WeieeGRACE/Embodied_RPACS/README.md

# Embodied_RPACS 主工程

ACG525 / GW5A-LV25UG324C2/I1，50 MHz，Gowin 1.9.12。主工程、构建与仿真不依赖 `tests/`。

## 本次交付（2026-10-29 稳定性 + 资源轮）

本轮的完整根因、修复、验证与上板步骤见 [`TECHNICAL_REPORT.md`](TECHNICAL_REPORT.md)。

1. **修复避障演示“转向 90° 后报故障”**：用改动前源码冻结副本在 ModelSim 中复现了全部
   锁存路径（`records/fault_injection/REPORT.md`）：转向后三路 ToF 全部新鲜的要求使任意
   一路持续 20 mm 在 1 s 后锁存 `route_fault=0x84`；单次 I2C NACK、瞬时 IMU 错误、
   停稳确认超时、有效近距 ≤85 mm 都会永久锁存。修复为分层容错：瞬时异常安全停车并
   自动重试/恢复，持续异常才锁存故障；转向后 barrier 只要求本状态真正使用的通道新鲜；
   编码器换向毛刺采用漏桶容错（历史板级记录过 IL=2/FL=1）。
2. **20 mm 截断容错 + 近距就绪（第二、三轮，上板日志驱动）**：真实板 3 次避障中 1 次在 `WAIT_PARALLEL`
   卡 4 s 后 PAUSED，串口证明障碍侧 VL53L0X 持续返回精确 20 mm（量程下限截断/测距失效），
   而旧策略把它永远丢弃 → 永远等不到“转向后新鲜样本”。现改为：连续 2 次 20 mm 视为
   “测距完成但目标过近/不可测”，作为 barrier 的新鲜事件放行（仍不参与几何距离），并让
   路线改走**固定里程兜底**（横移 500 + 额外 300 + 直行 600 + 额外 300 mm + 回线）；
   删除上板证明无效的“连续 4 次 20 mm 就 XSHUT 重初始化”。13 个故障注入场景现在同时断言
   `fault=0` 且 `paused=0`，其中场景 10 断言进入兜底（`reached_shift=1`）、场景 7 断言
   近距兜底（`near_shift=1`）。第三轮又删除了 `valid` 里“距离必须 >85 mm”的就绪掩码：
   真实近距不再被判未就绪（否则整条路线 `ready=0`、运动指令被拦后 PAUSED），近距与
   20 mm 截断统一走固定里程兜底。**PASS 中途截断兜底（上板日志驱动）**：2026-10-29 20:36
   板上 5 次尝试中 3 次在 PASS 阶段 BLOCKED（reason 0x04）——障碍侧通道在 PASS 开始后才出现
   20 mm 截断，边缘检测失效后一路开到前向阈值；现已把“运行中途转为截断”也纳入固定里程兜底
   （PASS/SHIFT），并新增故障注入场景 11 覆盖。**PASS 前向坏数据时间滤波（上板日志驱动）**：2026-10-29 22:52–22:59 的 7 次板测里 5 次在 PASS 段因“前向 ToF 单次读到 ≤85 mm”直接安全停车（reason 0x04）——箱角扫过前视场等单点坏数据被当成真障碍。现让位/超车各腿的前向判定需要**连续 400 ms** 低于 85 mm 才生效（巡航段仍立即刹车），并新增故障注入场景 12 覆盖；横移/超车距离与角度常量全部保持参考工程的 300/300 mm 不变。
3. **资源优化**：主菜单精简后为 4 项（MANUAL / SETTINGS / OBSTACLE AVOID / IMU ATTITUDE，
   末项为题目要求的姿态显示），删除 DISPLAY 其余诊断 UI、菜单预览行与 ToF 诊断页；本轮把
   IMU 姿态页恢复为单页（共用一套顺序小数格式化器），roll/pitch 数学随之回到综合。post-PnR：
   **Logic 15445/23040（70%）**（原 17661/77%）、**CLS 9407/11520（84%）**（原 86%）、
   Register 6553、BSRAM 9/56、DSP 8.5/28、Fmax **55.050 MHz**、Setup/Hold 违例 0、TNS 0。
4. **题目新增功能**：MANUAL 增加 **SPIN 360**（用右转动作原地旋转 360°，30 s 动作超时）；
   主菜单增加 **IMU ATTITUDE** 页，显示 ROLL / PITCH / YAW（±DDD.d°），IMU 校准中显示
   CALIBRATING。两项均已进仿真与 OLED 位图回归。
5. **验证**：7 套主工程仿真全部 PASS、历史回归全绿、**13 个**转向后故障注入场景
   （0 次故障锁存、0 次 PAUSED；场景 10 全程截断兜底、场景 11 PASS 中途截断兜底、场景 12 PASS 前向毛刺滤波）。
   位流：`impl/pnr/Embodied_RPACS.fs`（6,228,180 字节），
   SHA256 `901D7394146E472AF386E5BAB4092C5FD94B62245CF8666C471EDA38F7EAB14B`。
   2026-10-30 上板验收通过后已删除 USB 事件日志与调试串口，本版为最终交付
   （42 个受约束引脚、Fmax 55.050 MHz）。
   配套语音固件 `asrpro/release/yaoyao_asrpro_2m_20261025_obstacle/fw.bin` 本轮未改动。
   上板验收与逐段距离日志见 `records/robustness_20261029/BOARD_RUN_ANALYSIS.md`
   与 `records/robustness_20261029/board_run_20261030_0003_analysis.md`。

> 硬件提示：真实板上“IMU 地线掉开时避障反而稳定、插回又 PAUSED”指向地环路——本工程机械
> 接线把 IMU 地接在 P11-3/LCD_GPIO0/T11（T11 是 FPGA 信号脚，`P11-2` 才是专用 GND）。
> 建议 IMU 与三路 ToF 统一接到 P11-2 或 P6-12/P6-30 专用地星形一点接地，不要经 T11 走地。

> 勘误：上一轮文档中的 “Logic 12036/53%” 来自一次 `font_byte` 未驱动的坏网表（综合把整条
> OLED 文本链裁掉），不能作为资源余量依据；真实基线是 17661/77%，本轮以可运行构建重新测量。

## 菜单与按键

K1 下一项，K2 选择。主菜单 4 项：MANUAL → SETTINGS → OBSTACLE AVOID → IMU ATTITUDE。
手动页执行前后 20cm、左右 90°、**SPIN 360（右转原地一圈）**与 STOP；SETTINGS 含语音开关与
三档速度；IMU ATTITUDE 页显示 ROLL/PITCH/YAW（校准中显示 CALIBRATING，K0 返回）。

语音默认关闭；到 SETTINGS → VOICE ENABLE，用 K1 选择 ON、K2 确认。
进入避障面板不运动；K2 先播报“开启避障模式”，正常播完才前进。运行中 K2 暂停，暂停后 K2 恢复。
语音关闭时显示 ENABLE VOICE FIRST 并禁止避障启动。
面板显示状态、档位、三路距离；距离为四位十六进制 mm（07D0=2000mm），不可用显示 `----`。

K0 始终立即关断驱动。避障期间 K0 退出模式并返回主菜单，松开不恢复。
其他页面 K0 沿用返回/停车；主菜单 K0 复位、清故障并重新校准 IMU。

## 故障与诊断（本轮行为）

- 故障时避障面板第一行显示四组诊断码：`F:xx S:xx M:xx I:xx`
  - **F** = 路线 reason（0x84 转向后测距等待、0x85 重试耗尽、0x86 运动反复中止、0x80 系统故障…）
  - **S** = ToF 故障字（bit0/1/2 三通道坏样本；bit3/4/5 通信丢失；bit6/7/8 数据过期）
  - **M** = 运动故障码（2 测速反馈、3 偏航反馈、4 动作超时、5 非法状态、6 状态机异常）
  - **I** = IMU 错误码
  验收后已按用户确认删除 USB 事件日志与调试串口（释放 V8/U8 两个球）；现场诊断依靠避障面板的
  `F/S/M/I` 码，需要串口日志时使用已归档的历史 P6-21 诊断位流（不再随主工程维护）。
- **瞬时异常不再报 FAULT**：ToF 单次 NACK/短暂无数据、IMU 短暂错误、编码器停稳抖动等，
  会先安全停车并自动重试或恢复；转向后若障碍侧通道持续精确 20 mm（量程下限截断），
  按“测距完成但不可用”处理并改走固定里程兜底，不再等满重试后 PAUSED。
  若仍进入 `PAUSED`，面板第三行显示 `PAUSED R:xx Sxx Vx Ux`（U=20 mm 截断确认掩码），
  按 K2 可继续，**不会出现 FAULT RESET REQUIRED**。
- **持续异常仍锁存**：通道连续 2 s 失败/通信丢失、IMU 连续 2 s 错误、持续编码器异常、
  10 s 动作超时、ASR 发送溢出、K0 急停等保留永久故障锁存，必须 K0 复位。
- **编码器换向毛刺容错**：真实板 2026-10-14 记录过换向瞬间 `IL=2 IR=2 FL=1` 的非法跳变锁存。
  主工程编码器解码器现配置为容忍 5 次孤立毛刺、每 256 个合法计数衰减 1 次（漏桶），
  换向 EMI 毛刺不再杀演示；持续异常（>5 次且无合法计数稀释）仍锁存。历史独立测试工程
  默认参数 0，保持原来的“首次非法跳变立即锁存”行为。
- **20 mm 卡死自愈**：某通道连续 4 个精确 20 mm 后会自动 XSHUT 重初始化一次（约 25 ms），
  若只是测量卡死即可恢复；若目标确实过近则继续按安全策略处理。
- 有效近距读数（非 20 且 ≤85 mm）视为“遇到障碍”，由路线停车/绕行处理，不再锁存传感器故障。

## 避障与语音

唤醒词“幺幺耍起”保持不变；“避障模式”成功后 OLED 自动跳转面板。
自主绕行完成后继续巡航，可处理后续障碍。无路可绕或反复重试失败时暂停等待重新启动。
“停车/停止/停止任务”暂停并保留模式；“前进”在此模式内始终表示恢复持续避障。
“左转/右转/后退”取消旧路线，停稳后执行 90°/20cm 动作，完成后原地等待。
语音定量动作执行期间拒绝其他运动口令，不排队；停止与退出仍然有效。
“退出避障模式”停车、退出并回到主菜单；故障清除前禁止启动。

自主前方障碍触发一次“遇到障碍开始绕障”；完整回线、恢复航向和最终测距检查通过后触发一次“已绕过障碍物”。
取消或失败不报完成。模式存续期间每秒续期 ASRPRO 唤醒窗口。

自主避障继承独立 09 版：600mm 减速、130mm 准备绕行、转向侧>300mm、两次额外 300mm 及按实际横移里程返回。
保留正常通信持续 20 mm 时复用旧距离的策略；20 mm 不能建立首次正常值或转向后新鲜样本
（因此转向后对**所需通道**做新鲜度等待与重试，具体见上节容错行为）。

按用户确认，语音接管动作不受 ToF 近距和转向侧距离限制；IMU、编码器、动作/停车超时和已锁存故障保护保留。

## 实时加减速

“加速/快一点”“减速/慢一点”切换 0.05、0.10、0.15m/s，默认中档，上下端饱和。
自主巡航与语音前后直行动作实时沿斜坡调速；不会重置目标距离、累计里程或当前动作。
近障及绕障阶段优先保持 0.05m/s；原地旋转固定 0.05m/s，档位供后续动作使用。
前距≥650mm 连续三个正常新样本后解除近障限速，恢复最新档位。暂停时调速不启动。

## 资源记录（post-PnR 实测）

| 资源 | 改动前基线 | 本轮最终 | 变化 |
| --- | --- | --- | --- |
| Logic | 17661/23040 (77%) | **13322/23040 (58%)** | -4339 |
| — LUT | 14866 | 11062 | -3804 |
| — ALU | 2795 | 2260 | -535 |
| Register | 6859 (29%) | 5693 (25%) | -1166 |
| CLS（瓶颈） | 9858/11520 (86%) | **8293/11520 (72%)** | -1565 |
| BSRAM | 9/56 | 9/56 | 0 |
| DSP | 8.5/28 | 6.5/28 | -2 |
| Fmax | 53.020 MHz | **64.469 MHz** | +11.45 MHz |

主要来源：删除 DISPLAY 五页与 ToF 诊断页（`system_pages` 2422→740 LUT，`tof_page` 595→0），
删除后 roll/pitch 无消费者、综合自动裁剪姿态数据通路（`attitude` 2593→773 LUT）；
编码器毛刺容错只增加约 65 Logic / 40 FF，Fmax 因布局改善提升到 64.469 MHz。
如后续需要恢复诊断页，可从 git 历史恢复（当前 CLS 余量约 3.2k，可容纳）。
`tools/netlist_resource_report.py` 可从 Gowin 网表输出逐模块原语统计，用于回归资源。

## 接口与构建

ASRPRO D17/RX、D18/TX，115200/8N1；USB 调试口 U8/V8 已按验收结论删除并释放，主位流为
**42 个受约束引脚**，见 PIN_ASSIGNMENT.md。
协议与 ASRPRO 资源生成说明见 `asrpro/README.md`。USB 仅输出事件诊断，不需要控制心跳。

```powershell
& 'D:/Gowin/Gowin_V1.9.12_x64/IDE/bin/gw_sh.exe' build.tcl
& 'D:/Gowin/Gowin_V1.9.12_x64/IDE/bin/gw_sh.exe' verify_project.tcl
./tools/check_system_reports.ps1
./tools/run_system_sim.ps1                 # 主工程 7 套
./tools/run_legacy_regression.ps1          # 历史 IMU/OLED/测速/闭环/双轮/右轮/motion/tb6612 回归（已同步全绿）
./tools/run_fault_injection.ps1            # 13 个转向后故障注入场景，断言 0 次故障锁存、0 次 PAUSED（约 4 分钟）
./tools/board_obstacle_test.ps1 -Port COM14 -Seconds 180 -Program   # 上板：SRAM 烧写+只读串口抓取+PASS/FAIL 判定
./tools/export_main.ps1
```

导出目录默认 `release/`，不含历史独立测试目录。
数字仿真验证控制逻辑；实际转角、距离、制动余量、光学可靠性、20 mm 自愈效果和语音识别效果
由上板测试确认（步骤见 `TECHNICAL_REPORT.md` 第 6 节）。上板抓取脚本只读串口，
不影响 ASRPRO 运动链路。
