WeieeGRACE/Embodied_RPACS/tests/records/2026-10-19_system_oled_report.md

# 主工程 IMU OLED 集成测试报告

日期：2026-10-19（北京时间）。设备 GW5A-LV25UG324C2/I1，Gowin IDE 1.9.12，ModelSim SE-64 10.7。

## 集成行为

- 主工程唯一 IMU 驱动的六轴数据接入已验证姿态模块和 OLED；显示 Roll、Pitch、相对 Yaw、初始化/校准/故障状态。
- 生产默认保持 200 Hz 采样、200 帧零偏校准、约 5 Hz 显示。姿态有效且校准结束后才允许运动、点亮就绪灯。
- OLED 接口为 R3/T3、3.3 V；SDA 通过输出数据恒 0 的三态缓冲器实现开漏。CPU/SSPI 普通 IO 选项及 50 MHz 设置已写入主工程保存配置和构建 Tcl。
- 采样超时即使驱动 ready 仍高，OLED 也会在后续帧显示 ERROR；故障锁存后不会因驱动恢复而再次显示正常就绪。电机安全关断不等待显示刷新。
- UART 原事件格式、心跳要求、急停、双轮闭环与 IMU 故障锁存均保留。姿态角仅用于显示。

## 仿真结果

全部下列测试均退出码 0：

| 测试 | 实际覆盖 |
| --- | --- |
| 主系统/日志/IMU | 配置 ROM、六轴数据、校准期间禁止启动、有心跳时校准按键不排队、校准后重新按键启动、复位重新校准、双轮独立模型、PWM、定时停止、急停、编码器故障、心跳边界与锁存、IMU 初始化/运行故障、采样超时 OLED ERROR、UART 去重与无周期输出 |
| 姿态单元 | 200 帧校准、零偏消除、正负 Yaw、静止漂移抑制、Roll/Pitch、符号与小数格式 |
| OLED 单元 | SSD1306 初始化与地址、分页、清屏、开漏 I²C 帧、正负角度字符 |
| 原底盘回归 | ground、左轮、双轮、右轮闭环、转向/旋转、UART、看门狗、PI 和滤波 |
| 测速历史预取边界 | 窗口长度 1/2/4、滤波长度 1/3/4、两种预热方式、正负极值、负数除法舍入、复位后重新填充 |

主系统、姿态、OLED 和新增滤波测试均 0 errors、0 warnings。原独立例程仍有可选集成端口未连接的既有警告，全部回归通过。
主系统仿真将校准缩短至 16 帧，姿态单元测试使用生产默认 200 帧；仿真模型不代替实机验收。

实际记录：

- `2026-10-19_system_oled_integration.log`：最终主系统、日志和 IMU 驱动验证。
- `2026-10-19_system_oled_all_sim.log`：时序优化后的完整系统、姿态、OLED 及既有底盘回归。
- `2026-10-19_attitude_regression.log`、`2026-10-19_oled_regression.log`：时序优化后单元测试日志。
- `2026-10-19_speed_prefetch.log`：测速边界验证。

## 时序优化说明

初次集成的布局布线结果 Fmax=49.747 MHz，最差 setup=-0.102 ns，未作为交付版本。
通过寄存 OLED 字符后再查询字模、提前寄存姿态预测值、预取测速历史样本，缩短组合路径。
测速输出的窗口边界与数值规则保持不变，1 拍窗口保留直接读取路径，已通过独立参考队列比较和原闭环回归。

最终编译通过 `verify_system_project.tcl` 直接加载保存的 `.gprj`，脚本不覆盖选项；编译日志为 `2026-10-19_system_oled_saved_build.log`。
最终构建完成于 23:36:58。50 MHz 约束下 Fmax=54.703 MHz，最差 setup=1.719 ns、hold=0.258 ns，setup/hold 违例端点和 TNS 均为 0。
这些数值为受约束内部路径的静态时序结果，板上功能仍待用户验收。

| 资源 | 用量 |
| --- | ---: |
| Logic | 8466 / 23040 |
| Register（含 I/O） | 3214 / 23685 |
| BSRAM | 4 / 56 |
| DSP（MULTALU27X18） | 4 / 28 |
| PLL | 0 |
| I/O | 30 / 222 |

最终 `.fs` 大小 6,174,044 字节，SHA256：
`81CD06CC97BCB4A1700C7187218FEE91FF1D856C95E72F83556F8C6C22B57F36`。

最终数值、文件摘要及管脚检查见同目录 `2026-10-19_system_oled_build_evidence.txt` 和 `2026-10-19_system_oled_report_check.txt`。
Gowin 保留已有 UART 位宽截断警告及数字格式化层级优化提示；未出现 OLED 双用途引脚占用错误。

## 上板交付

打开主工程 `Embodied_RPACS.gprj`；若 IDE 已打开该工程，关闭并重新打开以加载新配置。
下载 `impl/pnr/Embodied_RPACS.fs` 到 SRAM。
按 KEY0 后静止等待校准，就绪灯亮后检查姿态显示；每 100 ms 持续发送二进制 A5，再按 KEY1 检查原 8 秒运行，随后验收急停及心跳超时。
完整步骤见 `tests/docs/SYSTEM_IMU_OLED.md`。本次未代用户下载 FPGA 或操作真实电机。
