WeieeGRACE/Embodied_RPACS/tests/asr_motion/records/gpio_timing_report.txt

<!DOCTYPE html PUBLIC "-//W3C//DTD XHTML 1.0 Transitional//EN" "http://www.w3.org/TR/xhtml1/DTD/xhtml1-transitional.dtd">
<html>
<head>
<title>Timing Analysis Report</title>
<style type="text/css">
@import url(../temp/style.css);
body { font-family: Verdana, Arial, sans-serif; font-size: 12px; }
div#content { width: 100%; margin: }
hr { margin-top: 30px; margin-bottom: 30px; }
h1, h3 { text-align: center; }
h1 {margin-top: 50px; }
table, th, td {white-space:pre; border: 1px solid #aaa; }
table { border-collapse:collapse; margin-top: 10px; margin-bottom: 20px; width: 100%; }
th, td { padding: 5px 5px 5px 5px; }
th { color: #fff; font-weight: bold; background-color: #0084ff; }
table.summary_table td.label { width: 24%; min-width: 200px; background-color: #dee8f4; }
table.detail_table th.label {  min-width: 8%; width: 8%; }
</style>
</head>
<body>
<div id="content">
<h1><a name="Message">Timing Messages</a></h1>
<table class="summary_table">
<tr>
<td class="label">Report Title</td>
<td>Timing Analysis Report</td>
</tr>
<tr>
<td class="label">Design File</td>
<td>D:\Gowin\Project\Contest\Embodied_RPACS\Embodied_RPACS\Embodied_RPACS\tests\asr_motion\impl\gwsynthesis\asr_motion_gpio.vg</td>
</tr>
<tr>
<td class="label">Physical Constraints File</td>
<td>D:\Gowin\Project\Contest\Embodied_RPACS\Embodied_RPACS\Embodied_RPACS\tests\asr_motion\src\asr_motion_gpio.cst</td>
</tr>
<tr>
<td class="label">Timing Constraint File</td>
<td>D:\Gowin\Project\Contest\Embodied_RPACS\Embodied_RPACS\Embodied_RPACS\tests\asr_motion\src\asr_motion_test_top.sdc</td>
</tr>
<tr>
<td class="label">Tool Version</td>
<td>V1.9.12 (64-bit)</td>
</tr>
<tr>
<td class="label">Part Number</td>
<td>GW5A-LV25UG324C2/I1</td>
</tr>
<tr>
<td class="label">Device</td>
<td>GW5A-25</td>
</tr>
<tr>
<td class="label">Device Version</td>
<td>A</td>
</tr>
<tr>
<td class="label">Created Time</td>
<td>Fri Oct 23 15:45:29 2026
</td>
</tr>
<tr>
<td class="label">Legal Announcement</td>
<td>Copyright (C)2014-2025 Gowin Semiconductor Corporation. All rights reserved.</td>
</tr>
</table>
<h1><a name="Summary">Timing Summaries</a></h1>
<h2><a name="STA_Tool_Run_Summary">STA Tool Run Summary:</a></h2>
<table class="summary_table">
<tr>
<td class="label">Setup Delay Model</td>
<td>Slow 0.855V 0C C2/I1</td>
</tr>
<tr>
<td class="label">Hold Delay Model</td>
<td>Fast 0.945V 85C C2/I1</td>
</tr>
<tr>
<td class="label">Numbers of Paths Analyzed</td>
<td>11105</td>
</tr>
<tr>
<td class="label">Numbers of Endpoints Analyzed</td>
<td>10341</td>
</tr>
<tr>
<td class="label">Numbers of Falling Endpoints</td>
<td>0</td>
</tr>
<tr>
<td class="label">Numbers of Setup Violated Endpoints</td>
<td>0</td>
</tr>
<tr>
<td class="label">Numbers of Hold Violated Endpoints</td>
<td>0</td>
</tr>
</table>
<h2><a name="Clock_Report">Clock Summary:</a></h2>
<table class="detail_table">
<tr>
<th class="label">NO.</th>
<th class="label">Clock Name</th>
<th class="label">Type</th>
<th class="label">Period</th>
<th class="label">Frequency(MHz)</th>
<th class="label">Rise</th>
<th class="label">Fall</th>
<th class="label">Source</th>
<th class="label">Master</th>
<th class="label">Objects</th>
</tr>
<tr>
<td>1</td>
<td>clk_50m</td>
<td>Base</td>
<td>20.000</td>
<td>50.000
<td>0.000</td>
<td>10.000</td>
<td></td>
<td></td>
<td>clk_50m </td>
</tr>
</table>
<h2><a name="Max_Frequency_Report">Max Frequency Summary:</a></h2>
<table>
<tr>
<th>NO.</th>
<th>Clock Name</th>
<th>Constraint</th>
<th>Actual Fmax</th>
<th>Logic Level</th>
<th>Entity</th>
</tr>
<tr>
<td>1</td>
<td>clk_50m</td>
<td>50.000(MHz)</td>
<td>56.620(MHz)</td>
<td>18</td>
<td>TOP</td>
</tr>
</table>
<h2><a name="Total_Negative_Slack_Report">Total Negative Slack Summary:</a></h2>
<table class="detail_table">
<tr>
<th class="label">Clock Name</th>
<th class="label">Analysis Type</th>
<th class="label">Endpoints TNS</th>
<th class="label">Number of Endpoints</th>
</tr>
<tr>
<td>clk_50m</td>
<td>Setup</td>
<td>0.000</td>
<td>0</td>
</tr>
<tr>
<td>clk_50m</td>
<td>Hold</td>
<td>0.000</td>
<td>0</td>
</tr>
</table>
<h1><a name="Detail">Timing Details</a></h1>
<h2><a name="All_Path_Slack_Table">Path Slacks Table:</a></h2>
<h3><a name="Setup_Slack_Table">Setup Paths Table</a></h3>
<h4>Report Command:report_timing -setup -max_paths 25 -max_common_paths 1</h4>
<table class="detail_table">
<tr>
<th class="label">Path Number</th>
<th class="label">Path Slack</th>
<th class="label">From Node</th>
<th class="label">To Node</th>
<th class="label">From Clock</th>
<th class="label">To Clock</th>
<th class="label">Relation</th>
<th class="label">Clock Skew</th>
<th class="label">Data Delay</th>
</tr>
<tr>
<td>1</td>
<td>2.338</td>
<td>imu/ready_s1/Q</td>
<td>packets/fifo_fifo_RAMREG_22_G[9]_s0/CE</td>
<td>clk_50m:[R]</td>
<td>clk_50m:[R]</td>
<td>20.000</td>
<td>-0.001</td>
<td>17.414</td>
</tr>
<tr>
<td>2</td>
<td>2.521</td>
<td>imu/ready_s1/Q</td>
<td>packets/fifo_fifo_RAMREG_38_G[9]_s0/CE</td>
<td>clk_50m:[R]</td>
<td>clk_50m:[R]</td>
<td>20.000</td>
<td>0.006</td>
<td>17.224</td>
</tr>
<tr>
<td>3</td>
<td>2.718</td>
<td>imu/ready_s1/Q</td>
<td>packets/fifo_fifo_RAMREG_51_G[9]_s0/CE</td>
<td>clk_50m:[R]</td>
<td>clk_50m:[R]</td>
<td>20.000</td>
<td>0.014</td>
<td>17.019</td>
</tr>
<tr>
<td>4</td>
<td>2.743</td>
<td>imu/ready_s1/Q</td>
<td>packets/fifo_fifo_RAMREG_15_G[9]_s0/CE</td>
<td>clk_50m:[R]</td>
<td>clk_50m:[R]</td>
<td>20.000</td>
<td>0.022</td>
<td>16.986</td>
</tr>
<tr>
<td>5</td>
<td>2.766</td>
<td>imu/ready_s1/Q</td>
<td>packets/fifo_fifo_RAMREG_53_G[9]_s0/CE</td>
<td>clk_50m:[R]</td>
<td>clk_50m:[R]</td>
<td>20.000</td>
<td>0.029</td>
<td>16.956</td>
</tr>
<tr>
<td>6</td>
<td>2.882</td>
<td>imu/ready_s1/Q</td>
<td>packets/fifo_fifo_RAMREG_63_G[8]_s0/CE</td>
<td>clk_50m:[R]</td>
<td>clk_50m:[R]</td>
<td>20.000</td>
<td>0.027</td>
<td>16.842</td>
</tr>
<tr>
<td>7</td>
<td>2.882</td>
<td>imu/ready_s1/Q</td>
<td>packets/fifo_fifo_RAMREG_63_G[4]_s0/CE</td>
<td>clk_50m:[R]</td>
<td>clk_50m:[R]</td>
<td>20.000</td>
<td>0.027</td>
<td>16.842</td>
</tr>
<tr>
<td>8</td>
<td>2.882</td>
<td>imu/ready_s1/Q</td>
<td>packets/fifo_fifo_RAMREG_63_G[2]_s0/CE</td>
<td>clk_50m:[R]</td>
<td>clk_50m:[R]</td>
<td>20.000</td>
<td>0.027</td>
<td>16.842</td>
</tr>
<tr>
<td>9</td>
<td>2.882</td>
<td>imu/ready_s1/Q</td>
<td>packets/fifo_fifo_RAMREG_63_G[1]_s0/CE</td>
<td>clk_50m:[R]</td>
<td>clk_50m:[R]</td>
<td>20.000</td>
<td>0.027</td>
<td>16.842</td>
</tr>
<tr>
<td>10</td>
<td>2.882</td>
<td>imu/ready_s1/Q</td>
<td>packets/fifo_fifo_RAMREG_63_G[0]_s0/CE</td>
<td>clk_50m:[R]</td>
<td>clk_50m:[R]</td>
<td>20.000</td>
<td>0.027</td>
<td>16.842</td>
</tr>
<tr>
<td>11</td>
<td>2.958</td>
<td>imu/ready_s1/Q</td>
<td>packets/fifo_fifo_RAMREG_17_G[4]_s0/CE</td>
<td>clk_50m:[R]</td>
<td>clk_50m:[R]</td>
<td>20.000</td>
<td>0.014</td>
<td>16.779</td>
</tr>
<tr>
<td>12</td>
<td>2.977</td>
<td>imu/ready_s1/Q</td>
<td>packets/fifo_fifo_RAMREG_56_G[9]_s0/CE</td>
<td>clk_50m:[R]</td>
<td>clk_50m:[R]</td>
<td>20.000</td>
<td>0.004</td>
<td>16.770</td>
</tr>
<tr>
<td>13</td>
<td>2.985</td>
<td>imu/ready_s1/Q</td>
<td>packets/fifo_fifo_RAMREG_15_G[8]_s0/CE</td>
<td>clk_50m:[R]</td>
<td>clk_50m:[R]</td>
<td>20.000</td>
<td>0.042</td>
<td>16.724</td>
</tr>
<tr>
<td>14</td>
<td>2.985</td>
<td>imu/ready_s1/Q</td>
<td>packets/fifo_fifo_RAMREG_15_G[4]_s0/CE</td>
<td>clk_50m:[R]</td>
<td>clk_50m:[R]</td>
<td>20.000</td>
<td>0.042</td>
<td>16.724</td>
</tr>
<tr>
<td>15</td>
<td>2.985</td>
<td>imu/ready_s1/Q</td>
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
<td>0.862</td>
<td>Low Pulse Width</td>
<td>clk_50m</td>
<td>attitude/n2128_s</td>
</tr>
<tr>
<td>5</td>
<td>8.023</td>
<td>8.885</td>
<td>0.862</td>
<td>Low Pulse Width</td>
<td>clk_50m</td>
<td>imu/config_rom/rom_rom_0_2_s</td>
</tr>
<tr>
<td>6</td>
<td>8.023</td>
<td>8.885</td>
<td>0.862</td>
<td>Low Pulse Width</td>
<td>clk_50m</td>
<td>imu/config_rom/rom_rom_0_3_s</td>
</tr>
<tr>
<td>7</td>
<td>8.024</td>
<td>8.886</td>
<td>0.862</td>
<td>High Pulse Width</td>
<td>clk_50m</td>
<td>imu/config_rom/rom_rom_0_1_s</td>
</tr>
<tr>
<td>8</td>
<td>8.025</td>
<td>8.887</td>
<td>0.862</td>
<td>High Pulse Width</td>
<td>clk_50m</td>
<td>attitude/n2128_s</td>
</tr>
<tr>
<td>9</td>
<td>8.026</td>
<td>8.888</td>
<td>0.862</td>
<td>Low Pulse Width</td>
<td>clk_50m</td>
<td>attitude/square_product_0_s</td>
</tr>
<tr>
<td>10</td>
<td>8.027</td>
<td>8.889</td>
<td>0.862</td>
<td>High Pulse Width</td>
<td>clk_50m</td>
<td>imu/config_rom/rom_rom_0_2_s</td>
</tr>
</table>
<h2><a name="Timing_Report_by_Analysis_Type">Timing Report By Analysis Type:</a></h2>
<h3><a name="Setup_Analysis">Setup Analysis Report</a></h3>
<h4>Report Command:report_timing -setup -max_paths 25 -max_common_paths 1</h4>
<h3>Path1</h3>
<p><b>Path Summary:</b></p>
<table class="summary_table">
<tr>
<td class="label">Slack</td>
<td>2.338</td>
</tr>
<tr>
<td class="label">Data Arrival Time</td>
<td>20.021</td>
</tr>
<tr>
<td class="label">Data Required Time</td>
<td>22.359</td>
</tr>
<tr>
<td class="label">From</td>
<td>imu/ready_s1</td>
</tr>
<tr>
<td class="label">To</td>
<td>packets/fifo_fifo_RAMREG_22_G[9]_s0</td>
</tr>
<tr>
<td class="label">Launch Clk</td>
<td>clk_50m:[R]</td>
</tr>
<tr>
<td class="label">Latch Clk</td>
<td>clk_50m:[R]</td>
</tr>
</table>
<p><b>Data Arrival Path:</b></p>
<table class="detail_table">
<tr>
<th class="label">AT</th>
<th class="label">DELAY</th>
<th class="label">TYPE</th>
<th class="label">RF</th>
<th class="label">FANOUT</th>
<th class="label">LOC</th>
<th>NODE</th>
</tr>
<tr>
<td>0.000</td>
<td>0.000</td>
<td></td>
<td></td>
<td></td>
<td></td>
<td>active clock edge time</td>
</tr>
<tr>
<td>0.000</td>
<td>0.000</td>
<td></td>
<td></td>
<td></td>
<td></td>
<td>clk_50m</td>
</tr>
<tr>
<td>0.000</td>
<td>0.000</td>
<td>tCL</td>
<td>RR</td>
<td>1</td>
<td>IOB29[A]</td>
<td>clk_50m_ibuf/I</td>
</tr>
<tr>
<td>1.046</td>
<td>1.046</td>
<td>tINS</td>
<td>RR</td>
<td>3385</td>
<td>IOB29[A]</td>
<td>clk_50m_ibuf/O</td>
</tr>
<tr>
<td>2.607</td>
<td>1.561</td>
<td>tNET</td>
<td>RR</td>
<td>1</td>
<td>R22C87[1][A]</td>
<td>imu/ready_s1/CLK</td>
</tr>
<tr>
<td>2.901</td>
<td>0.294</td>
<td>tC2Q</td>
<td>RF</td>
<td>277</td>
<td>R22C87[1][A]</td>
<td style=" font-weight:bold;">imu/ready_s1/Q</td>
</tr>
<tr>
<td>6.088</td>
<td>3.187</td>
<td>tNET</td>
<td>FF</td>
<td>1</td>
<td>R14C56[2][A]</td>
<td>fault_now_s6/I0</td>
</tr>
<tr>
<td>6.509</td>
<td>0.421</td>
<td>tINS</td>
<td>FR</td>
<td>1</td>
<td>R14C56[2][A]</td>
<td style=" background: #97FFFF;">fault_now_s6/F</td>
</tr>
<tr>
<td>6.511</td>
<td>0.002</td>
<td>tNET</td>
<td>RR</td>
<td>1</td>
<td>R14C56[0][A]</td>
<td>fault_now_s2/I3</td>
</tr>
<tr>
<td>6.880</td>
<td>0.369</td>
<td>tINS</td>
<td>RR</td>
<td>10</td>
<td>R14C56[0][A]</td>
<td style=" background: #97FFFF;">fault_now_s2/F</td>
</tr>
<tr>
<td>7.056</td>
<td>0.176</td>
<td>tNET</td>
<td>RR</td>
<td>1</td>
<td>R14C54[0][A]</td>
<td>fault_now_s15/I3</td>
</tr>
<tr>
<td>7.266</td>
<td>0.210</td>
<td>tINS</td>
<td>RR</td>
<td>10</td>
<td>R14C54[0][A]</td>
<td style=" background: #97FFFF;">fault_now_s15/F</td>
</tr>
<tr>
<td>8.056</td>
<td>0.790</td>
<td>tNET</td>
<td>RR</td>
<td>1</td>
<td>R18C43[1][B]</td>
<td>motion/n1378_s8/I0</td>
</tr>
<tr>
<td>8.477</td>
<td>0.421</td>
<td>tINS</td>
<td>RR</td>
<td>5</td>
<td>R18C43[1][B]</td>
<td style=" background: #97FFFF;">motion/n1378_s8/F</td>
</tr>
<tr>
<td>9.178</td>
<td>0.701</td>
<td>tNET</td>
<td>RR</td>
<td>1</td>
<td>R8C53[1][B]</td>
<td>next_status_2_s1/I3</td>
</tr>
<tr>
<td>9.599</td>
<td>0.421</td>
<td>tINS</td>
<td>RR</td>
<td>66</td>
<td>R8C53[1][B]</td>
<td style=" background: #97FFFF;">next_status_2_s1/F</td>
</tr>
<tr>
<td>9.998</td>
<td>0.399</td>
<td>tNET</td>
<td>RR</td>
<td>2</td>
<td>R11C53[1][A]</td>
<td>n2089_s0/I0</td>
</tr>
<tr>
<td>10.443</td>
<td>0.445</td>
<td>tINS</td>
<td>RF</td>
<td>1</td>
<td>R11C53[1][A]</td>
<td style=" background: #97FFFF;">n2089_s0/COUT</td>
</tr>
<tr>
<td>10.443</td>
<td>0.000</td>
<td>tNET</td>
<td>FF</td>
<td>2</td>
<td>R11C53[1][B]</td>
<td>n2091_s0/CIN</td>
</tr>
<tr>
<td>10.483</td>
<td>0.040</td>
<td>tINS</td>
<td>FR</td>
<td>1</td>
<td>R11C53[1][B]</td>
<td style=" background: #97FFFF;">n2091_s0/COUT</td>
</tr>
<tr>
<td>11.211</td>
<td>0.728</td>
<td>tNET</td>
<td>RR</td>
<td>1</td>
<td>R2C60[0][A]</td>
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
<td>RR</td>
<td>1</td>
<td>R3C73[2][B]</td>
<td>packets/fifo_s6805/I2</td>
</tr>
<tr>
<td>16.000</td>
<td>0.421</td>
<td>tINS</td>
<td>RR</td>
<td>57</td>
<td>R3C73[2][B]</td>
<td style=" background: #97FFFF;">packets/fifo_s6805/F</td>
</tr>
<tr>
<td>18.349</td>
<td>2.349</td>
<td>tNET</td>
<td>RR</td>
<td>1</td>
<td>R11C87[2][B]</td>
<td>packets/fifo_s6856/I3</td>
</tr>
<tr>
<td>18.718</td>
<td>0.369</td>
<td>tINS</td>
<td>RR</td>
<td>6</td>
<td>R11C87[2][B]</td>
<td style=" background: #97FFFF;">packets/fifo_s6856/F</td>
</tr>
<tr>
<td>18.844</td>
<td>0.126</td>
<td>tNET</td>
<td>RR</td>
<td>1</td>
<td>R11C87[3][A]</td>
<td>packets/fifo_s6539/I2</td>
</tr>
<tr>
<td>19.056</td>
<td>0.212</td>
<td>tINS</td>
<td>RR</td>
<td>6</td>
<td>R11C87[3][A]</td>
<td style=" background: #97FFFF;">packets/fifo_s6539/F</td>
</tr>
<tr>
<td>19.831</td>
<td>0.775</td>
<td>tNET</td>
<td>RR</td>
<td>1</td>
<td>R7C75[2][A]</td>
<td style=" font-weight:bold;">packets/fifo_fifo_RAMREG_38_G[9]_s0/CE</td>
</tr>
</table>
<p><b>Data Required Path:</b></p>
<table class="detail_table">
<tr>
<th class="label">AT</th>
<th class="label">DELAY</th>
<th class="label">TYPE</th>
<th class="label">RF</th>
<th class="label">FANOUT</th>
<th class="label">LOC</th>
<th>NODE</th>
</tr>
<tr>
<td>20.000</td>
<td>20.000</td>
<td></td>
<td></td>
<td></td>
<td></td>
<td>active clock edge time</td>
</tr>
<tr>
<td>20.000</td>
<td>0.000</td>
<td></td>
<td></td>
<td></td>
<td></td>
<td>clk_50m</td>
</tr>
<tr>
<td>20.000</td>
<td>0.000</td>
<td>tCL</td>
<td>RR</td>
<td>1</td>
<td>IOB29[A]</td>
<td>clk_50m_ibuf/I</td>
</tr>
<tr>
<td>21.046</td>
<td>1.046</td>
<td>tINS</td>
<td>RR</td>
<td>3385</td>
<td>IOB29[A]</td>
<td>clk_50m_ibuf/O</td>
</tr>
<tr>
<td>22.601</td>
<td>1.555</td>
<td>tNET</td>
<td>RR</td>
<td>1</td>
<td>R7C75[2][A]</td>
<td>packets/fifo_fifo_RAMREG_38_G[9]_s0/CLK</td>
</tr>
<tr>
<td>22.352</td>
<td>-0.249</td>
<td>tSu</td>
<td></td>
<td>1</td>
<td>R7C75[2][A]</td>
<td>packets/fifo_fifo_RAMREG_38_G[9]_s0</td>
</tr>
</table>
<p><b>Path Statistics:</b></p>
<table class="summary_table">
<tr>
<td class="label">Clock Skew</td>
<td>-0.006</td>
</tr>
<tr>
<td class="label">Setup Relationship </td>
<td>20.000</td>
</tr>
<tr>
<td class="label">Logic Level</td>
<td>18</td>
</tr>
<tr>
<td class="label">Arrival Clock Path Delay</td>
<td>cell: 1.046, 40.123%; route: 1.561, 59.877%</td>
</tr>
<tr>
<td class="label">Arrival Data Path Delay</td>
<td>cell: 5.804, 33.697%; route: 11.126, 64.596%; tC2Q: 0.294, 1.707%</td>
</tr>
<tr>
<td class="label">Required Clock Path Delay</td>
<td>cell: 1.046, 40.215%; route: 1.555, 59.785%</td>
</tr>
</table>
<h3>Path3</h3>
<p><b>Path Summary:</b></p>
<table class="summary_table">
<tr>
<td class="label">Slack</td>
<td>2.718</td>
</tr>
<tr>
<td class="label">Data Arrival Time</td>
<td>19.626</td>
</tr>
<tr>
<td class="label">Data Required Time</td>
<td>22.344</td>
</tr>
<tr>
<td class="label">From</td>
<td>imu/ready_s1</td>
</tr>
<tr>
<td class="label">To</td>
<td>packets/fifo_fifo_RAMREG_51_G[9]_s0</td>
</tr>
<tr>
<td class="label">Launch Clk</td>
<td>clk_50m:[R]</td>
</tr>
<tr>
<td class="label">Latch Clk</td>
<td>clk_50m:[R]</td>
</tr>
</table>
<p><b>Data Arrival Path:</b></p>
<table class="detail_table">
<tr>
<th class="label">AT</th>
<th class="label">DELAY</th>
<th class="label">TYPE</th>
<th class="label">RF</th>
<th class="label">FANOUT</th>
<th class="label">LOC</th>
<th>NODE</th>
</tr>
<tr>
<td>0.000</td>
<td>0.000</td>
<td></td>
<td></td>
<td></td>
<td></td>
<td>active clock edge time</td>
</tr>
<tr>
<td>0.000</td>
<td>0.000</td>
<td></td>
<td></td>
<td></td>
<td></td>
<td>clk_50m</td>
</tr>
<tr>
<td>0.000</td>
<td>0.000</td>
<td>tCL</td>
<td>RR</td>
<td>1</td>
<td>IOB29[A]</td>
<td>clk_50m_ibuf/I</td>
</tr>
<tr>
<td>1.046</td>
<td>1.046</td>
<td>tINS</td>
<td>RR</td>
<td>3385</td>
<td>IOB29[A]</td>
<td>clk_50m_ibuf/O</td>
</tr>
<tr>
<td>2.607</td>
<td>1.561</td>
<td>tNET</td>
<td>RR</td>
<td>1</td>
<td>R22C87[1][A]</td>
<td>imu/ready_s1/CLK</td>
</tr>
<tr>
<td>2.901</td>
<td>0.294</td>
<td>tC2Q</td>
<td>RF</td>
<td>277</td>
<td>R22C87[1][A]</td>
<td style=" font-weight:bold;">imu/ready_s1/Q</td>
</tr>
<tr>
<td>6.088</td>
<td>3.187</td>
<td>tNET</td>
<td>FF</td>
<td>1</td>
<td>R14C56[2][A]</td>
<td>fault_now_s6/I0</td>
</tr>
<tr>
<td>6.509</td>
<td>0.421</td>
<td>tINS</td>
<td>FR</td>
<td>1</td>
<td>R14C56[2][A]</td>
<td style=" background: #97FFFF;">fault_now_s6/F</td>
</tr>
<tr>
<td>6.511</td>
<td>0.002</td>
<td>tNET</td>
<td>RR</td>
<td>1</td>
<td>R14C56[0][A]</td>
<td>fault_now_s2/I3</td>
</tr>
<tr>
<td>6.880</td>
<td>0.369</td>
<td>tINS</td>
<td>RR</td>
<td>10</td>
<td>R14C56[0][A]</td>
<td style=" background: #97FFFF;">fault_now_s2/F</td>
</tr>
<tr>
<td>7.056</td>
<td>0.176</td>
<td>tNET</td>
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
<td>RR</td>
<td>1</td>
<td>IOB29[A]</td>
<td>clk_50m_ibuf/I</td>
</tr>
<tr>
<td>21.046</td>
<td>1.046</td>
<td>tINS</td>
<td>RR</td>
<td>3385</td>
<td>IOB29[A]</td>
<td>clk_50m_ibuf/O</td>
</tr>
<tr>
<td>22.585</td>
<td>1.539</td>
<td>tNET</td>
<td>RR</td>
<td>1</td>
<td>R11C80[1][A]</td>
<td>packets/fifo_fifo_RAMREG_15_G[9]_s0/CLK</td>
</tr>
<tr>
<td>22.336</td>
<td>-0.249</td>
<td>tSu</td>
<td></td>
<td>1</td>
<td>R11C80[1][A]</td>
<td>packets/fifo_fifo_RAMREG_15_G[9]_s0</td>
</tr>
</table>
<p><b>Path Statistics:</b></p>
<table class="summary_table">
<tr>
<td class="label">Clock Skew</td>
<td>-0.022</td>
</tr>
<tr>
<td class="label">Setup Relationship </td>
<td>20.000</td>
</tr>
<tr>
<td class="label">Logic Level</td>
<td>18</td>
</tr>
<tr>
<td class="label">Arrival Clock Path Delay</td>
<td>cell: 1.046, 40.123%; route: 1.561, 59.877%</td>
</tr>
<tr>
<td class="label">Arrival Data Path Delay</td>
<td>cell: 6.001, 35.329%; route: 10.691, 62.940%; tC2Q: 0.294, 1.731%</td>
</tr>
<tr>
<td class="label">Required Clock Path Delay</td>
<td>cell: 1.046, 40.456%; route: 1.539, 59.544%</td>
</tr>
</table>
<h3>Path5</h3>
<p><b>Path Summary:</b></p>
<table class="summary_table">
<tr>
<td class="label">Slack</td>
<td>2.766</td>
</tr>
<tr>
<td class="label">Data Arrival Time</td>
<td>19.563</td>
</tr>
<tr>
<td class="label">Data Required Time</td>
<td>22.329</td>
</tr>
<tr>
<td class="label">From</td>
<td>imu/ready_s1</td>
</tr>
<tr>
<td class="label">To</td>
<td>packets/fifo_fifo_RAMREG_53_G[9]_s0</td>
</tr>
<tr>
<td class="label">Launch Clk</td>
<td>clk_50m:[R]</td>
</tr>
<tr>
<td class="label">Latch Clk</td>
<td>clk_50m:[R]</td>
</tr>
</table>
<p><b>Data Arrival Path:</b></p>
<table class="detail_table">
<tr>
<th class="label">AT</th>
<th class="label">DELAY</th>
<th class="label">TYPE</th>
<th class="label">RF</th>
<th class="label">FANOUT</th>
<th class="label">LOC</th>
<th>NODE</th>
</tr>
<tr>
<td>0.000</td>
<td>0.000</td>
<td></td>
<td></td>
<td></td>
<td></td>
<td>active clock edge time</td>
</tr>
<tr>
<td>0.000</td>
<td>0.000</td>
<td></td>
<td></td>
<td></td>
<td></td>
<td>clk_50m</td>
</tr>
<tr>
<td>0.000</td>
<td>0.000</td>
<td>tCL</td>
<td>RR</td>
<td>1</td>
<td>IOB29[A]</td>
<td>clk_50m_ibuf/I</td>
</tr>
<tr>
<td>1.046</td>
<td>1.046</td>
<td>tINS</td>
<td>RR</td>
<td>3385</td>
<td>IOB29[A]</td>
<td>clk_50m_ibuf/O</td>
</tr>
<tr>
<td>2.607</td>
<td>1.561</td>
<td>tNET</td>
<td>RR</td>
<td>1</td>
<td>R22C87[1][A]</td>
<td>imu/ready_s1/CLK</td>
</tr>
<tr>
<td>2.901</td>
<td>0.294</td>
<td>tC2Q</td>
<td>RF</td>
<td>277</td>
<td>R22C87[1][A]</td>
<td style=" font-weight:bold;">imu/ready_s1/Q</td>
</tr>
<tr>
<td>6.088</td>
<td>3.187</td>
<td>tNET</td>
<td>FF</td>
<td>1</td>
<td>R14C56[2][A]</td>
<td>fault_now_s6/I0</td>
</tr>
<tr>
<td>6.509</td>
<td>0.421</td>
<td>tINS</td>
<td>FR</td>
<td>1</td>
<td>R14C56[2][A]</td>
<td style=" background: #97FFFF;">fault_now_s6/F</td>
</tr>
<tr>
<td>6.511</td>
<td>0.002</td>
<td>tNET</td>
<td>RR</td>
<td>1</td>
<td>R14C56[0][A]</td>
<td>fault_now_s2/I3</td>
</tr>
<tr>
<td>6.880</td>
<td>0.369</td>
<td>tINS</td>
<td>RR</td>
<td>10</td>
<td>R14C56[0][A]</td>
<td style=" background: #97FFFF;">fault_now_s2/F</td>
</tr>
<tr>
<td>7.056</td>
<td>0.176</td>
<td>tNET</td>
<td>RR</td>
<td>1</td>
<td>R14C54[0][A]</td>
<td>fault_now_s15/I3</td>
</tr>
<tr>
<td>7.266</td>
<td>0.210</td>
<td>tINS</td>
<td>RR</td>
<td>10</td>
<td>R14C54[0][A]</td>
<td style=" background: #97FFFF;">fault_now_s15/F</td>
</tr>
<tr>
<td>8.056</td>
<td>0.790</td>
<td>tNET</td>
<td>RR</td>
<td>1</td>
<td>R18C43[1][B]</td>
<td>motion/n1378_s8/I0</td>
</tr>
<tr>
<td>8.477</td>
<td>0.421</td>
<td>tINS</td>
<td>RR</td>
<td>5</td>
<td>R18C43[1][B]</td>
<td style=" background: #97FFFF;">motion/n1378_s8/F</td>
</tr>
<tr>
<td>9.178</td>
<td>0.701</td>
<td>tNET</td>
<td>RR</td>
<td>1</td>
<td>R8C53[1][B]</td>
<td>next_status_2_s1/I3</td>
</tr>
<tr>
<td>9.599</td>
<td>0.421</td>
<td>tINS</td>
<td>RR</td>
<td>66</td>
<td>R8C53[1][B]</td>
<td style=" background: #97FFFF;">next_status_2_s1/F</td>
</tr>
<tr>
<td>9.998</td>
<td>0.399</td>
<td>tNET</td>
<td>RR</td>
<td>2</td>
<td>R11C53[1][A]</td>
<td>n2089_s0/I0</td>
</tr>
<tr>
<td>10.443</td>
<td>0.445</td>
<td>tINS</td>
<td>RF</td>
<td>1</td>
<td>R11C53[1][A]</td>
<td style=" background: #97FFFF;">n2089_s0/COUT</td>
</tr>
<tr>
<td>10.443</td>
<td>0.000</td>
<td>tNET</td>
<td>FF</td>
<td>2</td>
<td>R11C53[1][B]</td>
<td>n2091_s0/CIN</td>
</tr>
<tr>
<td>10.483</td>
<td>0.040</td>
<td>tINS</td>
<td>FR</td>
<td>1</td>
<td>R11C53[1][B]</td>
<td style=" background: #97FFFF;">n2091_s0/COUT</td>
</tr>
<tr>
<td>11.211</td>
<td>0.728</td>
<td>tNET</td>
<td>RR</td>
<td>1</td>
<td>R2C60[0][A]</td>
<td>packets/requested_Z_0_s/I2</td>
</tr>
<tr>
<td>11.421</td>
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
<td>R3C75[1][B]</td>
<td>packets/fifo_s6804/I2</td>
</tr>
<tr>
<td>16.268</td>
<td>0.369</td>
<td>tINS</td>
<td>RR</td>
<td>57</td>
<td>R3C75[1][B]</td>
<td style=" background: #97FFFF;">packets/fifo_s6804/F</td>
</tr>
<tr>
<td>18.267</td>
<td>1.999</td>
<td>tNET</td>
<td>RR</td>
<td>1</td>
<td>R12C83[3][B]</td>
<td>packets/fifo_s6879/I2</td>
</tr>
<tr>
<td>18.684</td>
<td>0.417</td>
<td>tINS</td>
<td>RR</td>
<td>6</td>
<td>R12C83[3][B]</td>
<td style=" background: #97FFFF;">packets/fifo_s6879/F</td>
</tr>
<tr>
<td>18.812</td>
<td>0.128</td>
<td>tNET</td>
<td>RR</td>
<td>1</td>
<td>R12C84[0][A]</td>
<td>packets/fifo_s6564/I2</td>
</tr>
<tr>
<td>19.181</td>
<td>0.369</td>
<td>tINS</td>
<td>RR</td>
<td>6</td>
<td>R12C84[0][A]</td>
<td style=" background: #97FFFF;">packets/fifo_s6564/F</td>
</tr>
<tr>
<td>19.449</td>
<td>0.268</td>
<td>tNET</td>
<td>RR</td>
<td>1</td>
<td>R12C85[0][B]</td>
<td style=" font-weight:bold;">packets/fifo_fifo_RAMREG_63_G[8]_s0/CE</td>
</tr>
</table>
<p><b>Data Required Path:</b></p>
<table class="detail_table">
<tr>
<th class="label">AT</th>
<th class="label">DELAY</th>
<th class="label">TYPE</th>
<th class="label">RF</th>
<th class="label">FANOUT</th>
<th class="label">LOC</th>
<th>NODE</th>
</tr>
<tr>
<td>20.000</td>
<td>20.000</td>
<td></td>
<td></td>
<td></td>
<td></td>
<td>active clock edge time</td>
</tr>
<tr>
<td>20.000</td>
<td>0.000</td>
<td></td>
<td></td>
<td></td>
<td></td>
<td>clk_50m</td>
</tr>
<tr>
<td>20.000</td>
<td>0.000</td>
<td>tCL</td>
<td>RR</td>
<td>1</td>
<td>IOB29[A]</td>
<td>clk_50m_ibuf/I</td>
</tr>
<tr>
<td>21.046</td>
<td>1.046</td>
<td>tINS</td>
<td>RR</td>
<td>3385</td>
<td>IOB29[A]</td>
<td>clk_50m_ibuf/O</td>
</tr>
<tr>
<td>22.580</td>
<td>1.534</td>
<td>tNET</td>
<td>RR</td>
<td>1</td>
<td>R12C85[0][B]</td>
<td>packets/fifo_fifo_RAMREG_63_G[8]_s0/CLK</td>
</tr>
<tr>
<td>22.331</td>
<td>-0.249</td>
<td>tSu</td>
<td></td>
<td>1</td>
<td>R12C85[0][B]</td>
<td>packets/fifo_fifo_RAMREG_63_G[8]_s0</td>
</tr>
</table>
<p><b>Path Statistics:</b></p>
<table class="summary_table">
<tr>
<td class="label">Clock Skew</td>
<td>-0.027</td>
</tr>
<tr>
<td class="label">Setup Relationship </td>
<td>20.000</td>
</tr>
<tr>
<td class="label">Logic Level</td>
<td>18</td>
</tr>
<tr>
<td class="label">Arrival Clock Path Delay</td>
<td>cell: 1.046, 40.123%; route: 1.561, 59.877%</td>
</tr>
<tr>
<td class="label">Arrival Data Path Delay</td>
<td>cell: 5.957, 35.370%; route: 10.591, 62.884%; tC2Q: 0.294, 1.746%</td>
</tr>
<tr>
<td class="label">Required Clock Path Delay</td>
<td>cell: 1.046, 40.546%; route: 1.534, 59.454%</td>
</tr>
</table>
<h3>Path7</h3>
<p><b>Path Summary:</b></p>
<table class="summary_table">
<tr>
<td class="label">Slack</td>
<td>2.882</td>
</tr>
<tr>
<td class="label">Data Arrival Time</td>
<td>19.449</td>
</tr>
<tr>
<td class="label">Data Required Time</td>
<td>22.331</td>
</tr>
<tr>
<td class="label">From</td>
<td>imu/ready_s1</td>
</tr>
<tr>
<td class="label">To</td>
<td>packets/fifo_fifo_RAMREG_63_G[4]_s0</td>
</tr>
<tr>
<td class="label">Launch Clk</td>
<td>clk_50m:[R]</td>
</tr>
<tr>
<td class="label">Latch Clk</td>
<td>clk_50m:[R]</td>
</tr>
</table>
<p><b>Data Arrival Path:</b></p>
<table class="detail_table">
<tr>
<th class="label">AT</th>
<th class="label">DELAY</th>
<th class="label">TYPE</th>
<th class="label">RF</th>
<th class="label">FANOUT</th>
<th class="label">LOC</th>
<th>NODE</th>
</tr>
<tr>
<td>0.000</td>
<td>0.000</td>
<td></td>
<td></td>
<td></td>
<td></td>
<td>active clock edge time</td>
</tr>
<tr>
<td>0.000</td>
<td>0.000</td>
<td></td>
<td></td>
<td></td>
<td></td>
<td>clk_50m</td>
</tr>
<tr>
<td>0.000</td>
<td>0.000</td>
<td>tCL</td>
<td>RR</td>
<td>1</td>
<td>IOB29[A]</td>
<td>clk_50m_ibuf/I</td>
</tr>
<tr>
<td>1.046</td>
<td>1.046</td>
<td>tINS</td>
<td>RR</td>
<td>3385</td>
<td>IOB29[A]</td>
<td>clk_50m_ibuf/O</td>
</tr>
<tr>
<td>2.607</td>
<td>1.561</td>
<td>tNET</td>
<td>RR</td>
<td>1</td>
<td>R22C87[1][A]</td>
<td>imu/ready_s1/CLK</td>
</tr>
<tr>
<td>2.901</td>
<td>0.294</td>
<td>tC2Q</td>
<td>RF</td>
<td>277</td>
<td>R22C87[1][A]</td>
<td style=" font-weight:bold;">imu/ready_s1/Q</td>
</tr>
<tr>
<td>6.088</td>
<td>3.187</td>
<td>tNET</td>
<td>FF</td>
<td>1</td>
<td>R14C56[2][A]</td>
<td>fault_now_s6/I0</td>
</tr>
<tr>
<td>6.509</td>
<td>0.421</td>
<td>tINS</td>
<td>FR</td>
<td>1</td>
<td>R14C56[2][A]</td>
<td style=" background: #97FFFF;">fault_now_s6/F</td>
</tr>
<tr>
<td>6.511</td>
<td>0.002</td>
<td>tNET</td>
<td>RR</td>
<td>1</td>
<td>R14C56[0][A]</td>
<td>fault_now_s2/I3</td>
</tr>
<tr>
<td>6.880</td>
<td>0.369</td>
<td>tINS</td>
<td>RR</td>
<td>10</td>
<td>R14C56[0][A]</td>
<td style=" background: #97FFFF;">fault_now_s2/F</td>
</tr>
<tr>
<td>7.056</td>
<td>0.176</td>
<td>tNET</td>
<td>RR</td>
<td>1</td>
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
<td>RR</td>
<td>1</td>
<td>IOB29[A]</td>
<td>clk_50m_ibuf/I</td>
</tr>
<tr>
<td>21.046</td>
<td>1.046</td>
<td>tINS</td>
<td>RR</td>
<td>3385</td>
<td>IOB29[A]</td>
<td>clk_50m_ibuf/O</td>
</tr>
<tr>
<td>22.580</td>
<td>1.534</td>
<td>tNET</td>
<td>RR</td>
<td>1</td>
<td>R12C85[0][A]</td>
<td>packets/fifo_fifo_RAMREG_63_G[2]_s0/CLK</td>
</tr>
<tr>
<td>22.331</td>
<td>-0.249</td>
<td>tSu</td>
<td></td>
<td>1</td>
<td>R12C85[0][A]</td>
<td>packets/fifo_fifo_RAMREG_63_G[2]_s0</td>
</tr>
</table>
<p><b>Path Statistics:</b></p>
<table class="summary_table">
<tr>
<td class="label">Clock Skew</td>
<td>-0.027</td>
</tr>
<tr>
<td class="label">Setup Relationship </td>
<td>20.000</td>
</tr>
<tr>
<td class="label">Logic Level</td>
<td>18</td>
</tr>
<tr>
<td class="label">Arrival Clock Path Delay</td>
<td>cell: 1.046, 40.123%; route: 1.561, 59.877%</td>
</tr>
<tr>
<td class="label">Arrival Data Path Delay</td>
<td>cell: 5.957, 35.370%; route: 10.591, 62.884%; tC2Q: 0.294, 1.746%</td>
</tr>
<tr>
<td class="label">Required Clock Path Delay</td>
<td>cell: 1.046, 40.546%; route: 1.534, 59.454%</td>
</tr>
</table>
<h3>Path9</h3>
<p><b>Path Summary:</b></p>
<table class="summary_table">
<tr>
<td class="label">Slack</td>
<td>2.882</td>
</tr>
<tr>
<td class="label">Data Arrival Time</td>
<td>19.449</td>
</tr>
<tr>
<td class="label">Data Required Time</td>
<td>22.331</td>
</tr>
<tr>
<td class="label">From</td>
<td>imu/ready_s1</td>
</tr>
<tr>
<td class="label">To</td>
<td>packets/fifo_fifo_RAMREG_63_G[1]_s0</td>
</tr>
<tr>
<td class="label">Launch Clk</td>
<td>clk_50m:[R]</td>
</tr>
<tr>
<td class="label">Latch Clk</td>
<td>clk_50m:[R]</td>
</tr>
</table>
<p><b>Data Arrival Path:</b></p>
<table class="detail_table">
<tr>
<th class="label">AT</th>
<th class="label">DELAY</th>
<th class="label">TYPE</th>
<th class="label">RF</th>
<th class="label">FANOUT</th>
<th class="label">LOC</th>
<th>NODE</th>
</tr>
<tr>
<td>0.000</td>
<td>0.000</td>
<td></td>
<td></td>
<td></td>
<td></td>
<td>active clock edge time</td>
</tr>
<tr>
<td>0.000</td>
<td>0.000</td>
<td></td>
<td></td>
<td></td>
<td></td>
<td>clk_50m</td>
</tr>
<tr>
<td>0.000</td>
<td>0.000</td>
<td>tCL</td>
<td>RR</td>
<td>1</td>
<td>IOB29[A]</td>
<td>clk_50m_ibuf/I</td>
</tr>
<tr>
<td>1.046</td>
<td>1.046</td>
<td>tINS</td>
<td>RR</td>
<td>3385</td>
<td>IOB29[A]</td>
<td>clk_50m_ibuf/O</td>
</tr>
<tr>
<td>2.607</td>
<td>1.561</td>
<td>tNET</td>
<td>RR</td>
<td>1</td>
<td>R22C87[1][A]</td>
<td>imu/ready_s1/CLK</td>
</tr>
<tr>
<td>2.901</td>
<td>0.294</td>
<td>tC2Q</td>
<td>RF</td>
<td>277</td>
<td>R22C87[1][A]</td>
<td style=" font-weight:bold;">imu/ready_s1/Q</td>
</tr>
<tr>
<td>6.088</td>
<td>3.187</td>
<td>tNET</td>
<td>FF</td>
<td>1</td>
<td>R14C56[2][A]</td>
<td>fault_now_s6/I0</td>
</tr>
<tr>
<td>6.509</td>
<td>0.421</td>
<td>tINS</td>
<td>FR</td>
<td>1</td>
<td>R14C56[2][A]</td>
<td style=" background: #97FFFF;">fault_now_s6/F</td>
</tr>
<tr>
<td>6.511</td>
<td>0.002</td>
<td>tNET</td>
<td>RR</td>
<td>1</td>
<td>R14C56[0][A]</td>
<td>fault_now_s2/I3</td>
</tr>
<tr>
<td>6.880</td>
<td>0.369</td>
<td>tINS</td>
<td>RR</td>
<td>10</td>
<td>R14C56[0][A]</td>
<td style=" background: #97FFFF;">fault_now_s2/F</td>
</tr>
<tr>
<td>7.056</td>
<td>0.176</td>
<td>tNET</td>
<td>RR</td>
<td>1</td>
<td>R14C54[0][A]</td>
<td>fault_now_s15/I3</td>
</tr>
<tr>
<td>7.266</td>
<td>0.210</td>
<td>tINS</td>
<td>RR</td>
<td>10</td>
<td>R14C54[0][A]</td>
<td style=" background: #97FFFF;">fault_now_s15/F</td>
</tr>
<tr>
<td>8.056</td>
<td>0.790</td>
<td>tNET</td>
<td>RR</td>
<td>1</td>
<td>R18C43[1][B]</td>
<td>motion/n1378_s8/I0</td>
</tr>
<tr>
<td>8.477</td>
<td>0.421</td>
<td>tINS</td>
<td>RR</td>
<td>5</td>
<td>R18C43[1][B]</td>
<td style=" background: #97FFFF;">motion/n1378_s8/F</td>
</tr>
<tr>
<td>9.178</td>
<td>0.701</td>
<td>tNET</td>
<td>RR</td>
<td>1</td>
<td>R8C53[1][B]</td>
<td>next_status_2_s1/I3</td>
</tr>
<tr>
<td>9.599</td>
<td>0.421</td>
<td>tINS</td>
<td>RR</td>
<td>66</td>
<td>R8C53[1][B]</td>
<td style=" background: #97FFFF;">next_status_2_s1/F</td>
</tr>
<tr>
<td>9.998</td>
<td>0.399</td>
<td>tNET</td>
<td>RR</td>
<td>2</td>
<td>R11C53[1][A]</td>
<td>n2089_s0/I0</td>
</tr>
<tr>
<td>10.443</td>
<td>0.445</td>
<td>tINS</td>
<td>RF</td>
<td>1</td>
<td>R11C53[1][A]</td>
<td style=" background: #97FFFF;">n2089_s0/COUT</td>
</tr>
<tr>
<td>10.443</td>
<td>0.000</td>
<td>tNET</td>
<td>FF</td>
<td>2</td>
<td>R11C53[1][B]</td>
<td>n2091_s0/CIN</td>
</tr>
<tr>
<td>10.483</td>
<td>0.040</td>
<td>tINS</td>
<td>FR</td>
<td>1</td>
<td>R11C53[1][B]</td>
<td style=" background: #97FFFF;">n2091_s0/COUT</td>
</tr>
<tr>
<td>11.211</td>
<td>0.728</td>
<td>tNET</td>
<td>RR</td>
<td>1</td>
<td>R2C60[0][A]</td>
<td>packets/requested_Z_0_s/I2</td>
</tr>
<tr>
<td>11.421</td>
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
<td>R3C75[1][B]</td>
<td>packets/fifo_s6804/I2</td>
</tr>
<tr>
<td>16.268</td>
<td>0.369</td>
<td>tINS</td>
<td>RR</td>
<td>57</td>
<td>R3C75[1][B]</td>
<td style=" background: #97FFFF;">packets/fifo_s6804/F</td>
</tr>
<tr>
<td>18.267</td>
<td>1.999</td>
<td>tNET</td>
<td>RR</td>
<td>1</td>
<td>R12C83[3][B]</td>
<td>packets/fifo_s6879/I2</td>
</tr>
<tr>
<td>18.684</td>
<td>0.417</td>
<td>tINS</td>
<td>RR</td>
<td>6</td>
<td>R12C83[3][B]</td>
<td style=" background: #97FFFF;">packets/fifo_s6879/F</td>
</tr>
<tr>
<td>18.812</td>
<td>0.128</td>
<td>tNET</td>
<td>RR</td>
<td>1</td>
<td>R12C84[0][A]</td>
<td>packets/fifo_s6564/I2</td>
</tr>
<tr>
<td>19.181</td>
<td>0.369</td>
<td>tINS</td>
<td>RR</td>
<td>6</td>
<td>R12C84[0][A]</td>
<td style=" background: #97FFFF;">packets/fifo_s6564/F</td>
</tr>
<tr>
<td>19.449</td>
<td>0.268</td>
<td>tNET</td>
<td>RR</td>
<td>1</td>
<td>R12C85[1][B]</td>
<td style=" font-weight:bold;">packets/fifo_fifo_RAMREG_63_G[0]_s0/CE</td>
</tr>
</table>
<p><b>Data Required Path:</b></p>
<table class="detail_table">
<tr>
<th class="label">AT</th>
<th class="label">DELAY</th>
<th class="label">TYPE</th>
<th class="label">RF</th>
<th class="label">FANOUT</th>
<th class="label">LOC</th>
<th>NODE</th>
</tr>
<tr>
<td>20.000</td>
<td>20.000</td>
<td></td>
<td></td>
<td></td>
<td></td>
<td>active clock edge time</td>
</tr>
<tr>
<td>20.000</td>
<td>0.000</td>
<td></td>
<td></td>
<td></td>
<td></td>
<td>clk_50m</td>
</tr>
<tr>
<td>20.000</td>
<td>0.000</td>
<td>tCL</td>
<td>RR</td>
<td>1</td>
<td>IOB29[A]</td>
<td>clk_50m_ibuf/I</td>
</tr>
<tr>
<td>21.046</td>
<td>1.046</td>
<td>tINS</td>
<td>RR</td>
<td>3385</td>
<td>IOB29[A]</td>
<td>clk_50m_ibuf/O</td>
</tr>
<tr>
<td>22.580</td>
<td>1.534</td>
<td>tNET</td>
<td>RR</td>
<td>1</td>
<td>R12C85[1][B]</td>
<td>packets/fifo_fifo_RAMREG_63_G[0]_s0/CLK</td>
</tr>
<tr>
<td>22.331</td>
<td>-0.249</td>
<td>tSu</td>
<td></td>
<td>1</td>
<td>R12C85[1][B]</td>
<td>packets/fifo_fifo_RAMREG_63_G[0]_s0</td>
</tr>
</table>
<p><b>Path Statistics:</b></p>
<table class="summary_table">
<tr>
<td class="label">Clock Skew</td>
<td>-0.027</td>
</tr>
<tr>
<td class="label">Setup Relationship </td>
<td>20.000</td>
</tr>
<tr>
<td class="label">Logic Level</td>
<td>18</td>
</tr>
<tr>
<td class="label">Arrival Clock Path Delay</td>
<td>cell: 1.046, 40.123%; route: 1.561, 59.877%</td>
</tr>
<tr>
<td class="label">Arrival Data Path Delay</td>
<td>cell: 5.957, 35.370%; route: 10.591, 62.884%; tC2Q: 0.294, 1.746%</td>
</tr>
<tr>
<td class="label">Required Clock Path Delay</td>
<td>cell: 1.046, 40.546%; route: 1.534, 59.454%</td>
</tr>
</table>
<h3>Path11</h3>
<p><b>Path Summary:</b></p>
<table class="summary_table">
<tr>
<td class="label">Slack</td>
<td>2.958</td>
</tr>
<tr>
<td class="label">Data Arrival Time</td>
<td>19.386</td>
</tr>
<tr>
<td class="label">Data Required Time</td>
<td>22.344</td>
</tr>
<tr>
<td class="label">From</td>
<td>imu/ready_s1</td>
</tr>
<tr>
<td class="label">To</td>
<td>packets/fifo_fifo_RAMREG_17_G[4]_s0</td>
</tr>
<tr>
<td class="label">Launch Clk</td>
<td>clk_50m:[R]</td>
</tr>
<tr>
<td class="label">Latch Clk</td>
<td>clk_50m:[R]</td>
</tr>
</table>
<p><b>Data Arrival Path:</b></p>
<table class="detail_table">
<tr>
<th class="label">AT</th>
<th class="label">DELAY</th>
<th class="label">TYPE</th>
<th class="label">RF</th>
<th class="label">FANOUT</th>
<th class="label">LOC</th>
<th>NODE</th>
</tr>
<tr>
<td>0.000</td>
<td>0.000</td>
<td></td>
<td></td>
<td></td>
<td></td>
<td>active clock edge time</td>
</tr>
<tr>
<td>0.000</td>
<td>0.000</td>
<td></td>
<td></td>
<td></td>
<td></td>
<td>clk_50m</td>
</tr>
<tr>
<td>0.000</td>
<td>0.000</td>
<td>tCL</td>
<td>RR</td>
<td>1</td>
<td>IOB29[A]</td>
<td>clk_50m_ibuf/I</td>
</tr>
<tr>
<td>1.046</td>
<td>1.046</td>
<td>tINS</td>
<td>RR</td>
<td>3385</td>
<td>IOB29[A]</td>
<td>clk_50m_ibuf/O</td>
</tr>
<tr>
<td>2.607</td>
<td>1.561</td>
<td>tNET</td>
<td>RR</td>
<td>1</td>
<td>R22C87[1][A]</td>
<td>imu/ready_s1/CLK</td>
</tr>
<tr>
<td>2.901</td>
<td>0.294</td>
<td>tC2Q</td>
<td>RF</td>
<td>277</td>
<td>R22C87[1][A]</td>
<td style=" font-weight:bold;">imu/ready_s1/Q</td>
</tr>
<tr>
<td>6.088</td>
<td>3.187</td>
<td>tNET</td>
<td>FF</td>
<td>1</td>
<td>R14C56[2][A]</td>
<td>fault_now_s6/I0</td>
</tr>
<tr>
<td>6.509</td>
<td>0.421</td>
<td>tINS</td>
<td>FR</td>
<td>1</td>
<td>R14C56[2][A]</td>
<td style=" background: #97FFFF;">fault_now_s6/F</td>
</tr>
<tr>
<td>6.511</td>
<td>0.002</td>
<td>tNET</td>
<td>RR</td>
<td>1</td>
<td>R14C56[0][A]</td>
<td>fault_now_s2/I3</td>
</tr>
<tr>
<td>6.880</td>
<td>0.369</td>
<td>tINS</td>
<td>RR</td>
<td>10</td>
<td>R14C56[0][A]</td>
<td style=" background: #97FFFF;">fault_now_s2/F</td>
</tr>
<tr>
<td>7.056</td>
<td>0.176</td>
<td>tNET</td>
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
<td>RR</td>
<td>1</td>
<td>IOB29[A]</td>
<td>clk_50m_ibuf/I</td>
</tr>
<tr>
<td>21.046</td>
<td>1.046</td>
<td>tINS</td>
<td>RR</td>
<td>3385</td>
<td>IOB29[A]</td>
<td>clk_50m_ibuf/O</td>
</tr>
<tr>
<td>22.603</td>
<td>1.557</td>
<td>tNET</td>
<td>RR</td>
<td>1</td>
<td>R8C72[2][A]</td>
<td>packets/fifo_fifo_RAMREG_56_G[9]_s0/CLK</td>
</tr>
<tr>
<td>22.354</td>
<td>-0.249</td>
<td>tSu</td>
<td></td>
<td>1</td>
<td>R8C72[2][A]</td>
<td>packets/fifo_fifo_RAMREG_56_G[9]_s0</td>
</tr>
</table>
<p><b>Path Statistics:</b></p>
<table class="summary_table">
<tr>
<td class="label">Clock Skew</td>
<td>-0.004</td>
</tr>
<tr>
<td class="label">Setup Relationship </td>
<td>20.000</td>
</tr>
<tr>
<td class="label">Logic Level</td>
<td>18</td>
</tr>
<tr>
<td class="label">Arrival Clock Path Delay</td>
<td>cell: 1.046, 40.123%; route: 1.561, 59.877%</td>
</tr>
<tr>
<td class="label">Arrival Data Path Delay</td>
<td>cell: 6.053, 36.094%; route: 10.423, 62.153%; tC2Q: 0.294, 1.753%</td>
</tr>
<tr>
<td class="label">Required Clock Path Delay</td>
<td>cell: 1.046, 40.188%; route: 1.557, 59.812%</td>
</tr>
</table>
<h3>Path13</h3>
<p><b>Path Summary:</b></p>
<table class="summary_table">
<tr>
<td class="label">Slack</td>
<td>2.985</td>
</tr>
<tr>
<td class="label">Data Arrival Time</td>
<td>19.331</td>
</tr>
<tr>
<td class="label">Data Required Time</td>
<td>22.316</td>
</tr>
<tr>
<td class="label">From</td>
<td>imu/ready_s1</td>
</tr>
<tr>
<td class="label">To</td>
<td>packets/fifo_fifo_RAMREG_15_G[8]_s0</td>
</tr>
<tr>
<td class="label">Launch Clk</td>
<td>clk_50m:[R]</td>
</tr>
<tr>
<td class="label">Latch Clk</td>
<td>clk_50m:[R]</td>
</tr>
</table>
<p><b>Data Arrival Path:</b></p>
<table class="detail_table">
<tr>
<th class="label">AT</th>
<th class="label">DELAY</th>
<th class="label">TYPE</th>
<th class="label">RF</th>
<th class="label">FANOUT</th>
<th class="label">LOC</th>
<th>NODE</th>
</tr>
<tr>
<td>0.000</td>
<td>0.000</td>
<td></td>
<td></td>
<td></td>
<td></td>
<td>active clock edge time</td>
</tr>
<tr>
<td>0.000</td>
<td>0.000</td>
<td></td>
<td></td>
<td></td>
<td></td>
<td>clk_50m</td>
</tr>
<tr>
<td>0.000</td>
<td>0.000</td>
<td>tCL</td>
<td>RR</td>
<td>1</td>
<td>IOB29[A]</td>
<td>clk_50m_ibuf/I</td>
</tr>
<tr>
<td>1.046</td>
<td>1.046</td>
<td>tINS</td>
<td>RR</td>
<td>3385</td>
<td>IOB29[A]</td>
<td>clk_50m_ibuf/O</td>
</tr>
<tr>
<td>2.607</td>
<td>1.561</td>
<td>tNET</td>
<td>RR</td>
<td>1</td>
<td>R22C87[1][A]</td>
<td>imu/ready_s1/CLK</td>
</tr>
<tr>
<td>2.901</td>
<td>0.294</td>
<td>tC2Q</td>
<td>RF</td>
<td>277</td>
<td>R22C87[1][A]</td>
<td style=" font-weight:bold;">imu/ready_s1/Q</td>
</tr>
<tr>
<td>6.088</td>
<td>3.187</td>
<td>tNET</td>
<td>FF</td>
<td>1</td>
<td>R14C56[2][A]</td>
<td>fault_now_s6/I0</td>
</tr>
<tr>
<td>6.509</td>
<td>0.421</td>
<td>tINS</td>
<td>FR</td>
<td>1</td>
<td>R14C56[2][A]</td>
<td style=" background: #97FFFF;">fault_now_s6/F</td>
</tr>
<tr>
<td>6.511</td>
<td>0.002</td>
<td>tNET</td>
<td>RR</td>
<td>1</td>
<td>R14C56[0][A]</td>
<td>fault_now_s2/I3</td>
</tr>
<tr>
<td>6.880</td>
<td>0.369</td>
<td>tINS</td>
<td>RR</td>
<td>10</td>
<td>R14C56[0][A]</td>
<td style=" background: #97FFFF;">fault_now_s2/F</td>
</tr>
<tr>
<td>7.056</td>
<td>0.176</td>
<td>tNET</td>
<td>RR</td>
<td>1</td>
<td>R14C54[0][A]</td>
<td>fault_now_s15/I3</td>
</tr>
<tr>
<td>7.266</td>
<td>0.210</td>
<td>tINS</td>
<td>RR</td>
<td>10</td>
<td>R14C54[0][A]</td>
<td style=" background: #97FFFF;">fault_now_s15/F</td>
</tr>
<tr>
<td>8.056</td>
<td>0.790</td>
<td>tNET</td>
<td>RR</td>
<td>1</td>
<td>R18C43[1][B]</td>
<td>motion/n1378_s8/I0</td>
</tr>
<tr>
<td>8.477</td>
<td>0.421</td>
<td>tINS</td>
<td>RR</td>
<td>5</td>
<td>R18C43[1][B]</td>
<td style=" background: #97FFFF;">motion/n1378_s8/F</td>
</tr>
<tr>
<td>9.178</td>
<td>0.701</td>
<td>tNET</td>
<td>RR</td>
<td>1</td>
<td>R8C53[1][B]</td>
<td>next_status_2_s1/I3</td>
</tr>
<tr>
<td>9.599</td>
<td>0.421</td>
<td>tINS</td>
<td>RR</td>
<td>66</td>
<td>R8C53[1][B]</td>
<td style=" background: #97FFFF;">next_status_2_s1/F</td>
</tr>
<tr>
<td>9.998</td>
<td>0.399</td>
<td>tNET</td>
<td>RR</td>
<td>2</td>
<td>R11C53[1][A]</td>
<td>n2089_s0/I0</td>
</tr>
<tr>
<td>10.443</td>
<td>0.445</td>
<td>tINS</td>
<td>RF</td>
<td>1</td>
<td>R11C53[1][A]</td>
<td style=" background: #97FFFF;">n2089_s0/COUT</td>
</tr>
<tr>
<td>10.443</td>
<td>0.000</td>
<td>tNET</td>
<td>FF</td>
<td>2</td>
<td>R11C53[1][B]</td>
<td>n2091_s0/CIN</td>
</tr>
<tr>
<td>10.483</td>
<td>0.040</td>
<td>tINS</td>
<td>FR</td>
<td>1</td>
<td>R11C53[1][B]</td>
<td style=" background: #97FFFF;">n2091_s0/COUT</td>
</tr>
<tr>
<td>11.211</td>
<td>0.728</td>
<td>tNET</td>
<td>RR</td>
<td>1</td>
<td>R2C60[0][A]</td>
<td>packets/requested_Z_0_s/I2</td>
</tr>
<tr>
<td>11.421</td>
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
<td>R3C75[1][B]</td>
<td>packets/fifo_s6804/I2</td>
</tr>
<tr>
<td>16.268</td>
<td>0.369</td>
<td>tINS</td>
<td>RR</td>
<td>57</td>
<td>R3C75[1][B]</td>
<td style=" background: #97FFFF;">packets/fifo_s6804/F</td>
</tr>
<tr>
<td>18.267</td>
<td>1.999</td>
<td>tNET</td>
<td>RR</td>
<td>1</td>
<td>R12C83[2][B]</td>
<td>packets/fifo_s6831/I1</td>
</tr>
<tr>
<td>18.680</td>
<td>0.413</td>
<td>tINS</td>
<td>RR</td>
<td>6</td>
<td>R12C83[2][B]</td>
<td style=" background: #97FFFF;">packets/fifo_s6831/F</td>
</tr>
<tr>
<td>18.798</td>
<td>0.118</td>
<td>tNET</td>
<td>RR</td>
<td>1</td>
<td>R12C83[3][A]</td>
<td>packets/fifo_s6516/I2</td>
</tr>
<tr>
<td>19.215</td>
<td>0.417</td>
<td>tINS</td>
<td>RR</td>
<td>6</td>
<td>R12C83[3][A]</td>
<td style=" background: #97FFFF;">packets/fifo_s6516/F</td>
</tr>
<tr>
<td>19.331</td>
<td>0.116</td>
<td>tNET</td>
<td>RR</td>
<td>1</td>
<td>R12C83[2][A]</td>
<td style=" font-weight:bold;">packets/fifo_fifo_RAMREG_15_G[4]_s0/CE</td>
</tr>
</table>
<p><b>Data Required Path:</b></p>
<table class="detail_table">
<tr>
<th class="label">AT</th>
<th class="label">DELAY</th>
<th class="label">TYPE</th>
<th class="label">RF</th>
<th class="label">FANOUT</th>
<th class="label">LOC</th>
<th>NODE</th>
</tr>
<tr>
<td>20.000</td>
<td>20.000</td>
<td></td>
<td></td>
<td></td>
<td></td>
<td>active clock edge time</td>
</tr>
<tr>
<td>20.000</td>
<td>0.000</td>
<td></td>
<td></td>
<td></td>
<td></td>
<td>clk_50m</td>
</tr>
<tr>
<td>20.000</td>
<td>0.000</td>
<td>tCL</td>
<td>RR</td>
<td>1</td>
<td>IOB29[A]</td>
<td>clk_50m_ibuf/I</td>
</tr>
<tr>
<td>21.046</td>
<td>1.046</td>
<td>tINS</td>
<td>RR</td>
<td>3385</td>
<td>IOB29[A]</td>
<td>clk_50m_ibuf/O</td>
</tr>
<tr>
<td>22.565</td>
<td>1.519</td>
<td>tNET</td>
<td>RR</td>
<td>1</td>
<td>R12C83[2][A]</td>
<td>packets/fifo_fifo_RAMREG_15_G[4]_s0/CLK</td>
</tr>
<tr>
<td>22.316</td>
<td>-0.249</td>
<td>tSu</td>
<td></td>
<td>1</td>
<td>R12C83[2][A]</td>
<td>packets/fifo_fifo_RAMREG_15_G[4]_s0</td>
</tr>
</table>
<p><b>Path Statistics:</b></p>
<table class="summary_table">
<tr>
<td class="label">Clock Skew</td>
<td>-0.042</td>
</tr>
<tr>
<td class="label">Setup Relationship </td>
<td>20.000</td>
</tr>
<tr>
<td class="label">Logic Level</td>
<td>18</td>
</tr>
<tr>
<td class="label">Arrival Clock Path Delay</td>
<td>cell: 1.046, 40.123%; route: 1.561, 59.877%</td>
</tr>
<tr>
<td class="label">Arrival Data Path Delay</td>
<td>cell: 6.001, 35.883%; route: 10.429, 62.359%; tC2Q: 0.294, 1.758%</td>
</tr>
<tr>
<td class="label">Required Clock Path Delay</td>
<td>cell: 1.046, 40.784%; route: 1.519, 59.216%</td>
</tr>
</table>
<h3>Path15</h3>
<p><b>Path Summary:</b></p>
<table class="summary_table">
<tr>
<td class="label">Slack</td>
<td>2.985</td>
</tr>
<tr>
<td class="label">Data Arrival Time</td>
<td>19.331</td>
</tr>
<tr>
<td class="label">Data Required Time</td>
<td>22.316</td>
</tr>
<tr>
<td class="label">From</td>
<td>imu/ready_s1</td>
</tr>
<tr>
<td class="label">To</td>
<td>packets/fifo_fifo_RAMREG_15_G[2]_s0</td>
</tr>
<tr>
<td class="label">Launch Clk</td>
<td>clk_50m:[R]</td>
</tr>
<tr>
<td class="label">Latch Clk</td>
<td>clk_50m:[R]</td>
</tr>
</table>
<p><b>Data Arrival Path:</b></p>
<table class="detail_table">
<tr>
<th class="label">AT</th>
<th class="label">DELAY</th>
<th class="label">TYPE</th>
<th class="label">RF</th>
<th class="label">FANOUT</th>
<th class="label">LOC</th>
<th>NODE</th>
</tr>
<tr>
<td>0.000</td>
<td>0.000</td>
<td></td>
<td></td>
<td></td>
<td></td>
<td>active clock edge time</td>
</tr>
<tr>
<td>0.000</td>
<td>0.000</td>
<td></td>
<td></td>
<td></td>
<td></td>
<td>clk_50m</td>
</tr>
<tr>
<td>0.000</td>
<td>0.000</td>
<td>tCL</td>
<td>RR</td>
<td>1</td>
<td>IOB29[A]</td>
<td>clk_50m_ibuf/I</td>
</tr>
<tr>
<td>1.046</td>
<td>1.046</td>
<td>tINS</td>
<td>RR</td>
<td>3385</td>
<td>IOB29[A]</td>
<td>clk_50m_ibuf/O</td>
</tr>
<tr>
<td>2.607</td>
<td>1.561</td>
<td>tNET</td>
<td>RR</td>
<td>1</td>
<td>R22C87[1][A]</td>
<td>imu/ready_s1/CLK</td>
</tr>
<tr>
<td>2.901</td>
<td>0.294</td>
<td>tC2Q</td>
<td>RF</td>
<td>277</td>
<td>R22C87[1][A]</td>
<td style=" font-weight:bold;">imu/ready_s1/Q</td>
</tr>
<tr>
<td>6.088</td>
<td>3.187</td>
<td>tNET</td>
<td>FF</td>
<td>1</td>
<td>R14C56[2][A]</td>
<td>fault_now_s6/I0</td>
</tr>
<tr>
<td>6.509</td>
<td>0.421</td>
<td>tINS</td>
<td>FR</td>
<td>1</td>
<td>R14C56[2][A]</td>
<td style=" background: #97FFFF;">fault_now_s6/F</td>
</tr>
<tr>
<td>6.511</td>
<td>0.002</td>
<td>tNET</td>
<td>RR</td>
<td>1</td>
<td>R14C56[0][A]</td>
<td>fault_now_s2/I3</td>
</tr>
<tr>
<td>6.880</td>
<td>0.369</td>
<td>tINS</td>
<td>RR</td>
<td>10</td>
<td>R14C56[0][A]</td>
<td style=" background: #97FFFF;">fault_now_s2/F</td>
</tr>
<tr>
<td>7.056</td>
<td>0.176</td>
<td>tNET</td>
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
<td>RR</td>
<td>1</td>
<td>IOB29[A]</td>
<td>clk_50m_ibuf/I</td>
</tr>
<tr>
<td>21.046</td>
<td>1.046</td>
<td>tINS</td>
<td>RR</td>
<td>3385</td>
<td>IOB29[A]</td>
<td>clk_50m_ibuf/O</td>
</tr>
<tr>
<td>22.565</td>
<td>1.519</td>
<td>tNET</td>
<td>RR</td>
<td>1</td>
<td>R12C83[1][A]</td>
<td>packets/fifo_fifo_RAMREG_15_G[1]_s0/CLK</td>
</tr>
<tr>
<td>22.316</td>
<td>-0.249</td>
<td>tSu</td>
<td></td>
<td>1</td>
<td>R12C83[1][A]</td>
<td>packets/fifo_fifo_RAMREG_15_G[1]_s0</td>
</tr>
</table>
<p><b>Path Statistics:</b></p>
<table class="summary_table">
<tr>
<td class="label">Clock Skew</td>
<td>-0.042</td>
</tr>
<tr>
<td class="label">Setup Relationship </td>
<td>20.000</td>
</tr>
<tr>
<td class="label">Logic Level</td>
<td>18</td>
</tr>
<tr>
<td class="label">Arrival Clock Path Delay</td>
<td>cell: 1.046, 40.123%; route: 1.561, 59.877%</td>
</tr>
<tr>
<td class="label">Arrival Data Path Delay</td>
<td>cell: 6.001, 35.883%; route: 10.429, 62.359%; tC2Q: 0.294, 1.758%</td>
</tr>
<tr>
<td class="label">Required Clock Path Delay</td>
<td>cell: 1.046, 40.784%; route: 1.519, 59.216%</td>
</tr>
</table>
<h3>Path17</h3>
<p><b>Path Summary:</b></p>
<table class="summary_table">
<tr>
<td class="label">Slack</td>
<td>2.985</td>
</tr>
<tr>
<td class="label">Data Arrival Time</td>
<td>19.331</td>
</tr>
<tr>
<td class="label">Data Required Time</td>
<td>22.316</td>
</tr>
<tr>
<td class="label">From</td>
<td>imu/ready_s1</td>
</tr>
<tr>
<td class="label">To</td>
<td>packets/fifo_fifo_RAMREG_15_G[0]_s0</td>
</tr>
<tr>
<td class="label">Launch Clk</td>
<td>clk_50m:[R]</td>
</tr>
<tr>
<td class="label">Latch Clk</td>
<td>clk_50m:[R]</td>
</tr>
</table>
<p><b>Data Arrival Path:</b></p>
<table class="detail_table">
<tr>
<th class="label">AT</th>
<th class="label">DELAY</th>
<th class="label">TYPE</th>
<th class="label">RF</th>
<th class="label">FANOUT</th>
<th class="label">LOC</th>
<th>NODE</th>
</tr>
<tr>
<td>0.000</td>
<td>0.000</td>
<td></td>
<td></td>
<td></td>
<td></td>
<td>active clock edge time</td>
</tr>
<tr>
<td>0.000</td>
<td>0.000</td>
<td></td>
<td></td>
<td></td>
<td></td>
<td>clk_50m</td>
</tr>
<tr>
<td>0.000</td>
<td>0.000</td>
<td>tCL</td>
<td>RR</td>
<td>1</td>
<td>IOB29[A]</td>
<td>clk_50m_ibuf/I</td>
</tr>
<tr>
<td>1.046</td>
<td>1.046</td>
<td>tINS</td>
<td>RR</td>
<td>3385</td>
<td>IOB29[A]</td>
<td>clk_50m_ibuf/O</td>
</tr>
<tr>
<td>2.607</td>
<td>1.561</td>
<td>tNET</td>
<td>RR</td>
<td>1</td>
<td>R22C87[1][A]</td>
<td>imu/ready_s1/CLK</td>
</tr>
<tr>
<td>2.901</td>
<td>0.294</td>
<td>tC2Q</td>
<td>RF</td>
<td>277</td>
<td>R22C87[1][A]</td>
<td style=" font-weight:bold;">imu/ready_s1/Q</td>
</tr>
<tr>
<td>6.088</td>
<td>3.187</td>
<td>tNET</td>
<td>FF</td>
<td>1</td>
<td>R14C56[2][A]</td>
<td>fault_now_s6/I0</td>
</tr>
<tr>
<td>6.509</td>
<td>0.421</td>
<td>tINS</td>
<td>FR</td>
<td>1</td>
<td>R14C56[2][A]</td>
<td style=" background: #97FFFF;">fault_now_s6/F</td>
</tr>
<tr>
<td>6.511</td>
<td>0.002</td>
<td>tNET</td>
<td>RR</td>
<td>1</td>
<td>R14C56[0][A]</td>
<td>fault_now_s2/I3</td>
</tr>
<tr>
<td>6.880</td>
<td>0.369</td>
<td>tINS</td>
<td>RR</td>
<td>10</td>
<td>R14C56[0][A]</td>
<td style=" background: #97FFFF;">fault_now_s2/F</td>
</tr>
<tr>
<td>7.056</td>
<td>0.176</td>
<td>tNET</td>
<td>RR</td>
<td>1</td>
<td>R14C54[0][A]</td>
<td>fault_now_s15/I3</td>
</tr>
<tr>
<td>7.266</td>
<td>0.210</td>
<td>tINS</td>
<td>RR</td>
<td>10</td>
<td>R14C54[0][A]</td>
<td style=" background: #97FFFF;">fault_now_s15/F</td>
</tr>
<tr>
<td>8.056</td>
<td>0.790</td>
<td>tNET</td>
<td>RR</td>
<td>1</td>
<td>R18C43[1][B]</td>
<td>motion/n1378_s8/I0</td>
</tr>
<tr>
<td>8.477</td>
<td>0.421</td>
<td>tINS</td>
<td>RR</td>
<td>5</td>
<td>R18C43[1][B]</td>
<td style=" background: #97FFFF;">motion/n1378_s8/F</td>
</tr>
<tr>
<td>9.178</td>
<td>0.701</td>
<td>tNET</td>
<td>RR</td>
<td>1</td>
<td>R8C53[1][B]</td>
<td>next_status_2_s1/I3</td>
</tr>
<tr>
<td>9.599</td>
<td>0.421</td>
<td>tINS</td>
<td>RR</td>
<td>66</td>
<td>R8C53[1][B]</td>
<td style=" background: #97FFFF;">next_status_2_s1/F</td>
</tr>
<tr>
<td>9.998</td>
<td>0.399</td>
<td>tNET</td>
<td>RR</td>
<td>2</td>
<td>R11C53[1][A]</td>
<td>n2089_s0/I0</td>
</tr>
<tr>
<td>10.443</td>
<td>0.445</td>
<td>tINS</td>
<td>RF</td>
<td>1</td>
<td>R11C53[1][A]</td>
<td style=" background: #97FFFF;">n2089_s0/COUT</td>
</tr>
<tr>
<td>10.443</td>
<td>0.000</td>
<td>tNET</td>
<td>FF</td>
<td>2</td>
<td>R11C53[1][B]</td>
<td>n2091_s0/CIN</td>
</tr>
<tr>
<td>10.483</td>
<td>0.040</td>
<td>tINS</td>
<td>FR</td>
<td>1</td>
<td>R11C53[1][B]</td>
<td style=" background: #97FFFF;">n2091_s0/COUT</td>
</tr>
<tr>
<td>11.211</td>
<td>0.728</td>
<td>tNET</td>
<td>RR</td>
<td>1</td>
<td>R2C60[0][A]</td>
<td>packets/requested_Z_0_s/I2</td>
</tr>
<tr>
<td>11.421</td>
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
<td>R3C75[1][B]</td>
<td>packets/fifo_s6804/I2</td>
</tr>
<tr>
<td>16.268</td>
<td>0.369</td>
<td>tINS</td>
<td>RR</td>
<td>57</td>
<td>R3C75[1][B]</td>
<td style=" background: #97FFFF;">packets/fifo_s6804/F</td>
</tr>
<tr>
<td>18.267</td>
<td>1.999</td>
<td>tNET</td>
<td>RR</td>
<td>1</td>
<td>R12C82[2][B]</td>
<td>packets/fifo_s6873/I3</td>
</tr>
<tr>
<td>18.680</td>
<td>0.413</td>
<td>tINS</td>
<td>RR</td>
<td>6</td>
<td>R12C82[2][B]</td>
<td style=" background: #97FFFF;">packets/fifo_s6873/F</td>
</tr>
<tr>
<td>18.798</td>
<td>0.118</td>
<td>tNET</td>
<td>RR</td>
<td>1</td>
<td>R12C82[3][A]</td>
<td>packets/fifo_s6554/I2</td>
</tr>
<tr>
<td>19.215</td>
<td>0.417</td>
<td>tINS</td>
<td>RR</td>
<td>6</td>
<td>R12C82[3][A]</td>
<td style=" background: #97FFFF;">packets/fifo_s6554/F</td>
</tr>
<tr>
<td>19.331</td>
<td>0.116</td>
<td>tNET</td>
<td>RR</td>
<td>1</td>
<td>R12C82[0][B]</td>
<td style=" font-weight:bold;">packets/fifo_fifo_RAMREG_53_G[8]_s0/CE</td>
</tr>
</table>
<p><b>Data Required Path:</b></p>
<table class="detail_table">
<tr>
<th class="label">AT</th>
<th class="label">DELAY</th>
<th class="label">TYPE</th>
<th class="label">RF</th>
<th class="label">FANOUT</th>
<th class="label">LOC</th>
<th>NODE</th>
</tr>
<tr>
<td>20.000</td>
<td>20.000</td>
<td></td>
<td></td>
<td></td>
<td></td>
<td>active clock edge time</td>
</tr>
<tr>
<td>20.000</td>
<td>0.000</td>
<td></td>
<td></td>
<td></td>
<td></td>
<td>clk_50m</td>
</tr>
<tr>
<td>20.000</td>
<td>0.000</td>
<td>tCL</td>
<td>RR</td>
<td>1</td>
<td>IOB29[A]</td>
<td>clk_50m_ibuf/I</td>
</tr>
<tr>
<td>21.046</td>
<td>1.046</td>
<td>tINS</td>
<td>RR</td>
<td>3385</td>
<td>IOB29[A]</td>
<td>clk_50m_ibuf/O</td>
</tr>
<tr>
<td>22.572</td>
<td>1.526</td>
<td>tNET</td>
<td>RR</td>
<td>1</td>
<td>R12C82[0][B]</td>
<td>packets/fifo_fifo_RAMREG_53_G[8]_s0/CLK</td>
</tr>
<tr>
<td>22.323</td>
<td>-0.249</td>
<td>tSu</td>
<td></td>
<td>1</td>
<td>R12C82[0][B]</td>
<td>packets/fifo_fifo_RAMREG_53_G[8]_s0</td>
</tr>
</table>
<p><b>Path Statistics:</b></p>
<table class="summary_table">
<tr>
<td class="label">Clock Skew</td>
<td>-0.035</td>
</tr>
<tr>
<td class="label">Setup Relationship </td>
<td>20.000</td>
</tr>
<tr>
<td class="label">Logic Level</td>
<td>18</td>
</tr>
<tr>
<td class="label">Arrival Clock Path Delay</td>
<td>cell: 1.046, 40.123%; route: 1.561, 59.877%</td>
</tr>
<tr>
<td class="label">Arrival Data Path Delay</td>
<td>cell: 6.001, 35.883%; route: 10.429, 62.359%; tC2Q: 0.294, 1.758%</td>
</tr>
<tr>
<td class="label">Required Clock Path Delay</td>
<td>cell: 1.046, 40.665%; route: 1.526, 59.335%</td>
</tr>
</table>
<h3>Path19</h3>
<p><b>Path Summary:</b></p>
<table class="summary_table">
<tr>
<td class="label">Slack</td>
<td>2.992</td>
</tr>
<tr>
<td class="label">Data Arrival Time</td>
<td>19.331</td>
</tr>
<tr>
<td class="label">Data Required Time</td>
<td>22.323</td>
</tr>
<tr>
<td class="label">From</td>
<td>imu/ready_s1</td>
</tr>
<tr>
<td class="label">To</td>
<td>packets/fifo_fifo_RAMREG_53_G[4]_s0</td>
</tr>
<tr>
<td class="label">Launch Clk</td>
<td>clk_50m:[R]</td>
</tr>
<tr>
<td class="label">Latch Clk</td>
<td>clk_50m:[R]</td>
</tr>
</table>
<p><b>Data Arrival Path:</b></p>
<table class="detail_table">
<tr>
<th class="label">AT</th>
<th class="label">DELAY</th>
<th class="label">TYPE</th>
<th class="label">RF</th>
<th class="label">FANOUT</th>
<th class="label">LOC</th>
<th>NODE</th>
</tr>
<tr>
<td>0.000</td>
<td>0.000</td>
<td></td>
<td></td>
<td></td>
<td></td>
<td>active clock edge time</td>
</tr>
<tr>
<td>0.000</td>
<td>0.000</td>
<td></td>
<td></td>
<td></td>
<td></td>
<td>clk_50m</td>
</tr>
<tr>
<td>0.000</td>
<td>0.000</td>
<td>tCL</td>
<td>RR</td>
<td>1</td>
<td>IOB29[A]</td>
<td>clk_50m_ibuf/I</td>
</tr>
<tr>
<td>1.046</td>
<td>1.046</td>
<td>tINS</td>
<td>RR</td>
<td>3385</td>
<td>IOB29[A]</td>
<td>clk_50m_ibuf/O</td>
</tr>
<tr>
<td>2.607</td>
<td>1.561</td>
<td>tNET</td>
<td>RR</td>
<td>1</td>
<td>R22C87[1][A]</td>
<td>imu/ready_s1/CLK</td>
</tr>
<tr>
<td>2.901</td>
<td>0.294</td>
<td>tC2Q</td>
<td>RF</td>
<td>277</td>
<td>R22C87[1][A]</td>
<td style=" font-weight:bold;">imu/ready_s1/Q</td>
</tr>
<tr>
<td>6.088</td>
<td>3.187</td>
<td>tNET</td>
<td>FF</td>
<td>1</td>
<td>R14C56[2][A]</td>
<td>fault_now_s6/I0</td>
</tr>
<tr>
<td>6.509</td>
<td>0.421</td>
<td>tINS</td>
<td>FR</td>
<td>1</td>
<td>R14C56[2][A]</td>
<td style=" background: #97FFFF;">fault_now_s6/F</td>
</tr>
<tr>
<td>6.511</td>
<td>0.002</td>
<td>tNET</td>
<td>RR</td>
<td>1</td>
<td>R14C56[0][A]</td>
<td>fault_now_s2/I3</td>
</tr>
<tr>
<td>6.880</td>
<td>0.369</td>
<td>tINS</td>
<td>RR</td>
<td>10</td>
<td>R14C56[0][A]</td>
<td style=" background: #97FFFF;">fault_now_s2/F</td>
</tr>
<tr>
<td>7.056</td>
<td>0.176</td>
<td>tNET</td>
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
<td>RR</td>
<td>1</td>
<td>IOB29[A]</td>
<td>clk_50m_ibuf/I</td>
</tr>
<tr>
<td>21.046</td>
<td>1.046</td>
<td>tINS</td>
<td>RR</td>
<td>3385</td>
<td>IOB29[A]</td>
<td>clk_50m_ibuf/O</td>
</tr>
<tr>
<td>22.572</td>
<td>1.526</td>
<td>tNET</td>
<td>RR</td>
<td>1</td>
<td>R12C82[0][A]</td>
<td>packets/fifo_fifo_RAMREG_53_G[2]_s0/CLK</td>
</tr>
<tr>
<td>22.323</td>
<td>-0.249</td>
<td>tSu</td>
<td></td>
<td>1</td>
<td>R12C82[0][A]</td>
<td>packets/fifo_fifo_RAMREG_53_G[2]_s0</td>
</tr>
</table>
<p><b>Path Statistics:</b></p>
<table class="summary_table">
<tr>
<td class="label">Clock Skew</td>
<td>-0.035</td>
</tr>
<tr>
<td class="label">Setup Relationship </td>
<td>20.000</td>
</tr>
<tr>
<td class="label">Logic Level</td>
<td>18</td>
</tr>
<tr>
<td class="label">Arrival Clock Path Delay</td>
<td>cell: 1.046, 40.123%; route: 1.561, 59.877%</td>
</tr>
<tr>
<td class="label">Arrival Data Path Delay</td>
<td>cell: 6.001, 35.883%; route: 10.429, 62.359%; tC2Q: 0.294, 1.758%</td>
</tr>
<tr>
<td class="label">Required Clock Path Delay</td>
<td>cell: 1.046, 40.665%; route: 1.526, 59.335%</td>
</tr>
</table>
<h3>Path21</h3>
<p><b>Path Summary:</b></p>
<table class="summary_table">
<tr>
<td class="label">Slack</td>
<td>2.992</td>
</tr>
<tr>
<td class="label">Data Arrival Time</td>
<td>19.331</td>
</tr>
<tr>
<td class="label">Data Required Time</td>
<td>22.323</td>
</tr>
<tr>
<td class="label">From</td>
<td>imu/ready_s1</td>
</tr>
<tr>
<td class="label">To</td>
<td>packets/fifo_fifo_RAMREG_53_G[1]_s0</td>
</tr>
<tr>
<td class="label">Launch Clk</td>
<td>clk_50m:[R]</td>
</tr>
<tr>
<td class="label">Latch Clk</td>
<td>clk_50m:[R]</td>
</tr>
</table>
<p><b>Data Arrival Path:</b></p>
<table class="detail_table">
<tr>
<th class="label">AT</th>
<th class="label">DELAY</th>
<th class="label">TYPE</th>
<th class="label">RF</th>
<th class="label">FANOUT</th>
<th class="label">LOC</th>
<th>NODE</th>
</tr>
<tr>
<td>0.000</td>
<td>0.000</td>
<td></td>
<td></td>
<td></td>
<td></td>
<td>active clock edge time</td>
</tr>
<tr>
<td>0.000</td>
<td>0.000</td>
<td></td>
<td></td>
<td></td>
<td></td>
<td>clk_50m</td>
</tr>
<tr>
<td>0.000</td>
<td>0.000</td>
<td>tCL</td>
<td>RR</td>
<td>1</td>
<td>IOB29[A]</td>
<td>clk_50m_ibuf/I</td>
</tr>
<tr>
<td>1.046</td>
<td>1.046</td>
<td>tINS</td>
<td>RR</td>
<td>3385</td>
<td>IOB29[A]</td>
<td>clk_50m_ibuf/O</td>
</tr>
<tr>
<td>2.607</td>
<td>1.561</td>
<td>tNET</td>
<td>RR</td>
<td>1</td>
<td>R22C87[1][A]</td>
<td>imu/ready_s1/CLK</td>
</tr>
<tr>
<td>2.901</td>
<td>0.294</td>
<td>tC2Q</td>
<td>RF</td>
<td>277</td>
<td>R22C87[1][A]</td>
<td style=" font-weight:bold;">imu/ready_s1/Q</td>
</tr>
<tr>
<td>6.088</td>
<td>3.187</td>
<td>tNET</td>
<td>FF</td>
<td>1</td>
<td>R14C56[2][A]</td>
<td>fault_now_s6/I0</td>
</tr>
<tr>
<td>6.509</td>
<td>0.421</td>
<td>tINS</td>
<td>FR</td>
<td>1</td>
<td>R14C56[2][A]</td>
<td style=" background: #97FFFF;">fault_now_s6/F</td>
</tr>
<tr>
<td>6.511</td>
<td>0.002</td>
<td>tNET</td>
<td>RR</td>
<td>1</td>
<td>R14C56[0][A]</td>
<td>fault_now_s2/I3</td>
</tr>
<tr>
<td>6.880</td>
<td>0.369</td>
<td>tINS</td>
<td>RR</td>
<td>10</td>
<td>R14C56[0][A]</td>
<td style=" background: #97FFFF;">fault_now_s2/F</td>
</tr>
<tr>
<td>7.056</td>
<td>0.176</td>
<td>tNET</td>
<td>RR</td>
<td>1</td>
<td>R14C54[0][A]</td>
<td>fault_now_s15/I3</td>
</tr>
<tr>
<td>7.266</td>
<td>0.210</td>
<td>tINS</td>
<td>RR</td>
<td>10</td>
<td>R14C54[0][A]</td>
<td style=" background: #97FFFF;">fault_now_s15/F</td>
</tr>
<tr>
<td>8.056</td>
<td>0.790</td>
<td>tNET</td>
<td>RR</td>
<td>1</td>
<td>R18C43[1][B]</td>
<td>motion/n1378_s8/I0</td>
</tr>
<tr>
<td>8.477</td>
<td>0.421</td>
<td>tINS</td>
<td>RR</td>
<td>5</td>
<td>R18C43[1][B]</td>
<td style=" background: #97FFFF;">motion/n1378_s8/F</td>
</tr>
<tr>
<td>9.178</td>
<td>0.701</td>
<td>tNET</td>
<td>RR</td>
<td>1</td>
<td>R8C53[1][B]</td>
<td>next_status_2_s1/I3</td>
</tr>
<tr>
<td>9.599</td>
<td>0.421</td>
<td>tINS</td>
<td>RR</td>
<td>66</td>
<td>R8C53[1][B]</td>
<td style=" background: #97FFFF;">next_status_2_s1/F</td>
</tr>
<tr>
<td>9.998</td>
<td>0.399</td>
<td>tNET</td>
<td>RR</td>
<td>2</td>
<td>R11C53[1][A]</td>
<td>n2089_s0/I0</td>
</tr>
<tr>
<td>10.443</td>
<td>0.445</td>
<td>tINS</td>
<td>RF</td>
<td>1</td>
<td>R11C53[1][A]</td>
<td style=" background: #97FFFF;">n2089_s0/COUT</td>
</tr>
<tr>
<td>10.443</td>
<td>0.000</td>
<td>tNET</td>
<td>FF</td>
<td>2</td>
<td>R11C53[1][B]</td>
<td>n2091_s0/CIN</td>
</tr>
<tr>
<td>10.483</td>
<td>0.040</td>
<td>tINS</td>
<td>FR</td>
<td>1</td>
<td>R11C53[1][B]</td>
<td style=" background: #97FFFF;">n2091_s0/COUT</td>
</tr>
<tr>
<td>11.211</td>
<td>0.728</td>
<td>tNET</td>
<td>RR</td>
<td>1</td>
<td>R2C60[0][A]</td>
<td>packets/requested_Z_0_s/I2</td>
</tr>
<tr>
<td>11.421</td>
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
<td>R3C75[1][B]</td>
<td>packets/fifo_s6804/I2</td>
</tr>
<tr>
<td>16.268</td>
<td>0.369</td>
<td>tINS</td>
<td>RR</td>
<td>57</td>
<td>R3C75[1][B]</td>
<td style=" background: #97FFFF;">packets/fifo_s6804/F</td>
</tr>
<tr>
<td>18.267</td>
<td>1.999</td>
<td>tNET</td>
<td>RR</td>
<td>1</td>
<td>R12C82[2][B]</td>
<td>packets/fifo_s6873/I3</td>
</tr>
<tr>
<td>18.680</td>
<td>0.413</td>
<td>tINS</td>
<td>RR</td>
<td>6</td>
<td>R12C82[2][B]</td>
<td style=" background: #97FFFF;">packets/fifo_s6873/F</td>
</tr>
<tr>
<td>18.798</td>
<td>0.118</td>
<td>tNET</td>
<td>RR</td>
<td>1</td>
<td>R12C82[3][A]</td>
<td>packets/fifo_s6554/I2</td>
</tr>
<tr>
<td>19.215</td>
<td>0.417</td>
<td>tINS</td>
<td>RR</td>
<td>6</td>
<td>R12C82[3][A]</td>
<td style=" background: #97FFFF;">packets/fifo_s6554/F</td>
</tr>
<tr>
<td>19.331</td>
<td>0.116</td>
<td>tNET</td>
<td>RR</td>
<td>1</td>
<td>R12C82[1][B]</td>
<td style=" font-weight:bold;">packets/fifo_fifo_RAMREG_53_G[0]_s0/CE</td>
</tr>
</table>
<p><b>Data Required Path:</b></p>
<table class="detail_table">
<tr>
<th class="label">AT</th>
<th class="label">DELAY</th>
<th class="label">TYPE</th>
<th class="label">RF</th>
<th class="label">FANOUT</th>
<th class="label">LOC</th>
<th>NODE</th>
</tr>
<tr>
<td>20.000</td>
<td>20.000</td>
<td></td>
<td></td>
<td></td>
<td></td>
<td>active clock edge time</td>
</tr>
<tr>
<td>20.000</td>
<td>0.000</td>
<td></td>
<td></td>
<td></td>
<td></td>
<td>clk_50m</td>
</tr>
<tr>
<td>20.000</td>
<td>0.000</td>
<td>tCL</td>
<td>RR</td>
<td>1</td>
<td>IOB29[A]</td>
<td>clk_50m_ibuf/I</td>
</tr>
<tr>
<td>21.046</td>
<td>1.046</td>
<td>tINS</td>
<td>RR</td>
<td>3385</td>
<td>IOB29[A]</td>
<td>clk_50m_ibuf/O</td>
</tr>
<tr>
<td>22.572</td>
<td>1.526</td>
<td>tNET</td>
<td>RR</td>
<td>1</td>
<td>R12C82[1][B]</td>
<td>packets/fifo_fifo_RAMREG_53_G[0]_s0/CLK</td>
</tr>
<tr>
<td>22.323</td>
<td>-0.249</td>
<td>tSu</td>
<td></td>
<td>1</td>
<td>R12C82[1][B]</td>
<td>packets/fifo_fifo_RAMREG_53_G[0]_s0</td>
</tr>
</table>
<p><b>Path Statistics:</b></p>
<table class="summary_table">
<tr>
<td class="label">Clock Skew</td>
<td>-0.035</td>
</tr>
<tr>
<td class="label">Setup Relationship </td>
<td>20.000</td>
</tr>
<tr>
<td class="label">Logic Level</td>
<td>18</td>
</tr>
<tr>
<td class="label">Arrival Clock Path Delay</td>
<td>cell: 1.046, 40.123%; route: 1.561, 59.877%</td>
</tr>
<tr>
<td class="label">Arrival Data Path Delay</td>
<td>cell: 6.001, 35.883%; route: 10.429, 62.359%; tC2Q: 0.294, 1.758%</td>
</tr>
<tr>
<td class="label">Required Clock Path Delay</td>
<td>cell: 1.046, 40.665%; route: 1.526, 59.335%</td>
</tr>
</table>
<h3>Path23</h3>
<p><b>Path Summary:</b></p>
<table class="summary_table">
<tr>
<td class="label">Slack</td>
<td>3.012</td>
</tr>
<tr>
<td class="label">Data Arrival Time</td>
<td>19.311</td>
</tr>
<tr>
<td class="label">Data Required Time</td>
<td>22.323</td>
</tr>
<tr>
<td class="label">From</td>
<td>imu/ready_s1</td>
</tr>
<tr>
<td class="label">To</td>
<td>packets/fifo_fifo_RAMREG_35_G[9]_s0</td>
</tr>
<tr>
<td class="label">Launch Clk</td>
<td>clk_50m:[R]</td>
</tr>
<tr>
<td class="label">Latch Clk</td>
<td>clk_50m:[R]</td>
</tr>
</table>
<p><b>Data Arrival Path:</b></p>
<table class="detail_table">
<tr>
<th class="label">AT</th>
<th class="label">DELAY</th>
<th class="label">TYPE</th>
<th class="label">RF</th>
<th class="label">FANOUT</th>
<th class="label">LOC</th>
<th>NODE</th>
</tr>
<tr>
<td>0.000</td>
<td>0.000</td>
<td></td>
<td></td>
<td></td>
<td></td>
<td>active clock edge time</td>
</tr>
<tr>
<td>0.000</td>
<td>0.000</td>
<td></td>
<td></td>
<td></td>
<td></td>
<td>clk_50m</td>
</tr>
<tr>
<td>0.000</td>
<td>0.000</td>
<td>tCL</td>
<td>RR</td>
<td>1</td>
<td>IOB29[A]</td>
<td>clk_50m_ibuf/I</td>
</tr>
<tr>
<td>1.046</td>
<td>1.046</td>
<td>tINS</td>
<td>RR</td>
<td>3385</td>
<td>IOB29[A]</td>
<td>clk_50m_ibuf/O</td>
</tr>
<tr>
<td>2.607</td>
<td>1.561</td>
<td>tNET</td>
<td>RR</td>
<td>1</td>
<td>R22C87[1][A]</td>
<td>imu/ready_s1/CLK</td>
</tr>
<tr>
<td>2.901</td>
<td>0.294</td>
<td>tC2Q</td>
<td>RF</td>
<td>277</td>
<td>R22C87[1][A]</td>
<td style=" font-weight:bold;">imu/ready_s1/Q</td>
</tr>
<tr>
<td>6.088</td>
<td>3.187</td>
<td>tNET</td>
<td>FF</td>
<td>1</td>
<td>R14C56[2][A]</td>
<td>fault_now_s6/I0</td>
</tr>
<tr>
<td>6.509</td>
<td>0.421</td>
<td>tINS</td>
<td>FR</td>
<td>1</td>
<td>R14C56[2][A]</td>
<td style=" background: #97FFFF;">fault_now_s6/F</td>
</tr>
<tr>
<td>6.511</td>
<td>0.002</td>
<td>tNET</td>
<td>RR</td>
<td>1</td>
<td>R14C56[0][A]</td>
<td>fault_now_s2/I3</td>
</tr>
<tr>
<td>6.880</td>
<td>0.369</td>
<td>tINS</td>
<td>RR</td>
<td>10</td>
<td>R14C56[0][A]</td>
<td style=" background: #97FFFF;">fault_now_s2/F</td>
</tr>
<tr>
<td>7.056</td>
<td>0.176</td>
<td>tNET</td>
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
<td>RR</td>
<td>1</td>
<td>IOB29[A]</td>
<td>clk_50m_ibuf/I</td>
</tr>
<tr>
<td>21.046</td>
<td>1.046</td>
<td>tINS</td>
<td>RR</td>
<td>3385</td>
<td>IOB29[A]</td>
<td>clk_50m_ibuf/O</td>
</tr>
<tr>
<td>22.580</td>
<td>1.534</td>
<td>tNET</td>
<td>RR</td>
<td>1</td>
<td>R12C85[0][A]</td>
<td>packets/fifo_fifo_RAMREG_63_G[2]_s0/CLK</td>
</tr>
<tr>
<td>22.529</td>
<td>-0.051</td>
<td>tSu</td>
<td></td>
<td>1</td>
<td>R12C85[0][A]</td>
<td>packets/fifo_fifo_RAMREG_63_G[2]_s0</td>
</tr>
</table>
<p><b>Path Statistics:</b></p>
<table class="summary_table">
<tr>
<td class="label">Clock Skew</td>
<td>-0.027</td>
</tr>
<tr>
<td class="label">Setup Relationship </td>
<td>20.000</td>
</tr>
<tr>
<td class="label">Logic Level</td>
<td>18</td>
</tr>
<tr>
<td class="label">Arrival Clock Path Delay</td>
<td>cell: 1.046, 40.123%; route: 1.561, 59.877%</td>
</tr>
<tr>
<td class="label">Arrival Data Path Delay</td>
<td>cell: 6.009, 35.569%; route: 10.591, 62.691%; tC2Q: 0.294, 1.740%</td>
</tr>
<tr>
<td class="label">Required Clock Path Delay</td>
<td>cell: 1.046, 40.546%; route: 1.534, 59.454%</td>
</tr>
</table>
<h3>Path25</h3>
<p><b>Path Summary:</b></p>
<table class="summary_table">
<tr>
<td class="label">Slack</td>
<td>3.030</td>
</tr>
<tr>
<td class="label">Data Arrival Time</td>
<td>19.293</td>
</tr>
<tr>
<td class="label">Data Required Time</td>
<td>22.323</td>
</tr>
<tr>
<td class="label">From</td>
<td>imu/ready_s1</td>
</tr>
<tr>
<td class="label">To</td>
<td>packets/fifo_fifo_RAMREG_63_G[9]_s0</td>
</tr>
<tr>
<td class="label">Launch Clk</td>
<td>clk_50m:[R]</td>
</tr>
<tr>
<td class="label">Latch Clk</td>
<td>clk_50m:[R]</td>
</tr>
</table>
<p><b>Data Arrival Path:</b></p>
<table class="detail_table">
<tr>
<th class="label">AT</th>
<th class="label">DELAY</th>
<th class="label">TYPE</th>
<th class="label">RF</th>
<th class="label">FANOUT</th>
<th class="label">LOC</th>
<th>NODE</th>
</tr>
<tr>
<td>0.000</td>
<td>0.000</td>
<td></td>
<td></td>
<td></td>
<td></td>
<td>active clock edge time</td>
</tr>
<tr>
<td>0.000</td>
<td>0.000</td>
<td></td>
<td></td>
<td></td>
<td></td>
<td>clk_50m</td>
</tr>
<tr>
<td>0.000</td>
<td>0.000</td>
<td>tCL</td>
<td>RR</td>
<td>1</td>
<td>IOB29[A]</td>
<td>clk_50m_ibuf/I</td>
</tr>
<tr>
<td>1.046</td>
<td>1.046</td>
<td>tINS</td>
<td>RR</td>
<td>3385</td>
<td>IOB29[A]</td>
<td>clk_50m_ibuf/O</td>
</tr>
<tr>
<td>2.607</td>
<td>1.561</td>
<td>tNET</td>
<td>RR</td>
<td>1</td>
<td>R22C87[1][A]</td>
<td>imu/ready_s1/CLK</td>
</tr>
<tr>
<td>2.901</td>
<td>0.294</td>
<td>tC2Q</td>
<td>RF</td>
<td>277</td>
<td>R22C87[1][A]</td>
<td style=" font-weight:bold;">imu/ready_s1/Q</td>
</tr>
<tr>
<td>6.088</td>
<td>3.187</td>
<td>tNET</td>
<td>FF</td>
<td>1</td>
<td>R14C56[2][A]</td>
<td>fault_now_s6/I0</td>
</tr>
<tr>
<td>6.509</td>
<td>0.421</td>
<td>tINS</td>
<td>FR</td>
<td>1</td>
<td>R14C56[2][A]</td>
<td style=" background: #97FFFF;">fault_now_s6/F</td>
</tr>
<tr>
<td>6.511</td>
<td>0.002</td>
<td>tNET</td>
<td>RR</td>
<td>1</td>
<td>R14C56[0][A]</td>
<td>fault_now_s2/I3</td>
</tr>
<tr>
<td>6.880</td>
<td>0.369</td>
<td>tINS</td>
<td>RR</td>
<td>10</td>
<td>R14C56[0][A]</td>
<td style=" background: #97FFFF;">fault_now_s2/F</td>
</tr>
<tr>
<td>7.056</td>
<td>0.176</td>
<td>tNET</td>
<td>RR</td>
<td>1</td>
<td>R14C54[0][A]</td>
<td>fault_now_s15/I3</td>
</tr>
<tr>
<td>7.266</td>
<td>0.210</td>
<td>tINS</td>
<td>RR</td>
<td>10</td>
<td>R14C54[0][A]</td>
<td style=" background: #97FFFF;">fault_now_s15/F</td>
</tr>
<tr>
<td>8.056</td>
<td>0.790</td>
<td>tNET</td>
<td>RR</td>
<td>1</td>
<td>R18C43[1][B]</td>
<td>motion/n1378_s8/I0</td>
</tr>
<tr>
<td>8.477</td>
<td>0.421</td>
<td>tINS</td>
<td>RR</td>
<td>5</td>
<td>R18C43[1][B]</td>
<td style=" background: #97FFFF;">motion/n1378_s8/F</td>
</tr>
<tr>
<td>9.178</td>
<td>0.701</td>
<td>tNET</td>
<td>RR</td>
<td>1</td>
<td>R8C53[1][B]</td>
<td>next_status_2_s1/I3</td>
</tr>
<tr>
<td>9.599</td>
<td>0.421</td>
<td>tINS</td>
<td>RR</td>
<td>66</td>
<td>R8C53[1][B]</td>
<td style=" background: #97FFFF;">next_status_2_s1/F</td>
</tr>
<tr>
<td>9.998</td>
<td>0.399</td>
<td>tNET</td>
<td>RR</td>
<td>2</td>
<td>R11C53[1][A]</td>
<td>n2089_s0/I0</td>
</tr>
<tr>
<td>10.443</td>
<td>0.445</td>
<td>tINS</td>
<td>RF</td>
<td>1</td>
<td>R11C53[1][A]</td>
<td style=" background: #97FFFF;">n2089_s0/COUT</td>
</tr>
<tr>
<td>10.443</td>
<td>0.000</td>
<td>tNET</td>
<td>FF</td>
<td>2</td>
<td>R11C53[1][B]</td>
<td>n2091_s0/CIN</td>
</tr>
<tr>
<td>10.483</td>
<td>0.040</td>
<td>tINS</td>
<td>FR</td>
<td>1</td>
<td>R11C53[1][B]</td>
<td style=" background: #97FFFF;">n2091_s0/COUT</td>
</tr>
<tr>
<td>11.211</td>
<td>0.728</td>
<td>tNET</td>
<td>RR</td>
<td>1</td>
<td>R2C60[0][A]</td>
<td>packets/requested_Z_0_s/I2</td>
</tr>
<tr>
<td>11.421</td>
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
<td>1</td>
<td>BSRAM_R28[27]</td>
<td>imu/config_rom/rom_rom_0_3_s/CLK</td>
</tr>
<tr>
<td>1.503</td>
<td>0.035</td>
<td>tHld</td>
<td></td>
<td>1</td>
<td>BSRAM_R28[27]</td>
<td>imu/config_rom/rom_rom_0_3_s</td>
</tr>
</table>
<p><b>Path Statistics:</b></p>
<table class="summary_table">
<tr>
<td class="label">Clock Skew</td>
<td>-0.017</td>
</tr>
<tr>
<td class="label">Hold Relationship </td>
<td>0.000</td>
</tr>
<tr>
<td class="label">Logic Level</td>
<td>1</td>
</tr>
<tr>
<td class="label">Arrival Clock Path Delay</td>
<td>cell: 0.773, 52.067%; route: 0.712, 47.933%</td>
</tr>
<tr>
<td class="label">Arrival Data Path Delay</td>
<td>cell: 0.000, 0.000%; route: 0.114, 44.186%; tC2Q: 0.144, 55.814%</td>
</tr>
<tr>
<td class="label">Required Clock Path Delay</td>
<td>cell: 0.773, 52.661%; route: 0.695, 47.339%</td>
</tr>
</table>
<h3>Path2</h3>
<p><b>Path Summary:</b></p>
<table class="summary_table">
<tr>
<td class="label">Slack</td>
<td>0.275</td>
</tr>
<tr>
<td class="label">Data Arrival Time</td>
<td>1.800</td>
</tr>
<tr>
<td class="label">Data Required Time</td>
<td>1.525</td>
</tr>
<tr>
<td class="label">From</td>
<td>diagnostics/sender/cycles_6_s1</td>
</tr>
<tr>
<td class="label">To</td>
<td>diagnostics/sender/cycles_6_s1</td>
</tr>
<tr>
<td class="label">Launch Clk</td>
<td>clk_50m:[R]</td>
</tr>
<tr>
<td class="label">Latch Clk</td>
<td>clk_50m:[R]</td>
</tr>
</table>
<p><b>Data Arrival Path:</b></p>
<table class="detail_table">
<tr>
<th class="label">AT</th>
<th class="label">DELAY</th>
<th class="label">TYPE</th>
<th class="label">RF</th>
<th class="label">FANOUT</th>
<th class="label">LOC</th>
<th>NODE</th>
</tr>
<tr>
<td>0.000</td>
<td>0.000</td>
<td></td>
<td></td>
<td></td>
<td></td>
<td>active clock edge time</td>
</tr>
<tr>
<td>0.000</td>
<td>0.000</td>
<td></td>
<td></td>
<td></td>
<td></td>
<td>clk_50m</td>
</tr>
<tr>
<td>0.000</td>
<td>0.000</td>
<td>tCL</td>
<td>RR</td>
<td>1</td>
<td>IOB29[A]</td>
<td>clk_50m_ibuf/I</td>
</tr>
<tr>
<td>0.773</td>
<td>0.773</td>
<td>tINS</td>
<td>RR</td>
<td>3385</td>
<td>IOB29[A]</td>
<td>clk_50m_ibuf/O</td>
</tr>
<tr>
<td>1.500</td>
<td>0.727</td>
<td>tNET</td>
<td>RR</td>
<td>1</td>
<td>R2C69[0][A]</td>
<td>diagnostics/sender/cycles_6_s1/CLK</td>
</tr>
<tr>
<td>1.641</td>
<td>0.141</td>
<td>tC2Q</td>
<td>RF</td>
<td>3</td>
<td>R2C69[0][A]</td>
<td style=" font-weight:bold;">diagnostics/sender/cycles_6_s1/Q</td>
</tr>
<tr>
<td>1.647</td>
<td>0.006</td>
<td>tNET</td>
<td>FF</td>
<td>1</td>
<td>R2C69[0][A]</td>
<td>diagnostics/sender/n189_s2/I1</td>
</tr>
<tr>
<td>1.800</td>
<td>0.153</td>
<td>tINS</td>
<td>FF</td>
<td>1</td>
<td>R2C69[0][A]</td>
<td style=" background: #97FFFF;">diagnostics/sender/n189_s2/F</td>
</tr>
<tr>
<td>1.800</td>
<td>0.000</td>
<td>tNET</td>
<td>FF</td>
<td>1</td>
<td>R2C69[0][A]</td>
<td style=" font-weight:bold;">diagnostics/sender/cycles_6_s1/D</td>
</tr>
</table>
<p><b>Data Required Path:</b></p>
<table class="detail_table">
<tr>
<th class="label">AT</th>
<th class="label">DELAY</th>
<th class="label">TYPE</th>
<th class="label">RF</th>
<th class="label">FANOUT</th>
<th class="label">LOC</th>
<th>NODE</th>
</tr>
<tr>
<td>0.000</td>
<td>0.000</td>
<td></td>
<td></td>
<td></td>
<td></td>
<td>active clock edge time</td>
</tr>
<tr>
<td>0.000</td>
<td>0.000</td>
<td></td>
<td></td>
<td></td>
<td></td>
<td>clk_50m</td>
</tr>
<tr>
<td>0.000</td>
<td>0.000</td>
<td>tCL</td>
<td>RR</td>
<td>1</td>
<td>IOB29[A]</td>
<td>clk_50m_ibuf/I</td>
</tr>
<tr>
<td>0.773</td>
<td>0.773</td>
<td>tINS</td>
<td>RR</td>
<td>3385</td>
<td>IOB29[A]</td>
<td>clk_50m_ibuf/O</td>
</tr>
<tr>
<td>1.500</td>
<td>0.727</td>
<td>tNET</td>
<td>RR</td>
<td>1</td>
<td>R2C69[0][A]</td>
<td>diagnostics/sender/cycles_6_s1/CLK</td>
</tr>
<tr>
<td>1.525</td>
<td>0.025</td>
<td>tHld</td>
<td></td>
<td>1</td>
<td>R2C69[0][A]</td>
<td>diagnostics/sender/cycles_6_s1</td>
</tr>
</table>
<p><b>Path Statistics:</b></p>
<table class="summary_table">
<tr>
<td class="label">Clock Skew</td>
<td>0.000</td>
</tr>
<tr>
<td class="label">Hold Relationship </td>
<td>0.000</td>
</tr>
<tr>
<td class="label">Logic Level</td>
<td>2</td>
</tr>
<tr>
<td class="label">Arrival Clock Path Delay</td>
<td>cell: 0.773, 51.546%; route: 0.727, 48.454%</td>
</tr>
<tr>
<td class="label">Arrival Data Path Delay</td>
<td>cell: 0.153, 51.000%; route: 0.006, 2.000%; tC2Q: 0.141, 47.000%</td>
</tr>
<tr>
<td class="label">Required Clock Path Delay</td>
<td>cell: 0.773, 51.546%; route: 0.727, 48.454%</td>
</tr>
</table>
<h3>Path3</h3>
<p><b>Path Summary:</b></p>
<table class="summary_table">
<tr>
<td class="label">Slack</td>
<td>0.275</td>
</tr>
<tr>
<td class="label">Data Arrival Time</td>
<td>1.794</td>
</tr>
<tr>
<td class="label">Data Required Time</td>
<td>1.519</td>
</tr>
<tr>
<td class="label">From</td>
<td>diagnostics/sender/cycles_20_s1</td>
</tr>
<tr>
<td class="label">To</td>
<td>diagnostics/sender/cycles_20_s1</td>
</tr>
<tr>
<td class="label">Launch Clk</td>
<td>clk_50m:[R]</td>
</tr>
<tr>
<td class="label">Latch Clk</td>
<td>clk_50m:[R]</td>
</tr>
</table>
<p><b>Data Arrival Path:</b></p>
<table class="detail_table">
<tr>
<th class="label">AT</th>
<th class="label">DELAY</th>
<th class="label">TYPE</th>
<th class="label">RF</th>
<th class="label">FANOUT</th>
<th class="label">LOC</th>
<th>NODE</th>
</tr>
<tr>
<td>0.000</td>
<td>0.000</td>
<td></td>
<td></td>
<td></td>
<td></td>
<td>active clock edge time</td>
</tr>
<tr>
<td>0.000</td>
<td>0.000</td>
<td></td>
<td></td>
<td></td>
<td></td>
<td>clk_50m</td>
</tr>
<tr>
<td>0.000</td>
<td>0.000</td>
<td>tCL</td>
<td>RR</td>
<td>1</td>
<td>IOB29[A]</td>
<td>clk_50m_ibuf/I</td>
</tr>
<tr>
<td>0.773</td>
<td>0.773</td>
<td>tINS</td>
<td>RR</td>
<td>3385</td>
<td>IOB29[A]</td>
<td>clk_50m_ibuf/O</td>
</tr>
<tr>
<td>1.494</td>
<td>0.721</td>
<td>tNET</td>
<td>RR</td>
<td>1</td>
<td>R3C70[0][A]</td>
<td>diagnostics/sender/cycles_20_s1/CLK</td>
</tr>
<tr>
<td>1.635</td>
<td>0.141</td>
<td>tC2Q</td>
<td>RF</td>
<td>3</td>
<td>R3C70[0][A]</td>
<td style=" font-weight:bold;">diagnostics/sender/cycles_20_s1/Q</td>
</tr>
<tr>
<td>1.641</td>
<td>0.006</td>
<td>tNET</td>
<td>FF</td>
<td>1</td>
<td>R3C70[0][A]</td>
<td>diagnostics/sender/n175_s2/I2</td>
</tr>
<tr>
<td>1.794</td>
<td>0.153</td>
<td>tINS</td>
<td>FF</td>
<td>1</td>
<td>R3C70[0][A]</td>
<td style=" background: #97FFFF;">diagnostics/sender/n175_s2/F</td>
</tr>
<tr>
<td>1.794</td>
<td>0.000</td>
<td>tNET</td>
<td>FF</td>
<td>1</td>
<td>R3C70[0][A]</td>
<td style=" font-weight:bold;">diagnostics/sender/cycles_20_s1/D</td>
</tr>
</table>
<p><b>Data Required Path:</b></p>
<table class="detail_table">
<tr>
<th class="label">AT</th>
<th class="label">DELAY</th>
<th class="label">TYPE</th>
<th class="label">RF</th>
<th class="label">FANOUT</th>
<th class="label">LOC</th>
<th>NODE</th>
</tr>
<tr>
<td>0.000</td>
<td>0.000</td>
<td></td>
<td></td>
<td></td>
<td></td>
<td>active clock edge time</td>
</tr>
<tr>
<td>0.000</td>
<td>0.000</td>
<td></td>
<td></td>
<td></td>
<td></td>
<td>clk_50m</td>
</tr>
<tr>
<td>0.000</td>
<td>0.000</td>
<td>tCL</td>
<td>RR</td>
<td>1</td>
<td>IOB29[A]</td>
<td>clk_50m_ibuf/I</td>
</tr>
<tr>
<td>0.773</td>
<td>0.773</td>
<td>tINS</td>
<td>RR</td>
<td>3385</td>
<td>IOB29[A]</td>
<td>clk_50m_ibuf/O</td>
</tr>
<tr>
<td>1.494</td>
<td>0.721</td>
<td>tNET</td>
<td>RR</td>
<td>1</td>
<td>R3C70[0][A]</td>
<td>diagnostics/sender/cycles_20_s1/CLK</td>
</tr>
<tr>
<td>1.519</td>
<td>0.025</td>
<td>tHld</td>
<td></td>
<td>1</td>
<td>R3C70[0][A]</td>
<td>diagnostics/sender/cycles_20_s1</td>
</tr>
</table>
<p><b>Path Statistics:</b></p>
<table class="summary_table">
<tr>
<td class="label">Clock Skew</td>
<td>0.000</td>
</tr>
<tr>
<td class="label">Hold Relationship </td>
<td>0.000</td>
</tr>
<tr>
<td class="label">Logic Level</td>
<td>2</td>
</tr>
<tr>
<td class="label">Arrival Clock Path Delay</td>
<td>cell: 0.773, 51.744%; route: 0.721, 48.256%</td>
</tr>
<tr>
<td class="label">Arrival Data Path Delay</td>
<td>cell: 0.153, 51.000%; route: 0.006, 2.000%; tC2Q: 0.141, 47.000%</td>
</tr>
<tr>
<td class="label">Required Clock Path Delay</td>
<td>cell: 0.773, 51.744%; route: 0.721, 48.256%</td>
</tr>
</table>
<h3>Path4</h3>
<p><b>Path Summary:</b></p>
<table class="summary_table">
<tr>
<td class="label">Slack</td>
<td>0.275</td>
</tr>
<tr>
<td class="label">Data Arrival Time</td>
<td>1.796</td>
</tr>
<tr>
<td class="label">Data Required Time</td>
<td>1.521</td>
</tr>
<tr>
<td class="label">From</td>
<td>diagnostics/sender/bit_index_2_s1</td>
</tr>
<tr>
<td class="label">To</td>
<td>diagnostics/sender/bit_index_2_s1</td>
</tr>
<tr>
<td class="label">Launch Clk</td>
<td>clk_50m:[R]</td>
</tr>
<tr>
<td class="label">Latch Clk</td>
<td>clk_50m:[R]</td>
</tr>
</table>
<p><b>Data Arrival Path:</b></p>
<table class="detail_table">
<tr>
<th class="label">AT</th>
<th class="label">DELAY</th>
<th class="label">TYPE</th>
<th class="label">RF</th>
<th class="label">FANOUT</th>
<th class="label">LOC</th>
<th>NODE</th>
</tr>
<tr>
<td>0.000</td>
<td>0.000</td>
<td></td>
<td></td>
<td></td>
<td></td>
<td>active clock edge time</td>
</tr>
<tr>
<td>0.000</td>
<td>0.000</td>
<td></td>
<td></td>
<td></td>
<td></td>
<td>clk_50m</td>
</tr>
<tr>
<td>0.000</td>
<td>0.000</td>
<td>tCL</td>
<td>RR</td>
<td>1</td>
<td>IOB29[A]</td>
<td>clk_50m_ibuf/I</td>
</tr>
<tr>
<td>0.773</td>
<td>0.773</td>
<td>tINS</td>
<td>RR</td>
<td>3385</td>
<td>IOB29[A]</td>
<td>clk_50m_ibuf/O</td>
</tr>
<tr>
<td>1.496</td>
<td>0.723</td>
<td>tNET</td>
<td>RR</td>
<td>1</td>
<td>R4C69[0][A]</td>
<td>diagnostics/sender/bit_index_2_s1/CLK</td>
</tr>
<tr>
<td>1.637</td>
<td>0.141</td>
<td>tC2Q</td>
<td>RF</td>
<td>5</td>
<td>R4C69[0][A]</td>
<td style=" font-weight:bold;">diagnostics/sender/bit_index_2_s1/Q</td>
</tr>
<tr>
<td>1.643</td>
<td>0.006</td>
<td>tNET</td>
<td>FF</td>
<td>1</td>
<td>R4C69[0][A]</td>
<td>diagnostics/sender/n161_s1/I2</td>
</tr>
<tr>
<td>1.796</td>
<td>0.153</td>
<td>tINS</td>
<td>FF</td>
<td>1</td>
<td>R4C69[0][A]</td>
<td style=" background: #97FFFF;">diagnostics/sender/n161_s1/F</td>
</tr>
<tr>
<td>1.796</td>
<td>0.000</td>
<td>tNET</td>
<td>FF</td>
<td>1</td>
<td>R4C69[0][A]</td>
<td style=" font-weight:bold;">diagnostics/sender/bit_index_2_s1/D</td>
</tr>
</table>
<p><b>Data Required Path:</b></p>
<table class="detail_table">
<tr>
<th class="label">AT</th>
<th class="label">DELAY</th>
<th class="label">TYPE</th>
<th class="label">RF</th>
<th class="label">FANOUT</th>
<th class="label">LOC</th>
<th>NODE</th>
</tr>
<tr>
<td>0.000</td>
<td>0.000</td>
<td></td>
<td></td>
<td></td>
<td></td>
<td>active clock edge time</td>
</tr>
<tr>
<td>0.000</td>
<td>0.000</td>
<td></td>
<td></td>
<td></td>
<td></td>
<td>clk_50m</td>
</tr>
<tr>
<td>0.000</td>
<td>0.000</td>
<td>tCL</td>
<td>RR</td>
<td>1</td>
<td>IOB29[A]</td>
<td>clk_50m_ibuf/I</td>
</tr>
<tr>
<td>0.773</td>
<td>0.773</td>
<td>tINS</td>
<td>RR</td>
<td>3385</td>
<td>IOB29[A]</td>
<td>clk_50m_ibuf/O</td>
</tr>
<tr>
<td>1.496</td>
<td>0.723</td>
<td>tNET</td>
<td>RR</td>
<td>1</td>
<td>R4C69[0][A]</td>
<td>diagnostics/sender/bit_index_2_s1/CLK</td>
</tr>
<tr>
<td>1.521</td>
<td>0.025</td>
<td>tHld</td>
<td></td>
<td>1</td>
<td>R4C69[0][A]</td>
<td>diagnostics/sender/bit_index_2_s1</td>
</tr>
</table>
<p><b>Path Statistics:</b></p>
<table class="summary_table">
<tr>
<td class="label">Clock Skew</td>
<td>0.000</td>
</tr>
<tr>
<td class="label">Hold Relationship </td>
<td>0.000</td>
</tr>
<tr>
<td class="label">Logic Level</td>
<td>2</td>
</tr>
<tr>
<td class="label">Arrival Clock Path Delay</td>
<td>cell: 0.773, 51.667%; route: 0.723, 48.333%</td>
</tr>
<tr>
<td class="label">Arrival Data Path Delay</td>
<td>cell: 0.153, 51.000%; route: 0.006, 2.000%; tC2Q: 0.141, 47.000%</td>
</tr>
<tr>
<td class="label">Required Clock Path Delay</td>
<td>cell: 0.773, 51.667%; route: 0.723, 48.333%</td>
</tr>
</table>
<h3>Path5</h3>
<p><b>Path Summary:</b></p>
<table class="summary_table">
<tr>
<td class="label">Slack</td>
<td>0.275</td>
</tr>
<tr>
<td class="label">Data Arrival Time</td>
<td>1.793</td>
</tr>
<tr>
<td class="label">Data Required Time</td>
<td>1.518</td>
</tr>
<tr>
<td class="label">From</td>
<td>packets/sender/cycles_0_s3</td>
</tr>
<tr>
<td class="label">To</td>
<td>packets/sender/cycles_0_s3</td>
</tr>
<tr>
<td class="label">Launch Clk</td>
<td>clk_50m:[R]</td>
</tr>
<tr>
<td class="label">Latch Clk</td>
<td>clk_50m:[R]</td>
</tr>
</table>
<p><b>Data Arrival Path:</b></p>
<table class="detail_table">
<tr>
<th class="label">AT</th>
<th class="label">DELAY</th>
<th class="label">TYPE</th>
<th class="label">RF</th>
<th class="label">FANOUT</th>
<th class="label">LOC</th>
<th>NODE</th>
</tr>
<tr>
<td>0.000</td>
<td>0.000</td>
<td></td>
<td></td>
<td></td>
<td></td>
<td>active clock edge time</td>
</tr>
<tr>
<td>0.000</td>
<td>0.000</td>
<td></td>
<td></td>
<td></td>
<td></td>
<td>clk_50m</td>
</tr>
<tr>
<td>0.000</td>
<td>0.000</td>
<td>tCL</td>
<td>RR</td>
<td>1</td>
<td>IOB29[A]</td>
<td>clk_50m_ibuf/I</td>
</tr>
<tr>
<td>0.773</td>
<td>0.773</td>
<td>tINS</td>
<td>RR</td>
<td>3385</td>
<td>IOB29[A]</td>
<td>clk_50m_ibuf/O</td>
</tr>
<tr>
<td>1.493</td>
<td>0.720</td>
<td>tNET</td>
<td>RR</td>
<td>1</td>
<td>R6C89[1][A]</td>
<td>packets/sender/cycles_0_s3/CLK</td>
</tr>
<tr>
<td>1.634</td>
<td>0.141</td>
<td>tC2Q</td>
<td>RF</td>
<td>6</td>
<td>R6C89[1][A]</td>
<td style=" font-weight:bold;">packets/sender/cycles_0_s3/Q</td>
</tr>
<tr>
<td>1.640</td>
<td>0.006</td>
<td>tNET</td>
<td>FF</td>
<td>1</td>
<td>R6C89[1][A]</td>
<td>packets/sender/n195_s6/I2</td>
</tr>
<tr>
<td>1.793</td>
<td>0.153</td>
<td>tINS</td>
<td>FF</td>
<td>1</td>
<td>R6C89[1][A]</td>
<td style=" background: #97FFFF;">packets/sender/n195_s6/F</td>
</tr>
<tr>
<td>1.793</td>
<td>0.000</td>
<td>tNET</td>
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
<td></td>
<td></td>
<td>clk_50m</td>
</tr>
<tr>
<td>0.000</td>
<td>0.000</td>
<td>tCL</td>
<td>RR</td>
<td>1</td>
<td>IOB29[A]</td>
<td>clk_50m_ibuf/I</td>
</tr>
<tr>
<td>0.773</td>
<td>0.773</td>
<td>tINS</td>
<td>RR</td>
<td>3385</td>
<td>IOB29[A]</td>
<td>clk_50m_ibuf/O</td>
</tr>
<tr>
<td>1.489</td>
<td>0.716</td>
<td>tNET</td>
<td>RR</td>
<td>1</td>
<td>R6C88[0][A]</td>
<td>packets/sender/cycles_16_s3/CLK</td>
</tr>
<tr>
<td>1.514</td>
<td>0.025</td>
<td>tHld</td>
<td></td>
<td>1</td>
<td>R6C88[0][A]</td>
<td>packets/sender/cycles_16_s3</td>
</tr>
</table>
<p><b>Path Statistics:</b></p>
<table class="summary_table">
<tr>
<td class="label">Clock Skew</td>
<td>0.000</td>
</tr>
<tr>
<td class="label">Hold Relationship </td>
<td>0.000</td>
</tr>
<tr>
<td class="label">Logic Level</td>
<td>2</td>
</tr>
<tr>
<td class="label">Arrival Clock Path Delay</td>
<td>cell: 0.773, 51.927%; route: 0.716, 48.073%</td>
</tr>
<tr>
<td class="label">Arrival Data Path Delay</td>
<td>cell: 0.153, 51.000%; route: 0.006, 2.000%; tC2Q: 0.141, 47.000%</td>
</tr>
<tr>
<td class="label">Required Clock Path Delay</td>
<td>cell: 0.773, 51.927%; route: 0.716, 48.073%</td>
</tr>
</table>
<h3>Path7</h3>
<p><b>Path Summary:</b></p>
<table class="summary_table">
<tr>
<td class="label">Slack</td>
<td>0.275</td>
</tr>
<tr>
<td class="label">Data Arrival Time</td>
<td>1.792</td>
</tr>
<tr>
<td class="label">Data Required Time</td>
<td>1.517</td>
</tr>
<tr>
<td class="label">From</td>
<td>packets/sender/cycles_12_s1</td>
</tr>
<tr>
<td class="label">To</td>
<td>packets/sender/cycles_12_s1</td>
</tr>
<tr>
<td class="label">Launch Clk</td>
<td>clk_50m:[R]</td>
</tr>
<tr>
<td class="label">Latch Clk</td>
<td>clk_50m:[R]</td>
</tr>
</table>
<p><b>Data Arrival Path:</b></p>
<table class="detail_table">
<tr>
<th class="label">AT</th>
<th class="label">DELAY</th>
<th class="label">TYPE</th>
<th class="label">RF</th>
<th class="label">FANOUT</th>
<th class="label">LOC</th>
<th>NODE</th>
</tr>
<tr>
<td>0.000</td>
<td>0.000</td>
<td></td>
<td></td>
<td></td>
<td></td>
<td>active clock edge time</td>
</tr>
<tr>
<td>0.000</td>
<td>0.000</td>
<td></td>
<td></td>
<td></td>
<td></td>
<td>clk_50m</td>
</tr>
<tr>
<td>0.000</td>
<td>0.000</td>
<td>tCL</td>
<td>RR</td>
<td>1</td>
<td>IOB29[A]</td>
<td>clk_50m_ibuf/I</td>
</tr>
<tr>
<td>0.773</td>
<td>0.773</td>
<td>tINS</td>
<td>RR</td>
<td>3385</td>
<td>IOB29[A]</td>
<td>clk_50m_ibuf/O</td>
</tr>
<tr>
<td>1.492</td>
<td>0.719</td>
<td>tNET</td>
<td>RR</td>
<td>1</td>
<td>R4C88[1][A]</td>
<td>packets/sender/cycles_12_s1/CLK</td>
</tr>
<tr>
<td>1.633</td>
<td>0.141</td>
<td>tC2Q</td>
<td>RF</td>
<td>3</td>
<td>R4C88[1][A]</td>
<td style=" font-weight:bold;">packets/sender/cycles_12_s1/Q</td>
</tr>
<tr>
<td>1.639</td>
<td>0.006</td>
<td>tNET</td>
<td>FF</td>
<td>1</td>
<td>R4C88[1][A]</td>
<td>packets/sender/n183_s2/I1</td>
</tr>
<tr>
<td>1.792</td>
<td>0.153</td>
<td>tINS</td>
<td>FF</td>
<td>1</td>
<td>R4C88[1][A]</td>
<td style=" background: #97FFFF;">packets/sender/n183_s2/F</td>
</tr>
<tr>
<td>1.792</td>
<td>0.000</td>
<td>tNET</td>
<td>FF</td>
<td>1</td>
<td>R4C88[1][A]</td>
<td style=" font-weight:bold;">packets/sender/cycles_12_s1/D</td>
</tr>
</table>
<p><b>Data Required Path:</b></p>
<table class="detail_table">
<tr>
<th class="label">AT</th>
<th class="label">DELAY</th>
<th class="label">TYPE</th>
<th class="label">RF</th>
<th class="label">FANOUT</th>
<th class="label">LOC</th>
<th>NODE</th>
</tr>
<tr>
<td>0.000</td>
<td>0.000</td>
<td></td>
<td></td>
<td></td>
<td></td>
<td>active clock edge time</td>
</tr>
<tr>
<td>0.000</td>
<td>0.000</td>
<td></td>
<td></td>
<td></td>
<td></td>
<td>clk_50m</td>
</tr>
<tr>
<td>0.000</td>
<td>0.000</td>
<td>tCL</td>
<td>RR</td>
<td>1</td>
<td>IOB29[A]</td>
<td>clk_50m_ibuf/I</td>
</tr>
<tr>
<td>0.773</td>
<td>0.773</td>
<td>tINS</td>
<td>RR</td>
<td>3385</td>
<td>IOB29[A]</td>
<td>clk_50m_ibuf/O</td>
</tr>
<tr>
<td>1.492</td>
<td>0.719</td>
<td>tNET</td>
<td>RR</td>
<td>1</td>
<td>R4C88[1][A]</td>
<td>packets/sender/cycles_12_s1/CLK</td>
</tr>
<tr>
<td>1.517</td>
<td>0.025</td>
<td>tHld</td>
<td></td>
<td>1</td>
<td>R4C88[1][A]</td>
<td>packets/sender/cycles_12_s1</td>
</tr>
</table>
<p><b>Path Statistics:</b></p>
<table class="summary_table">
<tr>
<td class="label">Clock Skew</td>
<td>0.000</td>
</tr>
<tr>
<td class="label">Hold Relationship </td>
<td>0.000</td>
</tr>
<tr>
<td class="label">Logic Level</td>
<td>2</td>
</tr>
<tr>
<td class="label">Arrival Clock Path Delay</td>
<td>cell: 0.773, 51.805%; route: 0.719, 48.195%</td>
</tr>
<tr>
<td class="label">Arrival Data Path Delay</td>
<td>cell: 0.153, 51.000%; route: 0.006, 2.000%; tC2Q: 0.141, 47.000%</td>
</tr>
<tr>
<td class="label">Required Clock Path Delay</td>
<td>cell: 0.773, 51.805%; route: 0.719, 48.195%</td>
</tr>
</table>
<h3>Path8</h3>
<p><b>Path Summary:</b></p>
<table class="summary_table">
<tr>
<td class="label">Slack</td>
<td>0.275</td>
</tr>
<tr>
<td class="label">Data Arrival Time</td>
<td>1.796</td>
</tr>
<tr>
<td class="label">Data Required Time</td>
<td>1.521</td>
</tr>
<tr>
<td class="label">From</td>
<td>packets/sender/cycles_17_s1</td>
</tr>
<tr>
<td class="label">To</td>
<td>packets/sender/cycles_17_s1</td>
</tr>
<tr>
<td class="label">Launch Clk</td>
<td>clk_50m:[R]</td>
</tr>
<tr>
<td class="label">Latch Clk</td>
<td>clk_50m:[R]</td>
</tr>
</table>
<p><b>Data Arrival Path:</b></p>
<table class="detail_table">
<tr>
<th class="label">AT</th>
<th class="label">DELAY</th>
<th class="label">TYPE</th>
<th class="label">RF</th>
<th class="label">FANOUT</th>
<th class="label">LOC</th>
<th>NODE</th>
</tr>
<tr>
<td>0.000</td>
<td>0.000</td>
<td></td>
<td></td>
<td></td>
<td></td>
<td>active clock edge time</td>
</tr>
<tr>
<td>0.000</td>
<td>0.000</td>
<td></td>
<td></td>
<td></td>
<td></td>
<td>clk_50m</td>
</tr>
<tr>
<td>0.000</td>
<td>0.000</td>
<td>tCL</td>
<td>RR</td>
<td>1</td>
<td>IOB29[A]</td>
<td>clk_50m_ibuf/I</td>
</tr>
<tr>
<td>0.773</td>
<td>0.773</td>
<td>tINS</td>
<td>RR</td>
<td>3385</td>
<td>IOB29[A]</td>
<td>clk_50m_ibuf/O</td>
</tr>
<tr>
<td>1.496</td>
<td>0.723</td>
<td>tNET</td>
<td>RR</td>
<td>1</td>
<td>R2C88[0][A]</td>
<td>packets/sender/cycles_17_s1/CLK</td>
</tr>
<tr>
<td>1.637</td>
<td>0.141</td>
<td>tC2Q</td>
<td>RF</td>
<td>4</td>
<td>R2C88[0][A]</td>
<td style=" font-weight:bold;">packets/sender/cycles_17_s1/Q</td>
</tr>
<tr>
<td>1.643</td>
<td>0.006</td>
<td>tNET</td>
<td>FF</td>
<td>1</td>
<td>R2C88[0][A]</td>
<td>packets/sender/n178_s2/I2</td>
</tr>
<tr>
<td>1.796</td>
<td>0.153</td>
<td>tINS</td>
<td>FF</td>
<td>1</td>
<td>R2C88[0][A]</td>
<td style=" background: #97FFFF;">packets/sender/n178_s2/F</td>
</tr>
<tr>
<td>1.796</td>
<td>0.000</td>
<td>tNET</td>
<td>FF</td>
<td>1</td>
<td>R2C88[0][A]</td>
<td style=" font-weight:bold;">packets/sender/cycles_17_s1/D</td>
</tr>
</table>
<p><b>Data Required Path:</b></p>
<table class="detail_table">
<tr>
<th class="label">AT</th>
<th class="label">DELAY</th>
<th class="label">TYPE</th>
<th class="label">RF</th>
<th class="label">FANOUT</th>
<th class="label">LOC</th>
<th>NODE</th>
</tr>
<tr>
<td>0.000</td>
<td>0.000</td>
<td></td>
<td></td>
<td></td>
<td></td>
<td>active clock edge time</td>
</tr>
<tr>
<td>0.000</td>
<td>0.000</td>
<td></td>
<td></td>
<td></td>
<td></td>
<td>clk_50m</td>
</tr>
<tr>
<td>0.000</td>
<td>0.000</td>
<td>tCL</td>
<td>RR</td>
<td>1</td>
<td>IOB29[A]</td>
<td>clk_50m_ibuf/I</td>
</tr>
<tr>
<td>0.773</td>
<td>0.773</td>
<td>tINS</td>
<td>RR</td>
<td>3385</td>
<td>IOB29[A]</td>
<td>clk_50m_ibuf/O</td>
</tr>
<tr>
<td>1.496</td>
<td>0.723</td>
<td>tNET</td>
<td>RR</td>
<td>1</td>
<td>R2C88[0][A]</td>
<td>packets/sender/cycles_17_s1/CLK</td>
</tr>
<tr>
<td>1.521</td>
<td>0.025</td>
<td>tHld</td>
<td></td>
<td>1</td>
<td>R2C88[0][A]</td>
<td>packets/sender/cycles_17_s1</td>
</tr>
</table>
<p><b>Path Statistics:</b></p>
<table class="summary_table">
<tr>
<td class="label">Clock Skew</td>
<td>0.000</td>
</tr>
<tr>
<td class="label">Hold Relationship </td>
<td>0.000</td>
</tr>
<tr>
<td class="label">Logic Level</td>
<td>2</td>
</tr>
<tr>
<td class="label">Arrival Clock Path Delay</td>
<td>cell: 0.773, 51.684%; route: 0.723, 48.316%</td>
</tr>
<tr>
<td class="label">Arrival Data Path Delay</td>
<td>cell: 0.153, 51.000%; route: 0.006, 2.000%; tC2Q: 0.141, 47.000%</td>
</tr>
<tr>
<td class="label">Required Clock Path Delay</td>
<td>cell: 0.773, 51.684%; route: 0.723, 48.316%</td>
</tr>
</table>
<h3>Path9</h3>
<p><b>Path Summary:</b></p>
<table class="summary_table">
<tr>
<td class="label">Slack</td>
<td>0.275</td>
</tr>
<tr>
<td class="label">Data Arrival Time</td>
<td>1.792</td>
</tr>
<tr>
<td class="label">Data Required Time</td>
<td>1.517</td>
</tr>
<tr>
<td class="label">From</td>
<td>packets/sender/cycles_21_s1</td>
</tr>
<tr>
<td class="label">To</td>
<td>packets/sender/cycles_21_s1</td>
</tr>
<tr>
<td class="label">Launch Clk</td>
<td>clk_50m:[R]</td>
</tr>
<tr>
<td class="label">Latch Clk</td>
<td>clk_50m:[R]</td>
</tr>
</table>
<p><b>Data Arrival Path:</b></p>
<table class="detail_table">
<tr>
<th class="label">AT</th>
<th class="label">DELAY</th>
<th class="label">TYPE</th>
<th class="label">RF</th>
<th class="label">FANOUT</th>
<th class="label">LOC</th>
<th>NODE</th>
</tr>
<tr>
<td>0.000</td>
<td>0.000</td>
<td></td>
<td></td>
<td></td>
<td></td>
<td>active clock edge time</td>
</tr>
<tr>
<td>0.000</td>
<td>0.000</td>
<td></td>
<td></td>
<td></td>
<td></td>
<td>clk_50m</td>
</tr>
<tr>
<td>0.000</td>
<td>0.000</td>
<td>tCL</td>
<td>RR</td>
<td>1</td>
<td>IOB29[A]</td>
<td>clk_50m_ibuf/I</td>
</tr>
<tr>
<td>0.773</td>
<td>0.773</td>
<td>tINS</td>
<td>RR</td>
<td>3385</td>
<td>IOB29[A]</td>
<td>clk_50m_ibuf/O</td>
</tr>
<tr>
<td>1.492</td>
<td>0.719</td>
<td>tNET</td>
<td>RR</td>
<td>1</td>
<td>R4C88[0][A]</td>
<td>packets/sender/cycles_21_s1/CLK</td>
</tr>
<tr>
<td>1.633</td>
<td>0.141</td>
<td>tC2Q</td>
<td>RF</td>
<td>5</td>
<td>R4C88[0][A]</td>
<td style=" font-weight:bold;">packets/sender/cycles_21_s1/Q</td>
</tr>
<tr>
<td>1.639</td>
<td>0.006</td>
<td>tNET</td>
<td>FF</td>
<td>1</td>
<td>R4C88[0][A]</td>
<td>packets/sender/n174_s2/I0</td>
</tr>
<tr>
<td>1.792</td>
<td>0.153</td>
<td>tINS</td>
<td>FF</td>
<td>1</td>
<td>R4C88[0][A]</td>
<td style=" background: #97FFFF;">packets/sender/n174_s2/F</td>
</tr>
<tr>
<td>1.792</td>
<td>0.000</td>
<td>tNET</td>
<td>FF</td>
<td>1</td>
<td>R4C88[0][A]</td>
<td style=" font-weight:bold;">packets/sender/cycles_21_s1/D</td>
</tr>
</table>
<p><b>Data Required Path:</b></p>
<table class="detail_table">
<tr>
<th class="label">AT</th>
<th class="label">DELAY</th>
<th class="label">TYPE</th>
<th class="label">RF</th>
<th class="label">FANOUT</th>
<th class="label">LOC</th>
<th>NODE</th>
</tr>
<tr>
<td>0.000</td>
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
<td>packets/sender/cycles_26_s1/CLK</td>
</tr>
<tr>
<td>1.512</td>
<td>0.025</td>
<td>tHld</td>
<td></td>
<td>1</td>
<td>R5C87[0][A]</td>
<td>packets/sender/cycles_26_s1</td>
</tr>
</table>
<p><b>Path Statistics:</b></p>
<table class="summary_table">
<tr>
<td class="label">Clock Skew</td>
<td>0.000</td>
</tr>
<tr>
<td class="label">Hold Relationship </td>
<td>0.000</td>
</tr>
<tr>
<td class="label">Logic Level</td>
<td>2</td>
</tr>
<tr>
<td class="label">Arrival Clock Path Delay</td>
<td>cell: 0.773, 52.005%; route: 0.714, 47.995%</td>
</tr>
<tr>
<td class="label">Arrival Data Path Delay</td>
<td>cell: 0.153, 51.000%; route: 0.006, 2.000%; tC2Q: 0.141, 47.000%</td>
</tr>
<tr>
<td class="label">Required Clock Path Delay</td>
<td>cell: 0.773, 52.005%; route: 0.714, 47.995%</td>
</tr>
</table>
<h3>Path11</h3>
<p><b>Path Summary:</b></p>
<table class="summary_table">
<tr>
<td class="label">Slack</td>
<td>0.275</td>
</tr>
<tr>
<td class="label">Data Arrival Time</td>
<td>1.787</td>
</tr>
<tr>
<td class="label">Data Required Time</td>
<td>1.512</td>
</tr>
<tr>
<td class="label">From</td>
<td>packets/sender/cycles_28_s1</td>
</tr>
<tr>
<td class="label">To</td>
<td>packets/sender/cycles_28_s1</td>
</tr>
<tr>
<td class="label">Launch Clk</td>
<td>clk_50m:[R]</td>
</tr>
<tr>
<td class="label">Latch Clk</td>
<td>clk_50m:[R]</td>
</tr>
</table>
<p><b>Data Arrival Path:</b></p>
<table class="detail_table">
<tr>
<th class="label">AT</th>
<th class="label">DELAY</th>
<th class="label">TYPE</th>
<th class="label">RF</th>
<th class="label">FANOUT</th>
<th class="label">LOC</th>
<th>NODE</th>
</tr>
<tr>
<td>0.000</td>
<td>0.000</td>
<td></td>
<td></td>
<td></td>
<td></td>
<td>active clock edge time</td>
</tr>
<tr>
<td>0.000</td>
<td>0.000</td>
<td></td>
<td></td>
<td></td>
<td></td>
<td>clk_50m</td>
</tr>
<tr>
<td>0.000</td>
<td>0.000</td>
<td>tCL</td>
<td>RR</td>
<td>1</td>
<td>IOB29[A]</td>
<td>clk_50m_ibuf/I</td>
</tr>
<tr>
<td>0.773</td>
<td>0.773</td>
<td>tINS</td>
<td>RR</td>
<td>3385</td>
<td>IOB29[A]</td>
<td>clk_50m_ibuf/O</td>
</tr>
<tr>
<td>1.487</td>
<td>0.714</td>
<td>tNET</td>
<td>RR</td>
<td>1</td>
<td>R5C87[1][A]</td>
<td>packets/sender/cycles_28_s1/CLK</td>
</tr>
<tr>
<td>1.628</td>
<td>0.141</td>
<td>tC2Q</td>
<td>RF</td>
<td>4</td>
<td>R5C87[1][A]</td>
<td style=" font-weight:bold;">packets/sender/cycles_28_s1/Q</td>
</tr>
<tr>
<td>1.634</td>
<td>0.006</td>
<td>tNET</td>
<td>FF</td>
<td>1</td>
<td>R5C87[1][A]</td>
<td>packets/sender/n167_s2/I2</td>
</tr>
<tr>
<td>1.787</td>
<td>0.153</td>
<td>tINS</td>
<td>FF</td>
<td>1</td>
<td>R5C87[1][A]</td>
<td style=" background: #97FFFF;">packets/sender/n167_s2/F</td>
</tr>
<tr>
<td>1.787</td>
<td>0.000</td>
<td>tNET</td>
<td>FF</td>
<td>1</td>
<td>R5C87[1][A]</td>
<td style=" font-weight:bold;">packets/sender/cycles_28_s1/D</td>
</tr>
</table>
<p><b>Data Required Path:</b></p>
<table class="detail_table">
<tr>
<th class="label">AT</th>
<th class="label">DELAY</th>
<th class="label">TYPE</th>
<th class="label">RF</th>
<th class="label">FANOUT</th>
<th class="label">LOC</th>
<th>NODE</th>
</tr>
<tr>
<td>0.000</td>
<td>0.000</td>
<td></td>
<td></td>
<td></td>
<td></td>
<td>active clock edge time</td>
</tr>
<tr>
<td>0.000</td>
<td>0.000</td>
<td></td>
<td></td>
<td></td>
<td></td>
<td>clk_50m</td>
</tr>
<tr>
<td>0.000</td>
<td>0.000</td>
<td>tCL</td>
<td>RR</td>
<td>1</td>
<td>IOB29[A]</td>
<td>clk_50m_ibuf/I</td>
</tr>
<tr>
<td>0.773</td>
<td>0.773</td>
<td>tINS</td>
<td>RR</td>
<td>3385</td>
<td>IOB29[A]</td>
<td>clk_50m_ibuf/O</td>
</tr>
<tr>
<td>1.487</td>
<td>0.714</td>
<td>tNET</td>
<td>RR</td>
<td>1</td>
<td>R5C87[1][A]</td>
<td>packets/sender/cycles_28_s1/CLK</td>
</tr>
<tr>
<td>1.512</td>
<td>0.025</td>
<td>tHld</td>
<td></td>
<td>1</td>
<td>R5C87[1][A]</td>
<td>packets/sender/cycles_28_s1</td>
</tr>
</table>
<p><b>Path Statistics:</b></p>
<table class="summary_table">
<tr>
<td class="label">Clock Skew</td>
<td>0.000</td>
</tr>
<tr>
<td class="label">Hold Relationship </td>
<td>0.000</td>
</tr>
<tr>
<td class="label">Logic Level</td>
<td>2</td>
</tr>
<tr>
<td class="label">Arrival Clock Path Delay</td>
<td>cell: 0.773, 52.005%; route: 0.714, 47.995%</td>
</tr>
<tr>
<td class="label">Arrival Data Path Delay</td>
<td>cell: 0.153, 51.000%; route: 0.006, 2.000%; tC2Q: 0.141, 47.000%</td>
</tr>
<tr>
<td class="label">Required Clock Path Delay</td>
<td>cell: 0.773, 52.005%; route: 0.714, 47.995%</td>
</tr>
</table>
<h3>Path12</h3>
<p><b>Path Summary:</b></p>
<table class="summary_table">
<tr>
<td class="label">Slack</td>
<td>0.275</td>
</tr>
<tr>
<td class="label">Data Arrival Time</td>
<td>1.800</td>
</tr>
<tr>
<td class="label">Data Required Time</td>
<td>1.525</td>
</tr>
<tr>
<td class="label">From</td>
<td>packets/fault_pending_s1</td>
</tr>
<tr>
<td class="label">To</td>
<td>packets/fault_pending_s1</td>
</tr>
<tr>
<td class="label">Launch Clk</td>
<td>clk_50m:[R]</td>
</tr>
<tr>
<td class="label">Latch Clk</td>
<td>clk_50m:[R]</td>
</tr>
</table>
<p><b>Data Arrival Path:</b></p>
<table class="detail_table">
<tr>
<th class="label">AT</th>
<th class="label">DELAY</th>
<th class="label">TYPE</th>
<th class="label">RF</th>
<th class="label">FANOUT</th>
<th class="label">LOC</th>
<th>NODE</th>
</tr>
<tr>
<td>0.000</td>
<td>0.000</td>
<td></td>
<td></td>
<td></td>
<td></td>
<td>active clock edge time</td>
</tr>
<tr>
<td>0.000</td>
<td>0.000</td>
<td></td>
<td></td>
<td></td>
<td></td>
<td>clk_50m</td>
</tr>
<tr>
<td>0.000</td>
<td>0.000</td>
<td>tCL</td>
<td>RR</td>
<td>1</td>
<td>IOB29[A]</td>
<td>clk_50m_ibuf/I</td>
</tr>
<tr>
<td>0.773</td>
<td>0.773</td>
<td>tINS</td>
<td>RR</td>
<td>3385</td>
<td>IOB29[A]</td>
<td>clk_50m_ibuf/O</td>
</tr>
<tr>
<td>1.500</td>
<td>0.727</td>
<td>tNET</td>
<td>RR</td>
<td>1</td>
<td>R2C77[0][A]</td>
<td>packets/fault_pending_s1/CLK</td>
</tr>
<tr>
<td>1.641</td>
<td>0.141</td>
<td>tC2Q</td>
<td>RF</td>
<td>2</td>
<td>R2C77[0][A]</td>
<td style=" font-weight:bold;">packets/fault_pending_s1/Q</td>
</tr>
<tr>
<td>1.647</td>
<td>0.006</td>
<td>tNET</td>
<td>FF</td>
<td>1</td>
<td>R2C77[0][A]</td>
<td>packets/n55_s3/I3</td>
</tr>
<tr>
<td>1.800</td>
<td>0.153</td>
<td>tINS</td>
<td>FF</td>
<td>1</td>
<td>R2C77[0][A]</td>
<td style=" background: #97FFFF;">packets/n55_s3/F</td>
</tr>
<tr>
<td>1.800</td>
<td>0.000</td>
<td>tNET</td>
<td>FF</td>
<td>1</td>
<td>R2C77[0][A]</td>
<td style=" font-weight:bold;">packets/fault_pending_s1/D</td>
</tr>
</table>
<p><b>Data Required Path:</b></p>
<table class="detail_table">
<tr>
<th class="label">AT</th>
<th class="label">DELAY</th>
<th class="label">TYPE</th>
<th class="label">RF</th>
<th class="label">FANOUT</th>
<th class="label">LOC</th>
<th>NODE</th>
</tr>
<tr>
<td>0.000</td>
<td>0.000</td>
<td></td>
<td></td>
<td></td>
<td></td>
<td>active clock edge time</td>
</tr>
<tr>
<td>0.000</td>
<td>0.000</td>
<td></td>
<td></td>
<td></td>
<td></td>
<td>clk_50m</td>
</tr>
<tr>
<td>0.000</td>
<td>0.000</td>
<td>tCL</td>
<td>RR</td>
<td>1</td>
<td>IOB29[A]</td>
<td>clk_50m_ibuf/I</td>
</tr>
<tr>
<td>0.773</td>
<td>0.773</td>
<td>tINS</td>
<td>RR</td>
<td>3385</td>
<td>IOB29[A]</td>
<td>clk_50m_ibuf/O</td>
</tr>
<tr>
<td>1.500</td>
<td>0.727</td>
<td>tNET</td>
<td>RR</td>
<td>1</td>
<td>R2C77[0][A]</td>
<td>packets/fault_pending_s1/CLK</td>
</tr>
<tr>
<td>1.525</td>
<td>0.025</td>
<td>tHld</td>
<td></td>
<td>1</td>
<td>R2C77[0][A]</td>
<td>packets/fault_pending_s1</td>
</tr>
</table>
<p><b>Path Statistics:</b></p>
<table class="summary_table">
<tr>
<td class="label">Clock Skew</td>
<td>0.000</td>
</tr>
<tr>
<td class="label">Hold Relationship </td>
<td>0.000</td>
</tr>
<tr>
<td class="label">Logic Level</td>
<td>2</td>
</tr>
<tr>
<td class="label">Arrival Clock Path Delay</td>
<td>cell: 0.773, 51.546%; route: 0.727, 48.454%</td>
</tr>
<tr>
<td class="label">Arrival Data Path Delay</td>
<td>cell: 0.153, 51.000%; route: 0.006, 2.000%; tC2Q: 0.141, 47.000%</td>
</tr>
<tr>
<td class="label">Required Clock Path Delay</td>
<td>cell: 0.773, 51.546%; route: 0.727, 48.454%</td>
</tr>
</table>
<h3>Path13</h3>
<p><b>Path Summary:</b></p>
<table class="summary_table">
<tr>
<td class="label">Slack</td>
<td>0.275</td>
</tr>
<tr>
<td class="label">Data Arrival Time</td>
<td>1.771</td>
</tr>
<tr>
<td class="label">Data Required Time</td>
<td>1.496</td>
</tr>
<tr>
<td class="label">From</td>
<td>driver/right_channel/remaining_1_s1</td>
</tr>
<tr>
<td class="label">To</td>
<td>driver/right_channel/remaining_1_s1</td>
</tr>
<tr>
<td class="label">Launch Clk</td>
<td>clk_50m:[R]</td>
</tr>
<tr>
<td class="label">Latch Clk</td>
<td>clk_50m:[R]</td>
</tr>
</table>
<p><b>Data Arrival Path:</b></p>
<table class="detail_table">
<tr>
<th class="label">AT</th>
<th class="label">DELAY</th>
<th class="label">TYPE</th>
<th class="label">RF</th>
<th class="label">FANOUT</th>
<th class="label">LOC</th>
<th>NODE</th>
</tr>
<tr>
<td>0.000</td>
<td>0.000</td>
<td></td>
<td></td>
<td></td>
<td></td>
<td>active clock edge time</td>
</tr>
<tr>
<td>0.000</td>
<td>0.000</td>
<td></td>
<td></td>
<td></td>
<td></td>
<td>clk_50m</td>
</tr>
<tr>
<td>0.000</td>
<td>0.000</td>
<td>tCL</td>
<td>RR</td>
<td>1</td>
<td>IOB29[A]</td>
<td>clk_50m_ibuf/I</td>
</tr>
<tr>
<td>0.773</td>
<td>0.773</td>
<td>tINS</td>
<td>RR</td>
<td>3385</td>
<td>IOB29[A]</td>
<td>clk_50m_ibuf/O</td>
</tr>
<tr>
<td>1.471</td>
<td>0.698</td>
<td>tNET</td>
<td>RR</td>
<td>1</td>
<td>R34C88[1][A]</td>
<td>driver/right_channel/remaining_1_s1/CLK</td>
</tr>
<tr>
<td>1.612</td>
<td>0.141</td>
<td>tC2Q</td>
<td>RF</td>
<td>4</td>
<td>R34C88[1][A]</td>
<td style=" font-weight:bold;">driver/right_channel/remaining_1_s1/Q</td>
</tr>
<tr>
<td>1.618</td>
<td>0.006</td>
<td>tNET</td>
<td>FF</td>
<td>1</td>
<td>R34C88[1][A]</td>
<td>driver/right_channel/n86_s10/I0</td>
</tr>
<tr>
<td>1.771</td>
<td>0.153</td>
<td>tINS</td>
<td>FF</td>
<td>1</td>
<td>R34C88[1][A]</td>
<td style=" background: #97FFFF;">driver/right_channel/n86_s10/F</td>
</tr>
<tr>
<td>1.771</td>
<td>0.000</td>
<td>tNET</td>
<td>FF</td>
<td>1</td>
<td>R34C88[1][A]</td>
<td style=" font-weight:bold;">driver/right_channel/remaining_1_s1/D</td>
</tr>
</table>
<p><b>Data Required Path:</b></p>
<table class="detail_table">
<tr>
<th class="label">AT</th>
<th class="label">DELAY</th>
<th class="label">TYPE</th>
<th class="label">RF</th>
<th class="label">FANOUT</th>
<th class="label">LOC</th>
<th>NODE</th>
</tr>
<tr>
<td>0.000</td>
<td>0.000</td>
<td></td>
<td></td>
<td></td>
<td></td>
<td>active clock edge time</td>
</tr>
<tr>
<td>0.000</td>
<td>0.000</td>
<td></td>
<td></td>
<td></td>
<td></td>
<td>clk_50m</td>
</tr>
<tr>
<td>0.000</td>
<td>0.000</td>
<td>tCL</td>
<td>RR</td>
<td>1</td>
<td>IOB29[A]</td>
<td>clk_50m_ibuf/I</td>
</tr>
<tr>
<td>0.773</td>
<td>0.773</td>
<td>tINS</td>
<td>RR</td>
<td>3385</td>
<td>IOB29[A]</td>
<td>clk_50m_ibuf/O</td>
</tr>
<tr>
<td>1.471</td>
<td>0.698</td>
<td>tNET</td>
<td>RR</td>
<td>1</td>
<td>R34C88[1][A]</td>
<td>driver/right_channel/remaining_1_s1/CLK</td>
</tr>
<tr>
<td>1.496</td>
<td>0.025</td>
<td>tHld</td>
<td></td>
<td>1</td>
<td>R34C88[1][A]</td>
<td>driver/right_channel/remaining_1_s1</td>
</tr>
</table>
<p><b>Path Statistics:</b></p>
<table class="summary_table">
<tr>
<td class="label">Clock Skew</td>
<td>0.000</td>
</tr>
<tr>
<td class="label">Hold Relationship </td>
<td>0.000</td>
</tr>
<tr>
<td class="label">Logic Level</td>
<td>2</td>
</tr>
<tr>
<td class="label">Arrival Clock Path Delay</td>
<td>cell: 0.773, 52.544%; route: 0.698, 47.456%</td>
</tr>
<tr>
<td class="label">Arrival Data Path Delay</td>
<td>cell: 0.153, 51.000%; route: 0.006, 2.000%; tC2Q: 0.141, 47.000%</td>
</tr>
<tr>
<td class="label">Required Clock Path Delay</td>
<td>cell: 0.773, 52.544%; route: 0.698, 47.456%</td>
</tr>
</table>
<h3>Path14</h3>
<p><b>Path Summary:</b></p>
<table class="summary_table">
<tr>
<td class="label">Slack</td>
<td>0.275</td>
</tr>
<tr>
<td class="label">Data Arrival Time</td>
<td>1.770</td>
</tr>
<tr>
<td class="label">Data Required Time</td>
<td>1.495</td>
</tr>
<tr>
<td class="label">From</td>
<td>driver/right_channel/remaining_9_s1</td>
</tr>
<tr>
<td class="label">To</td>
<td>driver/right_channel/remaining_9_s1</td>
</tr>
<tr>
<td class="label">Launch Clk</td>
<td>clk_50m:[R]</td>
</tr>
<tr>
<td class="label">Latch Clk</td>
<td>clk_50m:[R]</td>
</tr>
</table>
<p><b>Data Arrival Path:</b></p>
<table class="detail_table">
<tr>
<th class="label">AT</th>
<th class="label">DELAY</th>
<th class="label">TYPE</th>
<th class="label">RF</th>
<th class="label">FANOUT</th>
<th class="label">LOC</th>
<th>NODE</th>
</tr>
<tr>
<td>0.000</td>
<td>0.000</td>
<td></td>
<td></td>
<td></td>
<td></td>
<td>active clock edge time</td>
</tr>
<tr>
<td>0.000</td>
<td>0.000</td>
<td></td>
<td></td>
<td></td>
<td></td>
<td>clk_50m</td>
</tr>
<tr>
<td>0.000</td>
<td>0.000</td>
<td>tCL</td>
<td>RR</td>
<td>1</td>
<td>IOB29[A]</td>
<td>clk_50m_ibuf/I</td>
</tr>
<tr>
<td>0.773</td>
<td>0.773</td>
<td>tINS</td>
<td>RR</td>
<td>3385</td>
<td>IOB29[A]</td>
<td>clk_50m_ibuf/O</td>
</tr>
<tr>
<td>1.470</td>
<td>0.697</td>
<td>tNET</td>
<td>RR</td>
<td>1</td>
<td>R32C89[0][A]</td>
<td>driver/right_channel/remaining_9_s1/CLK</td>
</tr>
<tr>
<td>1.611</td>
<td>0.141</td>
<td>tC2Q</td>
<td>RF</td>
<td>3</td>
<td>R32C89[0][A]</td>
<td style=" font-weight:bold;">driver/right_channel/remaining_9_s1/Q</td>
</tr>
<tr>
<td>1.617</td>
<td>0.006</td>
<td>tNET</td>
<td>FF</td>
<td>1</td>
<td>R32C89[0][A]</td>
<td>driver/right_channel/n78_s10/I0</td>
</tr>
<tr>
<td>1.770</td>
<td>0.153</td>
<td>tINS</td>
<td>FF</td>
<td>1</td>
<td>R32C89[0][A]</td>
<td style=" background: #97FFFF;">driver/right_channel/n78_s10/F</td>
</tr>
<tr>
<td>1.770</td>
<td>0.000</td>
<td>tNET</td>
<td>FF</td>
<td>1</td>
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
</tr>
<tr>
<td>0.000</td>
<td>0.000</td>
<td></td>
<td></td>
<td></td>
<td></td>
<td>clk_50m</td>
</tr>
<tr>
<td>0.000</td>
<td>0.000</td>
<td>tCL</td>
<td>RR</td>
<td>1</td>
<td>IOB29[A]</td>
<td>clk_50m_ibuf/I</td>
</tr>
<tr>
<td>0.773</td>
<td>0.773</td>
<td>tINS</td>
<td>RR</td>
<td>3385</td>
<td>IOB29[A]</td>
<td>clk_50m_ibuf/O</td>
</tr>
<tr>
<td>1.474</td>
<td>0.701</td>
<td>tNET</td>
<td>RR</td>
<td>1</td>
<td>R33C89[0][A]</td>
<td>driver/right_channel/remaining_11_s1/CLK</td>
</tr>
<tr>
<td>1.499</td>
<td>0.025</td>
<td>tHld</td>
<td></td>
<td>1</td>
<td>R33C89[0][A]</td>
<td>driver/right_channel/remaining_11_s1</td>
</tr>
</table>
<p><b>Path Statistics:</b></p>
<table class="summary_table">
<tr>
<td class="label">Clock Skew</td>
<td>0.000</td>
</tr>
<tr>
<td class="label">Hold Relationship </td>
<td>0.000</td>
</tr>
<tr>
<td class="label">Logic Level</td>
<td>2</td>
</tr>
<tr>
<td class="label">Arrival Clock Path Delay</td>
<td>cell: 0.773, 52.446%; route: 0.701, 47.554%</td>
</tr>
<tr>
<td class="label">Arrival Data Path Delay</td>
<td>cell: 0.153, 51.000%; route: 0.006, 2.000%; tC2Q: 0.141, 47.000%</td>
</tr>
<tr>
<td class="label">Required Clock Path Delay</td>
<td>cell: 0.773, 52.446%; route: 0.701, 47.554%</td>
</tr>
</table>
<h3>Path16</h3>
<p><b>Path Summary:</b></p>
<table class="summary_table">
<tr>
<td class="label">Slack</td>
<td>0.275</td>
</tr>
<tr>
<td class="label">Data Arrival Time</td>
<td>1.773</td>
</tr>
<tr>
<td class="label">Data Required Time</td>
<td>1.498</td>
</tr>
<tr>
<td class="label">From</td>
<td>driver/left_channel/remaining_7_s1</td>
</tr>
<tr>
<td class="label">To</td>
<td>driver/left_channel/remaining_7_s1</td>
</tr>
<tr>
<td class="label">Launch Clk</td>
<td>clk_50m:[R]</td>
</tr>
<tr>
<td class="label">Latch Clk</td>
<td>clk_50m:[R]</td>
</tr>
</table>
<p><b>Data Arrival Path:</b></p>
<table class="detail_table">
<tr>
<th class="label">AT</th>
<th class="label">DELAY</th>
<th class="label">TYPE</th>
<th class="label">RF</th>
<th class="label">FANOUT</th>
<th class="label">LOC</th>
<th>NODE</th>
</tr>
<tr>
<td>0.000</td>
<td>0.000</td>
<td></td>
<td></td>
<td></td>
<td></td>
<td>active clock edge time</td>
</tr>
<tr>
<td>0.000</td>
<td>0.000</td>
<td></td>
<td></td>
<td></td>
<td></td>
<td>clk_50m</td>
</tr>
<tr>
<td>0.000</td>
<td>0.000</td>
<td>tCL</td>
<td>RR</td>
<td>1</td>
<td>IOB29[A]</td>
<td>clk_50m_ibuf/I</td>
</tr>
<tr>
<td>0.773</td>
<td>0.773</td>
<td>tINS</td>
<td>RR</td>
<td>3385</td>
<td>IOB29[A]</td>
<td>clk_50m_ibuf/O</td>
</tr>
<tr>
<td>1.473</td>
<td>0.700</td>
<td>tNET</td>
<td>RR</td>
<td>1</td>
<td>R35C82[1][A]</td>
<td>driver/left_channel/remaining_7_s1/CLK</td>
</tr>
<tr>
<td>1.614</td>
<td>0.141</td>
<td>tC2Q</td>
<td>RF</td>
<td>3</td>
<td>R35C82[1][A]</td>
<td style=" font-weight:bold;">driver/left_channel/remaining_7_s1/Q</td>
</tr>
<tr>
<td>1.620</td>
<td>0.006</td>
<td>tNET</td>
<td>FF</td>
<td>1</td>
<td>R35C82[1][A]</td>
<td>driver/left_channel/n80_s9/I3</td>
</tr>
<tr>
<td>1.773</td>
<td>0.153</td>
<td>tINS</td>
<td>FF</td>
<td>1</td>
<td>R35C82[1][A]</td>
<td style=" background: #97FFFF;">driver/left_channel/n80_s9/F</td>
</tr>
<tr>
<td>1.773</td>
<td>0.000</td>
<td>tNET</td>
<td>FF</td>
<td>1</td>
<td>R35C82[1][A]</td>
<td style=" font-weight:bold;">driver/left_channel/remaining_7_s1/D</td>
</tr>
</table>
<p><b>Data Required Path:</b></p>
<table class="detail_table">
<tr>
<th class="label">AT</th>
<th class="label">DELAY</th>
<th class="label">TYPE</th>
<th class="label">RF</th>
<th class="label">FANOUT</th>
<th class="label">LOC</th>
<th>NODE</th>
</tr>
<tr>
<td>0.000</td>
<td>0.000</td>
<td></td>
<td></td>
<td></td>
<td></td>
<td>active clock edge time</td>
</tr>
<tr>
<td>0.000</td>
<td>0.000</td>
<td></td>
<td></td>
<td></td>
<td></td>
<td>clk_50m</td>
</tr>
<tr>
<td>0.000</td>
<td>0.000</td>
<td>tCL</td>
<td>RR</td>
<td>1</td>
<td>IOB29[A]</td>
<td>clk_50m_ibuf/I</td>
</tr>
<tr>
<td>0.773</td>
<td>0.773</td>
<td>tINS</td>
<td>RR</td>
<td>3385</td>
<td>IOB29[A]</td>
<td>clk_50m_ibuf/O</td>
</tr>
<tr>
<td>1.473</td>
<td>0.700</td>
<td>tNET</td>
<td>RR</td>
<td>1</td>
<td>R35C82[1][A]</td>
<td>driver/left_channel/remaining_7_s1/CLK</td>
</tr>
<tr>
<td>1.498</td>
<td>0.025</td>
<td>tHld</td>
<td></td>
<td>1</td>
<td>R35C82[1][A]</td>
<td>driver/left_channel/remaining_7_s1</td>
</tr>
</table>
<p><b>Path Statistics:</b></p>
<table class="summary_table">
<tr>
<td class="label">Clock Skew</td>
<td>0.000</td>
</tr>
<tr>
<td class="label">Hold Relationship </td>
<td>0.000</td>
</tr>
<tr>
<td class="label">Logic Level</td>
<td>2</td>
</tr>
<tr>
<td class="label">Arrival Clock Path Delay</td>
<td>cell: 0.773, 52.500%; route: 0.700, 47.500%</td>
</tr>
<tr>
<td class="label">Arrival Data Path Delay</td>
<td>cell: 0.153, 51.000%; route: 0.006, 2.000%; tC2Q: 0.141, 47.000%</td>
</tr>
<tr>
<td class="label">Required Clock Path Delay</td>
<td>cell: 0.773, 52.500%; route: 0.700, 47.500%</td>
</tr>
</table>
<h3>Path17</h3>
<p><b>Path Summary:</b></p>
<table class="summary_table">
<tr>
<td class="label">Slack</td>
<td>0.275</td>
</tr>
<tr>
<td class="label">Data Arrival Time</td>
<td>1.774</td>
</tr>
<tr>
<td class="label">Data Required Time</td>
<td>1.499</td>
</tr>
<tr>
<td class="label">From</td>
<td>driver/phase_0_s0</td>
</tr>
<tr>
<td class="label">To</td>
<td>driver/phase_0_s0</td>
</tr>
<tr>
<td class="label">Launch Clk</td>
<td>clk_50m:[R]</td>
</tr>
<tr>
<td class="label">Latch Clk</td>
<td>clk_50m:[R]</td>
</tr>
</table>
<p><b>Data Arrival Path:</b></p>
<table class="detail_table">
<tr>
<th class="label">AT</th>
<th class="label">DELAY</th>
<th class="label">TYPE</th>
<th class="label">RF</th>
<th class="label">FANOUT</th>
<th class="label">LOC</th>
<th>NODE</th>
</tr>
<tr>
<td>0.000</td>
<td>0.000</td>
<td></td>
<td></td>
<td></td>
<td></td>
<td>active clock edge time</td>
</tr>
<tr>
<td>0.000</td>
<td>0.000</td>
<td></td>
<td></td>
<td></td>
<td></td>
<td>clk_50m</td>
</tr>
<tr>
<td>0.000</td>
<td>0.000</td>
<td>tCL</td>
<td>RR</td>
<td>1</td>
<td>IOB29[A]</td>
<td>clk_50m_ibuf/I</td>
</tr>
<tr>
<td>0.773</td>
<td>0.773</td>
<td>tINS</td>
<td>RR</td>
<td>3385</td>
<td>IOB29[A]</td>
<td>clk_50m_ibuf/O</td>
</tr>
<tr>
<td>1.474</td>
<td>0.701</td>
<td>tNET</td>
<td>RR</td>
<td>1</td>
<td>R36C84[0][A]</td>
<td>driver/phase_0_s0/CLK</td>
</tr>
<tr>
<td>1.615</td>
<td>0.141</td>
<td>tC2Q</td>
<td>RF</td>
<td>8</td>
<td>R36C84[0][A]</td>
<td style=" font-weight:bold;">driver/phase_0_s0/Q</td>
</tr>
<tr>
<td>1.621</td>
<td>0.006</td>
<td>tNET</td>
<td>FF</td>
<td>1</td>
<td>R36C84[0][A]</td>
<td>driver/n54_s4/I0</td>
</tr>
<tr>
<td>1.774</td>
<td>0.153</td>
<td>tINS</td>
<td>FF</td>
<td>1</td>
<td>R36C84[0][A]</td>
<td style=" background: #97FFFF;">driver/n54_s4/F</td>
</tr>
<tr>
<td>1.774</td>
<td>0.000</td>
<td>tNET</td>
<td>FF</td>
<td>1</td>
<td>R36C84[0][A]</td>
<td style=" font-weight:bold;">driver/phase_0_s0/D</td>
</tr>
</table>
<p><b>Data Required Path:</b></p>
<table class="detail_table">
<tr>
<th class="label">AT</th>
<th class="label">DELAY</th>
<th class="label">TYPE</th>
<th class="label">RF</th>
<th class="label">FANOUT</th>
<th class="label">LOC</th>
<th>NODE</th>
</tr>
<tr>
<td>0.000</td>
<td>0.000</td>
<td></td>
<td></td>
<td></td>
<td></td>
<td>active clock edge time</td>
</tr>
<tr>
<td>0.000</td>
<td>0.000</td>
<td></td>
<td></td>
<td></td>
<td></td>
<td>clk_50m</td>
</tr>
<tr>
<td>0.000</td>
<td>0.000</td>
<td>tCL</td>
<td>RR</td>
<td>1</td>
<td>IOB29[A]</td>
<td>clk_50m_ibuf/I</td>
</tr>
<tr>
<td>0.773</td>
<td>0.773</td>
<td>tINS</td>
<td>RR</td>
<td>3385</td>
<td>IOB29[A]</td>
<td>clk_50m_ibuf/O</td>
</tr>
<tr>
<td>1.474</td>
<td>0.701</td>
<td>tNET</td>
<td>RR</td>
<td>1</td>
<td>R36C84[0][A]</td>
<td>driver/phase_0_s0/CLK</td>
</tr>
<tr>
<td>1.499</td>
<td>0.025</td>
<td>tHld</td>
<td></td>
<td>1</td>
<td>R36C84[0][A]</td>
<td>driver/phase_0_s0</td>
</tr>
</table>
<p><b>Path Statistics:</b></p>
<table class="summary_table">
<tr>
<td class="label">Clock Skew</td>
<td>0.000</td>
</tr>
<tr>
<td class="label">Hold Relationship </td>
<td>0.000</td>
</tr>
<tr>
<td class="label">Logic Level</td>
<td>2</td>
</tr>
<tr>
<td class="label">Arrival Clock Path Delay</td>
<td>cell: 0.773, 52.455%; route: 0.701, 47.545%</td>
</tr>
<tr>
<td class="label">Arrival Data Path Delay</td>
<td>cell: 0.153, 51.000%; route: 0.006, 2.000%; tC2Q: 0.141, 47.000%</td>
</tr>
<tr>
<td class="label">Required Clock Path Delay</td>
<td>cell: 0.773, 52.455%; route: 0.701, 47.545%</td>
</tr>
</table>
<h3>Path18</h3>
<p><b>Path Summary:</b></p>
<table class="summary_table">
<tr>
<td class="label">Slack</td>
<td>0.275</td>
</tr>
<tr>
<td class="label">Data Arrival Time</td>
<td>1.774</td>
</tr>
<tr>
<td class="label">Data Required Time</td>
<td>1.499</td>
</tr>
<tr>
<td class="label">From</td>
<td>ramp/left_channel/duty_3_s0</td>
</tr>
<tr>
<td class="label">To</td>
<td>ramp/left_channel/duty_3_s0</td>
</tr>
<tr>
<td class="label">Launch Clk</td>
<td>clk_50m:[R]</td>
</tr>
<tr>
<td class="label">Latch Clk</td>
<td>clk_50m:[R]</td>
</tr>
</table>
<p><b>Data Arrival Path:</b></p>
<table class="detail_table">
<tr>
<th class="label">AT</th>
<th class="label">DELAY</th>
<th class="label">TYPE</th>
<th class="label">RF</th>
<th class="label">FANOUT</th>
<th class="label">LOC</th>
<th>NODE</th>
</tr>
<tr>
<td>0.000</td>
<td>0.000</td>
<td></td>
<td></td>
<td></td>
<td></td>
<td>active clock edge time</td>
</tr>
<tr>
<td>0.000</td>
<td>0.000</td>
<td></td>
<td></td>
<td></td>
<td></td>
<td>clk_50m</td>
</tr>
<tr>
<td>0.000</td>
<td>0.000</td>
<td>tCL</td>
<td>RR</td>
<td>1</td>
<td>IOB29[A]</td>
<td>clk_50m_ibuf/I</td>
</tr>
<tr>
<td>0.773</td>
<td>0.773</td>
<td>tINS</td>
<td>RR</td>
<td>3385</td>
<td>IOB29[A]</td>
<td>clk_50m_ibuf/O</td>
</tr>
<tr>
<td>1.474</td>
<td>0.701</td>
<td>tNET</td>
<td>RR</td>
<td>1</td>
<td>R33C77[0][A]</td>
<td>ramp/left_channel/duty_3_s0/CLK</td>
</tr>
<tr>
<td>1.615</td>
<td>0.141</td>
<td>tC2Q</td>
<td>RF</td>
<td>12</td>
<td>R33C77[0][A]</td>
<td style=" font-weight:bold;">ramp/left_channel/duty_3_s0/Q</td>
</tr>
<tr>
<td>1.621</td>
<td>0.006</td>
<td>tNET</td>
<td>FF</td>
<td>1</td>
<td>R33C77[0][A]</td>
<td>ramp/left_channel/n451_s1/I3</td>
</tr>
<tr>
<td>1.774</td>
<td>0.153</td>
<td>tINS</td>
<td>FF</td>
<td>1</td>
<td>R33C77[0][A]</td>
<td style=" background: #97FFFF;">ramp/left_channel/n451_s1/F</td>
</tr>
<tr>
<td>1.774</td>
<td>0.000</td>
<td>tNET</td>
<td>FF</td>
<td>1</td>
<td>R33C77[0][A]</td>
<td style=" font-weight:bold;">ramp/left_channel/duty_3_s0/D</td>
</tr>
</table>
<p><b>Data Required Path:</b></p>
<table class="detail_table">
<tr>
<th class="label">AT</th>
<th class="label">DELAY</th>
<th class="label">TYPE</th>
<th class="label">RF</th>
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
<td>0.000</td>
<td>0.000</td>
<td></td>
<td></td>
<td></td>
<td></td>
<td>active clock edge time</td>
</tr>
<tr>
<td>0.000</td>
<td>0.000</td>
<td></td>
<td></td>
<td></td>
<td></td>
<td>clk_50m</td>
</tr>
<tr>
<td>0.000</td>
<td>0.000</td>
<td>tCL</td>
<td>RR</td>
<td>1</td>
<td>IOB29[A]</td>
<td>clk_50m_ibuf/I</td>
</tr>
<tr>
<td>0.773</td>
<td>0.773</td>
<td>tINS</td>
<td>RR</td>
<td>3385</td>
<td>IOB29[A]</td>
<td>clk_50m_ibuf/O</td>
</tr>
<tr>
<td>1.475</td>
<td>0.702</td>
<td>tNET</td>
<td>RR</td>
<td>1</td>
<td>R34C61[0][A]</td>
<td>ramp/phase_3_s0/CLK</td>
</tr>
<tr>
<td>1.500</td>
<td>0.025</td>
<td>tHld</td>
<td></td>
<td>1</td>
<td>R34C61[0][A]</td>
<td>ramp/phase_3_s0</td>
</tr>
</table>
<p><b>Path Statistics:</b></p>
<table class="summary_table">
<tr>
<td class="label">Clock Skew</td>
<td>0.000</td>
</tr>
<tr>
<td class="label">Hold Relationship </td>
<td>0.000</td>
</tr>
<tr>
<td class="label">Logic Level</td>
<td>2</td>
</tr>
<tr>
<td class="label">Arrival Clock Path Delay</td>
<td>cell: 0.773, 52.402%; route: 0.702, 47.598%</td>
</tr>
<tr>
<td class="label">Arrival Data Path Delay</td>
<td>cell: 0.153, 51.000%; route: 0.006, 2.000%; tC2Q: 0.141, 47.000%</td>
</tr>
<tr>
<td class="label">Required Clock Path Delay</td>
<td>cell: 0.773, 52.402%; route: 0.702, 47.598%</td>
</tr>
</table>
<h3>Path21</h3>
<p><b>Path Summary:</b></p>
<table class="summary_table">
<tr>
<td class="label">Slack</td>
<td>0.275</td>
</tr>
<tr>
<td class="label">Data Arrival Time</td>
<td>1.766</td>
</tr>
<tr>
<td class="label">Data Required Time</td>
<td>1.491</td>
</tr>
<tr>
<td class="label">From</td>
<td>ramp/phase_4_s0</td>
</tr>
<tr>
<td class="label">To</td>
<td>ramp/phase_4_s0</td>
</tr>
<tr>
<td class="label">Launch Clk</td>
<td>clk_50m:[R]</td>
</tr>
<tr>
<td class="label">Latch Clk</td>
<td>clk_50m:[R]</td>
</tr>
</table>
<p><b>Data Arrival Path:</b></p>
<table class="detail_table">
<tr>
<th class="label">AT</th>
<th class="label">DELAY</th>
<th class="label">TYPE</th>
<th class="label">RF</th>
<th class="label">FANOUT</th>
<th class="label">LOC</th>
<th>NODE</th>
</tr>
<tr>
<td>0.000</td>
<td>0.000</td>
<td></td>
<td></td>
<td></td>
<td></td>
<td>active clock edge time</td>
</tr>
<tr>
<td>0.000</td>
<td>0.000</td>
<td></td>
<td></td>
<td></td>
<td></td>
<td>clk_50m</td>
</tr>
<tr>
<td>0.000</td>
<td>0.000</td>
<td>tCL</td>
<td>RR</td>
<td>1</td>
<td>IOB29[A]</td>
<td>clk_50m_ibuf/I</td>
</tr>
<tr>
<td>0.773</td>
<td>0.773</td>
<td>tINS</td>
<td>RR</td>
<td>3385</td>
<td>IOB29[A]</td>
<td>clk_50m_ibuf/O</td>
</tr>
<tr>
<td>1.466</td>
<td>0.693</td>
<td>tNET</td>
<td>RR</td>
<td>1</td>
<td>R32C66[0][A]</td>
<td>ramp/phase_4_s0/CLK</td>
</tr>
<tr>
<td>1.607</td>
<td>0.141</td>
<td>tC2Q</td>
<td>RF</td>
<td>4</td>
<td>R32C66[0][A]</td>
<td style=" font-weight:bold;">ramp/phase_4_s0/Q</td>
</tr>
<tr>
<td>1.613</td>
<td>0.006</td>
<td>tNET</td>
<td>FF</td>
<td>1</td>
<td>R32C66[0][A]</td>
<td>ramp/n45_s4/I0</td>
</tr>
<tr>
<td>1.766</td>
<td>0.153</td>
<td>tINS</td>
<td>FF</td>
<td>1</td>
<td>R32C66[0][A]</td>
<td style=" background: #97FFFF;">ramp/n45_s4/F</td>
</tr>
<tr>
<td>1.766</td>
<td>0.000</td>
<td>tNET</td>
<td>FF</td>
<td>1</td>
<td>R32C66[0][A]</td>
<td style=" font-weight:bold;">ramp/phase_4_s0/D</td>
</tr>
</table>
<p><b>Data Required Path:</b></p>
<table class="detail_table">
<tr>
<th class="label">AT</th>
<th class="label">DELAY</th>
<th class="label">TYPE</th>
<th class="label">RF</th>
<th class="label">FANOUT</th>
<th class="label">LOC</th>
<th>NODE</th>
</tr>
<tr>
<td>0.000</td>
<td>0.000</td>
<td></td>
<td></td>
<td></td>
<td></td>
<td>active clock edge time</td>
</tr>
<tr>
<td>0.000</td>
<td>0.000</td>
<td></td>
<td></td>
<td></td>
<td></td>
<td>clk_50m</td>
</tr>
<tr>
<td>0.000</td>
<td>0.000</td>
<td>tCL</td>
<td>RR</td>
<td>1</td>
<td>IOB29[A]</td>
<td>clk_50m_ibuf/I</td>
</tr>
<tr>
<td>0.773</td>
<td>0.773</td>
<td>tINS</td>
<td>RR</td>
<td>3385</td>
<td>IOB29[A]</td>
<td>clk_50m_ibuf/O</td>
</tr>
<tr>
<td>1.466</td>
<td>0.693</td>
<td>tNET</td>
<td>RR</td>
<td>1</td>
<td>R32C66[0][A]</td>
<td>ramp/phase_4_s0/CLK</td>
</tr>
<tr>
<td>1.491</td>
<td>0.025</td>
<td>tHld</td>
<td></td>
<td>1</td>
<td>R32C66[0][A]</td>
<td>ramp/phase_4_s0</td>
</tr>
</table>
<p><b>Path Statistics:</b></p>
<table class="summary_table">
<tr>
<td class="label">Clock Skew</td>
<td>0.000</td>
</tr>
<tr>
<td class="label">Hold Relationship </td>
<td>0.000</td>
</tr>
<tr>
<td class="label">Logic Level</td>
<td>2</td>
</tr>
<tr>
<td class="label">Arrival Clock Path Delay</td>
<td>cell: 0.773, 52.733%; route: 0.693, 47.267%</td>
</tr>
<tr>
<td class="label">Arrival Data Path Delay</td>
<td>cell: 0.153, 51.000%; route: 0.006, 2.000%; tC2Q: 0.141, 47.000%</td>
</tr>
<tr>
<td class="label">Required Clock Path Delay</td>
<td>cell: 0.773, 52.733%; route: 0.693, 47.267%</td>
</tr>
</table>
<h3>Path22</h3>
<p><b>Path Summary:</b></p>
<table class="summary_table">
<tr>
<td class="label">Slack</td>
<td>0.275</td>
</tr>
<tr>
<td class="label">Data Arrival Time</td>
<td>1.762</td>
</tr>
<tr>
<td class="label">Data Required Time</td>
<td>1.487</td>
</tr>
<tr>
<td class="label">From</td>
<td>motion/age_y_0_s1</td>
</tr>
<tr>
<td class="label">To</td>
<td>motion/age_y_0_s1</td>
</tr>
<tr>
<td class="label">Launch Clk</td>
<td>clk_50m:[R]</td>
</tr>
<tr>
<td class="label">Latch Clk</td>
<td>clk_50m:[R]</td>
</tr>
</table>
<p><b>Data Arrival Path:</b></p>
<table class="detail_table">
<tr>
<th class="label">AT</th>
<th class="label">DELAY</th>
<th class="label">TYPE</th>
<th class="label">RF</th>
<th class="label">FANOUT</th>
<th class="label">LOC</th>
<th>NODE</th>
</tr>
<tr>
<td>0.000</td>
<td>0.000</td>
<td></td>
<td></td>
<td></td>
<td></td>
<td>active clock edge time</td>
</tr>
<tr>
<td>0.000</td>
<td>0.000</td>
<td></td>
<td></td>
<td></td>
<td></td>
<td>clk_50m</td>
</tr>
<tr>
<td>0.000</td>
<td>0.000</td>
<td>tCL</td>
<td>RR</td>
<td>1</td>
<td>IOB29[A]</td>
<td>clk_50m_ibuf/I</td>
</tr>
<tr>
<td>0.773</td>
<td>0.773</td>
<td>tINS</td>
<td>RR</td>
<td>3385</td>
<td>IOB29[A]</td>
<td>clk_50m_ibuf/O</td>
</tr>
<tr>
<td>1.462</td>
<td>0.689</td>
<td>tNET</td>
<td>RR</td>
<td>1</td>
<td>R31C32[1][A]</td>
<td>motion/age_y_0_s1/CLK</td>
</tr>
<tr>
<td>1.603</td>
<td>0.141</td>
<td>tC2Q</td>
<td>RF</td>
<td>5</td>
<td>R31C32[1][A]</td>
<td style=" font-weight:bold;">motion/age_y_0_s1/Q</td>
</tr>
<tr>
<td>1.609</td>
<td>0.006</td>
<td>tNET</td>
<td>FF</td>
<td>1</td>
<td>R31C32[1][A]</td>
<td>motion/n1326_s2/I1</td>
</tr>
<tr>
<td>1.762</td>
<td>0.153</td>
<td>tINS</td>
<td>FF</td>
<td>1</td>
<td>R31C32[1][A]</td>
<td style=" background: #97FFFF;">motion/n1326_s2/F</td>
</tr>
<tr>
<td>1.762</td>
<td>0.000</td>
<td>tNET</td>
<td>FF</td>
<td>1</td>
<td>R31C32[1][A]</td>
<td style=" font-weight:bold;">motion/age_y_0_s1/D</td>
</tr>
</table>
<p><b>Data Required Path:</b></p>
<table class="detail_table">
<tr>
<th class="label">AT</th>
<th class="label">DELAY</th>
<th class="label">TYPE</th>
<th class="label">RF</th>
<th class="label">FANOUT</th>
<th class="label">LOC</th>
<th>NODE</th>
</tr>
<tr>
<td>0.000</td>
<td>0.000</td>
<td></td>
<td></td>
<td></td>
<td></td>
<td>active clock edge time</td>
</tr>
<tr>
<td>0.000</td>
<td>0.000</td>
<td></td>
<td></td>
<td></td>
<td></td>
<td>clk_50m</td>
</tr>
<tr>
<td>0.000</td>
<td>0.000</td>
<td>tCL</td>
<td>RR</td>
<td>1</td>
<td>IOB29[A]</td>
<td>clk_50m_ibuf/I</td>
</tr>
<tr>
<td>0.773</td>
<td>0.773</td>
<td>tINS</td>
<td>RR</td>
<td>3385</td>
<td>IOB29[A]</td>
<td>clk_50m_ibuf/O</td>
</tr>
<tr>
<td>1.462</td>
<td>0.689</td>
<td>tNET</td>
<td>RR</td>
<td>1</td>
<td>R31C32[1][A]</td>
<td>motion/age_y_0_s1/CLK</td>
</tr>
<tr>
<td>1.487</td>
<td>0.025</td>
<td>tHld</td>
<td></td>
<td>1</td>
<td>R31C32[1][A]</td>
<td>motion/age_y_0_s1</td>
</tr>
</table>
<p><b>Path Statistics:</b></p>
<table class="summary_table">
<tr>
<td class="label">Clock Skew</td>
<td>0.000</td>
</tr>
<tr>
<td class="label">Hold Relationship </td>
<td>0.000</td>
</tr>
<tr>
<td class="label">Logic Level</td>
<td>2</td>
</tr>
<tr>
<td class="label">Arrival Clock Path Delay</td>
<td>cell: 0.773, 52.877%; route: 0.689, 47.123%</td>
</tr>
<tr>
<td class="label">Arrival Data Path Delay</td>
<td>cell: 0.153, 51.000%; route: 0.006, 2.000%; tC2Q: 0.141, 47.000%</td>
</tr>
<tr>
<td class="label">Required Clock Path Delay</td>
<td>cell: 0.773, 52.877%; route: 0.689, 47.123%</td>
</tr>
</table>
<h3>Path23</h3>
<p><b>Path Summary:</b></p>
<table class="summary_table">
<tr>
<td class="label">Slack</td>
<td>0.275</td>
</tr>
<tr>
<td class="label">Data Arrival Time</td>
<td>1.766</td>
</tr>
<tr>
<td class="label">Data Required Time</td>
<td>1.491</td>
</tr>
<tr>
<td class="label">From</td>
<td>motion/age_y_10_s1</td>
</tr>
<tr>
<td class="label">To</td>
<td>motion/age_y_10_s1</td>
</tr>
<tr>
<td class="label">Launch Clk</td>
<td>clk_50m:[R]</td>
</tr>
<tr>
<td class="label">Latch Clk</td>
<td>clk_50m:[R]</td>
</tr>
</table>
<p><b>Data Arrival Path:</b></p>
<table class="detail_table">
<tr>
<th class="label">AT</th>
<th class="label">DELAY</th>
<th class="label">TYPE</th>
<th class="label">RF</th>
<th class="label">FANOUT</th>
<th class="label">LOC</th>
<th>NODE</th>
</tr>
<tr>
<td>0.000</td>
<td>0.000</td>
<td></td>
<td></td>
<td></td>
<td></td>
<td>active clock edge time</td>
</tr>
<tr>
<td>0.000</td>
<td>0.000</td>
<td></td>
<td></td>
<td></td>
<td></td>
<td>clk_50m</td>
</tr>
<tr>
<td>0.000</td>
<td>0.000</td>
<td>tCL</td>
<td>RR</td>
<td>1</td>
<td>IOB29[A]</td>
<td>clk_50m_ibuf/I</td>
</tr>
<tr>
<td>0.773</td>
<td>0.773</td>
<td>tINS</td>
<td>RR</td>
<td>3385</td>
<td>IOB29[A]</td>
<td>clk_50m_ibuf/O</td>
</tr>
<tr>
<td>1.466</td>
<td>0.693</td>
<td>tNET</td>
<td>RR</td>
<td>1</td>
<td>R32C38[1][A]</td>
<td>motion/age_y_10_s1/CLK</td>
</tr>
<tr>
<td>1.607</td>
<td>0.141</td>
<td>tC2Q</td>
<td>RF</td>
<td>5</td>
<td>R32C38[1][A]</td>
<td style=" font-weight:bold;">motion/age_y_10_s1/Q</td>
</tr>
<tr>
<td>1.613</td>
<td>0.006</td>
<td>tNET</td>
<td>FF</td>
<td>1</td>
<td>R32C38[1][A]</td>
<td>motion/n1316_s2/I1</td>
</tr>
<tr>
<td>1.766</td>
<td>0.153</td>
<td>tINS</td>
<td>FF</td>
<td>1</td>
<td>R32C38[1][A]</td>
<td style=" background: #97FFFF;">motion/n1316_s2/F</td>
</tr>
<tr>
<td>1.766</td>
<td>0.000</td>
<td>tNET</td>
<td>FF</td>
<td>1</td>
<td>R32C38[1][A]</td>
<td style=" font-weight:bold;">motion/age_y_10_s1/D</td>
</tr>
</table>
<p><b>Data Required Path:</b></p>
<table class="detail_table">
<tr>
<th class="label">AT</th>
<th class="label">DELAY</th>
<th class="label">TYPE</th>
<th class="label">RF</th>
<th class="label">FANOUT</th>
<th class="label">LOC</th>
<th>NODE</th>
</tr>
<tr>
<td>0.000</td>
<td>0.000</td>
<td></td>
<td></td>
<td></td>
<td></td>
<td>active clock edge time</td>
</tr>
<tr>
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
<td></td>
<td></td>
<td></td>
<td></td>
<td>clk_50m</td>
</tr>
<tr>
<td>0.000</td>
<td>0.000</td>
<td>tCL</td>
<td>RR</td>
<td>1</td>
<td>IOB29[A]</td>
<td>clk_50m_ibuf/I</td>
</tr>
<tr>
<td>0.773</td>
<td>0.773</td>
<td>tINS</td>
<td>RR</td>
<td>3385</td>
<td>IOB29[A]</td>
<td>clk_50m_ibuf/O</td>
</tr>
<tr>
<td>1.462</td>
<td>0.689</td>
<td>tNET</td>
<td>RR</td>
<td>1</td>
<td>R32C35[0][A]</td>
<td>motion/age_y_20_s1/CLK</td>
</tr>
<tr>
<td>1.487</td>
<td>0.025</td>
<td>tHld</td>
<td></td>
<td>1</td>
<td>R32C35[0][A]</td>
<td>motion/age_y_20_s1</td>
</tr>
</table>
<p><b>Path Statistics:</b></p>
<table class="summary_table">
<tr>
<td class="label">Clock Skew</td>
<td>0.000</td>
</tr>
<tr>
<td class="label">Hold Relationship </td>
<td>0.000</td>
</tr>
<tr>
<td class="label">Logic Level</td>
<td>2</td>
</tr>
<tr>
<td class="label">Arrival Clock Path Delay</td>
<td>cell: 0.773, 52.877%; route: 0.689, 47.123%</td>
</tr>
<tr>
<td class="label">Arrival Data Path Delay</td>
<td>cell: 0.153, 51.000%; route: 0.006, 2.000%; tC2Q: 0.141, 47.000%</td>
</tr>
<tr>
<td class="label">Required Clock Path Delay</td>
<td>cell: 0.773, 52.877%; route: 0.689, 47.123%</td>
</tr>
</table>
<h3><a name="Recovery_Analysis">Recovery Analysis Report</a></h3>
<h4>Report Command:report_timing -recovery -max_paths 25 -max_common_paths 1</h4>
<h3>Path1</h3>
<p><b>Path Summary:</b></p>
<table class="summary_table">
<tr>
<td class="label">Slack</td>
<td>9.735</td>
</tr>
<tr>
<td class="label">Data Arrival Time</td>
<td>12.561</td>
</tr>
<tr>
<td class="label">Data Required Time</td>
<td>22.296</td>
</tr>
<tr>
<td class="label">From</td>
<td>imu/ready_s1</td>
</tr>
<tr>
<td class="label">To</td>
<td>driver/command_l_10_s0</td>
</tr>
<tr>
<td class="label">Launch Clk</td>
<td>clk_50m:[R]</td>
</tr>
<tr>
<td class="label">Latch Clk</td>
<td>clk_50m:[R]</td>
</tr>
</table>
<p><b>Data Arrival Path:</b></p>
<table class="detail_table">
<tr>
<th class="label">AT</th>
<th class="label">DELAY</th>
<th class="label">TYPE</th>
<th class="label">RF</th>
<th class="label">FANOUT</th>
<th class="label">LOC</th>
<th>NODE</th>
</tr>
<tr>
<td>0.000</td>
<td>0.000</td>
<td></td>
<td></td>
<td></td>
<td></td>
<td>active clock edge time</td>
</tr>
<tr>
<td>0.000</td>
<td>0.000</td>
<td></td>
<td></td>
<td></td>
<td></td>
<td>clk_50m</td>
</tr>
<tr>
<td>0.000</td>
<td>0.000</td>
<td>tCL</td>
<td>RR</td>
<td>1</td>
<td>IOB29[A]</td>
<td>clk_50m_ibuf/I</td>
</tr>
<tr>
<td>1.046</td>
<td>1.046</td>
<td>tINS</td>
<td>RR</td>
<td>3385</td>
<td>IOB29[A]</td>
<td>clk_50m_ibuf/O</td>
</tr>
<tr>
<td>2.607</td>
<td>1.561</td>
<td>tNET</td>
<td>RR</td>
<td>1</td>
<td>R22C87[1][A]</td>
<td>imu/ready_s1/CLK</td>
</tr>
<tr>
<td>2.901</td>
<td>0.294</td>
<td>tC2Q</td>
<td>RF</td>
<td>277</td>
<td>R22C87[1][A]</td>
<td style=" font-weight:bold;">imu/ready_s1/Q</td>
</tr>
<tr>
<td>6.276</td>
<td>3.375</td>
<td>tNET</td>
<td>FF</td>
<td>1</td>
<td>R14C54[0][B]</td>
<td>fault_now_s1/I2</td>
</tr>
<tr>
<td>6.689</td>
<td>0.413</td>
<td>tINS</td>
<td>FR</td>
<td>9</td>
<td>R14C54[0][B]</td>
<td style=" background: #97FFFF;">fault_now_s1/F</td>
</tr>
<tr>
<td>7.748</td>
<td>1.059</td>
<td>tNET</td>
<td>RR</td>
<td>1</td>
<td>R22C48[0][B]</td>
<td>driver/inhibit_s1/I0</td>
</tr>
<tr>
<td>8.169</td>
<td>0.421</td>
<td>tINS</td>
<td>RR</td>
<td>125</td>
<td>R22C48[0][B]</td>
<td style=" background: #97FFFF;">driver/inhibit_s1/F</td>
</tr>
<tr>
<td>10.578</td>
<td>2.409</td>
<td>tNET</td>
<td>RR</td>
<td>1</td>
<td>R32C87[1][A]</td>
<td>driver/n14_s2/I2</td>
</tr>
<tr>
<td>10.890</td>
<td>0.312</td>
<td>tINS</td>
<td>RF</td>
<td>78</td>
<td>R32C87[1][A]</td>
<td style=" background: #97FFFF;">driver/n14_s2/F</td>
</tr>
<tr>
<td>12.561</td>
<td>1.671</td>
<td>tNET</td>
<td>FF</td>
<td>1</td>
<td>R32C79[0][B]</td>
<td style=" font-weight:bold;">driver/command_l_10_s0/CLEAR</td>
</tr>
</table>
<p><b>Data Required Path:</b></p>
<table class="detail_table">
<tr>
<th class="label">AT</th>
<th class="label">DELAY</th>
<th class="label">TYPE</th>
<th class="label">RF</th>
<th class="label">FANOUT</th>
<th class="label">LOC</th>
<th>NODE</th>
</tr>
<tr>
<td>20.000</td>
<td>20.000</td>
<td></td>
<td></td>
<td></td>
<td></td>
<td>active clock edge time</td>
</tr>
<tr>
<td>20.000</td>
<td>0.000</td>
<td></td>
<td></td>
<td></td>
<td></td>
<td>clk_50m</td>
</tr>
<tr>
<td>20.000</td>
<td>0.000</td>
<td>tCL</td>
<td>RR</td>
<td>1</td>
<td>IOB29[A]</td>
<td>clk_50m_ibuf/I</td>
</tr>
<tr>
<td>21.046</td>
<td>1.046</td>
<td>tINS</td>
<td>RR</td>
<td>3385</td>
<td>IOB29[A]</td>
<td>clk_50m_ibuf/O</td>
</tr>
<tr>
<td>22.574</td>
<td>1.528</td>
<td>tNET</td>
<td>RR</td>
<td>1</td>
<td>R32C79[0][B]</td>
<td>driver/command_l_10_s0/CLK</td>
</tr>
<tr>
<td>22.296</td>
<td>-0.278</td>
<td>tSu</td>
<td></td>
<td>1</td>
<td>R32C79[0][B]</td>
<td>driver/command_l_10_s0</td>
</tr>
</table>
<p><b>Path Statistics:</b></p>
<table class="summary_table">
<tr>
<td class="label">Clock Skew</td>
<td>-0.033</td>
</tr>
<tr>
<td class="label">Setup Relationship </td>
<td>20.000</td>
</tr>
<tr>
<td class="label">Logic Level</td>
<td>4</td>
</tr>
<tr>
<td class="label">Arrival Clock Path Delay</td>
<td>cell: 1.046, 40.123%; route: 1.561, 59.877%</td>
</tr>
<tr>
<td class="label">Arrival Data Path Delay</td>
<td>cell: 1.146, 11.513%; route: 8.514, 85.533%; tC2Q: 0.294, 2.954%</td>
</tr>
<tr>
<td class="label">Required Clock Path Delay</td>
<td>cell: 1.046, 40.633%; route: 1.528, 59.367%</td>
</tr>
</table>
<h3>Path2</h3>
<p><b>Path Summary:</b></p>
<table class="summary_table">
<tr>
<td class="label">Slack</td>
<td>9.735</td>
</tr>
<tr>
<td class="label">Data Arrival Time</td>
<td>12.561</td>
</tr>
<tr>
<td class="label">Data Required Time</td>
<td>22.296</td>
</tr>
<tr>
<td class="label">From</td>
<td>imu/ready_s1</td>
</tr>
<tr>
<td class="label">To</td>
<td>driver/command_l_11_s0</td>
</tr>
<tr>
<td class="label">Launch Clk</td>
<td>clk_50m:[R]</td>
</tr>
<tr>
<td class="label">Latch Clk</td>
<td>clk_50m:[R]</td>
</tr>
</table>
<p><b>Data Arrival Path:</b></p>
<table class="detail_table">
<tr>
<th class="label">AT</th>
<th class="label">DELAY</th>
<th class="label">TYPE</th>
<th class="label">RF</th>
<th class="label">FANOUT</th>
<th class="label">LOC</th>
<th>NODE</th>
</tr>
<tr>
<td>0.000</td>
<td>0.000</td>
<td></td>
<td></td>
<td></td>
<td></td>
<td>active clock edge time</td>
</tr>
<tr>
<td>0.000</td>
<td>0.000</td>
<td></td>
<td></td>
<td></td>
<td></td>
<td>clk_50m</td>
</tr>
<tr>
<td>0.000</td>
<td>0.000</td>
<td>tCL</td>
<td>RR</td>
<td>1</td>
<td>IOB29[A]</td>
<td>clk_50m_ibuf/I</td>
</tr>
<tr>
<td>1.046</td>
<td>1.046</td>
<td>tINS</td>
<td>RR</td>
<td>3385</td>
<td>IOB29[A]</td>
<td>clk_50m_ibuf/O</td>
</tr>
<tr>
<td>2.607</td>
<td>1.561</td>
<td>tNET</td>
<td>RR</td>
<td>1</td>
<td>R22C87[1][A]</td>
<td>imu/ready_s1/CLK</td>
</tr>
<tr>
<td>2.901</td>
<td>0.294</td>
<td>tC2Q</td>
<td>RF</td>
<td>277</td>
<td>R22C87[1][A]</td>
<td style=" font-weight:bold;">imu/ready_s1/Q</td>
</tr>
<tr>
<td>6.276</td>
<td>3.375</td>
<td>tNET</td>
<td>FF</td>
<td>1</td>
<td>R14C54[0][B]</td>
<td>fault_now_s1/I2</td>
</tr>
<tr>
<td>6.689</td>
<td>0.413</td>
<td>tINS</td>
<td>FR</td>
<td>9</td>
<td>R14C54[0][B]</td>
<td style=" background: #97FFFF;">fault_now_s1/F</td>
</tr>
<tr>
<td>7.748</td>
<td>1.059</td>
<td>tNET</td>
<td>RR</td>
<td>1</td>
<td>R22C48[0][B]</td>
<td>driver/inhibit_s1/I0</td>
</tr>
<tr>
<td>8.169</td>
<td>0.421</td>
<td>tINS</td>
<td>RR</td>
<td>125</td>
<td>R22C48[0][B]</td>
<td style=" background: #97FFFF;">driver/inhibit_s1/F</td>
</tr>
<tr>
<td>10.578</td>
<td>2.409</td>
<td>tNET</td>
<td>RR</td>
<td>1</td>
<td>R32C87[1][A]</td>
<td>driver/n14_s2/I2</td>
</tr>
<tr>
<td>10.890</td>
<td>0.312</td>
<td>tINS</td>
<td>RF</td>
<td>78</td>
<td>R32C87[1][A]</td>
<td style=" background: #97FFFF;">driver/n14_s2/F</td>
</tr>
<tr>
<td>12.561</td>
<td>1.671</td>
<td>tNET</td>
<td>FF</td>
<td>1</td>
<td>R32C79[1][A]</td>
<td style=" font-weight:bold;">driver/command_l_11_s0/CLEAR</td>
</tr>
</table>
<p><b>Data Required Path:</b></p>
<table class="detail_table">
<tr>
<th class="label">AT</th>
<th class="label">DELAY</th>
<th class="label">TYPE</th>
<th class="label">RF</th>
<th class="label">FANOUT</th>
<th class="label">LOC</th>
<th>NODE</th>
</tr>
<tr>
<td>20.000</td>
<td>20.000</td>
<td></td>
<td></td>
<td></td>
<td></td>
<td>active clock edge time</td>
</tr>
<tr>
<td>20.000</td>
<td>0.000</td>
<td></td>
<td></td>
<td></td>
<td></td>
<td>clk_50m</td>
</tr>
<tr>
<td>20.000</td>
<td>0.000</td>
<td>tCL</td>
<td>RR</td>
<td>1</td>
<td>IOB29[A]</td>
<td>clk_50m_ibuf/I</td>
</tr>
<tr>
<td>21.046</td>
<td>1.046</td>
<td>tINS</td>
<td>RR</td>
<td>3385</td>
<td>IOB29[A]</td>
<td>clk_50m_ibuf/O</td>
</tr>
<tr>
<td>22.574</td>
<td>1.528</td>
<td>tNET</td>
<td>RR</td>
<td>1</td>
<td>R32C79[1][A]</td>
<td>driver/command_l_11_s0/CLK</td>
</tr>
<tr>
<td>22.296</td>
<td>-0.278</td>
<td>tSu</td>
<td></td>
<td>1</td>
<td>R32C79[1][A]</td>
<td>driver/command_l_11_s0</td>
</tr>
</table>
<p><b>Path Statistics:</b></p>
<table class="summary_table">
<tr>
<td class="label">Clock Skew</td>
<td>-0.033</td>
</tr>
<tr>
<td class="label">Setup Relationship </td>
<td>20.000</td>
</tr>
<tr>
<td class="label">Logic Level</td>
<td>4</td>
</tr>
<tr>
<td class="label">Arrival Clock Path Delay</td>
<td>cell: 1.046, 40.123%; route: 1.561, 59.877%</td>
</tr>
<tr>
<td class="label">Arrival Data Path Delay</td>
<td>cell: 1.146, 11.513%; route: 8.514, 85.533%; tC2Q: 0.294, 2.954%</td>
</tr>
<tr>
<td class="label">Required Clock Path Delay</td>
<td>cell: 1.046, 40.633%; route: 1.528, 59.367%</td>
</tr>
</table>
<h3>Path3</h3>
<p><b>Path Summary:</b></p>
<table class="summary_table">
<tr>
<td class="label">Slack</td>
<td>9.735</td>
</tr>
<tr>
<td class="label">Data Arrival Time</td>
<td>12.561</td>
</tr>
<tr>
<td class="label">Data Required Time</td>
<td>22.296</td>
</tr>
<tr>
<td class="label">From</td>
<td>imu/ready_s1</td>
</tr>
<tr>
<td class="label">To</td>
<td>driver/command_l_12_s0</td>
</tr>
<tr>
<td class="label">Launch Clk</td>
<td>clk_50m:[R]</td>
</tr>
<tr>
<td class="label">Latch Clk</td>
<td>clk_50m:[R]</td>
</tr>
</table>
<p><b>Data Arrival Path:</b></p>
<table class="detail_table">
<tr>
<th class="label">AT</th>
<th class="label">DELAY</th>
<th class="label">TYPE</th>
<th class="label">RF</th>
<th class="label">FANOUT</th>
<th class="label">LOC</th>
<th>NODE</th>
</tr>
<tr>
<td>0.000</td>
<td>0.000</td>
<td></td>
<td></td>
<td></td>
<td></td>
<td>active clock edge time</td>
</tr>
<tr>
<td>0.000</td>
<td>0.000</td>
<td></td>
<td></td>
<td></td>
<td></td>
<td>clk_50m</td>
</tr>
<tr>
<td>0.000</td>
<td>0.000</td>
<td>tCL</td>
<td>RR</td>
<td>1</td>
<td>IOB29[A]</td>
<td>clk_50m_ibuf/I</td>
</tr>
<tr>
<td>1.046</td>
<td>1.046</td>
<td>tINS</td>
<td>RR</td>
<td>3385</td>
<td>IOB29[A]</td>
<td>clk_50m_ibuf/O</td>
</tr>
<tr>
<td>2.607</td>
<td>1.561</td>
<td>tNET</td>
<td>RR</td>
<td>1</td>
<td>R22C87[1][A]</td>
<td>imu/ready_s1/CLK</td>
</tr>
<tr>
<td>2.901</td>
<td>0.294</td>
<td>tC2Q</td>
<td>RF</td>
<td>277</td>
<td>R22C87[1][A]</td>
<td style=" font-weight:bold;">imu/ready_s1/Q</td>
</tr>
<tr>
<td>6.276</td>
<td>3.375</td>
<td>tNET</td>
<td>FF</td>
<td>1</td>
<td>R14C54[0][B]</td>
<td>fault_now_s1/I2</td>
</tr>
<tr>
<td>6.689</td>
<td>0.413</td>
<td>tINS</td>
<td>FR</td>
<td>9</td>
<td>R14C54[0][B]</td>
<td style=" background: #97FFFF;">fault_now_s1/F</td>
</tr>
<tr>
<td>7.748</td>
<td>1.059</td>
<td>tNET</td>
<td>RR</td>
<td>1</td>
<td>R22C48[0][B]</td>
<td>driver/inhibit_s1/I0</td>
</tr>
<tr>
<td>8.169</td>
<td>0.421</td>
<td>tINS</td>
<td>RR</td>
<td>125</td>
<td>R22C48[0][B]</td>
<td style=" background: #97FFFF;">driver/inhibit_s1/F</td>
</tr>
<tr>
<td>10.578</td>
<td>2.409</td>
<td>tNET</td>
<td>RR</td>
<td>1</td>
<td>R32C87[1][A]</td>
<td>driver/n14_s2/I2</td>
</tr>
<tr>
<td>10.890</td>
<td>0.312</td>
<td>tINS</td>
<td>RF</td>
<td>78</td>
<td>R32C87[1][A]</td>
<td style=" background: #97FFFF;">driver/n14_s2/F</td>
</tr>
<tr>
<td>12.561</td>
<td>1.671</td>
<td>tNET</td>
<td>FF</td>
<td>1</td>
<td>R32C79[2][B]</td>
<td style=" font-weight:bold;">driver/command_l_12_s0/CLEAR</td>
</tr>
</table>
<p><b>Data Required Path:</b></p>
<table class="detail_table">
<tr>
<th class="label">AT</th>
<th class="label">DELAY</th>
<th class="label">TYPE</th>
<th class="label">RF</th>
<th class="label">FANOUT</th>
<th class="label">LOC</th>
<th>NODE</th>
</tr>
<tr>
<td>20.000</td>
<td>20.000</td>
<td></td>
<td></td>
<td></td>
<td></td>
<td>active clock edge time</td>
</tr>
<tr>
<td>20.000</td>
<td>0.000</td>
<td></td>
<td></td>
<td></td>
<td></td>
<td>clk_50m</td>
</tr>
<tr>
<td>20.000</td>
<td>0.000</td>
<td>tCL</td>
<td>RR</td>
<td>1</td>
<td>IOB29[A]</td>
<td>clk_50m_ibuf/I</td>
</tr>
<tr>
<td>21.046</td>
<td>1.046</td>
<td>tINS</td>
<td>RR</td>
<td>3385</td>
<td>IOB29[A]</td>
<td>clk_50m_ibuf/O</td>
</tr>
<tr>
<td>22.574</td>
<td>1.528</td>
<td>tNET</td>
<td>RR</td>
<td>1</td>
<td>R32C79[2][B]</td>
<td>driver/command_l_12_s0/CLK</td>
</tr>
<tr>
<td>22.296</td>
<td>-0.278</td>
<td>tSu</td>
<td></td>
<td>1</td>
<td>R32C79[2][B]</td>
<td>driver/command_l_12_s0</td>
</tr>
</table>
<p><b>Path Statistics:</b></p>
<table class="summary_table">
<tr>
<td class="label">Clock Skew</td>
<td>-0.033</td>
</tr>
<tr>
<td class="label">Setup Relationship </td>
<td>20.000</td>
</tr>
<tr>
<td class="label">Logic Level</td>
<td>4</td>
</tr>
<tr>
<td class="label">Arrival Clock Path Delay</td>
<td>cell: 1.046, 40.123%; route: 1.561, 59.877%</td>
</tr>
<tr>
<td class="label">Arrival Data Path Delay</td>
<td>cell: 1.146, 11.513%; route: 8.514, 85.533%; tC2Q: 0.294, 2.954%</td>
</tr>
<tr>
<td class="label">Required Clock Path Delay</td>
<td>cell: 1.046, 40.633%; route: 1.528, 59.367%</td>
</tr>
</table>
<h3>Path4</h3>
<p><b>Path Summary:</b></p>
<table class="summary_table">
<tr>
<td class="label">Slack</td>
<td>9.735</td>
</tr>
<tr>
<td class="label">Data Arrival Time</td>
<td>12.561</td>
</tr>
<tr>
<td class="label">Data Required Time</td>
<td>22.296</td>
</tr>
<tr>
<td class="label">From</td>
<td>imu/ready_s1</td>
</tr>
<tr>
<td class="label">To</td>
<td>driver/command_l_13_s0</td>
</tr>
<tr>
<td class="label">Launch Clk</td>
<td>clk_50m:[R]</td>
</tr>
<tr>
<td class="label">Latch Clk</td>
<td>clk_50m:[R]</td>
</tr>
</table>
<p><b>Data Arrival Path:</b></p>
<table class="detail_table">
<tr>
<th class="label">AT</th>
<th class="label">DELAY</th>
<th class="label">TYPE</th>
<th class="label">RF</th>
<th class="label">FANOUT</th>
<th class="label">LOC</th>
<th>NODE</th>
</tr>
<tr>
<td>0.000</td>
<td>0.000</td>
<td></td>
<td></td>
<td></td>
<td></td>
<td>active clock edge time</td>
</tr>
<tr>
<td>0.000</td>
<td>0.000</td>
<td></td>
<td></td>
<td></td>
<td></td>
<td>clk_50m</td>
</tr>
<tr>
<td>0.000</td>
<td>0.000</td>
<td>tCL</td>
<td>RR</td>
<td>1</td>
<td>IOB29[A]</td>
<td>clk_50m_ibuf/I</td>
</tr>
<tr>
<td>1.046</td>
<td>1.046</td>
<td>tINS</td>
<td>RR</td>
<td>3385</td>
<td>IOB29[A]</td>
<td>clk_50m_ibuf/O</td>
</tr>
<tr>
<td>2.607</td>
<td>1.561</td>
<td>tNET</td>
<td>RR</td>
<td>1</td>
<td>R22C87[1][A]</td>
<td>imu/ready_s1/CLK</td>
</tr>
<tr>
<td>2.901</td>
<td>0.294</td>
<td>tC2Q</td>
<td>RF</td>
<td>277</td>
<td>R22C87[1][A]</td>
<td style=" font-weight:bold;">imu/ready_s1/Q</td>
</tr>
<tr>
<td>6.276</td>
<td>3.375</td>
<td>tNET</td>
<td>FF</td>
<td>1</td>
<td>R14C54[0][B]</td>
<td>fault_now_s1/I2</td>
</tr>
<tr>
<td>6.689</td>
<td>0.413</td>
<td>tINS</td>
<td>FR</td>
<td>9</td>
<td>R14C54[0][B]</td>
<td style=" background: #97FFFF;">fault_now_s1/F</td>
</tr>
<tr>
<td>7.748</td>
<td>1.059</td>
<td>tNET</td>
<td>RR</td>
<td>1</td>
<td>R22C48[0][B]</td>
<td>driver/inhibit_s1/I0</td>
</tr>
<tr>
<td>8.169</td>
<td>0.421</td>
<td>tINS</td>
<td>RR</td>
<td>125</td>
<td>R22C48[0][B]</td>
<td style=" background: #97FFFF;">driver/inhibit_s1/F</td>
</tr>
<tr>
<td>10.578</td>
<td>2.409</td>
<td>tNET</td>
<td>RR</td>
<td>1</td>
<td>R32C87[1][A]</td>
<td>driver/n14_s2/I2</td>
</tr>
<tr>
<td>10.890</td>
<td>0.312</td>
<td>tINS</td>
<td>RF</td>
<td>78</td>
<td>R32C87[1][A]</td>
<td style=" background: #97FFFF;">driver/n14_s2/F</td>
</tr>
<tr>
<td>12.561</td>
<td>1.671</td>
<td>tNET</td>
<td>FF</td>
<td>1</td>
<td>R32C79[3][A]</td>
<td style=" font-weight:bold;">driver/command_l_13_s0/CLEAR</td>
</tr>
</table>
<p><b>Data Required Path:</b></p>
<table class="detail_table">
<tr>
<th class="label">AT</th>
<th class="label">DELAY</th>
<th class="label">TYPE</th>
<th class="label">RF</th>
<th class="label">FANOUT</th>
<th class="label">LOC</th>
<th>NODE</th>
</tr>
<tr>
<td>20.000</td>
<td>20.000</td>
<td></td>
<td></td>
<td></td>
<td></td>
<td>active clock edge time</td>
</tr>
<tr>
<td>20.000</td>
<td>0.000</td>
<td></td>
<td></td>
<td></td>
<td></td>
<td>clk_50m</td>
</tr>
<tr>
<td>20.000</td>
<td>0.000</td>
<td>tCL</td>
<td>RR</td>
<td>1</td>
<td>IOB29[A]</td>
<td>clk_50m_ibuf/I</td>
</tr>
<tr>
<td>21.046</td>
<td>1.046</td>
<td>tINS</td>
<td>RR</td>
<td>3385</td>
<td>IOB29[A]</td>
<td>clk_50m_ibuf/O</td>
</tr>
<tr>
<td>22.574</td>
<td>1.528</td>
<td>tNET</td>
<td>RR</td>
<td>1</td>
<td>R32C79[3][A]</td>
<td>driver/command_l_13_s0/CLK</td>
</tr>
<tr>
<td>22.296</td>
<td>-0.278</td>
<td>tSu</td>
<td></td>
<td>1</td>
<td>R32C79[3][A]</td>
<td>driver/command_l_13_s0</td>
</tr>
</table>
<p><b>Path Statistics:</b></p>
<table class="summary_table">
<tr>
<td class="label">Clock Skew</td>
<td>-0.033</td>
</tr>
<tr>
<td class="label">Setup Relationship </td>
<td>20.000</td>
</tr>
<tr>
<td class="label">Logic Level</td>
<td>4</td>
</tr>
<tr>
<td class="label">Arrival Clock Path Delay</td>
<td>cell: 1.046, 40.123%; route: 1.561, 59.877%</td>
</tr>
<tr>
<td class="label">Arrival Data Path Delay</td>
<td>cell: 1.146, 11.513%; route: 8.514, 85.533%; tC2Q: 0.294, 2.954%</td>
</tr>
<tr>
<td class="label">Required Clock Path Delay</td>
<td>cell: 1.046, 40.633%; route: 1.528, 59.367%</td>
</tr>
</table>
<h3>Path5</h3>
<p><b>Path Summary:</b></p>
<table class="summary_table">
<tr>
<td class="label">Slack</td>
<td>9.735</td>
</tr>
<tr>
<td class="label">Data Arrival Time</td>
<td>12.561</td>
</tr>
<tr>
<td class="label">Data Required Time</td>
<td>22.296</td>
</tr>
<tr>
<td class="label">From</td>
<td>imu/ready_s1</td>
</tr>
<tr>
<td class="label">To</td>
<td>driver/command_l_14_s0</td>
</tr>
<tr>
<td class="label">Launch Clk</td>
<td>clk_50m:[R]</td>
</tr>
<tr>
<td class="label">Latch Clk</td>
<td>clk_50m:[R]</td>
</tr>
</table>
<p><b>Data Arrival Path:</b></p>
<table class="detail_table">
<tr>
<th class="label">AT</th>
<th class="label">DELAY</th>
<th class="label">TYPE</th>
<th class="label">RF</th>
<th class="label">FANOUT</th>
<th class="label">LOC</th>
<th>NODE</th>
</tr>
<tr>
<td>0.000</td>
<td>0.000</td>
<td></td>
<td></td>
<td></td>
<td></td>
<td>active clock edge time</td>
</tr>
<tr>
<td>0.000</td>
<td>0.000</td>
<td></td>
<td></td>
<td></td>
<td></td>
<td>clk_50m</td>
</tr>
<tr>
<td>0.000</td>
<td>0.000</td>
<td>tCL</td>
<td>RR</td>
<td>1</td>
<td>IOB29[A]</td>
<td>clk_50m_ibuf/I</td>
</tr>
<tr>
<td>1.046</td>
<td>1.046</td>
<td>tINS</td>
<td>RR</td>
<td>3385</td>
<td>IOB29[A]</td>
<td>clk_50m_ibuf/O</td>
</tr>
<tr>
<td>2.607</td>
<td>1.561</td>
<td>tNET</td>
<td>RR</td>
<td>1</td>
<td>R22C87[1][A]</td>
<td>imu/ready_s1/CLK</td>
</tr>
<tr>
<td>2.901</td>
<td>0.294</td>
<td>tC2Q</td>
<td>RF</td>
<td>277</td>
<td>R22C87[1][A]</td>
<td style=" font-weight:bold;">imu/ready_s1/Q</td>
</tr>
<tr>
<td>6.276</td>
<td>3.375</td>
<td>tNET</td>
<td>FF</td>
<td>1</td>
<td>R14C54[0][B]</td>
<td>fault_now_s1/I2</td>
</tr>
<tr>
<td>6.689</td>
<td>0.413</td>
<td>tINS</td>
<td>FR</td>
<td>9</td>
<td>R14C54[0][B]</td>
<td style=" background: #97FFFF;">fault_now_s1/F</td>
</tr>
<tr>
<td>7.748</td>
<td>1.059</td>
<td>tNET</td>
<td>RR</td>
<td>1</td>
<td>R22C48[0][B]</td>
<td>driver/inhibit_s1/I0</td>
</tr>
<tr>
<td>8.169</td>
<td>0.421</td>
<td>tINS</td>
<td>RR</td>
<td>125</td>
<td>R22C48[0][B]</td>
<td style=" background: #97FFFF;">driver/inhibit_s1/F</td>
</tr>
<tr>
<td>10.578</td>
<td>2.409</td>
<td>tNET</td>
<td>RR</td>
<td>1</td>
<td>R32C87[1][A]</td>
<td>driver/n14_s2/I2</td>
</tr>
<tr>
<td>10.890</td>
<td>0.312</td>
<td>tINS</td>
<td>RF</td>
<td>78</td>
<td>R32C87[1][A]</td>
<td style=" background: #97FFFF;">driver/n14_s2/F</td>
</tr>
<tr>
<td>12.561</td>
<td>1.671</td>
<td>tNET</td>
<td>FF</td>
<td>1</td>
<td>R32C79[2][A]</td>
<td style=" font-weight:bold;">driver/command_l_14_s0/CLEAR</td>
</tr>
</table>
<p><b>Data Required Path:</b></p>
<table class="detail_table">
<tr>
<th class="label">AT</th>
<th class="label">DELAY</th>
<th class="label">TYPE</th>
<th class="label">RF</th>
<th class="label">FANOUT</th>
<th class="label">LOC</th>
<th>NODE</th>
</tr>
<tr>
<td>20.000</td>
<td>20.000</td>
<td></td>
<td></td>
<td></td>
<td></td>
<td>active clock edge time</td>
</tr>
<tr>
<td>20.000</td>
<td>0.000</td>
<td></td>
<td></td>
<td></td>
<td></td>
<td>clk_50m</td>
</tr>
<tr>
<td>20.000</td>
<td>0.000</td>
<td>tCL</td>
<td>RR</td>
<td>1</td>
<td>IOB29[A]</td>
<td>clk_50m_ibuf/I</td>
</tr>
<tr>
<td>21.046</td>
<td>1.046</td>
<td>tINS</td>
<td>RR</td>
<td>3385</td>
<td>IOB29[A]</td>
<td>clk_50m_ibuf/O</td>
</tr>
<tr>
<td>22.574</td>
<td>1.528</td>
<td>tNET</td>
<td>RR</td>
<td>1</td>
<td>R32C79[2][A]</td>
<td>driver/command_l_14_s0/CLK</td>
</tr>
<tr>
<td>22.296</td>
<td>-0.278</td>
<td>tSu</td>
<td></td>
<td>1</td>
<td>R32C79[2][A]</td>
<td>driver/command_l_14_s0</td>
</tr>
</table>
<p><b>Path Statistics:</b></p>
<table class="summary_table">
<tr>
<td class="label">Clock Skew</td>
<td>-0.033</td>
</tr>
<tr>
<td class="label">Setup Relationship </td>
<td>20.000</td>
</tr>
<tr>
<td class="label">Logic Level</td>
<td>4</td>
</tr>
<tr>
<td class="label">Arrival Clock Path Delay</td>
<td>cell: 1.046, 40.123%; route: 1.561, 59.877%</td>
</tr>
<tr>
<td class="label">Arrival Data Path Delay</td>
<td>cell: 1.146, 11.513%; route: 8.514, 85.533%; tC2Q: 0.294, 2.954%</td>
</tr>
<tr>
<td class="label">Required Clock Path Delay</td>
<td>cell: 1.046, 40.633%; route: 1.528, 59.367%</td>
</tr>
</table>
<h3>Path6</h3>
<p><b>Path Summary:</b></p>
<table class="summary_table">
<tr>
<td class="label">Slack</td>
<td>9.738</td>
</tr>
<tr>
<td class="label">Data Arrival Time</td>
<td>12.567</td>
</tr>
<tr>
<td class="label">Data Required Time</td>
<td>22.305</td>
</tr>
<tr>
<td class="label">From</td>
<td>imu/ready_s1</td>
</tr>
<tr>
<td class="label">To</td>
<td>driver/left_channel/remaining_0_s1</td>
</tr>
<tr>
<td class="label">Launch Clk</td>
<td>clk_50m:[R]</td>
</tr>
<tr>
<td class="label">Latch Clk</td>
<td>clk_50m:[R]</td>
</tr>
</table>
<p><b>Data Arrival Path:</b></p>
<table class="detail_table">
<tr>
<th class="label">AT</th>
<th class="label">DELAY</th>
<th class="label">TYPE</th>
<th class="label">RF</th>
<th class="label">FANOUT</th>
<th class="label">LOC</th>
<th>NODE</th>
</tr>
<tr>
<td>0.000</td>
<td>0.000</td>
<td></td>
<td></td>
<td></td>
<td></td>
<td>active clock edge time</td>
</tr>
<tr>
<td>0.000</td>
<td>0.000</td>
<td></td>
<td></td>
<td></td>
<td></td>
<td>clk_50m</td>
</tr>
<tr>
<td>0.000</td>
<td>0.000</td>
<td>tCL</td>
<td>RR</td>
<td>1</td>
<td>IOB29[A]</td>
<td>clk_50m_ibuf/I</td>
</tr>
<tr>
<td>1.046</td>
<td>1.046</td>
<td>tINS</td>
<td>RR</td>
<td>3385</td>
<td>IOB29[A]</td>
<td>clk_50m_ibuf/O</td>
</tr>
<tr>
<td>2.607</td>
<td>1.561</td>
<td>tNET</td>
<td>RR</td>
<td>1</td>
<td>R22C87[1][A]</td>
<td>imu/ready_s1/CLK</td>
</tr>
<tr>
<td>2.901</td>
<td>0.294</td>
<td>tC2Q</td>
<td>RF</td>
<td>277</td>
<td>R22C87[1][A]</td>
<td style=" font-weight:bold;">imu/ready_s1/Q</td>
</tr>
<tr>
<td>6.276</td>
<td>3.375</td>
<td>tNET</td>
<td>FF</td>
<td>1</td>
<td>R14C54[0][B]</td>
<td>fault_now_s1/I2</td>
</tr>
<tr>
<td>6.689</td>
<td>0.413</td>
<td>tINS</td>
<td>FR</td>
<td>9</td>
<td>R14C54[0][B]</td>
<td style=" background: #97FFFF;">fault_now_s1/F</td>
</tr>
<tr>
<td>7.748</td>
<td>1.059</td>
<td>tNET</td>
<td>RR</td>
<td>1</td>
<td>R22C48[0][B]</td>
<td>driver/inhibit_s1/I0</td>
</tr>
<tr>
<td>8.169</td>
<td>0.421</td>
<td>tINS</td>
<td>RR</td>
<td>125</td>
<td>R22C48[0][B]</td>
<td style=" background: #97FFFF;">driver/inhibit_s1/F</td>
</tr>
<tr>
<td>10.578</td>
<td>2.409</td>
<td>tNET</td>
<td>RR</td>
<td>1</td>
<td>R32C87[1][A]</td>
<td>driver/n14_s2/I2</td>
</tr>
<tr>
<td>10.890</td>
<td>0.312</td>
<td>tINS</td>
<td>RF</td>
<td>78</td>
<td>R32C87[1][A]</td>
<td style=" background: #97FFFF;">driver/n14_s2/F</td>
</tr>
<tr>
<td>12.567</td>
<td>1.677</td>
<td>tNET</td>
<td>FF</td>
<td>1</td>
<td>R36C83[1][A]</td>
<td style=" font-weight:bold;">driver/left_channel/remaining_0_s1/CLEAR</td>
</tr>
</table>
<p><b>Data Required Path:</b></p>
<table class="detail_table">
<tr>
<th class="label">AT</th>
<th class="label">DELAY</th>
<th class="label">TYPE</th>
<th class="label">RF</th>
<th class="label">FANOUT</th>
<th class="label">LOC</th>
<th>NODE</th>
</tr>
<tr>
<td>20.000</td>
<td>20.000</td>
<td></td>
<td></td>
<td></td>
<td></td>
<td>active clock edge time</td>
</tr>
<tr>
<td>20.000</td>
<td>0.000</td>
<td></td>
<td></td>
<td></td>
<td></td>
<td>clk_50m</td>
</tr>
<tr>
<td>20.000</td>
<td>0.000</td>
<td>tCL</td>
<td>RR</td>
<td>1</td>
<td>IOB29[A]</td>
<td>clk_50m_ibuf/I</td>
</tr>
<tr>
<td>21.046</td>
<td>1.046</td>
<td>tINS</td>
<td>RR</td>
<td>3385</td>
<td>IOB29[A]</td>
<td>clk_50m_ibuf/O</td>
</tr>
<tr>
<td>22.583</td>
<td>1.538</td>
<td>tNET</td>
<td>RR</td>
<td>1</td>
<td>R36C83[1][A]</td>
<td>driver/left_channel/remaining_0_s1/CLK</td>
</tr>
<tr>
<td>22.305</td>
<td>-0.278</td>
<td>tSu</td>
<td></td>
<td>1</td>
<td>R36C83[1][A]</td>
<td>driver/left_channel/remaining_0_s1</td>
</tr>
</table>
<p><b>Path Statistics:</b></p>
<table class="summary_table">
<tr>
<td class="label">Clock Skew</td>
<td>-0.023</td>
</tr>
<tr>
<td class="label">Setup Relationship </td>
<td>20.000</td>
</tr>
<tr>
<td class="label">Logic Level</td>
<td>4</td>
</tr>
<tr>
<td class="label">Arrival Clock Path Delay</td>
<td>cell: 1.046, 40.123%; route: 1.561, 59.877%</td>
</tr>
<tr>
<td class="label">Arrival Data Path Delay</td>
<td>cell: 1.146, 11.506%; route: 8.520, 85.542%; tC2Q: 0.294, 2.952%</td>
</tr>
<tr>
<td class="label">Required Clock Path Delay</td>
<td>cell: 1.046, 40.488%; route: 1.538, 59.512%</td>
</tr>
</table>
<h3>Path7</h3>
<p><b>Path Summary:</b></p>
<table class="summary_table">
<tr>
<td class="label">Slack</td>
<td>9.738</td>
</tr>
<tr>
<td class="label">Data Arrival Time</td>
<td>12.567</td>
</tr>
<tr>
<td class="label">Data Required Time</td>
<td>22.305</td>
</tr>
<tr>
<td class="label">From</td>
<td>imu/ready_s1</td>
</tr>
<tr>
<td class="label">To</td>
<td>driver/left_channel/remaining_2_s1</td>
</tr>
<tr>
<td class="label">Launch Clk</td>
<td>clk_50m:[R]</td>
</tr>
<tr>
<td class="label">Latch Clk</td>
<td>clk_50m:[R]</td>
</tr>
</table>
<p><b>Data Arrival Path:</b></p>
<table class="detail_table">
<tr>
<th class="label">AT</th>
<th class="label">DELAY</th>
<th class="label">TYPE</th>
<th class="label">RF</th>
<th class="label">FANOUT</th>
<th class="label">LOC</th>
<th>NODE</th>
</tr>
<tr>
<td>0.000</td>
<td>0.000</td>
<td></td>
<td></td>
<td></td>
<td></td>
<td>active clock edge time</td>
</tr>
<tr>
<td>0.000</td>
<td>0.000</td>
<td></td>
<td></td>
<td></td>
<td></td>
<td>clk_50m</td>
</tr>
<tr>
<td>0.000</td>
<td>0.000</td>
<td>tCL</td>
<td>RR</td>
<td>1</td>
<td>IOB29[A]</td>
<td>clk_50m_ibuf/I</td>
</tr>
<tr>
<td>1.046</td>
<td>1.046</td>
<td>tINS</td>
<td>RR</td>
<td>3385</td>
<td>IOB29[A]</td>
<td>clk_50m_ibuf/O</td>
</tr>
<tr>
<td>2.607</td>
<td>1.561</td>
<td>tNET</td>
<td>RR</td>
<td>1</td>
<td>R22C87[1][A]</td>
<td>imu/ready_s1/CLK</td>
</tr>
<tr>
<td>2.901</td>
<td>0.294</td>
<td>tC2Q</td>
<td>RF</td>
<td>277</td>
<td>R22C87[1][A]</td>
<td style=" font-weight:bold;">imu/ready_s1/Q</td>
</tr>
<tr>
<td>6.276</td>
<td>3.375</td>
<td>tNET</td>
<td>FF</td>
<td>1</td>
<td>R14C54[0][B]</td>
<td>fault_now_s1/I2</td>
</tr>
<tr>
<td>6.689</td>
<td>0.413</td>
<td>tINS</td>
<td>FR</td>
<td>9</td>
<td>R14C54[0][B]</td>
<td style=" background: #97FFFF;">fault_now_s1/F</td>
</tr>
<tr>
<td>7.748</td>
<td>1.059</td>
<td>tNET</td>
<td>RR</td>
<td>1</td>
<td>R22C48[0][B]</td>
<td>driver/inhibit_s1/I0</td>
</tr>
<tr>
<td>8.169</td>
<td>0.421</td>
<td>tINS</td>
<td>RR</td>
<td>125</td>
<td>R22C48[0][B]</td>
<td style=" background: #97FFFF;">driver/inhibit_s1/F</td>
</tr>
<tr>
<td>10.578</td>
<td>2.409</td>
<td>tNET</td>
<td>RR</td>
<td>1</td>
<td>R32C87[1][A]</td>
<td>driver/n14_s2/I2</td>
</tr>
<tr>
<td>10.890</td>
<td>0.312</td>
<td>tINS</td>
<td>RF</td>
<td>78</td>
<td>R32C87[1][A]</td>
<td style=" background: #97FFFF;">driver/n14_s2/F</td>
</tr>
<tr>
<td>12.567</td>
<td>1.677</td>
<td>tNET</td>
<td>FF</td>
<td>1</td>
<td>R36C83[1][B]</td>
<td style=" font-weight:bold;">driver/left_channel/remaining_2_s1/CLEAR</td>
</tr>
</table>
<p><b>Data Required Path:</b></p>
<table class="detail_table">
<tr>
<th class="label">AT</th>
<th class="label">DELAY</th>
<th class="label">TYPE</th>
<th class="label">RF</th>
<th class="label">FANOUT</th>
<th class="label">LOC</th>
<th>NODE</th>
</tr>
<tr>
<td>20.000</td>
<td>20.000</td>
<td></td>
<td></td>
<td></td>
<td></td>
<td>active clock edge time</td>
</tr>
<tr>
<td>20.000</td>
<td>0.000</td>
<td></td>
<td></td>
<td></td>
<td></td>
<td>clk_50m</td>
</tr>
<tr>
<td>20.000</td>
<td>0.000</td>
<td>tCL</td>
<td>RR</td>
<td>1</td>
<td>IOB29[A]</td>
<td>clk_50m_ibuf/I</td>
</tr>
<tr>
<td>21.046</td>
<td>1.046</td>
<td>tINS</td>
<td>RR</td>
<td>3385</td>
<td>IOB29[A]</td>
<td>clk_50m_ibuf/O</td>
</tr>
<tr>
<td>22.583</td>
<td>1.538</td>
<td>tNET</td>
<td>RR</td>
<td>1</td>
<td>R36C83[1][B]</td>
<td>driver/left_channel/remaining_2_s1/CLK</td>
</tr>
<tr>
<td>22.305</td>
<td>-0.278</td>
<td>tSu</td>
<td></td>
<td>1</td>
<td>R36C83[1][B]</td>
<td>driver/left_channel/remaining_2_s1</td>
</tr>
</table>
<p><b>Path Statistics:</b></p>
<table class="summary_table">
<tr>
<td class="label">Clock Skew</td>
<td>-0.023</td>
</tr>
<tr>
<td class="label">Setup Relationship </td>
<td>20.000</td>
</tr>
<tr>
<td class="label">Logic Level</td>
<td>4</td>
</tr>
<tr>
<td class="label">Arrival Clock Path Delay</td>
<td>cell: 1.046, 40.123%; route: 1.561, 59.877%</td>
</tr>
<tr>
<td class="label">Arrival Data Path Delay</td>
<td>cell: 1.146, 11.506%; route: 8.520, 85.542%; tC2Q: 0.294, 2.952%</td>
</tr>
<tr>
<td class="label">Required Clock Path Delay</td>
<td>cell: 1.046, 40.488%; route: 1.538, 59.512%</td>
</tr>
</table>
<h3>Path8</h3>
<p><b>Path Summary:</b></p>
<table class="summary_table">
<tr>
<td class="label">Slack</td>
<td>9.738</td>
</tr>
<tr>
<td class="label">Data Arrival Time</td>
<td>12.567</td>
</tr>
<tr>
<td class="label">Data Required Time</td>
<td>22.305</td>
</tr>
<tr>
<td class="label">From</td>
<td>imu/ready_s1</td>
</tr>
<tr>
<td class="label">To</td>
<td>driver/left_channel/remaining_8_s1</td>
</tr>
<tr>
<td class="label">Launch Clk</td>
<td>clk_50m:[R]</td>
</tr>
<tr>
<td class="label">Latch Clk</td>
<td>clk_50m:[R]</td>
</tr>
</table>
<p><b>Data Arrival Path:</b></p>
<table class="detail_table">
<tr>
<th class="label">AT</th>
<th class="label">DELAY</th>
<th class="label">TYPE</th>
<th class="label">RF</th>
<th class="label">FANOUT</th>
<th class="label">LOC</th>
<th>NODE</th>
</tr>
<tr>
<td>0.000</td>
<td>0.000</td>
<td></td>
<td></td>
<td></td>
<td></td>
<td>active clock edge time</td>
</tr>
<tr>
<td>0.000</td>
<td>0.000</td>
<td></td>
<td></td>
<td></td>
<td></td>
<td>clk_50m</td>
</tr>
<tr>
<td>0.000</td>
<td>0.000</td>
<td>tCL</td>
<td>RR</td>
<td>1</td>
<td>IOB29[A]</td>
<td>clk_50m_ibuf/I</td>
</tr>
<tr>
<td>1.046</td>
<td>1.046</td>
<td>tINS</td>
<td>RR</td>
<td>3385</td>
<td>IOB29[A]</td>
<td>clk_50m_ibuf/O</td>
</tr>
<tr>
<td>2.607</td>
<td>1.561</td>
<td>tNET</td>
<td>RR</td>
<td>1</td>
<td>R22C87[1][A]</td>
<td>imu/ready_s1/CLK</td>
</tr>
<tr>
<td>2.901</td>
<td>0.294</td>
<td>tC2Q</td>
<td>RF</td>
<td>277</td>
<td>R22C87[1][A]</td>
<td style=" font-weight:bold;">imu/ready_s1/Q</td>
</tr>
<tr>
<td>6.276</td>
<td>3.375</td>
<td>tNET</td>
<td>FF</td>
<td>1</td>
<td>R14C54[0][B]</td>
<td>fault_now_s1/I2</td>
</tr>
<tr>
<td>6.689</td>
<td>0.413</td>
<td>tINS</td>
<td>FR</td>
<td>9</td>
<td>R14C54[0][B]</td>
<td style=" background: #97FFFF;">fault_now_s1/F</td>
</tr>
<tr>
<td>7.748</td>
<td>1.059</td>
<td>tNET</td>
<td>RR</td>
<td>1</td>
<td>R22C48[0][B]</td>
<td>driver/inhibit_s1/I0</td>
</tr>
<tr>
<td>8.169</td>
<td>0.421</td>
<td>tINS</td>
<td>RR</td>
<td>125</td>
<td>R22C48[0][B]</td>
<td style=" background: #97FFFF;">driver/inhibit_s1/F</td>
</tr>
<tr>
<td>10.578</td>
<td>2.409</td>
<td>tNET</td>
<td>RR</td>
<td>1</td>
<td>R32C87[1][A]</td>
<td>driver/n14_s2/I2</td>
</tr>
<tr>
<td>10.890</td>
<td>0.312</td>
<td>tINS</td>
<td>RF</td>
<td>78</td>
<td>R32C87[1][A]</td>
<td style=" background: #97FFFF;">driver/n14_s2/F</td>
</tr>
<tr>
<td>12.567</td>
<td>1.677</td>
<td>tNET</td>
<td>FF</td>
<td>1</td>
<td>R36C83[0][A]</td>
<td style=" font-weight:bold;">driver/left_channel/remaining_8_s1/CLEAR</td>
</tr>
</table>
<p><b>Data Required Path:</b></p>
<table class="detail_table">
<tr>
<th class="label">AT</th>
<th class="label">DELAY</th>
<th class="label">TYPE</th>
<th class="label">RF</th>
<th class="label">FANOUT</th>
<th class="label">LOC</th>
<th>NODE</th>
</tr>
<tr>
<td>20.000</td>
<td>20.000</td>
<td></td>
<td></td>
<td></td>
<td></td>
<td>active clock edge time</td>
</tr>
<tr>
<td>20.000</td>
<td>0.000</td>
<td></td>
<td></td>
<td></td>
<td></td>
<td>clk_50m</td>
</tr>
<tr>
<td>20.000</td>
<td>0.000</td>
<td>tCL</td>
<td>RR</td>
<td>1</td>
<td>IOB29[A]</td>
<td>clk_50m_ibuf/I</td>
</tr>
<tr>
<td>21.046</td>
<td>1.046</td>
<td>tINS</td>
<td>RR</td>
<td>3385</td>
<td>IOB29[A]</td>
<td>clk_50m_ibuf/O</td>
</tr>
<tr>
<td>22.583</td>
<td>1.538</td>
<td>tNET</td>
<td>RR</td>
<td>1</td>
<td>R36C83[0][A]</td>
<td>driver/left_channel/remaining_8_s1/CLK</td>
</tr>
<tr>
<td>22.305</td>
<td>-0.278</td>
<td>tSu</td>
<td></td>
<td>1</td>
<td>R36C83[0][A]</td>
<td>driver/left_channel/remaining_8_s1</td>
</tr>
</table>
<p><b>Path Statistics:</b></p>
<table class="summary_table">
<tr>
<td class="label">Clock Skew</td>
<td>-0.023</td>
</tr>
<tr>
<td class="label">Setup Relationship </td>
<td>20.000</td>
</tr>
<tr>
<td class="label">Logic Level</td>
<td>4</td>
</tr>
<tr>
<td class="label">Arrival Clock Path Delay</td>
<td>cell: 1.046, 40.123%; route: 1.561, 59.877%</td>
</tr>
<tr>
<td class="label">Arrival Data Path Delay</td>
<td>cell: 1.146, 11.506%; route: 8.520, 85.542%; tC2Q: 0.294, 2.952%</td>
</tr>
<tr>
<td class="label">Required Clock Path Delay</td>
<td>cell: 1.046, 40.488%; route: 1.538, 59.512%</td>
</tr>
</table>
<h3>Path9</h3>
<p><b>Path Summary:</b></p>
<table class="summary_table">
<tr>
<td class="label">Slack</td>
<td>9.738</td>
</tr>
<tr>
<td class="label">Data Arrival Time</td>
<td>12.567</td>
</tr>
<tr>
<td class="label">Data Required Time</td>
<td>22.305</td>
</tr>
<tr>
<td class="label">From</td>
<td>imu/ready_s1</td>
</tr>
<tr>
<td class="label">To</td>
<td>driver/left_channel/remaining_11_s1</td>
</tr>
<tr>
<td class="label">Launch Clk</td>
<td>clk_50m:[R]</td>
</tr>
<tr>
<td class="label">Latch Clk</td>
<td>clk_50m:[R]</td>
</tr>
</table>
<p><b>Data Arrival Path:</b></p>
<table class="detail_table">
<tr>
<th class="label">AT</th>
<th class="label">DELAY</th>
<th class="label">TYPE</th>
<th class="label">RF</th>
<th class="label">FANOUT</th>
<th class="label">LOC</th>
<th>NODE</th>
</tr>
<tr>
<td>0.000</td>
<td>0.000</td>
<td></td>
<td></td>
<td></td>
<td></td>
<td>active clock edge time</td>
</tr>
<tr>
<td>0.000</td>
<td>0.000</td>
<td></td>
<td></td>
<td></td>
<td></td>
<td>clk_50m</td>
</tr>
<tr>
<td>0.000</td>
<td>0.000</td>
<td>tCL</td>
<td>RR</td>
<td>1</td>
<td>IOB29[A]</td>
<td>clk_50m_ibuf/I</td>
</tr>
<tr>
<td>1.046</td>
<td>1.046</td>
<td>tINS</td>
<td>RR</td>
<td>3385</td>
<td>IOB29[A]</td>
<td>clk_50m_ibuf/O</td>
</tr>
<tr>
<td>2.607</td>
<td>1.561</td>
<td>tNET</td>
<td>RR</td>
<td>1</td>
<td>R22C87[1][A]</td>
<td>imu/ready_s1/CLK</td>
</tr>
<tr>
<td>2.901</td>
<td>0.294</td>
<td>tC2Q</td>
<td>RF</td>
<td>277</td>
<td>R22C87[1][A]</td>
<td style=" font-weight:bold;">imu/ready_s1/Q</td>
</tr>
<tr>
<td>6.276</td>
<td>3.375</td>
<td>tNET</td>
<td>FF</td>
<td>1</td>
<td>R14C54[0][B]</td>
<td>fault_now_s1/I2</td>
</tr>
<tr>
<td>6.689</td>
<td>0.413</td>
<td>tINS</td>
<td>FR</td>
<td>9</td>
<td>R14C54[0][B]</td>
<td style=" background: #97FFFF;">fault_now_s1/F</td>
</tr>
<tr>
<td>7.748</td>
<td>1.059</td>
<td>tNET</td>
<td>RR</td>
<td>1</td>
<td>R22C48[0][B]</td>
<td>driver/inhibit_s1/I0</td>
</tr>
<tr>
<td>8.169</td>
<td>0.421</td>
<td>tINS</td>
<td>RR</td>
<td>125</td>
<td>R22C48[0][B]</td>
<td style=" background: #97FFFF;">driver/inhibit_s1/F</td>
</tr>
<tr>
<td>10.578</td>
<td>2.409</td>
<td>tNET</td>
<td>RR</td>
<td>1</td>
<td>R32C87[1][A]</td>
<td>driver/n14_s2/I2</td>
</tr>
<tr>
<td>10.890</td>
<td>0.312</td>
<td>tINS</td>
<td>RF</td>
<td>78</td>
<td>R32C87[1][A]</td>
<td style=" background: #97FFFF;">driver/n14_s2/F</td>
</tr>
<tr>
<td>12.567</td>
<td>1.677</td>
<td>tNET</td>
<td>FF</td>
<td>1</td>
<td>R36C83[0][B]</td>
<td style=" font-weight:bold;">driver/left_channel/remaining_11_s1/CLEAR</td>
</tr>
</table>
<p><b>Data Required Path:</b></p>
<table class="detail_table">
<tr>
<th class="label">AT</th>
<th class="label">DELAY</th>
<th class="label">TYPE</th>
<th class="label">RF</th>
<th class="label">FANOUT</th>
<th class="label">LOC</th>
<th>NODE</th>
</tr>
<tr>
<td>20.000</td>
<td>20.000</td>
<td></td>
<td></td>
<td></td>
<td></td>
<td>active clock edge time</td>
</tr>
<tr>
<td>20.000</td>
<td>0.000</td>
<td></td>
<td></td>
<td></td>
<td></td>
<td>clk_50m</td>
</tr>
<tr>
<td>20.000</td>
<td>0.000</td>
<td>tCL</td>
<td>RR</td>
<td>1</td>
<td>IOB29[A]</td>
<td>clk_50m_ibuf/I</td>
</tr>
<tr>
<td>21.046</td>
<td>1.046</td>
<td>tINS</td>
<td>RR</td>
<td>3385</td>
<td>IOB29[A]</td>
<td>clk_50m_ibuf/O</td>
</tr>
<tr>
<td>22.583</td>
<td>1.538</td>
<td>tNET</td>
<td>RR</td>
<td>1</td>
<td>R36C83[0][B]</td>
<td>driver/left_channel/remaining_11_s1/CLK</td>
</tr>
<tr>
<td>22.305</td>
<td>-0.278</td>
<td>tSu</td>
<td></td>
<td>1</td>
<td>R36C83[0][B]</td>
<td>driver/left_channel/remaining_11_s1</td>
</tr>
</table>
<p><b>Path Statistics:</b></p>
<table class="summary_table">
<tr>
<td class="label">Clock Skew</td>
<td>-0.023</td>
</tr>
<tr>
<td class="label">Setup Relationship </td>
<td>20.000</td>
</tr>
<tr>
<td class="label">Logic Level</td>
<td>4</td>
</tr>
<tr>
<td class="label">Arrival Clock Path Delay</td>
<td>cell: 1.046, 40.123%; route: 1.561, 59.877%</td>
</tr>
<tr>
<td class="label">Arrival Data Path Delay</td>
<td>cell: 1.146, 11.506%; route: 8.520, 85.542%; tC2Q: 0.294, 2.952%</td>
</tr>
<tr>
<td class="label">Required Clock Path Delay</td>
<td>cell: 1.046, 40.488%; route: 1.538, 59.512%</td>
</tr>
</table>
<h3>Path10</h3>
<p><b>Path Summary:</b></p>
<table class="summary_table">
<tr>
<td class="label">Slack</td>
<td>9.739</td>
</tr>
<tr>
<td class="label">Data Arrival Time</td>
<td>12.565</td>
</tr>
<tr>
<td class="label">Data Required Time</td>
<td>22.304</td>
</tr>
<tr>
<td class="label">From</td>
<td>imu/ready_s1</td>
</tr>
<tr>
<td class="label">To</td>
<td>driver/left_channel/remaining_1_s1</td>
</tr>
<tr>
<td class="label">Launch Clk</td>
<td>clk_50m:[R]</td>
</tr>
<tr>
<td class="label">Latch Clk</td>
<td>clk_50m:[R]</td>
</tr>
</table>
<p><b>Data Arrival Path:</b></p>
<table class="detail_table">
<tr>
<th class="label">AT</th>
<th class="label">DELAY</th>
<th class="label">TYPE</th>
<th class="label">RF</th>
<th class="label">FANOUT</th>
<th class="label">LOC</th>
<th>NODE</th>
</tr>
<tr>
<td>0.000</td>
<td>0.000</td>
<td></td>
<td></td>
<td></td>
<td></td>
<td>active clock edge time</td>
</tr>
<tr>
<td>0.000</td>
<td>0.000</td>
<td></td>
<td></td>
<td></td>
<td></td>
<td>clk_50m</td>
</tr>
<tr>
<td>0.000</td>
<td>0.000</td>
<td>tCL</td>
<td>RR</td>
<td>1</td>
<td>IOB29[A]</td>
<td>clk_50m_ibuf/I</td>
</tr>
<tr>
<td>1.046</td>
<td>1.046</td>
<td>tINS</td>
<td>RR</td>
<td>3385</td>
<td>IOB29[A]</td>
<td>clk_50m_ibuf/O</td>
</tr>
<tr>
<td>2.607</td>
<td>1.561</td>
<td>tNET</td>
<td>RR</td>
<td>1</td>
<td>R22C87[1][A]</td>
<td>imu/ready_s1/CLK</td>
</tr>
<tr>
<td>2.901</td>
<td>0.294</td>
<td>tC2Q</td>
<td>RF</td>
<td>277</td>
<td>R22C87[1][A]</td>
<td style=" font-weight:bold;">imu/ready_s1/Q</td>
</tr>
<tr>
<td>6.276</td>
<td>3.375</td>
<td>tNET</td>
<td>FF</td>
<td>1</td>
<td>R14C54[0][B]</td>
<td>fault_now_s1/I2</td>
</tr>
<tr>
<td>6.689</td>
<td>0.413</td>
<td>tINS</td>
<td>FR</td>
<td>9</td>
<td>R14C54[0][B]</td>
<td style=" background: #97FFFF;">fault_now_s1/F</td>
</tr>
<tr>
<td>7.748</td>
<td>1.059</td>
<td>tNET</td>
<td>RR</td>
<td>1</td>
<td>R22C48[0][B]</td>
<td>driver/inhibit_s1/I0</td>
</tr>
<tr>
<td>8.169</td>
<td>0.421</td>
<td>tINS</td>
<td>RR</td>
<td>125</td>
<td>R22C48[0][B]</td>
<td style=" background: #97FFFF;">driver/inhibit_s1/F</td>
</tr>
<tr>
<td>10.578</td>
<td>2.409</td>
<td>tNET</td>
<td>RR</td>
<td>1</td>
<td>R32C87[1][A]</td>
<td>driver/n14_s2/I2</td>
</tr>
<tr>
<td>10.890</td>
<td>0.312</td>
<td>tINS</td>
<td>RF</td>
<td>78</td>
<td>R32C87[1][A]</td>
<td style=" background: #97FFFF;">driver/n14_s2/F</td>
</tr>
<tr>
<td>12.565</td>
<td>1.675</td>
<td>tNET</td>
<td>FF</td>
<td>1</td>
<td>R35C83[0][B]</td>
<td style=" font-weight:bold;">driver/left_channel/remaining_1_s1/CLEAR</td>
</tr>
</table>
<p><b>Data Required Path:</b></p>
<table class="detail_table">
<tr>
<th class="label">AT</th>
<th class="label">DELAY</th>
<th class="label">TYPE</th>
<th class="label">RF</th>
<th class="label">FANOUT</th>
<th class="label">LOC</th>
<th>NODE</th>
</tr>
<tr>
<td>20.000</td>
<td>20.000</td>
<td></td>
<td></td>
<td></td>
<td></td>
<td>active clock edge time</td>
</tr>
<tr>
<td>20.000</td>
<td>0.000</td>
<td></td>
<td></td>
<td></td>
<td></td>
<td>clk_50m</td>
</tr>
<tr>
<td>20.000</td>
<td>0.000</td>
<td>tCL</td>
<td>RR</td>
<td>1</td>
<td>IOB29[A]</td>
<td>clk_50m_ibuf/I</td>
</tr>
<tr>
<td>21.046</td>
<td>1.046</td>
<td>tINS</td>
<td>RR</td>
<td>3385</td>
<td>IOB29[A]</td>
<td>clk_50m_ibuf/O</td>
</tr>
<tr>
<td>22.582</td>
<td>1.536</td>
<td>tNET</td>
<td>RR</td>
<td>1</td>
<td>R35C83[0][B]</td>
<td>driver/left_channel/remaining_1_s1/CLK</td>
</tr>
<tr>
<td>22.304</td>
<td>-0.278</td>
<td>tSu</td>
<td></td>
<td>1</td>
<td>R35C83[0][B]</td>
<td>driver/left_channel/remaining_1_s1</td>
</tr>
</table>
<p><b>Path Statistics:</b></p>
<table class="summary_table">
<tr>
<td class="label">Clock Skew</td>
<td>-0.025</td>
</tr>
<tr>
<td class="label">Setup Relationship </td>
<td>20.000</td>
</tr>
<tr>
<td class="label">Logic Level</td>
<td>4</td>
</tr>
<tr>
<td class="label">Arrival Clock Path Delay</td>
<td>cell: 1.046, 40.123%; route: 1.561, 59.877%</td>
</tr>
<tr>
<td class="label">Arrival Data Path Delay</td>
<td>cell: 1.146, 11.508%; route: 8.519, 85.540%; tC2Q: 0.294, 2.952%</td>
</tr>
<tr>
<td class="label">Required Clock Path Delay</td>
<td>cell: 1.046, 40.511%; route: 1.536, 59.489%</td>
</tr>
</table>
<h3>Path11</h3>
<p><b>Path Summary:</b></p>
<table class="summary_table">
<tr>
<td class="label">Slack</td>
<td>9.739</td>
</tr>
<tr>
<td class="label">Data Arrival Time</td>
<td>12.565</td>
</tr>
<tr>
<td class="label">Data Required Time</td>
<td>22.304</td>
</tr>
<tr>
<td class="label">From</td>
<td>imu/ready_s1</td>
</tr>
<tr>
<td class="label">To</td>
<td>driver/left_channel/remaining_3_s1</td>
</tr>
<tr>
<td class="label">Launch Clk</td>
<td>clk_50m:[R]</td>
</tr>
<tr>
<td class="label">Latch Clk</td>
<td>clk_50m:[R]</td>
</tr>
</table>
<p><b>Data Arrival Path:</b></p>
<table class="detail_table">
<tr>
<th class="label">AT</th>
<th class="label">DELAY</th>
<th class="label">TYPE</th>
<th class="label">RF</th>
<th class="label">FANOUT</th>
<th class="label">LOC</th>
<th>NODE</th>
</tr>
<tr>
<td>0.000</td>
<td>0.000</td>
<td></td>
<td></td>
<td></td>
<td></td>
<td>active clock edge time</td>
</tr>
<tr>
<td>0.000</td>
<td>0.000</td>
<td></td>
<td></td>
<td></td>
<td></td>
<td>clk_50m</td>
</tr>
<tr>
<td>0.000</td>
<td>0.000</td>
<td>tCL</td>
<td>RR</td>
<td>1</td>
<td>IOB29[A]</td>
<td>clk_50m_ibuf/I</td>
</tr>
<tr>
<td>1.046</td>
<td>1.046</td>
<td>tINS</td>
<td>RR</td>
<td>3385</td>
<td>IOB29[A]</td>
<td>clk_50m_ibuf/O</td>
</tr>
<tr>
<td>2.607</td>
<td>1.561</td>
<td>tNET</td>
<td>RR</td>
<td>1</td>
<td>R22C87[1][A]</td>
<td>imu/ready_s1/CLK</td>
</tr>
<tr>
<td>2.901</td>
<td>0.294</td>
<td>tC2Q</td>
<td>RF</td>
<td>277</td>
<td>R22C87[1][A]</td>
<td style=" font-weight:bold;">imu/ready_s1/Q</td>
</tr>
<tr>
<td>6.276</td>
<td>3.375</td>
<td>tNET</td>
<td>FF</td>
<td>1</td>
<td>R14C54[0][B]</td>
<td>fault_now_s1/I2</td>
</tr>
<tr>
<td>6.689</td>
<td>0.413</td>
<td>tINS</td>
<td>FR</td>
<td>9</td>
<td>R14C54[0][B]</td>
<td style=" background: #97FFFF;">fault_now_s1/F</td>
</tr>
<tr>
<td>7.748</td>
<td>1.059</td>
<td>tNET</td>
<td>RR</td>
<td>1</td>
<td>R22C48[0][B]</td>
<td>driver/inhibit_s1/I0</td>
</tr>
<tr>
<td>8.169</td>
<td>0.421</td>
<td>tINS</td>
<td>RR</td>
<td>125</td>
<td>R22C48[0][B]</td>
<td style=" background: #97FFFF;">driver/inhibit_s1/F</td>
</tr>
<tr>
<td>10.578</td>
<td>2.409</td>
<td>tNET</td>
<td>RR</td>
<td>1</td>
<td>R32C87[1][A]</td>
<td>driver/n14_s2/I2</td>
</tr>
<tr>
<td>10.890</td>
<td>0.312</td>
<td>tINS</td>
<td>RF</td>
<td>78</td>
<td>R32C87[1][A]</td>
<td style=" background: #97FFFF;">driver/n14_s2/F</td>
</tr>
<tr>
<td>12.565</td>
<td>1.675</td>
<td>tNET</td>
<td>FF</td>
<td>1</td>
<td>R35C83[2][B]</td>
<td style=" font-weight:bold;">driver/left_channel/remaining_3_s1/CLEAR</td>
</tr>
</table>
<p><b>Data Required Path:</b></p>
<table class="detail_table">
<tr>
<th class="label">AT</th>
<th class="label">DELAY</th>
<th class="label">TYPE</th>
<th class="label">RF</th>
<th class="label">FANOUT</th>
<th class="label">LOC</th>
<th>NODE</th>
</tr>
<tr>
<td>20.000</td>
<td>20.000</td>
<td></td>
<td></td>
<td></td>
<td></td>
<td>active clock edge time</td>
</tr>
<tr>
<td>20.000</td>
<td>0.000</td>
<td></td>
<td></td>
<td></td>
<td></td>
<td>clk_50m</td>
</tr>
<tr>
<td>20.000</td>
<td>0.000</td>
<td>tCL</td>
<td>RR</td>
<td>1</td>
<td>IOB29[A]</td>
<td>clk_50m_ibuf/I</td>
</tr>
<tr>
<td>21.046</td>
<td>1.046</td>
<td>tINS</td>
<td>RR</td>
<td>3385</td>
<td>IOB29[A]</td>
<td>clk_50m_ibuf/O</td>
</tr>
<tr>
<td>22.582</td>
<td>1.536</td>
<td>tNET</td>
<td>RR</td>
<td>1</td>
<td>R35C83[2][B]</td>
<td>driver/left_channel/remaining_3_s1/CLK</td>
</tr>
<tr>
<td>22.304</td>
<td>-0.278</td>
<td>tSu</td>
<td></td>
<td>1</td>
<td>R35C83[2][B]</td>
<td>driver/left_channel/remaining_3_s1</td>
</tr>
</table>
<p><b>Path Statistics:</b></p>
<table class="summary_table">
<tr>
<td class="label">Clock Skew</td>
<td>-0.025</td>
</tr>
<tr>
<td class="label">Setup Relationship </td>
<td>20.000</td>
</tr>
<tr>
<td class="label">Logic Level</td>
<td>4</td>
</tr>
<tr>
<td class="label">Arrival Clock Path Delay</td>
<td>cell: 1.046, 40.123%; route: 1.561, 59.877%</td>
</tr>
<tr>
<td class="label">Arrival Data Path Delay</td>
<td>cell: 1.146, 11.508%; route: 8.519, 85.540%; tC2Q: 0.294, 2.952%</td>
</tr>
<tr>
<td class="label">Required Clock Path Delay</td>
<td>cell: 1.046, 40.511%; route: 1.536, 59.489%</td>
</tr>
</table>
<h3>Path12</h3>
<p><b>Path Summary:</b></p>
<table class="summary_table">
<tr>
<td class="label">Slack</td>
<td>9.739</td>
</tr>
<tr>
<td class="label">Data Arrival Time</td>
<td>12.565</td>
</tr>
<tr>
<td class="label">Data Required Time</td>
<td>22.304</td>
</tr>
<tr>
<td class="label">From</td>
<td>imu/ready_s1</td>
</tr>
<tr>
<td class="label">To</td>
<td>driver/left_channel/remaining_4_s1</td>
</tr>
<tr>
<td class="label">Launch Clk</td>
<td>clk_50m:[R]</td>
</tr>
<tr>
<td class="label">Latch Clk</td>
<td>clk_50m:[R]</td>
</tr>
</table>
<p><b>Data Arrival Path:</b></p>
<table class="detail_table">
<tr>
<th class="label">AT</th>
<th class="label">DELAY</th>
<th class="label">TYPE</th>
<th class="label">RF</th>
<th class="label">FANOUT</th>
<th class="label">LOC</th>
<th>NODE</th>
</tr>
<tr>
<td>0.000</td>
<td>0.000</td>
<td></td>
<td></td>
<td></td>
<td></td>
<td>active clock edge time</td>
</tr>
<tr>
<td>0.000</td>
<td>0.000</td>
<td></td>
<td></td>
<td></td>
<td></td>
<td>clk_50m</td>
</tr>
<tr>
<td>0.000</td>
<td>0.000</td>
<td>tCL</td>
<td>RR</td>
<td>1</td>
<td>IOB29[A]</td>
<td>clk_50m_ibuf/I</td>
</tr>
<tr>
<td>1.046</td>
<td>1.046</td>
<td>tINS</td>
<td>RR</td>
<td>3385</td>
<td>IOB29[A]</td>
<td>clk_50m_ibuf/O</td>
</tr>
<tr>
<td>2.607</td>
<td>1.561</td>
<td>tNET</td>
<td>RR</td>
<td>1</td>
<td>R22C87[1][A]</td>
<td>imu/ready_s1/CLK</td>
</tr>
<tr>
<td>2.901</td>
<td>0.294</td>
<td>tC2Q</td>
<td>RF</td>
<td>277</td>
<td>R22C87[1][A]</td>
<td style=" font-weight:bold;">imu/ready_s1/Q</td>
</tr>
<tr>
<td>6.276</td>
<td>3.375</td>
<td>tNET</td>
<td>FF</td>
<td>1</td>
<td>R14C54[0][B]</td>
<td>fault_now_s1/I2</td>
</tr>
<tr>
<td>6.689</td>
<td>0.413</td>
<td>tINS</td>
<td>FR</td>
<td>9</td>
<td>R14C54[0][B]</td>
<td style=" background: #97FFFF;">fault_now_s1/F</td>
</tr>
<tr>
<td>7.748</td>
<td>1.059</td>
<td>tNET</td>
<td>RR</td>
<td>1</td>
<td>R22C48[0][B]</td>
<td>driver/inhibit_s1/I0</td>
</tr>
<tr>
<td>8.169</td>
<td>0.421</td>
<td>tINS</td>
<td>RR</td>
<td>125</td>
<td>R22C48[0][B]</td>
<td style=" background: #97FFFF;">driver/inhibit_s1/F</td>
</tr>
<tr>
<td>10.578</td>
<td>2.409</td>
<td>tNET</td>
<td>RR</td>
<td>1</td>
<td>R32C87[1][A]</td>
<td>driver/n14_s2/I2</td>
</tr>
<tr>
<td>10.890</td>
<td>0.312</td>
<td>tINS</td>
<td>RF</td>
<td>78</td>
<td>R32C87[1][A]</td>
<td style=" background: #97FFFF;">driver/n14_s2/F</td>
</tr>
<tr>
<td>12.565</td>
<td>1.675</td>
<td>tNET</td>
<td>FF</td>
<td>1</td>
<td>R35C83[3][A]</td>
<td style=" font-weight:bold;">driver/left_channel/remaining_4_s1/CLEAR</td>
</tr>
</table>
<p><b>Data Required Path:</b></p>
<table class="detail_table">
<tr>
<th class="label">AT</th>
<th class="label">DELAY</th>
<th class="label">TYPE</th>
<th class="label">RF</th>
<th class="label">FANOUT</th>
<th class="label">LOC</th>
<th>NODE</th>
</tr>
<tr>
<td>20.000</td>
<td>20.000</td>
<td></td>
<td></td>
<td></td>
<td></td>
<td>active clock edge time</td>
</tr>
<tr>
<td>20.000</td>
<td>0.000</td>
<td></td>
<td></td>
<td></td>
<td></td>
<td>clk_50m</td>
</tr>
<tr>
<td>20.000</td>
<td>0.000</td>
<td>tCL</td>
<td>RR</td>
<td>1</td>
<td>IOB29[A]</td>
<td>clk_50m_ibuf/I</td>
</tr>
<tr>
<td>21.046</td>
<td>1.046</td>
<td>tINS</td>
<td>RR</td>
<td>3385</td>
<td>IOB29[A]</td>
<td>clk_50m_ibuf/O</td>
</tr>
<tr>
<td>22.582</td>
<td>1.536</td>
<td>tNET</td>
<td>RR</td>
<td>1</td>
<td>R35C83[3][A]</td>
<td>driver/left_channel/remaining_4_s1/CLK</td>
</tr>
<tr>
<td>22.304</td>
<td>-0.278</td>
<td>tSu</td>
<td></td>
<td>1</td>
<td>R35C83[3][A]</td>
<td>driver/left_channel/remaining_4_s1</td>
</tr>
</table>
<p><b>Path Statistics:</b></p>
<table class="summary_table">
<tr>
<td class="label">Clock Skew</td>
<td>-0.025</td>
</tr>
<tr>
<td class="label">Setup Relationship </td>
<td>20.000</td>
</tr>
<tr>
<td class="label">Logic Level</td>
<td>4</td>
</tr>
<tr>
<td class="label">Arrival Clock Path Delay</td>
<td>cell: 1.046, 40.123%; route: 1.561, 59.877%</td>
</tr>
<tr>
<td class="label">Arrival Data Path Delay</td>
<td>cell: 1.146, 11.508%; route: 8.519, 85.540%; tC2Q: 0.294, 2.952%</td>
</tr>
<tr>
<td class="label">Required Clock Path Delay</td>
<td>cell: 1.046, 40.511%; route: 1.536, 59.489%</td>
</tr>
</table>
<h3>Path13</h3>
<p><b>Path Summary:</b></p>
<table class="summary_table">
<tr>
<td class="label">Slack</td>
<td>9.739</td>
</tr>
<tr>
<td class="label">Data Arrival Time</td>
<td>12.565</td>
</tr>
<tr>
<td class="label">Data Required Time</td>
<td>22.304</td>
</tr>
<tr>
<td class="label">From</td>
<td>imu/ready_s1</td>
</tr>
<tr>
<td class="label">To</td>
<td>driver/left_channel/remaining_6_s1</td>
</tr>
<tr>
<td class="label">Launch Clk</td>
<td>clk_50m:[R]</td>
</tr>
<tr>
<td class="label">Latch Clk</td>
<td>clk_50m:[R]</td>
</tr>
</table>
<p><b>Data Arrival Path:</b></p>
<table class="detail_table">
<tr>
<th class="label">AT</th>
<th class="label">DELAY</th>
<th class="label">TYPE</th>
<th class="label">RF</th>
<th class="label">FANOUT</th>
<th class="label">LOC</th>
<th>NODE</th>
</tr>
<tr>
<td>0.000</td>
<td>0.000</td>
<td></td>
<td></td>
<td></td>
<td></td>
<td>active clock edge time</td>
</tr>
<tr>
<td>0.000</td>
<td>0.000</td>
<td></td>
<td></td>
<td></td>
<td></td>
<td>clk_50m</td>
</tr>
<tr>
<td>0.000</td>
<td>0.000</td>
<td>tCL</td>
<td>RR</td>
<td>1</td>
<td>IOB29[A]</td>
<td>clk_50m_ibuf/I</td>
</tr>
<tr>
<td>1.046</td>
<td>1.046</td>
<td>tINS</td>
<td>RR</td>
<td>3385</td>
<td>IOB29[A]</td>
<td>clk_50m_ibuf/O</td>
</tr>
<tr>
<td>2.607</td>
<td>1.561</td>
<td>tNET</td>
<td>RR</td>
<td>1</td>
<td>R22C87[1][A]</td>
<td>imu/ready_s1/CLK</td>
</tr>
<tr>
<td>2.901</td>
<td>0.294</td>
<td>tC2Q</td>
<td>RF</td>
<td>277</td>
<td>R22C87[1][A]</td>
<td style=" font-weight:bold;">imu/ready_s1/Q</td>
</tr>
<tr>
<td>6.276</td>
<td>3.375</td>
<td>tNET</td>
<td>FF</td>
<td>1</td>
<td>R14C54[0][B]</td>
<td>fault_now_s1/I2</td>
</tr>
<tr>
<td>6.689</td>
<td>0.413</td>
<td>tINS</td>
<td>FR</td>
<td>9</td>
<td>R14C54[0][B]</td>
<td style=" background: #97FFFF;">fault_now_s1/F</td>
</tr>
<tr>
<td>7.748</td>
<td>1.059</td>
<td>tNET</td>
<td>RR</td>
<td>1</td>
<td>R22C48[0][B]</td>
<td>driver/inhibit_s1/I0</td>
</tr>
<tr>
<td>8.169</td>
<td>0.421</td>
<td>tINS</td>
<td>RR</td>
<td>125</td>
<td>R22C48[0][B]</td>
<td style=" background: #97FFFF;">driver/inhibit_s1/F</td>
</tr>
<tr>
<td>10.578</td>
<td>2.409</td>
<td>tNET</td>
<td>RR</td>
<td>1</td>
<td>R32C87[1][A]</td>
<td>driver/n14_s2/I2</td>
</tr>
<tr>
<td>10.890</td>
<td>0.312</td>
<td>tINS</td>
<td>RF</td>
<td>78</td>
<td>R32C87[1][A]</td>
<td style=" background: #97FFFF;">driver/n14_s2/F</td>
</tr>
<tr>
<td>12.565</td>
<td>1.675</td>
<td>tNET</td>
<td>FF</td>
<td>1</td>
<td>R35C83[1][B]</td>
<td style=" font-weight:bold;">driver/left_channel/remaining_6_s1/CLEAR</td>
</tr>
</table>
<p><b>Data Required Path:</b></p>
<table class="detail_table">
<tr>
<th class="label">AT</th>
<th class="label">DELAY</th>
<th class="label">TYPE</th>
<th class="label">RF</th>
<th class="label">FANOUT</th>
<th class="label">LOC</th>
<th>NODE</th>
</tr>
<tr>
<td>20.000</td>
<td>20.000</td>
<td></td>
<td></td>
<td></td>
<td></td>
<td>active clock edge time</td>
</tr>
<tr>
<td>20.000</td>
<td>0.000</td>
<td></td>
<td></td>
<td></td>
<td></td>
<td>clk_50m</td>
</tr>
<tr>
<td>20.000</td>
<td>0.000</td>
<td>tCL</td>
<td>RR</td>
<td>1</td>
<td>IOB29[A]</td>
<td>clk_50m_ibuf/I</td>
</tr>
<tr>
<td>21.046</td>
<td>1.046</td>
<td>tINS</td>
<td>RR</td>
<td>3385</td>
<td>IOB29[A]</td>
<td>clk_50m_ibuf/O</td>
</tr>
<tr>
<td>22.582</td>
<td>1.536</td>
<td>tNET</td>
<td>RR</td>
<td>1</td>
<td>R35C83[1][B]</td>
<td>driver/left_channel/remaining_6_s1/CLK</td>
</tr>
<tr>
<td>22.304</td>
<td>-0.278</td>
<td>tSu</td>
<td></td>
<td>1</td>
<td>R35C83[1][B]</td>
<td>driver/left_channel/remaining_6_s1</td>
</tr>
</table>
<p><b>Path Statistics:</b></p>
<table class="summary_table">
<tr>
<td class="label">Clock Skew</td>
<td>-0.025</td>
</tr>
<tr>
<td class="label">Setup Relationship </td>
<td>20.000</td>
</tr>
<tr>
<td class="label">Logic Level</td>
<td>4</td>
</tr>
<tr>
<td class="label">Arrival Clock Path Delay</td>
<td>cell: 1.046, 40.123%; route: 1.561, 59.877%</td>
</tr>
<tr>
<td class="label">Arrival Data Path Delay</td>
<td>cell: 1.146, 11.508%; route: 8.519, 85.540%; tC2Q: 0.294, 2.952%</td>
</tr>
<tr>
<td class="label">Required Clock Path Delay</td>
<td>cell: 1.046, 40.511%; route: 1.536, 59.489%</td>
</tr>
</table>
<h3>Path14</h3>
<p><b>Path Summary:</b></p>
<table class="summary_table">
<tr>
<td class="label">Slack</td>
<td>9.739</td>
</tr>
<tr>
<td class="label">Data Arrival Time</td>
<td>12.565</td>
</tr>
<tr>
<td class="label">Data Required Time</td>
<td>22.304</td>
</tr>
<tr>
<td class="label">From</td>
<td>imu/ready_s1</td>
</tr>
<tr>
<td class="label">To</td>
<td>driver/command_r_8_s0</td>
</tr>
<tr>
<td class="label">Launch Clk</td>
<td>clk_50m:[R]</td>
</tr>
<tr>
<td class="label">Latch Clk</td>
<td>clk_50m:[R]</td>
</tr>
</table>
<p><b>Data Arrival Path:</b></p>
<table class="detail_table">
<tr>
<th class="label">AT</th>
<th class="label">DELAY</th>
<th class="label">TYPE</th>
<th class="label">RF</th>
<th class="label">FANOUT</th>
<th class="label">LOC</th>
<th>NODE</th>
</tr>
<tr>
<td>0.000</td>
<td>0.000</td>
<td></td>
<td></td>
<td></td>
<td></td>
<td>active clock edge time</td>
</tr>
<tr>
<td>0.000</td>
<td>0.000</td>
<td></td>
<td></td>
<td></td>
<td></td>
<td>clk_50m</td>
</tr>
<tr>
<td>0.000</td>
<td>0.000</td>
<td>tCL</td>
<td>RR</td>
<td>1</td>
<td>IOB29[A]</td>
<td>clk_50m_ibuf/I</td>
</tr>
<tr>
<td>1.046</td>
<td>1.046</td>
<td>tINS</td>
<td>RR</td>
<td>3385</td>
<td>IOB29[A]</td>
<td>clk_50m_ibuf/O</td>
</tr>
<tr>
<td>2.607</td>
<td>1.561</td>
<td>tNET</td>
<td>RR</td>
<td>1</td>
<td>R22C87[1][A]</td>
<td>imu/ready_s1/CLK</td>
</tr>
<tr>
<td>2.901</td>
<td>0.294</td>
<td>tC2Q</td>
<td>RF</td>
<td>277</td>
<td>R22C87[1][A]</td>
<td style=" font-weight:bold;">imu/ready_s1/Q</td>
</tr>
<tr>
<td>6.276</td>
<td>3.375</td>
<td>tNET</td>
<td>FF</td>
<td>1</td>
<td>R14C54[0][B]</td>
<td>fault_now_s1/I2</td>
</tr>
<tr>
<td>6.689</td>
<td>0.413</td>
<td>tINS</td>
<td>FR</td>
<td>9</td>
<td>R14C54[0][B]</td>
<td style=" background: #97FFFF;">fault_now_s1/F</td>
</tr>
<tr>
<td>7.748</td>
<td>1.059</td>
<td>tNET</td>
<td>RR</td>
<td>1</td>
<td>R22C48[0][B]</td>
<td>driver/inhibit_s1/I0</td>
</tr>
<tr>
<td>8.169</td>
<td>0.421</td>
<td>tINS</td>
<td>RR</td>
<td>125</td>
<td>R22C48[0][B]</td>
<td style=" background: #97FFFF;">driver/inhibit_s1/F</td>
</tr>
<tr>
<td>10.578</td>
<td>2.409</td>
<td>tNET</td>
<td>RR</td>
<td>1</td>
<td>R32C87[1][A]</td>
<td>driver/n14_s2/I2</td>
</tr>
<tr>
<td>10.890</td>
<td>0.312</td>
<td>tINS</td>
<td>RF</td>
<td>78</td>
<td>R32C87[1][A]</td>
<td style=" background: #97FFFF;">driver/n14_s2/F</td>
</tr>
<tr>
<td>12.565</td>
<td>1.675</td>
<td>tNET</td>
<td>FF</td>
<td>1</td>
<td>R35C67[0][A]</td>
<td style=" font-weight:bold;">driver/command_r_8_s0/CLEAR</td>
</tr>
</table>
<p><b>Data Required Path:</b></p>
<table class="detail_table">
<tr>
<th class="label">AT</th>
<th class="label">DELAY</th>
<th class="label">TYPE</th>
<th class="label">RF</th>
<th class="label">FANOUT</th>
<th class="label">LOC</th>
<th>NODE</th>
</tr>
<tr>
<td>20.000</td>
<td>20.000</td>
<td></td>
<td></td>
<td></td>
<td></td>
<td>active clock edge time</td>
</tr>
<tr>
<td>20.000</td>
<td>0.000</td>
<td></td>
<td></td>
<td></td>
<td></td>
<td>clk_50m</td>
</tr>
<tr>
<td>20.000</td>
<td>0.000</td>
<td>tCL</td>
<td>RR</td>
<td>1</td>
<td>IOB29[A]</td>
<td>clk_50m_ibuf/I</td>
</tr>
<tr>
<td>21.046</td>
<td>1.046</td>
<td>tINS</td>
<td>RR</td>
<td>3385</td>
<td>IOB29[A]</td>
<td>clk_50m_ibuf/O</td>
</tr>
<tr>
<td>22.582</td>
<td>1.536</td>
<td>tNET</td>
<td>RR</td>
<td>1</td>
<td>R35C67[0][A]</td>
<td>driver/command_r_8_s0/CLK</td>
</tr>
<tr>
<td>22.304</td>
<td>-0.278</td>
<td>tSu</td>
<td></td>
<td>1</td>
<td>R35C67[0][A]</td>
<td>driver/command_r_8_s0</td>
</tr>
</table>
<p><b>Path Statistics:</b></p>
<table class="summary_table">
<tr>
<td class="label">Clock Skew</td>
<td>-0.025</td>
</tr>
<tr>
<td class="label">Setup Relationship </td>
<td>20.000</td>
</tr>
<tr>
<td class="label">Logic Level</td>
<td>4</td>
</tr>
<tr>
<td class="label">Arrival Clock Path Delay</td>
<td>cell: 1.046, 40.123%; route: 1.561, 59.877%</td>
</tr>
<tr>
<td class="label">Arrival Data Path Delay</td>
<td>cell: 1.146, 11.508%; route: 8.519, 85.540%; tC2Q: 0.294, 2.952%</td>
</tr>
<tr>
<td class="label">Required Clock Path Delay</td>
<td>cell: 1.046, 40.511%; route: 1.536, 59.489%</td>
</tr>
</table>
<h3>Path15</h3>
<p><b>Path Summary:</b></p>
<table class="summary_table">
<tr>
<td class="label">Slack</td>
<td>9.738</td>
</tr>
<tr>
<td class="label">Data Arrival Time</td>
<td>12.562</td>
</tr>
<tr>
<td class="label">Data Required Time</td>
<td>22.301</td>
</tr>
<tr>
<td class="label">From</td>
<td>imu/ready_s1</td>
</tr>
<tr>
<td class="label">To</td>
<td>driver/command_l_8_s0</td>
</tr>
<tr>
<td class="label">Launch Clk</td>
<td>clk_50m:[R]</td>
</tr>
<tr>
<td class="label">Latch Clk</td>
<td>clk_50m:[R]</td>
</tr>
</table>
<p><b>Data Arrival Path:</b></p>
<table class="detail_table">
<tr>
<th class="label">AT</th>
<th class="label">DELAY</th>
<th class="label">TYPE</th>
<th class="label">RF</th>
<th class="label">FANOUT</th>
<th class="label">LOC</th>
<th>NODE</th>
</tr>
<tr>
<td>0.000</td>
<td>0.000</td>
<td></td>
<td></td>
<td></td>
<td></td>
<td>active clock edge time</td>
</tr>
<tr>
<td>0.000</td>
<td>0.000</td>
<td></td>
<td></td>
<td></td>
<td></td>
<td>clk_50m</td>
</tr>
<tr>
<td>0.000</td>
<td>0.000</td>
<td>tCL</td>
<td>RR</td>
<td>1</td>
<td>IOB29[A]</td>
<td>clk_50m_ibuf/I</td>
</tr>
<tr>
<td>1.046</td>
<td>1.046</td>
<td>tINS</td>
<td>RR</td>
<td>3385</td>
<td>IOB29[A]</td>
<td>clk_50m_ibuf/O</td>
</tr>
<tr>
<td>2.607</td>
<td>1.561</td>
<td>tNET</td>
<td>RR</td>
<td>1</td>
<td>R22C87[1][A]</td>
<td>imu/ready_s1/CLK</td>
</tr>
<tr>
<td>2.901</td>
<td>0.294</td>
<td>tC2Q</td>
<td>RF</td>
<td>277</td>
<td>R22C87[1][A]</td>
<td style=" font-weight:bold;">imu/ready_s1/Q</td>
</tr>
<tr>
<td>6.276</td>
<td>3.375</td>
<td>tNET</td>
<td>FF</td>
<td>1</td>
<td>R14C54[0][B]</td>
<td>fault_now_s1/I2</td>
</tr>
<tr>
<td>6.689</td>
<td>0.413</td>
<td>tINS</td>
<td>FR</td>
<td>9</td>
<td>R14C54[0][B]</td>
<td style=" background: #97FFFF;">fault_now_s1/F</td>
</tr>
<tr>
<td>7.748</td>
<td>1.059</td>
<td>tNET</td>
<td>RR</td>
<td>1</td>
<td>R22C48[0][B]</td>
<td>driver/inhibit_s1/I0</td>
</tr>
<tr>
<td>8.169</td>
<td>0.421</td>
<td>tINS</td>
<td>RR</td>
<td>125</td>
<td>R22C48[0][B]</td>
<td style=" background: #97FFFF;">driver/inhibit_s1/F</td>
</tr>
<tr>
<td>10.578</td>
<td>2.409</td>
<td>tNET</td>
<td>RR</td>
<td>1</td>
<td>R32C87[1][A]</td>
<td>driver/n14_s2/I2</td>
</tr>
<tr>
<td>10.890</td>
<td>0.312</td>
<td>tINS</td>
<td>RF</td>
<td>78</td>
<td>R32C87[1][A]</td>
<td style=" background: #97FFFF;">driver/n14_s2/F</td>
</tr>
<tr>
<td>12.562</td>
<td>1.672</td>
<td>tNET</td>
<td>FF</td>
<td>1</td>
<td>R33C79[0][B]</td>
<td style=" font-weight:bold;">driver/command_l_8_s0/CLEAR</td>
</tr>
</table>
<p><b>Data Required Path:</b></p>
<table class="detail_table">
<tr>
<th class="label">AT</th>
<th class="label">DELAY</th>
<th class="label">TYPE</th>
<th class="label">RF</th>
<th class="label">FANOUT</th>
<th class="label">LOC</th>
<th>NODE</th>
</tr>
<tr>
<td>20.000</td>
<td>20.000</td>
<td></td>
<td></td>
<td></td>
<td></td>
<td>active clock edge time</td>
</tr>
<tr>
<td>20.000</td>
<td>0.000</td>
<td></td>
<td></td>
<td></td>
<td></td>
<td>clk_50m</td>
</tr>
<tr>
<td>20.000</td>
<td>0.000</td>
<td>tCL</td>
<td>RR</td>
<td>1</td>
<td>IOB29[A]</td>
<td>clk_50m_ibuf/I</td>
</tr>
<tr>
<td>21.046</td>
<td>1.046</td>
<td>tINS</td>
<td>RR</td>
<td>3385</td>
<td>IOB29[A]</td>
<td>clk_50m_ibuf/O</td>
</tr>
<tr>
<td>22.579</td>
<td>1.533</td>
<td>tNET</td>
<td>RR</td>
<td>1</td>
<td>R33C79[0][B]</td>
<td>driver/command_l_8_s0/CLK</td>
</tr>
<tr>
<td>22.301</td>
<td>-0.278</td>
<td>tSu</td>
<td></td>
<td>1</td>
<td>R33C79[0][B]</td>
<td>driver/command_l_8_s0</td>
</tr>
</table>
<p><b>Path Statistics:</b></p>
<table class="summary_table">
<tr>
<td class="label">Clock Skew</td>
<td>-0.028</td>
</tr>
<tr>
<td class="label">Setup Relationship </td>
<td>20.000</td>
</tr>
<tr>
<td class="label">Logic Level</td>
<td>4</td>
</tr>
<tr>
<td class="label">Arrival Clock Path Delay</td>
<td>cell: 1.046, 40.123%; route: 1.561, 59.877%</td>
</tr>
<tr>
<td class="label">Arrival Data Path Delay</td>
<td>cell: 1.146, 11.511%; route: 8.516, 85.536%; tC2Q: 0.294, 2.953%</td>
</tr>
<tr>
<td class="label">Required Clock Path Delay</td>
<td>cell: 1.046, 40.558%; route: 1.533, 59.442%</td>
</tr>
</table>
<h3>Path16</h3>
<p><b>Path Summary:</b></p>
<table class="summary_table">
<tr>
<td class="label">Slack</td>
<td>9.738</td>
</tr>
<tr>
<td class="label">Data Arrival Time</td>
<td>12.562</td>
</tr>
<tr>
<td class="label">Data Required Time</td>
<td>22.301</td>
</tr>
<tr>
<td class="label">From</td>
<td>imu/ready_s1</td>
</tr>
<tr>
<td class="label">To</td>
<td>driver/command_l_15_s0</td>
</tr>
<tr>
<td class="label">Launch Clk</td>
<td>clk_50m:[R]</td>
</tr>
<tr>
<td class="label">Latch Clk</td>
<td>clk_50m:[R]</td>
</tr>
</table>
<p><b>Data Arrival Path:</b></p>
<table class="detail_table">
<tr>
<th class="label">AT</th>
<th class="label">DELAY</th>
<th class="label">TYPE</th>
<th class="label">RF</th>
<th class="label">FANOUT</th>
<th class="label">LOC</th>
<th>NODE</th>
</tr>
<tr>
<td>0.000</td>
<td>0.000</td>
<td></td>
<td></td>
<td></td>
<td></td>
<td>active clock edge time</td>
</tr>
<tr>
<td>0.000</td>
<td>0.000</td>
<td></td>
<td></td>
<td></td>
<td></td>
<td>clk_50m</td>
</tr>
<tr>
<td>0.000</td>
<td>0.000</td>
<td>tCL</td>
<td>RR</td>
<td>1</td>
<td>IOB29[A]</td>
<td>clk_50m_ibuf/I</td>
</tr>
<tr>
<td>1.046</td>
<td>1.046</td>
<td>tINS</td>
<td>RR</td>
<td>3385</td>
<td>IOB29[A]</td>
<td>clk_50m_ibuf/O</td>
</tr>
<tr>
<td>2.607</td>
<td>1.561</td>
<td>tNET</td>
<td>RR</td>
<td>1</td>
<td>R22C87[1][A]</td>
<td>imu/ready_s1/CLK</td>
</tr>
<tr>
<td>2.901</td>
<td>0.294</td>
<td>tC2Q</td>
<td>RF</td>
<td>277</td>
<td>R22C87[1][A]</td>
<td style=" font-weight:bold;">imu/ready_s1/Q</td>
</tr>
<tr>
<td>6.276</td>
<td>3.375</td>
<td>tNET</td>
<td>FF</td>
<td>1</td>
<td>R14C54[0][B]</td>
<td>fault_now_s1/I2</td>
</tr>
<tr>
<td>6.689</td>
<td>0.413</td>
<td>tINS</td>
<td>FR</td>
<td>9</td>
<td>R14C54[0][B]</td>
<td style=" background: #97FFFF;">fault_now_s1/F</td>
</tr>
<tr>
<td>7.748</td>
<td>1.059</td>
<td>tNET</td>
<td>RR</td>
<td>1</td>
<td>R22C48[0][B]</td>
<td>driver/inhibit_s1/I0</td>
</tr>
<tr>
<td>8.169</td>
<td>0.421</td>
<td>tINS</td>
<td>RR</td>
<td>125</td>
<td>R22C48[0][B]</td>
<td style=" background: #97FFFF;">driver/inhibit_s1/F</td>
</tr>
<tr>
<td>10.578</td>
<td>2.409</td>
<td>tNET</td>
<td>RR</td>
<td>1</td>
<td>R32C87[1][A]</td>
<td>driver/n14_s2/I2</td>
</tr>
<tr>
<td>10.890</td>
<td>0.312</td>
<td>tINS</td>
<td>RF</td>
<td>78</td>
<td>R32C87[1][A]</td>
<td style=" background: #97FFFF;">driver/n14_s2/F</td>
</tr>
<tr>
<td>12.562</td>
<td>1.672</td>
<td>tNET</td>
<td>FF</td>
<td>1</td>
<td>R33C79[2][A]</td>
<td style=" font-weight:bold;">driver/command_l_15_s0/CLEAR</td>
</tr>
</table>
<p><b>Data Required Path:</b></p>
<table class="detail_table">
<tr>
<th class="label">AT</th>
<th class="label">DELAY</th>
<th class="label">TYPE</th>
<th class="label">RF</th>
<th class="label">FANOUT</th>
<th class="label">LOC</th>
<th>NODE</th>
</tr>
<tr>
<td>20.000</td>
<td>20.000</td>
<td></td>
<td></td>
<td></td>
<td></td>
<td>active clock edge time</td>
</tr>
<tr>
<td>20.000</td>
<td>0.000</td>
<td></td>
<td></td>
<td></td>
<td></td>
<td>clk_50m</td>
</tr>
<tr>
<td>20.000</td>
<td>0.000</td>
<td>tCL</td>
<td>RR</td>
<td>1</td>
<td>IOB29[A]</td>
<td>clk_50m_ibuf/I</td>
</tr>
<tr>
<td>21.046</td>
<td>1.046</td>
<td>tINS</td>
<td>RR</td>
<td>3385</td>
<td>IOB29[A]</td>
<td>clk_50m_ibuf/O</td>
</tr>
<tr>
<td>22.579</td>
<td>1.533</td>
<td>tNET</td>
<td>RR</td>
<td>1</td>
<td>R33C79[2][A]</td>
<td>driver/command_l_15_s0/CLK</td>
</tr>
<tr>
<td>22.301</td>
<td>-0.278</td>
<td>tSu</td>
<td></td>
<td>1</td>
<td>R33C79[2][A]</td>
<td>driver/command_l_15_s0</td>
</tr>
</table>
<p><b>Path Statistics:</b></p>
<table class="summary_table">
<tr>
<td class="label">Clock Skew</td>
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
