WeieeGRACE/Embodied_RPACS/tests/asr_motion/records/pc_timing_report.txt

<!DOCTYPE html PUBLIC "-//W3C//DTD XHTML 1.0 Transitional//EN" "http://www.w3.org/TR/xhtml1/DTD/xhtml1-transitional.dtd">
<html>
<head>
<title>Timing Analysis Report</title>
<style type="text/css">
@import url(../temp/style.css);
body { font-family: Verdana, Arial, sans-serif; font-size: 12px; }
div#content { width: 100%; margin: }
hr { margin-top: 30px; margin-bottom: 30px; }
h1, h3 { text-align: center; }
h1 {margin-top: 50px; }
table, th, td {white-space:pre; border: 1px solid #aaa; }
table { border-collapse:collapse; margin-top: 10px; margin-bottom: 20px; width: 100%; }
th, td { padding: 5px 5px 5px 5px; }
th { color: #fff; font-weight: bold; background-color: #0084ff; }
table.summary_table td.label { width: 24%; min-width: 200px; background-color: #dee8f4; }
table.detail_table th.label {  min-width: 8%; width: 8%; }
</style>
</head>
<body>
<div id="content">
<h1><a name="Message">Timing Messages</a></h1>
<table class="summary_table">
<tr>
<td class="label">Report Title</td>
<td>Timing Analysis Report</td>
</tr>
<tr>
<td class="label">Design File</td>
<td>D:\Gowin\Project\Contest\Embodied_RPACS\Embodied_RPACS\Embodied_RPACS\tests\asr_motion\impl\gwsynthesis\asr_motion_test.vg</td>
</tr>
<tr>
<td class="label">Physical Constraints File</td>
<td>D:\Gowin\Project\Contest\Embodied_RPACS\Embodied_RPACS\Embodied_RPACS\tests\asr_motion\src\asr_motion_test_top.cst</td>
</tr>
<tr>
<td class="label">Timing Constraint File</td>
<td>D:\Gowin\Project\Contest\Embodied_RPACS\Embodied_RPACS\Embodied_RPACS\tests\asr_motion\src\asr_motion_test_top.sdc</td>
</tr>
<tr>
<td class="label">Tool Version</td>
<td>V1.9.12 (64-bit)</td>
</tr>
<tr>
<td class="label">Part Number</td>
<td>GW5A-LV25UG324C2/I1</td>
</tr>
<tr>
<td class="label">Device</td>
<td>GW5A-25</td>
</tr>
<tr>
<td class="label">Device Version</td>
<td>A</td>
</tr>
<tr>
<td class="label">Created Time</td>
<td>Fri Oct 23 15:44:07 2026
</td>
</tr>
<tr>
<td class="label">Legal Announcement</td>
<td>Copyright (C)2014-2025 Gowin Semiconductor Corporation. All rights reserved.</td>
</tr>
</table>
<h1><a name="Summary">Timing Summaries</a></h1>
<h2><a name="STA_Tool_Run_Summary">STA Tool Run Summary:</a></h2>
<table class="summary_table">
<tr>
<td class="label">Setup Delay Model</td>
<td>Slow 0.855V 0C C2/I1</td>
</tr>
<tr>
<td class="label">Hold Delay Model</td>
<td>Fast 0.945V 85C C2/I1</td>
</tr>
<tr>
<td class="label">Numbers of Paths Analyzed</td>
<td>11105</td>
</tr>
<tr>
<td class="label">Numbers of Endpoints Analyzed</td>
<td>10341</td>
</tr>
<tr>
<td class="label">Numbers of Falling Endpoints</td>
<td>0</td>
</tr>
<tr>
<td class="label">Numbers of Setup Violated Endpoints</td>
<td>0</td>
</tr>
<tr>
<td class="label">Numbers of Hold Violated Endpoints</td>
<td>0</td>
</tr>
</table>
<h2><a name="Clock_Report">Clock Summary:</a></h2>
<table class="detail_table">
<tr>
<th class="label">NO.</th>
<th class="label">Clock Name</th>
<th class="label">Type</th>
<th class="label">Period</th>
<th class="label">Frequency(MHz)</th>
<th class="label">Rise</th>
<th class="label">Fall</th>
<th class="label">Source</th>
<th class="label">Master</th>
<th class="label">Objects</th>
</tr>
<tr>
<td>1</td>
<td>clk_50m</td>
<td>Base</td>
<td>20.000</td>
<td>50.000
<td>0.000</td>
<td>10.000</td>
<td></td>
<td></td>
<td>clk_50m </td>
</tr>
</table>
<h2><a name="Max_Frequency_Report">Max Frequency Summary:</a></h2>
<table>
<tr>
<th>NO.</th>
<th>Clock Name</th>
<th>Constraint</th>
<th>Actual Fmax</th>
<th>Logic Level</th>
<th>Entity</th>
</tr>
<tr>
<td>1</td>
<td>clk_50m</td>
<td>50.000(MHz)</td>
<td>63.783(MHz)</td>
<td>19</td>
<td>TOP</td>
</tr>
</table>
<h2><a name="Total_Negative_Slack_Report">Total Negative Slack Summary:</a></h2>
<table class="detail_table">
<tr>
<th class="label">Clock Name</th>
<th class="label">Analysis Type</th>
<th class="label">Endpoints TNS</th>
<th class="label">Number of Endpoints</th>
</tr>
<tr>
<td>clk_50m</td>
<td>Setup</td>
<td>0.000</td>
<td>0</td>
</tr>
<tr>
<td>clk_50m</td>
<td>Hold</td>
<td>0.000</td>
<td>0</td>
</tr>
</table>
<h1><a name="Detail">Timing Details</a></h1>
<h2><a name="All_Path_Slack_Table">Path Slacks Table:</a></h2>
<h3><a name="Setup_Slack_Table">Setup Paths Table</a></h3>
<h4>Report Command:report_timing -setup -max_paths 25 -max_common_paths 1</h4>
<table class="detail_table">
<tr>
<th class="label">Path Number</th>
<th class="label">Path Slack</th>
<th class="label">From Node</th>
<th class="label">To Node</th>
<th class="label">From Clock</th>
<th class="label">To Clock</th>
<th class="label">Relation</th>
<th class="label">Clock Skew</th>
<th class="label">Data Delay</th>
</tr>
<tr>
<td>1</td>
<td>4.322</td>
<td>motion/mag_l_1_s0/Q</td>
<td>target_l_14_s0/D</td>
<td>clk_50m:[R]</td>
<td>clk_50m:[R]</td>
<td>20.000</td>
<td>0.016</td>
<td>15.611</td>
</tr>
<tr>
<td>2</td>
<td>4.322</td>
<td>motion/mag_l_1_s0/Q</td>
<td>target_l_15_s0/D</td>
<td>clk_50m:[R]</td>
<td>clk_50m:[R]</td>
<td>20.000</td>
<td>0.016</td>
<td>15.611</td>
</tr>
<tr>
<td>3</td>
<td>4.333</td>
<td>motion/mag_l_1_s0/Q</td>
<td>target_l_9_s0/D</td>
<td>clk_50m:[R]</td>
<td>clk_50m:[R]</td>
<td>20.000</td>
<td>0.016</td>
<td>15.600</td>
</tr>
<tr>
<td>4</td>
<td>4.480</td>
<td>imu/sensor_error_0_s0/Q</td>
<td>packets/fifo_fifo_RAMREG_7_G[9]_s0/CE</td>
<td>clk_50m:[R]</td>
<td>clk_50m:[R]</td>
<td>20.000</td>
<td>0.044</td>
<td>15.227</td>
</tr>
<tr>
<td>5</td>
<td>4.531</td>
<td>imu/sensor_error_0_s0/Q</td>
<td>packets/fifo_fifo_RAMREG_31_G[8]_s0/CE</td>
<td>clk_50m:[R]</td>
<td>clk_50m:[R]</td>
<td>20.000</td>
<td>-0.002</td>
<td>15.222</td>
</tr>
<tr>
<td>6</td>
<td>4.531</td>
<td>imu/sensor_error_0_s0/Q</td>
<td>packets/fifo_fifo_RAMREG_31_G[4]_s0/CE</td>
<td>clk_50m:[R]</td>
<td>clk_50m:[R]</td>
<td>20.000</td>
<td>-0.002</td>
<td>15.222</td>
</tr>
<tr>
<td>7</td>
<td>4.531</td>
<td>imu/sensor_error_0_s0/Q</td>
<td>packets/fifo_fifo_RAMREG_31_G[1]_s0/CE</td>
<td>clk_50m:[R]</td>
<td>clk_50m:[R]</td>
<td>20.000</td>
<td>-0.002</td>
<td>15.222</td>
</tr>
<tr>
<td>8</td>
<td>4.531</td>
<td>imu/sensor_error_0_s0/Q</td>
<td>packets/fifo_fifo_RAMREG_31_G[0]_s0/CE</td>
<td>clk_50m:[R]</td>
<td>clk_50m:[R]</td>
<td>20.000</td>
<td>-0.002</td>
<td>15.222</td>
</tr>
<tr>
<td>9</td>
<td>4.569</td>
<td>motion/mag_l_1_s0/Q</td>
<td>target_l_8_s0/D</td>
<td>clk_50m:[R]</td>
<td>clk_50m:[R]</td>
<td>20.000</td>
<td>0.016</td>
<td>15.364</td>
</tr>
<tr>
<td>10</td>
<td>4.649</td>
<td>imu/sensor_error_0_s0/Q</td>
<td>packets/fifo_fifo_RAMREG_55_G[8]_s0/CE</td>
<td>clk_50m:[R]</td>
<td>clk_50m:[R]</td>
<td>20.000</td>
<td>0.017</td>
<td>15.085</td>
</tr>
<tr>
<td>11</td>
<td>4.649</td>
<td>imu/sensor_error_0_s0/Q</td>
<td>packets/fifo_fifo_RAMREG_55_G[2]_s0/CE</td>
<td>clk_50m:[R]</td>
<td>clk_50m:[R]</td>
<td>20.000</td>
<td>0.017</td>
<td>15.085</td>
</tr>
<tr>
<td>12</td>
<td>4.684</td>
<td>imu/sensor_error_0_s0/Q</td>
<td>packets/fifo_fifo_RAMREG_28_G[8]_s0/CE</td>
<td>clk_50m:[R]</td>
<td>clk_50m:[R]</td>
<td>20.000</td>
<td>-0.004</td>
<td>15.071</td>
</tr>
<tr>
<td>13</td>
<td>4.684</td>
<td>imu/sensor_error_0_s0/Q</td>
<td>packets/fifo_fifo_RAMREG_28_G[4]_s0/CE</td>
<td>clk_50m:[R]</td>
<td>clk_50m:[R]</td>
<td>20.000</td>
<td>-0.004</td>
<td>15.071</td>
</tr>
<tr>
<td>14</td>
<td>4.684</td>
<td>imu/sensor_error_0_s0/Q</td>
<td>packets/fifo_fifo_RAMREG_28_G[2]_s0/CE</td>
<td>clk_50m:[R]</td>
<td>clk_50m:[R]</td>
<td>20.000</td>
<td>-0.004</td>
<td>15.071</td>
</tr>
<tr>
<td>15</td>
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
<td>tINS</td>
<td>RF</td>
<td>1</td>
<td>R12C49[3][A]</td>
<td style=" background: #97FFFF;">n1552_s7/F</td>
</tr>
<tr>
<td>17.827</td>
<td>0.004</td>
<td>tNET</td>
<td>FF</td>
<td>1</td>
<td>R12C49[1][B]</td>
<td>n1552_s0/I1</td>
</tr>
<tr>
<td>18.196</td>
<td>0.369</td>
<td>tINS</td>
<td>FR</td>
<td>1</td>
<td>R12C49[1][B]</td>
<td style=" background: #97FFFF;">n1552_s0/F</td>
</tr>
<tr>
<td>18.196</td>
<td>0.000</td>
<td>tNET</td>
<td>RR</td>
<td>1</td>
<td>R12C49[1][B]</td>
<td style=" font-weight:bold;">target_l_9_s0/D</td>
</tr>
</table>
<p><b>Data Required Path:</b></p>
<table class="detail_table">
<tr>
<th class="label">AT</th>
<th class="label">DELAY</th>
<th class="label">TYPE</th>
<th class="label">RF</th>
<th class="label">FANOUT</th>
<th class="label">LOC</th>
<th>NODE</th>
</tr>
<tr>
<td>20.000</td>
<td>20.000</td>
<td></td>
<td></td>
<td></td>
<td></td>
<td>active clock edge time</td>
</tr>
<tr>
<td>20.000</td>
<td>0.000</td>
<td></td>
<td></td>
<td></td>
<td></td>
<td>clk_50m</td>
</tr>
<tr>
<td>20.000</td>
<td>0.000</td>
<td>tCL</td>
<td>RR</td>
<td>1</td>
<td>IOB29[A]</td>
<td>clk_50m_ibuf/I</td>
</tr>
<tr>
<td>21.046</td>
<td>1.046</td>
<td>tINS</td>
<td>RR</td>
<td>3385</td>
<td>IOB29[A]</td>
<td>clk_50m_ibuf/O</td>
</tr>
<tr>
<td>22.580</td>
<td>1.534</td>
<td>tNET</td>
<td>RR</td>
<td>1</td>
<td>R12C49[1][B]</td>
<td>target_l_9_s0/CLK</td>
</tr>
<tr>
<td>22.529</td>
<td>-0.051</td>
<td>tSu</td>
<td></td>
<td>1</td>
<td>R12C49[1][B]</td>
<td>target_l_9_s0</td>
</tr>
</table>
<p><b>Path Statistics:</b></p>
<table class="summary_table">
<tr>
<td class="label">Clock Skew</td>
<td>-0.016</td>
</tr>
<tr>
<td class="label">Setup Relationship </td>
<td>20.000</td>
</tr>
<tr>
<td class="label">Logic Level</td>
<td>19</td>
</tr>
<tr>
<td class="label">Arrival Clock Path Delay</td>
<td>cell: 1.046, 40.300%; route: 1.549, 59.700%</td>
</tr>
<tr>
<td class="label">Arrival Data Path Delay</td>
<td>cell: 8.084, 51.821%; route: 7.210, 46.217%; tC2Q: 0.306, 1.962%</td>
</tr>
<tr>
<td class="label">Required Clock Path Delay</td>
<td>cell: 1.046, 40.546%; route: 1.534, 59.454%</td>
</tr>
</table>
<h3>Path4</h3>
<p><b>Path Summary:</b></p>
<table class="summary_table">
<tr>
<td class="label">Slack</td>
<td>4.480</td>
</tr>
<tr>
<td class="label">Data Arrival Time</td>
<td>17.835</td>
</tr>
<tr>
<td class="label">Data Required Time</td>
<td>22.316</td>
</tr>
<tr>
<td class="label">From</td>
<td>imu/sensor_error_0_s0</td>
</tr>
<tr>
<td class="label">To</td>
<td>packets/fifo_fifo_RAMREG_7_G[9]_s0</td>
</tr>
<tr>
<td class="label">Launch Clk</td>
<td>clk_50m:[R]</td>
</tr>
<tr>
<td class="label">Latch Clk</td>
<td>clk_50m:[R]</td>
</tr>
</table>
<p><b>Data Arrival Path:</b></p>
<table class="detail_table">
<tr>
<th class="label">AT</th>
<th class="label">DELAY</th>
<th class="label">TYPE</th>
<th class="label">RF</th>
<th class="label">FANOUT</th>
<th class="label">LOC</th>
<th>NODE</th>
</tr>
<tr>
<td>0.000</td>
<td>0.000</td>
<td></td>
<td></td>
<td></td>
<td></td>
<td>active clock edge time</td>
</tr>
<tr>
<td>0.000</td>
<td>0.000</td>
<td></td>
<td></td>
<td></td>
<td></td>
<td>clk_50m</td>
</tr>
<tr>
<td>0.000</td>
<td>0.000</td>
<td>tCL</td>
<td>RR</td>
<td>1</td>
<td>IOB29[A]</td>
<td>clk_50m_ibuf/I</td>
</tr>
<tr>
<td>1.046</td>
<td>1.046</td>
<td>tINS</td>
<td>RR</td>
<td>3385</td>
<td>IOB29[A]</td>
<td>clk_50m_ibuf/O</td>
</tr>
<tr>
<td>2.608</td>
<td>1.562</td>
<td>tNET</td>
<td>RR</td>
<td>1</td>
<td>R25C78[2][A]</td>
<td>imu/sensor_error_0_s0/CLK</td>
</tr>
<tr>
<td>2.914</td>
<td>0.306</td>
<td>tC2Q</td>
<td>RR</td>
<td>1</td>
<td>R25C78[2][A]</td>
<td style=" font-weight:bold;">imu/sensor_error_0_s0/Q</td>
</tr>
<tr>
<td>3.440</td>
<td>0.526</td>
<td>tNET</td>
<td>RR</td>
<td>1</td>
<td>R27C83[2][A]</td>
<td>fault_now_s9/I3</td>
</tr>
<tr>
<td>3.650</td>
<td>0.210</td>
<td>tINS</td>
<td>RR</td>
<td>2</td>
<td>R27C83[2][A]</td>
<td style=" background: #97FFFF;">fault_now_s9/F</td>
</tr>
<tr>
<td>5.145</td>
<td>1.495</td>
<td>tNET</td>
<td>RR</td>
<td>1</td>
<td>R14C52[2][A]</td>
<td>fault_now_s6/I2</td>
</tr>
<tr>
<td>5.566</td>
<td>0.421</td>
<td>tINS</td>
<td>RR</td>
<td>1</td>
<td>R14C52[2][A]</td>
<td style=" background: #97FFFF;">fault_now_s6/F</td>
</tr>
<tr>
<td>5.676</td>
<td>0.110</td>
<td>tNET</td>
<td>RR</td>
<td>1</td>
<td>R14C52[2][B]</td>
<td>fault_now_s2/I3</td>
</tr>
<tr>
<td>6.097</td>
<td>0.421</td>
<td>tINS</td>
<td>RR</td>
<td>10</td>
<td>R14C52[2][B]</td>
<td style=" background: #97FFFF;">fault_now_s2/F</td>
</tr>
<tr>
<td>6.229</td>
<td>0.132</td>
<td>tNET</td>
<td>RR</td>
<td>1</td>
<td>R14C53[1][A]</td>
<td>fault_now_s15/I3</td>
</tr>
<tr>
<td>6.642</td>
<td>0.413</td>
<td>tINS</td>
<td>RR</td>
<td>10</td>
<td>R14C53[1][A]</td>
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
<td>RR</td>
<td>28</td>
<td>R12C65[2][B]</td>
<td style=" background: #97FFFF;">packets/fifo_s6784/F</td>
</tr>
<tr>
<td>16.531</td>
<td>0.695</td>
<td>tNET</td>
<td>RR</td>
<td>1</td>
<td>R7C61[3][B]</td>
<td>packets/fifo_s6703/I0</td>
</tr>
<tr>
<td>16.948</td>
<td>0.417</td>
<td>tINS</td>
<td>RR</td>
<td>6</td>
<td>R7C61[3][B]</td>
<td style=" background: #97FFFF;">packets/fifo_s6703/F</td>
</tr>
<tr>
<td>17.112</td>
<td>0.164</td>
<td>tNET</td>
<td>RR</td>
<td>1</td>
<td>R7C59[3][A]</td>
<td>packets/fifo_s6508/I2</td>
</tr>
<tr>
<td>17.510</td>
<td>0.398</td>
<td>tINS</td>
<td>RR</td>
<td>6</td>
<td>R7C59[3][A]</td>
<td style=" background: #97FFFF;">packets/fifo_s6508/F</td>
</tr>
<tr>
<td>17.835</td>
<td>0.325</td>
<td>tNET</td>
<td>RR</td>
<td>1</td>
<td>R12C59[2][A]</td>
<td style=" font-weight:bold;">packets/fifo_fifo_RAMREG_7_G[9]_s0/CE</td>
</tr>
</table>
<p><b>Data Required Path:</b></p>
<table class="detail_table">
<tr>
<th class="label">AT</th>
<th class="label">DELAY</th>
<th class="label">TYPE</th>
<th class="label">RF</th>
<th class="label">FANOUT</th>
<th class="label">LOC</th>
<th>NODE</th>
</tr>
<tr>
<td>20.000</td>
<td>20.000</td>
<td></td>
<td></td>
<td></td>
<td></td>
<td>active clock edge time</td>
</tr>
<tr>
<td>20.000</td>
<td>0.000</td>
<td></td>
<td></td>
<td></td>
<td></td>
<td>clk_50m</td>
</tr>
<tr>
<td>20.000</td>
<td>0.000</td>
<td>tCL</td>
<td>RR</td>
<td>1</td>
<td>IOB29[A]</td>
<td>clk_50m_ibuf/I</td>
</tr>
<tr>
<td>21.046</td>
<td>1.046</td>
<td>tINS</td>
<td>RR</td>
<td>3385</td>
<td>IOB29[A]</td>
<td>clk_50m_ibuf/O</td>
</tr>
<tr>
<td>22.565</td>
<td>1.519</td>
<td>tNET</td>
<td>RR</td>
<td>1</td>
<td>R12C59[2][A]</td>
<td>packets/fifo_fifo_RAMREG_7_G[9]_s0/CLK</td>
</tr>
<tr>
<td>22.316</td>
<td>-0.249</td>
<td>tSu</td>
<td></td>
<td>1</td>
<td>R12C59[2][A]</td>
<td>packets/fifo_fifo_RAMREG_7_G[9]_s0</td>
</tr>
</table>
<p><b>Path Statistics:</b></p>
<table class="summary_table">
<tr>
<td class="label">Clock Skew</td>
<td>-0.044</td>
</tr>
<tr>
<td class="label">Setup Relationship </td>
<td>20.000</td>
</tr>
<tr>
<td class="label">Logic Level</td>
<td>20</td>
</tr>
<tr>
<td class="label">Arrival Clock Path Delay</td>
<td>cell: 1.046, 40.100%; route: 1.562, 59.900%</td>
</tr>
<tr>
<td class="label">Arrival Data Path Delay</td>
<td>cell: 7.113, 46.713%; route: 7.808, 51.277%; tC2Q: 0.306, 2.010%</td>
</tr>
<tr>
<td class="label">Required Clock Path Delay</td>
<td>cell: 1.046, 40.784%; route: 1.519, 59.216%</td>
</tr>
</table>
<h3>Path5</h3>
<p><b>Path Summary:</b></p>
<table class="summary_table">
<tr>
<td class="label">Slack</td>
<td>4.531</td>
</tr>
<tr>
<td class="label">Data Arrival Time</td>
<td>17.830</td>
</tr>
<tr>
<td class="label">Data Required Time</td>
<td>22.361</td>
</tr>
<tr>
<td class="label">From</td>
<td>imu/sensor_error_0_s0</td>
</tr>
<tr>
<td class="label">To</td>
<td>packets/fifo_fifo_RAMREG_31_G[8]_s0</td>
</tr>
<tr>
<td class="label">Launch Clk</td>
<td>clk_50m:[R]</td>
</tr>
<tr>
<td class="label">Latch Clk</td>
<td>clk_50m:[R]</td>
</tr>
</table>
<p><b>Data Arrival Path:</b></p>
<table class="detail_table">
<tr>
<th class="label">AT</th>
<th class="label">DELAY</th>
<th class="label">TYPE</th>
<th class="label">RF</th>
<th class="label">FANOUT</th>
<th class="label">LOC</th>
<th>NODE</th>
</tr>
<tr>
<td>0.000</td>
<td>0.000</td>
<td></td>
<td></td>
<td></td>
<td></td>
<td>active clock edge time</td>
</tr>
<tr>
<td>0.000</td>
<td>0.000</td>
<td></td>
<td></td>
<td></td>
<td></td>
<td>clk_50m</td>
</tr>
<tr>
<td>0.000</td>
<td>0.000</td>
<td>tCL</td>
<td>RR</td>
<td>1</td>
<td>IOB29[A]</td>
<td>clk_50m_ibuf/I</td>
</tr>
<tr>
<td>1.046</td>
<td>1.046</td>
<td>tINS</td>
<td>RR</td>
<td>3385</td>
<td>IOB29[A]</td>
<td>clk_50m_ibuf/O</td>
</tr>
<tr>
<td>2.608</td>
<td>1.562</td>
<td>tNET</td>
<td>RR</td>
<td>1</td>
<td>R25C78[2][A]</td>
<td>imu/sensor_error_0_s0/CLK</td>
</tr>
<tr>
<td>2.914</td>
<td>0.306</td>
<td>tC2Q</td>
<td>RR</td>
<td>1</td>
<td>R25C78[2][A]</td>
<td style=" font-weight:bold;">imu/sensor_error_0_s0/Q</td>
</tr>
<tr>
<td>3.440</td>
<td>0.526</td>
<td>tNET</td>
<td>RR</td>
<td>1</td>
<td>R27C83[2][A]</td>
<td>fault_now_s9/I3</td>
</tr>
<tr>
<td>3.650</td>
<td>0.210</td>
<td>tINS</td>
<td>RR</td>
<td>2</td>
<td>R27C83[2][A]</td>
<td style=" background: #97FFFF;">fault_now_s9/F</td>
</tr>
<tr>
<td>5.145</td>
<td>1.495</td>
<td>tNET</td>
<td>RR</td>
<td>1</td>
<td>R14C52[2][A]</td>
<td>fault_now_s6/I2</td>
</tr>
<tr>
<td>5.566</td>
<td>0.421</td>
<td>tINS</td>
<td>RR</td>
<td>1</td>
<td>R14C52[2][A]</td>
<td style=" background: #97FFFF;">fault_now_s6/F</td>
</tr>
<tr>
<td>5.676</td>
<td>0.110</td>
<td>tNET</td>
<td>RR</td>
<td>1</td>
<td>R14C52[2][B]</td>
<td>fault_now_s2/I3</td>
</tr>
<tr>
<td>6.097</td>
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
<td>1</td>
<td>R13C63[3][A]</td>
<td>packets/fifo_s6805/I2</td>
</tr>
<tr>
<td>14.833</td>
<td>0.332</td>
<td>tINS</td>
<td>RR</td>
<td>57</td>
<td>R13C63[3][A]</td>
<td style=" background: #97FFFF;">packets/fifo_s6805/F</td>
</tr>
<tr>
<td>16.140</td>
<td>1.307</td>
<td>tNET</td>
<td>RR</td>
<td>1</td>
<td>R8C57[3][A]</td>
<td>packets/fifo_s6847/I2</td>
</tr>
<tr>
<td>16.472</td>
<td>0.332</td>
<td>tINS</td>
<td>RR</td>
<td>6</td>
<td>R8C57[3][A]</td>
<td style=" background: #97FFFF;">packets/fifo_s6847/F</td>
</tr>
<tr>
<td>16.945</td>
<td>0.473</td>
<td>tNET</td>
<td>RR</td>
<td>1</td>
<td>R9C61[0][A]</td>
<td>packets/fifo_s6532/I3</td>
</tr>
<tr>
<td>17.366</td>
<td>0.421</td>
<td>tINS</td>
<td>RR</td>
<td>6</td>
<td>R9C61[0][A]</td>
<td style=" background: #97FFFF;">packets/fifo_s6532/F</td>
</tr>
<tr>
<td>17.830</td>
<td>0.464</td>
<td>tNET</td>
<td>RR</td>
<td>1</td>
<td>R8C57[0][A]</td>
<td style=" font-weight:bold;">packets/fifo_fifo_RAMREG_31_G[8]_s0/CE</td>
</tr>
</table>
<p><b>Data Required Path:</b></p>
<table class="detail_table">
<tr>
<th class="label">AT</th>
<th class="label">DELAY</th>
<th class="label">TYPE</th>
<th class="label">RF</th>
<th class="label">FANOUT</th>
<th class="label">LOC</th>
<th>NODE</th>
</tr>
<tr>
<td>20.000</td>
<td>20.000</td>
<td></td>
<td></td>
<td></td>
<td></td>
<td>active clock edge time</td>
</tr>
<tr>
<td>20.000</td>
<td>0.000</td>
<td></td>
<td></td>
<td></td>
<td></td>
<td>clk_50m</td>
</tr>
<tr>
<td>20.000</td>
<td>0.000</td>
<td>tCL</td>
<td>RR</td>
<td>1</td>
<td>IOB29[A]</td>
<td>clk_50m_ibuf/I</td>
</tr>
<tr>
<td>21.046</td>
<td>1.046</td>
<td>tINS</td>
<td>RR</td>
<td>3385</td>
<td>IOB29[A]</td>
<td>clk_50m_ibuf/O</td>
</tr>
<tr>
<td>22.610</td>
<td>1.564</td>
<td>tNET</td>
<td>RR</td>
<td>1</td>
<td>R8C57[0][A]</td>
<td>packets/fifo_fifo_RAMREG_31_G[8]_s0/CLK</td>
</tr>
<tr>
<td>22.361</td>
<td>-0.249</td>
<td>tSu</td>
<td></td>
<td>1</td>
<td>R8C57[0][A]</td>
<td>packets/fifo_fifo_RAMREG_31_G[8]_s0</td>
</tr>
</table>
<p><b>Path Statistics:</b></p>
<table class="summary_table">
<tr>
<td class="label">Clock Skew</td>
<td>0.002</td>
</tr>
<tr>
<td class="label">Setup Relationship </td>
<td>20.000</td>
</tr>
<tr>
<td class="label">Logic Level</td>
<td>19</td>
</tr>
<tr>
<td class="label">Arrival Clock Path Delay</td>
<td>cell: 1.046, 40.100%; route: 1.562, 59.900%</td>
</tr>
<tr>
<td class="label">Arrival Data Path Delay</td>
<td>cell: 6.616, 43.463%; route: 8.300, 54.526%; tC2Q: 0.306, 2.010%</td>
</tr>
<tr>
<td class="label">Required Clock Path Delay</td>
<td>cell: 1.046, 40.073%; route: 1.564, 59.927%</td>
</tr>
</table>
<h3>Path6</h3>
<p><b>Path Summary:</b></p>
<table class="summary_table">
<tr>
<td class="label">Slack</td>
<td>4.531</td>
</tr>
<tr>
<td class="label">Data Arrival Time</td>
<td>17.830</td>
</tr>
<tr>
<td class="label">Data Required Time</td>
<td>22.361</td>
</tr>
<tr>
<td class="label">From</td>
<td>imu/sensor_error_0_s0</td>
</tr>
<tr>
<td class="label">To</td>
<td>packets/fifo_fifo_RAMREG_31_G[4]_s0</td>
</tr>
<tr>
<td class="label">Launch Clk</td>
<td>clk_50m:[R]</td>
</tr>
<tr>
<td class="label">Latch Clk</td>
<td>clk_50m:[R]</td>
</tr>
</table>
<p><b>Data Arrival Path:</b></p>
<table class="detail_table">
<tr>
<th class="label">AT</th>
<th class="label">DELAY</th>
<th class="label">TYPE</th>
<th class="label">RF</th>
<th class="label">FANOUT</th>
<th class="label">LOC</th>
<th>NODE</th>
</tr>
<tr>
<td>0.000</td>
<td>0.000</td>
<td></td>
<td></td>
<td></td>
<td></td>
<td>active clock edge time</td>
</tr>
<tr>
<td>0.000</td>
<td>0.000</td>
<td></td>
<td></td>
<td></td>
<td></td>
<td>clk_50m</td>
</tr>
<tr>
<td>0.000</td>
<td>0.000</td>
<td>tCL</td>
<td>RR</td>
<td>1</td>
<td>IOB29[A]</td>
<td>clk_50m_ibuf/I</td>
</tr>
<tr>
<td>1.046</td>
<td>1.046</td>
<td>tINS</td>
<td>RR</td>
<td>3385</td>
<td>IOB29[A]</td>
<td>clk_50m_ibuf/O</td>
</tr>
<tr>
<td>2.608</td>
<td>1.562</td>
<td>tNET</td>
<td>RR</td>
<td>1</td>
<td>R25C78[2][A]</td>
<td>imu/sensor_error_0_s0/CLK</td>
</tr>
<tr>
<td>2.914</td>
<td>0.306</td>
<td>tC2Q</td>
<td>RR</td>
<td>1</td>
<td>R25C78[2][A]</td>
<td style=" font-weight:bold;">imu/sensor_error_0_s0/Q</td>
</tr>
<tr>
<td>3.440</td>
<td>0.526</td>
<td>tNET</td>
<td>RR</td>
<td>1</td>
<td>R27C83[2][A]</td>
<td>fault_now_s9/I3</td>
</tr>
<tr>
<td>3.650</td>
<td>0.210</td>
<td>tINS</td>
<td>RR</td>
<td>2</td>
<td>R27C83[2][A]</td>
<td style=" background: #97FFFF;">fault_now_s9/F</td>
</tr>
<tr>
<td>5.145</td>
<td>1.495</td>
<td>tNET</td>
<td>RR</td>
<td>1</td>
<td>R14C52[2][A]</td>
<td>fault_now_s6/I2</td>
</tr>
<tr>
<td>5.566</td>
<td>0.421</td>
<td>tINS</td>
<td>RR</td>
<td>1</td>
<td>R14C52[2][A]</td>
<td style=" background: #97FFFF;">fault_now_s6/F</td>
</tr>
<tr>
<td>5.676</td>
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
<td style=" background: #97FFFF;">packets/fifo_s6799/F</td>
</tr>
<tr>
<td>14.501</td>
<td>0.235</td>
<td>tNET</td>
<td>RR</td>
<td>1</td>
<td>R13C63[3][A]</td>
<td>packets/fifo_s6805/I2</td>
</tr>
<tr>
<td>14.833</td>
<td>0.332</td>
<td>tINS</td>
<td>RR</td>
<td>57</td>
<td>R13C63[3][A]</td>
<td style=" background: #97FFFF;">packets/fifo_s6805/F</td>
</tr>
<tr>
<td>16.140</td>
<td>1.307</td>
<td>tNET</td>
<td>RR</td>
<td>1</td>
<td>R8C57[3][A]</td>
<td>packets/fifo_s6847/I2</td>
</tr>
<tr>
<td>16.472</td>
<td>0.332</td>
<td>tINS</td>
<td>RR</td>
<td>6</td>
<td>R8C57[3][A]</td>
<td style=" background: #97FFFF;">packets/fifo_s6847/F</td>
</tr>
<tr>
<td>16.945</td>
<td>0.473</td>
<td>tNET</td>
<td>RR</td>
<td>1</td>
<td>R9C61[0][A]</td>
<td>packets/fifo_s6532/I3</td>
</tr>
<tr>
<td>17.366</td>
<td>0.421</td>
<td>tINS</td>
<td>RR</td>
<td>6</td>
<td>R9C61[0][A]</td>
<td style=" background: #97FFFF;">packets/fifo_s6532/F</td>
</tr>
<tr>
<td>17.830</td>
<td>0.464</td>
<td>tNET</td>
<td>RR</td>
<td>1</td>
<td>R8C57[1][B]</td>
<td style=" font-weight:bold;">packets/fifo_fifo_RAMREG_31_G[4]_s0/CE</td>
</tr>
</table>
<p><b>Data Required Path:</b></p>
<table class="detail_table">
<tr>
<th class="label">AT</th>
<th class="label">DELAY</th>
<th class="label">TYPE</th>
<th class="label">RF</th>
<th class="label">FANOUT</th>
<th class="label">LOC</th>
<th>NODE</th>
</tr>
<tr>
<td>20.000</td>
<td>20.000</td>
<td></td>
<td></td>
<td></td>
<td></td>
<td>active clock edge time</td>
</tr>
<tr>
<td>20.000</td>
<td>0.000</td>
<td></td>
<td></td>
<td></td>
<td></td>
<td>clk_50m</td>
</tr>
<tr>
<td>20.000</td>
<td>0.000</td>
<td>tCL</td>
<td>RR</td>
<td>1</td>
<td>IOB29[A]</td>
<td>clk_50m_ibuf/I</td>
</tr>
<tr>
<td>21.046</td>
<td>1.046</td>
<td>tINS</td>
<td>RR</td>
<td>3385</td>
<td>IOB29[A]</td>
<td>clk_50m_ibuf/O</td>
</tr>
<tr>
<td>22.610</td>
<td>1.564</td>
<td>tNET</td>
<td>RR</td>
<td>1</td>
<td>R8C57[1][B]</td>
<td>packets/fifo_fifo_RAMREG_31_G[4]_s0/CLK</td>
</tr>
<tr>
<td>22.361</td>
<td>-0.249</td>
<td>tSu</td>
<td></td>
<td>1</td>
<td>R8C57[1][B]</td>
<td>packets/fifo_fifo_RAMREG_31_G[4]_s0</td>
</tr>
</table>
<p><b>Path Statistics:</b></p>
<table class="summary_table">
<tr>
<td class="label">Clock Skew</td>
<td>0.002</td>
</tr>
<tr>
<td class="label">Setup Relationship </td>
<td>20.000</td>
</tr>
<tr>
<td class="label">Logic Level</td>
<td>19</td>
</tr>
<tr>
<td class="label">Arrival Clock Path Delay</td>
<td>cell: 1.046, 40.100%; route: 1.562, 59.900%</td>
</tr>
<tr>
<td class="label">Arrival Data Path Delay</td>
<td>cell: 6.616, 43.463%; route: 8.300, 54.526%; tC2Q: 0.306, 2.010%</td>
</tr>
<tr>
<td class="label">Required Clock Path Delay</td>
<td>cell: 1.046, 40.073%; route: 1.564, 59.927%</td>
</tr>
</table>
<h3>Path7</h3>
<p><b>Path Summary:</b></p>
<table class="summary_table">
<tr>
<td class="label">Slack</td>
<td>4.531</td>
</tr>
<tr>
<td class="label">Data Arrival Time</td>
<td>17.830</td>
</tr>
<tr>
<td class="label">Data Required Time</td>
<td>22.361</td>
</tr>
<tr>
<td class="label">From</td>
<td>imu/sensor_error_0_s0</td>
</tr>
<tr>
<td class="label">To</td>
<td>packets/fifo_fifo_RAMREG_31_G[1]_s0</td>
</tr>
<tr>
<td class="label">Launch Clk</td>
<td>clk_50m:[R]</td>
</tr>
<tr>
<td class="label">Latch Clk</td>
<td>clk_50m:[R]</td>
</tr>
</table>
<p><b>Data Arrival Path:</b></p>
<table class="detail_table">
<tr>
<th class="label">AT</th>
<th class="label">DELAY</th>
<th class="label">TYPE</th>
<th class="label">RF</th>
<th class="label">FANOUT</th>
<th class="label">LOC</th>
<th>NODE</th>
</tr>
<tr>
<td>0.000</td>
<td>0.000</td>
<td></td>
<td></td>
<td></td>
<td></td>
<td>active clock edge time</td>
</tr>
<tr>
<td>0.000</td>
<td>0.000</td>
<td></td>
<td></td>
<td></td>
<td></td>
<td>clk_50m</td>
</tr>
<tr>
<td>0.000</td>
<td>0.000</td>
<td>tCL</td>
<td>RR</td>
<td>1</td>
<td>IOB29[A]</td>
<td>clk_50m_ibuf/I</td>
</tr>
<tr>
<td>1.046</td>
<td>1.046</td>
<td>tINS</td>
<td>RR</td>
<td>3385</td>
<td>IOB29[A]</td>
<td>clk_50m_ibuf/O</td>
</tr>
<tr>
<td>2.608</td>
<td>1.562</td>
<td>tNET</td>
<td>RR</td>
<td>1</td>
<td>R25C78[2][A]</td>
<td>imu/sensor_error_0_s0/CLK</td>
</tr>
<tr>
<td>2.914</td>
<td>0.306</td>
<td>tC2Q</td>
<td>RR</td>
<td>1</td>
<td>R25C78[2][A]</td>
<td style=" font-weight:bold;">imu/sensor_error_0_s0/Q</td>
</tr>
<tr>
<td>3.440</td>
<td>0.526</td>
<td>tNET</td>
<td>RR</td>
<td>1</td>
<td>R27C83[2][A]</td>
<td>fault_now_s9/I3</td>
</tr>
<tr>
<td>3.650</td>
<td>0.210</td>
<td>tINS</td>
<td>RR</td>
<td>2</td>
<td>R27C83[2][A]</td>
<td style=" background: #97FFFF;">fault_now_s9/F</td>
</tr>
<tr>
<td>5.145</td>
<td>1.495</td>
<td>tNET</td>
<td>RR</td>
<td>1</td>
<td>R14C52[2][A]</td>
<td>fault_now_s6/I2</td>
</tr>
<tr>
<td>5.566</td>
<td>0.421</td>
<td>tINS</td>
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
<td>tINS</td>
<td>RR</td>
<td>10</td>
<td>R14C52[2][B]</td>
<td style=" background: #97FFFF;">fault_now_s2/F</td>
</tr>
<tr>
<td>6.229</td>
<td>0.132</td>
<td>tNET</td>
<td>RR</td>
<td>1</td>
<td>R14C53[1][A]</td>
<td>fault_now_s15/I3</td>
</tr>
<tr>
<td>6.642</td>
<td>0.413</td>
<td>tINS</td>
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
