WeieeGRACE/Embodied_RPACS/asrpro/records/tianwen_compile_20261023/current_window.png

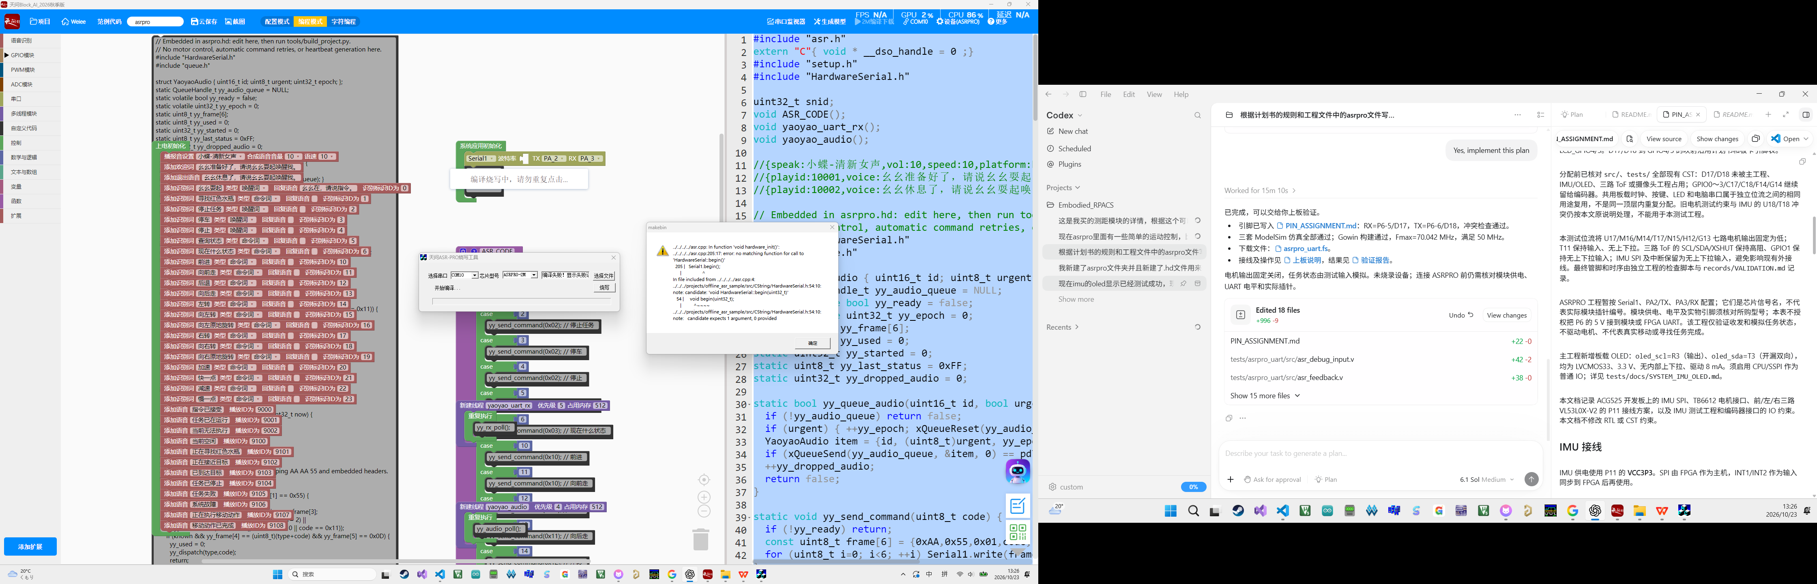
asrpro/records/tianwen_compile_20261023/current_window.png
