WeieeGRACE/Embodied_RPACS/asrpro/records/tianwen_compile_20261023/new_2026/gui_compile_error.png

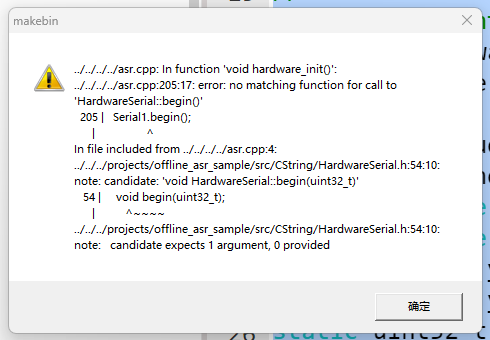
asrpro/records/tianwen_compile_20261023/new_2026/gui_compile_error.png
