WeieeGRACE/Embodied_RPACS/records/main_20261023/oled_root.png

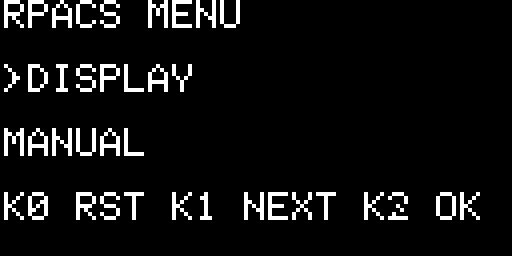
records/main_20261023/oled_root.png
