WeieeGRACE/Embodied_RPACS/records/main_20261023/oled_tof.png

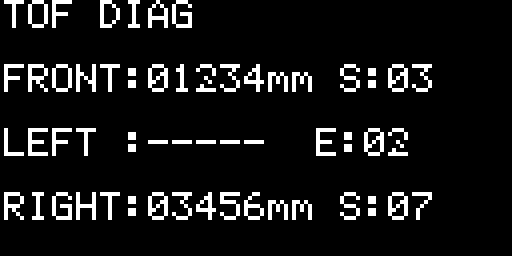
records/main_20261023/oled_tof.png
