WeieeGRACE/Embodied_RPACS/records/main_20261023/oled_voice.png

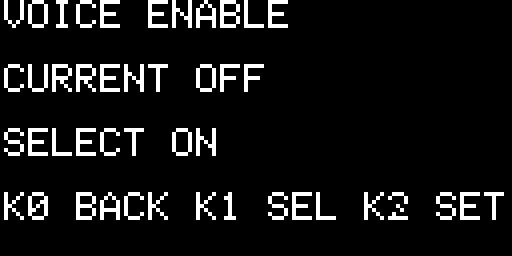
records/main_20261023/oled_voice.png
