WeieeGRACE/Embodied_RPACS/asrpro/release/yaoyao_asrpro_2m_20261025_obstacle/model/user_file/cmd_info/[60000]{cmd_info}.xlsx

Sheet: <0>cmd
模型名 | 模型ID | 命令词 | 命令词ID | 命令词语义ID | 置信度 | 唤醒词 | 组合词 | 期望词 | 不期望词 | 特殊词计数 | 播报音类型 | 播报音0ID | 播报音1ID | ...
DNN ID | 0 | 幺幺耍起 | 0 | 0x00 | 35 | YES | NO | NO | NO | 0 | 自定义 | 0
ASR ID | 0 | 停止任务 | 2 | 0x00 | 35 | YES | NO | NO | NO | 0 | 自定义 | 25
 |  | 停车 | 3 | 0x00 | 41 | YES | NO | NO | NO | 0 | 自定义 | 25
 |  | 停止 | 4 | 0x00 | 41 | YES | NO | NO | NO | 20 | 自定义 | 25
 |  | 退出避障模式 | 25 | 0x00 | 32 | YES | NO | NO | NO | 0 | 自定义 | 25
 |  | 寻找红色水瓶 | 1 | 0x00 | 32 | NO | NO | NO | NO | 0 | 自定义 | 25
 |  | 查询状态 | 5 | 0x1E487C1 | 35 | NO | NO | NO | NO | 0 | 自定义 | 25
 |  | 现在什么状态 | 6 | 0x00 | 32 | NO | NO | NO | NO | 0 | 自定义 | 25
 |  | 前进 | 10 | 0x00 | 41 | NO | NO | NO | NO | 0 | 自定义 | 25
 |  | 向前走 | 11 | 0x00 | 39 | NO | NO | NO | NO | 0 | 自定义 | 25
 |  | 后退 | 12 | 0x00 | 41 | NO | NO | NO | NO | 0 | 自定义 | 25
 |  | 向后走 | 13 | 0x00 | 39 | NO | NO | NO | NO | 0 | 自定义 | 25
 |  | 左转 | 14 | 0x00 | 41 | NO | NO | NO | NO | 14 | 自定义 | 25
 |  | 向左转 | 15 | 0x1E45D01 | 39 | NO | NO | NO | NO | 12 | 自定义 | 25
 |  | 向左原地旋转 | 16 | 0x00 | 32 | NO | NO | NO | NO | 0 | 自定义 | 25
 |  | 右转 | 17 | 0x00 | 41 | NO | NO | NO | NO | 14 | 自定义 | 25
 |  | 向右转 | 18 | 0x1E45D41 | 39 | NO | NO | NO | NO | 12 | 自定义 | 25
 |  | 向右原地旋转 | 19 | 0x00 | 32 | NO | NO | NO | NO | 0 | 自定义 | 25
 |  | 加速 | 20 | 0x00 | 41 | NO | NO | NO | NO | 0 | 自定义 | 25
 |  | 快一点 | 21 | 0x00 | 39 | NO | NO | NO | NO | 0 | 自定义 | 25
 |  | 减速 | 22 | 0x00 | 41 | NO | NO | NO | NO | 0 | 自定义 | 25
 |  | 慢一点 | 23 | 0x00 | 39 | NO | NO | NO | NO | 0 | 自定义 | 25
 |  | 避障模式 | 24 | 0x00 | 35 | NO | NO | NO | NO | 20 | 自定义 | 25
 |  | <welcome> | 10001 | 0x00 | 0 | NO | NO | NO | NO | 0 | 自定义 | 10001
 |  | <inactivate> | 10002 | 0x00 | 0 | NO | NO | NO | NO | 0 | 自定义 | 10002
 |  | <beep> | 10003 | 0x00 | 0 | NO | NO | NO | NO | 0 | 自定义 | 10003
 |  | P1 | 9000 | 0 | 0 | NO | NO | NO | NO | 0 | 自定义 | 9000
 |  | P1 | 9001 | 0 | 0 | NO | NO | NO | NO | 0 | 自定义 | 9001
 |  | P1 | 9002 | 0 | 0 | NO | NO | NO | NO | 0 | 自定义 | 9002
 |  | P1 | 9100 | 0 | 0 | NO | NO | NO | NO | 0 | 自定义 | 9100
 |  | P1 | 9101 | 0 | 0 | NO | NO | NO | NO | 0 | 自定义 | 9101
 |  | P1 | 9103 | 0 | 0 | NO | NO | NO | NO | 0 | 自定义 | 9103
 |  | P1 | 9104 | 0 | 0 | NO | NO | NO | NO | 0 | 自定义 | 9104
 |  | P1 | 9105 | 0 | 0 | NO | NO | NO | NO | 0 | 自定义 | 9105
 |  | P1 | 9106 | 0 | 0 | NO | NO | NO | NO | 0 | 自定义 | 9106
 |  | P1 | 9108 | 0 | 0 | NO | NO | NO | NO | 0 | 自定义 | 9108
 |  | P1 | 9201 | 0 | 0 | NO | NO | NO | NO | 0 | 自定义 | 9201
 |  | P1 | 9300 | 0 | 0 | NO | NO | NO | NO | 0 | 自定义 | 9300
 |  | P1 | 9301 | 0 | 0 | NO | NO | NO | NO | 0 | 自定义 | 9301
 |  | P1 | 9302 | 0 | 0 | NO | NO | NO | NO | 0 | 自定义 | 9302
 |  | P1 | 9303 | 0 | 0 | NO | NO | NO | NO | 0 | 自定义 | 9303

Sheet: <1>wake_multi
模型名 | 模型ID | 命令词 | 命令词ID | 命令词语义ID | 置信度 | 唤醒词 | 组合词 | 期望词 | 不期望词 | 特殊词计数 | 播报音类型 | 播报音0ID | 播报音1ID | ...
DNN ID | 0 | 幺幺耍起 | 0 | 0x00 | 35 | YES | NO | NO | NO | 0 | 自定义 | 0
ASR ID | 1 | 停止任务 | 2 | 0x00 | 35 | YES | NO | NO | NO | 0 | 自定义 | 25
 |  | 停车 | 3 | 0x00 | 41 | YES | NO | NO | NO | 0 | 自定义 | 25
 |  | 停止 | 4 | 0x00 | 41 | YES | NO | NO | NO | 0 | 自定义 | 25
 |  | 退出避障模式 | 25 | 0x00 | 32 | YES | NO | NO | NO | 0 | 自定义 | 25
 |  | <welcome> | 10001 | 0x00 | 0 | NO | NO | NO | NO | 0 | 自定义 | 10001
 |  | <inactivate> | 10002 | 0x00 | 0 | NO | NO | NO | NO | 0 | 自定义 | 10002
 |  | <beep> | 10003 | 0x00 | 0 | NO | NO | NO | NO | 0 | 自定义 | 10003
 |  | P1 | 9000 | 0 | 0 | NO | NO | NO | NO | 0 | 自定义 | 9000
 |  | P1 | 9001 | 0 | 0 | NO | NO | NO | NO | 0 | 自定义 | 9001
 |  | P1 | 9002 | 0 | 0 | NO | NO | NO | NO | 0 | 自定义 | 9002
 |  | P1 | 9100 | 0 | 0 | NO | NO | NO | NO | 0 | 自定义 | 9100
 |  | P1 | 9101 | 0 | 0 | NO | NO | NO | NO | 0 | 自定义 | 9101
 |  | P1 | 9103 | 0 | 0 | NO | NO | NO | NO | 0 | 自定义 | 9103
 |  | P1 | 9104 | 0 | 0 | NO | NO | NO | NO | 0 | 自定义 | 9104
 |  | P1 | 9105 | 0 | 0 | NO | NO | NO | NO | 0 | 自定义 | 9105
 |  | P1 | 9106 | 0 | 0 | NO | NO | NO | NO | 0 | 自定义 | 9106
 |  | P1 | 9108 | 0 | 0 | NO | NO | NO | NO | 0 | 自定义 | 9108
 |  | P1 | 9201 | 0 | 0 | NO | NO | NO | NO | 0 | 自定义 | 9201
 |  | P1 | 9300 | 0 | 0 | NO | NO | NO | NO | 0 | 自定义 | 9300
 |  | P1 | 9301 | 0 | 0 | NO | NO | NO | NO | 0 | 自定义 | 9301
 |  | P1 | 9302 | 0 | 0 | NO | NO | NO | NO | 0 | 自定义 | 9302
 |  | P1 | 9303 | 0 | 0 | NO | NO | NO | NO | 0 | 自定义 | 9303

Sheet: <1>wake_single
模型名 | 模型ID | 命令词 | 命令词ID | 命令词语义ID | 置信度 | 唤醒词 | 组合词 | 期望词 | 不期望词 | 特殊词计数 | 播报音类型 | 播报音0ID | 播报音1ID | ...
DNN ID | 0 | 幺幺耍起 | 0 | 0x00 | 35 | YES | NO | NO | NO | 0 | 自定义 | 0
ASR ID | 1 | <welcome> | 10001 | 0x00 | 0 | NO | NO | NO | NO | 0 | 自定义 | 10001
 |  | <inactivate> | 10002 | 0x00 | 0 | NO | NO | NO | NO | 0 | 自定义 | 10002
 |  | <beep> | 10003 | 0x00 | 0 | NO | NO | NO | NO | 0 | 自定义 | 10003
 |  | P1 | 9000 | 0 | 0 | NO | NO | NO | NO | 0 | 自定义 | 9000
 |  | P1 | 9001 | 0 | 0 | NO | NO | NO | NO | 0 | 自定义 | 9001
 |  | P1 | 9002 | 0 | 0 | NO | NO | NO | NO | 0 | 自定义 | 9002
 |  | P1 | 9100 | 0 | 0 | NO | NO | NO | NO | 0 | 自定义 | 9100
 |  | P1 | 9101 | 0 | 0 | NO | NO | NO | NO | 0 | 自定义 | 9101
 |  | P1 | 9103 | 0 | 0 | NO | NO | NO | NO | 0 | 自定义 | 9103
 |  | P1 | 9104 | 0 | 0 | NO | NO | NO | NO | 0 | 自定义 | 9104
 |  | P1 | 9105 | 0 | 0 | NO | NO | NO | NO | 0 | 自定义 | 9105
 |  | P1 | 9106 | 0 | 0 | NO | NO | NO | NO | 0 | 自定义 | 9106
 |  | P1 | 9108 | 0 | 0 | NO | NO | NO | NO | 0 | 自定义 | 9108
 |  | P1 | 9201 | 0 | 0 | NO | NO | NO | NO | 0 | 自定义 | 9201
 |  | P1 | 9300 | 0 | 0 | NO | NO | NO | NO | 0 | 自定义 | 9300
 |  | P1 | 9301 | 0 | 0 | NO | NO | NO | NO | 0 | 自定义 | 9301
 |  | P1 | 9302 | 0 | 0 | NO | NO | NO | NO | 0 | 自定义 | 9302
 |  | P1 | 9303 | 0 | 0 | NO | NO | NO | NO | 0 | 自定义 | 9303

Sheet: <2>wake_single
模型名 | 模型ID | 命令词 | 命令词ID | 命令词语义ID | 置信度 | 唤醒词 | 组合词 | 期望词 | 不期望词 | 特殊词计数 | 播报音类型 | 播报音0ID | 播报音1ID | ...
DNN ID | 0 | 停止任务 | 2 | 0x00 | 35 | YES | NO | NO | NO | 0 | 自定义 | 25
ASR ID | 2 | <welcome> | 10001 | 0x00 | 0 | NO | NO | NO | NO | 0 | 自定义 | 10001
 |  | <inactivate> | 10002 | 0x00 | 0 | NO | NO | NO | NO | 0 | 自定义 | 10002
 |  | <beep> | 10003 | 0x00 | 0 | NO | NO | NO | NO | 0 | 自定义 | 10003
 |  | P1 | 9000 | 0 | 0 | NO | NO | NO | NO | 0 | 自定义 | 9000
 |  | P1 | 9001 | 0 | 0 | NO | NO | NO | NO | 0 | 自定义 | 9001
 |  | P1 | 9002 | 0 | 0 | NO | NO | NO | NO | 0 | 自定义 | 9002
 |  | P1 | 9100 | 0 | 0 | NO | NO | NO | NO | 0 | 自定义 | 9100
 |  | P1 | 9101 | 0 | 0 | NO | NO | NO | NO | 0 | 自定义 | 9101
 |  | P1 | 9103 | 0 | 0 | NO | NO | NO | NO | 0 | 自定义 | 9103
 |  | P1 | 9104 | 0 | 0 | NO | NO | NO | NO | 0 | 自定义 | 9104
 |  | P1 | 9105 | 0 | 0 | NO | NO | NO | NO | 0 | 自定义 | 9105
 |  | P1 | 9106 | 0 | 0 | NO | NO | NO | NO | 0 | 自定义 | 9106
 |  | P1 | 9108 | 0 | 0 | NO | NO | NO | NO | 0 | 自定义 | 9108
 |  | P1 | 9201 | 0 | 0 | NO | NO | NO | NO | 0 | 自定义 | 9201
 |  | P1 | 9300 | 0 | 0 | NO | NO | NO | NO | 0 | 自定义 | 9300
 |  | P1 | 9301 | 0 | 0 | NO | NO | NO | NO | 0 | 自定义 | 9301
 |  | P1 | 9302 | 0 | 0 | NO | NO | NO | NO | 0 | 自定义 | 9302
 |  | P1 | 9303 | 0 | 0 | NO | NO | NO | NO | 0 | 自定义 | 9303

Sheet: <3>wake_single
模型名 | 模型ID | 命令词 | 命令词ID | 命令词语义ID | 置信度 | 唤醒词 | 组合词 | 期望词 | 不期望词 | 特殊词计数 | 播报音类型 | 播报音0ID | 播报音1ID | ...
DNN ID | 0 | 停车 | 3 | 0x00 | 41 | YES | NO | NO | NO | 0 | 自定义 | 25
ASR ID | 3 | <welcome> | 10001 | 0x00 | 0 | NO | NO | NO | NO | 0 | 自定义 | 10001
 |  | <inactivate> | 10002 | 0x00 | 0 | NO | NO | NO | NO | 0 | 自定义 | 10002
 |  | <beep> | 10003 | 0x00 | 0 | NO | NO | NO | NO | 0 | 自定义 | 10003
 |  | P1 | 9000 | 0 | 0 | NO | NO | NO | NO | 0 | 自定义 | 9000
 |  | P1 | 9001 | 0 | 0 | NO | NO | NO | NO | 0 | 自定义 | 9001
 |  | P1 | 9002 | 0 | 0 | NO | NO | NO | NO | 0 | 自定义 | 9002
 |  | P1 | 9100 | 0 | 0 | NO | NO | NO | NO | 0 | 自定义 | 9100
 |  | P1 | 9101 | 0 | 0 | NO | NO | NO | NO | 0 | 自定义 | 9101
 |  | P1 | 9103 | 0 | 0 | NO | NO | NO | NO | 0 | 自定义 | 9103
 |  | P1 | 9104 | 0 | 0 | NO | NO | NO | NO | 0 | 自定义 | 9104
 |  | P1 | 9105 | 0 | 0 | NO | NO | NO | NO | 0 | 自定义 | 9105
 |  | P1 | 9106 | 0 | 0 | NO | NO | NO | NO | 0 | 自定义 | 9106
 |  | P1 | 9108 | 0 | 0 | NO | NO | NO | NO | 0 | 自定义 | 9108
 |  | P1 | 9201 | 0 | 0 | NO | NO | NO | NO | 0 | 自定义 | 9201
 |  | P1 | 9300 | 0 | 0 | NO | NO | NO | NO | 0 | 自定义 | 9300
 |  | P1 | 9301 | 0 | 0 | NO | NO | NO | NO | 0 | 自定义 | 9301
 |  | P1 | 9302 | 0 | 0 | NO | NO | NO | NO | 0 | 自定义 | 9302
 |  | P1 | 9303 | 0 | 0 | NO | NO | NO | NO | 0 | 自定义 | 9303

Sheet: <4>wake_single
模型名 | 模型ID | 命令词 | 命令词ID | 命令词语义ID | 置信度 | 唤醒词 | 组合词 | 期望词 | 不期望词 | 特殊词计数 | 播报音类型 | 播报音0ID | 播报音1ID | ...
DNN ID | 0 | 停止 | 4 | 0x00 | 41 | YES | NO | NO | NO | 0 | 自定义 | 25
ASR ID | 4 | <welcome> | 10001 | 0x00 | 0 | NO | NO | NO | NO | 0 | 自定义 | 10001
 |  | <inactivate> | 10002 | 0x00 | 0 | NO | NO | NO | NO | 0 | 自定义 | 10002
 |  | <beep> | 10003 | 0x00 | 0 | NO | NO | NO | NO | 0 | 自定义 | 10003
 |  | P1 | 9000 | 0 | 0 | NO | NO | NO | NO | 0 | 自定义 | 9000
 |  | P1 | 9001 | 0 | 0 | NO | NO | NO | NO | 0 | 自定义 | 9001
 |  | P1 | 9002 | 0 | 0 | NO | NO | NO | NO | 0 | 自定义 | 9002
 |  | P1 | 9100 | 0 | 0 | NO | NO | NO | NO | 0 | 自定义 | 9100
 |  | P1 | 9101 | 0 | 0 | NO | NO | NO | NO | 0 | 自定义 | 9101
 |  | P1 | 9103 | 0 | 0 | NO | NO | NO | NO | 0 | 自定义 | 9103
 |  | P1 | 9104 | 0 | 0 | NO | NO | NO | NO | 0 | 自定义 | 9104
 |  | P1 | 9105 | 0 | 0 | NO | NO | NO | NO | 0 | 自定义 | 9105
 |  | P1 | 9106 | 0 | 0 | NO | NO | NO | NO | 0 | 自定义 | 9106
 |  | P1 | 9108 | 0 | 0 | NO | NO | NO | NO | 0 | 自定义 | 9108
 |  | P1 | 9201 | 0 | 0 | NO | NO | NO | NO | 0 | 自定义 | 9201
 |  | P1 | 9300 | 0 | 0 | NO | NO | NO | NO | 0 | 自定义 | 9300
 |  | P1 | 9301 | 0 | 0 | NO | NO | NO | NO | 0 | 自定义 | 9301
 |  | P1 | 9302 | 0 | 0 | NO | NO | NO | NO | 0 | 自定义 | 9302
 |  | P1 | 9303 | 0 | 0 | NO | NO | NO | NO | 0 | 自定义 | 9303

Sheet: <5>wake_single
模型名 | 模型ID | 命令词 | 命令词ID | 命令词语义ID | 置信度 | 唤醒词 | 组合词 | 期望词 | 不期望词 | 特殊词计数 | 播报音类型 | 播报音0ID | 播报音1ID | ...
DNN ID | 0 | 退出避障模式 | 25 | 0x00 | 32 | YES | NO | NO | NO | 0 | 自定义 | 25
ASR ID | 5 | <welcome> | 10001 | 0x00 | 0 | NO | NO | NO | NO | 0 | 自定义 | 10001
 |  | <inactivate> | 10002 | 0x00 | 0 | NO | NO | NO | NO | 0 | 自定义 | 10002
 |  | <beep> | 10003 | 0x00 | 0 | NO | NO | NO | NO | 0 | 自定义 | 10003
 |  | P1 | 9000 | 0 | 0 | NO | NO | NO | NO | 0 | 自定义 | 9000
 |  | P1 | 9001 | 0 | 0 | NO | NO | NO | NO | 0 | 自定义 | 9001
 |  | P1 | 9002 | 0 | 0 | NO | NO | NO | NO | 0 | 自定义 | 9002
 |  | P1 | 9100 | 0 | 0 | NO | NO | NO | NO | 0 | 自定义 | 9100
 |  | P1 | 9101 | 0 | 0 | NO | NO | NO | NO | 0 | 自定义 | 9101
 |  | P1 | 9103 | 0 | 0 | NO | NO | NO | NO | 0 | 自定义 | 9103
 |  | P1 | 9104 | 0 | 0 | NO | NO | NO | NO | 0 | 自定义 | 9104
 |  | P1 | 9105 | 0 | 0 | NO | NO | NO | NO | 0 | 自定义 | 9105
 |  | P1 | 9106 | 0 | 0 | NO | NO | NO | NO | 0 | 自定义 | 9106
 |  | P1 | 9108 | 0 | 0 | NO | NO | NO | NO | 0 | 自定义 | 9108
 |  | P1 | 9201 | 0 | 0 | NO | NO | NO | NO | 0 | 自定义 | 9201
 |  | P1 | 9300 | 0 | 0 | NO | NO | NO | NO | 0 | 自定义 | 9300
 |  | P1 | 9301 | 0 | 0 | NO | NO | NO | NO | 0 | 自定义 | 9301
 |  | P1 | 9302 | 0 | 0 | NO | NO | NO | NO | 0 | 自定义 | 9302
 |  | P1 | 9303 | 0 | 0 | NO | NO | NO | NO | 0 | 自定义 | 9303
