WeieeGRACE/Embodied_RPACS/tests/records/2026-10-19_system_oled_build_evidence.txt

Saved main-project build: 2026-10-19 23:36:58 Asia/Shanghai; Gowin 1.9.12; GW5A-LV25UG324C2/I1
Clock constraint 50 MHz; Fmax 54.703 MHz; setup slack 1.719 ns; hold slack 0.258 ns; zero setup/hold violations and TNS.

FullName      : D:\Gowin\Project\Contest\Embodied_RPACS\Embodied_RPACS\Embodied_RPACS\impl\pnr\Embodied_RPACS.fs
Length        : 6174044
LastWriteTime : 2026/10/19 23:36:58

Hash : 81CD06CC97BCB4A1700C7187218FEE91FF1D856C95E72F83556F8C6C22B57F36
Path : D:\Gowin\Project\Contest\Embodied_RPACS\Embodied_RPACS\Embodied_RPACS\impl\pnr\Embodied_RPACS.fs

set SSPI regular_io = true
set CPU regular_io = true
-global_freq 50.000

  --------------------------------------------------------------------------------
  Resources                   | Usage                               | Utilization
  --------------------------------------------------------------------------------
  Logic                       | 8466/23040                          |  37%
    --LUT,ALU,ROM16           | 8466(6883 LUT, 1583 ALU, 0 ROM16)   | -
    --SSRAM(RAM16)            | 0                                   | -
  Register                    | 3214/23685                          |  14%
    --Logic Register as Latch | 0/23040                             |  0%
    --Logic Register as FF    | 3203/23040                          |  14%
    --I/O Register as Latch   | 0/645                               |  0%
    --I/O Register as FF      | 11/645                              |  2%
  CLS                         | 5331/11520                          |  47%
  I/O Port                    | 30/222                              |  14%
  I/O Buf                     | 30                                  | -
    --Input Buf               | 13                                  | -
    --Output Buf              | 17                                  | -
    --Inout Buf               | 0                                   | -
  BSRAM                       | 4/56                                | 8%
    --pROM                    | 4
  DSP                         | 4/28                                | 15%
    --MULTALU27X18            | 4
  ================================================================================

PASS 30 unique constrained pins/electrical settings, OLED R3/T3, CPU/SSPI regular IO and saved 50 MHz options, T11 input/NONE, one top/CST/SDC, no camera, 64 position + 64 illegal counter bits, 99 IMU sample/status bits, one UART TX, four attitude DSPs, no PLL, zero setup/hold violations and TNS

Hash                                                             Path
----                                                             ----
81CD06CC97BCB4A1700C7187218FEE91FF1D856C95E72F83556F8C6C22B57F36 D:\Gowin\Project\Contest\Embodied_RPACS\Embodied_RPACS…
