WeieeGRACE/Embodied_RPACS/tests/asr_motion/records/manual_yaw_20261023.txt

« L=00000000 R=00000000 Y=00000000
« L=00000000 R=00000000 Y=00000000
« L=00000000 R=00000000 Y=00000000
« L=00000000 R=00000000 Y=00000000
« L=00000000 R=00000000 Y=00000000
« L=00000000 R=00000000 Y=00000014
« L=00000000 R=00000000 Y=0000001D
« L=00000000 R=00000000 Y=0000002B
« L=00000000 R=00000000 Y=0000003B
« L=00000000 R=00000000 Y=00000043
« L=00000000 R=00000000 Y=0000004E
« L=00000000 R=00000000 Y=00000060
« L=00000000 R=00000000 Y=0000006E
« L=00000000 R=00000000 Y=0000007A
« L=00000000 R=00000000 Y=0000008A
« L=00000000 R=00000000 Y=0000009A
« L=00000000 R=00000000 Y=000000A4
« L=00000000 R=00000000 Y=000000AF
« L=00000000 R=00000000 Y=000000BE
« L=00000000 R=00000000 Y=000000CD
« L=00000000 R=00000000 Y=000000DB
« L=00000000 R=00000000 Y=000000E7
« L=00000000 R=00000000 Y=000000F8
« L=00000000 R=00000000 Y=00000106
« L=00000000 R=00000000 Y=00000113
« L=00000000 R=00000000 Y=00000121
« L=00000000 R=00000000 Y=00000132
« L=00000000 R=00000000 Y=00000143
« L=00000000 R=00000000 Y=00000152
« L=00000000 R=00000000 Y=0000015E
« L=00000000 R=00000000 Y=0000016E
« L=00000000 R=00000000 Y=00000178
« L=00000000 R=00000000 Y=00000181
« L=00000000 R=00000000 Y=0000018E
« L=00000000 R=00000000 Y=00000192
« L=00000000 R=00000000 Y=00000196
« L=00000000 R=00000000 Y=000001AC
« L=00000000 R=00000000 Y=00000226
« L=00000000 R=00000000 Y=00000AF1
« L=00000000 R=00000000 Y=000023C8
« L=00000000 R=00000000 Y=00005375
« L=00000000 R=00000000 Y=000094A4
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
« L=00000000 R=0000000B Y=00000A1F
« L=00000000 R=0000000C Y=000008E4
« L=00000000 R=0000000B Y=00000943
« L=00000000 R=0000000B Y=0000092D
« L=00000000 R=0000000B Y=00000935
« L=00000000 R=0000000B Y=00000942
« L=00000000 R=0000000B Y=00000952
« L=00000000 R=0000000B Y=00000960
« L=00000000 R=0000000B Y=0000096C
« L=00000000 R=0000000B Y=0000097A
« L=00000000 R=0000000B Y=00000988
« L=00000000 R=0000000B Y=00000995
« L=00000000 R=0000000B Y=000009A0
« L=00000000 R=0000000B Y=000009AE
« L=00000000 R=0000000B Y=000009B5
« L=00000000 R=0000000B Y=000009C6
« L=00000000 R=0000000B Y=000009D4
« L=00000000 R=0000000B Y=000009E2
« L=00000000 R=0000000B Y=000009F1
« L=00000000 R=0000000B Y=000009FC
« L=00000000 R=0000000B Y=00000A09
« L=00000000 R=0000000B Y=00000A1E
« L=00000000 R=0000000B Y=00000A27
« L=00000000 R=0000000B Y=00000A37
« L=00000000 R=0000000B Y=00000A45
« L=00000000 R=0000000B Y=00000A50
« L=00000000 R=0000000B Y=00000A5B
« L=00000000 R=0000000B Y=00000A6B
« L=00000000 R=0000000B Y=00000A78
« L=00000000 R=0000000B Y=00000A82
« L=00000000 R=0000000B Y=00000A91
« L=00000000 R=0000000B Y=00000AA2
« L=00000000 R=0000000B Y=00000AAD
« L=00000000 R=0000000B Y=00000AB7
« L=00000000 R=0000000B Y=00000AC8
« L=00000000 R=0000000B Y=00000AD3
