WeieeGRACE/Embodied_RPACS/OBSTACLE_BOARD_TEST.md

# 持续避障整合版：上板测试

版本：2026-10-26 OA09 主工程整合版。FPGA：ACG525 / GW5A-LV25UG324C2/I1，50MHz；ASRPRO：2MB。
本次提供数字验证结果，尚未执行实际硬件测试或烧录。请按以下项目记录实际结果。

## 下载文件

- FPGA：交付包 `fpga/Embodied_RPACS.fs`（来源 `impl/pnr/Embodied_RPACS.fs`，
  SHA256 `901D7394146E472AF386E5BAB4092C5FD94B62245CF8666C471EDA38F7EAB14B`；
  6,228,180 字节，Logic 15445/68%、CLS 9407/84%、Fmax 55.050 MHz、0 违例）。
- P6-21 无线串口诊断位流（可选，`tests/p6_uart_debug/`）：`08DFDED3…F399E`
  （6,228,180 字节，Logic 15445/68%、CLS 9407/84%、Fmax 55.050 MHz），接法见文末“远程串口采集”。
- 本轮（22:59 之后）固件把让位/超车段的前向判障改为**连续 400 ms** 确认（滤掉箱角扫视场的
  单点坏数据），巡航仍按 130 mm 立即刹车；横移/超车距离与角度常量保持参考工程 300/300 mm。
- ASRPRO：交付包 `asrpro/fw.bin`，为含识别模型、音频、引导和应用的完整固件。
- 天问工程：交付包 `asrpro/asrpro.hd`。新增播放完成接口须使用项目的隔离SDK构建流程；重新生成代码后直接使用未补丁SDK链接会缺少该接口。
- 校验：交付包 `SHA256SUMS.txt`、`manifest.json`；数字记录 `validation/`。

两端须一起更新。FPGA和ASRPRO接线沿用现有配置：ASRPRO PA2/TX→FPGA D17，PA3/RX←FPGA D18，115200/8N1，共地。
完整管脚见 `PIN_ASSIGNMENT.md`。本版本不需要串口心跳。

## 首次启动

1. 先架空驱动轮，确认K0可立即关断电机，再放到有制动余量的平地。
2. 下载两端固件并重新上电，车体保持静止，等待IMU校准及READY。注意：本工程只烧 **SRAM**，
   断电后位流丢失，每次上电都要重新烧写；板子没电时 Gowin 扫描会报 `No Gowin devices found`
   （板测脚本 `-Program` 会先扫描并直接给出该提示）。
3. 语音默认OFF。用K1切换、K2选择，进入 SETTINGS → VOICE ENABLE，K1选ON、K2确认。K0返回。语音OFF时仍可用K2按键启动避障。
4. 主菜单选择 OBSTACLE AVOID，只打开面板。按K2后，在底盘、测距就绪且无故障时立即启动，后台播报不再阻塞电机；面板显示模式状态、档位、前/左/右距离和按键提示。
5. 距离采用四位十六进制mm：07D0=2000、012C=300、0082=130、0055=85；无效显示----。

## 逐项验收

| 编号 | 操作 | 预期结果 | 实测 |
|---|---|---|---|
| 01 | 语音OFF进入避障页并按K2 | 按键直接启动避障，不要求语音确认 | 待测 |
| 02 | 语音ON，避障页按K2 | 按键直接启动避障；语音播报不阻塞路线 | 待测 |
| 03 | 退出后唤醒“幺幺耍起”，说“避障模式” | OLED自动跳避障面板；完整播报后启动 | 待测 |
| 04 | 开启播报时说“停车”或按K0 | 不启动；迟到的播放完成不能使车启动 | 待测 |
| 05 | 断开ASRPRO回传线后按K2 | 等待播报确认，10秒后保持暂停；不运动 | 待测 |
| 06 | 巡航说加速/快一点、减速/慢一点 | 0.05/0.10/0.15m/s三档平滑变化，端点饱和 | 待测 |
| 07 | 前方逐步放置障碍，保留左侧空间 | 近障0.05m/s；130mm停车准备；播报一次“遇到障碍开始绕障” | 待测 |
| 08 | 完成左绕 | 包含横移及越过障碍后的各300mm；按实际横移回线、恢复朝向后播报一次“已绕过障碍物”，继续前进 | 待测 |
| 09 | 保留右侧空间、左侧受限 | 完成右绕；回线后继续前进 | 待测 |
| 10 | 连续放置第二个障碍 | 不重新启动；第二次分别播报开始和完成 | 待测 |
| 11 | 避障运行、等待或暂停时说加减速 | 忽略语音命令，不改变档位或路线，也不回“已接受” | 待测 |
| 12 | 避障运行、等待或暂停时说左转/右转/前进/后退 | 忽略语音命令；路线不被接管，板载按键仍可暂停或退出 | 待测 |
| 13 | 避障期间说暂停、恢复、退出或查询 | 均忽略；使用K2暂停/恢复、K0退出 | 待测 |
| 14 | 语音定量直行中加减速 | 当前速度平滑变化，累计里程及20cm目标保持 | 待测 |
| 15 | 语音旋转中加减速 | 旋转仍0.05m/s，只更新后续档位 | 待测 |
| 16 | 定量动作中再说运动口令 | 播报忙碌，不排队；动作完成后无补发 | 待测 |
| 17 | 避障运行、等待或暂停时说停车/停止 | 忽略语音命令；K2仍可暂停/恢复，K0退出 | 待测 |
| 18 | K2暂停后说前进/避障模式/恢复，或再次按K2 | 语音不恢复；仅K2按当前位置/朝向和新鲜测距恢复 | 待测 |
| 19 | 运行中按K2，再按K2 | 首次暂停；再次走播报确认流程恢复 | 待测 |
| 20 | 两侧均无绕行空间 | 停车等待；清出空间后以前进/避障模式/K2重新尝试 | 待测 |
| 21 | 任意阶段按K0 | 立即关断驱动，退出模式并返回主菜单；松开不恢复 | 待测 |
| 22 | 避障期间说退出避障模式 | 忽略语音退出；按K0退出并返回主菜单 | 待测 |
| 23 | 避障等待播报、运行或暂停时发送ASR控制命令 | 忽略控制命令；播放完成确认、路线播报和状态事件仍有效 | 待测 |
| 24 | 查询状态多次 | 不重复触发绕障开始/完成事件播报 | 待测 |
| 25 | 回归MANUAL（20cm/90°/SPIN 360）、SETTINGS、OBSTACLE AVOID、IMU ATTITUDE菜单 | 页面显示、动作与停止行为正常；SPIN 360 原地右转一圈后停稳；姿态页显示 ROLL/PITCH/YAW（校准中 CALIBRATING） | 待测 |
| 26 | 自主状态模拟测距/IMU持续故障（≥2 s） | 停车锁存，未复位前禁止运动；主菜单K0复位后重校准 | 待测 |
| 27 | 转向完成后 ToF 短暂异常/精确20 mm 读数 | 不再出现 FAULT；连续 2 次 20 mm 视为“测距完成但不可用”，barrier 放行后继续；不再做 XSHUT 重初始化 | 待测 |
| 28 | 转向后侧向有效近距 ≤85 mm（如 60 mm） | 不锁存传感器故障、也不再判“未就绪”拦死运动；路线按 `side_mm<=AVOID_MM` 走固定里程兜底进入 SHIFT（场景 7 已仿真覆盖 `near_shift=1`） | 待测 |
| 29 | 转向后侧向持续精确20 mm（截断确认） | 不锁存传感器故障；路线立即改走固定里程兜底（横移 500 mm + 额外 300 mm + 直行 600 mm + 额外 300 mm + 回线），不再停在 WAIT_PARALLEL | 待测 |
| 30 | 运行中故障（若仍出现） | 面板第一行记录 `F:xx S:xx M:xx I:xx` 四组诊断码，记录后 K0 复位 | 待测 |
| 31 | 转向后 PAUSED（若仍出现） | 面板第三行 `PAUSED R:xx Sxx Vx Ux`：R=route reason，S=route state，V=有效通道掩码，U=20 mm 截断确认掩码；按 K2 继续并记录该行 | 待测 |
| 32 | 连续避障 3–5 次 | 每次都能完整绕障并恢复巡航，无 FAULT、无 PAUSED（截断容错版目标） | 待测 |
| 33 | 检查接地 | IMU GND 不应经 T11/LCD_GPIO0 走线；IMU 与三路 ToF 用 P11-2 或 P6-12/P6-30 专用地星形一点接地（详见技术报告 4.4） | 待测 |

## 判读与记录

本轮稳定性修复后的判读要点：

- **瞬时异常不报 FAULT**：ToF 单次 NACK/短暂无数据、IMU 短暂错误、停稳抖动等会先安全停车、
  自动重试或恢复；转向后测距不可用时优先走固定里程兜底，正常情况下不再进入 `PAUSED`
  （若仍出现，按 K2 可继续；看到 PAUSED 不是故障）。
- **持续异常才锁存 FAULT**：通道连续 2 s 失败/通信丢失、IMU 连续 2 s 错误、编码器非法跳变、
  10 s 动作超时、ASR 发送溢出、K0 急停等仍锁存，需要主菜单 K0 复位并重新校准 IMU。
- **故障诊断码**：故障时避障面板第一行显示 `F:xx S:xx M:xx I:xx`：
  `F`=route reason（0x84 转向后测距等待、0x85 重试耗尽、0x86 运动反复中止、0x80 系统故障），
  `S`=ToF 故障字（bit0/1/2 坏样本、bit3/4/5 通信丢失、bit6/7/8 数据过期），
  `M`=运动故障码（2 测速反馈、3 偏航反馈、4 动作超时、5 非法状态、6 状态机异常），`I`=IMU 错误码。
  记录 OLED 面板故障码并回填本轮记录（交付主位流已无调试串口，串口采集仅适用于已归档的 P6-21 诊断位流）。
- **20 mm 截断容错**：某通道连续 2 个精确 20 mm 视为“测距完成但目标过近/不可测”，
  不再丢弃等待、也不再 XSHUT 重初始化；它作为 barrier 的新鲜事件放行，并让路线改走
  固定里程兜底（500/300/600/300 mm + 按实际横移回线）。`U` 位即此确认掩码。

自主避障保留09版策略：600mm附近减速、130mm停车准备、转向侧严格>300mm。
安全巡航前距≥650mm连续3个新正常读数后解除近障限速。正常通信中的20不参与几何距离（保持上次有效值），
但连续 2 次即视为“本次测距完成”并作为转向后新鲜事件放行；障碍侧持续 20 时改走固定里程兜底。
转向后只对当前状态实际使用的通道做新鲜度等待与重试（详见 `TECHNICAL_REPORT.md` 3.6）。

语音接管按已确认要求使用原底盘保护，不使用ToF近距限制；已经锁存的故障仍禁止运动。
K0为当前页面返回/停止键，避障中直接退出；主菜单再按K0才软复位、关闭语音并重新校准。

记录每项通过/失败、三路距离、档位、路线方向及故障码。实际20cm/90°精度、制动余量、反光/黑色物体测距、扬声器回声及真实语音打断需要本轮上板确认。
本地仿真的传感器及电机是数字模型，不能替代这些实测。

> 2026-10-30 起交付主位流已删除 USB 事件日志与调试串口；以下采集步骤只对历史 P6-21 诊断位流
>（`08DFDED3…`，已归档，不再随主工程维护）有效。

## 远程串口采集（WCH-LinkW 无线串口）

如果演示时不想让电脑 USB 线拖在车上，可用 WCH-LinkW 的“无线串口调试助手”模式把
FPGA 调试串口无线转回电脑：

1. **接法（车端 WCH-LinkW）**：只接三根线——WCH-Link 的 **RX** ← FPGA 调试串口
   **V8（UART TX，115200 8N1，3.3 V）**、**GND ↔ GND**；目标板自带电源时**不要接 3V3/5V**
   （手册警告电源冲突）。WCH-Link 的 RX/TX 不做波特率检测，必须两端一致设为 115200。
2. **配对**：车端 WCH-LinkW 上电，与电脑端无线接收器配对成功（指示灯常亮/成功提示）；
   推荐距离 ≤10 m，远离路由器/微波炉等 2.4 GHz 干扰源。
3. **电脑端**：设备管理器出现 `WCH-Link SERIAL (COMxx)`（本机当前为 COM24）。本机实测为
   单个 WCH-Link USB 棒（杜邦线有线连接），同样使用该 COM 口；若用 LinkW 无线套装，
   额外确认收发端配对与供电。用只读方式采集：
   ```powershell
   ./tools/read_serial_log.ps1 -Port COM24 -Seconds 300 -Timestamped `
       -OutFile records/robustness_20261029/board_wchlink_run.log
   # 或一键烧写+采集+自动判定（已有串口时加 -Port COM24）：
   ./tools/board_obstacle_test.ps1 -Port COM24 -Seconds 300
   ```
4. **P6-21 无线串口位流（本仓库已备）**：主固件的调试串口在 V8（只连板载 CH9102F，
   P6/P11 排针未引出）。若不用板载 USB 口，可烧 `tests/p6_uart_debug/` 工程的位流
   `impl/pnr/Embodied_RPACS_p6uart.fs`：逻辑与主固件相同，仅把调试串口 TX 挪到
   **P6-21（GPIO18，FPGA 球 L12）**；接法为 **WCH-Link RX → P6-21**、
   **GND → P6-12 或 P6-30**，其余接线不变。当前位流 SHA256
   `08DFDED3A43359D8E1237C03751E5D1978A97AFA958ED7C8276291FE706F399E`
   （Logic 15445/68%、CLS 9407/84%，2026-10-29 21:14 随 PASS 兜底 + SPIN 360/姿态页
   功能重建）；P6-21 网络已按底板原理图第 5 页核对（NLGPIO18）。
   注意：板载 FT2CH 下载器的 COM15 未接 FPGA UART，不能用来抓日志。
   2026-10-29 18:15 已用板载 Gowin 下载器成功烧写过一次；功能更新后需重新烧写
   （SRAM 运行，每次断电重启都要重烧）。
5. **注意**：手册注明“调试功能和串口助手不能同时使用”——跑演示/采日志时不要再让
   WCH-Link 做调试/下载；烧写 FPGA 仍用 Gowin USB Cable（WCH-Link 不能烧 Gowin 器件）。
   无线链路可能丢少量字节，日志按整行解析（`tools/decode_debug_log.ps1` 可解码 `D` 行）；
   若出现乱码先确认波特率与共地。
6. **日志判定**：`./tools/board_obstacle_test.ps1 -Port COM24 -Seconds 300 -FailOnPause`
   （加 `-Program` 会先烧写）自动把 PAUSED 分为两类：`state=17/reason=0x8x` 记为**路由暂停**
   （演示失败），巡航中 K2 手动暂停单独统计；已抓好的日志可离线复核：
   `-AnalyzeOnly -Capture <log>`。
