WeieeGRACE/Embodied_RPACS/tests/t4_lite_drive/ROUTES.md

# 任务四路线（按地图墙位规划，可直接执行）

> 坐标来自 `task4_navigation/data/map_v1.json`（3×3 m，墙 30 cm，图片估算，可能有偏差）。
> 规划时墙按 150 mm 膨胀，折线用视线平滑，转向按“转完再直行”执行。
> 执行：`python3 route_run.py <文件> --speed 30`；每段开始自动清 STOP 锁存。

## A → B

文件：`tools/route1_A_to_B_plan.json`；总里程 **1719 mm**，转向 **10** 次。

| # | 动作 | 参数 |
| --- | --- | --- |
| 1 | 直行 | 175 mm |
| 2 | 弧线转向 | -45.0° |
| 3 | 直行 | 141 mm |
| 4 | 弧线转向 | -45.0° |
| 5 | 弧线转向 | -45.0° |
| 6 | 直行 | 389 mm |
| 7 | 弧线转向 | +45.0° |
| 8 | 直行 | 25 mm |
| 9 | 弧线转向 | +45.0° |
| 10 | 直行 | 424 mm |
| 11 | 弧线转向 | -45.0° |
| 12 | 弧线转向 | -45.0° |
| 13 | 直行 | 424 mm |
| 14 | 弧线转向 | +45.0° |
| 15 | 弧线转向 | +45.0° |
| 16 | 直行 | 141 mm |
| 17 | 弧线转向 | +45.0° |

## A → C

文件：`tools/route2_A_to_C_plan.json`；总里程 **2754 mm**，转向 **6** 次。

| # | 动作 | 参数 |
| --- | --- | --- |
| 1 | 直行 | 175 mm |
| 2 | 弧线转向 | -45.0° |
| 3 | 直行 | 177 mm |
| 4 | 弧线转向 | -45.0° |
| 5 | 弧线转向 | -45.0° |
| 6 | 直行 | 389 mm |
| 7 | 弧线转向 | +45.0° |
| 8 | 弧线转向 | +45.0° |
| 9 | 直行 | 1838 mm |
| 10 | 弧线转向 | +45.0° |
| 11 | 直行 | 175 mm |

## A → D

文件：`tools/route3_A_to_D_plan.json`；总里程 **4761 mm**，转向 **9** 次。

| # | 动作 | 参数 |
| --- | --- | --- |
| 1 | 转 | -8.1° |
| 2 | 直行 | 354 mm |
| 3 | 转 | -36.9° |
| 4 | 直行 | 283 mm |
| 5 | 转 | -45.0° |
| 6 | 直行 | 100 mm |
| 7 | 转 | -45.0° |
| 8 | 直行 | 707 mm |
| 9 | 转 | +45.0° |
| 10 | 直行 | 100 mm |
| 11 | 转 | +45.0° |
| 12 | 直行 | 1131 mm |
| 13 | 转 | +69.8° |
| 14 | 直行 | 1432 mm |
| 15 | 转 | +20.2° |
| 16 | 直行 | 354 mm |
| 17 | 转 | +45.0° |
| 18 | 直行 | 300 mm |

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
| 64 | 转 | +42.8° |
| 65 | 直行 | 1301 mm |
| 66 | 倒车 | 100 mm |
| 67 | 转 | +12.5° |
| 68 | 直行 | 559 mm |
| 69 | 转 | +34.7° |
| 70 | 直行 | 71 mm |
| 71 | 转 | +45.0° |
| 72 | 直行 | 900 mm |
| 73 | 转 | +90.0° |
| 74 | 直行 | 50 mm |
| 75 | 直行 | 50 mm |
| 76 | 直行 | 50 mm |
| 77 | 直行 | 50 mm |
