WeieeGRACE/Embodied_RPACS/tests/t4_lite_drive/TEST_PLAN_2026-10-31.md

# 2026-10-31 上板测试计划（t4_lite_drive）

> 今晚已把路线/程序/仿真/采集全部备好；**不烧写**，明天按本计划上板。
> 地图已更新为 **map v2**（中心十字改为两片拼、四臂各 300 mm），墙表由地图 JSON 自动生成，
> 全工程只有 `tests/task4_navigation/data/map_v1.json` 一份地图。

## 0. 出发前检查

- [ ] 位流：推荐先用**闭环版** `impl/pnr/t4_lite_top.fs`（SHA `57BE714A…65B7`）；若上板行为异常，
      回退**已硬件验证的开环版**（SHA `A55B465C…D2F0`，git 历史 214beb5）
- [ ] 下载线 + 笔记本；JTAG 楔死时**拔插 USB 或给 FPGA 断电重上电**
- [ ] Pi：网线接 FPGA eth0、深度相机 USB3、`ip addr` 有 192.168.0.1/24
- [ ] 卷尺、胶带（标起点/墙位）、KEY2 急停可用
- [ ] Pi 采集启动：`python3 ~/t4_tools/t4_logs.py start --serial /dev/ttyACM0 --camera`

## 1. 烧写 + 基本检查（5 分钟）

```bash
programmer_cli --device GW5A-25A --run 2 --fsFile <abs>\t4_lite_top.fs --cable "Gowin USB Cable(FT2CH)"
python3 ~/t4_tools/t4_lite_drive.py --link-check           # 期望 fault=0x20，enc 不漂
python3 ~/t4_tools/t4_lite_drive.py --measure-only          # 相机 vs 卷尺（偏差 <30 mm）
```

闭环版额外验证（若用闭环）：`t4_lite_drive.py --no-camera --target 300 --speed 50`，
看 telemetry `v_l/v_r ≈ 50`、里程 300±5。

## 2. 分段测试（每段之间人工摆车，最安全）

| # | 测试 | 命令（Pi） | 通过标准 |
| --- | --- | --- | --- |
| 1 | 直线 450 | `route_run.py seg1_forward_450.json --speed 30` | 450±10 mm，yaw ±3° |
| 2 | 直线 1000（陀螺仪保持） | `route_run.py seg2_forward_1000.json --speed 40` | 1000±15 mm，横向漂移 <60 mm |
| 3 | 左转 90 | `route_run.py seg3_turn_left90.json` | 90±4° |
| 4 | 右转 90 | `route_run.py seg4_turn_right90.json` | −90±4° |
| 5 | 转 180 | `route_run.py seg5_turn_180.json` | 180±5° |
| 6 | L 形 | `route_run.py seg6_L_shape.json --speed 30` | 两段各 ±15 mm，转 ±4° |
| 7 | U 形 | `route_run.py seg7_U_shape.json --speed 30` | 同上（需 ≥0.8 m 空间） |
| 8 | 面向墙停 120 | `route_run.py seg8_wall_stop_120.json` | 卷尺 120±15 mm |

## 3. 直巷路线测试（需场地实测墙位后再上；按地图会蹭墙）

`route1_A_to_B_plan` / `route2_A_to_C_plan` / `route3_A_to_D_plan` 已生成（含逐段转向表，见
`ROUTES.md`）。**按图片地图仿真，车体在转向点会擦墙（min clearance = 0）**，所以：
1. 先在场地用卷尺量 3–5 个关键墙位（中心十字四臂、B 区、D 区）；
2. 把实测坐标发我，我更新地图 JSON 并重新规划/仿真；
3. 再按 `route_run.py route1_A_to_B_plan.json --speed 30` 逐条试。
`route5_ABCDE_plan`（10.2 m / 21 转）同理，等地图校准后再跑。

## 4. 数据采集与回收

```bash
python3 ~/t4_tools/t4_logs.py status       # 采集是否在跑
python3 ~/t4_tools/t4_logs.py list         # 会话与大小
```
测试结束（或中途）回 PC 拉取并清理：
```powershell
powershell -ExecutionPolicy Bypass -File pull_logs.ps1 -DryRun   # 看有什么
powershell -ExecutionPolicy Bypass -File pull_logs.ps1           # 拉取→校验→清 Pi
```
采集在 Pi 本地，WiFi 断/无线串口掉都不影响；`events.log` 会记录链路中断与串口重连。

## 5. 需要记录的数据（明天回填）

| 项 | 值 |
| --- | --- |
| 闭环 50 mm/s 实测（v_l/v_r） | ____ |
| 左/右 90° 实测偏差 | ____ / ____ |
| 直线 1000 mm 终点误差 / 横向漂移 | ____ |
| 面向墙停车（卷尺） | ____ |
| 场地实测墙位（中心十字等） | ____ |

---

## 6. 补充（闭环版上电标定 + 逐条路线）

### 6.1 闭环位流标定（上电一次，自动）

```bash
python3 ~/t4_tools/closed_loop_calib.py
```
车放在前方 >=1.5 m 空旷处。脚本自动做：50/100 mm/s 直行 2 s 测速、左右转 1 s 测角速度与滑行，
输出 PASS/FAIL 并写 `calib.json`（`cmd_scale / turn_mag / turn_rate / turn_lead`），
之后 `route_run.py` / `run_segments.py` 会自动读取该标定。
若 VERDICT 为 CHECK，先看数据再决定是否换回开环位流。

### 6.2 分段编排（推荐顺序）

```bash
python3 ~/t4_tools/run_segments.py                 # 第 1-8 段，逐段提示
python3 ~/t4_tools/run_segments.py --start 5       # 从第 5 段继续
python3 ~/t4_tools/run_segments.py --only seg6_L_shape
```
结果写 `~/t4_logs/segments_YYYYmmdd_HHMMSS.json`；每段结束打印里程与航向变化。

### 6.3 逐条路线（A->B / A->C / A->D / A->E）

```bash
python3 ~/t4_tools/run_segments.py --suite routes --speed 25
```
每条都从 A 点出发（需要人工把车摆回 A）；按几何仿真这些路线**贴墙通过**
（确定性最小墙距 9-14 mm，见 `records/route_simulation.md`），务必低速 25、人手不离开 KEY2。
全部单条路线通过后，再考虑 `route_run.py route5_ABCDE_plan.json`
（10.2 m / 21 转，按当前地图在 B 点转向几乎贴墙，最后再试）。

### 6.4 逐条路线的预期最小墙距（整车轮廓仿真）

| 路线 | 段/转 | 总里程 | 最小墙距 | 说明 |
| --- | --- | --- | --- | --- |
| A→B | 23 段 / 11 转 | 3912 mm | **39 mm** | 终点 B 车头贴近 B_TOP（地图定义） |
| A→C | 14 / 7 | 4195 mm | **92 mm** | 走廊余量充足 |
| A→D | 20 / 10 | 4844 mm | **86 mm** | 走廊余量充足 |
| A→E | 47 / 10 | 6619 mm | **29 mm** | 终点 E 距 D_BOTTOM 仅 150 mm |
| A→B→C→D→E | — | — | 无法连续规划 | B 点车头距墙 40 mm，转不动；需分段换位 |

> 跑 A→B / A→E 时，最后 10-20 cm 要特别慢（或人工在终点前 20 cm 按停）。

---

## 7. 区域制达标标准（2026-10-31 更新，最终版）

- **每个路点都是 600x600 mm 区域**；达标 = 车头（前保险杠）停在区域中心 **300x300 mm** 内。
- 路线按"车头到中心"规划：接近方向
  - B / C：从南侧进入（车头朝 +Y）
  - D：从北侧进入（车头朝 -Y，区域在 D_BOTTOM 上方，出口只有上方）
  - E：从东侧进入（车头朝 -X，区域右侧开口）
- 路线文件（`tools/`，均已按此重规划，Pi 已同步）：

| 文件 | 目标 | 段数 | 里程 | 转向 | 仿真车头误差中值 |
| --- | --- | --- | --- | --- | --- |
| `route1_A_to_B_plan.json` | B 区域中心 | 22 | 3612 mm | 11 | 69 mm |
| `route2_A_to_C_plan.json` | C | 14 | 3895 mm | 7 | 85 mm |
| `route3_A_to_D_plan.json` | D | 18 | 4761 mm | 9 | 438 mm（误差大，需现场复核） |
| `route4_A_to_E_plan.json` | E | 41 | 6319 mm | 10 | 67 mm |
| `route5_ABCDE_plan.json` | 连续 A→B→C→D→E | 72 | 9755 mm | 21 | 126 mm |

说明：
- 连续 ABCDE 现在**可以规划**（不再是物理死角），但 72 段/21 转，误差累积大；
  仍按"先分段、每段 OK 再整条"执行。
- A→D 路线误差偏大，建议现场先跑并核对终点；如偏差大，我把 D 的进入方向改为从东侧再规划。
- 车头达标判据：`run_segments.py` 每段结束打印"里程 + 航向变化"，对照上表里程即可粗判；
  精确核对可用卷尺量车头到区域中心。

---

## 8. 轮轴位置与转向空间（2026-10-31 11:30 实测参数，重要）

实测：**驱动轮中心离车尾约 25 mm**（轮轴几乎在最尾端）。

因此（以轮轴为旋转中心）：
- 车头向前 **295 mm**（320−25）、车尾向后 25 mm、半宽 120 mm；
- **原地转向扫掠半径 = √(295²+120²) ≈ 319 mm** —— 几乎就是整车长度在转；
- 600 mm 走廊中心离墙 300 mm **< 319 mm → 走廊里原地转不开**；
- 只有开阔处（净空 ≥ ~0.8 m，或路口/区域外）才能原地转向。

对明天测试的影响：

1. **转向类测试（seg3/4/5）必须在场地开阔处做**（如场外空地、或 ≥0.8 m 净空的角落），
   不要在 600 走廊里试原地转，会蹭墙。
2. **路线测试用 `--manual-turn` 模式**：程序遇到转向段会提示
   "请把车原地转到 ±X°（相对当前车头），回车继续"，由人完成转向——
   里程/直行仍由程序精确执行，这样既不会蹭墙，又能把整条路线走完：
   ```bash
   python3 ~/t4_tools/run_segments.py --suite routes --speed 25 --manual-turn
   ```
3. 连续 ABCDE 同样用 `--manual-turn`（3 处倒车段程序会自动倒，转向由人完成）。
4. 我已经把地图假设更新为：`axle_from_rear_mm=25 / body_front_mm=295 / turn_sweep_radius_mm=318.5`，
   规划器/仿真使用同一几何。

后续可做（需要的话）：三点掉头（前进-倒车转向-前进）自动实现，这样在 600 走廊/路口里
可以不用人工转向；以及把"倒车到路口"做成自动序列。明天先在现场确认哪些路口净空 ≥0.8 m。

---

## 9. 三点掉头（自动段，2026-10-31 新增）

人工转向的替代方案，执行序列（绕轮轴）：
1. **前进弧**（vl=v+Δ, vr=v−Δ）转一部分角；
2. **倒车弧**（vl=−v+Δ, vr=−v−Δ）继续同向转；
3. **前进弧** 收尾到目标角。

参数在 `calib.json` 可调：`tp_v`（弧线速度，默认 40）、`tp_diff`（左右差速，默认 40）、
`tp_fracs`（三段比例，默认 [0.45,0.35,0.20]）；先空旷处标定再进走廊。

### 测试顺序（新增）

```bash
# 单段三点掉头（空旷处，前方/侧方各留 >=1 m）
python3 ~/t4_tools/run_segments.py --only seg9_threepoint_90
python3 ~/t4_tools/run_segments.py --only seg10_threepoint_180

# 路线：所有"原地转"改为三点掉头（倒车段仍自动）
python3 ~/t4_tools/run_segments.py --suite routes --speed 25 --three-point
python3 ~/t4_tools/run_segments.py --only route5_ABCDE_plan --speed 25 --three-point
```

### 调参方法（现场 2 分钟）

1. 空旷处跑 `seg9_threepoint_90`，看终点 yaw 误差与车体是否越界；
2. **转不够**：`tp_diff` 调大（35→50）或 `tp_fracs` 首段加大；
3. **转太多/蹭墙**：`tp_v` 调小（40→30）、`tp_diff` 调小；
4. 满意后把三个值写进 `~/t4_tools/calib.json`（键名 `tp_v/tp_diff/tp_fracs`），后续路线自动使用。

> 若 600 走廊里三点掉头也放不下，就退回 `--manual-turn`（人工转向），这是最保底的方式。

---

## 10. 弧线转向（边走边转，600 走廊可过）—— 最终推荐的转向方式

数值验证结果：在 600 mm 的 L 型路口，车以 **半径 200 mm 的弧线**边走边转 90°，
整车轮廓最小余量 **64.8 mm**（可行）；而原地转向扫掠半径 319 mm > 300 mm（不可行）。

执行原语：
- `arc_turn(deg)`：左右轮差速 `vl=v(1-track/2R)`, `vr=v(1+track/2R)`，绕 R 圆弧转到目标航向；
- 参数从 `calib.json` 读：`arc_radius`（默认 200）、`arc_v`（默认 60）、`wheel_track`（默认 240）。

测试与使用：

```bash
# 空旷处标定弧线转向（前方/侧向留 >=1 m）
python3 ~/t4_tools/run_segments.py --only seg11_arc_90        # 右转90 + 左转90 回原向
python3 ~/t4_tools/run_segments.py --only seg12_arc_L         # 直行300 + 弧线右转 + 直行300

# 路线：已按弧线转向重新规划（A->B / A->C / A->E）
python3 ~/t4_tools/run_segments.py --only route1_A_to_B_plan --speed 40 --arc
python3 ~/t4_tools/run_segments.py --only route2_A_to_C_plan --speed 40 --arc
python3 ~/t4_tools/run_segments.py --only route4_A_to_E_plan --speed 40 --arc
```

说明：
- 路线 JSON 里转向段的类型是 `{"type":"arc","deg":±45}`（每段 45°，两段=90°），执行器自动识别；
- A→D 和连续 ABCDE 目前用弧线规划不出完整路径（需要"倒车到更宽路口"的组合动作），
  保持旧文件/人工转向；等明天现场确认哪些路口净空最大后，我再补"倒车 + 弧线"的组合规划。
- 弧线半径与速度要现场标定：若压线就把 `arc_radius` 调大（200→260）或 `arc_v` 调小。
