WeieeGRACE/Embodied_RPACS/tests/task4_navigation/PLAN.md

# 任务四自主导航测试计划书

## 1. 文档目的与范围

本文规划任务四“从起点自主到达指定区域”的测试与后续实现，聚焦两个现场问题：IMU 陀螺仪零偏随时间和温度变化而产生航向漂移；纸板迷宫的实际墙段可能与地图中的理想水平、垂直方向存在厘米级位置和角度偏差。计划通过 IMU 与编码器进行短时位姿预测，并在地图能够确认墙面对应关系、ToF 数据有效且新鲜时，用测距信息作有限纠偏和安全停车判断。

本期先验证已知迷宫导航，不实现 SLAM、未知布局探索、在线建图或针对任意场地变化的在线全局重规划。临时障碍物触发停车并报告，不执行现有避障工程中的绕箱和回线动作。本文件是实施与验收计划，不是可直接烧录的运动指令；本次交付只包含本计划书，不包含 RTL、仿真脚本、地图数据、约束文件或构建文件。

## 2. 项目背景与现有基线

### 2.1 参考资料

- 场地名义布局：[`地图.jpg`](../../../../地图.jpg)，3 m × 3 m 迷宫纸板图。
- 项目总体任务、导航边界与初始验收设想：[`PROJECT_PLAN.md`](../../../../PROJECT_PLAN.md)。
- 起点、目标区、坐标系、路点和场地复测要求：[`TASK4_ROUTE_BOOK.md`](../../../../TASK4_ROUTE_BOOK.md)。其中已明确路线仍待核验，A—E 坐标是初始估值。
- IMU 姿态测试工程及其校准、航向积分限制：[`imu_attitude_oled/README.md`](../imu_attitude_oled/README.md)。
- 三路 ToF 避障工程、`20` 数据处理和实车遗留事项：[`obstacle_avoidance/README.md`](../obstacle_avoidance/README.md) 及其测试记录。

### 2.2 已有能力和限制

- IMU 姿态测试已验证启动时静止采样、零偏均值校准、静态漂移抑制及有符号相对航向积分。航向没有绝对参考，零偏校准之后的积分误差会随时间累积；启动校准不等于运行期间消除了温漂。
- 避障工程已有三路 ToF 驱动、结果检查、距离有效性及陈旧监测、运动控制和停车保护。现有数字验证与既有上板反馈可作为驱动和运动控制基线，但不能证明任务四定位精度、通道几何安全或路线重复成功率。现有工程是避障测试，不应直接当作迷宫导航器。
- 当前测距链路曾采用对恰好 `20 mm` 的读数不接纳并沿用历史值的策略。任务四不沿用这一策略：`20` 一律作为无效样本丢弃，历史值不更新，数据年龄继续增长，禁止该样本参与纠偏或建立新鲜测距状态。
- 现有说明记录了车体名义尺寸约 `320 mm × 240 mm`，并记录前向 ToF 发光面与车头齐平的安装情况；这些是规划参考，不足以确定驱动轴中点到四向外廓的距离、转弯扫掠边界或各传感器的实际视场。
- 目前可复用工程主要是纯 RTL 的 IMU、编码器、差速运动控制和 ToF/避障模块。任务四测试按纯 RTL 独立工程规划，不依赖尚未确认集成状态的软核导航固件；现有主工程及避障工程不在本轮修改范围内。

## 3. 目标、坐标与验收定义

### 3.1 导航目标

机器人从地图 A 区域的已知起点出发，按配置选择一个目标区，或依序访问 B、C、D、E。路径由已知地图给出；机器人使用轮式运动反馈和 IMU 航向跟踪路段，用有条件的 ToF 观测辅助保持与已知墙段的相对位置，并以独立安全保护停车。

### 3.2 坐标和目标点基线

沿用路书坐标约定：迷宫外框内侧左下角为原点，`+X` 向右、`+Y` 向上，单位为米；导航参考点为左右驱动轮轴线中点。起始航向以实际起步方向定义为 `0°`，左转为正、右转为负；实现须复用当前工程经验证的航向符号约定。

| 点位 | 当前规划坐标（m） | 状态 |
| --- | ---: | --- |
| A | (2.70, 0.30) | 起点名义值，须按场地标记核对 |
| B | (0.30, 1.00) | 目标区域中心估值，须核验 |
| C | (0.30, 2.40) | 目标区域中心估值，须核验 |
| D | (2.10, 2.40) | 目标区域中心估值，须核验 |
| E | (2.10, 1.65) | 目标区域中心估值，须核验 |

以上坐标用于定义名义路线与目标误差，不表示实际可行驶中心线已经测得。运行前须由地图图像、路书和可行走通道关系形成明确的路线段与转弯点；不得将 A/B 等目标点用直线简单相连后直接驱动车辆。

### 3.3 验收范围

- 单目标路线：A→B、A→C、A→D、A→E。
- 巡检路线：A→B→C→D→E；每站确认停车和到点后才进入下一段。
- 初始路线重复性目标：五条路线各独立执行 10 次，每条至少 9 次无碰撞到达；记录失败原因，不跳过未到达的站点。
- 到点以外部地面标记或量具检查驱动轴中点位置：距名义目标位置不超过 `100 mm`；最终停车航向误差不超过 `5°`。测量结果不得只使用机器人自身里程计。
- 任何保护停车、受阻或输入故障都不得报告 `DONE`。只有无法证明车体和转弯扫掠区域净空的路线报告 `BLOCKED`；安全条件优先于路线成功率目标。

## 4. 拟议导航架构

### 4.1 传感器与运动控制分工

- **编码器**：提供左右轮位移增量与行进距离，结合实测轮径、每圈计数和轮距计算差速运动增量。参数均以装车测量为准。
- **IMU**：使用经启动静止校准、符号统一和解缠后的 Z 轴航向/角速度，约束短时航向变化与转向停稳判断。IMU 积分是相对航向预测，不单独作为长期绝对位置基准。
- **ToF**：提供前、左、右距离和数据年龄。只有路线地图预先标记了可关联的墙面区段、距离范围合理且数据新鲜有效时，才允许用于局部位置或航向修正。ToF 安全停车判定和导航纠偏应有明确区分；纠偏关闭不能关闭安全停车。
- **差速运动控制**：导航只提交有上限的左右轮目标速度、路段/转向目标和停止请求，复用现有闭环、速度斜坡和故障/急停优先级；导航逻辑不直接操纵 PWM。
- **路线与监督**：任务状态需区分初始化、直行跟踪、减速停车、确认静止、转向、重新稳定、到点、完成及故障/受阻。每个阶段都有超时或无进展检测；故障停车后不得自行续行。

### 4.2 ToF 墙面观测的使用原则

地图为每个允许辅助定位的路段声明目标墙面、预计测距范围、传感器方向、墙段两端附近的禁用区域及样本有效条件。运行时仅对已声明的墙面使用测距；墙端、门洞、斜十字、隔板开口、转弯扫掠阶段、读数突变或墙面关联不确定时，关闭该段纠偏并使用 IMU/编码器预测。单次单点距离不能独立区分横向位置偏差与航向偏差；要估计趋势，须结合沿程的连续测量、编码器位移、墙段几何及一致性检查。观测只能小幅修正预测，不能因一个读数跳变直接重置位姿。

左右墙均被地图确认为近似平行且两侧测距可信时，可基于两侧间距估计相对居中误差；单侧墙面可信时，只能使用该侧的地图距离及沿程趋势作受限修正。对实际非平行墙，不将“左右距离必须相等”作为前提，也不把测距差直接当作航向误差。

每条直线段和转弯使用地图中对应的实测/标称墙段方向，不默认相邻路段必为精确 `90°`。路线转角由相邻段方向确定，并通过实际停稳航向反馈执行；无法从现有传感器与地图可靠确定的区段，应保守地降低速度、关闭纠偏或禁止执行。

### 4.3 温漂处理原则

启动前要求车体静止，完成 IMU 初始化、采样有效性检查和初始零偏估计；起步后连续记录 IMU 航向、编码器推算航向及两者差值。计划验证每条路线各路点的停稳姿态，以及连续运行/温度变化后相同基准动作的航向漂移。

在本计划的验证阶段，不把抵达路点时将累计航向直接清零作为温漂补偿。路点停稳后可采集静态 Z 轴角速度样本，评估其对当前零偏估计的影响；只有证明车体静止、样本稳定、坡度/振动不会产生误判，并通过回归测试后，才决定是否实施有界零偏更新。零偏更新不能改写历史累计角或伪造绝对朝向；墙面观测只能在地图关联可信时约束相对位姿。

温漂验收以记录到的实际误差及线路结果为依据，不假设 IMU 存在可用温度读数，也不把加速度计当作平面绝对航向传感器。若墙面观测无法提供可靠校正且累计航向误差超限，应停车并报告定位不可信，后续再评估独立参考或新增传感器。

## 5. 地图误差、净空与安全策略

### 5.1 墙体偏差建模

名义地图仍由现有 `地图.jpg` 与路书提供，A—E 点保持待核验估值。为容忍实际纸板位置、角度和搭建偏差，首版按每一条墙段两端点各自沿平面坐标方向允许 `±50 mm` 的位置不确定度建模；两端偏移组合形成的方向变化也必须纳入墙段角度范围。转成法向净空不确定度时，应对该端点扰动和整条墙段求保守包络，不能将“±50 mm”误当成所有方向上自动满足的 50 mm 净空。

对每条路线直行段、目标停车姿态和原地旋转过程进行车体外廓连续碰撞检查。外廓以驱动轴中点为基准，包含轮胎、传感器、支架等最外点，并纳入地图墙段不确定度、定位误差、测距误差及采样/控制/制动期间移动量。车体沿中心线可通过不代表绕轴旋转时车角也可通过；任何不确定包络相交或缺少必要测量时，路线标记为待核验或 `BLOCKED`，不得压缩安全余量强行通过。

地图可用不规则直线墙段表达，不要求输入成严格网格。路线方向、墙面关联和目标点需要在对应地图版本中一致记录；场地结构变化或地图误差超出首版假设时，先更新地图和离线验证，不在车上盲目重规划。

### 5.2 测距无效、过期和停车

- 接受距离 `20 mm` 视为错误/无效数据：丢弃该样本，不更新接受距离，不产生新鲜样本事件，不用于导航纠偏或解除停车状态。
- 任一路最后一次可信距离的年龄由真实有效样本更新时间计算。收到 `20` 不刷新该年龄。持续读数 `20` 最终与无数据或测距超时一样触发该路数据过期处理。
- 对前向必要保护数据、导航依赖的侧向数据分别设置最大数据年龄。数据过期、通信/完整性错误、传感器读数超出有效范围时，按经实测制动距离和当前速度选择减速或锁定停车；不使用过期距离授权继续贴墙行驶或转弯。
- 前方路径受阻时，任务四首版不调用障碍绕行脚本；若当前路线无已验证替代段，停车并报告 `BLOCKED`。暂时数据故障报告 `RANGE_FAULT`，IMU/编码器无效或位姿不可信报告 `INPUT_FAULT`，控制超时或无进展分别报告对应失败状态。
- 任何急停立即关闭驱动并保持锁定，故障消除后需显式复位、重新检查传感器与起点位姿，不能自动恢复运动。

现有工程的 `130 mm` 准备停车、`85 mm` 近距保护、`0.05–0.15 m/s` 档位以及其他阈值仅作历史基线，不直接继承为任务四数值。任务四在场地、当前速度、制动距离、ToF 安装偏移和车角扫掠条件下重新确定并记录前向减速/停车阈值、侧向边界、释放滞回、速度上限和数据年龄。

## 6. 计划工程边界与测试输出

计划建立独立目录 `Embodied_RPACS/Embodied_RPACS/tests/task4_navigation/`。本轮该目录内只创建本计划书。进入实现阶段后再依审查结果添加独立 Gowin RTL 工程、仿真、地图配置和记录文件；不得让任务四测试默认改写或替换主工程、现有避障工程、现有位流或既有测试证据。

实现阶段须记录并可复查：导航构建标识、地图版本、路线/目标、起点设置、控制参数、每路原始距离与接受值/有效性/数据年龄、IMU 零偏与航向、左右编码器增量/位置、当前状态与故障原因、停止位置和外部测量结果。板上日志不能阻塞硬件故障关断；复位前先保存故障现场。`20` 需在原始诊断字段中可见，同时明确它没有刷新有效距离与年龄。

## 7. 分阶段实施与测试计划

### 阶段 0：场地与传感器基线

1. 依据地图和路书确认通道连接关系，形成 A→目标/巡检所需的路段序列；现有目标点坐标继续标记为估值。
2. 测量驱动轴中点到车体前、后、左、右最外廓的距离及高度；记录车轮、传感器和支架的外伸部分。
3. 记录三路 ToF 的朝向、视场、传感器到车体外廓的偏移、近距盲区、纸板材料上的距离范围、重复性、刷新周期、异常/`20` 行为和通信故障延迟。
4. 测量各测试速度下从测距判定到完全停稳的距离和时间，覆盖直行、制动、原地旋转前停车以及低电量/电源状态变化；据此确定后续保护门槛和净空预算。
5. 依据墙段端点 ±50 mm 扰动和实测车体外廓做保守通道/转弯净空分析。输出每段可行、待复测或不可行结论；不可行路线先停止，不进入闭环运动测试。

### 阶段 1：纯数字 RTL 仿真

使用可控的 IMU、左右编码器和三路 ToF 模型验证数据流、导航状态及安全停机。至少覆盖：

- IMU 静止零偏、运行中慢变偏置/温漂、正负转向和航向符号；编码器正反向里程、左右轮差异、轮滑等扰动。
- 墙段不平行、墙端与开口、斜墙、两侧距离不相等及 ToF 回波跳变；错误关联时纠偏关闭，位姿不因单样本跳变。
- 正常数据和 `20` 交替、持续 `20`、通信超时、坏状态/无效距离、距离年龄到限；确认 `20` 不更新距离、不刷新年龄、不参与位置/航向修正，过期后进入安全状态。
- 位置/航向跟踪、停车、停稳检查、转向、重新稳定、目标判定和巡检顺序；模拟急停、看门狗、IMU/编码器故障和控制无进展。
- 前方障碍、临时障碍、通道无法验证或地图净空失败；确认车辆停稳并报告受阻/故障，绝不启动旧绕障或回线路径，也不误报到达。

仿真应断言输出速度和转向命令始终在限幅范围内、急停/锁存故障优先级最高、陈旧数据不能放行运动、路径失败不会被报告为成功。数字仿真验证控制逻辑，不代替光学精度和真实几何验收。

### 阶段 2：几何仿真与地图扰动

在地图墙段上对各墙段两端独立施加 `±50 mm` 位置扰动，检查斜率/方向变化、走廊最窄处、路点停靠及完整旋转扫掠；另加入车体尺寸、定位误差、ToF 误差和实测制动距离的保守边界。对全部五条验收路线逐段运行几何检查。

仿真报告需保留每个扰动场景的最小净空、对应墙段和转弯、外廓包络、碰撞/可达结论。净空不合格不得靠仿真成功率抵消；路线标为不可执行或要求先修正纸板/路线。几何模型本身要记录简化假设，不能声称已证明实际 ToF 光束锥、纸板柔性、车轮打滑及制动的全部物理行为。

### 阶段 3：架空底盘和单段上板

1. 架空驱动轮验证启动互锁、左右电机方向、编码器符号、航向符号、急停和失效保护。
2. 静止记录不同开机时长下 IMU 零偏和航向变化；不运动保持至少覆盖一次完整校准周期，确认静止采样的离散程度及异常运动拒绝条件。
3. 在开阔直墙段低速运行，对比 ToF 距离趋势、外部尺量位置、编码器距离和 IMU 航向；比较纠偏打开/关闭时偏差与稳定性。
4. 在不同墙体夹角和距离下确认地图墙段关联门槛能拒绝墙端、开口与反射变化，不能将左右墙误认为严格平行。
5. 注入/观察 `20`、遮挡、断开通信和过期场景，确认串口保留原始诊断，但无效样本不会更新有效距离年龄或继续驱动；核实停止距离后确定安全参数。

任何阶段出现车体擦墙、保护未及时关断、日志表明陈旧数据仍放行，立即停止更高速/整条路线验收，先定位问题并更新风险预算。

### 阶段 4：转弯和路线逐级验收

先在已验证开阔位置测试单次小角度及路线所需转角，确认停稳后航向误差与角速度/编码器一致性；再按下列顺序开展：A→B 单段/短路径、A→B 完整路线，其余单目标路线，最后四点巡检。每次行驶前核对地图版本、起点和朝向、静态校准完成、ToF 通道新鲜及安全余量；每次停靠后记录外部位置、实际航向、里程计误差、各 ToF 距离与年龄、零偏、状态、重试/故障原因。

目标验收各路线独立 10 次，至少 9 次无碰撞完成。任何碰撞或擦碰都判该路线验收失败；受控安全停车可计为未完成，而非碰撞成功。完整验收需报告到点与停车误差分布、成功/失败次数、最大温漂观测误差、误差最大的墙段/转弯，以及因通道净空不足被排除的路线。

## 8. 验收与回归标准

### 功能验收

- 单目标和巡检按目标顺序运行；各转弯停稳后进入正确下一段；没有跳过路点或误报 `DONE`。
- 墙面辅助纠偏仅在许可地图区段和新鲜可信样本启用；非平行墙、墙端、开口和异常反射不会触发无界纠偏或位姿重置。
- `20` 被丢弃，接受距离与年龄语义正确；新鲜数据不足时按规定限速/停车。
- 临时障碍或路线无安全替代路径时停车并报告 `BLOCKED`；测距、IMU、编码器、急停或控制超时按对应故障锁存，不能继续盲目前进。
- IMU 静态零偏、运行中航向差、各路点停稳观测均写入记录；是否采用停稳零偏更新必须有对照测试数据支撑。

### 性能验收

- 五条路线各重复 10 次，至少 9 次无碰撞到达。
- 每次通过的目标点，驱动轴中点外部测量位置误差不超过 `100 mm`，停车航向误差不超过 `5°`。
- 每条可执行路线通过地图扰动/车体扫掠检查；安全净空必须覆盖 ±50 mm 墙端点误差以及实际测得的定位、测距、采样、控制和制动误差。
- 最大速度和纠偏限幅取实测安全条件允许值，不预先保证 `0.15 m/s` 可用于所有窄道；速度须逐级提升，窄段与转向按实测制动/扫掠结果限制。

### 工程回归验收

- 新测试目录为独立 Gowin 工程和测试资产；已有主工程、避障工程、IMU 工程及其位流、参数、管脚约束与记录保持未改。
- 构建报告能追溯工程版本、源文件、管脚及时序结果；若生成板上位流，应核对源文件版本与构建产物一致。
- 测试记录清楚区分数字仿真、几何模型、台架结果和整车实测，不能用某一种结果替代其他验收。

## 9. 风险、限制及停车条件

1. **IMU 温漂未知**：若停稳零偏评估和可见墙面区段不足以将航向误差保持在 `5°` 以内，暂停相关路线验收，需重新评估导航参考手段或传感器配置。
2. **ToF 单点观测不充分**：一个侧向单点读数不能直接区分横移与车体偏航；如果连续沿程观测、地图关联与误差界限仍不充分，该段只能用作障碍/停车提示，不能宣称完成定位校正。
3. **墙面和目标测距物理误差**：纸板厚度、倾斜、颜色/材料、斜入射、传感器视场和串扰会引入误差；通信成功不等于量值准确。
4. **转弯外廓风险**：驱动轴中点旋转会让前后角扫掠较大。名义 600 mm 通道和 `320×240 mm` 外形不能独自证明净空，必须有实测四向外廓与扫掠验证。
5. **定位初始化误差**：A 点起点位置和朝向误差会进入整条路线误差预算；起点标定不满足路书约束时禁止启动。
6. **数据陈旧与 `20`**：反复收到 `20` 不表示仍测到安全墙距。相关数据达到年龄上限、通信中断或有效距离不足时，按保护策略停止。
7. **路线名义坐标不等于实际通道中心**：纸上图片和现有路书不足以精确给出真实墙段坐标。虽然首版按 ±50 mm 扰动评估，也不能涵盖超出该假设的所有搭建误差。
8. **故障后重启风险**：急停、定位失信和故障锁存后需人工确认环境、重新校准与显式启动，不能自动接续未完成动作。

任一项使安全净空、传感器新鲜度或位姿可信度无法证明时，默认停车并上报具体失败原因。修正地图、纸板摆放或硬件配置后，应更新地图版本及测试记录再重新验收。

## 10. 待实测/待确认参数清单

| 参数 | 当前状态 | 关闭方式 |
| --- | --- | --- |
| 车体轴线中点到前/后/左/右外廓 | 名义外形约 `320×240 mm`，实际偏置未知 | 包含轮胎、ToF、支架逐边测量 |
| 轴距/轮距、左右轮周长与编码器每圈有效计数 | 工程有历史默认值，实车误差未知 | 装车测量、轮子多圈往返标定 |
| A 起点真实位置及航向、各通道中心和墙段端点 | 路书坐标为估值；本期只以名义地图规划并容忍每端 ±50 mm | 通过起点定位线、墙段尺寸及现场照片/记录核验；标明不可测区 |
| ToF 实际安装偏移、朝向、视场、盲区与可测墙面 | 部分旧工程安装描述不可代替导航安装测量 | 记录各传感器光心/轴线相对车体基准与纸板实测表现 |
| ToF 重复性、斜入射误差、更新周期、故障延迟、`20` 发生率 | 数字驱动可运行，实际物理性能待测 | 不同距离、角度、材料及三路组合采样记录 |
| 各路最大允许数据年龄及失效状态 | 未定 | 按实际刷新间隔、控制延迟和制动预算确定并做故障注入 |
| 不同速度下停车距离、停车时间、转弯/车角扫掠净空 | 尚无充分整车数据 | 逐级低速测试、外部标记测量、几何复核 |
| 每段允许速度、启动/减速阈值、侧向保护、释放滞回 | 不继承旧工程阈值 | 结合路段最窄处、数据年龄和实测制动距离确定 |
| 地图纠偏许可区、墙面匹配门槛、纠偏限幅/增益 | 未验证 | 用实测位置与距离序列低速对照，覆盖墙端/开口误匹配 |
| IMU 启动静止校准稳定时间、静态噪声、运行温漂速率 | 仅有已有静态/短时校准基线 | 长时间静止与持续运行对照，记录温度（若可获得）、偏置和航向误差 |
| 路点停稳判据、停稳零偏更新幅度与条件 | 未决定；需先实验验证 | 对照更新前后重复路线误差；不改变历史累计航向 |
| A→B/C/D/E 与巡检的可执行路段及停靠朝向 | 现有路线待核验 | 地图连通、±50 mm 墙位扰动、车体外廓和转向扫掠联合评估 |

所有实测数值必须记录单位、条件、日期、地图/构建版本和测量方法；未知项不得用规划估值伪装成已验证参数。

## 11. 计划交付物

本轮交付：本文件 `tests/task4_navigation/PLAN.md`。

进入实现后，建议按审查结果另行增加：独立 RTL/仿真工程、地图及路线数据、传感器/运动日志格式、仿真和几何模型记录、上板校准表、每条路线验收记录及独立构建证据。是否创建和实现这些资产以本计划后续确认及实际环境探索为准；本计划本身不生成它们。
