WeieeGRACE/Embodied_RPACS/records/obstacle_20261025/VALIDATION.md

# 主工程与ASRPRO避障整合验证

版本：2026-10-26 OA09 integrated。验证时间：2026-10-26T01:47:19.254380+08:00。
本记录仅包含数字仿真、构建及资源检查。未烧录、未执行实车测试。

## 构建与管脚

- Gowin 1.9.12，GW5A-LV25UG324C2/I1，50MHz；build.tcl与保存工程verify_project.tcl均成功。
- 实际Fmax：50.379(MHz)；setup/hold违规均0，TNS为0；时序裕量较小，具体路径见随包timing报告。
- 44个唯一约束管脚、电气属性、10个开漏输出、CPU/SSPI复用GPIO、单一IMU/编码器/运动控制/PI/驱动实例检查通过。
- 工程及导出不引用历史tests目录；位流新于全部工程输入。
- FPGA位流SHA256：`c2e453b94a76d9a70cc9242de378d87986aa630f558f8315c3046742c3efa9db`。
- ASRPRO完整固件SHA256：`a612e72d21f58c14246ed8f74669d38066447993427a492f98a9ecdcc1546380`；1,622,062字节。

## 仿真验证（6组整机/接口 + 1组流水专测）

| 日志 | 验证范围 | 结果 |
|---|---|---|
| system.log | 全菜单、4项定量动作、8项8秒电机测试、K0、停止/导航/语音开关、测距恢复、IMU/速度/超时/溢出故障、事件输出 | PASS |
| system_oled.log | 完整OLED位图、设置、数据单位和有效性、新避障面板各状态及提示 | PASS |
| system_50mhz.log | 真实50MHz参数、115200、1MHz SPI、10ms测速、20kHz PWM、菜单启用语音和停止 | PASS |
| dispatch.log | 177项；播报门控、错误/过期/重置确认、超时、各路线阶段接管、无路暂停、优先级、原子缓冲取消后不补发 | PASS |
| live_speed.log | 9项；实时升降、斜坡步长、限速优先/解除、目标与里程不重置、暂停不运动 | PASS |
| obstacle.log | 菜单与语音启动门控、左右两次连续绕行、两段300mm、实际里程回线、事件次数、实时档位、语音接管/忙碌/后退/退出/K0 | PASS |
| attitude_pipeline.log | 姿态显示流水格式化、正负号、四舍五入与180度上限 | PASS |

全部最终日志以Errors: 0, Warnings: 0结束。整机长路线使用加速参数及独立PWM驱动电机/IMU模型、真实I2C/UART位级通信；50MHz独立套件验证生产时钟与接口参数。
障碍位置由测试脚本切换三路测距输入，未建立完整光学和真实场地模型。

## ASRPRO与实测边界

天问实际积木加载/保存/重开/代码生成通过；23条词、15段反馈音频、隔离SDK完整构建、190项运行测试及固件逐分区/资源验证通过。
SDK厂商警告及模型生成下载恢复记录见asrpro/validation/VALIDATION.md和相关日志；未宣称ASRPRO零警告。
实际识别、回声抑制、播报打断、电机标定、20cm/90°精度、制动余量和ToF物理表现均待用户上板。
逐项实测步骤见OBSTACLE_BOARD_TEST.md；所有实测栏保持“待测”。
