WeieeGRACE/Embodied_RPACS/tests/docs/SYSTEM_INTEGRATION.md

# 底盘基础控制集成与事件日志验证（2026-10-18）

2026-10-19 更新：主工程已集成姿态 OLED，运动启动新增“校准完成且姿态有效”条件，端口数为 30。最新操作与编译结果见 [IMU OLED 上板说明](SYSTEM_IMU_OLED.md)；下文资源、时序、哈希为 10 月 18 日历史记录。

## 实现与操作

`Embodied_RPACS.gprj` 唯一顶层为 `robot_system_top`，只使用一套 CST/SDC。集成 IMU、双轮编码器/测速、独立 PI、PWM 斜坡、TB6612 与 UART 心跳看门狗，不包含 camera、DDR、HDMI。独立测试工程和原有工作区修改保留。

- 50 MHz；IMU SPI 1 MHz，约 200 Hz 六轴原子采样。每秒在完整采样事务之间读取 ID 和错误寄存器。
- KEY1 按一次双轮前进 8 秒，左右目标均为 10 counts/10ms。运行期间松键或再次按键不改变动作；结束后须释放至少 10 ms 再按。
- 保留 10 ms 测速、4 窗滤波、KP=32/KI=1/KD=0、20 kHz PWM、625/2500 上限和每 PWM 周期 1 拍斜坡。编码器相序沿用通过的例程。
- KEY2 急停，KEY0 复位。IMU 初始化及首样本完成、无故障且收到过有效心跳后才允许运动。
- UART 为 115200/8N1，主机每 100 ms 发二进制 A5。首个有效心跳后，空闲或运行期间 500 ms 未刷新均锁存停机。错误字节和错误停止位不刷新。
- IMU 初始化错误、非零错误寄存器、运行中 ID 不符、ready 丢失或 ready 期间连续 100 ms 无新样本均锁存停机。自动重试成功、恢复心跳或释放急停均不能解除停机，须 KEY0 复位。
- 任一故障关闭两路 PWM、方向脚及 STBY；日志发送不参与安全关断路径。
- 内部 `imu_sample[95:0]` 按低位到高位保存 AX/AY/AZ/GX/GY/GZ，[97:96] 为同步中断状态，[98] 为 T11 输入。已验证保留 99 位快照、六轴数据以及左右各 32 位位置和非法跳变计数。

闭环模块新增 `SYSTEM_INTEGRATION=0`、`TELEMETRY_ENABLE=1`，默认保持独立例程行为。集成模式输入 `system_ready/system_fault` 及已同步释放的复位，输出心跳、看门狗及左右编码器故障状态。IMU 新增 `HEALTH_CHECK_CYCLES=0`，独立例程默认不启用运行健康检查。

## 引脚与精简日志

电机 AIN1=M16、BIN1=N15，IMU MISO=U18、CS=T18，其余严格按 `PIN_ASSIGNMENT.md`。T11 显式为无上下拉输入，避免默认未用管脚上拉。28 个端口的最终位置、方向、电平、驱动及上下拉全部检查通过。

LED：D14 就绪、C14 运行、B9 故障、A9 表示复位后收到过有效心跳。心跳 LED 不表示当前未超时。

仅一套 UART TX；每行固定 8 字节，格式为 `S/E 源 两位十六进制码` 加 CRLF。每次上电/复位先输出 `S M 00`、`S N 00`、`S W 00`，IMU 首次成功或失败后输出一次 `S I xx`。
M/N/W 分别为电机逻辑、编码器逻辑、看门狗逻辑；00 表示初始化完成，不代表电机转动或编码器硬件自检通过。W 初始化与收到 A5 心跳分别由日志与 LED 表示。
IMU 启动失败时 xx 为当时驱动错误码，无驱动错误码时为 FF。正常运行不输出周期速度、位置、样本或心跳日志。

| 错误日志 | 含义 |
| --- | --- |
| E I 04 / 05 | 初始化 ID 检查失败 / 配置失败 |
| E I 06 / 07 | 运行中 ID 不符 / 错误寄存器非零 |
| E I 0A | 检测到非零传感器错误寄存器 |
| E I 08 / 09 | ready 丢失 / 采样超时 |
| E I FF | 其他非零驱动错误 |
| E W 01 | 看门狗超时 |
| E L 01 / E R 01 | 左 / 右编码器故障 |
| E X 01 | 急停 |

按固定来源和错误类别保留待发送位及已报告位，每类错误复位前最多发送一次。多个同时发生或发送过程中到达的事件独立保留，无大容量 FIFO。一个根因可产生多个诊断类别，例如 ID 错误后 ready 丢失。

## 复现与仿真结果

在本仓库根目录执行：

```powershell
./tools/run_system_sim.ps1
& 'D:/Gowin/Gowin_V1.9.12_x64/IDE/bin/gw_sh.exe' tests/gowin/build_system.tcl
./tools/check_system_reports.ps1
```

ModelSim SE-64 10.7 完整运行通过：

- 主工程：8192 字节配置逐字节匹配、六轴有符号小端转换与快照、两个独立电机模型、物理 PWM 脉宽/方向/25% 限幅、定时停止与再次触发。
- 安全：无心跳、错误字节/停止位、连续心跳、超时计数边界、两路关断、锁存和复位；急停短脉冲；左右编码器同时故障。
- IMU：初始化 ID/配置失败，自动恢复后仍禁止启动，运行中 ID/错误寄存器异常，采样超时与 ready 丢失。
- 日志：逐位解码全部 16 类固定事件行，检查字节、CRLF、初始化失败快照、发送中单周期并发事件不丢失、持续及再次出现的同类错误不重复；正常运行无周期日志。
- 原例程回归：IMU 正常和首次失败重试；ground 的四种转向/旋转目标、看门狗与 UART；左右轮及双轮正反向、滤波与 PI。

主工程新增测试为 0 errors、0 warnings。旧例程出现未连接新增可选端口的 ModelSim 警告；`SYSTEM_INTEGRATION=0` 时输入被常量门控，所有回归通过。
仿真缩短等待、动作和超时参数，以检查状态机及计数边界。生产默认值为 8 秒动作、500 ms 看门狗、100 ms 采样超时。电机模型不替代实机。

## 最终编译与资源

Gowin 1.9.12，GW5A-LV25UG324C2/I1：综合、布局布线、bitstream 生成通过。
50 MHz 约束下 Fmax=80.693 MHz；最差 setup 裕量 7.608 ns，hold 裕量 0.272 ns；setup/hold 违例端点均为 0，TNS 均为 0。该结论针对受时钟约束的内部路径，不代表板级接口时序实测。

| 资源 | 已用 | 总量 | 剩余 | 已用占比 |
| --- | ---: | ---: | ---: | ---: |
| Logic | 4,077 | 23,040 | 18,963 | 17.70% |
| Register（含 I/O 寄存器） | 1,693 | 23,685 | 21,992 | 7.15% |
| BSRAM | 4 | 56 | 52 | 7.14% |
| DSP（18×18 乘法器口径） | 0 | 28 | 28 | 0.00% |
| PLL | 0 | 6 | 6 | 0.00% |
| I/O | 28 | 222 | 194 | 12.61% |
| CLS | 2,591 | 11,520 | 8,929 | 22.49% |

Logic 为 3189 LUT + 888 ALU；BSRAM 为 4 块配置 ROM。固定 PI 增益综合成逻辑运算，无 DSP；系统无需 PLL。
Logic/Register/BSRAM/I/O/CLS 来自本次 PnR 报告；DSP/PLL 用量核对网表均为零，总量来自同版 Gowin 的 `share/device/device_info.csv` 中 `gw5a25a-008`。
Gowin 摘要百分比向上取整，本表按原始计数计算到两位小数。

输出：`impl/pnr/Embodied_RPACS.fs`。
SHA256：`14E06FAA647C05AA1B5F1B37878E4408E78D0D3E806C21E22249A940E1743D88`（提交前现有 12:39:03 构建产物；重新核对资源、时序及管脚结果一致）。
仿真日志、资源报告及管脚/网表检查结果归档在 `tests/records/2026-10-18_system_*`。
自动化验证阶段未下载 FPGA、未操作真实电机。后续用户上板反馈见下节；仿真、编译及基本运行反馈不替代完整实机安全验收。

## 用户上板反馈

测试名称：**底盘基础控制集成与事件日志验证**。

2026-10-18 用户反馈串口出现 `S M 00`、`S N 00`、`S W 00`、`S I 00`，初次按 KEY1 不前进。核对后确认初次没有发送看门狗心跳；说明每 100 ms 发送二进制 A5、故障后复位再触发的操作后，用户明确确认：“之前我忘记发送心跳了，现在没有问题了”。

本次记录支持主工程在发送心跳后基本按键运行正常，以及初始化日志能够接收。未将该反馈扩展为急停响应时间、500 ms 超时精度、所有故障注入或长时间运行均已完成实机验收。无心跳不允许运动属于预期行为，不为此次现象关闭或绕过看门狗。
