WeieeGRACE/Embodied_RPACS/tests/records/2026-10-19_OLED姿态角工程编译测试报告.md

# OLED 姿态角独立工程编译测试报告

测试日期：2026-10-19（北京时间）

测试对象：ACG525 板载 OLED 姿态角独立工程

结论：IDE 与 Tcl 完整编译通过，专用引脚配置错误已修复；上板显示、姿态响应及漂移性能尚未实测。

## 1. 环境与范围

| 项目 | 内容 |
| --- | --- |
| 工具 | Gowin FPGA Designer / gw_sh V1.9.12 x64 |
| FPGA | GW5A-25A，GW5A-LV25UG324C2/I1，UBGA324 |
| 工程 | `tests/imu_attitude_oled/imu_attitude_oled.gprj` |
| 顶层 | `imu_attitude_oled_test_top` |
| 时钟 | `clk_50m`，50 MHz，周期 20 ns |
| 输出名 | `imu_attitude_oled_test` |
| 本次修改范围 | 独立 OLED 工程配置、配置文件跟踪规则及说明文档 |

本次未修改姿态算法、定时采样方式及主系统工程。INT1/INT2 继续保留为未使用输入。独立测试顶层不连接电机控制输出。

## 2. 故障与修复

原始布局布线错误为 `PR2028` 和 `PR2017`：OLED 的 R3/T3 被作为 CPU/SSPI 专用引脚处理，无法按普通 IO 放置。早期 Tcl 构建虽然通过，但不能据此判断已打开的 IDE 工程配置正确；实际 IDE 构建曾复现该错误。

在 IDE 中启用 **Use CPU as regular IO** 和 **Use SSPI as regular IO**，保存配置，并设置测试顶层、50 MHz 及输出名。关闭并重新打开工程后，配置界面确认频率为 `50.000 MHz`，再执行完整 Run All。

实测此版本 IDE 保存的配置文件为 `impl/imu_attitude_oled_process_config.json`，`gw_sh` 也读取该文件。`impl/project_process_config.json` 保留为同步副本；仅补该通用文件未能修复此前 IDE 的旧配置。两份文件内容已同步，并加入 Git 跟踪。工程已打开时，外部修改文件可能被 IDE 内存中的旧配置覆盖，应关闭工程后更新，再重新打开。

## 3. 编译验证结果

| 检查项 | 实际结果 | 判定 |
| --- | --- | --- |
| IDE 重载后配置 | 界面显示 50.000 MHz，测试顶层与输出名已保存 | 通过 |
| IDE Run All | 22:50:07 完成综合、布局布线及位流生成 | 通过 |
| 独立 Tcl 构建 | `build_imu_attitude_oled.tcl`，22:52:11 完成，进程退出码 0 | 通过 |
| CPU 普通 IO | `device.cfg`：`set CPU regular_io = true` | 通过 |
| SSPI 普通 IO | `device.cfg`：`set SSPI regular_io = true` | 通过 |
| 全局频率 | `cmd.do`：`-global_freq 50.000` | 通过 |
| 原引脚错误 | 最终布局布线日志无 PR2028、PR2017，ERROR 数为 0 | 通过 |
| 位流 | 成功生成，大小 6,174,044 字节 | 通过 |

IDE 与 Tcl 使用同一输出目录，最终目录中的构建产物对应 22:52:11 的 Tcl 构建；IDE 22:50:07 的通过结果已在当时核查，本报告不将被覆盖的 IDE 日志描述为独立留存证据。

## 4. 管脚核对

管脚约束与生成的管脚报告一致，以下 10 个端口无重复物理管脚分配。

| 信号 | 管脚 | 用途 |
| --- | --- | --- |
| `clk_50m` | T9 | 系统时钟 |
| `reset_n` | B16 | 复位 |
| `imu_spi_sck` | V15 | IMU SPI 时钟 |
| `imu_spi_mosi` | V16 | IMU SPI 发送 |
| `imu_spi_miso` | U18 | IMU SPI 接收 |
| `imu_cs_n` | T18 | IMU 片选 |
| `imu_int1` | N14 | 保留，未使用 |
| `imu_int2` | N16 | 保留，未使用 |
| `oled_scl` | R3 | OLED I²C 时钟 |
| `oled_sda` | T3 | OLED I²C 数据 |

OLED 两个端口均为 `LVCMOS33`，报告中的电压为 3.3 V。与本独立工程的 IMU、时钟和复位信号无管脚冲突。

## 5. 时序结果

| 指标 | 报告值 |
| --- | --- |
| 时钟约束 | 50.000 MHz / 20.000 ns |
| Actual Fmax | 50.002 MHz |
| Setup violated endpoints | 0 |
| Hold violated endpoints | 0 |
| Setup / Hold TNS | 均为 0.000 ns |

当前实现满足已配置的 50 MHz 时序约束，但 Fmax 余量很小。本结果不代表已验证更高频率运行或板上 I²C 电气波形。

## 6. 警告说明

- `CV0016`：`imu_int1`、`imu_int2` 未使用。工程采用定时采样，本次保留该行为。
- `NL0002`：三个 `attitude_angle_to_digits` 实例层级在综合优化中被消除。该消息未阻止编译，但不能代替 OLED 显示格式的功能验证。
- Tcl 启动时提示无法写入用户目录的 `cache/sh.log`；本次构建仍完成且退出码为 0，工程目录中的布局布线日志和报告已生成。

## 7. 产物与证据

以下路径相对仓库根目录。

| 内容 | 路径 |
| --- | --- |
| SRAM 位流 | `tests/imu_attitude_oled/impl/pnr/imu_attitude_oled_test.fs` |
| 布局布线日志 | `tests/imu_attitude_oled/impl/pnr/imu_attitude_oled_test.log` |
| 专用引脚配置 | `tests/imu_attitude_oled/impl/pnr/device.cfg` |
| 布局布线命令 | `tests/imu_attitude_oled/impl/pnr/cmd.do` |
| 管脚报告 | `tests/imu_attitude_oled/impl/pnr/imu_attitude_oled_test.pin.html` |
| 时序报告 | `tests/imu_attitude_oled/impl/pnr/imu_attitude_oled_test_tr_content.html` |
| 最终报告摘要快照 | `tests/records/2026-10-19_OLED编译证据摘要.txt` |

最终位流生成时间：2026-10-19 22:52:11。SHA256：

```text
A3171FF5BFD2AEFED8E5D1726B6FF4C84767CAF37FA8393B8CA870E80BCAE5D2
```

## 8. 待上板验收

本次报告未执行新的功能仿真，也没有下载板卡、测量刷新率或记录漂移数据。以下项目均为待测，不预填通过。

| 项目 | 操作及观察内容 | 实测结果 |
| --- | --- | --- |
| 启动校准 | 下载上述位流，静置启动，观察校准状态是否结束；设计采集 200 个有效样本 | 未执行 |
| OLED 文本 | 检查 ROLL、PITCH、YAW REL、IMU 状态及正负号、小数显示 | 未执行 |
| 实时刷新 | 观察显示是否持续更新；设计目标约 5 Hz，实测记录刷新间隔 | 未执行 |
| 横滚与俯仰 | 分别绕两轴正反向倾斜，记录变化方向、响应及静止稳定性 | 未执行 |
| 相对航向 | 校准后绕 Z 轴正反向转动，记录累计角度、方向及回转表现 | 未执行 |
| 静止漂移 | 校准后记录 0、1、5、10 分钟的 YAW，并记录温度和供电条件 | 未执行 |
| 重启重复性 | 静置复位至少 3 次，检查校准与相对航向归零 | 未执行 |

启动静止零偏校准用于抑制陀螺仪偏置引起的漂移；六轴 IMU 的 YAW 为相对积分角，残余偏置和温漂仍可能随时间累积。漂移抑制效果须以上板测量结果为准。
