WeieeGRACE/Embodied_RPACS/tests/docs/DUAL_WHEEL_CLOSED_LOOP.md

# 双轮架空正转测试

> 阶段更新（2026-10-14）：用户确认单轮及双轮架空测试已完成，后续见 GROUND_TEST.md。以下保留历史步骤和证据，其中“尚待验收/不落地”描述属于当时阶段；新增固件和落地实机验收仍需单独记录，历史编码器异常报告保留。

左右单轮正反向日志均支持低速跟踪通过。右轮反向四次速度逐步收敛至-10，
后段PR约-290~-330，左路关闭，无非法跳变、故障或饱和。
关闭后惯性滑行几百毫秒，最终停止。机械抖动、温升、电流仍需现场观察。

## 工程

打开 ../gowin/robot_dual_forward_test.gprj，顶层 robot_dual_forward_test_top。
下载 ../../impl/pnr/robot_dual_forward_test.fs，选择SRAM Program。
两轮目标均10 counts/10ms，KP=32、KI=1、KD=0，4窗滤波。
每路PWM限幅625/2500（25%），斜坡每PWM周期最多1拍。
共用闭环模块新增TEST_BOTH参数，默认0，保留所有单轮工程行为。
两路独立PI和反馈，共用安全关断；任一编码器故障都停止两路。
KEY1按下一次触发运行，连续8秒后自动停止；运行期间松开或再次按下均忽略，动作结束后必须释放再按；KEY2急停锁存，KEY0清除。
限时停止不是看门狗，未加入硬件过流检测。

## 接线与顺序

1. 下载时电机动力线断开，先确认串口TL=10、TR=10。
   用示波器检查两路正向方向、PWM上限和KEY1/KEY2/8秒自动关断。
2. 确认此前单轮实测无明显抖动、异响或发热后，断电接回两台电机：
   左电机AO1/AO2，右电机BO1/BO2，保持各自单轮验证过的接法。
   编码器、UART和控制线不改变，不交换动力线或A/B相序。
3. 两轮都架空，使用限流电源并保留实体断电开关；本次不落地。
   KEY0复位，先松开KEY1，再短按约0.5秒确认两轮物理前进方向一致，松开检查停止。
4. 然后短按KEY1运行至8秒自动停止，重复2~3次，保存完整串口日志。
   分别测试提前松开KEY1和KEY2急停；KEY2后应持续关断，KEY0复位才能恢复。

预期L/R增加，VL/VR及SFL/SFR为正并接近10，PL/PR为正且幅值不超过625。
左右PWM不同是独立控制补偿电机差异，不要求两路完全相等。
IL/IR/FL/FR/FAULT为0（主动急停测试除外），SL/SR无持续饱和。
关闭后EN/ST/PL/PR为0，计数可随惯性继续变化；机械停止不是瞬时制动。
反馈符号相反、持续饱和、供电下降或明显抖动时立即松开KEY1。
记录电源电压/电流、两轮是否平稳、驱动和电机是否发热。

## 验证

../../sim/dual_closed_loop_regression.log：两个不同电机模型的独立反馈和控制、
两路物理PWM宽度/方向/25%限幅、使能释放、左右编码器故障、急停锁存、
限时停止、重新启动及复位均通过。模型不替代实机验证。
../../sim/dual_change_single_wheel_regression.log、../../sim/dual_change_left_regression.log：
单轮正反目标、UART快照/边界、滤波及PI回归通过。
命令：在sim目录运行vsim -c -l dual_closed_loop_regression.log -do run_dual_closed_loop_test.do。
双轮实机尚未验收，后退/旋转/转向及落地留待后续阶段。
Gowin综合/布局布线/下载文件生成通过：Fmax=50.139MHz，setup裕量0.056ns、
hold裕量0.222ns，负裕量端点0。时序余量较小，修改后须重新编译验证。

## 双轮正向实测与下一步反向

实测附件3589dca0-af93-4777-aa51-576c33922759中151条完整报告，
最后一行截断不参与统计。四段运行各20条EN=1报告（10Hz，约2秒）。
每段最后5条SFL/SFR均9~10，PL约291~325、PR约288~328（约12%）。
首段最后运行位置L=1703、R=1710；输出关闭后最终L=1871、R=1915，
差异主要来自滑行，不把最终累计差作为稳态速度误差或直线行驶验收。
全部完整报告无非法跳变、编码器故障、系统故障或饱和。
输出关闭时EN/ST/PL/PR为0，随后速度归零；日志不包含主动KEY2急停锁存。
没有按键输入时间戳，20条运行报告只能支持约2秒，不能单独证明限时而非松键停止。
机械方向、抖动、温升、电流及实体急停仍需现场核对。

下一步打开robot_dual_reverse_test.gprj，顶层robot_dual_reverse_test_top，
下载../../impl/pnr/robot_dual_reverse_test.fs（SRAM Program）。
两路TARGET=-10，其余增益、斜坡、25%上限、限时和急停逻辑保持一致；
不交换动力线或编码器相序，正向工程和文件保留。
下载时先断开动力线验证按键关断；断电接回原AO1/AO2、BO1/BO2接法，
两轮架空、限流供电，先短按0.5秒，再按住KEY1至2秒自动停止，重复2~3次。
预期TL/TR=-10，L/R减少，SFL/SFR逐步接近-10，PL/PR负且幅值不超过625。
关闭后EN/ST/PL/PR=0，允许短暂滑行；若负命令对应持续正反馈立即禁用。
另做一次运行中KEY2急停：松开KEY2也应保持FAULT=1、ST=0、PL/PR=0，
再次按KEY1不能运行；KEY0复位清故障后，先松开KEY1再按才能恢复。
不要因主动急停的FAULT=1误判正常闭环故障。请保存含急停、复位的完整日志。

双轮正负目标集成仿真通过，记录../../sim/dual_forward_reverse_regression.log；
验证两路独立反馈、反向物理方向、PWM脉宽/限幅、禁用、任一编码器故障、
急停锁存、限时与重启。控制RTL本次未改变，UART回归沿用前次通过结果。
反向Gowin综合/布局布线/下载文件生成通过，Fmax=50.367MHz，
setup裕量0.146ns、hold裕量0.153ns，负裕量端点0。
双轮反向尚待实机验收；旋转、转向、真实看门狗及落地仍待后续。
