WeieeGRACE/Embodied_RPACS/tests/docs/LEFT_WHEEL_CLOSED_LOOP.md

# 左轮架空闭环测试

> 阶段更新（2026-10-14）：用户确认单轮及双轮架空测试已完成，后续见 GROUND_TEST.md。以下保留历史步骤和证据，其中“尚待验收/不落地”描述属于当时阶段；新增固件和落地实机验收仍需单独记录，历史编码器异常报告保留。

## 工程与下载

打开 `../gowin/robot_closed_loop_test.gprj`，顶层为 `robot_closed_loop_test_top`，器件为
`GW5A-LV25UG324C2/I1`。工程仅启用闭环 CST/SDC，固定 PWM 和编码器工程保留。
不要向旧 `Embodied_RPACS.gprj` 同时加载多个顶层的约束。
命令行构建：在本目录执行 `gw_sh ../gowin/build_closed_loop_test.tcl`。
下载文件：`../../impl/pnr/robot_closed_loop_test.fs`。

## 接线

保持已验证的接线。FPGA 管脚编号是芯片球位，通过下面的板上网络名寻找插针；
不要把 U17 理解为排针第17脚。GPIO0..3 位于40-pin GPIO接口；
LCD_GPIO 网络位于原 TFT 扩展接口。本次不要插接 TFT 或摄像头模块。

| FPGA 信号 | 板上网络 | FPGA 管脚 | 接入 |
|---|---|---|---|
| encoder_a_l | GPIO0 | C17 | 左编码器 A |
| encoder_b_l | GPIO1 | C18 | 左编码器 B |
| encoder_a_r | GPIO2 | F14 | 右编码器 A |
| encoder_b_r | GPIO3 | G14 | 右编码器 B |
| PWMA | LCD_GPIO7 | U17 | TB6612 PWMA |
| AIN1 | LCD_GPIO6 | U18 | TB6612 AIN1 |
| AIN2 | LCD_GPIO11 | M14 | TB6612 AIN2 |
| PWMB | LCD_GPIO9 | T17 | TB6612 PWMB |
| BIN1 | LCD_GPIO8 | T18 | TB6612 BIN1 |
| BIN2 | LCD_GPIO23 | H12 | TB6612 BIN2 |
| STBY | LCD_GPIO22 | G13 | TB6612 STBY |
| uart_tx | 板载 UART TX | V8 | 板载串口桥，或外接 USB-TTL 的 RX |

管脚依据教程 `02_例程源码/ch27_rom_image_tft_hdmi/src/rom_image_tft_hdmi.cst`、
`ch9_uart_loopback/src/uart_loopback.cst` 及 `04_引脚功能信息` 的引脚表。
KEY0/B16 复位；KEY1/A15 使能；KEY2/C15 急停。LED0/D14 为使能逻辑，
LED1/C14 为急停输入，LED2/B9 为故障，LED3/A9 为选中通道控制器饱和；
这里描述逻辑值，LED点亮极性以板载电路为准。

TB6612 VCC 接3.3 V，VM 接适合电机的独立限流电源；FPGA、驱动和电源负极共地。
编码器供电沿用此前实测配置，A/B 接入电压必须符合3.3 V IO要求，必要时电平转换。
左电机两根动力线接 AO1/AO2；右电机动力线断开。STBY 始终由 FPGA 控制。
外接 USB-TTL 时只接 RX 和 GND，不接适配器 TX 和供电脚。

## 按键和默认控制

- 上电或 KEY0 复位后，先松开 KEY1 至少10 ms，再按住运行。
- KEY1 稳定按下10 ms后启动；松开时立即关断 PWM/STBY。
- 每次按住最长2秒，计时从运行请求开始，包含启动等待；到时停止。
  一直按住不能重启，须松开至少10 ms后重新按下。
- KEY2 按下立即关断并锁存故障，即使随即松开也不恢复。
  松开 KEY2、松开 KEY1，再按 KEY0 清除故障，然后重新操作。
- 编码器任一通道非法跳变故障也锁存停机。禁用或故障清除 PI 和斜坡状态。

默认 `TEST_RIGHT=0`，右路命令、PWM和方向输出均为0。
左目标 `TARGET=10`，单位是每10 ms的四倍频计数；KP=32、KI=1、KD=0、GAIN_SHIFT=0。
4窗移动平均在复位后以0填充尚未采到的窗口，40 ms后进入完整历史平均；
除法向0取整。速度测量在禁用时仍继续，重新启动使用当前轮速。
有符号反馈饱和到16位后进入控制器，避免截断翻转符号。
PWM固定20 kHz，每周期2500拍，命令幅值最大625（25%），每PWM周期斜坡最多变化1拍。
换向保留2500拍死区，最小占空比0。无反馈时首个PI控制量为330拍，约13.2%；随后随误差积分，受斜坡和625限幅约束。

## 串口观测

串口助手设为115200、8N1、无流控、文本显示。每100 ms发送完整快照，CRLF换行。
字段顺序：

```
L=0 R=0 TL=10 TR=0 VL=0 VR=0 SFL=0 SFR=0 PL=0 PR=0 SL=0 SR=0 EN=0 ST=0 IL=0 IR=0 FL=0 FR=0 FAULT=0 FC=0
```

| 字段 | 含义 |
|---|---|
| L/R | 左右有符号累计位置，KEY0清零；前进应增加 |
| TL/TR | 左右目标 counts/window |
| VL/VR | 最新10 ms窗口原始速度 |
| SFL/SFR | 4窗平均速度 |
| PL/PR | STBY门控后的安全PWM命令，有符号拍数，非电压或实测电流；驱动在周期边界锁存，可能比命令延后一周期 |
| SL/SR | 选中通道 PI/PID 饱和标志；未选通道显示0 |
| EN/ST | 控制使能 / 实际STBY逻辑；启动等待期间可为1/0 |
| IL/IR | 非法跳变累计次数 |
| FL/FR | 编码器锁存故障 |
| FAULT | 本地急停、编码器或安全仲裁故障的组合 |
| FC | 安全仲裁故障码，可能在立即关断后下一拍更新 |

累计L=1508、R=1516不能直接作为每圈计数，1456也只是参考；本阶段不换算RPM。

## 上板顺序与验收

1. 不接电机，先下载并用示波器验证：上电输出关闭；按住KEY1左路启动、
   右路PWMB/BIN1/BIN2一直为0；松开KEY1或按KEY2立即关闭；
   按住2秒后STBY/PWM变0，保持按住不重启。KEY0复位关闭。
   此时轮速为0，左PI命令随误差累计增加，最终受625拍上限限制，不能期待固定25%输出。
2. 断电后仅左电机接AO1/AO2，车轮架空，采用限流电源，保留实体断电开关。
   重新上电，按KEY1最多2秒观察：左前进时L增加、VL/SFL为正，IL/IR和FL/FR均为0，PR为0。
3. 若不能起转，先核对PWMA/方向/STBY、驱动供电和机械负载，再小幅增加KP重编译。
   不提高625上限，不用增加KI掩盖方向错误；负反馈或明显振荡立即松开KEY1。
   反馈接近TL后，P控制量应随误差减小；KI=0可能保留稳态误差。
4. 左轮验收后再把TEST_RIGHT设为1，右电机单独接BO1/BO2重复测试。
   当前生成文件为左轮版本；右轮参数版本须重新综合与验证。

2秒停止是限时运行，不是真实看门狗；PWM上限也不替代过流保护。
本次不进行双轮落地、在线调参或过流验收。

## 验证复现

在sim目录运行 `vsim -c -do run_closed_loop_test.do` 与 `vsim -c -do run_uart_observation.do`。
闭环仿真包含简化电机模型和真实A/B相序、4窗滤波、反馈更新顺序、正负反馈、
16位饱和转换、物理PWM脉宽/25%限幅、斜坡、右路关闭、去抖、立即释放、
亚时钟急停脉冲锁存、编码器非法跳变停机、复位、限时与重新启动。
限时计数使用缩短参数加速仿真，硬件默认100000000拍即2秒。
UART回归覆盖位时长/8N1/连续字节/发送中复位、有符号32位边界、全部新增字段和快照一致性。
仿真不代替实机调参或电压、电流验收。

2026-10-13 Kp=24历史验证结果：上述两套ModelSim脚本退出码均为0，各测试PASS。
Gowin V1.9.12 综合、布局布线及下载文件生成成功，管脚约束全部匹配。
最终时序报告clk_50m要求50.000 MHz，实际Fmax为51.423 MHz，
最差setup裕量0.554 ns、hold裕量0.263 ns，setup/hold负裕量端点均为0。
时序余量较小，调参后应重新综合与布局布线并检查报告，不能直接沿用本结果。
报告位于 `../../impl/pnr/robot_closed_loop_test.tr.html` 和 `.rpt.txt`。
综合仍有遥测索引/长度加减的位宽截断提示（计数在固定缓冲边界内），
以及未使能右控制/驱动通道被优化移除的提示；无错误。
板端按键、输出波形、限时停机与实际电机闭环尚待按上述步骤验收。

## 第二轮：Kp=24

首轮Kp=16的实机日志：左位置正向增加、右路计数与命令为0，编码器非法跳变和故障为0。
完整运行段约20条100 ms报告，停机后EN/ST/PL归0；用户确认故障段为主动KEY2急停。
稳态SFL约2~3，低于目标10，PL约112~128（4.48%~5.12%），符合纯P控制的稳态误差。
本轮只把KP提高至24，目标、KI/KD=0、25%上限、斜坡和2秒限制保持原值。
最新下载文件同时保存为 `../../impl/pnr/robot_closed_loop_test_kp24.fs`，避免与首轮文件混淆。
Kp=24闭环、遥测和滤波回归已PASS，日志为 `../../sim/closed_loop_kp24_regression.log`；
上面的Gowin时序数据记录本轮结果。

保持左轮架空、右电机动力线断开、限流电源及原接线，下载后先松开KEY1，再按住到2秒自动停止。
做2~3次短时运行，保存完整串口日志，比较起转、稳定SFL、PL和可见振荡。
无反馈时PL趋向240（9.6%）；若SFL=2或3，纯P控制量分别为192或168拍，
但实际稳态速度需实测，不能由增益直接保证到达10。
负反馈、剧烈振荡或异常发热时立即松开KEY1/实体断电；本轮不加KI。

## 第三轮：Kp=32（历史纯P版本）

恢复动力线接法后，最新175条实测日志显示Kp=24时SFL基本为+4、PL基本144，
左位置增加、右计数与命令为0，非法跳变/编码器/系统故障均为0。
四段完整运行各20条报告，停止后EN/ST/PL归0；另有一段14条报告提前停止。
此前交换动力线产生负速度而正PWM持续饱和，属于错误反馈方向，不作为反转性能数据。

当前仅将KP从24提高至32，目标10、KI/KD=0、25%上限、斜坡与2秒限时保持原值。
下载 `../../impl/pnr/robot_closed_loop_test_kp32.fs`，Kp=24命名文件保留。
运行步骤：左轮架空、右电机动力线断开、限流供电，保持恢复后的接法；
KEY0清零，松开KEY1后按住到2秒停止，重复2~3次并保存完整日志。
观察SFL是否高于之前约4、PL是否有规律收敛、轮子是否出现明显振荡。
无反馈时PL趋向320（12.8%）；SFL=4时未受斜坡影响的P控制量为192（7.68%）。
目标速度能否达到需实测，本轮不加Ki、不交换动力线、不做反向或双轮测试。

2026-10-13 Kp=32验证：闭环集成、UART快照/边界和滤波回归全部PASS，
见 `../../sim/closed_loop_kp32_regression.log`。Gowin综合/布局布线/文件生成成功，
clk_50m Fmax=50.026 MHz，最差setup裕量0.011 ns、hold裕量0.275 ns，
setup/hold负裕量端点均为0。时序余量很小，后续改参数须重新检查。
当前../../impl/pnr通用报告与通用robot_closed_loop_test.fs已更新为Kp=32版本。
本轮实机速度跟踪与振荡情况尚待用户采集日志验收。

## 第四轮：Kp=32、Ki=1（当前源代码默认值）

用户反馈第三轮多段运行速度基本+5、PL=160或192，与纯P误差关系一致，
停机输出为0，右路关闭、非法跳变和故障为0；日志未见持续大幅速度波动。
仍低于目标10，因此本轮保留KP=32，加入KI=1，每10 ms积分一次，KD=0、GAIN_SHIFT=0。
当误差为5且不饱和时，每窗口积分贡献为5拍（占空比0.2个百分点），
比例项仍随误差变化，斜坡每PWM周期1拍、625上限、2秒限时继续生效。
禁用/故障/复位清除PI和斜坡，下一次启动不保留上次积分。

下载 `../../impl/pnr/robot_closed_loop_test_kp32_ki1.fs`。保持恢复后的接线、左轮架空、
右动力线断开、限流供电，KEY0清零，松开KEY1后按住到2秒停止，重复2~3次。
保存从启动到停止后的完整日志，观察SFL是否逐渐接近10、是否超过目标或来回振荡，
以及PL是否持续625、SL是否持续1。积分版PL不再等于32*(10-SFL)，不能用纯P公式判断。
若明显抖动、方向错误或持续饱和，松开KEY1并反馈日志；不要交换动力线或提高上限。
若先不接电机，误差持续为10，PI会提高命令直至25%上限，这与纯P版本不同。

2026-10-13验证：闭环集成、滤波、UART和新增PI回归PASS。
PI测试覆盖积分累积、零误差保持、正负饱和、饱和时停止积分、误差反向后退出饱和、禁用清零。
集成简化电机模型延长观察时间以覆盖斜坡追赶，检查速度误差减小；不将PI输出必定下降作为验收条件。
日志 `../../sim/closed_loop_kp32_ki1_regression.log`。
Gowin综合/布局布线/文件生成成功；Fmax=50.149 MHz，setup最差0.060 ns、hold最差0.275 ns，
setup/hold负裕量端点为0。余量较小，后续修改须重新检查。
本轮电机速度跟踪、超调及机械抖动尚待实测，本结果不作为单轮闭环最终验收。

## 第五轮：左轮反向（独立工程）

第四轮四段实测运行均约20条报告，SFL从约6~7逐渐升至9~10，
约1.2~1.6秒接近目标，末段PL约290~295（11.6%~11.8%），
没有饱和、编码器非法跳变或系统故障，右路关闭，停机后EN/ST/PL为0。
停止后计数继续变化几百毫秒，是惯性滑行；关断输出不等于机械瞬停。
100 ms日志未见持续大幅振荡，但短时机械抖动、发热和电流需实机观察。

正向工程及文件保留。新增 `../gowin/robot_left_reverse_test.gprj`，顶层
`robot_left_reverse_test_top`，显式调用原闭环模块TARGET=-10、KP=32、KI=1、KD=0、TEST_RIGHT=0。
复用同一套CST/SDC，因为端口和接线完全一致。
命令行：`gw_sh ../gowin/build_left_reverse_test.tcl`。
下载：`../../impl/pnr/robot_left_reverse_test.fs`。

先断开左电机动力线下载，串口确认TL=-10、TR=0，
不接电机验证KEY1松开/KEY2急停/2秒停止及右路关闭。
断电后将左动力线按正向测试已验证的接法接回AO1/AO2，保持车轮架空、限流供电、右动力线断开。
不要交换动力线，不改编码器A/B或INVERT_L。
KEY0清零，松开KEY1后按住到2秒自动停止，重复2~3次并保存完整日志。
正常反向应为L减少、VL/SFL负值逐渐接近-10、PL为负，
反向驱动时AIN1=0、AIN2=1，右路PWMB/BIN1/BIN2始终0。
无反馈时首个PI命令为-330拍；25%幅值上限、斜坡、急停锁存及限时保持原样。
若持续出现PL负而SFL正、明显抖动或持续饱和，立即松开KEY1并反馈日志。
恢复正向测试时重新下载保留的 `robot_closed_loop_test_kp32_ki1.fs`。

正反目标集成仿真都PASS，包含有符号反馈、模型速度误差减小、方向引脚对应、
物理PWM脉宽/25%上限、斜坡、右路关闭和各安全关断。
UART/滤波/PI回归PASS，记录 `../../sim/closed_loop_forward_reverse_regression.log`。
反向实机尚待验收；本阶段不改变增益、不做双轮落地测试。
Gowin反向工程综合/布局布线/文件生成成功，Fmax=50.010 MHz，
setup裕量0.004 ns、hold裕量0.238 ns，setup/hold负裕量端点为0。
50 MHz通过但余量很小，修改后应重新验证；报告 `../../impl/pnr/robot_left_reverse_test.tr.html`。
