WeieeGRACE/Embodied_RPACS/tests/records/2026-10-14_双轮反转按键中断与编码器异常报告.md

# 双轮反转按键中断与编码器异常报告

测试日期：2026-10-14  
测试固件：`../../impl/pnr/robot_dual_reverse_test.fs`（本次测试前已重新构建）  
测试目标：双轮反转闭环运行及启动、停止、按键中断行为。

## 测试条件与用户反馈

- 目标速度：`TL=-10 TR=-10`；编码器供电 3.3 V，A/B 信号直接接 FPGA。
- 本轮按接通 VM 的双轮反转测试流程进行。日志可确认两轮实际运动，但没有 VM 电压测量数据。
- 用户反馈：“没有问题了，两次中断是我手动按下按键测试的。”本次反馈未明确指出所按按键名称；日志中的 `FC=1` 对应急停输入。
- 本报告只分析本次日志，不把之前手动转轮测试的结论混入本次实测结果。

## 正常运行结果

多次启动后，左右轮位置计数持续减小，两轮速度从约 -6～-8 收敛到约 -10，滤波速度通常为 -9～-10。正常运行段未见输出饱和，`SL=0 SR=0`。

正常停机时，`EN=0 ST=0 PL=0 PR=0`，随后两轮速度衰减到 0。复位后的最后一轮启动、运行、停止均保持 `IL=0 IR=0 FL=0 FR=0 FAULT=0 FC=0`，最终位置为 `L=-1915 R=-1916`。

结论：本轮已验证双轮反转闭环功能能够正常运行、收敛及停止。

## 两次按键中断的日志证据

以下行号对应随报告保存的原始日志。

### 第一次中断：急停故障，没有编码器错误

原始日志第 244 行：

```text
L=-14152 R=-14084 TL=-10 TR=-10 VL=-7 VR=-7 SFL=-7 SFR=-7 PL=0 PR=0 SL=0 SR=0 EN=0 ST=0 IL=0 IR=0 FL=0 FR=0 FAULT=1 FC=1
```

随后 `FC` 变为 7，故障保持锁存，但 `IL/IR/FL/FR` 仍为 0。结合用户说明，本次中断按手动按键触发记录。日志显示驱动输出已关闭。

### 第二次中断：急停故障，同时记录到编码器非法跳变

原始日志第 306 行：

```text
L=-2446 R=-2445 TL=-10 TR=-10 VL=-7 VR=-7 SFL=-7 SFR=-7 PL=0 PR=0 SL=0 SR=0 EN=0 ST=0 IL=2 IR=2 FL=1 FR=1 FAULT=1 FC=1
```

第 307 行：

```text
L=-2490 R=-2490 TL=-10 TR=-10 VL=-3 VR=-3 SFL=-3 SFR=-3 PL=0 PR=0 SL=0 SR=0 EN=0 ST=0 IL=2 IR=2 FL=1 FR=1 FAULT=1 FC=7
```

这次停止同样是用户主动按键测试，但左右编码器非法跳变计数均由 0 增至 2，且左右编码器故障标志均锁存为 1。因此，不能将本次所有故障字段都解释为普通按键停机；确实存在与这次中断同一遥测区间内出现的编码器异常记录。

## 字段解释与源码核对

- `IL/IR`：各轮编码器非法状态跳变的累计计数，例如同一轮 A/B 状态从 `00` 直接跳到 `11`。左右轮运动时间不同本身不构成非法跳变，两个轮子的解码独立进行。
- `FL/FR`：左右编码器故障锁存标志。
- `FC=1`：急停故障；`FC=7`：外部故障。
- 当前顶层将急停或编码器故障写入 `local_fault`，并把 `encoder_fault | local_fault` 接入安全模块的外部故障输入。安全模块在故障输入存在时重新选择故障码，急停优先。因此急停输入释放后，锁存的本地故障仍可使 `FC` 从 1 变为 7；该变化本身不等于新发生的编码器故障。
- 第二次中断的编码器异常判断依据是 `IL=2 IR=2 FL=1 FR=1`，而非仅依据 `FC=7`。

核对源码：`src/robot_closed_loop_test_top.v`、`src/motor/safety_protection_and_fault_arbitration.v`、`src/motor/dual_ab_quadrature_encoder.v`。

## 当前结论及未确定事项

1. 双轮反转功能本轮测试通过，两次中断均按用户主动按键测试记录，不能作为自发停机的证据。
2. 停机时输出归零，故障保持锁存；复位后能够重新正常运行。
3. 第二次按键中断期间，左右编码器各记录 2 次非法跳变。这一现象仍需保留为未闭环问题，不能据本轮正常运行段宣布此前间歇性编码器异常已彻底消除。
4. 串口日志不能确定急停输入、PWM 关闭和 A/B 非法跳变的精确先后顺序，也不能证明按键是编码器异常的直接原因。信号干扰、滤波跳过中间相位等均尚未被本次实测证实。

## 后续建议

若继续定位，仅需针对按键中断场景对比重复测试：正常松开使能键与按急停键分别操作，观察 `IL/IR` 是否只在某种操作后增加。若再次复现，使用片上逻辑分析或示波器同步捕获急停、左右 A/B 和 PWM 信号，以确定先后关系。

本次未修改 RTL、滤波参数或故障保护逻辑；报告不作为屏蔽编码器故障的依据。

## 原始证据

原始附件：`C:\Users\Administartor\.codex\attachments\3b8fe106-0c84-4ee8-8765-fe01e8823640\已粘贴的文本.txt`。  
归档副本：同目录 `2026-10-14_双轮反转原始日志.txt`。
