WeieeGRACE/Embodied_RPACS/tests/t4_lite_drive/records/2026-10-31_按墙触发测试记录.md

# 2026-10-31 按墙触发测试记录（t4_lite_drive，闭环位流）

## 今日结论（重要）

在 600 mm 走廊 + 本车几何（长 320，绕后轴转，轮轴离车尾 25）下：
- **任何 90° 转向都要求"转弯外侧 ≥319 mm（原地）或 ≥435 mm（R=200 弧线）"净空**；
- 600 走廊内最大净空 300 mm → **A 区、600 走廊里无法完成 90° 转向**（数值扫描所有位置 min clearance 均为 0）；
- 因此 A→B 这类"出 A 区左转"的路线在当前场地尺寸下**物理不可行**，除非：
  1. 用多点掉头（倒车+前进组合，每次旋转 ≤45°）—— 但需要路口有足够纵深；
  2. 或者把走廊加宽到 ≥700 mm（墙板外移 10–20 cm）。

## 今日已实现/验证

### 工具
| 工具 | 作用 |
| --- | --- |
| `t4_steps.py` | 按动作序列执行，每段实测（相机/ToF），进度存盘 |
| `t4_wallrun.py` | **按墙触发**：`{"wall": gap}` 前进到相机/ToF 测到指定墙距就停；`{"arc": deg}` 弧线转；`{"reverse_until": gap}` 倒车；车头 <70 mm 自动 ABORT |
| `closed_loop_calib.py` | 闭环标定（稳态窗口）：50→54.8、100→100.2 mm/s，转向 ±24.8°/s，滑行 2° |

### 按墙触发实跑（A 区出发）
| 阶段 | 指令 | 实测 | 结果 |
| --- | --- | --- | --- |
| 1 | 前进到 MID_H 前 180 mm | ToF 776→206，前进 546 mm | OK（险：A_SIDE 上端余量仅 5 mm） |
| 2 | 弧线左转 90° | −90.69°（误差 0.69°） | OK |
| 3 | 前进到墙前 300 mm | ToF 530→328，前进 188 mm | OK |
| 4 | 弧线左转 90°（朝南） | −90.60° | OK |
| 5 | 南行到南边框前 125 mm | ToF 526→153，前进 358 mm | OK |
| 6 | 弧线右转 90°（朝西） | +90.34° | OK |
| 7 | 西行到墙前 150 mm | ToF 584→171，前进 387 mm | OK |
| 8 | 倒车 250 + 弧线右转 90° | −240 / +87.11° | **撞墙**（倒车后转弯空间不够） |

## 今日错误与修复

1. `arc_turn` 差速方向反了（转成螺旋）→ 修复并加行进超距保护；
2. 每段 STOP 后未重新使能 → `drive/reverse/turn/arc_turn/three_point` 及三点掉头每段都加 `ctl.rearm()`；
3. `turn()` 停转阈值沿用开环 40°/s（闭环实际 24.8）→ 改 8°/s，判据 ±5°；
4. 标定脚本把起步斜坡算进平均速度 → 改稳态窗口；
5. `t4_wallrun.bump()` 忘了 rearm → 已补；
6. 相机顶带测墙在近距离会"看穿"矮墙（读到远墙 2700+）→ 改用 **ToF 为主触发、相机交叉校验**；
7. **不该倒车**：墙前倒车再转导致转弯撞墙（用户指正）→ 规则改为"墙前留 350–400 mm 直接转、不倒车、转向朝开阔侧"。

## 下一步方案（待定）

- **A 方案（软件）**：按路口逐一仿真多点掉头轨迹（每次旋转 30–45°，前/倒交替），选有纵深的路口；
- **B 方案（场地）**：把关键走廊墙板外移 10–20 cm，使宽度 ≥700 mm，就能一把弧线过 90°。

## 2026-10-31 下午：方块路口 + 按墙触发，A→B 成功

### 正确场地模型（用户纠正）
场地由 **600×600 mm 方块**拼成：走廊是一串方块，路口是若干方块围成的 L/T 开阔区；
**车要完整停进一个方块，在方块里完成 90° 弧线转向**，转完即位于下一条走廊中线，再直行穿过下一个方块。
（此前"贴墙/墙前 150mm 就转"的思路是错的，导致多次蹭墙。）

### 成功的 A→B 路线（tools/route_A_to_B_wall.json）
| 步 | 动作 | 实测 |
| --- | --- | --- |
| 1 | 弧线左转 90°（朝南） | −90.34° |
| 2 | 南行，停在下边框前 180 mm | 371.5 mm，ToF 212 |
| 3 | 弧线右转 90°（朝西） | +89.71° |
| 4 | 西行，停在墙前 250 mm | 126 mm，ToF 282 |
| 5 | 弧线右转 90°（朝北） | +89.84° |
| 6 | 北行进 B 区，停 B 北墙前 200 mm（车头在 B 中心） | 198.5 mm，ToF 225 |

- 6 个转向误差全部 ≤0.34°（弧线转向执行非常稳定）
- 每步停距由 ToF 触发（误差 ≤2 mm），安装误差与里程误差不累积
- 执行器：`t4_wallrun.py`；路线：`route_A_to_B_wall.json`（可复现）

### 关键参数（本次现场）
- 弧线：R=200，arc_v=40 mm/s，每 90° 前进 ~250 mm
- 停距：转向后下一段用 180–250 mm；最后一个方块前 200 mm
- ToF 标定：实际车头距 ≈ ToF − 30 mm

### 留给下次
- A→C / A→D / A→E 可按同样的"方块路口"方式排布：每段 = 直行进方块 + 方块内 90° 转
- B 区是只朝南开门的口袋，进入顺序：左转→前进→右转→前进→右转→前进（本次已验证）
## 提速结果（2026-10-31 15:40）

第二次自主跑参数：`--fast 70 --slow 20 --slow-gap 250 --arc-v 60`

| 版本 | 参数 | 用时 | 结果 |
| --- | --- | --- | --- |
| v1 | fast 55 / slow-gap 400 / arc-v 50 | 136.1 s | 17/17 阶段 OK |
| v2 | fast 70 / slow-gap 250 / arc-v 60 | **86.3 s** | 17/17 阶段 OK，转向误差 ≤1°，停距误差 ≤1 mm |

即 A→B 自主跑 86 秒，比第一版快 37%。继续提速空间：fast 90、slow-gap 200、arc-v 70（预计 ~70 s）。

## A→C / A→D / A→E 自动排路线的结论

`tools/gen_routes_wall.py`：用"直行到墙前 180 + 弧线 ±90"的动作在图纸上做 BFS，
并对每个转向用整车轮廓验算净空。结果：
- **E** 可排出一条短路线（但净空为 0，不可用）；
- **C / D 在该动作模型下不可达**（即使把净空阈值降到 0）。

原因：C/D 需要穿过 B_TOP 与 MID_H 之间的开口、绕开 MID_V 与中心十字，单纯"墙前停 180 再转 90°
"的格子动作不够精细，需要现场按方块逐个引导（与 B 点入口的九步法一样）。
下一步：按现场布局人工排 C/D 的方块序列，或先量几个关键墙位再排。
## 2026-10-31 15:46 A→C 自主跑成功

路线：`tools/route_A_to_C_wall.json`（17 阶段）。图纸验算全部转向净空 ≥39.8 mm，终点车头距 C 中心 25 mm。
实跑：**17/17 阶段 OK，96.1 秒，rc=0**，转向误差 ≤0.98°，末段停距 596 mm（目标 600）。

阶段序列（与 A→B 前段相同，到 x≈1075 后改为穿 B_TOP/MID_H 开口北上）：
1. 北行 180 → 左转西 → 西行 180 → 左转南 → 南行 180 → 右转西 → 西行 180
2. 右转北 → 北行 180 → 左转西 → 西行 180（到 B_SIDE 前）
3. 右转北 → 穿越开口北上，停在 C_PLUS_H 前 555 → 左转西 → 西行到左边框前 180
4. 右转北 → 北行到 OUT_TOP 前 600（车头到 C 中心）
## 2026-10-31 16:00 A→D 自主跑成功

D 区确认：**x1800–2400、y1800–2400，中心 (2100,2100)**（比图纸 D 点更靠南）。

路线：`tools/route_A_to_D_wall.json`（21 阶段）。图纸验算：10 个转向全部 ≥39.8 mm 净空；
终点车头正好 (2100,2100) = D 中心。
实跑：**21/21 阶段 OK，116.8 秒，rc=0**，末段停距 300.0 mm（精准）。

关键新增段（A→C 前 12 步之后）：
- 右转东 → 东行到 MID_V 前 180 → 左转北 → 北行到顶边框前 205（轴 y=2500）
- 右转东 → 东行到 x=1900 → 右转南（到 (2100,2500) 朝南）
- 南行停到 D_BOTTOM 前 300（车头 (2100,2100)）
## 2026-10-31 16:07 A→E 自主跑成功

E 区确认：从**东侧走廊**进入（E 位于 x1800–2400、y1200–1800，中心目标车头 (2100,1650)）。

路线：`tools/route_A_to_E_wall.json`（22 阶段）。图纸验算：11 个转向最小净空 30 mm，
终点车头 (2105,1650) 距目标 5 mm。
实跑：**22/22 阶段 OK，139.6 秒，rc=0**，转向误差 ≤0.81°。

关键新增段（A→C/D 前 17 步之后）：
- 右转东 → 东行到 (2400,2700) → 右转南 → 南行到 MID_H 前 355（轴 y=1850）
- 右转西 → 车头落到 (2105,1650)，即 E 区中心

## 今日四条路线汇总

| 路线 | 阶段 | 用时 | 状态 |
| --- | --- | --- | --- |
| A→B | 17 | 86.3 s（二次 95.6 s 为 C 路线前的重复验证） | rc=0 |
| A→C | 17 | 96.1 s / 95.6 s | rc=0 |
| A→D | 21 | 116.8 s / 117.1 s | rc=0 |
| A→E | 22 | 139.6 s | rc=0 |
## 2026-10-31 16:40 连续演示探索（B 出口）

用户方案：进入 B 后**直线倒车回 U 型路口 → 右转**（车头朝东）→ 继续前进。
实跑验证（`route_AB_exit_test.json` = A→B 17 段 + 倒车 500 + 右转 90）：
- 倒车 495.5 mm ✓、右转 +89.3° ✓，rc=0，96.2 秒
- 说明"倒车 + 右转"这个出口动作本身是可行的

随后接着跑 `route_B_to_C_wall.json`（B 出口后 → C，7 阶段，图纸净空 39.8–133.6 mm）时**撞墙**。
原因分析：B 出口动作结束时的实际位置/朝向与图纸推算有偏差（倒车+转向后没有新的墙基准重定位），
下一段仍按绝对阶段执行 → 累积偏差导致转向点偏移。

结论/改进方向：
1. 每段出口动作后应**重新以墙为基准对齐**（例如先直行到墙前 180 再转），而不是直接转；
2. 连续演示建议用"每段之间人工摆正一次"，或按段单独跑（已验证 A→B/C/D/E 各自 100% 通过）。
## 2026-10-31 18:00 连续串跑尝试（A→B→C→D）

已跑通：**A→B（87.5 s）+ B 出口（倒车 500 + 右转）+ B→C（57.3 s）= 144.8 s，全程 rc=0，一次成功**。
B→C 修复：开口段（x600–1200，y600–1850，中间无墙）改用编码器 `drive 700`，不再用 ToF 触发（避免 C_PLUS_V 误触发）。

C→D 尝试：**失败**。现象：从西向东的长直段走成斜线、转向提前、停位错误。
原因：C 出口右转后进入 1.5 m 长直段，中途没有任何墙基准；航向 1–2° 误差在 1.5 m 上放大成 30–50 mm 横偏，
墙触发只能纠正"沿前进方向的距离"，纠正不了"横向偏移"。
→ 结论：**连续串跑必须在每个长直段中间加入横向/朝向重对齐**（例如利用可测的两面墙、或缩短段长），
当前 ToF 只能测正前方一面墙，无法做横向校正。

## 已验证可用清单（推荐演示方式）

| 演示 | 命令/文件 | 用时 |
| --- | --- | --- |
| A→B | route_A_to_B_full_wall.json | 86–88 s |
| A→C | route_A_to_C_wall.json | 96 s |
| A→D | route_A_to_D_wall.json | 117 s |
| A→E | route_A_to_E_wall.json | 140 s |
| A→B→C 连续 | route_A_to_B_full_wall.json + route_B_exit_to_C.json（顺序执行） | 145 s |
| B 出口单步 | route_AB_exit_test.json | 96 s |
| C→D 段 | route_C_to_D_wall.json | 37 s（本身可行，接在 C 后走长直段会偏） |
| D→E 段 | route_D_to_E_wall.json（已验算：倒车 505 → 左转东 → 右转南 → 右转西） | 待测 |
