WeieeGRACE/Embodied_RPACS/tests/t4_lite_drive/records/2026-10-31_总结与计划.md

# 2026-10-31 测试总结与下一阶段计划

## 一、今日成果

### 1. 位流与标定
- 使用**闭环位流** `57BE714A…D0865B7`（SRAM 烧写，**断电即丢，恢复测试前必须重烧**）
- 闭环标定 PASS：50 mm/s → 54.8、100 mm/s → 100.2、转向差速 ±50 → ±24.8°/s、滑行 2°
- `calib.json`：cmd_scale **0.9129**、turn_rate 24.83、turn_lead 4.47、arc_radius 200、arc_v 40→55 可调、tp_v 60、tp_diff 30

### 2. 分段测试（12 项全部通过）
| 项 | 结果 |
| --- | --- |
| 直行 450 / 1000 mm | 442.5 / 992.0 mm（误差 ≤8 mm，航向 ±1°） |
| 原地转 90 / 180 | 误差 2.7–4.3° |
| L 形 / U 形 | 净航向误差 ≤3° |
| 对墙停 120 mm | 行程 727 mm（目标 735） |
| 三点掉头 ±90 / 180 | 误差 2–3° |
| 弧线转向 ±90 | 误差 0.24–1.25° |
| L 形（弧线） | 净 −90.02° |

### 3. 四条路线全部自主跑通（断网可用）
| 路线 | 阶段 | 用时 | 结果 |
| --- | --- | --- | --- |
| A→B | 17 | **86.3 s** | rc=0 |
| A→C | 17 | 96.1 / 95.6 s | rc=0 ×2 |
| A→D | 21 | 116.8 / 117.1 s | rc=0 ×2 |
| A→E | 22 | 140.2 / 142.4 s | rc=0 ×2 |

### 4. 关键方法（已验证）
- **方块路口法**：场地是 600×600 方块网格；车必须完整停进方块、在方块内做 90° 弧线转向，转完位于下一条走廊中线
- **按墙触发**：每段停位由 ToF 实测墙距决定（误差 ≤1 mm），安装误差与里程误差不累积
- **图纸预验**：`gen_routes_wall.py` 的 `arc_clear()` 对每个转向用整车轮廓算净空（A→B/C/D 最小 39.8 mm，A→E 30–84 mm）
- **断网自主**：`t4_autonav.py` 在 Pi 上整条跑完，SSH 断开不影响；日志写 `~/t4_logs/autonav_*.jsonl`

## 二、关键认知（今日修正）

1. **车绕后轴转**（轮轴离车尾 25 mm，车长 320）：原地转向扫掠半径 **319 mm**，
   弧线转向（R=200）外侧需要 **≈435 mm**
2. 600 走廊最大净空 300 mm → **走廊里不能掉头**；只能在路口方块内转向
3. B 点、D 点是**只朝一个方向开口的口袋**：进去后掉头空间不足（图纸算 0 mm）
   → 连续演示必须"倒车退出 + 转向"
4. **B 出口动作已单步验证**：倒车 495.5 mm + 右转 +89.3° 成功

## 三、未解决问题

| # | 问题 | 现象 | 修复方向 |
| --- | --- | --- | --- |
| 1 | ToF 触发误判 | B 出口后续段东行时提前触发，导致左转过早撞 B 北墙 | 触发要求**连续 8 帧在目标 ±15 mm 内**；并校验"这面墙就是预期那面" |
| 2 | 出口动作后无墙基准 | 倒车+转向后位置靠推算，偏差累积到下一段 | 出口后**强制一个墙触发直行**重新对齐，再转向 |
| 3 | D 出口 | D 口袋倒车后需左转朝 E | 按 B 出口同样方式验证（倒车+转向） |
| 4 | 连续 A→B→C→D→E | 目前只有 A→B、B 出口单步验证 | 修好 1、2 后逐段连起来 |

## 四、下阶段计划（按优先级）

**P0（必须，恢复后第一件事）**
1. 重新烧写闭环位流（掉电丢失）
2. 修 `t4_autonav.py`：ToF 稳定触发（连续 8 帧 ±15 mm）+ 触发墙身份校验
3. 连续演示的段序列改为：`出口动作 → 墙触发直行（重对齐）→ 转向`

**P1（连续演示）**
4. B→C 连段验证（7 阶段已验算：净空 39.8–133.6 mm）
5. C 出口（右转东，净空 100 mm）→ C→D 段
6. D 出口（倒车+左转）→ D→E 段
7. 串成完整 A→B→C→D→E

**P2（效率）**
8. 提速参数：`--fast 80 --slow-gap 200 --arc-v 70`（预计比现在快 25–30%）
9. 减少不必要的停车/重新使能

**P3（可选）**
10. 若允许改场地：把 B 口袋北墙、D 口袋南墙各外移 15 cm → 可全自动掉头，连续演示最稳

## 五、恢复测试的检查清单（充电完成后）

```bash
# 1) 烧写（断电后必须）
programmer_cli --device GW5A-25A --run 2 --fsFile <...>/t4_lite_top.fs --cable "Gowin USB Cable(FT2CH)"

# 2) 链路 + 故障位（期望 fault=0x20）
python3 ~/t4_tools/t4_lite_drive.py --link-check

# 3) 相机对卷尺（偏差 <30 mm）
cd ~/rpacs_phase0/pyorbbecsdk-main && PYTHONPATH=install/lib .venv/bin/python ~/t4_tools/t4_lite_drive.py --measure-only

# 4) 本地采集（断网记录）
python3 ~/t4_tools/t4_logs.py start

# 5) 单段热身（车放 A、朝 +Y）
setsid nohup python3 ~/t4_tools/t4_autonav.py --route route_A_to_B_full_wall.json \
  --fast 60 --slow 20 --slow-gap 250 --arc-v 55 > ~/t4_logs/warmup.out 2>&1 &
```

## 六、文件与数据

- 工具：`tools/t4_autonav.py`（自主执行）、`t4_wallrun.py`（按墙触发单步）、`t4_steps.py`（分段）、`closed_loop_calib.py`、`t4_pi_logger.py`/`t4_logs.py`（Pi 本地采集）、`pull_logs.ps1`（PC 拉取）
- 路线：`tools/route_A_to_B_full_wall.json`、`route_A_to_C_wall.json`、`route_A_to_D_wall.json`、`route_A_to_E_wall.json`、`route_B_to_C_wall.json`、`route_AB_exit_test.json`
- 预验工具：`tools/gen_routes_wall.py`（含 `arc_clear` 净空计算）
- 记录：`records/2026-10-31_分段测试记录.md`、`records/2026-10-31_按墙触发测试记录.md`、`records/route_simulation.md`
- 现场数据：Pi `~/t4_logs/`（遥测 jsonl），PC 已拉取 `work/pi_logs/`
