WeieeGRACE/Embodied_RPACS/tests/t4_lite_drive/records/2026-10-31_分段测试记录.md

# 2026-10-31 分段测试记录（t4_lite_drive，闭环位流）

位流：`57BE714A…D0865B7`（闭环 PI，SRAM 烧写）
场地：室内空地（非围挡场地）；测试后段车头前净空 ~5.6 m

## 标定（closed_loop_calib.py，稳态窗口）

| 项 | 值 |
| --- | --- |
| 50 mm/s | 实测 54.8 mm/s（遥测 57.0） |
| 100 mm/s | 实测 100.2 mm/s |
| 转向差速 ±50 | ±24.8 °/s，STOP 滑行 2.0° |
| calib.json | cmd_scale=0.9129, turn_rate=24.83, turn_lead=4.47, tp_v=60, tp_diff=30 |

## 分段结果

| 测试 | 目标 | 实测 | 偏差 | 判定 |
| --- | --- | --- | --- | --- |
| seg1 直行 | 450 mm | 442.5 mm | −7.5 mm / yaw +1.30° | PASS |
| seg2 直行 | 1000 mm | 992.0 mm | −8.0 mm / yaw −0.50° | PASS |
| seg3 左转 90（原地） | 90° | 86.25° | −3.75° | PASS（±5°） |
| seg4 右转 90（原地） | −90° | −87.25° | +2.75° | PASS |
| seg5 转 180（原地） | 180° | 176.92° | −3.08° | PASS |
| seg6 L 形（原地转） | 500/90/500 | 492 / −88.12 / 492.5 | 净 −87.35° | PASS |
| seg7 U 形（原地转） | 400/90/300/90/400 | 393 / −87.23 / 292.5 / −174.08 / 392.5 | 净 −174.14° | PASS |
| seg8 对墙停 120 | 相机 1099 → 行程 735 | 行程 727 mm | −8 mm | PASS |
| seg9 三点掉头 −90/+90 | −90 / +90 | −91.99 / −0.92 | 1.99° / −1.07° | PASS |
| seg10 三点掉头 180 | 180 | +182.54 | −2.55° | PASS |
| seg11 弧线 ±90 | −90 / +90 | −90.24 / +1.01 | 0.24° / −1.25° | PASS |
| seg12 L 形（弧线） | 300/弧−90/300 | 292.5 / −91.07 / 292.5 | 净 −90.02° | PASS |

## 本次发现并修复的问题

1. `arc_turn` 差速方向反了（`vl>vr → yaw+` 实测约定用反），车转成螺旋、跑了 1.5 m；
   修复：左转 `vl=fast, vr=slow`，并加"行进超距立即停"保护。
2. 每个动作 STOP 后**故障锁存**，下一段电机不响应：`drive/reverse/turn/arc_turn/three_point`
   以及三点掉头的每段之间都补了 `ctl.rearm()`。
3. `turn()` 的停转阈值 `|rate|>40°/s` 是开环时代的，闭环实测转速仅 24.8°/s → 永不满足、转飞；
   改为 `>8°/s`，判据放宽到 ±5°。
4. 标定脚本把起步斜坡算进平均速度（50 mm/s 显示 39.3）→ 改为跳过 ramp 测稳态。
5. `route_run.py` 缺 `import os`（calib.json 路径用到）→ 补上。

## 结论

- 闭环位流工作正常：直行里程误差 ≤8 mm/1 m，航向保持 ±1°；
- **弧线转向是可靠的转弯方式**（±1°），原地转向 ~3–4°，三点掉头 ~2–3°；
- 600 走廊原地转不开（轮轴在尾部 25 mm，扫掠 319 mm），路线统一用弧线转向。
