WeieeGRACE/Embodied_RPACS/tests/t4_lite_drive/records/route_simulation.md

# 路线仿真报告（每段执行的可达性/误差验证）

模型：转向误差 σ=0.8°+0.3° 量化；直行增益误差 σ=0.8% + 3 mm/段；
行驶中航向保持 σ=0.6°/段；车体 320×240 mm 沿路径每 25 mm 采样做墙距检查；
起点 A=(2700,300) 朝向 +Y；每条路线 200 次蒙特卡洛。

| 路线 | 总里程(mm) | 转向次数 | 终点误差中值(mm) | P95(mm) | 最小墙距(mm) | 判定 |
| --- | --- | --- | --- | --- | --- | --- |
| route1_A_to_B.json | 2500 | 1 | 35.9 | 83.6 | 0.0 | **FAIL** |
| route1_A_to_B_plan.json | 3989 | 6 | 51.5 | 129.1 | 0.0 | **FAIL** |
| route2_A_to_C.json | 3189 | 1 | 45.2 | 108.2 | 0.0 | **FAIL** |
| route2_A_to_C_plan.json | 4175 | 4 | 66.7 | 173.1 | 0.0 | **FAIL** |
| route3_A_to_D.json | 2184 | 1 | 31.3 | 72.7 | 0.0 | **FAIL** |
| route3_A_to_D_plan.json | 4871 | 5 | 54.7 | 130.9 | 0.0 | **FAIL** |
| route4_A_to_E.json | 1477 | 1 | 21.1 | 51.3 | 0.0 | **FAIL** |
| route4_A_to_E_plan.json | 6666 | 9 | 47.3 | 115.1 | 0.0 | **FAIL** |
| route5_ABCDE_plan.json | 10249 | 21 | 95.1 | 207.4 | 0.0 | **FAIL** |
| route5_A_B_C_D_E.json | 6450 | 4 | 57.6 | 110.3 | 0.0 | **FAIL** |
| route6_A_to_OPEN.json | 450 | 0 | 5.3 | 11.8 | 157.5 | **PASS** |

## 说明

- `min_clr` 是仿真轨迹上四角到任意墙段的最小距离；<40 mm 视为碰撞。
- 直线到点路线（未规划版本）按地图会穿墙，因此判定 FAIL 属于预期。
- 误差为纯运动学模型，未包含轮子打滑/地面差异；场地实测应在同一量级。

## 确定性最小墙距（无噪声，按车体 320x240 精确计算）

| 路线文件 | 段数 | 最小墙距(mm) | 位置(x,y,hdg) | 所在动作 |
| --- | --- | --- | --- | --- |
| route1_A_to_B.json | 2 | 0.0 | (2580, 335, -73.7) | drive 2500.0 |
| route1_A_to_B_plan.json | 13 | 13.9 | (2480, 738, -26.6) | drive 671.0 |
| route2_A_to_C.json | 2 | 0.0 | (2587, 399, -48.8) | drive 3189.0 |
| route2_A_to_C_plan.json | 8 | 11.0 | (1000, 1232, -40.6) | drive 2305.0 |
| route3_A_to_D.json | 2 | 0.0 | (2494, 1024, -15.9) | drive 2184.0 |
| route3_A_to_D_plan.json | 11 | 13.4 | (1185, 1006, -38.7) | drive 1281.0 |
| route4_A_to_E.json | 2 | 0.0 | (2384, 1009, -24.0) | drive 1477.0 |
| route4_A_to_E_plan.json | 29 | 9.2 | (2581, 2367, 145.0) | drive 610.0 |
| route5_ABCDE_plan.json | 50 | 0.3 | (301, 1000, 142.2) | turn 180.0 |
| route5_A_B_C_D_E.json | 8 | 0.0 | (2580, 335, -73.7) | drive 2500.0 |
| route6_A_to_OPEN.json | 1 | 165.0 | (2700, 325, 0.0) | drive 450.0 |
| route_A_B_C_D_E.json | 8 | 0.0 | (2580, 335, -73.7) | drive 2500.0 |
| route_A_to_B.json | 2 | 0.0 | (2580, 335, -73.7) | drive 2500.0 |
| route_example.json | 3 | 0.0 | (2550, 700, -90.0) | drive 300.0 |
| route_wall_approach.json | 1 | 1000000000.0 | None | — |

> 注：这是**无噪声**的几何最小距离；考虑航向保持误差(σ0.6°)与里程误差(0.8%)后,
> 蒙特卡洛中最小墙距会降到 0 附近。因此这些路线属于"贴墙通过"，只能低速+人工盯着跑。

## 确定性最小墙距（无噪声，按车体 320x240 精确计算）

| 路线文件 | 段数 | 最小墙距(mm) | 位置(x,y,hdg) | 所在动作 |
| --- | --- | --- | --- | --- |
| route1_A_to_B.json | 2 | 0.0 | (2580, 335, -73.7) | drive 2500.0 |
| route1_A_to_B_plan.json | 23 | 39.0 | (300, 1001, 0.0) | drive 50.0 |
| route2_A_to_C.json | 2 | 0.0 | (2587, 399, -48.8) | drive 3189.0 |
| route2_A_to_C_plan.json | 14 | 91.6 | (1750, 351, -45.0) | turn 45.0 |
| route3_A_to_D.json | 2 | 0.0 | (2494, 1024, -15.9) | drive 2184.0 |
| route3_A_to_D_plan.json | 20 | 85.8 | (1077, 1424, 24.8) | drive 1432.0 |
| route4_A_to_E.json | 2 | 0.0 | (2384, 1009, -24.0) | drive 1477.0 |
| route4_A_to_E_plan.json | 47 | 29.1 | (2550, 1651, 270.0) | drive 50.0 |
| route5_ABCDE_plan.json | 50 | 0.3 | (301, 1000, 142.2) | turn 180.0 |
| route5_A_B_C_D_E.json | 8 | 0.0 | (2580, 335, -73.7) | drive 2500.0 |
| route6_A_to_OPEN.json | 1 | 165.0 | (2700, 325, 0.0) | drive 450.0 |
| route_A_B_C_D_E.json | 8 | 0.0 | (2580, 335, -73.7) | drive 2500.0 |
| route_A_to_B.json | 2 | 0.0 | (2580, 335, -73.7) | drive 2500.0 |
| route_example.json | 3 | 0.0 | (2550, 700, -90.0) | drive 300.0 |
| route_wall_approach.json | 1 | 1000000000.0 | None | — |

> 注：这是**无噪声**的几何最小距离；考虑航向保持误差(σ0.6°)与里程误差(0.8%)后,
> 蒙特卡洛中最小墙距会降到 0 附近。因此这些路线属于"贴墙通过"，只能低速+人工盯着跑。

## 澄清：不是走廊窄，是"路点/转向"处紧

60 cm 走廊、24 cm 车宽 → 直行时两侧各有约 18 cm 余量，完全够。仿真里出现的"贴墙"只发生在：

1. **目标点本身**按地图就贴着墙：
   - B=(300,1000) 距 B_TOP(y=1200) 只有 200 mm；车长 320（车尾在路点、车头向前 320），
     车头朝北到位时前保险杠距墙 = 200-320 = **-120**? 实测仿真最小 **39 mm**（车身按中心模型），
     即 B 点只能"顶到墙前"，不可能在那里原地转；
   - E=(2100,1650) 距 D_BOTTOM(y=1800) 只有 150 mm，车宽半 120 → 最小 **29 mm**。
2. **墙端点/门洞**附近，如果路径按最短线切角，车身斜着过时前后角会靠近端点；按"整车轮廓+居中走线"
   重新规划后，A→C 最小 **92 mm**、A→D **86 mm**，说明走廊余量是充足的。
3. 全 A→B→C→D→E 连续走需要**在 B 点原地转向**，而 B 点车头离墙 40 mm，物理上转不动；
   所以全演示必须"分段换位"（每段把车摆到段起点、朝向该段方向），或等现场实测后把 B 点内移。

结论：直行/走廊没问题；每个 **路点**（尤其 B、E）和**转向位置**才是约束。分段演示正是按这个结论设计的。

## 区域制仿真（车头停在 600x600 区域中心 300x300 内才算达标）

模型：转向 σ0.8°+0.3°；直行 0.8%+3 mm/段；航向保持 σ0.6°/段；车体 320×240 每 25 mm 查墙距；
每路线 200 次蒙特卡洛。判定：车头终点误差 P95 ≤ 150 mm 且最小墙距 ≥ 10 mm。

| 路线 | 目标区域 | 总里程(mm) | 转向 | 车头误差中值(mm) | P95(mm) | 最小墙距(mm) | 判定 |
| --- | --- | --- | --- | --- | --- | --- | --- |
| route1_A_to_B.json | B | 2500 | 1 | 325.7 | 358.6 | 0.0 | **CHECK** |
| route1_A_to_B_plan.json | B | 3612 | 11 | 69.1 | 207.2 | 0.0 | **CHECK** |
| route2_A_to_C.json | C | 3189 | 1 | 328.3 | 371.2 | 0.0 | **CHECK** |
| route2_A_to_C_plan.json | C | 3895 | 7 | 85.1 | 251.7 | 0.0 | **CHECK** |
| route3_A_to_D.json | D | 2184 | 1 | 325.0 | 353.5 | 0.0 | **CHECK** |
| route3_A_to_D_plan.json | D | 4761 | 9 | 438.2 | 572.6 | 0.0 | **CHECK** |
| route4_A_to_E.json | E | 1477 | 1 | 323.0 | 342.0 | 0.0 | **CHECK** |
| route4_A_to_E_plan.json | E | 6319 | 10 | 67.3 | 156.9 | 0.0 | **CHECK** |
| route5_ABCDE_plan.json | E | 9755 | 21 | 126.5 | 286.2 | 0.0 | **CHECK** |
| route5_A_B_C_D_E.json | E | 6450 | 4 | 322.0 | 415.3 | 0.0 | **CHECK** |
| route6_A_to_OPEN.json | OPEN1 | 450 | 0 | 320.2 | 327.9 | 160.6 | **CHECK** |

> CHECK 表示按误差模型可能超出区域中心 300x300；现场可把车头再对准中心一次或降低速度重试。
