WeieeGRACE/Embodied_RPACS/tests/task4_navigation/records/2026-10-30_场地需求.md

# 场地需求（任务四落地测试）

> 依据：`data/map_v1.json`（workspace 3000×3000 mm、车身 320×240 mm、起点 A=(2700,300)、
> MID_H 墙 y=1200）+ `data/safety.json`（制动/延迟为仿真假设）。

## 1. 现在能跑的单段探针（route 6，50 mm/s，硬限速 60 mm/s）

```
        +Y ↑
            ┌──────────────────────────────────────────┐  ← MID_H 墙（y=1200）
            │                                          │
            │              车头离墙 580 mm 起步         │
            │                 ▲                        │
            │              ┌──┴──┐  车身 320×240        │
            │              │ 车  │                     │
            │              └──┬──┘                     │
            │           起点线 (A)                       │  离右侧界 300 mm
            │                                          │
            └──────────────────────────────────────────┘
            x: 2400(可选A_SIDE)        2700            3000
```

| 几何量 | 数值（来自地图） |
| --- | --- |
| 起点 A（车尾参考点） | (2700, 300)，车头朝 **+Y** |
| MID_H 墙 | **y = 1200 mm**，x 从 1200 到 3000（水平墙，垂直于行驶方向） |
| 起步时车头到墙 | **580 mm**（ToF 事件窗口 100–700 mm，能看见 ✓） |
| 段确认里程 | 400–430 mm → 停时车头离墙 **150–180 mm** |
| 硬停里程 | 520 mm → 离墙 60 mm（不会再往前） |
| 前向停车阈值 | 120 mm |
| 车体 | 320（长）× 240（宽）mm；原地旋转扫掠 ≈ 400 mm |

### 需要多大地方

| 方案 | 纵深（+Y） | 宽度（±X） | 说明 |
| --- | --- | --- | --- |
| **最小可用** | **1.4 m** | **0.8 m** | 车尾到墙 0.9 m + 起点后 0.25 m + 墙后 0.25 m；两侧各 0.3 m |
| **推荐（好操作）** | **2.0 m** | **1.5 m** | 两侧留 0.5 m 给操作者站 + 急停 |
| 完整地图（以后跑 B/C/D/E/巡逻） | **3.8 m** | **3.8 m** | 3×3 m 地图 + 四周 0.4 m 余量；房间 4×4 m 更稳 |

> 结论：**现在这段只需要约 2 m × 1.5 m 的平整地面**；要跑完整任务四地图，准备 **4 m × 4 m** 的房间。

## 2. 场地怎么摆（探针）

1. **墙板（MID_H）**：宽 **≥1.0 m**、高 **≥0.3 m**、平板刚性、垂直立放，**垂直于车头方向**，
   放在起点线前方 **900 mm**（= 车尾到墙；车头到墙 580 mm）。
   - 表面别反光太强（ToF 测的是漫反射），别倾斜（倾斜会让测距变远，事件窗口可能错过）。
2. **起点线**：用胶带标一条横线，车尾对准它；车头朝墙；横向居中（若按完整地图，车中心在 x=2700，
   距右侧界 300 mm；只摆墙板时保持两侧各 ≥0.4 m 空旷即可）。
3. **地面**：干燥平整、不打滑（瓷砖/木板均可，**不要地毯**，编码器里程会打滑）。
4. **人站位置**：站在车**侧后方 1 m 左右**，手边就是急停/电源开关；**不要站在车头与墙之间**。
5. 墙后留 0.2 m、车后留 0.25 m，避免车/墙/人互相挤。

## 3. 如果要搭完整任务四地图（3 m × 3 m）

地图坐标原点是围栏内左下角，A 点在右下角附近（x=2700, y=300）。墙段（单位 mm，墙厚 3）：

| 墙 | 起点 | 终点 |
| --- | --- | --- |
| OUT_BOTTOM | (0,0) | (3000,0) |
| OUT_RIGHT | (3000,0) | (3000,3000) |
| OUT_TOP | (3000,3000) | (0,3000) |
| OUT_LEFT | (0,3000) | (0,0) |
| B_TOP | (0,1200) | (600,1200) |
| B_SIDE | (600,600) | (600,1200) |
| C_PLUS_H | (570,2150) | (1170,2150) |
| C_PLUS_V | (870,1850) | (870,2450) |
| SOUTH_STUB | (1200,0) | (1200,600) |
| **MID_H** | **(1200,1200)** | **(3000,1200)** |
| MID_V | (1800,600) | (1800,2400) |
| D_RIGHT | (2400,1800) | (2400,2400) |
| D_BOTTOM | (1800,1800) | (2400,1800) |
| A_SIDE | (2400,0) | (2400,600) |

> 注意：A_SIDE 在起点左侧 300 mm，车宽 240 → 车左缘离它只有 180 mm；起点要摆准，否则容易擦墙。
> 中心十字改为两片拼（横板 + 竖板），四条臂各 300 mm（地图 v2）；斜 X 墙已取消。

## 4. 其它测试要的空间

| 测试 | 空间 |
| --- | --- |
| 传感器/串口自检（不推车，架空已完成） | 桌面即可 |
| 落地低速直线（eth_motion 开环位流） | 至少 2 m 长 × 1 m 宽（10 s @ 0.1 m/s = 1 m） |
| 原地转/差速 | 车体扫掠 0.4 m，四周各留 0.5 m → 1.5 m × 1.5 m |
| 完整任务四地图 | 3 m × 3 m + 余量 → 4 m × 4 m 房间 |
