WeieeGRACE/Embodied_RPACS/tests/t4_lite_drive/records/2026-10-30_夜间_直线闭环通过与相机问题.md

# 2026-10-30 夜间：直线行走闭环通过 + 相机测墙问题定位

## 1. 今天完成（硬件实测）

### 1.1 直线行走：编码器里程 + 陀螺仪航向保持 → PASS

| 项 | 结果 |
| --- | --- |
| 场地（卷尺） | 车头→墙 770 mm |
| 目标行程 | 650 mm（770−120） |
| 实测里程 | 658 mm（到点 651 + 惯性 7），误差 1.2% |
| 停车复测（卷尺） | **车头→墙 112 mm**（预期 120，误差 8 mm） |
| 航向 | yaw 全程在参考 ±2.8° 内，收敛 −1.7°，无发散 |
| 故障 | 运动中 fault 干净，到点自动 STOP |

结论：**编码器执行距离 + 陀螺仪修正姿态**这条链路可用。

### 1.2 修掉的关键问题

1. **IMU 时序崩溃**：IMU 链放在 125 MHz 域产生 **−10.7 ns** setup 违规，125M 域整体不稳（电机时好时坏）。
   - 处理：IMU 移到 **50 MHz 域（clk_50m/T9）** + toggle 握手跨时钟（yaw_cdeg 200 Hz 更新）；
   - bridge 增加一级流水；100 ms 测速拆 3 拍；
   - 结果：**+1.147 ns，无违规**；运动仿真三套 PASS。
   - 位流：`impl/pnr/t4_lite_top.fs` SHA-256 `A55B465CACE54B989CF4DB23679D429C3C29FB5FD99671E472DF5E8DAB74D2F0`。
2. **航向修正律标定**（硬件实测）：
   - `cmd(vl>vr)` → yaw 增大（左转）；`cmd(vl<vr)` → 右转；
   - 修正：`corr = clamp(1.5 × err_deg, ±20) mm/s`，`vl = v + corr, vr = v − corr`；
   - 之前"越修越偏"的真因是**增益单位错**（err 是度，按 0.03 算 ≈ 没修正）。
3. **心跳帧长度**：协议要求 1 字节 seq，0 字节会被丢弃 → `link_ok` 永不恢复 → 电机门控常关。
4. **清故障顺序**：`CLEAR_FAULT` 必须在心跳恢复 (`link_ok=1`) 之后发。
5. **ToF 误触发**：单次跳变就锁停 → 改为连续 5 次有效采样 ≤120 mm；并排除 0/20 哨兵。

### 1.3 事故记录（撞墙）

- 一次相机测距把 782 mm 报成 997 mm（相机主要看到地面/远处），而 ToF 兜底又被关闭（读数不可靠），
  车按 877 mm 目标行驶，在墙前撞停。低速（~100 mm/s）无明显损伤，事后已改回"卷尺给目标"的流程。
- 教训：**测距传感器可信度未验证前，不允许自动按传感器距离动车**；必须有人工卷尺基线。

## 2. 相机测墙问题（待解决）

- 相机俯角 **23° 固定（规定值）**，墙板高 **30 cm**。
- 800 mm 处深度图（12×16 中值网格）：行 0→479 的深度从 1052 单调降到 620，**没有 800 mm 的恒定深度带**；
  行 200–240 有明显跳变（1194 → 1092）。
- 含义：当前视野下 30 cm 矮墙只占极窄一条，主体是地面梯度；远端 ~1.1–1.2 m 是墙后背景。
- "垂直面=深度恒定"的检测器在该视角下**未检出** 800 mm 平面（`distance_mm=None`）。
- 需要：用 SDK 内参把深度反投影成 3D 点云，拟合地面（求相机高度/俯角），再找竖直面；
  或改安装/换更高标定靶先验证检测器。

## 3. 下一步

1. 相机：点云平面拟合（地面标定 + 竖直面检测），用卷尺 500/800/1200 mm 三点验证；
   在验证通过前，驾驶工具**只用卷尺目标**，不接相机距离。
2. ToF：继续旁路（`TOF_STOP_EN=0`），只在最后 100 mm 作为可选粗保护（需先去噪）。
3. 多段/往返：等相机距离可信后再做（每段终点用相机测距）。

---

## 补充（22:00 后）：相机测墙标定成功，相机驱动全闭环通过

### 关键发现

1. 现场彩色图确认：相机俯角 23°（固定），视野里**墙在上方、地面在下方**（墙面 + 踢脚线在图像顶部）。
2. 之前"相机读数偏大"的真相：**相机装在车头后方 244 mm**，相机测到的是"相机→墙"，
   而卷尺量的是"车头→墙"。旧代码把相机值直接当车头距离 → 目标多走 ~240 mm → 上次撞墙。
3. 标定：相机读数（图像上方墙带中值） **1046 mm − 244 = 802 mm**，卷尺 800 mm（误差 2 mm）。

### 修正

- 测墙改为取**图像上方 12% 行**（墙带）中值（此前用中心 ROI，混入地面）。
- 新增 `--cam-offset 244`：车头距墙 = 相机墙距 − 244。
- 驾驶起点斜坡与"无进展"判定放宽（实车约 1 s 才起步，原 0.8 s 会误判）。

### 相机驱动全闭环实测（PASS）

| 项 | 数值 |
| --- | --- |
| 相机墙距 | 1046 mm |
| 换算车头距墙 | 802 mm（卷尺 800） |
| 目标行程 | 680 mm（802 − 120 − 2 取整） |
| 实测里程 | **680.5 mm** |
| 航向 | 全程相对误差 ≤3.1°，收敛 −1.6° |
| 停车 | 到点 STOP，最终 687.5 mm；推算车头距墙 ≈114 mm |

链路：Pi 深度相机 → 千兆 UDP → FPGA 编码器执行 + 陀螺仪保持 → 遥测闭环。

### 仍待验证/风险

1. `244 mm` 偏移需在第二个距离复核（600 mm 与 1200 mm 各一次），确认是常数。
2. 相机最小深度 ~0.2–0.3 m：最后 ~120 mm 段相机无效，靠编码器；ToF 仍旁路。
3. 125 MHz 域仍按 100 MHz 基准分析（沿用此前所有位流的口径）。
