WeieeGRACE/Embodied_RPACS/tests/task4_navigation/records/2026-10-30_距离模式单段通过.md

# 距离模式单段探针 硬件通过报告（2026-10-30 19:55）

## 结论

**PASS** —— 简化后的"编码器执行 + ToF 仅停车"单段探针在地面实测通过：

```
T4 SEG=0 DIST=432mm YAW=-1.200° WALL=NONE FAULT=NONE
```

（另一次：`DIST=432mm YAW=-0.194° WALL=NONE FAULT=NONE`，共 2 次成功启动。）

## 本版做法（按用户要求简化）

| 项 | 实现 |
| --- | --- |
| 走多远 | **编码器里程**：0→430 mm 到达即成功，与地图/墙事件无关 |
| 轮径 | **65 mm**：`UM_PER_REV=204203`，速度目标换算 `73/1024`（原 9/128 偏 1.4%） |
| ToF | **只做停车边界**：前向 ≤120 mm 强制停（主工程避障 STOP_MM=130 同级） |
| 地图关联/位姿/墙事件 | 全部不参与（`REQUIRE_WALL_EVENT=0`） |
| 成功判据 | `FAULT=NONE` 且 DIST 在 400–440（430 触发 + 5 tick 停稳多出 ~2 mm） |
| 安全 | KEY2 急停、STBY 门控、PWM 限幅、硬限速 60 mm/s 均保留 |

## 位流

| 文件 | SHA-256 |
| --- | --- |
| `impl/pnr/task4_navigation_distance.fs`（无线串口 L12） | `BC995764B4C5C72052FF9F0884340612AFBADBF6298FB26F1A0296CAC64A46E3` |

## 仿真

- 事件段：PASS（`map-linked sample debounce, ... obstacle and hard-stop no-DONE`）
- 物理闭环：PASS（stop error 32.28 mm，yaw 0.692°）
- 板级安全：PASS（标定故障、急停切断/锁存、复位安全重入）
- 工具自检：14/14 PASS（含 `--profile distance` 回放）

## 备注

- 432 mm 比表定 430 多 2 mm：成功判据在 100 Hz tick 触发，之后还有 5 tick 停稳判定，期间车再走约 2 mm。若要求严格 ≤430，可把触发阈值提前 2–3 mm（`expected_max_mm` 相关逻辑）。
- 日志里 `FAULT=GEOMETRY / DIST=0` 的记录都是"没等就绪就按启动"造成的空按，不影响通过记录。
- ToF 固定偏置（前 +60 / 右 +70 / 左 +15 mm）已按用户实测做进 RTL（`tof_calibrate`），OLED/停车边界都使用标定后距离。

## 下一步（已与用户对齐方向）

1. **深度相机测真实距离**：Pi 侧用 Orbbec 深度相机测"车头→墙"距离 D，算目标行程 = D − 安全余量。
2. **链路下发**：复用 `eth_link_protocol`，加"走 N mm"命令；FPGA 用编码器执行、ToF 兜底停车。
3. 目标工程：`tests/t4_lite_drive/`（独立，不碰主工程与现有任务四工程），先仿真后上板。
