WeieeGRACE/Embodied_RPACS/tests/task4_navigation/records/floor_20261030_1953_pass.md

# 任务四地面段测试报告

| 项 | 值 |
| --- | --- |
| 时间 | 2026-10-30 19:58:08 |
| 记录文件 | `floor_20261030_1953_pass.log` |
| 解析 | 记录 2 条 / 输入 108 字节 / 垃圾 0 / 残留 0 |
| 判定 | **PASS** |

## 段记录

| SEG | DIST(mm) | YAW(°) | WALL | FAULT |
| --- | --- | --- | --- | --- |
| 0 | 432 | -1.200 | NONE | NONE |

## 逐项检查

| 检查 | 结果 | 详情 |
| --- | --- | --- |
| record_present | PASS | 1 条记录 |
| single_record | PASS | 记录数=1 |
| seg0_segment_id | PASS | SEG=0 期望=0 |
| seg0_fault | PASS | FAULT=NONE |
| seg0_distance_confirmed | PASS | DIST=432mm 期望 [400, 440] |
| seg0_yaw | PASS | YAW=-1.200° 容差 ±5.0° |

**结论**：该段正常完成——墙段命中、里程在确认区间、航向在容差内、无故障。
