WeieeGRACE/Embodied_RPACS/tests/task4_navigation/records/floor_20261030_1629.md

# 任务四地面段测试报告

| 项 | 值 |
| --- | --- |
| 时间 | 2026-10-30 16:36:22 |
| 记录文件 | `floor_20261030_1629.log` |
| 解析 | 记录 8 条 / 输入 432 字节 / 垃圾 0 / 残留 0 |
| 判定 | **SAFE_STOP** |

## 段记录

| SEG | DIST(mm) | YAW(°) | WALL | FAULT |
| --- | --- | --- | --- | --- |
| 0 | 507 | 2.525 | NONE | BLOCKED |

## 逐项检查

| 检查 | 结果 | 详情 |
| --- | --- | --- |
| record_present | PASS | 1 条记录 |
| single_record | PASS | 记录数=1 |
| seg0_segment_id | PASS | SEG=0 期望=0 |
| seg0_fault_known | PASS | FAULT=BLOCKED |
| seg0_stopped_within_hard_stop | PASS | DIST=507mm ≤ 硬停 520mm |

**结论**：安全停车（有故障码或未命中墙段），未超过硬停里程；请按 FIELD_TEST_GUIDE 排查后重测。
