WeieeGRACE/Embodied_RPACS/tests/task4_navigation/records/2026-10-30_落地测试准备报告.md

# 落地测试准备报告（2026-10-30）

> 目标：把落地（地面行驶）测试要用的**程序**全部写好、仿真跑通，上板即用；同时把**速度上限做进 RTL**。

## 1. 速度限制（本次重点）

| 层 | 限制 | 位置 |
| --- | --- | --- |
| 段表 | 本段 `50 mm/s` | `nav_segment_table.v` 7'b1100000 |
| 航向修正 | 每轮 ≤ speed/3（约 ±17 mm/s） | `nav_event_segment_controller.v` |
| **顶层硬限幅（新增）** | 左右轮目标 **钳在 ±60 mm/s** | `nav_speed_limit.v` + `task4_navigation_board_top.v` |
| PID 输出 | 占空比 ≤25% | `PWM_LIMIT=CLK_HZ/PWM_HZ/4` |
| 启动斜坡 | 逐拍上升 | `pwm_and_startup_ramp.v` |

**为什么放在顶层**：段表、航向修正、以后调参都可能把目标速度算大；`nav_speed_limit`
是最后一道硬件闸门，**任何软件/表格错误都不能让轮子超过 60 mm/s**。

改动方式：
- 新增 `src/nav_speed_limit.v`（纯组合钳位 + `clamped` 标志）；
- `task4_navigation_board_top.v` 增加参数 `MAX_WHEEL_SPEED_MM_S=60`，在 `convert_mm_s()`
  之前插入限幅；
- `task4_navigation_single_leg_probe_top.v` 透传该参数（默认 60）。

验证：
- 新增 `sim/tb_nav_speed_limit.v`：0 / ±42 / ±60 直通；61、500、INT32 极值全部钳到 ±60，
  单轮钳位标志正确 —— **7/7 PASS**；
- 全工程回归重跑：RTL 编译、pose/guard/supervisor/event/map、**物理闭环**
  （PASS，停车误差 32.28 mm、航向 0.692°）、板级安全默认（PASS）、三个几何/碰撞脚本；
- `run_sim.ps1` 已把限速测试纳入并检查 PASS 标记。

## 2. 两个探针位流（都带硬限速）

| 变体 | 文件 | SHA-256 | 调试串口 |
| --- | --- | --- | --- |
| USB 串口 | `impl/pnr/task4_navigation_single_leg_probe.fs` | `F09B6BCC4A571A60A18120976AF072ED4AE71E96B491B7BB686CE0699D49CFF4` | V8（板载 CH9102） |
| **无线串口（推荐）** | `impl/pnr/task4_navigation_single_leg_probe_wireless.fs` | `270D817DAAAD801B9F7D13466D79E44ED32E10DB15503BAC309A6D4A75222CC7` | L12（P6-21 → WCH-Link） |

两个位流逻辑完全相同，只差 `uart_tx` 引脚；资源与 Fmax 与改前一致（见 `impl/pnr/*.rpt.txt`）。

## 3. 落地测试工具链（新增）

| 工具 | 作用 |
| --- | --- |
| `tools/t4_log.py` | 解析 54 字节段记录（容忍分块/乱码/丢字节，自动重同步） |
| `tools/t4_capture.py` | 串口采集（自动找 COM/ttyACM，带时间戳，原始 + JSONL，实时打印） |
| `tools/t4_validate.py` | 判读 PASS / SAFE_STOP / FAIL（单段探针基线：SEG=0、WALL=MID_H、400–430 mm、硬停 520 mm、航向 ±5°） |
| `tools/t4_floor.py` | **一条命令**：位流 SHA 校验 → 采集 → 判读 → Markdown+JSON 报告；`--replay` 可复判已有日志 |
| `tools/t4_selftest.py` | 13 个场景的仿真自检（含用 RTL 闭环仿真 CSV 回放） |

### 仿真实证

```
PASS t4_selftest (13 scenarios)
```
覆盖：正常 415 mm、航向 ±1.2°、航向 12°（判失败）、墙不匹配、里程过短、未确认墙硬停（SAFE_STOP）、
超硬停、未知故障码、无记录、分块+乱码、重复记录、允许安全停车模式、**RTL 闭环 CSV 回放**
（SEG=0 DIST=417 YAW=+0.692° WALL=10 → PASS）。

用合成抓包跑 `t4_floor.py --replay` 也能生成完整报告（`records/_selftest_replay.md`）。

## 4. 上板怎么做（详见 `FLOOR_TEST_RUNBOOK.md`）

1. 烧**无线版**位流（推荐，车不用拖线）：
   ```powershell
   programmer_cli --device GW5A-25A --run 2 --fsFile <abs>/impl/pnr/task4_navigation_single_leg_probe_wireless.fs --cable "Gowin USB Cable(FT2CH)"
   ```
2. 电机电源先断检查 STBY/led_ready/OLED → 接线 → 架空确认方向 → 急停放行。
3. Pi/PC 一条命令采集+判读：
   ```bash
   python3 tools/t4_floor.py --seconds 60
   ```
   然后放车到 A 点、朝 +Y、按启动键；结束后自动打印 `判定：PASS` 和报告路径。

## 5. 需要你确认/决定的

1. **急停键（KEY2）** 仍只能人工按；本轮未做自动测试。
2. 60 mm/s 这个硬上限是否合适？（段表 50 + 航向修正 17 = 66.7，被钳到 60；如果你希望允许到 66.7 就把
   `MAX_WHEEL_SPEED_MM_S` 改成 67 重编。）
3. 地面测试建议先跑一段；若实测停车距离明显大于假设（20 mm），要回头更新 `collision_prediction.py`。

## 6. 提交

`6335a30`（已推送）：硬限速 RTL + 限速仿真 + 全回归 + 两个探针位流 + 工具链 + Runbook。
主工程与旧避障工程零改动。
