WeieeGRACE/Embodied_RPACS/tests/eth_motion_test/records/2026-10-30_B4_架空车轮电机台架测试报告.md

# B4：架空车轮（wheels-up）电机台架测试报告

| 项 | 值 |
| --- | --- |
| 日期 | 2026-10-30 10:39–10:55 |
| 前提 | 车辆**已架空**（车轮离地）、电机电源接通、板上 **`eth_motion_top.fs`**（SHA256 `AAC99B3B…CCBE3`） |
| 结论 | **全部通过**：链路 12/12、故障语义 16/16、台架动作 16/16、运动长稳 120 s PASS。**未出现任何非预期故障**，未触发任何安全停车 |

> ⚠️ 本报告只覆盖"轮子转起来"能验证的部分（协议、安全、驱动电气行为）。
> **轮子转向/转速/是否真的转动**需要目视确认——见 §5 的核对清单。

---

## 1. 环境

| 项 | 值 |
| --- | --- |
| FPGA | GW5A-25A，JTAG 正常，运行 `eth_motion_top.fs`（含电机输出） |
| Pi | eth0 `192.168.0.1/24`、1000 Mb/s、静态 ARP 正常 |
| 遥测 | 全程 **50 Hz 左右**，最大帧间隔 40.1 ms |
| 命令 | 20 Hz（满足 CMD_TIMEOUT=500 ms 要求） |
| CPU | Pi 侧 0.8% 均值（纯链路+命令） |

## 2. 测试项与结果

### 2.1 链路自检（`eth_link_test.py`）— **12/12 PASS**

遥测 150 帧/3 s（**50.00 Hz**）、0 解析错误、心跳 30 ms、CLEAR/SET_VEL/STOP 的 ACK 与 seq 回显全部正确。

### 2.2 安全/故障语义（`eth_fault_test.py`）— **16/16 PASS**

停心跳→LINK_LOST 锁存、停止中 SET_VEL→REJECT_STOP、超限→REJECT_OVER_LIMIT、坏帧/未知类型忽略、遥测保持 50.01 Hz。

### 2.3 台架动作矩阵（`bench_motion_test.py`）— **16/16 PASS**

| # | 用例 | 命令 | ACK | 结果 |
| --- | --- | --- | --- | --- |
| 1 | 前进 50 mm/s | L=+50 R=+50 | 50×OK | ✅ |
| 2 | 前进 100 | +100/+100 | 50×OK | ✅ |
| 3 | 前进 150 | +150/+150 | 50×OK | ✅ |
| 4 | 前进 200 | +200/+200 | 50×OK | ✅ |
| 5 | 前进 250 | +250/+250 | 50×OK | ✅ |
| 6 | **前进 300（满速）** | +300/+300 | 50×OK | ✅ |
| 7 | 后退 50 | −50/−50 | 50×OK | ✅ |
| 8 | 后退 150 | −150/−150 | 50×OK | ✅ |
| 9 | 原地转（左反右正） | −120/+120 | 50×OK | ✅ |
| 10 | 原地转（左正右反） | +120/−120 | 50×OK | ✅ |
| 11 | 差速 | −100/+200 | 50×OK | ✅ |
| 12 | **快速换向 ×6**（死区压力） | ±150 交替 | 97×OK | ✅ |
| 13 | **行驶中 STOP** | 200→STOP | STOP=OK，随后 SET_VEL=**REJECT_STOP_LATCHED** | ✅ |
| 14 | 清故障后恢复 | CLEAR→+100/+100 | 40×OK | ✅ |
| 15 | **行驶中心跳丢失** | 120→停心跳 0.8 s | SET_VEL=**REJECT_LINK_LOST**，遥测出现 LINK_LOST | ✅ |
| 16 | **持续运行 20 s** | +200/+200 | 414×OK | ✅ |

> 每个用例都带 0.4 s 斜坡起步/收尾；异常会立即 STOP（本次一次都没触发）。

### 2.4 运动长稳（`bench_motion_soak.py --duration 120`）— **PASS**

| 指标 | 值 |
| --- | --- |
| 工况循环 | 前进150 12 s → 后退150 12 s → 原地转 10 s → 停 4 s，共 4 轮 |
| ACK | **2626 全部 OK（100%）** |
| 遥测 | 6636 帧 @ **50.40 Hz**，最大间隔 40.1 ms |
| 故障分布 | 健康帧 6576；0x22（起步建链）51；0x01（STOP）8；0x20 1 |
| CPU | 0.8%（max 1.0%） |

### 2.5 低速蠕行与单轮驱动（`eth_drive.py`）— ACK 全部 OK

| 用例 | 命令 | 结果 |
| --- | --- | --- |
| 蠕行 20 mm/s | +20/+20 ×3 s | 斜坡/巡航/STOP 全部 OK |
| 蠕行 30 mm/s | +30/+30 ×3 s | 全部 OK |
| 蠕行 40 mm/s | +40/+40 ×3 s | 全部 OK |
| 单左轮 | +150 / 0 ×2 s | 全部 OK |
| 单右轮 | 0 / +150 ×2 s | 全部 OK |

## 3. 过程中发现并修掉的问题（工具侧，非固件）

1. **步骤收尾的 STOP 被误判为异常**：台架脚本统计故障窗口时把"步骤结束时主动 STOP"的 0x01 也算进去了 → 已改为只统计停车前窗口。
2. **旧 ACK 干扰判定**：`wait_ack` 会匹配队列里的历史 ACK，导致"停止后 SET_VEL"看起来是 OK → 已改为先清空 ACK 队列并用 seq 精确匹配。
3. 长稳脚本的 CPU 采样和起步建链窗口误判 → 已修。

> 这三处都是测试脚本的问题，固件行为自始至终符合设计。

## 4. 安全行为（本轮实测确认）

| 场景 | 实测表现 |
| --- | --- |
| 行驶中 STOP | 立即停 + 锁存，后续 SET_VEL 返回 `REJECT_STOP_LATCHED`，必须 CLEAR 才能恢复 ✅ |
| 行驶中心跳丢失（模拟断网） | 300 ms 心跳超时后 LINK_LOST 锁存，SET_VEL 返回 `REJECT_LINK_LOST` ✅ |
| 恢复 | 恢复心跳 + CLEAR 后可正常驱动 ✅ |
| 快速换向 | 无异常 ACK、无故障位置位，换向经过驱动内部死区 ✅ |

## 5. 需要你目视确认的（我这边看不到轮子）

| 观察项 | 期望 |
| --- | --- |
| 前进 50→300 | 两轮同向转，速度随命令**明显递增**，最高速不发抖 |
| 后退 50/150 | 两轮反向转 |
| 原地转 | 左右轮反向，车身可感知转向趋势 |
| 差速 | 两轮转速不同 |
| 快速换向 | 换向平顺、无"咔哒"异响、无异常抖动 |
| 低速蠕行 20/30/40 | 能稳定转（若 20 卡住属电机死区，属正常） |
| 单左/单右 | 只有对应轮转 |
| 停机 | STOP 后立刻停、无惯性拖转 |

> 如果某一项与期望不符（例如某轮反向），请记录是**哪个轮子**，我可以改 RTL 或换线后重编位流再测。

## 6. 已知限制

1. 本测试位流**不读编码器**，遥测里 `enc_l/enc_r` 恒为 0 → 无法定量测转速/里程；方向与转速只能目视。
2. 速度是开环映射（`duty = v×20`，300 mm/s≈96% 占空比），没有 PID 闭环。
3. 急停键（KEY2）需要**人工按住**才能测，本轮未做（等效安全路径已由 STOP/心跳丢失覆盖，且仿真里已单独验证）。
4. `CMD_TIMEOUT=500 ms`：命令必须 ≥10 Hz（本轮 20 Hz）。

## 7. 证据文件

| 文件 | 内容 |
| --- | --- |
| `records/2026-10-30_bench_motion.json` | 16 个台架步骤的逐项 ACK/故障/遥测 |
| `records/2026-10-30_fault_motion.json` | 16 项安全语义 |
| `records/2026-10-30_motion_soak.json` | 120 s 运动长稳 |
| `records/flash_motion_bench.log` | 位流烧写记录 |

## 8. 下一步建议

1. **落地测试**（低速 100 mm/s、直线/转向/刹车）——需要你在场地里做，脚本用 `eth_drive.py`。
2. 若要定量验证转速/方向，建议下一步在测试位流里接编码器并把计数放进遥测（主工程 `dual_ab_quadrature_encoder` 现成可用）。
3. 加 PID 闭环（主工程 `dual_speed_pi_pid_controller` 也现成），可以把"开环占空比"升级成"速度闭环"。
