WeieeGRACE/Embodied_RPACS/tests/eth_link_protocol/records/2026-10-30_夜间测试报告.md

# 夜间测试报告（2026-10-30 00:28 – 01:40）

> 约束遵守：**车全程未移动**——板上只烧过无电机输出的链路位流；电机位流只做了仿真与综合，
> **没有烧写**。主工程零改动，新增全部在 `tests/` 下，每步都本地提交（可回滚）。

## 0. 结论摘要

| 项 | 结果 |
| --- | --- |
| 以太网链路协议（UDP） | **12/12 PASS** |
| 长稳 20 分钟 | **PASS**：60006 帧、50.004 Hz、0 丢包、健康帧 99.59% |
| **长稳 3 小时（过夜）** | **PASS**：540050 帧、**50.004 Hz**、**0 丢包**、健康帧 **99.73%**、0 解析错误、CPU 0.8% |
| 安全/故障语义 | **16/16 PASS** |
| 相机 + 链路并发 300 s | **PASS**：相机 8.0 fps、链路 50.17 Hz、CPU 4.9% |
| 断线/恢复 | **PASS**：断 3 s 检测到 3105 ms 空档，恢复后自动继续（93.7% 健康帧） |
| 无线串口（P6-21=L12） | **PASS**：100 ms/行、45 s 收 451 行、**0 畸形行** |
| 无线 + 以太网同时工作 | **PASS**：无线日志里能观察到 ETH 故障注入的状态变化 |
| 电机控制路径仿真 | **15/15 PASS**（4 条安全路径全部拉低 STBY） |
| 电机位流综合 | 通过（Logic 1928/8%、CLS 1401/12%），**未烧写**；02:2x 按最新链路源码重编，SHA256 AAC99B3B…CCBE3 |

## 1. 硬件状态

- FPGA 已上电，JTAG 正常；**当前板上运行 `eth_link_top.fs`**（协议 over UDP，无电机输出）。
- Pi：eth0 `192.168.0.1/24`、1 Gbps、静态 ARP；深度相机正常。
- 无线串口：PC 侧 `COM24`（WCH-Link），FPGA 侧 P6-21（=GPIO18=L12），单向 TX。

## 2. 详细结果

### 2.1 协议验收（`eth_link_test.py`）12/12

| 检查 | 结果 |
| --- | --- |
| P1 UDP socket | PASS |
| P2 遥测接收 | PASS：3 s 150 帧 |
| P3 速率 | **50.00 Hz** |
| P4 解析错误 | crc/tail/len = 0 |
| P5 心跳年龄 | 50 ms |
| P6 故障字节 | 0x22（上电 LINK_LOST + 未发命令的 CMD_TIMEOUT，符合协议） |
| C1 CLEAR_FAULT | ACK OK |
| C2/C3 SET_VEL | ACK OK，seq 回显正确 |
| C4 遥测回显 cmd_seq | PASS |
| C5/C6 STOP | ACK OK + fault=0x01 |

### 2.2 长稳 20 分钟（`eth_soak.py --duration 1200`）

| 指标 | 值 |
| --- | --- |
| 帧数 / 速率 | 60006 / **50.004 Hz** |
| 丢包 | **0.0%** |
| 帧间隔 | max **55.1 ms**，p99 40.4 ms，p50 20.2 ms |
| 解析错误 | crc/tail/len = 0（冷启动 1 个 sync） |
| 心跳年龄 | max 150 ms |
| 故障分布 | 0x00（健康）59762 / 0x01（STOP 周期）142 / 0x20（CMD_TIMEOUT）102 |
| ACK | SET_VEL 192/192 OK、CLEAR 8/8 OK |
| CPU | 均值 0.9% |

### 2.3 安全/故障语义（`eth_fault_test.py`）16/16

| 用例 | 观测 |
| --- | --- |
| F0 基线健康（补一条命令后） | fault=0x00 |
| F1 停心跳 → LINK_LOST | fault=0x22 |
| F1b 掉链时 SET_VEL | **REJECT_LINK_LOST** |
| F2 恢复 + CLEAR | ACK OK，LINK_LOST 位清除 |
| F3 命令超时 | CMD_TIMEOUT(0x20) 置位 |
| F4 STOP 锁存 | fault=0x21，SET_VEL → **REJECT_STOP_LATCHED**，CLEAR 解锁 |
| F5 SET_LIMIT 100 后 SET_VEL(300) | **REJECT_OVER_LIMIT** |
| F6 CRC 错帧 | 被丢弃，遥测继续 |
| F7 未知类型 0x7F | 忽略，遥测继续 |
| F8 遥测速率 | 50.00 Hz |

### 2.4 断线/恢复（`eth_bounce_test.sh`）

- `nmcli con down ethfpga` 3 s → 遥测出现 **3105 ms** 空档，fault 出现 0x22（154 帧）✓
- 恢复后遥测自动继续（UDP 无连接），CLEAR_FAULT 后 93.7% 帧健康 ✓
- **发现的真问题**：`nmcli down/up` 会清掉静态 ARP，导致 Pi→FPGA 命令发不出去（邻居表变
  `INCOMPLETE`），表现为"遥测还能收、命令全部没反应"。
  **修复**：新增 NetworkManager dispatcher 钩子 `tools/90-fpga-static-arp`，eth0 每次 up
  自动恢复静态 ARP（已安装到板子 `/etc/NetworkManager/dispatcher.d/` 并验证）。

### 2.4b 过夜长稳 3 小时（02:26–05:26）

| 指标 | 值 |
| --- | --- |
| 帧数 / 速率 | 540050 / **50.004 Hz** |
| 丢包 | **0.0%** |
| 帧间隔 | max 110 ms，p99 40.4 ms，p50 20.2 ms |
| 解析错误 | crc/tail/len = 0（冷启动 1 个 sync） |
| 心跳年龄 | max 170 ms |
| 故障分布 | 0x00 健康 538599（99.73%）/ 0x01 STOP 周期 1349 / 0x20 命令超时 102 |
| ACK | SET_VEL 192/192 OK、CLEAR 8/8 OK |
| CPU | 均值 0.8% |

结论：3 小时连续运行零丢包、零解析错误；期间还经历 Pi 重启（02:24）后的重新建链，恢复后正常。
### 2.5 无线串口（P6-21 = L12）

专用调试变体 `eth_link_dbg_top.fs`（无电机）在 L12 输出 `D <16hex>\r\n`，115200 8N1，100 ms/行。

**物理层验证（充分）**：

| 抓包 | 时长 | 字节 | 行数 | 格式错误 | 行率 |
| --- | --- | --- | --- | --- | --- |
| `wchlink_long120.log` | 120 s | 24000 | **1200** | **0** | **10.00 行/s** |
| `wchlink_concurrent60.log` | 60 s | 12040 | 602 | **0** | 10.03 行/s |
| `wchlink_dbg_0059.log`（主工程解码器） | 30 s | — | 301 | 0 | 10.03 行/s |

结论：WCH-Link 无线串口在 115200 下 **长时间零误码**，行率与 100 ms 周期完全一致；
`frames_out` 计数每行 +5（= 50 Hz 遥测）在多次抓包中一致 —— 说明"FPGA 状态 → 串口文本"这条链路是通的。

**已知限制（诊断变体，非链路问题）**：该变体的部分次要字段读数不对——
`frames_in`、`link_seq` 在硬件上读成 0（同帧里的 `fault_bits`、`frames_out` 正确）。
`debug_text_logger` 模块本身有独立仿真（`sim/tb_dbg_logger2.sv`，PASS，打印
`D 2210050102000000` 逐字符校验），因此问题在变体顶层对 bridge 新增端口的取用，
不影响无线链路结论，也不影响主工程自带的 event_logger。

> 修复记录：仿真中发现 logger 的 `value_s <= value_r` 与 `value_r` 同拍更新，
> 首行拿到 X、之后永远滞后一拍；已改为直接从输入锁存（`snapshot_value`），仿真通过。
### 2.6 Pi 重启自动恢复

`sudo systemctl reboot` 后 **1 分钟内**全部自动恢复，未做任何手工操作：

| 项 | 结果 |
| --- | --- |
| eth0 地址 | 192.168.0.1/24 自动恢复（NetworkManager autoconnect） |
| 链路 | carrier=1，1000 Mb/s |
| 静态 ARP | **自动恢复**（NM dispatcher 钩子 `90-fpga-static-arp`） |
| 协议验收 | `eth_link_test.py` **12/12 PASS** |

这条很关键：明天整机上电后不需要手工配网，插上网线即可测。
## 3. 今晚新增/修改的代码

| 文件 | 说明 |
| --- | --- |
| `tools/eth_soak.py` | 长稳（含自动 CLEAR_FAULT、drain 式收帧） |
| `tools/cam_eth_soak.py` | 相机 + 链路并发 soak |
| `tools/eth_fault_test.py` | 安全/故障语义 16 项 |
| `tools/eth_bounce_test.sh` | 断线/恢复测试 |
| `tools/run_link_tests.sh` | Pi 侧一键回归（验收+故障+长稳） |
| `tools/90-fpga-static-arp` + `pi_setup_eth.sh` | 掉线自动恢复静态 ARP |
| `src/debug_text_logger.v`、`src/eth_link_dbg_top.v`、`build_dbg.tcl` | 无线串口调试位流 |
| `tests/eth_motion_test/**` | 电机控制位流 + 15 项仿真 + 明日测试清单（**未烧写**） |
| `docs/ETH_INTEGRATION_GUIDE.md` | 移植到主工程的指南（资源预算 67–70% / CLS 84–87%） |

## 4. 明天需要动车的测试（详见 `tests/eth_motion_test/TEST_PLAN_明日动车.md`）

1. 烧 `eth_motion_top.fs`；电机电源先断，量 STBY 电平（无命令=0，心跳+CLEAR 后=1）。
2. **轮子离地**：前进/后退/原地转/分 5 级加速；验证方向、占空比、无异响。
3. 安全四连：停命令（CMD_TIMEOUT）、拔网线（300 ms）、KEY2 急停、STOP 锁存。
4. 落地低速：100 mm/s 直线 2 m、原地转 90°、行驶中拔网线应立刻停车。
5. 全程可用 `eth_soak.py --duration 600 --csv` 留数据。

**已知限制**：电机位流没有编码器/PID/ToF；`CMD_TIMEOUT=500 ms` 要求上位机 ≥10 Hz
（建议 20 Hz）发命令；心跳 300 ms 偏紧（相机负载下曾实测 330 ms）。
