WeieeGRACE/Embodied_RPACS/tests/eth_link_protocol/records/2026-10-30_早上先看这个.md

# 早上先看这个（夜间工作总结）

> 一句话：**不需要动车的测试全部跑完了，全部通过；动车要用的位流/脚本/清单也备好了，但按你的要求没烧没动。**
> 详细数据见 `2026-10-30_夜间测试报告.md`；动车步骤见 `../../eth_motion_test/TEST_PLAN_明日动车.md`。

## 1. 现在的硬件状态（你早上看到的）

| 项 | 状态 |
| --- | --- |
| FPGA | 上电，JTAG 正常；板上跑 **`eth_link_top.fs`**（协议 over UDP，**没有电机输出**，不会动） |
| Pi | 已重启验证过：eth0 `192.168.0.1/24` + 静态 ARP **全自动恢复**，无需手工配 |
| 相机 | 正常（Orbbec Astra Pro Plus） |
| 无线串口 | PC `COM24` ← FPGA P6-21(L12)，验证可靠（10.00 行/s，零畸形） |
| 长稳 | **3 小时长稳已完成：540050 帧 / 50.004 Hz / 0 丢包 / 健康帧 99.73%**；结果在 `~/soak_overnight.json` |

## 2. 夜间通过的测试（都是"不动车"的）

| 测试 | 结果 |
| --- | --- |
| 以太网协议验收（12 项） | **12/12 PASS** |
| 20 分钟长稳 | **PASS**：60006 帧、50.004 Hz、0 丢包、健康帧 99.59% |
| **3 小时过夜长稳** | **PASS**：540050 帧、50.004 Hz、**0 丢包**、健康帧 99.73% |
| 安全/故障语义（16 项） | **16/16 PASS**（停心跳→LINK_LOST、STOP 锁存、超限拒绝、坏帧忽略…） |
| 相机 + 链路并发 300 s（×2 次） | **PASS**：相机 8.0 fps 零错误、链路 50.17 Hz 零丢包、CPU ≈5% |
| 断网 3 s / 恢复 | **PASS**：3105 ms 空档 + 自动恢复；顺手发现并修好"ARP 被清"的问题 |
| 网络劣化（tc netem） | 恒定 300 ms 延迟不丢链（只影响间隔）；100±200 ms 抖动 → 正确触发 LINK_LOST |
| 无线串口 120 s / 60 s / 30 s | 1200 / 602 / 301 行，**0 畸形**，行率 10.00/s |
| Pi 重启自动恢复 | **PASS** |
| 电机路径仿真 | **15/15 PASS**（4 条安全路径都能拉低 STBY） |
| 电机位流 | 已综合（未烧）：`tests/eth_motion_test/impl/pnr/eth_motion_top.fs` |

## 3. 今天（白天）要做的事

```powershell
# 1) PC：烧电机位流（SRAM，掉电失效）
cd tests\eth_motion_test
programmer_cli --device GW5A-25A --run 2 `
    --fsFile (Resolve-Path impl\pnr\eth_motion_top.fs) `
    --cable "Gowin USB Cable(FT2CH)"
```

```bash
# 2) Pi：自检（12 项）+ 安全语义（16 项）
python3 ~/eth_link_test.py
python3 ~/eth_fault_test.py

# 3) 轮子离地：前进 3 s（内置斜坡 + 自动停车）
python3 ~/eth_drive.py --left 150 --right 150 --seconds 3
python3 ~/eth_drive.py --left -150 --right -150 --seconds 3     # 后退
python3 ~/eth_drive.py --left -120 --right 120 --seconds 2      # 原地转

# 4) 落地低速
python3 ~/eth_drive.py --left 100 --right 100 --seconds 60

# 5) 出问题随时停车
python3 ~/eth_drive.py --stop
```

完整清单（含"期望结果"和排查表）见 `tests/eth_motion_test/TEST_PLAN_明日动车.md`。

## 4. 今天要特别注意

1. **第一次一定轮子离地**，并先用万用表确认：无命令时 `STBY`=0，发心跳+CLEAR 后 `STBY`=1。
2. 上位机命令频率 ≥10 Hz（`eth_drive.py` 是 20 Hz）；低于这个会主动 CMD_TIMEOUT 停车，是**正常安全行为**。
3. 电机位流**没有编码器反馈/PID/ToF 避障**，只验证「链路→PWM→H 桥」通路；速度闭环不测。
4. 急停键是 **KEY2（C15）按住才停**，松手恢复；复位是 KEY0。
5. 板子上电后如果没有网络：`sudo bash ~/pi_setup_eth.sh`（一般不需要，重启已自动恢复）。

## 5. 今晚改了什么（提交都在 origin/main）

| 提交 | 内容 |
| --- | --- |
| `975ef92` | 以太网链路工具、无线调试位流、电机位流与 15 项仿真 |
| `4803ecb` | 夜间报告 + 以太网移植指南 |
| `9e383a4` | 20 min 长稳、故障语义 16/16、断线恢复、无线并发、ARP 钩子 |
| `efb44d1` | netem 劣化测试、无线长抓、调试日志器 bug 修复 |
| `ab47a9c` | 安全驾驶助手 `eth_drive.py` |
| `c2842ee` | 电机位流按最终源码重编、Pi 重启恢复证据 |

主工程零改动，全部在 `tests/` 下；工作区里你自己的改动我没碰。
