WeieeGRACE/Embodied_RPACS/tests/orangepi_link_integration/records/2026-10-29_B1_深度相机与链路并发测试.md

# B1：深度相机与 FPGA 链路并发测试（Orange Pi AIpro 单板）

| 项 | 值 |
| --- | --- |
| 日期 | 2026-10-29 13:17–13:23 |
| 目标 | 验证「深度相机」与「100 Hz/50 Hz 链路」在同一块 Orange Pi 上互不拖累，产出可用于建图的遥测数据 |
| 结论 | **ALL PASS**：预检 7/7、链路 50.00 Hz 帧抖动 ≤0.1 ms、0 解析错误；相机 8.01 fps 与 50 Hz 遥测并发 120 s，**遥测最低仍 49.0 Hz**，CPU 均值 30.8% |
| 位流 | `uart_bridge_imu.fs`（链路 + 真实 IMU 姿态，SRAM 烧写，掉电失效） |
| 工程 | `tests/orangepi_link_integration`（独立测试目录，主工程零改动） |

---

## 1. 连接拓扑（实测枚举结果）

```
FPGA GW5A-25A ──(板载 USB 串口 CH9102, VID:PID 1a86:55d4)──> Orange Pi USB
       │                                                     └─ /dev/ttyACM0
       │                                                        (by-id: usb-1a86_USB_Single_Serial_5757024820-if00)
       └── JTAG 下载线 ──> PC（烧位流用，与串口互不影响）

Orange Pi ──(USB3)──> Orbbec Astra Pro Plus
                      ├─ 2bc5:050f  USB 2.0 Camera（RGB）
                      └─ 2bc5:060f  ORBBEC Depth Sensor（深度）
```

> 注意：CH9102 在 Linux 下枚举为 **CDC-ACM `/dev/ttyACM0`**，不是 `/dev/ttyUSB0`。
> 测试工程已改为「按 by-id 自动识别」，避免每次换口改配置。

---

## 2. 执行步骤

```powershell
# PC：烧位流（SRAM）
cd tests\uart_bridge
gw_sh build_imu.tcl    # 若尚未构建
programmer_cli --device GW5A-25A --run 2 --fsFile impl\pnr\uart_bridge_imu.fs --cable "Gowin USB Cable(FT2CH)"
```

```bash
# Pi：一条命令跑完全套
cd ~/rpacs_link_integration
PYTHONPATH=$HOME/rpacs_phase0/pyorbbecsdk-main/install/lib bash run_all.sh 120
```

数据回收到 PC：`tests/orangepi_link_integration/records/`（`*_1323.*`）。

---

## 3. 结果

### 3.1 预检（7/7 PASS）

| 检查 | 结果 |
| --- | --- |
| P1 串口存在 | ✅ by-id 路径 |
| P2 可打开 | ✅ 115200 8N1 |
| P3 收到遥测 | ✅ 150 帧 / 3.0 s（预热 0.5 s 不计） |
| P4 速率 | ✅ **50.00 Hz**（预期 45~60） |
| P5 解析错误 | ✅ **0** |
| P6 心跳年龄 | ✅ 95 ms（≤150），`link_lost=False` |
| P7 故障字节 | ✅ `0x20 [CMD_TIMEOUT]`（未下发速度命令时的正常状态） |

### 3.2 链路采集 30 s（1500 帧，零丢失）

| 指标 | 实测 |
| --- | --- |
| 帧数 / 时长 | 1500 帧 / 29.98 s |
| 速率 | 平均 **50.00 Hz**，min/max 50.00 |
| 帧间隔 | 平均 **20.000 ms**，最大 **20.1 ms**（抖动 ≤0.1 ms） |
| 解析错误 | 0（CRC/尾/LEN/同步/超时 全 0） |
| 心跳年龄 | 最小 12 / 平均 52.7 / 最大 **94 ms** |
| 姿态（静态） | pitch **−1.58° ±0.007**，roll **−1.54° ±0.006** |
| yaw 漂移 | **0.010 °/s**（30 s 内 5.59°→5.89°） |
| 编码器 | 0（车轮未动，符合"不控车"约束） |

### 3.3 相机 + 链路并发 120 s（核心用例，9/9 PASS）

| 指标 | 实测 |
| --- | --- |
| 相机帧数 | **963 帧**，平均 **8.01 fps**（min 8 / max 8） |
| 链路帧数 | **6001 帧**，平均 **50.0 Hz**，**最低 49.0 Hz** |
| 链路错误 | 0 |
| 失联次数 | 0 |
| CPU | 平均 **30.8%**，峰值 **32.1%** |
| 判定 | link_ok / rate / errors / no_loss / hb_age / camera_opened / frames / fps / cpu **全 PASS** |

---

## 4. 本轮修掉的缺陷（都在测试工程里）

1. **`Link.telemetry` 只有 2000 深**：长跑（>40 s @50 Hz）时按下标取帧会停在上限，
   120 s soak 只记录了 2000/6001 帧。已改成**边收边 drain**，现在记录数与解析数一致。
2. **冷启动半帧噪声**：打开串口瞬间从半帧开始，会产生 10~22 个 `sync_err`，被误判成
   "链路有错"。已改为**预热 0.5 s 后再统计**（预检、采集、soak 全部生效）。
3. **端口识别**：原来写死 `/dev/ttyUSB0`，实际设备是 `/dev/ttyACM0`。已改为
   by-id 自动识别（`*1a86*` / `*CH9102*` / `*CH340*`），PC/Pi 通用。
4. 相机判定语义：要求开相机却打不开时，`camera_opened` 直接 FAIL（此前会"假通过"）。

## 5. 结论与下一步

- ✅ **相机与链路可共存**：8 fps 深度流下，50 Hz 遥测仅掉到 49.0 Hz（单帧抖动），
  CPU 约 31%，说明 Pi 的算力与 USB 带宽都有充足余量。
- ✅ **遥测质量足以建图**：帧间隔抖动 ≤0.1 ms、心跳年龄 ≤94 ms、yaw 静态漂移 0.01°/s。
- 下一步（需在测试目录继续）：
  1. 把每帧遥测与相机帧**时间戳对齐**（同一个单调时钟），供 `occupancy.py` 融合；
  2. 相机 15 fps / 30 fps 下复测，找 CPU 拐点；
  3. 编码器速度标定后，用链路返回的里程计替代视觉里程计做交叉验证。

## 6. 证据文件

| 文件 | 内容 |
| --- | --- |
| `records/preflight_1323.json` | 7 项预检逐条结果 |
| `records/link_1323.csv` | 1500 帧逐帧遥测（13 列） |
| `records/link_1323.json` | 30 s 采集汇总 |
| `records/soak_cam_1323.json` | 120 s 相机+链路并发汇总（9 项判定） |
| `records/report_1323.md` | 自动生成的三合一报告 |
