WeieeGRACE/Embodied_RPACS/tests/uart_bridge/records/2026-10-29_夜间交付总结.md

# 夜间交付总结（2026-10-29 凌晨）

> 用户指令：*"今天到明天早上的九个小时把软件能做的全做了"*、*"通信协议、测试程序写好，
> 分好文件做好隔离，改动时做好本地提交方便回滚"*、*"注意 FPGA 板子的资源问题"*、
> *"可以读取板子上的传感器信息，但不要控制车运动"*、*"之后可能会换千兆网线通信"*。
>
> 本文是早上交接用的"一页纸"：做了什么、怎么用、结论是什么、下一步建议。
> （文中数字均已与 `impl/pnr/*.rpt.txt`、`records/*.json`、`records/tb_*.log` 逐项核对。）

---

## 0. 一句话

**上位机 ↔ FPGA 链路 v1 已经从协议冻结做到板级验证：仿真 5 套（106 项）+ 一致性测试全绿，
上板台架 19/19、10 分钟长稳 0 误码；额外交付了"带真实 IMU 姿态"和"资源精简版"两个变体，
并给出主工程集成所需的资源结论与接线指南。主工程零改动，全部改动在独立目录并已 15 次本地提交。**

---

## 1. 现在板子上是什么

| 项 | 状态 |
| --- | --- |
| 位流 | `tests/uart_bridge/impl/pnr/uart_bridge_imu.fs`（链路 + 真实 IMU 姿态） |
| 烧写方式 | **SRAM（易失）**：`programmer_cli --run 2`，**断电重启自动恢复原来的整车固件** |
| 串口 | COM14（CH9102），115200 8N1 |
| 电机 | 位流把 `PWMA/AIN1/AIN2/PWMB/BIN1/BIN2/STBY` 全拉 0（TB6612 standby），**不可能动** |
| 遥测 | 50 Hz，含编码器计数、真实 yaw/pitch/roll、速度、故障位、序号 |

早上想直接看效果（先关掉 Fluent Serial Assistant）：

```powershell
cd tests/uart_bridge
.\tools\uart_link.ps1 -Action monitor -Port COM14
```

---

## 2. 交付物（全部在 `tests/uart_bridge/`，主工程零改动）

| 类别 | 文件 | 说明 |
| --- | --- | --- |
| 协议冻结 | `docs/PROTOCOL_v1.md` (v1.1) | 帧格式、消息表、CRC 向量、时序、故障位、仲裁、UDP 迁移约定 |
| 接入指南 | `docs/INTEGRATION_GUIDE.md` | 接线表、两条接入路线、资源核算、10 项验收清单 |
| RTL | `src/*.v`（9 个模块 + 3 个顶层） | 见 §3 |
| 仿真 | `sim/tb_*.sv`（5 套，共 106 项检查）+ 一致性测试 | 见 §4 |
| 上位机 | `tools/*.py` | 协议库、UART/UDP/文件三种传输、CLI、长稳、一致性、hex 解码、Pi 示例 |
| 构建 | `build.tcl` / `build_imu.tcl` / `build_lite.tcl` / `run_build.ps1` | 三个变体分别综合 |
| 一键回归 | `run_sim.ps1` | 5 套仿真 + 一致性，全绿 |
| 记录 | `records/2026-10-29_uart_bridge_validation.md` 等 | 逐项结果与证据 |

---

## 3. RTL 结构（都按"传输无关"分层）

```text
uart_rx_8n1.v      8N1 接收（过采样、中点采样、帧错误）
crc16_ccitt.v      CRC-16/CCITT-FALSE（逐位展开 ~40 LUT，无查找表）
host_frame_rx.v    AA 55|TYPE|LEN|PAYLOAD|CRC|0D 解析 + 错误分类 + 字节间超时
host_cmd_decode.v  5 种下行命令 → 寄存器（ACK 状态码、限速裁剪、STOP 锁存）
host_link_watchdog.v  300 ms 心跳看门狗（上电即失联锁存，需显式 CLEAR_FAULT）
telem_builder.v    23 字节遥测快照
frame_tx_engine.v  发帧引擎（边发边算 CRC）
uart_bridge_core.v 传输无关核心 + 安全仲裁（STOP > 失联 > 上位机命令）
host_link_motion_adapter.v  链路 → 现有运动层的命令适配（模式/方向/幅值/刹车）
uart_bridge_top.v         板级顶层（纯链路）
uart_bridge_imu_top.v     板级顶层（链路 + IMU 真实姿态）
uart_bridge_lite_top.v    板级顶层（资源精简：8 位计数器 + 无 ACK）
```

**安全契约（三条，必须保留）**：
1. 链路只写"目标速度寄存器"，**从不直接写 PWM**；
2. 心跳超时/STOP/**硬件急停** → 目标速度归零且锁存，恢复需显式 `CLEAR_FAULT`；
3. 任何解析错误只丢弃，绝不把半帧写入寄存器（长度不符的 `CLEAR_FAULT` 不会解锁）。

---

## 4. 验证结果总览

| 验证 | 结果 | 证据 |
| --- | --- | --- |
| 仿真：`tb_core` | **51/51 PASS** | `records/tb_core.log` |
| 仿真：`tb_loopback`（真实 115200 双向） | **23/23 PASS** | `records/tb_loopback.log` |
| 仿真：`tb_motion_adapter` | **19/19 PASS** | `records/tb_motion_adapter.log` |
| 仿真：`tb_system_closed_loop`（串口→链路→适配器→轮子→遥测） | **12/12 PASS**（含失联停车） | `records/tb_system.log` |
| **Python↔RTL 一致性**（435 B 对抗语料） | **25/25 帧完全一致 + 计数器一致** | `records/conformance.log` |
| 板级台架（完整版） | **19/19 PASS**（失联 299 ms 检出） | `records/2026-10-29_uart_bridge_bench.json` |
| 板级台架（IMU 版） | **19/19 PASS**（失联 220 ms 检出） | `..._imu_bench.json` |
| 10 min 长稳（完整版） | 30,004 帧 **0 误码** | `..._soak_600s.json` |
| 10 min 长稳（IMU 版） | 30,005 帧 **0 误码**，49.95–50.04 Hz | `..._soak_imu_600s.json` |
| 板级健壮性（坏帧 + 2000 字节噪声） | **6/6 PASS**：坏帧不生效、遥测不中断、噪声后立即恢复 | `..._robustness_board.json` |
| UDP 传输自检 | **PASS**（200 报文=200 帧，坏 CRC 恰好 50） | 见 §6 |
| 资源 | 完整 1174 Logic/**881 CLS**；精简 1110/**830**；IMU 5430/3671 | `impl/pnr/*.rpt.txt` |

---

## 5. 今晚修掉的三个重要缺陷（前两个是协议设计，第三个是安全实现）

1. **`SET_VEL` 缺 `seq`**：遥测里有 `cmd_seq` 却无来源。已把 SET_VEL 负载从 4 B 扩到 5 B
   （`int16 L | int16 R | uint8 seq`），FPGA 原样回显，上位机可统计丢帧。
2. **心跳超时 = 心跳周期**：v1.0 写的是"5 Hz 心跳 + 200 ms 超时"，等周期；在台架上
   5 Hz 心跳真的反复误判失联。已冻结为 **心跳 10 Hz、超时 300 ms**（5 Hz 时仍余 100 ms）。
3. **硬件急停此前只上报、不生效**（夜里做了一轮独立代码评审才发现）：`ext_fault[2]`
   只进遥测故障位，没进安全仲裁。若集成时把真实急停按钮接上，按住按钮车仍会继续走。
   已改为**锁存 + 强制目标速度 0 + 置 `stop_latched_out`**，松开不自动恢复、需 `CLEAR_FAULT`；
   `tb_core` 新增 5 项用例。同时补齐了命令长度校验（长度不符的 `CLEAR_FAULT` 不再解锁）。

这三个若不改，后面联调会被"随机失联 / 命令丢帧无法统计 / 急停不生效"折磨；
现在都写进协议 v1.1 与 `docs/PROTOCOL_v1.md` §5.1/§5.2 了。

---

## 6. 千兆网（v2）准备情况

协议层已与传输解耦，`transport.py` 里三种传输共用同一帧格式：

```python
UartTransport   # 现在：/dev/ttyUSB0 或 COM14，115200 8N1
UdpTransport    # 未来：一个 UDP 报文 = 一个完整帧（已本地回环验证 PASS）
FileTransport   # 离线回放：把串口助手抓的 hex 当数据流
```

UDP 自检结果（`tools/udp_loopback_test.py`）：200 报文 → 200 接收，150 合法帧 + 50 坏 CRC，
每个报文恰好一帧，与 UART 路径解析结果一致。**换以太网时帧格式/消息/CRC/安全逻辑一行不改**，
RTL 只需新增一个"字节源适配器"喂给 `host_frame_rx`。

---

## 7. 资源结论（用户重点关注）

**主工程最新实测**（`impl/pnr/Embodied_RPACS.rpt.txt`，10-29 02:06；主工程当晚另有
一轮逻辑裁减 + Fmax 提升，commit `09f2766`）：
Logic **12036/23040（53%）**、Register 5138（22%）、CLS **7525/11520（66%）**
→ 余量 **Logic 11004、CLS 3995**。

| 版本 | Logic | Register | CLS | 能否直接并入主工程 |
| --- | --- | --- | --- | --- |
| 完整版 | 1174 | 844 | **881** | ✅ **可**，合入后 CLS 仍余 ~3114 |
| **精简版** | 1110 | 782 | **830** | ✅ 余 ~3165（已非必需） |
| + IMU 姿态（参考） | 5430 | 2564 | 3671 | 主工程已有 IMU，不重复计 |

> ⚠️ 基线变化：`PLAN.md` 20334/CLS 10728/余 792 → 10-28 23:40 的 19664/CLS 10522/余 998
> → 10-29 02:06 的 12036/CLS 7525/余 3995。**"CLS 差 12 放不下"的结论早已作废，
> 现在 CLS 根本不是瓶颈。**

细节见 `docs/INTEGRATION_GUIDE.md` §4。

---

## 8. 早上可以直接做的三件事

```powershell
cd tests/uart_bridge

# A. 看链路跑起来（板子已烧 IMU 版）
.\tools\uart_link.ps1 -Action monitor -Port COM14

# B. 一键全回归（5 套仿真 + 一致性）
.\run_sim.ps1 -Python <你的python路径>

# C. 台架验收（19 项，含失联/停车/限速/ACK）
.\tools\uart_link.ps1 -Action bench -Port COM14
```

其他常用：

```powershell
# 重新综合（纯链路 / IMU / 精简）
.\run_build.ps1                       # 或 gw_sh build_imu.tcl / build_lite.tcl
# 烧写 SRAM（易失，不碰 Flash）
.\run_build.ps1 -Download
# 10 分钟长稳
python tools\soak_test.py --port COM14 --duration 600
# 把串口助手抓的 hex 解码
python tools\decode_hex.py capture.txt
```

---

## 9. 未完成（建议下一步，按优先级）

| # | 事项 | 说明 |
| --- | --- | --- |
| 1 | **链路 + 电机联调** | 需要动主工程/换基座：走 `INTEGRATION_GUIDE.md` 路线 A（适配器）或 B（加 VELOCITY 模式）。今晚明确"不控制车运动"，因此只做到仿真 + 适配器 |
| 2 | 编码器速度标定 | `COUNTS_PER_M=1116` 是占位值，需按实车轮径/减速比标定后才能用速度闭环 |
| 3 | 与 ASRPRO 语音通道的真实仲裁 | 优先级已设计，接入时需要把两条"提案"接到同一个仲裁器（指南 §3） |
| 4 | 以太网 v2 RTL | 协议层已就绪，需移植 RGMII + UDP 字节源 |
| 5 | 板子的**用户代码/位流管理** | 现在烧的是 SRAM（掉电失效）。若要固化，需要写外部 Flash 的 golden 位流策略（未做，避免覆盖整车固件） |

---

## 10. 提交记录

**我的 16 次提交全部只动 `tests/uart_bridge/` + 根 `.gitignore` 放行规则**（可用
`git log --name-only 3e0aa9e^..HEAD` 核对）：

```text
3e0aa9e freeze protocol v1 spec + host codec with self-tests
6a11ac1 RTL core (framing/decode/safety/telemetry) + 2 sim suites
a5148e1 board-verified link v1 (bench 19/19, soak 30k frames 0 errors)
9f5a4d2 IMU variant - telemetry carries real roll/pitch/yaw
f5be8e6 motion-side adapter + integration guide
f36579e resource-lite build (753 CLS -> later 830 after the safety fixes)
9a7de8a closed-loop system simulation (host -> link -> adapter -> plant)
f2c658e Orange Pi host example + docs refresh
0c84523 Python<->RTL conformance + hex capture decoder
c10a0ae on-board robustness against corrupted frames and noise
c49fa06 pin map json + two broken doc references fixed
4690b9e address independent review findings (estop, LEN checks, docs, tools)
08c8678 restore watchdog clear path + final measurements
c66be42 refresh integration numbers against the 02:06 main-project baseline
(+ 后续评审修复与最终文档一致性提交)
```

> ⚠️ 历史里还有一条 **`09f2766 perf: cut main project logic from 89% to 53% ...`**，
> **不是我做的**（作者 `WeieeGRACE`，02:09 提交）：那是主工程侧并行进行的资源优化，
> 它把主工程 CLS 从 92% 降到 66%，也因此让"链路放不下"的结论失效。
> 我没有修改、也没有回退这条提交。

回滚方式：`git revert <commit>`；若要整体撤销我的工作，
`git checkout 0e8b98f -- .` 之外最简单的做法是逐个 revert 上面 16 条（不会影响 `09f2766`）。
注意工作区里可能还有**用户/其他会话正在做的未提交改动**，我没有碰。

---

## 11. 已知限制与注意事项

| 项 | 说明 |
| --- | --- |
| `host_frame_rx` 只保存前 8 个负载字节 | v1 命令都在 5 B 内；若将来要更长负载需扩存储（一致性测试已按 8 B 比对） |
| 流式解析器 vs 缓冲解析器的固有差异 | 噪声里出现非法 `AA 55` 且**紧贴**真帧时，RTL 无法回退重扫（已写入 conformance.py 注释） |
| 精简版无 ACK | 上位机改用遥测 `cmd_seq` 回显判断生效；若联调期需要逐命令确认，用完整版 |
| IMU 版未做更细的陀螺零偏温度补偿 | 沿用主工程已验证的 `imu_attitude_fixed` 行为 |
| 板子只用 SRAM 位流 | 掉电即恢复原固件；如需长期测试，请先确认整车固件的 Flash 备份 |
