WeieeGRACE/Embodied_RPACS/tests/asr_motion/records/2026-10-23_ASRPRO独立语音控制上板测试报告.md

# ASRPRO 独立语音控制上板测试报告

测试日期：2026-10-23（Asia/Shanghai）  
工程：`tests/asr_motion/asr_motion_gpio.gprj`  
结论：**ASRPRO 独立语音运动控制功能测试通过，已由用户实机确认。**

## 1. 目标与结论依据

本测试验证 ASRPRO 经独立 UART 向 FPGA 下发简单运动指令，FPGA 使用现有 IMU、双轮编码器、电机闭环和 TB6612 完成运动控制。动作目标为前进／后退 20 cm、原地左／右旋转 90°。

用户在下载航向符号修正版交付后反馈：“ASRPRO 独立语音控制测试通过”。据此记录本次独立语音控制整体功能验收通过；用户未提供修正后的逐动作串口日志、精确位移／角度或测试次数，不将整体通过扩展为逐项精度、异常保护及播报效果的实测结论。

| 验证层级 | 结果 | 证据 |
|---|---|---|
| ASRPRO 独立语音控制实机功能 | 通过 | 用户上板反馈 |
| 四种动作及异常场景联合仿真 | 通过 | `integration.log` |
| 协议、距离换算、航向解缠绕单元仿真 | 通过 | `units.log` |
| 实际 50 MHz 接口冒烟仿真 | 通过 | `clock_50mhz.log` |
| 串口工具离线自检 | 通过 | `serial_tool_selftest.log` |
| 两版综合、布局布线、50 MHz 时序 | 通过 | `build_evidence.json`、`gpio_build_evidence.json` |
| 距离 ≤2 cm／角度 ≤5°、各动作五次重复性 | 待量化 | 尚无实测数据 |

## 2. 硬件、接线及交付版本

FPGA 板卡为 ACG525，器件 GW5A-LV25UG324C2/I1，系统时钟 50 MHz。复用 IMU660RA、左右电机、AB 编码器和 TB6612；电机及 IMU 接线详见 [上板说明](../README.md)。UART 为 115200 baud、8N1、3.3 V TTL。

| 连接 | FPGA 球位 | 板卡排针 |
|---|---|---|
| ASRPRO TX → FPGA RX | D17 | GPIO4，P6-5 |
| FPGA TX → ASRPRO RX | D18 | GPIO5，P6-6 |
| 公共地 | 专用 GND | P6-12 或 P6-30 |

这里的 GPIO4/5 属于 P6，不是 P11 的 LCD_GPIO4/5。独立语音测试采用 D17/D18 版，U8/V8 版用于板载 USB 串口电脑测试，两版共用 RTL 和运动参数。

| 版本 | 位流路径（相对测试目录） | 大小 | SHA256 |
|---|---|---:|---|
| 独立语音版，本次验收对应交付 | `impl/pnr/asr_motion_gpio.fs` | 6120356 bytes | `2d3ddeee654ddd59d484735e079c8142b586afc20833eb6ef8cec53cfde4c492` |

以上校验值标识独立语音版交付文件，写报告时已核对磁盘文件一致；未执行板内位流读回核验。电脑串口版不属于本次独立语音实机验收对象。ASRPRO 采用用户现有语音固件，其实际烧录版本及词表文件校验值未提供，本报告不据此宣称此前天问工程的编译问题已经解决。

## 3. 问题定位与修正

初次串口上板时，前进／后退动作返回完成；左右旋转约 330° 后返回故障状态 `AA 55 03 06 09 0D`，没有返回完成。该反馈仅表示故障，未包含具体故障子码，不能仅由该日志确认是否为动作总超时。

随后用户在禁止电机输出的被动标定模式下，依次手动右转、左转、左转、右转，每次约 90°。原始记录见 [手转数据](manual_yaw_20261023.txt)。取停稳附近值：

| 动作顺序 | 累计原始 Y | 相邻变化 |
|---|---:|---:|
| 右转 90° | +88.741° | 约 +89° |
| 左转 90° | −1.597° | −90.338° |
| 左转 90° | −90.103° | −88.506° |
| 右转 90° | +2.357° | +92.460° |

数据表明原始航向右正左负，与动作状态机约定的左正右负相反；角度量级接近实际手转量级。将共用顶层 `YAW_SIGN` 从 1 改为 **−1**，保持目标 `GOAL_MDEG=90000`，不改 IMU 角度比例、距离标定、PI、速度及超时。

仿真 SPI 陀螺仪模型同步采用实测安装方向，独立物理航向仍为左正，增加左右旋转物理方向断言；单元测试补充反相后的跨 ±180° 解缠绕检查。修正版两份位流均重新生成后交付，用户随后确认独立语音控制测试通过。

## 4. 仿真与编译结果

三组 ASR 自检仿真均为 Errors=0、Warnings=0，脚本退出码 0。覆盖四种动作、连续旋转跨角度边界、到位后停稳及单次完成反馈，并覆盖忙时拒绝、停车、校准前拒绝、急停、运行中复位、反馈失效、编码器异常和超时故障；这些异常保护结论来自仿真，未另有本次实机异常测试记录。

| 联合仿真动作 | 编码器换算位移／IMU 角度 | 独立物理模型转角 |
|---|---|---:|
| 前进 | 左 +202.787 mm，右 +200.651 mm | −0.508° |
| 后退 | 左 −203.072 mm，右 −200.794 mm | +0.568° |
| 左旋 | IMU +90.134° | +90.334° |
| 右旋 | IMU −90.207° | −90.338° |

以上为模型数据，不替代实机精度测量。独立语音版 Fmax=56.620 MHz，电脑串口版 Fmax=63.783 MHz；两版 Setup/Hold 违例均为 0/0，满足 50 MHz 约束。管脚、LVCMOS33、CPU/SSPI 普通 IO 配置及源码／位流校验已检查。编译仅有轮询模式不使用的 IMU 中断及预留输入警告。完整证据见 [验证记录](VALIDATION.md)。

## 5. 复测步骤与后续量化记录

1. 保留现有电机与 IMU 接线，按上表连接 ASRPRO 串口和公共地，下载独立语音版位流。
2. 普通模式下按 KEY0 复位，车体静止等待 D14 就绪灯亮；上电及复位不应自动运动。
3. 依次通过模块实际已配置的口令执行前进、后退、左转、右转。每次等待动作结束后再发下一条，记录方向、是否停稳及反馈；协议完成状态为 `AA 55 03 11 14 0D`。
4. 需要停止时使用停车口令；紧急时按 KEY2。若出现故障，记录现象及串口后按 KEY0 复位并重新静止校准。
5. 单独开展距离和精度验收：核对每轮一圈计数、分别标定左右轮周长，四种动作各测五次，填写下表。目标距离误差 ≤2 cm、转角误差 ≤5°。

当前 66 mm 轮径、1456 counts/rev 仍为未实测名义初值。下表留空表示待测，不表示未通过；整体功能通过不等同于精度指标已验收。

| 动作 | 第1次 | 第2次 | 第3次 | 第4次 | 第5次 | 最大绝对误差 | 越程／重复性备注 |
|---|---|---|---|---|---|---|---|
| 前进 200 mm（实测 mm） | | | | | | | |
| 后退 200 mm（实测 mm） | | | | | | | |
| 左转 90°（实测 °） | | | | | | | |
| 右转 90°（实测 °） | | | | | | | |
