WeieeGRACE/Embodied_RPACS/tests/asr_motion/records/VALIDATION.md

# ASRPRO 简单运动控制验证记录

日期：2026-10-23（Asia/Shanghai，航向符号修正版）。仿真：ModelSim SE-64 10.7；编译：Gowin V1.9.12 x64；器件：GW5A-LV25UG324C2/I1。本次重新生成交付文件，没有下载硬件或操作实际电机。

## 实机依据及本次改动

用户提供的四次手转顺序为右、左、左、右，每次约 90°。停稳附近累计 Y 分别为 +88.741°、-1.597°、-90.103°、+2.357°，原始记录保存在 `manual_yaw_20261023.txt`。当前安装的原始航向右正左负，与动作状态机需要的左正右负相反。两版共用顶层默认 `YAW_SIGN` 从 1 改为 -1；距离参数、角度比例、90000 毫度目标、速度和超时不变。

联合仿真的 SPI 陀螺仪模型同步改为实测安装方向，独立物理航向仍保持左正，增加实际左／右旋转方向断言。单元测试同时验证正负符号下的跨 ±180° 解缠绕。以下三组 ASR 仿真及串口离线自检均为本次重新运行，退出码均为 0；两份保存工程分别重新综合、布局布线并生成位流。共享模块未改动，本次未重复运行原有系统回归。

## 自检结果

| 测试 | 结果 | 原始记录 |
|---|---|---|
| UART 协议、Q16 距离和航向回绕、反馈队列 | PASS，Errors=0 / Warnings=0 | `units.log` |
| 双电机、AB 编码器、IMU SPI 与完整动作／异常集成 | PASS，Errors=0 / Warnings=0 | `integration.log` |
| 实际 50 MHz / 115200 UART / 1 MHz SPI / 20 kHz PWM 冒烟 | PASS，Errors=0 / Warnings=0 | `clock_50mhz.log` |
| 串口工具离线自检 | PASS，未打开串口 | `serial_tool_selftest.log` |
| 原有系统、IMU、姿态、OLED、测速和电机回归（2026-10-20 历史记录） | PASS，本次未重跑 | `shared_regression.log` |

历史原有回归由仓库 `tools/run_system_sim.ps1` 执行，包括 main integration/logger/IMU、attitude、attitude_oled、speed_prefetch、ground、left/dual/right closed loop。部分原有例程保留未连接可选端口的警告；当时回归脚本最终返回 0，所有仿真 Errors=0。

协议检查：有效六字节帧、校验／帧尾错误、错误 UART 停止位、未知命令、噪声、重叠 AA、坏帧中嵌入新帧、20 ms 残帧丢弃、连续帧；响应／状态顺序、并发事件、队列饱和锁存及排空后的故障补报。距离检查完整 1456 个正反计数、余数保留及回到原点；航向检查正反跨 ±180° 与更新脉冲。

集成检查通过真实串口比特流输入，不直接驱动内部动作命令。SPI 模型核对 8192 字节配置上传，并模拟 ID、初始化状态、六轴数据和错误寄存器。左右电机模型以物理 PWM／方向脚为输入，具有不同驱动力和惯性，不使用 RTL 目标值作为反馈。全动作使用 200000 µm / 90000 mdeg 目标，仍保留 10 秒动作总超时；1 MHz 参数配置用于加速，额外实际 50 MHz 冒烟验证生产接口分频。

| 仿真动作 | 左轮位移 | 右轮位移 | IMU 角度增量 | 独立模型角度增量 |
|---|---:|---:|---:|---:|
| 前进 20 cm | 202.787 mm | 200.651 mm | -0.494° | -0.508° |
| 后退 20 cm | -203.072 mm | -200.794 mm | +0.550° | +0.568° |
| 左旋 90° | -188.975 mm | +189.402 mm | +90.134° | +90.334° |
| 右旋 90° | +188.975 mm | -189.117 mm | -90.207° | -90.338° |

另外连续左旋三次，覆盖姿态角 +180° 到 -180° 的边界；结束后检查无驱动输出且两个原始测速窗口均为零。忙时拒绝、查询、不改变本次速度的升档、档位上下限、校准前拒绝及寻找任务拒绝均通过。

异常检查：普通停车仅报告 STOPPED；亚时钟急停锁存；IMU 错误寄存器／ready 丢失／原始采样中断／姿态更新中断；左右测速分别过期；编码器非法跳变；运行中复位；新鲜零测速但位置不动时 10 秒动作超时；等待停稳超时；故障解除不自动重启。持续查询导致反馈队列溢出时驱动被切断，停车解析仍继续。被动标定模式的完整十六进制快照经过实际 TX 比特解码，移动指令不能启用电机。

## 最终位流与时序

两个工程都通过仅打开保存的 `.gprj` 并 `run all` 的流程；验证脚本不重新设置顶层、器件、输出名和频率。源码变更时间早于对应位流，源文件哈希已保存在 JSON 证据中。

| 工程 | Fmax | Setup / Hold 违例 | Logic | Register | BSRAM | DSP |
|---|---:|---|---|---|---|---|
| 电脑 UART 版 | 63.783 MHz | 0 / 0 | 7826/23040 | 3379/23685 | 4/56 | 6.5/28 |
| 独立 GPIO 语音版 | 56.62 MHz | 0 / 0 | 7823/23040 | 3379/23685 | 4/56 | 6.5/28 |

50 MHz 约束、CPU/SSPI 普通 IO 选项均确认。每版 28 个端口，球位无重复、LVCMOS33、3.3 V；UART 方向正确，T11 始终为无上下拉输入。编译仅有轮询模式不使用 IMU INT1/INT2 和地线预留输入的预期 unused 警告。Gowin 终端还提示用户缓存目录 sh.log 无法打开，但两次完整流程均正常退出 0，工程目录内日志、时序报告和位流已生成并核对。

| 文件 | 大小 | SHA256 |
|---|---:|---|
| `impl/pnr/asr_motion_test.fs` | 6174100 bytes | `b28eca6b52e1b983ca7bbda5d6413fcb1fd564e422b7c2709a3a3e0532b6c500` |
| `impl/pnr/asr_motion_gpio.fs` | 6120356 bytes | `2d3ddeee654ddd59d484735e079c8142b586afc20833eb6ef8cec53cfde4c492` |

`build_evidence.json`、`gpio_build_evidence.json` 为自动检查证据；`pc_pnr_report.txt` / `gpio_pnr_report.txt` 为原始资源和管脚报告，`pc_timing_report.txt` / `gpio_timing_report.txt` 为时序报告的文本副本。完整构建过程见 `saved_project_build.log` / `gpio_saved_build.log`。时序通过针对受约束的内部时钟路径，不等同于实测串口或机械精度。

报告整理时复核：独立语音版文件与上述交付校验值一致。电脑串口版文件在交付后被更新（文件时间 2026-10-23 15:49:10），当前 SHA256 为 `ac2451da478e4ee521abbcc413b351e910e311a63ef46db46d5af9d39da39f39`，与表中首次交付值不同；上表电脑版及 `build_evidence.json` 保留为首次交付的构建记录，不作为该后续文件的重新验证结果。本次独立语音上板通过结论对应 GPIO 版。

## 接线调整与待上板项目

2026-10-23 交付修正版后，用户已确认 ASRPRO 独立语音控制实机功能测试通过，详见 [上板测试报告](2026-10-23_ASRPRO独立语音控制上板测试报告.md)。该结论为整体功能确认；下述精度和重复性项目仍需实测记录。

执行时核对发现 U8/V8 是板载 USB UART，故在计划中的电脑测试版之外增加 D17/D18 独立语音版，避免两个 UART TX 同驱动。GPIO 版可脱离电脑运行；D17/D18 为 FPGA 球位，用户仍需对照板级资料确认实际引出位置和 ASRPRO 的供电／3.3 V 信号。

默认 1456 counts/rev 和 66 mm 轮径未实测。IMU 航向符号已根据用户手转记录修正，独立语音控制功能已获用户确认通过；修正版实际旋转停止位置、真实轮周长、真实越程和五次重复精度仍待量化记录，反馈播报效果未提供单独测试结果。请按 README 完成四种动作各五次精度验收；目标距离误差 ≤2 cm、角度误差 ≤5°。仿真数值只代表所用模型，不作为实机精度承诺。
