WeieeGRACE/Embodied_RPACS/tests/asrpro_uart/records/2026-10-20_P11_BOARD_CHECKLIST.md

# 上板验收记录（待用户执行）

日期：______　操作者：______　FPGA 位流 SHA256：______

模块型号／固件版本：______　供电：______　UART 电平：______

全部项目当前均为待测；不得将软件仿真结果填为硬件验证通过。

| 项目 | 结果／实际收到字节／备注 |
| --- | --- |
| P6-5/6 接线、公共地、模块侧真实插针核对 | 待测 |
| SRAM 下载，上电空闲，无运动，无 ASR 主动帧 | 待测 |
| 查询：响应 02/00，状态 03/00 | 待测 |
| 寻找、重复寻找、忙碌时移动拒绝 | 待测 |
| 停止返回 03/04，新指令才能再次运行 | 待测 |
| 前进、后退、左旋、右旋均进入测试 03/10 | 待测 |
| 加减速档位 0/1/2 饱和且不启动动作 | 待测 |
| KEY1 推进寻找/接近/到达及移动完成 | 待测 |
| STATE 输入覆盖九种状态；错误输入无效 | 待测 |
| KEY2 故障，启动拒绝，停止不能清除，KEY0 解除 | 待测 |
| 错误帧、残帧超时、连续帧与恢复 | 待测 |
| 板载 USB 调试字段、错误计数与 LED | 待测 |
| 真实语音全部口令及同义词 | 待测 |
| 休眠与播报期间停止口令 | 待测 |
| 九种播报、状态去重和命令响应播报 | 待测 |
| 长期静默无误触发，复位不恢复任务 | 待测 |

本测试不执行实际 20 cm／90°动作，不验证寻找水瓶或真实停车距离。
