WeieeGRACE/Embodied_RPACS/asrpro/records/OBSTACLE_VALIDATION.md

# ASRPRO 避障语音整合数字验证

版本：2026-10-25。天问Block AI 2026秋季0.2.8；2MB ASRPRO。
用户登录后，当前工程的新识别模型及音频已生成。天问内建下载因代理失败，改为下载同一生成任务URL；未替换为历史模型。
证据：model_start_obstacle.json、model_events_obstacle.json、model_poll_obstacle.json、current_model.zip。

## 通过项

- 天问实际Blockly加载、保存、重开和代码生成：101块，23条识别词，15条反馈音频；115200串口保存重开一致。
- 新词“避障模式”ID24、“退出避障模式”ID25；退出及停止类为休眠可识别的唤醒词类别。
- 新音频9300/9301/9302/9303，分别为开启、遇障、绕过、退出；原唤醒/欢迎/休眠音频保持。
- 隔离SDK完整构建、生成源码交叉编译及链接通过；不改安装目录SDK。
- 190项主机运行测试通过：帧格式、校验、重同步、状态去重、队列容量、分配失败、普通命令、加减速词、播报确认cookie、完成/中断/失败、过期/重复回调、10秒超时、事件播报与唤醒续期。
- AEC=1、PAUSE_VOICE_IN_WITH_PLAYING=0；收串口与播报为独立任务。
- 完整fw.bin大小1,622,062字节，低于保留NV区起点0x1F0000。
- 分区表校验、5个分区CRC16及精确字节比对、引导、代码、两份识别模型、命令表、全部音频帧均通过。
- 固件SHA256：`a612e72d21f58c14246ed8f74669d38066447993427a492f98a9ecdcc1546380`。

## 构建边界

SDK普通播放回调在打断和失败时也可能调用，本版本在隔离SDK增加真实结束原因及cookie接口，只在正常完成时发送TYPE05。
增强接口补丁见tools/patch_sdk.py。`.hd`可在天问编辑/生成代码，完整链接须遵循asrpro/README.md的隔离构建流程。
交叉编译保留天问生成任务入口的函数签名转换警告及厂商efuse_check_idle的LTO类型警告；实际SDK完整构建成功，未宣称零警告。

没有连接串口、烧录或实际播放验证。麦克风识别、扬声器回声、真实打断效果、上电时序及电气连接由用户上板确认。
FPGA握手/接管/调速和整机仿真记录在主工程records/obstacle_20261025；完整上板清单见OBSTACLE_BOARD_TEST.md。
