WeieeGRACE/Embodied_RPACS/asrpro/records/VALIDATION.md

# 2026-10-23 简短播报版验证

- 本次交付：release/yaoyao_asrpro_2m_20261023_short；前两版发布目录及 ZIP 保留。
- 天问 2026 秋季版 0.2.8：实际打开、保存重开稳定，91 个积木，115200 及 8589934 毫秒唤醒设置正确。
- 21 条识别词、全部同义词和三条免唤醒停止类别保留。11 条可调用音频：共用“收到”，三个执行状态共用“执行中”，其他状态按短语映射。
- 163 项实际生成代码主机检查通过，覆盖全部识别 ID、发送先于播报、停车抢占、执行状态跨代码去重、离开执行状态后重入、队列满后重试、异常串口帧及计时溢出边界。
- 当前账号模型和 TTS 生成成功；直接下载该账号生成的资源 ZIP，通过天问导入。实际模型命令表、11 个播放 ID 及全部 15 个 MP3 内容已核对，无旧示例资源混入。
- 上电欢迎、唤醒回应、退出三段原文不变，且固件内 MP3 帧与上一版逐字节一致。
- 天问重编译及打断设置均报告程序编译完成；完整工作区 SDK 编译/链接退出码 0，AEC=1、播放期间不暂停语音输入。SDK 原有警告保留。GUI 本次无 flash 事件。
- 官方 SDK CLI 打包后修正分区布局；启动程序、分区表校验、五个分区 CRC16、代码及全部模型音频有效载荷均核对一致。
- 固件 1,604,581 字节，SHA256 `6fd0596f97c0a332133b5e19b8b8b45f7351686d043d0e304f7b41cdc90cab25`；未烧录设备。
- 待实测：实际识别和短播报、休眠及播报期间停车、长时间退出与续期、实际 UART/电平及底盘动作。

以下为历史版本记录，旧播报及旧固件大小不代表本版：

# 2026-10-23 收到回复版验证

- 新交付目录：`release/yaoyao_asrpro_2m_20261023_receipts`。上一版发布目录及 ZIP 保留。
- 实际天问 2026 秋季版 0.2.8 加载、保存、重开：101 个积木，代码稳定，`Serial1.begin(115200);` 和 `set_state_enter_wakeup(8589934);` 正确生成。
- 21 条识别词及原有 12 条状态/响应播报保留；新增 9 条收到回复（9201、9202、9203、9216–9221）。实际模型命令表和全部 25 个 MP3 已核对。
- 收到回复在完整六字节串口发送后入队；停车收到回复清队列、可抢占。156 项主机断言通过，包含全部同义词、发送顺序、停车、异常帧、状态去重和计时溢出边界。
- SDK 使用 500 Hz、32 位 tick，转换宏先以 uint32_t 乘法计算；8589934×500=4294967000 不溢出，下一毫秒即溢出。实际转换为 4294967 ticks，对应 8589934 ms。最长时间仅在识别后设置，上电仍等待唤醒。
- 当前登录天问重新生成模型/TTS；内置下载受继承代理阻断，直接下载同次生成资源后通过天问导入成功。空回复使用官方静音资源，无旧示例词条混入。
- 天问界面重编译与打断设置报告“程序编译完成”；本次事件记录无 flash 调用。独立工作区完整 SDK 编译/链接退出码 0，USE_AEC_MODULE=1、PAUSE_VOICE_IN_WITH_PLAYING=0；保留 SDK 原有编译警告。
- 官方 CLI 打包后修正分区对齐问题，校验启动程序、分区表、五个分区 CRC16、代码和资源字节一致性。
- 固件 1,655,033 字节，SHA256 `f7219de0dc522d92b3a066e93688b7f84acdb7a9808da05599a92e8fea8844df`。未烧录设备。
- 待上板：21 条词的实际识别、收到回复内容、长时间退出与续期、休眠停车、欢迎/唤醒/普通播报期间停车识别、底盘实际动作。

以下为上一版历史记录，旧尺寸、15 秒设置及 91 项测试不代表本次交付：

# 验证记录

## 2026-10-23 修复及固件交付

- 当前天问 Block AI 2026 秋季版 0.2.8 实际加载 93 个积木；串口参数从旧 `baud` 下拉积木改为 `math_number` 数值积木，修复载入后断开导致的 `Serial1.begin();`。保存重开后生成 `Serial1.begin(115200);`，词表、协议及运行时保持原语义。
- 使用已登录的天问生成模型和 TTS，界面均提示合成成功；下载被软件继承的失效代理阻断后，从本次生成链接取回 ZIP，并通过软件的模型导入接口导入，提示“模型文件导入成功”。未沿用原安装目录示例模型。
- 当前天问实际“rebuild”编译回报 `程序编译完成`；设置播报打断后回报 `切换打断写入完成` 和 `程序编译完成`，安装 SDK 的 `USE_AEC_MODULE=1`。信号记录见 `gui_final.json`。没有调用烧录入口。
- 在工程目录内复制当前 SDK，从源码启用 `USE_AEC_MODULE=1`、`PAUSE_VOICE_IN_WITH_PLAYING=0`，完整构建退出 0，日志 `full_sdk_build.log`。供应商源码仍存在 const/函数声明等编译警告，不能称为无警告构建。实际生成代码的 91 项协议断言通过。
- 用 SDK 官方 CLI 合并当前代码、两份识别模型、DNN、16 个音频文件（12 条反馈、唤醒、欢迎、休眠及共用空回复）和命令表；命令表逐条核对 21 条识别词/ID、4 条唤醒类别（含三条停止词）及 12 个反馈播放 ID。记录见 `release_validation.json`。
- 手工恢复下载后补做天问正常流程中的“空回复重置”：将共用 ID=23 的服务端“无”占位音频换成安装版官方 `空回复.mp3`，避免命令识别时额外读出“无”。发布固件中全部音频有效负载与本次资源逐项比对，空回复与官方静音音频比对。
- 官方 CLI v2 打包实测每个后续分区少填一字节（模型偏移 -1，DNN -2，音频 -3，命令表 -4）；包装脚本保留官方启动程序及分区表，把每个有效负载写入表中指定地址。独立验证通过分区表校验和、五个分区 CRC16、字节长度和逐字节内容对比；识别模型原始内容完整，附加的是官方 DNN 合并器生成的 20 字节 `<prun_table>` 元数据。
- 交付：`release/yaoyao_asrpro_2m_20261023/fw.bin`，1,621,095 字节；SHA256 `45356c720507ebfea9b13b0dded50431a0d5579406cf5c8bb7ac3f286cc7598d`。Flash 为 2 MB，NV 保留区从 `0x1F0000` 起，共 64 KB，所有固件分区未越界。
- 本轮未连接/打开业务串口、未烧录语音模块、未修改 FPGA 工程。识别准确率、免唤醒停止、播报期间识别和实车动作仍待上板。

以下为 10 月 20 日历史记录，其当时尚未生成模型等结论已由上述新验证更新。

日期：2026-10-20。对象：同目录上级的 `asrpro.hd` 和由实际天问生成的 `generated.cpp`。

## 已完成的软件验证

| 项目 | 结果及证据 |
|---|---|
| 天问 ASRPRO 工程加载 | 2025 夏季正式版实际 Blockly 页面成功加载 93 个积木，0 个禁用 |
| 保存、重开、生成 | 使用实际 Blockly XML 序列化保存，清空工作区后重新加载；前后生成代码除空行外一致，见 `blockly_validation.json` |
| 词表 | 21 条识别词（含主唤醒词），3 条停止词为唤醒词类别，12 条反馈播报；9000–9108 均在播放积木允许范围内 |
| ASRPRO 源码编译 | 安装附带 RISC-V GCC 9.2.0、实际 SDK 头文件编译成功，见 `cross_compile.log` |
| ASRPRO 链接 | 与安装版 `core.a` 及 SDK 库链接成功，见 `link.log`；产物为忽略提交的 `build/yaoyao.elf` |
| 行为测试 | MSVC 编译并执行实际 `generated.cpp`，91 项断言通过，见 `host_tests.log` |

编译保留天问标准线程积木的两个 `void (*)()` → `TaskFunction_t` 转换警告，依赖供应商构建参数 `-fpermissive`。链接另有安装版 core 的 `efuse_check_idle` 返回类型不一致 LTO 警告，位于供应商 SDK。均非零警告构建，不能宣称无警告通过。

91 项断言覆盖：上电无发送；全部 21 个识别 ID 与同义词发送的原始字节；15 秒窗口设置；未知 ID；3 种响应与 9 种状态的播放 ID；相同状态去重及状态切换；错误校验/帧尾/类型/代码；噪声、重叠和嵌入帧头恢复；19 ms 可接受、20 ms 超时；millis 回绕；紧急状态清队列与播放器抢占；普通播放器忙重试；独立 RX 轮询；1000 帧连续处理；队列容量上限；音频队列分配失败时仍能发停止且播放线程安全返回。

这些是 SDK 替身上的逻辑断言，不等价于麦克风识别准确率、真实调度并发压力、硬件串口抓包或实车运动测试。紧急语音抢占的实际行为取决于 SDK 播放器和硬件。

## 尚未完成的交付验证

- 本次完成代码编译与链接，未完成本词表的识别模型/音频资源生成与最终固件打包；未执行烧录。实际点击“生成模型”后出现“帐号登录”窗口（用户名、密码、手机号登录），需要用户先在软件内登录。天问“编译下载”入口同时包含下载流程，不能把代码链接通过写成已完成该界面全流程。
- 模块型号、供电、电平和引脚图缺失，未连接实际模块。需要用户提供 README 所列资料。
- FPGA 语音接收入口尚不存在，因此忙碌拒绝、档位、距离、角度、避障及停止完成反馈尚不能整车验收。

## 上板验收步骤（待执行，不是通过记录）

1. 确认模块型号/容量、电气条件和 UART 线序，在天问启用播报打断，为当前词表生成模型及音频并编译固件；核对无错误后烧录。
2. 用串口助手以 115200/8N1 接收原始字节，逐条说 README 中所有主口令和同义词，逐字节比对发送帧。上电、唤醒、长时间静默均不得发送运动帧；没有反馈时不得播报已完成。
3. 等待休眠，在未说“幺幺耍起”时分别说“停止任务”“停车”“停止”，均须收到 `AA 55 01 02 03 0D`。分别在欢迎语、唤醒回应和状态播报期间说停止，检查实际识别成功及停止帧到达。
4. 在 15 秒窗口内及边界前后测试普通口令，识别成功后等待接近 15 秒再次发令，验证续期；休眠时普通运动口令不得触发。
5. 串口助手发送 README 表中每条响应/状态帧，确认实际语音正确；重复状态只播一次，切换后返回可再次播报，命令响应不去重。
6. 播报期间注入合法帧、坏校验、噪声、粘连帧、分段残帧及超过 20 ms 的半帧；确认接收持续运行、错误帧不播报且能恢复。测试突发消息及停止状态抢占。
7. 底盘按同一协议对接后，验证运行中拒绝新运动、不排队；停车同时取消自主/手动任务；档位升降饱和且不启动动作；标定并实测前后各 20 cm、原地左右各 90°，只有反馈到位且停车后才上报完成。
