WeieeGRACE/Embodied_RPACS/tests/vl53l0x_three/TEST_REPORT.md

# 三路 VL53L0X 测试报告

测试日期：2026-10-23。工程：`tests/vl53l0x_three/`。接线版本：P6 三路独立六线接法。执行方法见 [测试说明](TEST_PROCEDURE.md)。

## 1. 结论

**本次三路诊断测试通过。** I²C 时序修复后，用户纠正右侧接线，前、左、右均恢复寄存器与结果读取。改线后及重新下载启动后两次串口采集各 30 条，共 60 条记录全部通信成功；严格原始字节解析及三路检查通过。五套 ModelSim 仿真、Gowin 构建及保存工程重开构建通过，内部时序满足 50 MHz。

用户在本次交付后明确反馈“测试已经通过”，作为上板验收确认。本报告将自动日志证据与用户整体确认分别记录；未收到逐项人工记录、实际距离对照表或 OLED 照片，不补写相应定量结果。

本次通过范围为现有资料约束下的三路诊断工程。完整初始化/校准、光学准确度、有效量程和长期稳定性不在已证明范围内；串口曾出现 20 mm 返回值，`valid=1` 只表示通信及例程就绪检查通过。

## 2. 测试配置与产物

| 项目 | 实际配置/结果 |
| --- | --- |
| FPGA | GW5A-LV25UG324C2/I1，50 MHz |
| I²C | 前/左/右独立，地址均 0x29，名义 100 kHz，SCL/SDA/XSHUT 为 0/Z |
| 模块电源 | 专用 3.3 V 与公共 GND，不占用 P6 电源针脚 |
| 串口 | COM14，115200，8N1；FPGA TX=V8 |
| OLED | SSD1306 128×64，0x3C，R3/T3 |
| 构建工具 | Gowin V1.9.12，ModelSim 路径见测试说明 |
| 位流 | [vl53l0x_three.fs](impl/pnr/vl53l0x_three.fs)，5,958,596 字节 |
| SHA256 | `acebb58b71c0c672788f3f9663c19748e6008fa195cc115be6ded134fc94fad7` |
| 下载方式 | Programmer CLI operation 2，SRAM；未烧写 Flash |
| 安全输出 | PWMA/AIN1/AIN2/PWMB/BIN1/BIN2/STBY 恒低；T11 保留无上下拉输入 |

固定 P6 接线：前 SCL/SDA/GPIO1/XSHUT=7/8/9/10，左=13/14/15/16，右=17/18/19/20。封装管脚及网络见 [PIN 文档](../../PIN_ASSIGNMENT.md)。未修改主工程集成。

## 3. 自动测试与构建结果

| 用例 | 结果 | 权威证据 |
| --- | --- | --- |
| SIM-01 数据保持时间及延迟模型 | PASS | [edges 日志](records/2026-10-23_fix_edges.log) |
| SIM-02 I²C 协议及故障恢复 | PASS | [bus 日志](records/2026-10-23_fix_bus.log) |
| SIM-03 三路调度、串口及安全输出 | PASS | [three 日志](records/2026-10-23_fix_three.log) |
| SIM-04 OLED 显存、故障显示及帧快照 | PASS | [oled 日志](records/2026-10-23_fix_oled.log) |
| SIM-05 默认 50 MHz 计时 | PASS | [timing 日志](records/2026-10-23_fix_timing.log) |
| BUILD-01 综合、布局布线、位流 | PASS | [构建日志](records/2026-10-23_fix_build.log) |
| BUILD-01 保存 GPRJ 重开构建 | PASS | [重开构建日志](records/2026-10-23_fix_build_saved_project.log) |
| BUILD-02 管脚、配置、内部时序 | PASS | [报告检查](records/2026-10-23_fix_report_check.txt) |

最终检查 25 个端口、固定 P6 映射、ASRPRO 同名高阻保护配置及其他 11 份 CST；无其他用途冲突，CPU/SSPI 普通 IO 配置保留。Fmax=78.789 MHz，setup/hold TNS=0；逻辑使用 5430/23040，寄存器 3461/23685。内部时序通过不代替外部传感器路径的电气验证。

五套仿真均零错误。edges/bus 各有 2 条新增诊断输出未连接的端口警告，timing 有 4 条同类警告，three/oled 无警告。构建保留 CV0016：`imu_gnd_reserved` 输入未使用。以上警告未阻止构建或本次验收，详见各日志。

## 4. 板上闭环结果

| 批次 | 前方 | 左侧 | 右侧 | 原始日志 |
| --- | --- | --- | --- | --- |
| 用户纠正接线后 | 10/10 | 10/10 | 10/10 | [改线后采集](records/2026-10-23_rewired_board.log) |
| 重新下载并执行复位启动后 | 10/10 | 10/10 | 10/10 | [重新启动采集](records/2026-10-23_rewired_restart_board.log) |
| 合计 | 20/20 | 20/20 | 20/20 | 共 60 条诊断记录 |

全部记录 ID=EE、rev=10、pre=07、final=05、rd=1F、valid=1、err=00、dbg=0000、pad=7。软件从原始 12 字节重算距离、环境/信号计数及状态，与串口字段一致。[严格检查记录](records/2026-10-23_rewired_restart_check.log) 明确输出三路全部通信通过；[下载日志](records/2026-10-23_rewired_restart_download.log) 含 `Finished.`。重新下载验证不是整板断电冷启动试验。

重新启动批次的一个实际前方样本：

```text
FRONT seq=00000002 mm=01283 id=EE rev=10 pre=07 final=05 status=0B ambient=00097 signal=00008 gpio=1 valid=1 err=00 dbg=0000 pad=7 rd=1F raw=5F06C800FFFF006100080503
```

对应 raw 字节 10/11 为 0x0503=1283，6/7 为 0x0061=97，8/9 为 0x0008=8，字节 0 的 bit6:3 为 0B。该样本证明读取与解析一致，不是已知距离的精度样本。

上板人工验收：用户已明确确认测试通过。方向逐路移动目标、OLED 实屏内容及单路断开恢复的逐项人工结果未单独提供；其自动覆盖内容见 SIM-03/04，不将总体验收声明扩写为未记录的逐项实测。

## 5. 问题与闭环处理

| 问题 | 证据与处理 | 最终状态 |
| --- | --- | --- |
| 前/左 NACK、原始寄存器为初始零值 | 原实现同时切换 SCL/SDA；带路径延迟的回归复现 SDA 保持时间失败。增加下降沿后数据保持、分离 START/STOP 边沿 | 修复；仿真及真实模块读取通过 |
| 右侧持续 err=03 | FPGA 采样总线低；互换前/右模块后故障仍留在右侧通道。用户确认并纠正接线错误 | 已恢复；两批共 20/20 成功 |
| 未读字段零值易被误认为传感器数据 | 增加 rd/raw/dbg/pad；未读取字段显示横线 | 已修正并验证 |

完整排查日志及修复细节见 [I²C 修复记录](records/2026-10-23_I2C_FIX_VALIDATION.md)。旧 P6/P11 记录和失败日志作为历史保留，不代表当前最终状态。

## 6. 交付与后续范围

交付源代码、独立 GPRJ/CST/SDC、构建与采集脚本、仿真模型及测试、位流、原始日志、本测试说明及报告。板上运行本报告 SHA256 对应诊断位流，采集结束后 COM14 已释放。后续菜单可复用 OLED 四行 ASCII 渲染接口；本次不增加菜单或主工程集成。

如需形成精度报告，应补充已知距离、目标材质、环境、每点采样数量和误差统计，并补齐匹配的初始化/校准资料；本报告不声明未经记录的精度或量程指标。
