WeieeGRACE/Embodied_RPACS/tests/records/落地测试记录模板.md

# 落地测试记录（待现场填写）

日期/操作者：____；场地/地面：____；固件文件及 SHA256：____；日志路径：____
电源电压/限流：____；轮径/轮距（若测量）：____；环境温度：____
架空前置状态：用户已确认单轮及双轮测试完成。新固件无动力/短时架空验证：____

每项至少三次，下面表格复制填写；未执行写“未执行”，不得预填通过。

| 动作/中断方式 | 次数 | TL/TR | 按键/心跳时间 | SFL/SFR | PL/PR峰值 | IL/IR/FL/FR/FAULT/FC | 电压/电流 | 温升/机械表现 | 结果 |
| --- | --- | --- | --- | --- | --- | --- | --- | --- | --- |
| 前进 | | | | | | | | | |
| 后退 | | | | | | | | | |
| 急停 | | | | | | | | | |
| 松开使能 | | | | | | | | | |
| 看门狗超时 | | | | | | | | | |
| 左/右原地旋转 | | | | | | | | | |
| 左/右转向 | | | | | | | | | |

| 中断项 | 两路PWM/STBY关断延时及测量方式 | 机械停稳时间 | 滑行距离 | 恢复输入仍锁存 | 复位后松开再按恢复 |
| --- | --- | --- | --- | --- | --- |
| 急停 | | | | | |
| 禁用 | | | | 不适用 | |
| 看门狗 | | | | | |

按键：短按一次后松开仍运行____；运行中再次按键被忽略____；8秒自动停止____；自动停止时间____；恢复输入不自动重启____。
看门狗：无首帧不能启动____；正常100ms心跳____；错误字节不刷新____；最后有效帧至关断约500ms____；本次关断早于8秒限时____；恢复心跳不重启____。
异常与停止措施：____；历史编码器非法跳变是否复现：____；遗留问题：____。
现场最终结论（通过/部分通过/失败，附证据）：____。
