WeieeGRACE/Embodied_RPACS/tests/asrpro_uart/records/2026-10-20_P11_VALIDATION.md

# ASRPRO FPGA 测试验证记录

日期：2026-10-20。结论：独立 RTL 仿真、Gowin 综合/布局布线/位流生成及保存工程重开构建通过，已具备交给用户上板验证的源码与 SRAM 位流。未连接 ASRPRO、未下载 FPGA、未验证真实语音识别及播报。所有完成/到达状态是测试注入，不代表真实底盘动作完成。

## 引脚

先更新根目录 `PIN_ASSIGNMENT.md`，再创建 RTL：D17/GPIO4/P6-5 接收，D18/GPIO5/P6-6 发送，独立于 V8/U8 电脑调试串口。`check_reports.py` 已逐项检查最终 38 个端口的名称、位置、方向、电平、驱动、上下拉，且 D17/D18 未被其他 10 份 CST 占用。完整证据见 `report_check.txt`。

七路电机输出在 RTL 固定为 0，顶层仿真全程断言；九路 ToF 输出全程高阻。T11 和其余预留 IMU/ToF 输入最终报告均为输入、无内部上下拉、DRIVE=OFF。保留这些未使用输入是为了在机器人仍接线时固定电气配置，Gowin 因而产生 10 条 CV0016 unused-input 警告，不应删掉这些端口来消除警告。

## ModelSim

ModelSim SE-64 10.7，`run_sim.ps1` 三套测试最终均退出 0、Errors=0、Warnings=0，完成标志均为 1。

| 日志 | 实际覆盖 |
| --- | --- |
| protocol.log | 真实 50 MHz/115200 位时序、九种命令、连续收字节、短起始毛刺、错误校验/类型/命令/帧尾、噪声、AA AA 55、坏帧内嵌合法帧头、错误停止位及持续低电平恢复、20 ms 前后残帧、错误后合法帧恢复、复位 |
| protocol.log 的独立验帧夹具 | 从首字节起始位时间戳计时；deadline-1 可接受，deadline 时拒绝；32 位 tick 回绕；重叠头不延长原截止时间。夹具 timeout 参数缩为 100 周期以精确注入边界，物理 UART 夹具保持默认 1,000,000 周期/20 ms |
| control_fifo.log | 寻找/移动忙碌拒绝、不替换任务、查询、停止、全部移动码、档位两端饱和、人工推进、九种状态、未知状态拒绝、故障锁存、同时故障与启动的优先级；小深度反馈 FIFO 溢出计数、丢弃完整事件、逐位解码响应/状态顺序及校验、传输中复位 |
| top.log | 实际默认时钟与波特率下全部命令、STATE ASCII 输入和 CRLF、九种状态、重复/错误/超长状态行、并行电脑/ASR 接收、按键消抖与故障、调试串口十字段物理位解码、复位后空闲中档、静默不产生新命令；全程断言电机恒低、ToF 高阻 |
| top.log 的满速突发 | 不等待响应连续发送 40 个寻找帧，再发送停止；41 帧均接收，反馈发生可观测溢出，状态仍进入 STOPPED；发送队列排空后所有输出帧校验正确且响应/状态对没有拆分 |

顶层只将按键消抖参数缩至 50 周期以减少仿真耗时，实际构建为 1,000,000 周期/20 ms；UART、帧超时、每秒日志周期保持默认。顶层仿真时间约 375.15 ms，静默专项约 21 ms，不冒充长期硬件运行试验。每秒周期日志由源码检查，命令/状态日志在仿真中物理位解码；长期静默与每秒观察按上板表执行。

测试平台调试期间修正了并行调用串口发送任务的共享局部变量问题（task 改为 automatic），并将独立调试快照 FIFO 增至 32 项，使正常交互测试保留最终快照。最终三套日志均为修正后的回归结果。

## Gowin 构建

Gowin V1.9.12_x64，器件 GW5A-LV25UG324C2/I1。`build.tcl` 初次显式设置参数构建成功；最终源码又通过 `verify_saved_project.tcl` 重新打开保存的 `asrpro_uart.gprj` 并完整构建，记录在 `build_saved_project.log`，退出 0。此验证不代表操作过 IDE 图形界面。

- 最终逻辑 6364/23040（28%），寄存器 8794/23685（38%），锁存器 0，I/O 38。
- 50 MHz 约束；Fmax **70.042 MHz**；setup/hold TNS 均为 0，无违反端点。异步外部 UART 和按键不作同步外部接口时序保证。
- CPU/SSPI 普通 IO 选项、50 MHz、顶层名和位流输出名在两份保存配置中一致并经脚本核验。
- 最终 `impl/pnr/asrpro_uart.fs` 为 **5,958,596 字节**；SHA256 `31a7542a9e4e342f05fb7af7734fd73058184ef81b41562a04c27bbc71aaa0a4`。以 `report_check.txt` 及实际文件重新计算为准。
- 最终构建仅保留上述 10 条预留输入 CV0016 警告。初次 build.log 中三条十六进制字符转换位宽警告已通过显式取低四位修正，最终重开构建中已消失。
- 两次构建均提示不能打开用户目录的 Gowin cache/sh.log；该辅助日志写入失败没有阻止构建。完整 stdout/stderr 已保存在 records，最终管脚、时序和位流实际存在并经过检查。

## 硬件交付边界

按 README 用 Programmer 下载独立位流到 SRAM，再按 `BOARD_CHECKLIST.md` 执行串口助手、ASRPRO 识别、播报、停止和故障测试。本交付不改主工程顶层，不执行实际运动，不替代 ASRPRO 词表模型/音频资源生成、模块侧固件烧录与电气核对。

持续满速输入的反馈带宽不足已明确测试和记录：一条 6 字节命令需要回传 12 字节；FIFO 满时丢弃新反馈并计数，绝不等待 TX 才处理停止。实际语音交互应等反馈完成后再发新命令，错误/溢出计数可通过每秒电脑日志观察。
