WeieeGRACE/Embodied_RPACS/tests/asrpro_uart/records/VALIDATION.md

# 当前验证记录

当前接线为 **2026-10-23 P6 版**，请阅读 [P6 验证记录](2026-10-23_P6_VALIDATION.md)。

旧 P11 接线、时序和位流校验值仅作为历史，见 [2026-10-20 历史记录](2026-10-20_P11_VALIDATION.md)。旧版位流不得用于 P6 接线。
