WeieeGRACE/Embodied_RPACS/tests/vl53l0x_three/records/2026-10-20_P11_VALIDATION.md

# 验证记录（2026-10-20）

结论：数字仿真通过；Gowin 独立工程综合、布局布线、位流生成通过。没有连接真实模块、下载 FPGA 或验证物理距离。现有 Arduino 初始化/校准资料不完整，不能将本结果解释为正式测距驱动已获硬件验证。

## 仿真

ModelSim 10.7，`run_sim.ps1` 依次运行四套测试，最终均退出 0，无编译错误/警告。原始日志保存在本目录。

| 日志 | 已检查内容 |
| --- | --- |
| bus.log | 0x29 地址、寄存器指针、12 字节连续读、最后 NACK/STOP、地址及寄存器字节 NACK、短时钟拉伸、超时释放、SDA 卡低及复位后恢复 |
| three.log | 三路不同距离和原始状态、字节序、例程顺序、延迟就绪、100 次轮询超时、缺失设备、故障隔离、下一轮 XSHUT 恢复、串口物理位解码并比对所有报告字段、传输中复位、电机恒低 |
| oled.log | 解码实际 I²C 写入并重建显存，检查初始化与清屏、WAIT、五位十进制含 65535、原始十六进制状态、错误码、隐藏旧距离、恢复、帧开始快照一致性；最终显存见 oled_memory.hex |
| timing.log | 实际 50 MHz 时钟及未缩短的驱动默认参数，XSHUT 1 ms、启动等待 20 ms、SCL 数据周期至少 10 μs、首次 10 ms 轮询后完成测量 |

故障测试主要采用缩短等待参数；默认计时另由 timing 测试及 RTL 参数核对。100 次轮询、1 秒轮间隔、10 ms 时钟等待上限分别为 MAX_POLLS=100、ROUND_CYCLES=50000000、TIMEOUT_CYCLES=500000。OLED 在完整三路顶层仿真中同时运行，测距调度仍完成正常、故障和恢复轮次；显示像素比对另在 OLED 专项仿真完成。模拟器使用数字上拉，不验证模拟门限、实际光学行为或电源质量。

## Gowin

工具 Gowin V1.9.12_x64，目标 GW5A-LV25UG324C2/I1。`build.tcl` 与重新打开保存工程的 `verify_saved_project.tcl` 均退出 0，日志为 build.log、build_saved_project.log。两份保存的 process config 均 CPU=true、SSPI=true，作为普通 IO 使用。

- 逻辑 4286/23040（19%），其中 LUT 4186、ALU 100；寄存器 2101/23685（9%），锁存器 0，DSP 0.5/28，IO 25。
- 50 MHz 约束下 Fmax=80.115 MHz，最差 setup slack=7.518 ns，setup/hold TNS 均 0。结论针对内部同步路径；外部 I²C/UART 异步信号不作同步外设接口的时序承诺。
- 最终管脚报告逐项检查 25 个位置/方向/驱动/上下拉/电压，12 个测距信号与其他 8 份 CST 无重复。T11 确认为输入、DRIVE=OFF、PULL=NONE。七路电机输出恒 0 在 RTL 和顶层仿真中检查。
- CV0016 警告：imu_gnd_reserved 输入未使用。保留此输入是为了固定 T11 电气配置，最终报告确认未被改成上拉或输出。
- 工具另提示无法打开用户目录 Gowin cache/sh.log；这是辅助日志路径写入失败。完整标准输出已保存在 records，两次构建均完成且生成最终报告与位流。

可运行 `python check_reports.py` 复核报告、保存配置与其他 CST；输出到 report_check.txt，包含最终 fs 大小及 SHA256。工具生成的完整中间报告留在本机 impl/pnr；交付保存源码、配置、fs 和提取记录，重新构建可再生成完整报告。

## 待上板

按 README 下载独立 fs，使用串口 115200/8N1，分别移动前、左、右目标，核对方向与尺量距离；再断电断开单路观察隔离，恢复接线后重新上电核对恢复。记录 ID、修订号、周期、原始状态及错误码。若只出现超时或异常距离，下一步是补充匹配的完整初始化/校准资料，而不是将仿真模型当作传感器行为的证明。
