WeieeGRACE/Embodied_RPACS/tests/vl53l0x_three/records/VALIDATION.md

# 当前验证记录

正式交付文档：[测试说明](../TEST_PROCEDURE.md)、[最终测试报告](../TEST_REPORT.md)。用户已确认上板测试通过；详细自动证据与未覆盖范围见报告。

最新 I²C 修复、仿真及直接上板串口结果见 [2026-10-23 I²C 修复记录](2026-10-23_I2C_FIX_VALIDATION.md)。修复数据保持时间并纠正右侧接线后，三路读取均恢复；重新下载启动后各 10/10 次成功，原始字节解析及三路严格检查通过。光学准确度及完整初始化/校准尚未验证。

P6 引脚表不变。旧迁移验证见 [P6 初次迁移记录](2026-10-23_P6_VALIDATION.md)，更早 P11 接线见 [历史记录](2026-10-20_P11_VALIDATION.md)。
