WeieeGRACE/Embodied_RPACS/tests/task4_navigation/impl/pnr/task4_navigation_diagnostic_wireless.rpt.txt

//Copyright (C)2014-2025 Gowin Semiconductor Corporation.
//All rights reserved.

1. PnR Messages

  <Report Title>: PnR Report
  <Design File>: D:\Gowin\Project\Contest\Embodied_RPACS\Embodied_RPACS\Embodied_RPACS\tests\task4_navigation\impl\gwsynthesis\task4_navigation_diagnostic_wireless.vg
  <Physical Constraints File>: D:\Gowin\Project\Contest\Embodied_RPACS\Embodied_RPACS\Embodied_RPACS\tests\task4_navigation\src\task4_navigation_diagnostic_wireless.cst
  <Timing Constraints File>: D:\Gowin\Project\Contest\Embodied_RPACS\Embodied_RPACS\Embodied_RPACS\tests\task4_navigation\src\task4_navigation_board_top.sdc
  <Tool Version>: V1.9.12 (64-bit)
  <Part Number>: GW5A-LV25UG324C2/I1
  <Device>: GW5A-25
  <Device Version>: A
  <Created Time>:Fri Oct 30 16:28:17 2026

2. PnR Details

  Running placement:
    Placement Phase 0: CPU time = 0h 0m 2s, Elapsed time = 0h 0m 2s
    Placement Phase 1: CPU time = 0h 0m 0.716s, Elapsed time = 0h 0m 0.716s
    Placement Phase 2: CPU time = 0h 0m 7s, Elapsed time = 0h 0m 7s
    Placement Phase 3: CPU time = 0h 0m 7s, Elapsed time = 0h 0m 7s
    Total Placement: CPU time = 0h 0m 17s, Elapsed time = 0h 0m 17s
 Running routing:
    Routing Phase 0: CPU time = 0h 0m 0.004s, Elapsed time = 0h 0m 0.004s
    Routing Phase 1: CPU time = 0h 0m 5s, Elapsed time = 0h 0m 5s
    Routing Phase 2: CPU time = 0h 0m 0.144s, Elapsed time = 0h 0m 0.143s
    Routing Phase 3: CPU time = 0h 0m 0s, Elapsed time = 0h 0m 0s
    Total Routing: CPU time = 0h 0m 5s, Elapsed time = 0h 0m 5s
 Generate output files:
    CPU time = 0h 0m 3s, Elapsed time = 0h 0m 3s

 Total Time and Memory Usage: CPU time = 0h 0m 24s, Elapsed time = 0h 0m 24s, Peak memory usage = 696MB

3. Resource Usage Summary

  --------------------------------------------------------------------------------
  Resources                   | Usage                               | Utilization
  --------------------------------------------------------------------------------
  Logic                       | 8320/23040                          |  37%
    --LUT,ALU,ROM16           | 8320(7102 LUT, 1218 ALU, 0 ROM16)   | -
    --SSRAM(RAM16)            | 0                                   | -
  Register                    | 4149/23685                          |  18%
    --Logic Register as Latch | 0/23040                             |  0%
    --Logic Register as FF    | 4136/23040                          |  18%
    --I/O Register as Latch   | 0/645                               |  0%
    --I/O Register as FF      | 13/645                              |  3%
  CLS                         | 5594/11520                          |  49%
  I/O Port                    | 35/222                              |  16%
  I/O Buf                     | 35                                  | -
    --Input Buf               | 9                                   | -
    --Output Buf              | 20                                  | -
    --Inout Buf               | 6                                   | -
  BSRAM                       | 4/56                                | 8%
    --pROM                    | 4
  DSP                         | 5/28                                | 18%
    --MULT27X36               | 1
    --MULTALU27X18            | 3
  ================================================================================

4. I/O Bank Usage Summary

  --------------------------------------
  I/O Bank  | Usage       | Utilization 
  --------------------------------------
  bank 0   | 2/30        | 7%          
  bank 1   | 5/29        | 18%         
  bank 2   | 16/27       | 60%         
  bank 3   | 7/27        | 26%         
  bank 4   | 3/35        | 9%          
  bank 5   | 2/25        | 8%          
  bank 6   | 0/17        | 0%          
  bank 7   | 0/27        | 0%          
  bank 10  | 0/4         | 0%          
  bank 11  | 0/1         | 0%          
  ======================================

5. Clock Resource Usage Summary

  ------------------------------------------
  Clock Resource| Usage         | Utilization 
  ------------------------------------------
  PRIMARY       | 1/8           | 13%
  LW            | 7/8           | 88%
  GCLK_PIN      | 6/40          | 15%
  ==========================================

6. Global Clock Signals

  -------------------------------------------
  Signal         | Global Clock   | Location
  -------------------------------------------
  clk_50m_d      | PRIMARY        |  TR TL BR BL
  probe/n774_143 | LW             |  -
  probe/reset_pipe[1]| LW             |  -
  probe/imu/n2122_11| LW             |  -
  probe/speed_measure_l/n248_12| LW             |  -
  probe/speed_measure_r/n248_12| LW             |  -
  probe/oled/display_text_662_7| LW             |  -
  probe/diagnostics.diag/n3992_6| LW             |  -
  ===========================================

7. Pinout by Port Name

--------------------------------------------------------------------------------------------------------------------------------------------------------------------------------------------------------------------------
Port Name          | Diff Pair | Loc./Bank     | Constraint | Dir.  | Site     | CFG             | IO Type    | Drive | Pull Mode | PCI Clamp | Hysteresis | Open Drain | Vref       | Single Resistor | Diff Resistor | BankVccio  | Pull Strength | Ctle         
--------------------------------------------------------------------------------------------------------------------------------------------------------------------------------------------------------------------------
clk_50m            | -         | T9/4          | Y          | in    | IOB29[A] | GCLKT_11A       | LVCMOS33   | OFF   | NONE      | OFF       | ON         | OFF        | OFF        | OFF             | OFF           | 3.3        | MEDIUM        | NONE         
reset_n            | -         | B16/1         | Y          | in    | IOT91[A] | RPLL0_T_IN1     | LVCMOS33   | OFF   | NONE      | OFF       | ON         | OFF        | OFF        | OFF             | OFF           | 3.3        | MEDIUM        | NONE         
key_enable_n       | -         | A15/1         | Y          | in    | IOT87[B] | -               | LVCMOS33   | OFF   | UP        | OFF       | ON         | OFF        | OFF        | OFF             | OFF           | 3.3        | MEDIUM        | NONE         
key_estop_n        | -         | C15/1         | Y          | in    | IOT87[A] | -               | LVCMOS33   | OFF   | UP        | OFF       | ON         | OFF        | OFF        | OFF             | OFF           | 3.3        | MEDIUM        | NONE         
encoder_a_l        | -         | C17/2         | Y          | in    | IOR9[A]  | -               | LVCMOS33   | OFF   | DOWN      | OFF       | ON         | OFF        | OFF        | OFF             | OFF           | 3.3        | MEDIUM        | NONE         
encoder_b_l        | -         | C18/2         | Y          | in    | IOR9[B]  | MCKTEST         | LVCMOS33   | OFF   | DOWN      | OFF       | ON         | OFF        | OFF        | OFF             | OFF           | 3.3        | MEDIUM        | NONE         
encoder_a_r        | -         | F14/2         | Y          | in    | IOR7[A]  | -               | LVCMOS33   | OFF   | DOWN      | OFF       | ON         | OFF        | OFF        | OFF             | OFF           | 3.3        | MEDIUM        | NONE         
encoder_b_r        | -         | G14/2         | Y          | in    | IOR7[B]  | -               | LVCMOS33   | OFF   | DOWN      | OFF       | ON         | OFF        | OFF        | OFF             | OFF           | 3.3        | MEDIUM        | NONE         
imu_spi_miso       | -         | U18/3         | Y          | in    | IOB71[B] | -               | LVCMOS33   | OFF   | NONE      | OFF       | ON         | OFF        | OFF        | OFF             | OFF           | 3.3        | MEDIUM        | NONE         
oled_scl           | -         | R3/5          | Y          | out   | IOB8[A]  | D05/SO/SSI1     | LVCMOS33   | 8     | NONE      | OFF       | OFF        | OFF        | OFF        | OFF             | OFF           | 3.3        | MEDIUM        | NONE         
imu_spi_sck        | -         | V15/4         | Y          | out   | IOB56[B] | -               | LVCMOS33   | 8     | NONE      | OFF       | OFF        | OFF        | OFF        | OFF             | OFF           | 3.3        | MEDIUM        | NONE         
imu_spi_mosi       | -         | V16/4         | Y          | out   | IOB60[B] | -               | LVCMOS33   | 8     | NONE      | OFF       | OFF        | OFF        | OFF        | OFF             | OFF           | 3.3        | MEDIUM        | NONE         
imu_cs_n           | -         | T18/3         | Y          | out   | IOB73[B] | -               | LVCMOS33   | 8     | NONE      | OFF       | OFF        | OFF        | OFF        | OFF             | OFF           | 3.3        | MEDIUM        | NONE         
PWMA               | -         | U17/3         | Y          | out   | IOB71[A] | -               | LVCMOS33   | 8     | NONE      | OFF       | OFF        | OFF        | OFF        | OFF             | OFF           | 3.3        | MEDIUM        | NONE         
AIN1               | -         | M16/3         | Y          | out   | IOB81[A] | -               | LVCMOS33   | 8     | NONE      | OFF       | OFF        | OFF        | OFF        | OFF             | OFF           | 3.3        | MEDIUM        | NONE         
AIN2               | -         | M14/3         | Y          | out   | IOB69[A] | -               | LVCMOS33   | 8     | NONE      | OFF       | OFF        | OFF        | OFF        | OFF             | OFF           | 3.3        | MEDIUM        | NONE         
PWMB               | -         | T17/3         | Y          | out   | IOB73[A] | -               | LVCMOS33   | 8     | NONE      | OFF       | OFF        | OFF        | OFF        | OFF             | OFF           | 3.3        | MEDIUM        | NONE         
BIN1               | -         | N15/3         | Y          | out   | IOB75[A] | GCLKT_6B        | LVCMOS33   | 8     | NONE      | OFF       | OFF        | OFF        | OFF        | OFF             | OFF           | 3.3        | MEDIUM        | NONE         
BIN2               | -         | H12/2         | Y          | out   | IOR5[A]  | -               | LVCMOS33   | 8     | NONE      | OFF       | OFF        | OFF        | OFF        | OFF             | OFF           | 3.3        | MEDIUM        | NONE         
STBY               | -         | G13/2         | Y          | out   | IOR5[B]  | -               | LVCMOS33   | 8     | NONE      | OFF       | OFF        | OFF        | OFF        | OFF             | OFF           | 3.3        | MEDIUM        | NONE         
uart_tx            | -         | L12/2         | Y          | out   | IOR31[A] | GCLKT_4/RPLL1_T_IN0 | LVCMOS33   | 8     | NONE      | OFF       | OFF        | OFF        | OFF        | OFF             | OFF           | 3.3        | MEDIUM        | NONE         
led_ready          | -         | D14/1         | Y          | out   | IOT89[A] | RPLL0_T_FB1     | LVCMOS33   | 8     | NONE      | OFF       | OFF        | OFF        | OFF        | OFF             | OFF           | 3.3        | MEDIUM        | NONE         
led_run            | -         | C14/1         | Y          | out   | IOT89[B] | -               | LVCMOS33   | 8     | NONE      | OFF       | OFF        | OFF        | OFF        | OFF             | OFF           | 3.3        | MEDIUM        | NONE         
led_fault          | -         | B9/0          | Y          | out   | IOT58[A] | GCLKT_1/TPLL_T_IN2 | LVCMOS33   | 8     | NONE      | OFF       | OFF        | OFF        | OFF        | OFF             | OFF           | 3.3        | MEDIUM        | NONE         
led_heartbeat      | -         | A9/0          | Y          | out   | IOT58[B] | GCLKC_1/TPLL_C_FB0 | LVCMOS33   | 8     | NONE      | OFF       | OFF        | OFF        | OFF        | OFF             | OFF           | 3.3        | MEDIUM        | NONE         
tof_front_scl      | -         | G16/2         | Y          | io    | IOR22[A] | -               | LVCMOS33   | 8     | NONE      | OFF       | OFF        | OFF        | OFF        | OFF             | OFF           | 3.3        | MEDIUM        | NONE         
tof_front_sda      | -         | G18/2         | Y          | io    | IOR22[B] | -               | LVCMOS33   | 8     | NONE      | OFF       | OFF        | OFF        | OFF        | OFF             | OFF           | 3.3        | MEDIUM        | NONE         
tof_front_xshut_n  | -         | F18/2         | Y          | io    | IOR20[B] | -               | LVCMOS33   | 8     | NONE      | OFF       | OFF        | OFF        | OFF        | OFF             | OFF           | 3.3        | MEDIUM        | NONE         
tof_left_scl       | -         | H13/2         | Y          | io    | IOR18[A] | -               | LVCMOS33   | 8     | NONE      | OFF       | OFF        | OFF        | OFF        | OFF             | OFF           | 3.3        | MEDIUM        | NONE         
tof_left_sda       | -         | H14/2         | Y          | io    | IOR18[B] | -               | LVCMOS33   | 8     | NONE      | OFF       | OFF        | OFF        | OFF        | OFF             | OFF           | 3.3        | MEDIUM        | NONE         
tof_left_xshut_n   | -         | K16/2         | Y          | io    | IOR33[B] | GCLKC_5/RPLL1_C_FB0 | LVCMOS33   | 8     | NONE      | OFF       | OFF        | OFF        | OFF        | OFF             | OFF           | 3.3        | MEDIUM        | NONE         
tof_right_scl      | -         | J13/2         | Y          | io    | IOR26[A] | -               | LVCMOS33   | 8     | NONE      | OFF       | OFF        | OFF        | OFF        | OFF             | OFF           | 3.3        | MEDIUM        | NONE         
tof_right_sda      | -         | K14/2         | Y          | io    | IOR26[B] | -               | LVCMOS33   | 8     | NONE      | OFF       | OFF        | OFF        | OFF        | OFF             | OFF           | 3.3        | MEDIUM        | NONE         
tof_right_xshut_n  | -         | K13/2         | Y          | io    | IOR29[B] | -               | LVCMOS33   | 8     | NONE      | OFF       | OFF        | OFF        | OFF        | OFF             | OFF           | 3.3        | MEDIUM        | NONE         
oled_sda           | -         | T3/5          | Y          | io    | IOB8[B]  | D06             | LVCMOS33   | 8     | NONE      | OFF       | OFF        | OFF        | OFF        | OFF             | OFF           | 3.3        | MEDIUM        | NONE         
==========================================================================================================================================================================================================================

8. All Package Pins

-----------------------------------------------------------------------------------------------------------------------------------------------------------------------------------------------
Loc./Bank| Signal             | Dir.  | Site     | CFG             | IO Type  | Drive | Pull Mode | PCI Clamp | Hysteresis | Open Drain | Vref       | Single Resistor | Diff Resistor | Bank Vccio | Pull Strength | Ctle         
-----------------------------------------------------------------------------------------------------------------------------------------------------------------------------------------------
H4/7     | -                  | in    | IOT1[A]  | GCLKT_15/LPLL0_T_IN0 | LVCMOS33 | 8     | UP        | OFF       | ON         | OFF        | OFF        | OFF             | OFF           | 3.3   | MEDIUM        | NONE         
H3/7     | -                  | in    | IOT1[B]  | GCLKC_15        | LVCMOS33 | 8     | UP        | OFF       | ON         | OFF        | OFF        | OFF             | OFF           | 3.3   | MEDIUM        | NONE         
L5/7     | -                  | in    | IOT3[A]  | GCLKT_16        | LVCMOS33 | 8     | UP        | OFF       | ON         | OFF        | OFF        | OFF             | OFF           | 3.3   | MEDIUM        | NONE         
K5/7     | -                  | in    | IOT3[B]  | GCLKC_16        | LVCMOS33 | 8     | UP        | OFF       | ON         | OFF        | OFF        | OFF             | OFF           | 3.3   | MEDIUM        | NONE         
H5/7     | -                  | in    | IOT5[B]  | -               | LVCMOS33 | 8     | UP        | OFF       | ON         | OFF        | OFF        | OFF             | OFF           | 3.3   | MEDIUM        | NONE         
G3/7     | -                  | in    | IOT7[A]  | -               | LVCMOS33 | 8     | UP        | OFF       | ON         | OFF        | OFF        | OFF             | OFF           | 3.3   | MEDIUM        | NONE         
G1/7     | -                  | in    | IOT7[B]  | -               | LVCMOS33 | 8     | UP        | OFF       | ON         | OFF        | OFF        | OFF             | OFF           | 3.3   | MEDIUM        | NONE         
H7/7     | -                  | in    | IOT9[A]  | -               | LVCMOS33 | 8     | UP        | OFF       | ON         | OFF        | OFF        | OFF             | OFF           | 3.3   | MEDIUM        | NONE         
G6/7     | -                  | in    | IOT9[B]  | -               | LVCMOS33 | 8     | UP        | OFF       | ON         | OFF        | OFF        | OFF             | OFF           | 3.3   | MEDIUM        | NONE         
F2/7     | -                  | in    | IOT11[A] | -               | LVCMOS33 | 8     | UP        | OFF       | ON         | OFF        | OFF        | OFF             | OFF           | 3.3   | MEDIUM        | NONE         
F1/7     | -                  | in    | IOT11[B] | -               | LVCMOS33 | 8     | UP        | OFF       | ON         | OFF        | OFF        | OFF             | OFF           | 3.3   | MEDIUM        | NONE         
J7/7     | -                  | in    | IOT13[A] | -               | LVCMOS33 | 8     | UP        | OFF       | ON         | OFF        | OFF        | OFF             | OFF           | 3.3   | MEDIUM        | NONE         
J6/7     | -                  | in    | IOT13[B] | -               | LVCMOS33 | 8     | UP        | OFF       | ON         | OFF        | OFF        | OFF             | OFF           | 3.3   | MEDIUM        | NONE         
E3/7     | -                  | in    | IOT15[A] | -               | LVCMOS33 | 8     | UP        | OFF       | ON         | OFF        | OFF        | OFF             | OFF           | 3.3   | MEDIUM        | NONE         
E1/7     | -                  | in    | IOT15[B] | -               | LVCMOS33 | 8     | UP        | OFF       | ON         | OFF        | OFF        | OFF             | OFF           | 3.3   | MEDIUM        | NONE         
F4/7     | -                  | in    | IOT17[A] | -               | LVCMOS33 | 8     | UP        | OFF       | ON         | OFF        | OFF        | OFF             | OFF           | 3.3   | MEDIUM        | NONE         
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
V2/5     | -                  | in    | IOB1[A]  | RECONFIG_N      | LVCMOS33 | 8     | UP        | OFF       | ON         | OFF        | OFF        | OFF             | OFF           | 3.3   | MEDIUM        | NONE         
T4/5     | -                  | in    | IOB2[A]  | -               | LVCMOS33 | 8     | UP        | OFF       | ON         | OFF        | OFF        | OFF             | OFF           | 3.3   | MEDIUM        | NONE         
N5/5     | -                  | in    | IOB4[A]  | D08/SDA         | LVCMOS33 | 8     | UP        | OFF       | ON         | OFF        | OFF        | OFF             | OFF           | 3.3   | MEDIUM        | NONE         
P6/5     | -                  | in    | IOB4[B]  | D09/SCL/LPLL1_C_FB0 | LVCMOS33 | 8     | NONE      | OFF       | ON         | OFF        | OFF        | OFF             | OFF           | 3.3   | MEDIUM        | NONE         
R7/5     | -                  | in    | IOB6[A]  | -               | LVCMOS33 | 8     | UP        | OFF       | ON         | OFF        | OFF        | OFF             | OFF           | 3.3   | MEDIUM        | NONE         
T7/5     | -                  | in    | IOB6[B]  | -               | LVCMOS33 | 8     | UP        | OFF       | ON         | OFF        | OFF        | OFF             | OFF           | 3.3   | MEDIUM        | NONE         
R3/5     | oled_scl           | out   | IOB8[A]  | D05/SO/SSI1     | LVCMOS33 | 8     | NONE      | OFF       | OFF        | OFF        | OFF        | OFF             | OFF           | 3.3   | MEDIUM        | NONE         
T3/5     | oled_sda           | out   | IOB8[B]  | D06             | LVCMOS33 | 8     | NONE      | OFF       | OFF        | OFF        | OFF        | OFF             | OFF           | 3.3   | MEDIUM        | NONE         
U5/5     | -                  | in    | IOB10[A] | D03/SSPI_CS_N   | LVCMOS33 | 8     | UP        | OFF       | ON         | OFF        | OFF        | OFF             | OFF           | 3.3   | MEDIUM        | NONE         
V5/5     | -                  | in    | IOB10[B] | D04/SI/SSI0     | LVCMOS33 | 8     | UP        | OFF       | ON         | OFF        | OFF        | OFF             | OFF           | 3.3   | MEDIUM        | NONE         
R5/5     | -                  | in    | IOB12[A] | GCLKT_10B/D07/SSPI_WPN/SSI2 | LVCMOS33 | 8     | UP        | OFF       | ON         | OFF        | OFF        | OFF             | OFF           | 3.3   | MEDIUM        | NONE         
T5/5     | -                  | in    | IOB12[B] | GCLKC_10B/RDWR_B/LPLL1_C_IN1 | LVCMOS33 | 8     | DOWN      | OFF       | ON         | OFF        | OFF        | OFF             | OFF           | 3.3   | MEDIUM        | NONE         
N6/5     | -                  | in    | IOB14[A] | SSPI_CLK        | LVCMOS33 | 8     | UP        | OFF       | ON         | OFF        | OFF        | OFF             | OFF           | 3.3   | MEDIUM        | NONE         
P7/5     | -                  | in    | IOB14[B] | CLKHOLD_N/SSI3  | LVCMOS33 | 8     | UP        | OFF       | ON         | OFF        | OFF        | OFF             | OFF           | 3.3   | MEDIUM        | NONE         
T6/5     | -                  | in    | IOB16[A] | -               | LVCMOS33 | 8     | UP        | OFF       | ON         | OFF        | OFF        | OFF             | OFF           | 3.3   | MEDIUM        | NONE         
V6/5     | -                  | in    | IOB16[B] | -               | LVCMOS33 | 8     | UP        | OFF       | ON         | OFF        | OFF        | OFF             | OFF           | 3.3   | MEDIUM        | NONE
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
