WeieeGRACE/Embodied_RPACS/tests/records/2026-10-14_双轮反转原始日志.txt

« L=0 R=0 TL=-10 TR=-10 VL=0 VR=0 SFL=0 SFR=0 PL=0 PR=0 SL=0 SR=0 EN=0 ST=0 IL=0 IR=0 FL=0 FR=0 FAULT=0 FC=0
« L=0 R=0 TL=-10 TR=-10 VL=0 VR=0 SFL=0 SFR=0 PL=0 PR=0 SL=0 SR=0 EN=0 ST=0 IL=0 IR=0 FL=0 FR=0 FAULT=0 FC=0
« L=0 R=0 TL=-10 TR=-10 VL=0 VR=0 SFL=0 SFR=0 PL=0 PR=0 SL=0 SR=0 EN=0 ST=0 IL=0 IR=0 FL=0 FR=0 FAULT=0 FC=0
« L=0 R=0 TL=-10 TR=-10 VL=0 VR=0 SFL=0 SFR=0 PL=0 PR=0 SL=0 SR=0 EN=0 ST=0 IL=0 IR=0 FL=0 FR=0 FAULT=0 FC=0
« L=0 R=0 TL=-10 TR=-10 VL=0 VR=0 SFL=0 SFR=0 PL=0 PR=0 SL=0 SR=0 EN=0 ST=0 IL=0 IR=0 FL=0 FR=0 FAULT=0 FC=0
« L=0 R=0 TL=-10 TR=-10 VL=0 VR=0 SFL=0 SFR=0 PL=0 PR=0 SL=0 SR=0 EN=0 ST=0 IL=0 IR=0 FL=0 FR=0 FAULT=0 FC=0
« L=0 R=0 TL=-10 TR=-10 VL=0 VR=0 SFL=0 SFR=0 PL=0 PR=0 SL=0 SR=0 EN=0 ST=0 IL=0 IR=0 FL=0 FR=0 FAULT=0 FC=0
« L=0 R=0 TL=-10 TR=-10 VL=0 VR=0 SFL=0 SFR=0 PL=0 PR=0 SL=0 SR=0 EN=0 ST=0 IL=0 IR=0 FL=0 FR=0 FAULT=0 FC=0
« L=0 R=0 TL=-10 TR=-10 VL=0 VR=0 SFL=0 SFR=0 PL=0 PR=0 SL=0 SR=0 EN=0 ST=0 IL=0 IR=0 FL=0 FR=0 FAULT=0 FC=0
« L=0 R=0 TL=-10 TR=-10 VL=0 VR=0 SFL=0 SFR=0 PL=0 PR=0 SL=0 SR=0 EN=0 ST=0 IL=0 IR=0 FL=0 FR=0 FAULT=0 FC=0
« L=0 R=0 TL=-10 TR=-10 VL=0 VR=0 SFL=0 SFR=0 PL=0 PR=0 SL=0 SR=0 EN=0 ST=0 IL=0 IR=0 FL=0 FR=0 FAULT=0 FC=0
« L=0 R=0 TL=-10 TR=-10 VL=0 VR=0 SFL=0 SFR=0 PL=0 PR=0 SL=0 SR=0 EN=0 ST=0 IL=0 IR=0 FL=0 FR=0 FAULT=0 FC=0
« L=0 R=0 TL=-10 TR=-10 VL=0 VR=0 SFL=0 SFR=0 PL=0 PR=0 SL=0 SR=0 EN=0 ST=0 IL=0 IR=0 FL=0 FR=0 FAULT=0 FC=0
« L=0 R=0 TL=-10 TR=-10 VL=0 VR=0 SFL=0 SFR=0 PL=0 PR=0 SL=0 SR=0 EN=0 ST=0 IL=0 IR=0 FL=0 FR=0 FAULT=0 FC=0
« L=0 R=0 TL=-10 TR=-10 VL=0 VR=0 SFL=0 SFR=0 PL=0 PR=0 SL=0 SR=0 EN=0 ST=0 IL=0 IR=0 FL=0 FR=0 FAULT=0 FC=0
« L=0 R=0 TL=-10 TR=-10 VL=0 VR=0 SFL=0 SFR=0 PL=0 PR=0 SL=0 SR=0 EN=0 ST=0 IL=0 IR=0 FL=0 FR=0 FAULT=0 FC=0
« L=0 R=0 TL=-10 TR=-10 VL=0 VR=0 SFL=0 SFR=0 PL=0 PR=0 SL=0 SR=0 EN=0 ST=0 IL=0 IR=0 FL=0 FR=0 FAULT=0 FC=0
« L=0 R=0 TL=-10 TR=-10 VL=0 VR=0 SFL=0 SFR=0 PL=0 PR=0 SL=0 SR=0 EN=0 ST=0 IL=0 IR=0 FL=0 FR=0 FAULT=0 FC=0
« L=-40 R=-38 TL=-10 TR=-10 VL=-6 VR=-6 SFL=-6 SFR=-6 PL=-198 PR=-198 SL=0 SR=0 EN=1 ST=1 IL=0 IR=0 FL=0 FR=0 FAULT=0 FC=0
« L=-106 R=-100 TL=-10 TR=-10 VL=-7 VR=-6 SFL=-6 SFR=-6 PL=-238 PR=-238 SL=0 SR=0 EN=1 ST=1 IL=0 IR=0 FL=0 FR=0 FAULT=0 FC=0
« L=-176 R=-170 TL=-10 TR=-10 VL=-7 VR=-7 SFL=-7 SFR=-7 PL=-238 PR=-239 SL=0 SR=0 EN=1 ST=1 IL=0 IR=0 FL=0 FR=0 FAULT=0 FC=0
« L=-252 R=-245 TL=-10 TR=-10 VL=-8 VR=-8 SFL=-8 SFR=-7 PL=-235 PR=-269 SL=0 SR=0 EN=1 ST=1 IL=0 IR=0 FL=0 FR=0 FAULT=0 FC=0
« L=-334 R=-325 TL=-10 TR=-10 VL=-8 VR=-8 SFL=-8 SFR=-8 PL=-258 PR=-258 SL=0 SR=0 EN=1 ST=1 IL=0 IR=0 FL=0 FR=0 FAULT=0 FC=0
« L=-418 R=-408 TL=-10 TR=-10 VL=-9 VR=-8 SFL=-8 SFR=-8 PL=-278 PR=-278 SL=0 SR=0 EN=1 ST=1 IL=0 IR=0 FL=0 FR=0 FAULT=0 FC=0
« L=-507 R=-497 TL=-10 TR=-10 VL=-9 VR=-9 SFL=-8 SFR=-9 PL=-294 PR=-262 SL=0 SR=0 EN=1 ST=1 IL=0 IR=0 FL=0 FR=0 FAULT=0 FC=0
« L=-597 R=-587 TL=-10 TR=-10 VL=-9 VR=-9 SFL=-8 SFR=-9 PL=-307 PR=-276 SL=0 SR=0 EN=1 ST=1 IL=0 IR=0 FL=0 FR=0 FAULT=0 FC=0
« L=-690 R=-678 TL=-10 TR=-10 VL=-10 VR=-9 SFL=-9 SFR=-9 PL=-286 PR=-286 SL=0 SR=0 EN=1 ST=1 IL=0 IR=0 FL=0 FR=0 FAULT=0 FC=0
« L=-785 R=-772 TL=-10 TR=-10 VL=-9 VR=-10 SFL=-9 SFR=-9 PL=-296 PR=-296 SL=0 SR=0 EN=1 ST=1 IL=0 IR=0 FL=0 FR=0 FAULT=0 FC=0
« L=-883 R=-869 TL=-10 TR=-10 VL=-10 VR=-10 SFL=-9 SFR=-9 PL=-306 PR=-305 SL=0 SR=0 EN=1 ST=1 IL=0 IR=0 FL=0 FR=0 FAULT=0 FC=0
« L=-981 R=-967 TL=-10 TR=-10 VL=-10 VR=-9 SFL=-9 SFR=-9 PL=-311 PR=-310 SL=0 SR=0 EN=1 ST=1 IL=0 IR=0 FL=0 FR=0 FAULT=0 FC=0
« L=-1080 R=-1066 TL=-10 TR=-10 VL=-10 VR=-10 SFL=-10 SFR=-9 PL=-283 PR=-318 SL=0 SR=0 EN=1 ST=1 IL=0 IR=0 FL=0 FR=0 FAULT=0 FC=0
« L=-1179 R=-1166 TL=-10 TR=-10 VL=-10 VR=-10 SFL=-10 SFR=-10 PL=-287 PR=-290 SL=0 SR=0 EN=1 ST=1 IL=0 IR=0 FL=0 FR=0 FAULT=0 FC=0
« L=-1279 R=-1265 TL=-10 TR=-10 VL=-10 VR=-10 SFL=-10 SFR=-9 PL=-291 PR=-325 SL=0 SR=0 EN=1 ST=1 IL=0 IR=0 FL=0 FR=0 FAULT=0 FC=0
« L=-1379 R=-1365 TL=-10 TR=-10 VL=-11 VR=-10 SFL=-10 SFR=-10 PL=-295 PR=-294 SL=0 SR=0 EN=1 ST=1 IL=0 IR=0 FL=0 FR=0 FAULT=0 FC=0
« L=-1480 R=-1468 TL=-10 TR=-10 VL=-10 VR=-10 SFL=-10 SFR=-10 PL=-295 PR=-298 SL=0 SR=0 EN=1 ST=1 IL=0 IR=0 FL=0 FR=0 FAULT=0 FC=0
« L=-1580 R=-1568 TL=-10 TR=-10 VL=-10 VR=-10 SFL=-10 SFR=-9 PL=-296 PR=-332 SL=0 SR=0 EN=1 ST=1 IL=0 IR=0 FL=0 FR=0 FAULT=0 FC=0
« L=-1680 R=-1669 TL=-10 TR=-10 VL=-10 VR=-10 SFL=-10 SFR=-10 PL=-298 PR=-300 SL=0 SR=0 EN=1 ST=1 IL=0 IR=0 FL=0 FR=0 FAULT=0 FC=0
« L=-1781 R=-1769 TL=-10 TR=-10 VL=-10 VR=-10 SFL=-10 SFR=-10 PL=-298 PR=-301 SL=0 SR=0 EN=1 ST=1 IL=0 IR=0 FL=0 FR=0 FAULT=0 FC=0
« L=-1863 R=-1851 TL=-10 TR=-10 VL=-7 VR=-7 SFL=-7 SFR=-7 PL=0 PR=0 SL=0 SR=0 EN=0 ST=0 IL=0 IR=0 FL=0 FR=0 FAULT=0 FC=0
« L=-1909 R=-1894 TL=-10 TR=-10 VL=-3 VR=-4 SFL=-3 SFR=-3 PL=0 PR=0 SL=0 SR=0 EN=0 ST=0 IL=0 IR=0 FL=0 FR=0 FAULT=0 FC=0
« L=-1915 R=-1899 TL=-10 TR=-10 VL=1 VR=1 SFL=0 SFR=0 PL=0 PR=0 SL=0 SR=0 EN=0 ST=0 IL=0 IR=0 FL=0 FR=0 FAULT=0 FC=0
« L=-1915 R=-1898 TL=-10 TR=-10 VL=0 VR=0 SFL=0 SFR=0 PL=0 PR=0 SL=0 SR=0 EN=0 ST=0 IL=0 IR=0 FL=0 FR=0 FAULT=0 FC=0
« L=-1915 R=-1898 TL=-10 TR=-10 VL=0 VR=0 SFL=0 SFR=0 PL=0 PR=0 SL=0 SR=0 EN=0 ST=0 IL=0 IR=0 FL=0 FR=0 FAULT=0 FC=0
« L=-1915 R=-1898 TL=-10 TR=-10 VL=0 VR=0 SFL=0 SFR=0 PL=0 PR=0 SL=0 SR=0 EN=0 ST=0 IL=0 IR=0 FL=0 FR=0 FAULT=0 FC=0
« L=-1915 R=-1898 TL=-10 TR=-10 VL=0 VR=0 SFL=0 SFR=0 PL=0 PR=0 SL=0 SR=0 EN=0 ST=0 IL=0 IR=0 FL=0 FR=0 FAULT=0 FC=0
« L=-1915 R=-1898 TL=-10 TR=-10 VL=0 VR=0 SFL=0 SFR=0 PL=0 PR=0 SL=0 SR=0 EN=0 ST=0 IL=0 IR=0 FL=0 FR=0 FAULT=0 FC=0
« L=-1915 R=-1898 TL=-10 TR=-10 VL=0 VR=0 SFL=0 SFR=0 PL=0 PR=0 SL=0 SR=0 EN=0 ST=0 IL=0 IR=0 FL=0 FR=0 FAULT=0 FC=0
« L=-1915 R=-1898 TL=-10 TR=-10 VL=0 VR=0 SFL=0 SFR=0 PL=0 PR=0 SL=0 SR=0 EN=0 ST=0 IL=0 IR=0 FL=0 FR=0 FAULT=0 FC=0
« L=-1915 R=-1898 TL=-10 TR=-10 VL=0 VR=0 SFL=0 SFR=0 PL=0 PR=0 SL=0 SR=0 EN=0 ST=0 IL=0 IR=0 FL=0 FR=0 FAULT=0 FC=0
« L=-1915 R=-1899 TL=-10 TR=-10 VL=0 VR=0 SFL=0 SFR=0 PL=-200 PR=-200 SL=0 SR=0 EN=1 ST=1 IL=0 IR=0 FL=0 FR=0 FAULT=0 FC=0
« L=-1968 R=-1951 TL=-10 TR=-10 VL=-7 VR=-7 SFL=-7 SFR=-6 PL=-173 PR=-205 SL=0 SR=0 EN=1 ST=1 IL=0 IR=0 FL=0 FR=0 FAULT=0 FC=0
« L=-2036 R=-2018 TL=-10 TR=-10 VL=-7 VR=-7 SFL=-7 SFR=-6 PL=-212 PR=-245 SL=0 SR=0 EN=1 ST=1 IL=0 IR=0 FL=0 FR=0 FAULT=0 FC=0
« L=-2106 R=-2091 TL=-10 TR=-10 VL=-7 VR=-8 SFL=-7 SFR=-7 PL=-242 PR=-244 SL=0 SR=0 EN=1 ST=1 IL=0 IR=0 FL=0 FR=0 FAULT=0 FC=0
« L=-2183 R=-2170 TL=-10 TR=-10 VL=-8 VR=-8 SFL=-8 SFR=-8 PL=-238 PR=-240 SL=0 SR=0 EN=1 ST=1 IL=0 IR=0 FL=0 FR=0 FAULT=0 FC=0
« L=-2265 R=-2250 TL=-10 TR=-10 VL=-8 VR=-8 SFL=-8 SFR=-8 PL=-260 PR=-260 SL=0 SR=0 EN=1 ST=1 IL=0 IR=0 FL=0 FR=0 FAULT=0 FC=0
« L=-2351 R=-2335 TL=-10 TR=-10 VL=-8 VR=-8 SFL=-8 SFR=-8 PL=-280 PR=-280 SL=0 SR=0 EN=1 ST=1 IL=0 IR=0 FL=0 FR=0 FAULT=0 FC=0
« L=-2440 R=-2424 TL=-10 TR=-10 VL=-9 VR=-8 SFL=-8 SFR=-8 PL=-295 PR=-294 SL=0 SR=0 EN=1 ST=1 IL=0 IR=0 FL=0 FR=0 FAULT=0 FC=0
« L=-2531 R=-2515 TL=-10 TR=-10 VL=-9 VR=-9 SFL=-9 SFR=-9 PL=-275 PR=-275 SL=0 SR=0 EN=1 ST=1 IL=0 IR=0 FL=0 FR=0 FAULT=0 FC=0
« L=-2622 R=-2606 TL=-10 TR=-10 VL=-9 VR=-10 SFL=-9 SFR=-9 PL=-285 PR=-285 SL=0 SR=0 EN=1 ST=1 IL=0 IR=0 FL=0 FR=0 FAULT=0 FC=0
« L=-2717 R=-2700 TL=-10 TR=-10 VL=-9 VR=-10 SFL=-9 SFR=-9 PL=-295 PR=-295 SL=0 SR=0 EN=1 ST=1 IL=0 IR=0 FL=0 FR=0 FAULT=0 FC=0
« L=-2815 R=-2798 TL=-10 TR=-10 VL=-9 VR=-10 SFL=-9 SFR=-9 PL=-303 PR=-305 SL=0 SR=0 EN=1 ST=1 IL=0 IR=0 FL=0 FR=0 FAULT=0 FC=0
« L=-2914 R=-2896 TL=-10 TR=-10 VL=-10 VR=-9 SFL=-10 SFR=-9 PL=-278 PR=-311 SL=0 SR=0 EN=1 ST=1 IL=0 IR=0 FL=0 FR=0 FAULT=0 FC=0
« L=-3013 R=-2996 TL=-10 TR=-10 VL=-10 VR=-10 SFL=-10 SFR=-10 PL=-283 PR=-284 SL=0 SR=0 EN=1 ST=1 IL=0 IR=0 FL=0 FR=0 FAULT=0 FC=0
« L=-3112 R=-3096 TL=-10 TR=-10 VL=-10 VR=-10 SFL=-10 SFR=-10 PL=-286 PR=-288 SL=0 SR=0 EN=1 ST=1 IL=0 IR=0 FL=0 FR=0 FAULT=0 FC=0
« L=-3212 R=-3196 TL=-10 TR=-10 VL=-10 VR=-10 SFL=-10 SFR=-10 PL=-290 PR=-292 SL=0 SR=0 EN=1 ST=1 IL=0 IR=0 FL=0 FR=0 FAULT=0 FC=0
« L=-3312 R=-3296 TL=-10 TR=-10 VL=-10 VR=-10 SFL=-9 SFR=-10 PL=-326 PR=-294 SL=0 SR=0 EN=1 ST=1 IL=0 IR=0 FL=0 FR=0 FAULT=0 FC=0
« L=-3413 R=-3397 TL=-10 TR=-10 VL=-10 VR=-11 SFL=-10 SFR=-10 PL=-294 PR=-297 SL=0 SR=0 EN=1 ST=1 IL=0 IR=0 FL=0 FR=0 FAULT=0 FC=0
« L=-3513 R=-3497 TL=-10 TR=-10 VL=-10 VR=-11 SFL=-10 SFR=-10 PL=-295 PR=-299 SL=0 SR=0 EN=1 ST=1 IL=0 IR=0 FL=0 FR=0 FAULT=0 FC=0
« L=-3614 R=-3598 TL=-10 TR=-10 VL=-10 VR=-11 SFL=-10 SFR=-10 PL=-297 PR=-299 SL=0 SR=0 EN=1 ST=1 IL=0 IR=0 FL=0 FR=0 FAULT=0 FC=0
« L=-3713 R=-3698 TL=-10 TR=-10 VL=-10 VR=-10 SFL=-10 SFR=-10 PL=0 PR=0 SL=0 SR=0 EN=0 ST=0 IL=0 IR=0 FL=0 FR=0 FAULT=0 FC=0
« L=-3786 R=-3771 TL=-10 TR=-10 VL=-6 VR=-6 SFL=-6 SFR=-6 PL=0 PR=0 SL=0 SR=0 EN=0 ST=0 IL=0 IR=0 FL=0 FR=0 FAULT=0 FC=0
« L=-3823 R=-3808 TL=-10 TR=-10 VL=-2 VR=-2 SFL=-2 SFR=-3 PL=0 PR=0 SL=0 SR=0 EN=0 ST=0 IL=0 IR=0 FL=0 FR=0 FAULT=0 FC=0
« L=-3826 R=-3815 TL=-10 TR=-10 VL=0 VR=0 SFL=0 SFR=0 PL=0 PR=0 SL=0 SR=0 EN=0 ST=0 IL=0 IR=0 FL=0 FR=0 FAULT=0 FC=0
« L=-3822 R=-3814 TL=-10 TR=-10 VL=-1 VR=0 SFL=0 SFR=0 PL=0 PR=0 SL=0 SR=0 EN=0 ST=0 IL=0 IR=0 FL=0 FR=0 FAULT=0 FC=0
« L=-3822 R=-3814 TL=-10 TR=-10 VL=0 VR=0 SFL=0 SFR=0 PL=0 PR=0 SL=0 SR=0 EN=0 ST=0 IL=0 IR=0 FL=0 FR=0 FAULT=0 FC=0
« L=-3822 R=-3814 TL=-10 TR=-10 VL=0 VR=0 SFL=0 SFR=0 PL=0 PR=0 SL=0 SR=0 EN=0 ST=0 IL=0 IR=0 FL=0 FR=0 FAULT=0 FC=0
« L=-3822 R=-3814 TL=-10 TR=-10 VL=0 VR=0 SFL=0 SFR=0 PL=0 PR=0 SL=0 SR=0 EN=0 ST=0 IL=0 IR=0 FL=0 FR=0 FAULT=0 FC=0
« L=-3822 R=-3814 TL=-10 TR=-10 VL=0 VR=0 SFL=0 SFR=0 PL=0 PR=0 SL=0 SR=0 EN=0 ST=0 IL=0 IR=0 FL=0 FR=0 FAULT=0 FC=0
« L=-3822 R=-3814 TL=-10 TR=-10 VL=0 VR=0 SFL=0 SFR=0 PL=0 PR=0 SL=0 SR=0 EN=0 ST=0 IL=0 IR=0 FL=0 FR=0 FAULT=0 FC=0
« L=-3822 R=-3814 TL=-10 TR=-10 VL=0 VR=0 SFL=0 SFR=0 PL=0 PR=0 SL=0 SR=0 EN=0 ST=0 IL=0 IR=0 FL=0 FR=0 FAULT=0 FC=0
« L=-3854 R=-3847 TL=-10 TR=-10 VL=-6 VR=-7 SFL=-5 SFR=-5 PL=-225 PR=-227 SL=0 SR=0 EN=1 ST=1 IL=0 IR=0 FL=0 FR=0 FAULT=0 FC=0
« L=-3920 R=-3913 TL=-10 TR=-10 VL=-6 VR=-7 SFL=-6 SFR=-6 PL=-232 PR=-233 SL=0 SR=0 EN=1 ST=1 IL=0 IR=0 FL=0 FR=0 FAULT=0 FC=0
« L=-3992 R=-3985 TL=-10 TR=-10 VL=-7 VR=-7 SFL=-7 SFR=-7 PL=-234 PR=-236 SL=0 SR=0 EN=1 ST=1 IL=0 IR=0 FL=0 FR=0 FAULT=0 FC=0
« L=-4069 R=-4061 TL=-10 TR=-10 VL=-8 VR=-8 SFL=-8 SFR=-7 PL=-231 PR=-266 SL=0 SR=0 EN=1 ST=1 IL=0 IR=0 FL=0 FR=0 FAULT=0 FC=0
« L=-4149 R=-4142 TL=-10 TR=-10 VL=-8 VR=-8 SFL=-8 SFR=-8 PL=-254 PR=-255 SL=0 SR=0 EN=1 ST=1 IL=0 IR=0 FL=0 FR=0 FAULT=0 FC=0
« L=-4234 R=-4225 TL=-10 TR=-10 VL=-8 VR=-9 SFL=-8 SFR=-8 PL=-274 PR=-275 SL=0 SR=0 EN=1 ST=1 IL=0 IR=0 FL=0 FR=0 FAULT=0 FC=0
« L=-4323 R=-4314 TL=-10 TR=-10 VL=-9 VR=-9 SFL=-8 SFR=-9 PL=-290 PR=-259 SL=0 SR=0 EN=1 ST=1 IL=0 IR=0 FL=0 FR=0 FAULT=0 FC=0
« L=-4413 R=-4404 TL=-10 TR=-10 VL=-9 VR=-9 SFL=-9 SFR=-9 PL=-270 PR=-274 SL=0 SR=0 EN=1 ST=1 IL=0 IR=0 FL=0 FR=0 FAULT=0 FC=0
« L=-4505 R=-4496 TL=-10 TR=-10 VL=-9 VR=-9 SFL=-9 SFR=-9 PL=-283 PR=-284 SL=0 SR=0 EN=1 ST=1 IL=0 IR=0 FL=0 FR=0 FAULT=0 FC=0
« L=-4600 R=-4590 TL=-10 TR=-10 VL=-10 VR=-10 SFL=-9 SFR=-9 PL=-293 PR=-294 SL=0 SR=0 EN=1 ST=1 IL=0 IR=0 FL=0 FR=0 FAULT=0 FC=0
« L=-4698 R=-4687 TL=-10 TR=-10 VL=-10 VR=-10 SFL=-9 SFR=-9 PL=-302 PR=-304 SL=0 SR=0 EN=1 ST=1 IL=0 IR=0 FL=0 FR=0 FAULT=0 FC=0
« L=-4796 R=-4785 TL=-10 TR=-10 VL=-10 VR=-10 SFL=-10 SFR=-9 PL=-276 PR=-309 SL=0 SR=0 EN=1 ST=1 IL=0 IR=0 FL=0 FR=0 FAULT=0 FC=0
« L=-4895 R=-4884 TL=-10 TR=-10 VL=-9 VR=-9 SFL=-9 SFR=-9 PL=-313 PR=-315 SL=0 SR=0 EN=1 ST=1 IL=0 IR=0 FL=0 FR=0 FAULT=0 FC=0
« L=-4994 R=-4983 TL=-10 TR=-10 VL=-10 VR=-9 SFL=-10 SFR=-9 PL=-284 PR=-319 SL=0 SR=0 EN=1 ST=1 IL=0 IR=0 FL=0 FR=0 FAULT=0 FC=0
« L=-5094 R=-5083 TL=-10 TR=-10 VL=-9 VR=-9 SFL=-10 SFR=-9 PL=-288 PR=-323 SL=0 SR=0 EN=1 ST=1 IL=0 IR=0 FL=0 FR=0 FAULT=0 FC=0
« L=-5194 R=-5184 TL=-10 TR=-10 VL=-10 VR=-10 SFL=-10 SFR=-10 PL=-292 PR=-293 SL=0 SR=0 EN=1 ST=1 IL=0 IR=0 FL=0 FR=0 FAULT=0 FC=0
« L=-5294 R=-5285 TL=-10 TR=-10 VL=-10 VR=-10 SFL=-10 SFR=-10 PL=-294 PR=-297 SL=0 SR=0 EN=1 ST=1 IL=0 IR=0 FL=0 FR=0 FAULT=0 FC=0
« L=-5394 R=-5385 TL=-10 TR=-10 VL=-10 VR=-10 SFL=-10 SFR=-10 PL=-294 PR=-297 SL=0 SR=0 EN=1 ST=1 IL=0 IR=0 FL=0 FR=0 FAULT=0 FC=0
« L=-5496 R=-5487 TL=-10 TR=-10 VL=-10 VR=-10 SFL=-10 SFR=-10 PL=-298 PR=-299 SL=0 SR=0 EN=1 ST=1 IL=0 IR=0 FL=0 FR=0 FAULT=0 FC=0
« L=-5597 R=-5587 TL=-10 TR=-10 VL=-11 VR=-10 SFL=-10 SFR=-10 PL=-298 PR=-299 SL=0 SR=0 EN=1 ST=1 IL=0 IR=0 FL=0 FR=0 FAULT=0 FC=0
« L=-5683 R=-5673 TL=-10 TR=-10 VL=-7 VR=-7 SFL=-7 SFR=-7 PL=0 PR=0 SL=0 SR=0 EN=0 ST=0 IL=0 IR=0 FL=0 FR=0 FAULT=0 FC=0
« L=-5735 R=-5720 TL=-10 TR=-10 VL=-4 VR=-4 SFL=-4 SFR=-4 PL=0 PR=0 SL=0 SR=0 EN=0 ST=0 IL=0 IR=0 FL=0 FR=0 FAULT=0 FC=0
« L=-5753 R=-5731 TL=-10 TR=-10 VL=-1 VR=1 SFL=-1 SFR=0 PL=0 PR=0 SL=0 SR=0 EN=0 ST=0 IL=0 IR=0 FL=0 FR=0 FAULT=0 FC=0
« L=-5755 R=-5729 TL=-10 TR=-10 VL=0 VR=0 SFL=0 SFR=0 PL=0 PR=0 SL=0 SR=0 EN=0 ST=0 IL=0 IR=0 FL=0 FR=0 FAULT=0 FC=0
« L=-5755 R=-5729 TL=-10 TR=-10 VL=0 VR=0 SFL=0 SFR=0 PL=0 PR=0 SL=0 SR=0 EN=0 ST=0 IL=0 IR=0 FL=0 FR=0 FAULT=0 FC=0
« L=-5755 R=-5729 TL=-10 TR=-10 VL=0 VR=0 SFL=0 SFR=0 PL=0 PR=0 SL=0 SR=0 EN=0 ST=0 IL=0 IR=0 FL=0 FR=0 FAULT=0 FC=0
« L=-5755 R=-5729 TL=-10 TR=-10 VL=0 VR=0 SFL=0 SFR=0 PL=0 PR=0 SL=0 SR=0 EN=0 ST=0 IL=0 IR=0 FL=0 FR=0 FAULT=0 FC=0
« L=-5755 R=-5729 TL=-10 TR=-10 VL=0 VR=0 SFL=0 SFR=0 PL=0 PR=0 SL=0 SR=0 EN=0 ST=0 IL=0 IR=0 FL=0 FR=0 FAULT=0 FC=0
« L=-5755 R=-5729 TL=-10 TR=-10 VL=0 VR=0 SFL=0 SFR=0 PL=0 PR=0 SL=0 SR=0 EN=1 ST=1 IL=0 IR=0 FL=0 FR=0 FAULT=0 FC=0
« L=-5803 R=-5775 TL=-10 TR=-10 VL=-7 VR=-7 SFL=-6 SFR=-6 PL=-203 PR=-201 SL=0 SR=0 EN=1 ST=1 IL=0 IR=0 FL=0 FR=0 FAULT=0 FC=0
« L=-5868 R=-5842 TL=-10 TR=-10 VL=-6 VR=-7 SFL=-6 SFR=-6 PL=-240 PR=-241 SL=0 SR=0 EN=1 ST=1 IL=0 IR=0 FL=0 FR=0 FAULT=0 FC=0
« L=-5942 R=-5913 TL=-10 TR=-10 VL=-7 VR=-7 SFL=-7 SFR=-7 PL=-241 PR=-240 SL=0 SR=0 EN=1 ST=1 IL=0 IR=0 FL=0 FR=0 FAULT=0 FC=0
« L=-6021 R=-5991 TL=-10 TR=-10 VL=-8 VR=-8 SFL=-8 SFR=-8 PL=-236 PR=-236 SL=0 SR=0 EN=1 ST=1 IL=0 IR=0 FL=0 FR=0 FAULT=0 FC=0
« L=-6103 R=-6072 TL=-10 TR=-10 VL=-9 VR=-9 SFL=-8 SFR=-8 PL=-259 PR=-259 SL=0 SR=0 EN=1 ST=1 IL=0 IR=0 FL=0 FR=0 FAULT=0 FC=0
« L=-6189 R=-6157 TL=-10 TR=-10 VL=-9 VR=-9 SFL=-8 SFR=-8 PL=-279 PR=-279 SL=0 SR=0 EN=1 ST=1 IL=0 IR=0 FL=0 FR=0 FAULT=0 FC=0
« L=-6278 R=-6247 TL=-10 TR=-10 VL=-9 VR=-8 SFL=-8 SFR=-8 PL=-295 PR=-294 SL=0 SR=0 EN=1 ST=1 IL=0 IR=0 FL=0 FR=0 FAULT=0 FC=0
« L=-6369 R=-6337 TL=-10 TR=-10 VL=-9 VR=-9 SFL=-8 SFR=-9 PL=-307 PR=-275 SL=0 SR=0 EN=1 ST=1 IL=0 IR=0 FL=0 FR=0 FAULT=0 FC=0
« L=-6462 R=-6428 TL=-10 TR=-10 VL=-10 VR=-9 SFL=-9 SFR=-9 PL=-285 PR=-285 SL=0 SR=0 EN=1 ST=1 IL=0 IR=0 FL=0 FR=0 FAULT=0 FC=0
« L=-6557 R=-6523 TL=-10 TR=-10 VL=-10 VR=-9 SFL=-9 SFR=-9 PL=-295 PR=-295 SL=0 SR=0 EN=1 ST=1 IL=0 IR=0 FL=0 FR=0 FAULT=0 FC=0
« L=-6655 R=-6620 TL=-10 TR=-10 VL=-10 VR=-10 SFL=-10 SFR=-9 PL=-271 PR=-304 SL=0 SR=0 EN=1 ST=1 IL=0 IR=0 FL=0 FR=0 FAULT=0 FC=0
« L=-6754 R=-6719 TL=-10 TR=-10 VL=-10 VR=-10 SFL=-9 SFR=-9 PL=-311 PR=-310 SL=0 SR=0 EN=1 ST=1 IL=0 IR=0 FL=0 FR=0 FAULT=0 FC=0
« L=-6853 R=-6817 TL=-10 TR=-10 VL=-10 VR=-10 SFL=-10 SFR=-9 PL=-283 PR=-316 SL=0 SR=0 EN=1 ST=1 IL=0 IR=0 FL=0 FR=0 FAULT=0 FC=0
« L=-6953 R=-6917 TL=-10 TR=-10 VL=-10 VR=-10 SFL=-10 SFR=-9 PL=-287 PR=-321 SL=0 SR=0 EN=1 ST=1 IL=0 IR=0 FL=0 FR=0 FAULT=0 FC=0
« L=-7053 R=-7017 TL=-10 TR=-10 VL=-10 VR=-10 SFL=-10 SFR=-9 PL=-290 PR=-324 SL=0 SR=0 EN=1 ST=1 IL=0 IR=0 FL=0 FR=0 FAULT=0 FC=0
« L=-7154 R=-7118 TL=-10 TR=-10 VL=-10 VR=-10 SFL=-10 SFR=-9 PL=-293 PR=-326 SL=0 SR=0 EN=1 ST=1 IL=0 IR=0 FL=0 FR=0 FAULT=0 FC=0
« L=-7254 R=-7218 TL=-10 TR=-10 VL=-10 VR=-10 SFL=-10 SFR=-10 PL=-294 PR=-295 SL=0 SR=0 EN=1 ST=1 IL=0 IR=0 FL=0 FR=0 FAULT=0 FC=0
« L=-7354 R=-7319 TL=-10 TR=-10 VL=-10 VR=-10 SFL=-10 SFR=-10 PL=-295 PR=-297 SL=0 SR=0 EN=1 ST=1 IL=0 IR=0 FL=0 FR=0 FAULT=0 FC=0
« L=-7454 R=-7418 TL=-10 TR=-10 VL=-10 VR=-10 SFL=-9 SFR=-10 PL=-330 PR=-297 SL=0 SR=0 EN=1 ST=1 IL=0 IR=0 FL=0 FR=0 FAULT=0 FC=0
« L=-7556 R=-7520 TL=-10 TR=-10 VL=-10 VR=-10 SFL=-10 SFR=-10 PL=0 PR=0 SL=0 SR=0 EN=0 ST=0 IL=0 IR=0 FL=0 FR=0 FAULT=0 FC=0
« L=-7637 R=-7599 TL=-10 TR=-10 VL=-7 VR=-6 SFL=-7 SFR=-7 PL=0 PR=0 SL=0 SR=0 EN=0 ST=0 IL=0 IR=0 FL=0 FR=0 FAULT=0 FC=0
« L=-7682 R=-7639 TL=-10 TR=-10 VL=-3 VR=-3 SFL=-3 SFR=-3 PL=0 PR=0 SL=0 SR=0 EN=0 ST=0 IL=0 IR=0 FL=0 FR=0 FAULT=0 FC=0
« L=-7687 R=-7645 TL=-10 TR=-10 VL=1 VR=0 SFL=0 SFR=0 PL=0 PR=0 SL=0 SR=0 EN=0 ST=0 IL=0 IR=0 FL=0 FR=0 FAULT=0 FC=0
« L=-7687 R=-7644 TL=-10 TR=-10 VL=0 VR=0 SFL=0 SFR=0 PL=0 PR=0 SL=0 SR=0 EN=0 ST=0 IL=0 IR=0 FL=0 FR=0 FAULT=0 FC=0
« L=-7687 R=-7644 TL=-10 TR=-10 VL=0 VR=0 SFL=0 SFR=0 PL=0 PR=0 SL=0 SR=0 EN=0 ST=0 IL=0 IR=0 FL=0 FR=0 FAULT=0 FC=0
« L=-7687 R=-7644 TL=-10 TR=-10 VL=0 VR=0 SFL=0 SFR=0 PL=0 PR=0 SL=0 SR=0 EN=0 ST=0 IL=0 IR=0 FL=0 FR=0 FAULT=0 FC=0
« L=-7687 R=-7644 TL=-10 TR=-10 VL=0 VR=0 SFL=0 SFR=0 PL=0 PR=0 SL=0 SR=0 EN=0 ST=0 IL=0 IR=0 FL=0 FR=0 FAULT=0 FC=0
« L=-7687 R=-7644 TL=-10 TR=-10 VL=0 VR=0 SFL=0 SFR=0 PL=0 PR=0 SL=0 SR=0 EN=0 ST=0 IL=0 IR=0 FL=0 FR=0 FAULT=0 FC=0
« L=-7687 R=-7644 TL=-10 TR=-10 VL=0 VR=0 SFL=0 SFR=0 PL=0 PR=0 SL=0 SR=0 EN=0 ST=0 IL=0 IR=0 FL=0 FR=0 FAULT=0 FC=0
« L=-7713 R=-7670 TL=-10 TR=-10 VL=-6 VR=-6 SFL=-4 SFR=-4 PL=-252 PR=-252 SL=0 SR=0 EN=1 ST=1 IL=0 IR=0 FL=0 FR=0 FAULT=0 FC=0
« L=-7780 R=-7737 TL=-10 TR=-10 VL=-7 VR=-7 SFL=-6 SFR=-6 PL=-228 PR=-229 SL=0 SR=0 EN=1 ST=1 IL=0 IR=0 FL=0 FR=0 FAULT=0 FC=0
« L=-7851 R=-7807 TL=-10 TR=-10 VL=-7 VR=-7 SFL=-7 SFR=-7 PL=-231 PR=-231 SL=0 SR=0 EN=1 ST=1 IL=0 IR=0 FL=0 FR=0 FAULT=0 FC=0
« L=-7928 R=-7882 TL=-10 TR=-10 VL=-8 VR=-8 SFL=-7 SFR=-7 PL=-261 PR=-261 SL=0 SR=0 EN=1 ST=1 IL=0 IR=0 FL=0 FR=0 FAULT=0 FC=0
« L=-8007 R=-7963 TL=-10 TR=-10 VL=-7 VR=-9 SFL=-7 SFR=-8 PL=-283 PR=-254 SL=0 SR=0 EN=1 ST=1 IL=0 IR=0 FL=0 FR=0 FAULT=0 FC=0
« L=-8093 R=-8048 TL=-10 TR=-10 VL=-9 VR=-8 SFL=-8 SFR=-8 PL=-273 PR=-274 SL=0 SR=0 EN=1 ST=1 IL=0 IR=0 FL=0 FR=0 FAULT=0 FC=0
« L=-8181 R=-8137 TL=-10 TR=-10 VL=-9 VR=-9 SFL=-8 SFR=-9 PL=-290 PR=-258 SL=0 SR=0 EN=1 ST=1 IL=0 IR=0 FL=0 FR=0 FAULT=0 FC=0
« L=-8271 R=-8227 TL=-10 TR=-10 VL=-9 VR=-9 SFL=-9 SFR=-9 PL=-270 PR=-272 SL=0 SR=0 EN=1 ST=1 IL=0 IR=0 FL=0 FR=0 FAULT=0 FC=0
« L=-8364 R=-8318 TL=-10 TR=-10 VL=-9 VR=-9 SFL=-9 SFR=-9 PL=-283 PR=-282 SL=0 SR=0 EN=1 ST=1 IL=0 IR=0 FL=0 FR=0 FAULT=0 FC=0
« L=-8459 R=-8411 TL=-10 TR=-10 VL=-10 VR=-9 SFL=-9 SFR=-9 PL=-293 PR=-292 SL=0 SR=0 EN=1 ST=1 IL=0 IR=0 FL=0 FR=0 FAULT=0 FC=0
« L=-8557 R=-8508 TL=-10 TR=-10 VL=-10 VR=-10 SFL=-9 SFR=-10 PL=-302 PR=-269 SL=0 SR=0 EN=1 ST=1 IL=0 IR=0 FL=0 FR=0 FAULT=0 FC=0
« L=-8655 R=-8607 TL=-10 TR=-10 VL=-10 VR=-10 SFL=-9 SFR=-10 PL=-309 PR=-277 SL=0 SR=0 EN=1 ST=1 IL=0 IR=0 FL=0 FR=0 FAULT=0 FC=0
« L=-8754 R=-8706 TL=-10 TR=-10 VL=-10 VR=-11 SFL=-9 SFR=-10 PL=-314 PR=-283 SL=0 SR=0 EN=1 ST=1 IL=0 IR=0 FL=0 FR=0 FAULT=0 FC=0
« L=-8854 R=-8805 TL=-10 TR=-10 VL=-10 VR=-10 SFL=-10 SFR=-10 PL=-286 PR=-286 SL=0 SR=0 EN=1 ST=1 IL=0 IR=0 FL=0 FR=0 FAULT=0 FC=0
« L=-8953 R=-8905 TL=-10 TR=-10 VL=-10 VR=-11 SFL=-10 SFR=-10 PL=-288 PR=-290 SL=0 SR=0 EN=1 ST=1 IL=0 IR=0 FL=0 FR=0 FAULT=0 FC=0
« L=-9053 R=-9004 TL=-10 TR=-10 VL=-10 VR=-10 SFL=-10 SFR=-10 PL=-290 PR=-293 SL=0 SR=0 EN=1 ST=1 IL=0 IR=0 FL=0 FR=0 FAULT=0 FC=0
« L=-9155 R=-9104 TL=-10 TR=-10 VL=-10 VR=-10 SFL=-10 SFR=-10 PL=-293 PR=-295 SL=0 SR=0 EN=1 ST=1 IL=0 IR=0 FL=0 FR=0 FAULT=0 FC=0
« L=-9255 R=-9204 TL=-10 TR=-10 VL=-10 VR=-10 SFL=-10 SFR=-10 PL=-295 PR=-297 SL=0 SR=0 EN=1 ST=1 IL=0 IR=0 FL=0 FR=0 FAULT=0 FC=0
« L=-9356 R=-9305 TL=-10 TR=-10 VL=-10 VR=-10 SFL=-10 SFR=-10 PL=-296 PR=-298 SL=0 SR=0 EN=1 ST=1 IL=0 IR=0 FL=0 FR=0 FAULT=0 FC=0
« L=-9456 R=-9405 TL=-10 TR=-10 VL=-10 VR=-10 SFL=-10 SFR=-10 PL=-296 PR=-299 SL=0 SR=0 EN=1 ST=1 IL=0 IR=0 FL=0 FR=0 FAULT=0 FC=0
« L=-9546 R=-9494 TL=-10 TR=-10 VL=-7 VR=-8 SFL=-8 SFR=-8 PL=0 PR=0 SL=0 SR=0 EN=0 ST=0 IL=0 IR=0 FL=0 FR=0 FAULT=0 FC=0
« L=-9599 R=-9544 TL=-10 TR=-10 VL=-4 VR=-3 SFL=-4 SFR=-4 PL=0 PR=0 SL=0 SR=0 EN=0 ST=0 IL=0 IR=0 FL=0 FR=0 FAULT=0 FC=0
« L=-9618 R=-9557 TL=-10 TR=-10 VL=-1 VR=0 SFL=-1 SFR=0 PL=0 PR=0 SL=0 SR=0 EN=0 ST=0 IL=0 IR=0 FL=0 FR=0 FAULT=0 FC=0
« L=-9620 R=-9561 TL=-10 TR=-10 VL=0 VR=0 SFL=0 SFR=0 PL=0 PR=0 SL=0 SR=0 EN=0 ST=0 IL=0 IR=0 FL=0 FR=0 FAULT=0 FC=0
« L=-9620 R=-9561 TL=-10 TR=-10 VL=0 VR=0 SFL=0 SFR=0 PL=0 PR=0 SL=0 SR=0 EN=0 ST=0 IL=0 IR=0 FL=0 FR=0 FAULT=0 FC=0
« L=-9620 R=-9561 TL=-10 TR=-10 VL=0 VR=0 SFL=0 SFR=0 PL=0 PR=0 SL=0 SR=0 EN=0 ST=0 IL=0 IR=0 FL=0 FR=0 FAULT=0 FC=0
« L=-9620 R=-9561 TL=-10 TR=-10 VL=0 VR=0 SFL=0 SFR=0 PL=0 PR=0 SL=0 SR=0 EN=0 ST=0 IL=0 IR=0 FL=0 FR=0 FAULT=0 FC=0
« L=-9620 R=-9561 TL=-10 TR=-10 VL=0 VR=0 SFL=0 SFR=0 PL=0 PR=0 SL=0 SR=0 EN=0 ST=0 IL=0 IR=0 FL=0 FR=0 FAULT=0 FC=0
« L=-9654 R=-9594 TL=-10 TR=-10 VL=-7 VR=-7 SFL=-6 SFR=-5 PL=-194 PR=-227 SL=0 SR=0 EN=1 ST=1 IL=0 IR=0 FL=0 FR=0 FAULT=0 FC=0
« L=-9720 R=-9659 TL=-10 TR=-10 VL=-6 VR=-6 SFL=-6 SFR=-6 PL=-232 PR=-232 SL=0 SR=0 EN=1 ST=1 IL=0 IR=0 FL=0 FR=0 FAULT=0 FC=0
« L=-9791 R=-9730 TL=-10 TR=-10 VL=-7 VR=-8 SFL=-7 SFR=-7 PL=-233 PR=-233 SL=0 SR=0 EN=1 ST=1 IL=0 IR=0 FL=0 FR=0 FAULT=0 FC=0
« L=-9867 R=-9805 TL=-10 TR=-10 VL=-8 VR=-7 SFL=-7 SFR=-7 PL=-263 PR=-263 SL=0 SR=0 EN=1 ST=1 IL=0 IR=0 FL=0 FR=0 FAULT=0 FC=0
« L=-9947 R=-9887 TL=-10 TR=-10 VL=-8 VR=-8 SFL=-8 SFR=-8 PL=-251 PR=-253 SL=0 SR=0 EN=1 ST=1 IL=0 IR=0 FL=0 FR=0 FAULT=0 FC=0
« L=-10030 R=-9970 TL=-10 TR=-10 VL=-8 VR=-8 SFL=-8 SFR=-8 PL=-271 PR=-273 SL=0 SR=0 EN=1 ST=1 IL=0 IR=0 FL=0 FR=0 FAULT=0 FC=0
« L=-10118 R=-10059 TL=-10 TR=-10 VL=-9 VR=-9 SFL=-8 SFR=-9 PL=-289 PR=-257 SL=0 SR=0 EN=1 ST=1 IL=0 IR=0 FL=0 FR=0 FAULT=0 FC=0
« L=-10209 R=-10149 TL=-10 TR=-10 VL=-9 VR=-9 SFL=-8 SFR=-9 PL=-303 PR=-271 SL=0 SR=0 EN=1 ST=1 IL=0 IR=0 FL=0 FR=0 FAULT=0 FC=0
« L=-10301 R=-10240 TL=-10 TR=-10 VL=-9 VR=-9 SFL=-9 SFR=-9 PL=-281 PR=-282 SL=0 SR=0 EN=1 ST=1 IL=0 IR=0 FL=0 FR=0 FAULT=0 FC=0
« L=-10396 R=-10333 TL=-10 TR=-10 VL=-9 VR=-9 SFL=-9 SFR=-9 PL=-291 PR=-292 SL=0 SR=0 EN=1 ST=1 IL=0 IR=0 FL=0 FR=0 FAULT=0 FC=0
« L=-10494 R=-10431 TL=-10 TR=-10 VL=-10 VR=-10 SFL=-10 SFR=-9 PL=-268 PR=-302 SL=0 SR=0 EN=1 ST=1 IL=0 IR=0 FL=0 FR=0 FAULT=0 FC=0
« L=-10593 R=-10529 TL=-10 TR=-10 VL=-11 VR=-10 SFL=-10 SFR=-10 PL=-276 PR=-277 SL=0 SR=0 EN=1 ST=1 IL=0 IR=0 FL=0 FR=0 FAULT=0 FC=0
« L=-10691 R=-10628 TL=-10 TR=-10 VL=-10 VR=-11 SFL=-9 SFR=-10 PL=-313 PR=-283 SL=0 SR=0 EN=1 ST=1 IL=0 IR=0 FL=0 FR=0 FAULT=0 FC=0
« L=-10790 R=-10728 TL=-10 TR=-10 VL=-10 VR=-10 SFL=-10 SFR=-10 PL=-283 PR=-287 SL=0 SR=0 EN=1 ST=1 IL=0 IR=0 FL=0 FR=0 FAULT=0 FC=0
« L=-10891 R=-10828 TL=-10 TR=-10 VL=-10 VR=-10 SFL=-10 SFR=-10 PL=-287 PR=-291 SL=0 SR=0 EN=1 ST=1 IL=0 IR=0 FL=0 FR=0 FAULT=0 FC=0
« L=-10992 R=-10927 TL=-10 TR=-10 VL=-10 VR=-10 SFL=-10 SFR=-9 PL=-291 PR=-326 SL=0 SR=0 EN=1 ST=1 IL=0 IR=0 FL=0 FR=0 FAULT=0 FC=0
« L=-11092 R=-11029 TL=-10 TR=-10 VL=-10 VR=-10 SFL=-10 SFR=-10 PL=-292 PR=-295 SL=0 SR=0 EN=1 ST=1 IL=0 IR=0 FL=0 FR=0 FAULT=0 FC=0
« L=-11192 R=-11129 TL=-10 TR=-10 VL=-10 VR=-10 SFL=-10 SFR=-9 PL=-295 PR=-329 SL=0 SR=0 EN=1 ST=1 IL=0 IR=0 FL=0 FR=0 FAULT=0 FC=0
« L=-11292 R=-11229 TL=-10 TR=-10 VL=-9 VR=-10 SFL=-9 SFR=-10 PL=-328 PR=-297 SL=0 SR=0 EN=1 ST=1 IL=0 IR=0 FL=0 FR=0 FAULT=0 FC=0
« L=-11394 R=-11328 TL=-10 TR=-10 VL=-10 VR=-10 SFL=-10 SFR=-9 PL=-297 PR=-331 SL=0 SR=0 EN=1 ST=1 IL=0 IR=0 FL=0 FR=0 FAULT=0 FC=0
« L=-11481 R=-11419 TL=-10 TR=-10 VL=-7 VR=-7 SFL=-8 SFR=-8 PL=0 PR=0 SL=0 SR=0 EN=0 ST=0 IL=0 IR=0 FL=0 FR=0 FAULT=0 FC=0
« L=-11531 R=-11470 TL=-10 TR=-10 VL=-4 VR=-3 SFL=-4 SFR=-4 PL=0 PR=0 SL=0 SR=0 EN=0 ST=0 IL=0 IR=0 FL=0 FR=0 FAULT=0 FC=0
« L=-11546 R=-11486 TL=-10 TR=-10 VL=0 VR=0 SFL=0 SFR=-1 PL=0 PR=0 SL=0 SR=0 EN=0 ST=0 IL=0 IR=0 FL=0 FR=0 FAULT=0 FC=0
« L=-11543 R=-11484 TL=-10 TR=-10 VL=0 VR=0 SFL=0 SFR=0 PL=0 PR=0 SL=0 SR=0 EN=0 ST=0 IL=0 IR=0 FL=0 FR=0 FAULT=0 FC=0
« L=-11543 R=-11484 TL=-10 TR=-10 VL=0 VR=0 SFL=0 SFR=0 PL=0 PR=0 SL=0 SR=0 EN=0 ST=0 IL=0 IR=0 FL=0 FR=0 FAULT=0 FC=0
« L=-11543 R=-11484 TL=-10 TR=-10 VL=0 VR=0 SFL=0 SFR=0 PL=0 PR=0 SL=0 SR=0 EN=0 ST=0 IL=0 IR=0 FL=0 FR=0 FAULT=0 FC=0
« L=-11543 R=-11484 TL=-10 TR=-10 VL=0 VR=0 SFL=0 SFR=0 PL=0 PR=0 SL=0 SR=0 EN=0 ST=0 IL=0 IR=0 FL=0 FR=0 FAULT=0 FC=0
« L=-11543 R=-11484 TL=-10 TR=-10 VL=0 VR=0 SFL=0 SFR=0 PL=0 PR=0 SL=0 SR=0 EN=0 ST=0 IL=0 IR=0 FL=0 FR=0 FAULT=0 FC=0
« L=-11543 R=-11484 TL=-10 TR=-10 VL=0 VR=0 SFL=0 SFR=0 PL=0 PR=0 SL=0 SR=0 EN=0 ST=0 IL=0 IR=0 FL=0 FR=0 FAULT=0 FC=0
« L=-11543 R=-11484 TL=-10 TR=-10 VL=0 VR=0 SFL=0 SFR=0 PL=0 PR=0 SL=0 SR=0 EN=0 ST=0 IL=0 IR=0 FL=0 FR=0 FAULT=0 FC=0
« L=-11584 R=-11523 TL=-10 TR=-10 VL=-7 VR=-7 SFL=-6 SFR=-6 PL=-197 PR=-197 SL=0 SR=0 EN=1 ST=1 IL=0 IR=0 FL=0 FR=0 FAULT=0 FC=0
« L=-11651 R=-11590 TL=-10 TR=-10 VL=-7 VR=-6 SFL=-6 SFR=-6 PL=-236 PR=-237 SL=0 SR=0 EN=1 ST=1 IL=0 IR=0 FL=0 FR=0 FAULT=0 FC=0
« L=-11723 R=-11662 TL=-10 TR=-10 VL=-8 VR=-7 SFL=-7 SFR=-7 PL=-236 PR=-237 SL=0 SR=0 EN=1 ST=1 IL=0 IR=0 FL=0 FR=0 FAULT=0 FC=0
« L=-11801 R=-11739 TL=-10 TR=-10 VL=-8 VR=-8 SFL=-7 SFR=-8 PL=-266 PR=-234 SL=0 SR=0 EN=1 ST=1 IL=0 IR=0 FL=0 FR=0 FAULT=0 FC=0
« L=-11881 R=-11819 TL=-10 TR=-10 VL=-8 VR=-8 SFL=-8 SFR=-8 PL=-254 PR=-256 SL=0 SR=0 EN=1 ST=1 IL=0 IR=0 FL=0 FR=0 FAULT=0 FC=0
« L=-11965 R=-11904 TL=-10 TR=-10 VL=-9 VR=-8 SFL=-8 SFR=-8 PL=-274 PR=-276 SL=0 SR=0 EN=1 ST=1 IL=0 IR=0 FL=0 FR=0 FAULT=0 FC=0
« L=-12054 R=-11993 TL=-10 TR=-10 VL=-9 VR=-9 SFL=-9 SFR=-9 PL=-258 PR=-260 SL=0 SR=0 EN=1 ST=1 IL=0 IR=0 FL=0 FR=0 FAULT=0 FC=0
« L=-12144 R=-12082 TL=-10 TR=-10 VL=-9 VR=-8 SFL=-9 SFR=-9 PL=-270 PR=-272 SL=0 SR=0 EN=1 ST=1 IL=0 IR=0 FL=0 FR=0 FAULT=0 FC=0
« L=-12234 R=-12175 TL=-10 TR=-10 VL=-9 VR=-9 SFL=-9 SFR=-9 PL=-280 PR=-284 SL=0 SR=0 EN=1 ST=1 IL=0 IR=0 FL=0 FR=0 FAULT=0 FC=0
« L=-12328 R=-12269 TL=-10 TR=-10 VL=-10 VR=-9 SFL=-9 SFR=-9 PL=-290 PR=-294 SL=0 SR=0 EN=1 ST=1 IL=0 IR=0 FL=0 FR=0 FAULT=0 FC=0
« L=-12425 R=-12367 TL=-10 TR=-10 VL=-9 VR=-9 SFL=-9 SFR=-9 PL=-300 PR=-303 SL=0 SR=0 EN=1 ST=1 IL=0 IR=0 FL=0 FR=0 FAULT=0 FC=0
« L=-12524 R=-12465 TL=-10 TR=-10 VL=-10 VR=-10 SFL=-9 SFR=-9 PL=-307 PR=-310 SL=0 SR=0 EN=1 ST=1 IL=0 IR=0 FL=0 FR=0 FAULT=0 FC=0
« L=-12623 R=-12565 TL=-10 TR=-10 VL=-10 VR=-10 SFL=-10 SFR=-9 PL=-279 PR=-315 SL=0 SR=0 EN=1 ST=1 IL=0 IR=0 FL=0 FR=0 FAULT=0 FC=0
« L=-12722 R=-12664 TL=-10 TR=-10 VL=-10 VR=-10 SFL=-10 SFR=-10 PL=-285 PR=-285 SL=0 SR=0 EN=1 ST=1 IL=0 IR=0 FL=0 FR=0 FAULT=0 FC=0
« L=-12822 R=-12764 TL=-10 TR=-10 VL=-10 VR=-10 SFL=-10 SFR=-10 PL=-289 PR=-289 SL=0 SR=0 EN=1 ST=1 IL=0 IR=0 FL=0 FR=0 FAULT=0 FC=0
« L=-12921 R=-12864 TL=-10 TR=-10 VL=-10 VR=-10 SFL=-9 SFR=-10 PL=-324 PR=-292 SL=0 SR=0 EN=1 ST=1 IL=0 IR=0 FL=0 FR=0 FAULT=0 FC=0
« L=-13023 R=-12965 TL=-10 TR=-10 VL=-10 VR=-11 SFL=-10 SFR=-10 PL=-293 PR=-295 SL=0 SR=0 EN=1 ST=1 IL=0 IR=0 FL=0 FR=0 FAULT=0 FC=0
« L=-13123 R=-13065 TL=-10 TR=-10 VL=-10 VR=-11 SFL=-9 SFR=-10 PL=-328 PR=-298 SL=0 SR=0 EN=1 ST=1 IL=0 IR=0 FL=0 FR=0 FAULT=0 FC=0
« L=-13225 R=-13167 TL=-10 TR=-10 VL=-10 VR=-10 SFL=-10 SFR=-10 PL=-296 PR=-298 SL=0 SR=0 EN=1 ST=1 IL=0 IR=0 FL=0 FR=0 FAULT=0 FC=0
« L=-13325 R=-13267 TL=-10 TR=-10 VL=-9 VR=-10 SFL=-9 SFR=-10 PL=-329 PR=-299 SL=0 SR=0 EN=1 ST=1 IL=0 IR=0 FL=0 FR=0 FAULT=0 FC=0
« L=-13407 R=-13347 TL=-10 TR=-10 VL=-7 VR=-6 SFL=-7 SFR=-7 PL=0 PR=0 SL=0 SR=0 EN=0 ST=0 IL=0 IR=0 FL=0 FR=0 FAULT=0 FC=0
« L=-13453 R=-13388 TL=-10 TR=-10 VL=-3 VR=-3 SFL=-3 SFR=-3 PL=0 PR=0 SL=0 SR=0 EN=0 ST=0 IL=0 IR=0 FL=0 FR=0 FAULT=0 FC=0
« L=-13460 R=-13390 TL=-10 TR=-10 VL=1 VR=0 SFL=0 SFR=0 PL=0 PR=0 SL=0 SR=0 EN=0 ST=0 IL=0 IR=0 FL=0 FR=0 FAULT=0 FC=0
« L=-13459 R=-13390 TL=-10 TR=-10 VL=0 VR=0 SFL=0 SFR=0 PL=0 PR=0 SL=0 SR=0 EN=0 ST=0 IL=0 IR=0 FL=0 FR=0 FAULT=0 FC=0
« L=-13459 R=-13390 TL=-10 TR=-10 VL=0 VR=0 SFL=0 SFR=0 PL=0 PR=0 SL=0 SR=0 EN=0 ST=0 IL=0 IR=0 FL=0 FR=0 FAULT=0 FC=0
« L=-13459 R=-13390 TL=-10 TR=-10 VL=0 VR=0 SFL=0 SFR=0 PL=0 PR=0 SL=0 SR=0 EN=0 ST=0 IL=0 IR=0 FL=0 FR=0 FAULT=0 FC=0
« L=-13459 R=-13390 TL=-10 TR=-10 VL=0 VR=0 SFL=0 SFR=0 PL=0 PR=0 SL=0 SR=0 EN=0 ST=0 IL=0 IR=0 FL=0 FR=0 FAULT=0 FC=0
« L=-13459 R=-13390 TL=-10 TR=-10 VL=0 VR=0 SFL=0 SFR=0 PL=0 PR=0 SL=0 SR=0 EN=0 ST=0 IL=0 IR=0 FL=0 FR=0 FAULT=0 FC=0
« L=-13459 R=-13390 TL=-10 TR=-10 VL=0 VR=0 SFL=0 SFR=0 PL=0 PR=0 SL=0 SR=0 EN=0 ST=0 IL=0 IR=0 FL=0 FR=0 FAULT=0 FC=0
« L=-13459 R=-13390 TL=-10 TR=-10 VL=0 VR=0 SFL=0 SFR=0 PL=0 PR=0 SL=0 SR=0 EN=0 ST=0 IL=0 IR=0 FL=0 FR=0 FAULT=0 FC=0
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
« L=-14204 R=-14135 TL=-10 TR=-10 VL=0 VR=0 SFL=0 SFR=0 PL=0 PR=0 SL=0 SR=0 EN=0 ST=0 IL=0 IR=0 FL=0 FR=0 FAULT=1 FC=7
« L=-14204 R=-14135 TL=-10 TR=-10 VL=0 VR=0 SFL=0 SFR=0 PL=0 PR=0 SL=0 SR=0 EN=0 ST=0 IL=0 IR=0 FL=0 FR=0 FAULT=1 FC=7
« L=0 R=0 TL=-10 TR=-10 VL=0 VR=0 SFL=0 SFR=0 PL=0 PR=0 SL=0 SR=0 EN=0 ST=0 IL=0 IR=0 FL=0 FR=0 FAULT=0 FC=0
« L=0 R=0 TL=-10 TR=-10 VL=0 VR=0 SFL=0 SFR=0 PL=0 PR=0 SL=0 SR=0 EN=0 ST=0 IL=0 IR=0 FL=0 FR=0 FAULT=0 FC=0
« L=0 R=0 TL=-10 TR=-10 VL=0 VR=0 SFL=0 SFR=0 PL=0 PR=0 SL=0 SR=0 EN=0 ST=0 IL=0 IR=0 FL=0 FR=0 FAULT=0 FC=0
« L=0 R=0 TL=-10 TR=-10 VL=0 VR=0 SFL=0 SFR=0 PL=0 PR=0 SL=0 SR=0 EN=0 ST=0 IL=0 IR=0 FL=0 FR=0 FAULT=0 FC=0
« L=0 R=0 TL=-10 TR=-10 VL=0 VR=0 SFL=0 SFR=0 PL=0 PR=0 SL=0 SR=0 EN=0 ST=0 IL=0 IR=0 FL=0 FR=0 FAULT=0 FC=0
« L=0 R=0 TL=-10 TR=-10 VL=0 VR=0 SFL=0 SFR=0 PL=0 PR=0 SL=0 SR=0 EN=0 ST=0 IL=0 IR=0 FL=0 FR=0 FAULT=0 FC=0
« L=0 R=0 TL=-10 TR=-10 VL=0 VR=0 SFL=0 SFR=0 PL=0 PR=0 SL=0 SR=0 EN=0 ST=0 IL=0 IR=0 FL=0 FR=0 FAULT=0 FC=0
« L=0 R=0 TL=-10 TR=-10 VL=0 VR=0 SFL=0 SFR=0 PL=0 PR=0 SL=0 SR=0 EN=1 ST=1 IL=0 IR=0 FL=0 FR=0 FAULT=0 FC=0
« L=-47 R=-47 TL=-10 TR=-10 VL=-7 VR=-6 SFL=-6 SFR=-6 PL=-201 PR=-201 SL=0 SR=0 EN=1 ST=1 IL=0 IR=0 FL=0 FR=0 FAULT=0 FC=0
« L=-115 R=-114 TL=-10 TR=-10 VL=-7 VR=-8 SFL=-6 SFR=-7 PL=-241 PR=-208 SL=0 SR=0 EN=1 ST=1 IL=0 IR=0 FL=0 FR=0 FAULT=0 FC=0
« L=-186 R=-186 TL=-10 TR=-10 VL=-8 VR=-7 SFL=-7 SFR=-7 PL=-239 PR=-239 SL=0 SR=0 EN=1 ST=1 IL=0 IR=0 FL=0 FR=0 FAULT=0 FC=0
« L=-263 R=-263 TL=-10 TR=-10 VL=-8 VR=-8 SFL=-8 SFR=-8 PL=-234 PR=-235 SL=0 SR=0 EN=1 ST=1 IL=0 IR=0 FL=0 FR=0 FAULT=0 FC=0
« L=-345 R=-344 TL=-10 TR=-10 VL=-8 VR=-8 SFL=-8 SFR=-8 PL=-257 PR=-258 SL=0 SR=0 EN=1 ST=1 IL=0 IR=0 FL=0 FR=0 FAULT=0 FC=0
« L=-431 R=-430 TL=-10 TR=-10 VL=-9 VR=-9 SFL=-8 SFR=-8 PL=-277 PR=-278 SL=0 SR=0 EN=1 ST=1 IL=0 IR=0 FL=0 FR=0 FAULT=0 FC=0
« L=-520 R=-520 TL=-10 TR=-10 VL=-9 VR=-8 SFL=-9 SFR=-9 PL=-260 PR=-262 SL=0 SR=0 EN=1 ST=1 IL=0 IR=0 FL=0 FR=0 FAULT=0 FC=0
« L=-611 R=-610 TL=-10 TR=-10 VL=-9 VR=-9 SFL=-9 SFR=-9 PL=-273 PR=-275 SL=0 SR=0 EN=1 ST=1 IL=0 IR=0 FL=0 FR=0 FAULT=0 FC=0
« L=-703 R=-703 TL=-10 TR=-10 VL=-9 VR=-10 SFL=-9 SFR=-9 PL=-283 PR=-285 SL=0 SR=0 EN=1 ST=1 IL=0 IR=0 FL=0 FR=0 FAULT=0 FC=0
« L=-797 R=-798 TL=-10 TR=-10 VL=-9 VR=-10 SFL=-9 SFR=-9 PL=-293 PR=-295 SL=0 SR=0 EN=1 ST=1 IL=0 IR=0 FL=0 FR=0 FAULT=0 FC=0
« L=-895 R=-895 TL=-10 TR=-10 VL=-10 VR=-9 SFL=-9 SFR=-9 PL=-302 PR=-303 SL=0 SR=0 EN=1 ST=1 IL=0 IR=0 FL=0 FR=0 FAULT=0 FC=0
« L=-994 R=-994 TL=-10 TR=-10 VL=-10 VR=-10 SFL=-10 SFR=-10 PL=-276 PR=-277 SL=0 SR=0 EN=1 ST=1 IL=0 IR=0 FL=0 FR=0 FAULT=0 FC=0
« L=-1092 R=-1093 TL=-10 TR=-10 VL=-10 VR=-10 SFL=-10 SFR=-10 PL=-280 PR=-283 SL=0 SR=0 EN=1 ST=1 IL=0 IR=0 FL=0 FR=0 FAULT=0 FC=0
« L=-1191 R=-1192 TL=-10 TR=-10 VL=-10 VR=-10 SFL=-10 SFR=-10 PL=-284 PR=-287 SL=0 SR=0 EN=1 ST=1 IL=0 IR=0 FL=0 FR=0 FAULT=0 FC=0
« L=-1292 R=-1292 TL=-10 TR=-10 VL=-10 VR=-10 SFL=-10 SFR=-10 PL=-288 PR=-290 SL=0 SR=0 EN=1 ST=1 IL=0 IR=0 FL=0 FR=0 FAULT=0 FC=0
« L=-1392 R=-1393 TL=-10 TR=-10 VL=-10 VR=-10 SFL=-10 SFR=-10 PL=-292 PR=-293 SL=0 SR=0 EN=1 ST=1 IL=0 IR=0 FL=0 FR=0 FAULT=0 FC=0
« L=-1491 R=-1493 TL=-10 TR=-10 VL=-10 VR=-10 SFL=-9 SFR=-10 PL=-326 PR=-296 SL=0 SR=0 EN=1 ST=1 IL=0 IR=0 FL=0 FR=0 FAULT=0 FC=0
« L=-1594 R=-1594 TL=-10 TR=-10 VL=-10 VR=-10 SFL=-10 SFR=-10 PL=-296 PR=-296 SL=0 SR=0 EN=1 ST=1 IL=0 IR=0 FL=0 FR=0 FAULT=0 FC=0
« L=-1694 R=-1694 TL=-10 TR=-10 VL=-10 VR=-10 SFL=-10 SFR=-10 PL=-296 PR=-297 SL=0 SR=0 EN=1 ST=1 IL=0 IR=0 FL=0 FR=0 FAULT=0 FC=0
« L=-1795 R=-1794 TL=-10 TR=-10 VL=-11 VR=-10 SFL=-10 SFR=-10 PL=0 PR=0 SL=0 SR=0 EN=0 ST=0 IL=0 IR=0 FL=0 FR=0 FAULT=0 FC=0
« L=-1875 R=-1874 TL=-10 TR=-10 VL=-6 VR=-6 SFL=-7 SFR=-7 PL=0 PR=0 SL=0 SR=0 EN=0 ST=0 IL=0 IR=0 FL=0 FR=0 FAULT=0 FC=0
« L=-1918 R=-1916 TL=-10 TR=-10 VL=-3 VR=-2 SFL=-3 SFR=-3 PL=0 PR=0 SL=0 SR=0 EN=0 ST=0 IL=0 IR=0 FL=0 FR=0 FAULT=0 FC=0
« L=-1924 R=-1926 TL=-10 TR=-10 VL=1 VR=-1 SFL=0 SFR=-1 PL=0 PR=0 SL=0 SR=0 EN=0 ST=0 IL=0 IR=0 FL=0 FR=0 FAULT=0 FC=0
« L=-1924 R=-1926 TL=-10 TR=-10 VL=0 VR=0 SFL=0 SFR=0 PL=0 PR=0 SL=0 SR=0 EN=0 ST=0 IL=0 IR=0 FL=0 FR=0 FAULT=0 FC=0
« L=-1924 R=-1926 TL=-10 TR=-10 VL=0 VR=0 SFL=0 SFR=0 PL=0 PR=0 SL=0 SR=0 EN=0 ST=0 IL=0 IR=0 FL=0 FR=0 FAULT=0 FC=0
« L=-1924 R=-1926 TL=-10 TR=-10 VL=0 VR=0 SFL=0 SFR=0 PL=0 PR=0 SL=0 SR=0 EN=0 ST=0 IL=0 IR=0 FL=0 FR=0 FAULT=0 FC=0
« L=-1924 R=-1926 TL=-10 TR=-10 VL=0 VR=0 SFL=0 SFR=0 PL=0 PR=0 SL=0 SR=0 EN=0 ST=0 IL=0 IR=0 FL=0 FR=0 FAULT=0 FC=0
« L=-1924 R=-1926 TL=-10 TR=-10 VL=0 VR=0 SFL=0 SFR=0 PL=0 PR=0 SL=0 SR=0 EN=0 ST=0 IL=0 IR=0 FL=0 FR=0 FAULT=0 FC=0
« L=-1924 R=-1926 TL=-10 TR=-10 VL=0 VR=0 SFL=0 SFR=0 PL=-200 PR=-200 SL=0 SR=0 EN=1 ST=1 IL=0 IR=0 FL=0 FR=0 FAULT=0 FC=0
« L=-1978 R=-1980 TL=-10 TR=-10 VL=-7 VR=-7 SFL=-6 SFR=-7 PL=-205 PR=-173 SL=0 SR=0 EN=1 ST=1 IL=0 IR=0 FL=0 FR=0 FAULT=0 FC=0
« L=-2047 R=-2045 TL=-10 TR=-10 VL=-7 VR=-7 SFL=-6 SFR=-6 PL=-245 PR=-244 SL=0 SR=0 EN=1 ST=1 IL=0 IR=0 FL=0 FR=0 FAULT=0 FC=0
« L=-2120 R=-2118 TL=-10 TR=-10 VL=-8 VR=-7 SFL=-7 SFR=-7 PL=-243 PR=-243 SL=0 SR=0 EN=1 ST=1 IL=0 IR=0 FL=0 FR=0 FAULT=0 FC=0
« L=-2199 R=-2195 TL=-10 TR=-10 VL=-8 VR=-7 SFL=-7 SFR=-7 PL=-271 PR=-270 SL=0 SR=0 EN=1 ST=1 IL=0 IR=0 FL=0 FR=0 FAULT=0 FC=0
« L=-2280 R=-2278 TL=-10 TR=-10 VL=-8 VR=-9 SFL=-8 SFR=-8 PL=-259 PR=-261 SL=0 SR=0 EN=1 ST=1 IL=0 IR=0 FL=0 FR=0 FAULT=0 FC=0
« L=-2366 R=-2364 TL=-10 TR=-10 VL=-9 VR=-9 SFL=-8 SFR=-8 PL=-279 PR=-281 SL=0 SR=0 EN=1 ST=1 IL=0 IR=0 FL=0 FR=0 FAULT=0 FC=0
« L=-2446 R=-2445 TL=-10 TR=-10 VL=-7 VR=-7 SFL=-7 SFR=-7 PL=0 PR=0 SL=0 SR=0 EN=0 ST=0 IL=2 IR=2 FL=1 FR=1 FAULT=1 FC=1
« L=-2490 R=-2490 TL=-10 TR=-10 VL=-3 VR=-3 SFL=-3 SFR=-3 PL=0 PR=0 SL=0 SR=0 EN=0 ST=0 IL=2 IR=2 FL=1 FR=1 FAULT=1 FC=7
« L=-2497 R=-2497 TL=-10 TR=-10 VL=1 VR=0 SFL=0 SFR=0 PL=0 PR=0 SL=0 SR=0 EN=0 ST=0 IL=2 IR=2 FL=1 FR=1 FAULT=1 FC=7
« L=-2496 R=-2496 TL=-10 TR=-10 VL=0 VR=0 SFL=0 SFR=0 PL=0 PR=0 SL=0 SR=0 EN=0 ST=0 IL=2 IR=2 FL=1 FR=1 FAULT=1 FC=7
« L=-2496 R=-2496 TL=-10 TR=-10 VL=0 VR=0 SFL=0 SFR=0 PL=0 PR=0 SL=0 SR=0 EN=0 ST=0 IL=2 IR=2 FL=1 FR=1 FAULT=1 FC=7
« L=-2496 R=-2496 TL=-10 TR=-10 VL=0 VR=0 SFL=0 SFR=0 PL=0 PR=0 SL=0 SR=0 EN=0 ST=0 IL=2 IR=2 FL=1 FR=1 FAULT=1 FC=7
« L=-2496 R=-2496 TL=-10 TR=-10 VL=0 VR=0 SFL=0 SFR=0 PL=0 PR=0 SL=0 SR=0 EN=0 ST=0 IL=2 IR=2 FL=1 FR=1 FAULT=1 FC=7
« L=-2496 R=-2496 TL=-10 TR=-10 VL=0 VR=0 SFL=0 SFR=0 PL=0 PR=0 SL=0 SR=0 EN=0 ST=0 IL=2 IR=2 FL=1 FR=1 FAULT=1 FC=7
« L=-2496 R=-2496 TL=-10 TR=-10 VL=0 VR=0 SFL=0 SFR=0 PL=0 PR=0 SL=0 SR=0 EN=0 ST=0 IL=2 IR=2 FL=1 FR=1 FAULT=1 FC=7
« L=-2496 R=-2496 TL=-10 TR=-10 VL=0 VR=0 SFL=0 SFR=0 PL=0 PR=0 SL=0 SR=0 EN=0 ST=0 IL=2 IR=2 FL=1 FR=1 FAULT=1 FC=7
« L=-2496 R=-2496 TL=-10 TR=-10 VL=0 VR=0 SFL=0 SFR=0 PL=0 PR=0 SL=0 SR=0 EN=0 ST=0 IL=2 IR=2 FL=1 FR=1 FAULT=1 FC=7
« L=-2496 R=-2496 TL=-10 TR=-10 VL=0 VR=0 SFL=0 SFR=0 PL=0 PR=0 SL=0 SR=0 EN=0 ST=0 IL=2 IR=2 FL=1 FR=1 FAULT=1 FC=7
« L=0 R=0 TL=-10 TR=-10 VL=0 VR=0 SFL=0 SFR=0 PL=0 PR=0 SL=0 SR=0 EN=0 ST=0 IL=0 IR=0 FL=0 FR=0 FAULT=0 FC=0
« L=0 R=0 TL=-10 TR=-10 VL=0 VR=0 SFL=0 SFR=0 PL=0 PR=0 SL=0 SR=0 EN=0 ST=0 IL=0 IR=0 FL=0 FR=0 FAULT=0 FC=0
« L=0 R=0 TL=-10 TR=-10 VL=0 VR=0 SFL=0 SFR=0 PL=0 PR=0 SL=0 SR=0 EN=0 ST=0 IL=0 IR=0 FL=0 FR=0 FAULT=0 FC=0
« L=0 R=0 TL=-10 TR=-10 VL=0 VR=0 SFL=0 SFR=0 PL=0 PR=0 SL=0 SR=0 EN=0 ST=0 IL=0 IR=0 FL=0 FR=0 FAULT=0 FC=0
« L=0 R=0 TL=-10 TR=-10 VL=0 VR=0 SFL=0 SFR=0 PL=-200 PR=-200 SL=0 SR=0 EN=1 ST=1 IL=0 IR=0 FL=0 FR=0 FAULT=0 FC=0
« L=-54 R=-54 TL=-10 TR=-10 VL=-7 VR=-6 SFL=-6 SFR=-6 PL=-205 PR=-205 SL=0 SR=0 EN=1 ST=1 IL=0 IR=0 FL=0 FR=0 FAULT=0 FC=0
« L=-121 R=-122 TL=-10 TR=-10 VL=-7 VR=-7 SFL=-6 SFR=-7 PL=-245 PR=-211 SL=0 SR=0 EN=1 ST=1 IL=0 IR=0 FL=0 FR=0 FAULT=0 FC=0
« L=-194 R=-194 TL=-10 TR=-10 VL=-7 VR=-8 SFL=-7 SFR=-7 PL=-243 PR=-244 SL=0 SR=0 EN=1 ST=1 IL=0 IR=0 FL=0 FR=0 FAULT=0 FC=0
« L=-273 R=-273 TL=-10 TR=-10 VL=-8 VR=-8 SFL=-8 SFR=-7 PL=-238 PR=-272 SL=0 SR=0 EN=1 ST=1 IL=0 IR=0 FL=0 FR=0 FAULT=0 FC=0
« L=-354 R=-355 TL=-10 TR=-10 VL=-9 VR=-9 SFL=-8 SFR=-8 PL=-260 PR=-260 SL=0 SR=0 EN=1 ST=1 IL=0 IR=0 FL=0 FR=0 FAULT=0 FC=0
« L=-440 R=-441 TL=-10 TR=-10 VL=-9 VR=-9 SFL=-8 SFR=-8 PL=-280 PR=-280 SL=0 SR=0 EN=1 ST=1 IL=0 IR=0 FL=0 FR=0 FAULT=0 FC=0
« L=-530 R=-530 TL=-10 TR=-10 VL=-9 VR=-9 SFL=-9 SFR=-8 PL=-263 PR=-295 SL=0 SR=0 EN=1 ST=1 IL=0 IR=0 FL=0 FR=0 FAULT=0 FC=0
« L=-620 R=-620 TL=-10 TR=-10 VL=-9 VR=-9 SFL=-9 SFR=-9 PL=-275 PR=-274 SL=0 SR=0 EN=1 ST=1 IL=0 IR=0 FL=0 FR=0 FAULT=0 FC=0
« L=-713 R=-711 TL=-10 TR=-10 VL=-9 VR=-9 SFL=-9 SFR=-9 PL=-285 PR=-284 SL=0 SR=0 EN=1 ST=1 IL=0 IR=0 FL=0 FR=0 FAULT=0 FC=0
« L=-809 R=-805 TL=-10 TR=-10 VL=-10 VR=-10 SFL=-9 SFR=-9 PL=-295 PR=-294 SL=0 SR=0 EN=1 ST=1 IL=0 IR=0 FL=0 FR=0 FAULT=0 FC=0
« L=-907 R=-903 TL=-10 TR=-10 VL=-10 VR=-10 SFL=-9 SFR=-9 PL=-303 PR=-303 SL=0 SR=0 EN=1 ST=1 IL=0 IR=0 FL=0 FR=0 FAULT=0 FC=0
« L=-1006 R=-1001 TL=-10 TR=-10 VL=-10 VR=-10 SFL=-10 SFR=-10 PL=-277 PR=-276 SL=0 SR=0 EN=1 ST=1 IL=0 IR=0 FL=0 FR=0 FAULT=0 FC=0
« L=-1105 R=-1101 TL=-10 TR=-10 VL=-10 VR=-10 SFL=-10 SFR=-10 PL=-281 PR=-283 SL=0 SR=0 EN=1 ST=1 IL=0 IR=0 FL=0 FR=0 FAULT=0 FC=0
« L=-1204 R=-1200 TL=-10 TR=-10 VL=-10 VR=-10 SFL=-10 SFR=-10 PL=-285 PR=-287 SL=0 SR=0 EN=1 ST=1 IL=0 IR=0 FL=0 FR=0 FAULT=0 FC=0
« L=-1304 R=-1299 TL=-10 TR=-10 VL=-10 VR=-10 SFL=-10 SFR=-10 PL=-289 PR=-291 SL=0 SR=0 EN=1 ST=1 IL=0 IR=0 FL=0 FR=0 FAULT=0 FC=0
« L=-1404 R=-1398 TL=-10 TR=-10 VL=-10 VR=-9 SFL=-10 SFR=-9 PL=-291 PR=-325 SL=0 SR=0 EN=1 ST=1 IL=0 IR=0 FL=0 FR=0 FAULT=0 FC=0
« L=-1504 R=-1499 TL=-10 TR=-10 VL=-10 VR=-10 SFL=-10 SFR=-10 PL=-293 PR=-294 SL=0 SR=0 EN=1 ST=1 IL=0 IR=0 FL=0 FR=0 FAULT=0 FC=0
« L=-1604 R=-1599 TL=-10 TR=-10 VL=-10 VR=-10 SFL=-10 SFR=-10 PL=-293 PR=-296 SL=0 SR=0 EN=1 ST=1 IL=0 IR=0 FL=0 FR=0 FAULT=0 FC=0
« L=-1704 R=-1699 TL=-10 TR=-10 VL=-10 VR=-10 SFL=-10 SFR=-10 PL=-295 PR=-298 SL=0 SR=0 EN=1 ST=1 IL=0 IR=0 FL=0 FR=0 FAULT=0 FC=0
« L=-1805 R=-1800 TL=-10 TR=-10 VL=-10 VR=-10 SFL=-10 SFR=-10 PL=0 PR=0 SL=0 SR=0 EN=0 ST=0 IL=0 IR=0 FL=0 FR=0 FAULT=0 FC=0
« L=-1879 R=-1874 TL=-10 TR=-10 VL=-6 VR=-6 SFL=-6 SFR=-6 PL=0 PR=0 SL=0 SR=0 EN=0 ST=0 IL=0 IR=0 FL=0 FR=0 FAULT=0 FC=0
« L=-1916 R=-1911 TL=-10 TR=-10 VL=-2 VR=-3 SFL=-2 SFR=-3 PL=0 PR=0 SL=0 SR=0 EN=0 ST=0 IL=0 IR=0 FL=0 FR=0 FAULT=0 FC=0
« L=-1915 R=-1916 TL=-10 TR=-10 VL=1 VR=0 SFL=1 SFR=0 PL=0 PR=0 SL=0 SR=0 EN=0 ST=0 IL=0 IR=0 FL=0 FR=0 FAULT=0 FC=0
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
« L=-1915 R=-1916 TL=-10 TR=-10 VL=0 VR=0 SFL=0 SFR=0 PL=0 PR=0 SL=0 SR=0 EN=0 ST=0 IL=0 IR=0 FL=0 FR=0 FAULT=0 FC=0
« L=-1915 R=-1916 TL=-10 TR=-10 VL=0 VR=0 SFL=0 SFR=0 PL=0 PR=0 SL=0 SR=0 EN=0 ST=0 IL=0 IR=0 FL=0 FR=0 FAULT=0 FC=0
