WeieeGRACE/Embodied_RPACS/tests/vl53l0x_three/records/2026-10-23_I2C_FIX_VALIDATION.md

# 三路测距 I²C 修复与板上闭环记录（2026-10-23）

正式交付见 [测试说明](../TEST_PROCEDURE.md) 与 [最终测试报告](../TEST_REPORT.md)。后续用户已反馈“测试已经通过”，本文件保留排查历史及原始证据。

## 当前结论

已完成代码修复、五套仿真、两次构建（含重新打开保存的 GPRJ）、SRAM 下载和 COM14 实测。用户纠正右侧接线后，改线后采集及重新下载启动后采集均为三路各 10/10 通信成功，共 60 条成功记录。全部 ID=EE、rev=10、rd=1F、valid=1、err=00，原始字节与串口解析值一致。三路通信及原始数据读取已恢复。距离仅为现有例程返回值，未验证光学准确度或完成完整初始化/校准；前/右仍可返回 20 mm，不能仅凭通信成功认定实际距离准确。

## 修复与回归

原 I²C 实现在拉低 SCL 的同一 FPGA 时钟边沿切换 SDA。新增传感器侧 SCL 上升延迟 80 ns、下降延迟 120 ns，以及 ACK/数据响应延迟 300 ns 的测试，原实现于 20.470 us 触发 SDA 保持时间断言；见 `2026-10-23_edges_before_fix.log`。

`tof_i2c_bits` 新增 SCL 下降后的 SDA 保持阶段；START、STOP 同样分开时钟和数据边沿。默认 HOLD=62 个 50 MHz 周期，包含在低电平周期内，保持名义 100 kHz。SCL 高电平仍等待实际输入上升，超过 10 ms 超时。SCL/SDA/XSHUT 仍仅输出 0/Z。

串口新增读取掩码 `rd`、12 字节原始数据 `raw`、故障阶段与电平 `dbg`、完成事件附近同步电平 `pad`。未读取内容显示横线。`check_board.py` 对照原始字节核对毫米值、计数、状态及掩码；`--require-all` 另外要求三路每次均通信成功。

| 回归 | 本次结果 | 日志 |
| --- | --- | --- |
| 时钟/数据路径偏差、保持时间、ID、12 字节读取 | PASS | `2026-10-23_fix_edges.log` |
| 地址/数据 NACK、连续读取、时钟拉伸、卡线、恢复 | PASS | `2026-10-23_fix_bus.log` |
| 三路调度、UART、轮询超时、缺失、复位、电机安全输出 | PASS | `2026-10-23_fix_three.log` |
| OLED 显存、WAIT、五位值、错误隐藏旧值、帧快照 | PASS | `2026-10-23_fix_oled.log` |
| 50 MHz 默认 1 ms 复位、20 ms 启动、I²C 周期 | PASS | `2026-10-23_fix_timing.log` |

五套均零错误。edges/bus 各有 2 条未连接新增诊断输出的端口警告，timing 有 4 条同类警告；这些测试未使用对应诊断输出。three/oled 无警告。

## 构建与实际下载

- Gowin V1.9.12，GW5A-LV25UG324C2/I1。主构建及保存工程重新打开构建均成功，见 `2026-10-23_fix_build.log`、`2026-10-23_fix_build_saved_project.log`。
- 检查最终 25 个管脚、固定 P6 映射、ASRPRO 保护约束及其他 11 份 CST；CPU/SSPI 普通 IO 配置均保留。GPIO1/T11 无内部上下拉；七路电机输出保持低。见 `2026-10-23_fix_report_check.txt`。
- 50 MHz 约束下 Fmax=78.789 MHz，setup/hold TNS=0。这是内部时序检查，不代表传感器外部模拟路径已被 STA 覆盖。
- 逻辑 5430/23040，寄存器 3461/23685。构建剩余 CV0016：保留输入 `imu_gnd_reserved` 未使用。
- 下载文件：`impl/pnr/vl53l0x_three.fs`，5,958,596 字节。
- SHA256：`acebb58b71c0c672788f3f9663c19748e6008fa195cc115be6ded134fc94fad7`。
- 实际通过 Programmer CLI operation 2 下载 SRAM（未烧写 Flash），见 `2026-10-23_final_download.log`。板上当前运行正常诊断程序，非临时电平探测程序。

## 板上排查历史

`2026-10-23_final_board.log` 保存 COM14、115200/8N1 的 30 行实测，前/左均 ID=EE、rev=10、pre=07、final=05、rd=1F、valid=1、err=00。原始数据与解析字段全部一致。例如前方 `raw=5F06BB00FFFF007D000A04AC`：距离 0x04AC=1196 mm、环境计数 125、信号计数 10、原始状态字段 0B。

右侧均 `dbg=1020 pad=1 rd=00`：写地址阶段等待 SCL 变高超时，故障采样 SCL/SDA 均低；没有取得任何诊断寄存器或结果数据。`2026-10-23_final_board_check.log` 中 `--require-all` 按预期失败，不能将原始字节一致性通过当作三路成功。

临时开漏探测程序曾验证：前/左释放总线时读到高，逐根拉低时正确响应；右侧即使 SCL/SDA 完全释放并将 XSHUT 拉低仍采样为低。见 `2026-10-23_probe_board.log`。该探测程序已被正常诊断程序替换。

用户随后反馈右侧六个引脚除 GND 外均测得 3.3 V。模块端测量与 FPGA 端采样存在差异。

用户已断电互换前/右模块，保持 P6 接线位置不变，再上电。重新下载相同 SHA256 的诊断位流后，`2026-10-23_swapped_board.log` 记录前/左各 6/6 成功、右侧 0/6，仍为 `err=03 dbg=1020 pad=1 rd=00`。原右侧模块在前方通道能读出 ID 与原始结果，故障留在右侧通道，未随模块移动。下载及严格检查记录为 `2026-10-23_swapped_download.log`、`2026-10-23_swapped_board_check.log`。

当时据此请求继续检查右侧线缆、P6 座子位置及板上通路，并断电用通断档检查模块 SCL 到 P6-17、模块 SDA 到 P6-18 是否分别导通且彼此不短路。排查期间未修改既定管脚，也未驱动传感器信号为高电平；后续处理结果见下一节。

## 右侧接线纠正后的最终验证

用户回复“刚刚接线错了，现在已经改好了”。保持既定 P6 管脚和相同位流，COM14 首次采集 `2026-10-23_rewired_board.log` 为前/左/右各 10/10 成功；随后重新 SRAM 下载，程序从 XSHUT 复位及启动流程开始，`2026-10-23_rewired_restart_board.log` 再次为三路各 10/10 成功。

`2026-10-23_rewired_restart_check.log` 的 `--require-all` 检查通过，三路均完成寄存器及 12 字节结果读取，字节序、距离、环境/信号计数及原始状态字段与 raw 一致。下载证据为 `2026-10-23_rewired_restart_download.log`，位流 SHA256 与上文一致。故障的两部分分别为已修复的 I²C SDA 保持时间，以及用户已纠正的右侧接线；不需要修改 P6 分配。

板上当前运行正常诊断位流，串口已释放。OLED 的位图、快照及错误页面由仿真验证；无实际屏幕图像证据。用户随后确认上板测试通过，未单独提供逐项人工记录或距离对照表。完整初始化/校准仍缺资料，定量光学准确度未证明，不将通信标志 `valid=1` 当作光学有效性结论。

本记录对应本次修复，旧 `2026-10-23_P6_VALIDATION.md` 是初次迁移的历史验证，不能代替本次板上结论。
