WeieeGRACE/Embodied_RPACS/src/imu/imu_attitude_oled.v

`timescale 1ns/1ps
// Four-line, 6x8 ASCII attitude display for the board's 128x64 OLED.
// Refreshes at approximately 5 Hz over the board's 250 kHz I2C link.
module imu_attitude_oled #(
    parameter integer CLK_HZ = 50000000,
    parameter integer I2C_HZ = 250000,
    parameter integer POWERUP_CYCLES = CLK_HZ / 10,
    parameter integer FRAME_WAIT_CYCLES = CLK_HZ * 7 / 50
)(
    input wire clk,
    input wire rst_n,
    input wire imu_ready,
    input wire imu_error,
    input wire calibrating,
    input wire attitude_valid,
    input wire signed [31:0] roll_mdeg,
    input wire signed [31:0] pitch_mdeg,
    input wire signed [31:0] yaw_mdeg,
    output wire scl,
    inout wire sda
);
    localparam [3:0] ST_POWERUP           = 4'd0,
                     ST_INIT_LAUNCH       = 4'd1,
                     ST_INIT_WAIT         = 4'd2,
                     ST_PAGE_COMMAND      = 4'd3,
                     ST_PAGE_COMMAND_WAIT = 4'd4,
                     ST_PIXEL_LAUNCH      = 4'd5,
                     ST_PIXEL_WAIT        = 4'd6,
                     ST_FRAME_WAIT        = 4'd7,
                     ST_PIXEL_PREPARE     = 4'd8;

    reg [3:0] state;
    reg [31:0] timer;
    reg [4:0] init_index;
    reg [2:0] page;
    reg [1:0] page_command_index;
    reg [6:0] column;
    reg clear_mode;
    reg byte_start;
    reg byte_data_mode;
    reg [7:0] byte_data;
    reg byte_data_mode_latched;
    reg [7:0] byte_data_latched;
    wire byte_busy;
    wire byte_done;
    wire byte_scl;
    reg [7:0] screen_code;
    reg display_ready, display_error, display_calibrating, display_valid;
    reg signed [31:0] display_roll, display_pitch, display_yaw;

    wire roll_negative, pitch_negative, yaw_negative;
    wire [3:0] roll_hundreds, roll_tens, roll_ones, roll_tenths;
    wire [3:0] pitch_hundreds, pitch_tens, pitch_ones, pitch_tenths;
    wire [3:0] yaw_hundreds, yaw_tens, yaw_ones, yaw_tenths;

    attitude_angle_to_digits roll_digits (
        .angle_mdeg(display_roll), .negative(roll_negative),
        .hundreds(roll_hundreds), .tens(roll_tens),
        .ones(roll_ones), .tenths(roll_tenths)
    );
    attitude_angle_to_digits pitch_digits (
        .angle_mdeg(display_pitch), .negative(pitch_negative),
        .hundreds(pitch_hundreds), .tens(pitch_tens),
        .ones(pitch_ones), .tenths(pitch_tenths)
    );
    attitude_angle_to_digits yaw_digits (
        .angle_mdeg(display_yaw), .negative(yaw_negative),
        .hundreds(yaw_hundreds), .tens(yaw_tens),
        .ones(yaw_ones), .tenths(yaw_tenths)
    );

    oled_i2c_write_byte #(.CLK_HZ(CLK_HZ), .I2C_HZ(I2C_HZ)) i2c_writer (
        .clk(clk), .rst_n(rst_n), .start(byte_start),
        .data_mode(byte_data_mode_latched), .data_in(byte_data_latched),
        .busy(byte_busy), .done(byte_done), .scl(byte_scl), .sda(sda)
    );
    assign scl = byte_scl;

    function [7:0] init_command;
        input [4:0] index;
        begin
            case (index)
                0: init_command = 8'hAE;
                1: init_command = 8'h00;
                2: init_command = 8'h10;
                3: init_command = 8'h40;
                4: init_command = 8'h81;
                5: init_command = 8'hCF;
                6: init_command = 8'hA1;
                7: init_command = 8'hC8;
                8: init_command = 8'hA6;
                9: init_command = 8'hA8;
                10: init_command = 8'h3F;
                11: init_command = 8'hD3;
                12: init_command = 8'h00;
                13: init_command = 8'hD5;
                14: init_command = 8'h80;
                15: init_command = 8'hD9;
                16: init_command = 8'hF1;
                17: init_command = 8'hDA;
                18: init_command = 8'h12;
                19: init_command = 8'hDB;
                20: init_command = 8'h30;
                21: init_command = 8'h20;
                22: init_command = 8'h02;
                23: init_command = 8'h8D;
                24: init_command = 8'h14;
                default: init_command = 8'hAF;
            endcase
        end
    endfunction

    function [7:0] screen_character;
        input [1:0] row;
        input [4:0] position;
        reg is_negative;
        reg [3:0] hundreds, tens, ones, tenths;
        begin
            is_negative = 0;
            hundreds = 0;
            tens = 0;
            ones = 0;
            tenths = 0;
            case (row)
                0: begin
                    if (!display_ready) begin
                        if (display_error) begin
                            case (position)
                                0: screen_character = "I";
                                1: screen_character = "M";
                                2: screen_character = "U";
                                3: screen_character = ":";
                                5: screen_character = "E";
                                6: screen_character = "R";
                                7: screen_character = "R";
                                8: screen_character = "O";
                                9: screen_character = "R";
                                default: screen_character = " ";
                            endcase
                        end else begin
                            case (position)
                                0: screen_character = "I";
                                1: screen_character = "M";
                                2: screen_character = "U";
                                3: screen_character = ":";
                                5: screen_character = "W";
                                6: screen_character = "A";
                                7: screen_character = "I";
                                8: screen_character = "T";
                                default: screen_character = " ";
                            endcase
                        end
                    end else if (display_calibrating) begin
                        case (position)
                            0: screen_character = "I";
                            1: screen_character = "M";
                            2: screen_character = "U";
                            3: screen_character = ":";
                            4: screen_character = "C";
                            5: screen_character = "A";
                            6: screen_character = "L";
                            7: screen_character = "I";
                            8: screen_character = "B";
                            9: screen_character = "R";
                            10: screen_character = "A";
                            11: screen_character = "T";
                            12: screen_character = "I";
                            13: screen_character = "N";
                            14: screen_character = "G";
                            default: screen_character = " ";
                        endcase
                    end else if (!display_valid) begin
                        case (position)
                            0: screen_character = "I";
                            1: screen_character = "M";
                            2: screen_character = "U";
                            3: screen_character = ":";
                            5: screen_character = "W";
                            6: screen_character = "A";
                            7: screen_character = "I";
                            8: screen_character = "T";
                            default: screen_character = " ";
                        endcase
                    end else begin
                        case (position)
                            0: screen_character = "I";
                            1: screen_character = "M";
                            2: screen_character = "U";
                            3: screen_character = ":";
                            5: screen_character = "R";
                            6: screen_character = "E";
                            7: screen_character = "A";
                            8: screen_character = "D";
                            9: screen_character = "Y";
                            default: screen_character = " ";
                        endcase
                    end
                end
                1: begin
                    is_negative = roll_negative;
                    hundreds = roll_hundreds;
                    tens = roll_tens;
                    ones = roll_ones;
                    tenths = roll_tenths;
                    case (position)
                        0: screen_character = "R";
                        1: screen_character = "O";
                        2: screen_character = "L";
                        3: screen_character = "L";
                        4: screen_character = ":";
                        5: screen_character = is_negative ? "-" : "+";
                        6: screen_character = 8'd48 + hundreds;
                        7: screen_character = 8'd48 + tens;
                        8: screen_character = 8'd48 + ones;
                        9: screen_character = ".";
                        10: screen_character = 8'd48 + tenths;
                        12: screen_character = "D";
                        13: screen_character = "E";
                        14: screen_character = "G";
                        default: screen_character = " ";
                    endcase
                end
                2: begin
                    is_negative = pitch_negative;
                    hundreds = pitch_hundreds;
                    tens = pitch_tens;
                    ones = pitch_ones;
                    tenths = pitch_tenths;
                    case (position)
                        0: screen_character = "P";
                        1: screen_character = "I";
                        2: screen_character = "T";
                        3: screen_character = "C";
                        4: screen_character = "H";
                        5: screen_character = ":";
                        6: screen_character = is_negative ? "-" : "+";
                        7: screen_character = 8'd48 + hundreds;
                        8: screen_character = 8'd48 + tens;
                        9: screen_character = 8'd48 + ones;
                        10: screen_character = ".";
                        11: screen_character = 8'd48 + tenths;
                        13: screen_character = "D";
                        14: screen_character = "E";
                        15: screen_character = "G";
                        default: screen_character = " ";
                    endcase
                end
                default: begin
                    is_negative = yaw_negative;
                    hundreds = yaw_hundreds;
                    tens = yaw_tens;
                    ones = yaw_ones;
                    tenths = yaw_tenths;
                    case (position)
                        0: screen_character = "Y";
                        1: screen_character = "A";
                        2: screen_character = "W";
                        3: screen_character = " ";
                        4: screen_character = "R";
                        5: screen_character = "E";
                        6: screen_character = "L";
                        7: screen_character = ":";
                        8: screen_character = is_negative ? "-" : "+";
                        9: screen_character = 8'd48 + hundreds;
                        10: screen_character = 8'd48 + tens;
                        11: screen_character = 8'd48 + ones;
                        12: screen_character = ".";
                        13: screen_character = 8'd48 + tenths;
                        15: screen_character = "D";
                        16: screen_character = "E";
                        17: screen_character = "G";
                        default: screen_character = " ";
                    endcase
                end
            endcase
        end
    endfunction

    // The required glyphs are the same 6-column ASCII table convention used
    // by the official example: six vertical bytes per character, LSB at top.
    function [47:0] font_glyph;
        input [7:0] character;
        begin
            case (character)
                "0": font_glyph = 48'h3E4549513E00;
                "1": font_glyph = 48'h00407F420000;
                "2": font_glyph = 48'h465149614200;
                "3": font_glyph = 48'h314B45412100;
                "4": font_glyph = 48'h107F12141800;
                "5": font_glyph = 48'h394545452700;
                "6": font_glyph = 48'h3049494A3C00;
                "7": font_glyph = 48'h030509710100;
                "8": font_glyph = 48'h364949493600;
                "9": font_glyph = 48'h1E2949490600;
                "A": font_glyph = 48'h7C1211127C00;
                "B": font_glyph = 48'h364949497F00;
                "C": font_glyph = 48'h224141413E00;
                "D": font_glyph = 48'h1C2241417F00;
                "E": font_glyph = 48'h414949497F00;
                "G": font_glyph = 48'h7A4949413E00;
                "H": font_glyph = 48'h7F0808087F00;
                "I": font_glyph = 48'h00417F410000;
                "L": font_glyph = 48'h404040407F00;
                "M": font_glyph = 48'h7F020C027F00;
                "N": font_glyph = 48'h7F1008047F00;
                "O": font_glyph = 48'h3E4141413E00;
                "P": font_glyph = 48'h060909097F00;
                "R": font_glyph = 48'h462919097F00;
                "T": font_glyph = 48'h01017F010100;
                "U": font_glyph = 48'h3F4040403F00;
                "W": font_glyph = 48'h3F4038403F00;
                "Y": font_glyph = 48'h070870080700;
                ":": font_glyph = 48'h000036360000;
                "+": font_glyph = 48'h08083E080800;
                "-": font_glyph = 48'h080808080800;
                ".": font_glyph = 48'h000060600000;
                default: font_glyph = 48'd0;
            endcase
        end
    endfunction

    function [7:0] font_column;
        input [7:0] character;
        input [2:0] glyph_column;
        reg [47:0] glyph;
        begin
            glyph = font_glyph(character);
            font_column = (glyph >> (glyph_column * 8)) & 8'h7F;
        end
    endfunction

    function [7:0] page_command;
        input [2:0] page_number;
        input [1:0] command_index;
        begin
            case (command_index)
                0: page_command = 8'hB0 | page_number;
                1: page_command = 8'h00;
                default: page_command = 8'h10;
            endcase
        end
    endfunction

    always @* begin
        byte_data_mode = 1'b0;
        byte_data = 8'h00;
        case (state)
            ST_INIT_LAUNCH: byte_data = init_command(init_index);
            ST_PAGE_COMMAND: byte_data = page_command(
                clear_mode ? page : {page[1:0],1'b0}, page_command_index);
            ST_PIXEL_LAUNCH: begin
                byte_data_mode = 1'b1;
                if (clear_mode) begin
                    byte_data = 0;
                end else if (column < 126) begin
                    byte_data = font_column(screen_code, column % 6);
                end else begin
                    byte_data = 0;
                end
            end
            default: begin end
        endcase
    end

    always @(posedge clk or negedge rst_n) begin
        if (!rst_n) begin
            state <= ST_POWERUP;
            timer <= 0;
            init_index <= 0;
            page <= 0;
            page_command_index <= 0;
            column <= 0;
            clear_mode <= 1'b1;
            byte_start <= 0;
            byte_data_mode_latched <= 0;
            byte_data_latched <= 0;
            screen_code <= " ";
            display_ready <= 0; display_error <= 0;
            display_calibrating <= 0; display_valid <= 0;
            display_roll <= 0; display_pitch <= 0; display_yaw <= 0;
        end else begin
            byte_start <= 0;
            case (state)
                ST_POWERUP: begin
                    if (timer >= POWERUP_CYCLES - 1) begin
                        timer <= 0;
                        init_index <= 0;
                        state <= ST_INIT_LAUNCH;
                    end else timer <= timer + 1'b1;
                end
                ST_INIT_LAUNCH: begin
                    byte_start <= 1;
                    byte_data_latched <= byte_data;
                    byte_data_mode_latched <= byte_data_mode;
                    state <= ST_INIT_WAIT;
                end
                ST_INIT_WAIT: begin
                    if (byte_done) begin
                        if (init_index == 25) begin
                            page <= 0;
                            page_command_index <= 0;
                            clear_mode <= 1'b1;
                            state <= ST_PAGE_COMMAND;
                        end else begin
                            init_index <= init_index + 1'b1;
                            state <= ST_INIT_LAUNCH;
                        end
                    end
                end
                ST_PAGE_COMMAND: begin
                    byte_start <= 1;
                    byte_data_latched <= byte_data;
                    byte_data_mode_latched <= byte_data_mode;
                    state <= ST_PAGE_COMMAND_WAIT;
                end
                ST_PAGE_COMMAND_WAIT: begin
                    if (byte_done) begin
                        if (page_command_index != 2) begin
                            page_command_index <= page_command_index + 1'b1;
                            state <= ST_PAGE_COMMAND;
                        end else begin
                            page_command_index <= 0;
                            column <= 0;
                            state <= ST_PIXEL_PREPARE;
                        end
                    end
                end
                // Separate signed decimal formatting from glyph lookup and I2C launch.
                ST_PIXEL_PREPARE: begin
                    screen_code <= screen_character(page, column / 6);
                    state <= ST_PIXEL_LAUNCH;
                end
                ST_PIXEL_LAUNCH: begin
                    byte_start <= 1;
                    byte_data_latched <= byte_data;
                    byte_data_mode_latched <= byte_data_mode;
                    state <= ST_PIXEL_WAIT;
                end
                ST_PIXEL_WAIT: begin
                    if (byte_done) begin
                        if (column == 127) begin
                            column <= 0;
                            if (clear_mode && page != 7) begin
                                page <= page + 1'b1;
                                page_command_index <= 0;
                                state <= ST_PAGE_COMMAND;
                            end else if (clear_mode) begin
                                clear_mode <= 1'b0;
                                display_ready <= imu_ready; display_error <= imu_error;
                                display_calibrating <= calibrating; display_valid <= attitude_valid;
                                display_roll <= roll_mdeg; display_pitch <= pitch_mdeg; display_yaw <= yaw_mdeg;
                                page <= 0;
                                page_command_index <= 0;
                                state <= ST_PAGE_COMMAND;
                            end else if (page != 3) begin
                                page <= page + 1'b1;
                                page_command_index <= 0;
                                state <= ST_PAGE_COMMAND;
                            end else begin
                                timer <= 0;
                                state <= ST_FRAME_WAIT;
                            end
                        end else begin
                            column <= column + 1'b1;
                            state <= ST_PIXEL_PREPARE;
                        end
                    end
                end
                ST_FRAME_WAIT: begin
                    if (timer >= FRAME_WAIT_CYCLES - 1) begin
                        display_ready <= imu_ready; display_error <= imu_error;
                        display_calibrating <= calibrating; display_valid <= attitude_valid;
                        display_roll <= roll_mdeg; display_pitch <= pitch_mdeg; display_yaw <= yaw_mdeg;
                        timer <= 0;
                        page <= 0;
                        page_command_index <= 0;
                        clear_mode <= 1'b0;
                        state <= ST_PAGE_COMMAND;
                    end else timer <= timer + 1'b1;
                end
                default: begin
                    state <= ST_POWERUP;
                    timer <= 0;
                end
            endcase
        end
    end
endmodule
