WeieeGRACE/Embodied_RPACS/tests/task4_navigation/impl/pnr/device.cfg

set JTAG regular_io = false
set SSPI regular_io = true
set MSPI regular_io = false
set READY regular_io = false
set DONE regular_io = false
set I2C regular_io = false
set CPU regular_io = true
set CRC_check = true
set compress = false
set encryption = false
set security_bit_enable = true
set bsram_init_fuse_print = true
set background_programming = off
set secure_mode = false
set program_done_bypass = false
set wake_up = 0
set format = binary
set power_on_reset_monitor = true
set seu_handler = false
set ext_cclk = false
set vccx = 3.3
set vcc = 0.9
set unused_pin = default
