WeieeGRACE/Embodied_RPACS/(commit log)

2026-10-18 Integrate chassis base control and validate event-only logging
    Unify IMU, dual-wheel closed-loop control, encoders and heartbeat watchdog in the main project with PIN_ASSIGNMENT constraints and latched safety interlocks.
    Add integration and logger simulations, preserve legacy regressions, archive timing/resource checks, and record user-confirmed operation after enabling A5 heartbeats. Test name: chassis base control integration and event logging validation.
2026-10-28 chore: baseline snapshot before main-project resource optimization
    - Continuous obstacle avoidance round: dispatch/K2/oled fixes with logs
    - Add independent task4 navigation test assets (RTL, sim, geometry tools, board build evidence)
    - Retire ov5647_camera standalone test project
    - ASRPRO firmware rebuild records
2026-10-28 feat(uart_bridge): freeze protocol v1 spec + host codec with self-tests
    - docs/PROTOCOL_v1.md: frame AA 55|TYPE|LEN|PAYLOAD|CRC16-CCITT|0D; message table
    (SET_VEL/STOP/HEARTBEAT/SET_LIMIT/CLEAR_FAULT vs TELEM/ACK); timing, fault bitmap,
    arbitration priority; CRC vectors V1..V5; UART binding + UDP-over-1GbE migration notes
    - tools/protocol.py: transport-agnostic codec (build/parse/telemetry/ack, streaming parser
    with the same error taxonomy as the RTL)
    - tools/protocol_selftest.py: 34 checks pass, prints CRC vectors for cross-checking RTL
    - .gitignore: allowlist tests/uart_bridge sources (main project untouched)
2026-10-28 feat(uart_bridge): RTL core (framing/decode/safety/telemetry) + 2 sim suites
    RTL (1066 Logic / 808 FF / 804 CLS on GW5A-25, 50 MHz, no timing warnings):
    - uart_rx_8n1.v oversampled 8N1 RX with frame error
    - crc16_ccitt.v CRC-16/CCITT-FALSE, bitwise unrolled (~40 LUT, no table)
    - host_frame_rx.v AA 55|TYPE|LEN|PAYLOAD|CRC16|0D framer, error taxonomy,
    inter-byte timeout, payload head + counters
    - host_cmd_decode.v SET_VEL/STOP/HEARTBEAT/SET_LIMIT/CLEAR_FAULT -> registers,
    ACK with status codes, limit clamp, latch stop
    - host_link_watchdog.v 200 ms heartbeat timeout, latched link loss
    - telem_builder.v 23-byte TELEM snapshot
    - frame_tx_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
2026-10-28 feat(uart_bridge): board-verified link v1 (bench 19/19, soak 30k frames 0 errors)
    Host tools:
    - tools/protocol.py: SET_VEL now carries uint8 seq (LEN 5) so cmd_seq in TELEM is meaningful
    - tools/transport.py: UART (pyserial) / UDP (1GbE-ready, same frame format) / file replay
    - tools/uart_link.py: ports/selftest/monitor/send/bench CLI, 10 Hz heartbeat thread,
    bench = 19 on-board acceptance checks
    - tools/soak_test.py: 600 s link soak, per-10s windows, error-rate summary
    - tools/uart_link.ps1: PowerShell front-end
    - run_sim.ps1 / run_build.ps1 / uart_bridge.gprj / README.md
    Protocol v1.1:
    - heartbeat 10 Hz recommended (5 Hz min), watchdog timeout 200 -> 300 ms (v1.0 had
    timeout == heartb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
2026-10-28 feat(uart_bridge): IMU variant - telemetry carries real roll/pitch/yaw
    - src/uart_bridge_imu_top.v: reuses the verified imu660ra_driver + imu_attitude_fixed
    (200 Hz, CORDIC/atan2/sqrt), converts millidegrees to 0.01 deg for TELEM
    - src/uart_bridge_imu_top.cst: IMU SPI pins as outputs, everything else identical
    - build_imu.tcl: second top, same project dir, output uart_bridge_imu
    - records: IMU bench 19/19 PASS, real attitude sample (pitch -3.6 deg, roll -1.15 deg,
    yaw drift ~0.004 deg/s), resource delta vs pure link:
    +4239 Logic / +2811 CLS / +4 BSRAM / +10 DSP (total 5305 / 3615 = 24% / 32%)
    - README + validation report updated with the variant table and evidence
    Note: the main proje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
2026-10-28 feat(uart_bridge): motion-side adapter + integration guide
    - src/host_link_motion_adapter.v: maps differential wheel speeds onto the existing
    motion sequencer command contract (FORWARD/BACKWARD/ROTATE/BRAKE), deduplicates
    repeated SET_VEL, drops commands while not ready (retried by the 20 Hz stream),
    issues exactly one BRAKE on latched stop / link loss, supports the future
    VELOCITY mode 10 behind USE_VELOCITY_MODE
    - sim/tb_motion_adapter.sv: 19 checks against a stub of the sequencer contract
    (mode/direction/magnitude, differential approximation counter, brake-once,
    block-while-stopped, resume, zero-speed brake)
    - docs/INTEGRATION_GUIDE.md: interface contract, two integration rout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
2026-10-28 feat(uart_bridge): resource-lite build (753 CLS, fits the main project)
    - uart_bridge_core/top gain two resource knobs (defaults unchanged):
    CNT_W (diagnostics counter width) and ENABLE_ACK (0 = no ACK frames)
    - src/uart_bridge_lite_top.v + build_lite.tcl: CNT_W=8, ENABLE_ACK=0
    - measured on GW5A-25: full 1066 Logic / 808 FF / 804 CLS -> lite 1004 / 747 / 753
    => the lite variant fits into the main project's remaining 792 CLS (39 spare),
    which unblocks integration without re-basing the project
    - lite build flashed and verified on the board: 110 TELEM, 0 ACK (by design),
    SET_VEL accepted (cmd_seq echo), STOP latch works, 0 CRC/sync errors
    - validation report section 7.1 documents th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
2026-10-28 test(uart_bridge): closed-loop system simulation (host -> link -> adapter -> plant)
    tb_system_closed_loop.sv drives the full chain over the real 115200 serial line:
    serial host -> uart_rx -> frame parser -> command decode -> safety -> motion adapter
    -> first-order wheel plant (lag + encoder integrator) -> encoders/speeds -> telemetry
    -> uart_tx -> serial host.
    Checks (9): link up after heartbeat+clear, telemetry received with valid CRC, cmd_seq
    echo, plant speed ramps to the commanded value, encoder counts increase, STOP sets the
    fault bit and drives speeds to zero, encoder never counts backwards.
    run_sim.ps1 now runs 5 suites: compile/core/loopback/adapter/system - all green.
2026-10-28 feat(uart_bridge): Orange Pi host example + docs refresh
    - tools/pi_host_example.py: minimal Pi-side client (--list / --monitor / --setvel),
    reuses the same protocol/transport/Link classes, defaults to read-only monitoring,
    documents pyserial install and dialout permissions
    - README: sim suite list (5 suites), tools list, IMU/lite variants
    - board re-flashed with the IMU variant so real attitude is available tomorrow
2026-10-28 test(uart_bridge): Python<->RTL conformance + hex capture decoder
    - tools/conformance.py: generates a 435-byte adversarial corpus (25 valid frames,
    broken CRCs, bad tails, over-long LEN, garbage, AA AA 55 overlap, trailing
    truncation), runs ModelSim, and diffs frames + error counters against protocol.py;
    '--run' does generate+simulate+compare in one command -> CONFORMANCE PASS
    (all 25 frames identical, counters equal)
    - sim/tb_conformance.sv + run_conformance.do: byte-corpus driver for host_frame_rx
    - protocol.py: parser now checks the tail byte before the CRC so the error taxonomy
    matches the RTL exactly (both counters identical now)
    - tools/decode_hex.py: decodes Fluent-Serial-As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
2026-10-28 docs(uart_bridge): overnight hand-over summary + IMU soak + UDP evidence
    - records/2026-10-29_夜间交付总结.md: one-page hand-over (what is on the board, what
    was delivered, all verification results, the two protocol defects that were fixed,
    1GbE readiness, resource verdict, morning quick-start commands, open items, commit
    list, known limitations)
    - records/..._validation.md: IMU-variant 600 s soak (30001 frames, 0 errors) and the
    UDP transport loopback result (200 datagrams -> 200 frames, 50 bad CRC rejected)
    - tools/udp_loopback_test.py: self-test proving the same frame codec works over UDP
    (Ethernet v2 transport layer is ready on the host side)
2026-10-28 test(uart_bridge): on-board robustness against corrupted frames and noise
    tools/board_robustness_test.py injects 50 CRC-broken SET_VEL frames and 2000 random
    bytes (including AA/55 sync patterns) into the real 115200 link, then sends a valid
    frame again. Board result: 6/6 PASS
    - corrupted SET_VEL never changes cmd_seq (nothing executes)
    - telemetry keeps streaming during the noise burst
    - a valid frame right after the noise is accepted immediately
    - link fault byte returns to 0x00
    records + validation report section 5.5 updated.
2026-10-28 docs(uart_bridge): pin map json + two broken doc references fixed
    - pins.json: 40-port pin map (mirrors the main project cst, marks motor/ToF pins as
    forced-inert) so integration does not need to re-derive the wiring
    - PROTOCOL_v1.md: the CRC vectors are checked in sim/tb_core.sv (tb_crc16.sv never
    existed)
    - INTEGRATION_GUIDE.md: the main-project regression script is tools/run_system_sim.ps1
2026-10-28 fix(uart_bridge): address independent review findings (estop, LEN checks, docs, tools)
    CRITICAL / safety:
    - uart_bridge_core: hardware E-stop (ext_fault[2]) was telemetry-only; it is now
    latched and part of safety_stop, forces target speed to 0, drives stop_latched_out,
    and only clears on CLEAR_FAULT while the link is healthy (5 new tb_core checks)
    - host_cmd_decode: length mismatches are rejected per spec - CLEAR_FAULT with a bad
    LEN no longer unlocks anything, HEARTBEAT replies ACK 0x04, STOP still stops
    (fail-safe) but replies ACK 0x04; protocol doc gains a per-command behaviour table
    - uart_bridge_core: expose setvel_strobe_out / estop_latched_out (integration guide
    told integr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
2026-10-28 perf: cut main project logic from 89% to 53% and raise Fmax to 66.7 MHz
    - Menu: drop MOTOR TEST entry and its debug actions (0x20-0x27) from
    menu/pages/dispatch/motion; main menu now DISPLAY/MANUAL/SETTINGS/OBSTACLE
    - asr_packet_tx: FIFO 64->16 entries (worst burst is 4; UART drains 1 per 6 bytes)
    - system_pages: one shared attitude digits pipeline (new result_valid handshake)
    and one shared signed-speed converter replace three+two copies
    - attitude_angle_to_digits_pipeline: sample input at start, pulse result_valid
    - imu_attitude_fixed: signed remainder = low 12 bits, drop 3 subtract networks
    - system_oled_text: font case table becomes a 768x8 BSRAM pROM (oled_font.hex,
    generated by t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
2026-10-28 fix(uart_bridge): restore watchdog clear path + final measurements on corrected build
    Regression caught a self-inflicted bug: while adding an explanatory comment to
    host_link_watchdog the 'if (clear_latched && link_ok) link_lost <= 1'b0;' line was
    accidentally replaced by the comment, so CLEAR_FAULT no longer cleared LINK_LOST
    (tb_core failed 7 checks). Restored and re-verified.
    Also in this batch:
    - host_cmd_decode: clamp_speed uses 17-bit intermediates (no truncation warning) and
    SET_LIMIT is clamped to MAX_LIMIT_MM_S=30000 so a hostile limit can never make the
    16-bit clamp wrap
    - uart_bridge_top: encoder-speed arithmetic saturates instead of truncating; the three
    EX3791 truncation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
2026-10-28 docs(uart_bridge): refresh integration numbers against the 02:06 main-project baseline
    The main project was optimized in parallel tonight (commit 09f2766: logic 89% -> 53%,
    CLS 92% -> 66%, Fmax 66.7 MHz). The current report is
    Logic 12036/23040 (53%), Register 5138 (22%), CLS 7525/11520 (66%)
    so the free budget is Logic 11004 / CLS 3995. The link (1154 Logic / 858 CLS) now fits
    with ~3137 CLS to spare and the 'lite' variant is no longer required (kept optional).
    Updated README, INTEGRATION_GUIDE, validation report and the hand-over summary with the
    new baseline and the progression (PLAN 792 -> 23:40 998 -> 02:06 3995 free CLS).
    The IMU variant was rebuilt after that upstream change and re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
2026-10-28 fix(uart_bridge): second-review fixes + full documentation/evidence consistency
    Code (latent paths flagged by the second review):
    - host_link_motion_adapter: avg/diff computed in 32-bit (a 16-bit sum could overflow
    when SET_LIMIT is raised), dedup now also watches the right-wheel speed so a
    VELOCITY-mode right-only change is not swallowed
    - host_cmd_decode: unsupported_cnt saturates like every other counter
    - uart_bridge_imu_top: saturating encoder-speed arithmetic (the last 2 EX3791 warnings)
    - tb_core: new regression for the int16-minimum clamp (-32768 -> -limit) => 52 checks
    - rebuild: full 1174 Logic / 844 FF / 881 CLS, lite 1110/782/830, imu 5430/2564/3671,
    all three with zero EX3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
2026-10-28 chore(uart_bridge): drop the cancelled 30-minute soak log (superseded by the final 600 s run)
2026-10-28 docs(uart_bridge): final evidence refresh (soak max 50.07 Hz, IMU bench 19/19, board left on the IMU variant)
2026-10-28 chore(uart_bridge): ignore python bytecode caches
2026-10-28 fix: green all seven suites and verified final bitstream on board
    - attitude pipeline: one idle cycle after completion so the consumer reloads
    the input before the restart; pages commit by att_conv (the channel whose
    value is inside the converter), fixing the one-cycle label skew that froze
    roll at +000.0
    - speed converter: sel_d pairs the routing decision with the registered
    output, fixing L/R text swap
    - oled font: single read driver (reset moved into the ROM read block) and
    corrected *4+*2 address arithmetic (was *8+*2, out of ROM range)
    - obstacle suite: navigate the 4-entry menu, skip the second panel K2,
    drop the mid-drive off() assertion, trace stop_hold sources, and re-en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
2026-10-29 feat(link_integration): new isolated test project for Orange Pi <-> FPGA link
    New folder tests/orangepi_link_integration/ (main project untouched, following the
    rule "test in a test folder first, port only after everything passes").
    Contents:
    - src/link_client.py heartbeat + telemetry collection + CSV (reuses
    tests/uart_bridge/tools as the single codec source)
    - src/preflight.py 7 on-board checks (port, open, telemetry, rate, errors,
    heartbeat age, fault byte) + pure analyze() for offline tests
    - src/camera_link_soak.py camera (Orbbec depth, 8 fps) + link (50 Hz) concurrent soak,
    with CPU s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
2026-10-29 fix(obstacle): make post-90-degree-turn transients recoverable, no spurious FAULT
    Root cause proven by ModelSim fault injection against the frozen pre-fix
    baseline (git 0bd1a77 / src==3556192, records/fault_injection/REPORT.md):
    1) after a rotation the route waited for ALL THREE ToF lanes to deliver a
    fresh non-20 sample; one lane stuck at exact 20 mm (or a valid <=85 mm
    side reading) latched route_fault reason 0x84 after 1000 ms
    2) one transient I2C NACK latched faults[0] immediately
    3) one 150 ms IMU health-error burst latched imu_bad immediately
    4) encoder counts during post-turn WAIT_STILL latched motion fault 5 after
    1000 ms
    Every one of them required a K0 reset - matching the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
2026-10-29 perf(ui): minimal obstacle-demo build 13257/58% (CLS 71%), Fmax 51.742 MHz
    Minimal demo configuration (user: use the least resources that still meets the
    obstacle-demo requirement from PROJECT_PLAN):
    - root menu now MANUAL / SETTINGS / OBSTACLE AVOID (3 items, no next-item
    preview row); DISPLAY 5-page diagnostics group and its formatting pipelines
    removed from src/ui/system_menu.v and src/ui/system_pages.v
    - the OBSTACLE panel keeps state/gear/three ranges and now shows fault
    diagnostics F/S/M/I16 bytes; MANUAL, SETTINGS, voice and USB logs retained
    - tof_page removed from build.tcl and the saved project (sources kept for the
    standalone history/regression project)
    - with no consumer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
2026-10-29 test(obstacle): final fixed-vs-baseline evidence on the trimmed build
    Re-ran all ten fault-injection scenarios against the final working-tree src
    (frozen 12:25, bitstream D3E91046) with a NEWMENU mapping for the 3-item menu:
    every scenario is fault_seen=0 / fault_latched=0 / fault_bits=0000 /
    fault_events=0. The five baseline latch paths stay closed:
    - exact-20 mm after a turn: no route_fault; barrier retries and passes 6-17
    DUT-ms after the injection ends; permanent 20 mm ends in BLOCKED/reason 0x85
    after four retries (auto_run=0, status=20, no fault prompt)
    - transient I2C NACK: channel recovers, route continues
    - 150 ms IMU error burst: IMU re-inits, rotation continues
    - encoder jitte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
2026-10-29 docs: note the pre-existing stale tb_speed_filter_modes legacy harness
    tools/run_legacy_regression.ps1 fails at sim/tb_speed_filter_modes.sv: that
    TB still asserts the pre-2026-10-26 speed-filter timing, while the module was
    re-pipelined before this round. Neither the module nor the TB was touched in
    this round (git diff 0bd1a77..HEAD for both is empty); it is not part of the
    seven main suites, build, pin/timing acceptance or the obstacle demo. Log and
    explanation added so the state is explicit instead of silently red.
2026-10-29 test: sync two stale legacy TBs and add a board verification helper
    The standalone legacy regressions had been red since before this round because
    two unit TBs lagged the RTL they test (module files untouched here):
    - tb_speed_filter_modes: the filter registers a completed window one cycle
    after the boundary since the 2026-10-26 prefetch change; the TB now drives
    pure 4-cycle windows and checks on the following edge.
    - tb_motion_control_and_mode_fsm: explicit connections for the runtime-speed /
    accepted / command-errors / feedback-ages ports, and assertions updated for
    the new semantics (lost feedback aborts instead of latching fault 2/3;
    standstill timeout completes with reason 7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
2026-10-29 test: one-command fault-injection regression (10/10 no-latch on final src)
    tools/run_fault_injection.ps1 compiles the current src/ into its own ModelSim
    library and runs the ten post-90-degree-turn scenarios (+FIXED=1 +NEWMENU=1),
    asserting each FIXED_RUN_OBSERVED line reports fault_seen=0/fault_latched=0.
    All ten pass on the final bitstream sources; XSHUT self-heal counters match
    (33/33/33 front, 33/33/33 side, 82/82/82 hold, 124/124/124 permanent, 3/3/3
    control), permanent-20mm ends in PAUSED/BLOCKED without a fault prompt.
    Logs in records/fault_injection/fixed_final_regression/, console evidence in
    records/robustness_20261029/fault_injection_regression_run.log. Added to the
    deliverable ex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
2026-10-29 feat(link_integration): first on-board run passed - camera + 50 Hz link coexist
    Board test (2026-10-29 13:17-13:23, Orange Pi AIpro, FPGA running uart_bridge_imu.fs):
    - preflight 7/7 PASS: port auto-detected via by-id (/dev/ttyACM0 - the CH9102 shows up
    as CDC-ACM on Linux, not ttyUSB0), 150 frames/3 s = 50.00 Hz, 0 parse errors,
    heartbeat age 95 ms, fault 0x20 (CMD_TIMEOUT, expected without SET_VEL)
    - link 30 s: 1500 frames, 50.00 Hz, frame interval 20.000 ms (jitter <=0.1 ms),
    0 errors, hb_age 12/52.7/94 ms, static attitude pitch -1.58 +-0.007, roll -1.54
    +-0.006, yaw drift 0.010 deg/s
    - camera + link soak 120 s: 9/9 PASS - Orbbec depth 963 frames @ 8.01 fps while the
    link staye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
2026-10-29 fix(encoder): tolerate isolated quadrature glitches at turn reversals; rebuild 64.469 MHz
    The 2026-10-14 real-board dual-reverse record shows IL=2 IR=2 FL=1 FR=1:
    a direction reversal coupled EMI spikes into A/B and one illegal quadrature
    transition permanently latched the demo. This is the same 'transient must not
    latch' class fixed in the ToF/IMU/router paths, so the decoder now has
    ILLEGAL_TOLERANCE/CLEAN_DECAY parameters: main project uses tolerance 5 with
    one hit leaking per 256 accepted steps (leaky bucket); isolated reversal
    glitches no longer kill the demo while repeated/persistent illegal jumps still
    latch. Default parameter 0 preserves the historical immediate-latch behaviour
    of th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
2026-10-29 feat(diag): serial route_reason/tof_reused + PAUSED panel row; board avoidance-run evidence
    Decode two new debug_state fields (route_reason at [55:48], tof_reused at [15:13]) and print R:/S/V/U on the obstacle PAUSED row so a board pause reports its cause without a cable. Add read_serial_log timestamp/incremental-write mode and analysis helpers. Store the 2026-10-29 board run evidence: 1 of 3 runs pauses at WAIT_PARALLEL with reason 0x85 (RIGHT lane stuck at exact-20 mm for >4 s), 2 runs complete the full detour and resume cruise in ~48 s.
2026-10-29 fix(obstacle): treat confirmed exact-20mm clips as delivered shots and add a fixed-mileage detour fallback
    Board evidence (records/robustness_20261029/BOARD_RUN_ANALYSIS.md): post-turn WAIT_PARALLEL starved for 4x1000ms on a RIGHT lane stuck at the VL53L0X minimum-range clamp, then PAUSED with reason 0x85; the XSHUT re-init self-heal was proven ineffective (dozens of re-inits in 4s). Two other runs with the deflected/latched bit set completed the full detour, so the failure is intermittent sensor clipping, not a dead state machine.
    Sensor layer: two consecutive exact-20mm samples are treated as a completed measurement that still refreshes the post-turn barrier (distances keep the last usabl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
2026-10-29 test(obstacle): verify the full fixed-mileage fallback detour; docs and board helper for WCH-Link wireless capture
    Scenario K (10) now keeps the obstacle-side lane clamped at 20 mm for the whole detour so SHIFT and PASS both use the fallback: FIXED_RUN_OBSERVED reports reached_shift=1 fallback_done=1, recovers to CRUISE (state 2) after 58.4 DUT-s with no fault and no PAUSED. The runner additionally requires fallback_done=1 for scenario 10; the TB watchdog is raised to 2.5 s so the full detour fits. All 11 scenarios pass and the bitstream is rebuilt (Logic 13521/59%, CLS 8318/73%, Fmax 59.226 MHz, SHA256 2E4FBB05...).
    board_obstacle_test.ps1: auto-detect the debug COM port (CH9102/FTDI/WCH-L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
2026-10-29 test(p6uart): diagnostic bitstream with debug UART on P6-21 for WCH-Link wireless capture
    The demo car cannot keep the onboard USB-UART Type-C tethered while moving. This variant builds the same fixed logic with only uart_tx moved from FPGA ball V8 (onboard CH9102F) to L12 (GPIO18, P6-21) so a WCH-Link RX wire on P6-21 plus GND on P6-12/P6-30 captures the 115200 debug log wirelessly. Build: Logic 13518/59%, CLS 8328/73%, BSRAM 9/56, SHA256 AF7FC649...; the main V8 bitstream and release deliverable are unchanged.
2026-10-29 docs: acceptance matrix + P6-21 wireless-serial variant notes
    Add records/robustness_20261029/FINAL_ACCEPTANCE.md mapping every original objective item to evidence and listing the remaining board steps; document the P6-21 (GPIO18/L12) diagnostic bitstream in the technical report and board test checklist so the WCH-Link wireless capture needs only RX->P6-21 and GND->P6-12/P6-30.
2026-10-29 feat(board): classify route vs user K2 pauses and support offline log analysis
    board_obstacle_test.ps1 now accepts -AnalyzeOnly -Capture to re-check an existing capture without hardware, reports the pre-pause route state/reason (e.g. state=17 reason=0x85) and splits genuine route pauses from operator K2 pauses; -FailOnPause only fails on route pauses. The WCH-Link COM24 flow is documented in OBSTACLE_BOARD_TEST.md.
2026-10-29 docs(board): note route-vs-user pause classification and AnalyzeOnly re-checks
2026-10-29 fix(obstacle): keep near ToF readings valid and unify the fallback
    - obstacle_sensors: valid = channel alive && fresh. Drop the leftover
    "distance > 85 mm" readiness mask (and the front_near_mm/NEAR_MM/
    SIDE_NEAR_MM plumbing). A real near reading is trustworthy geometry;
    masking it out cleared every lane after a turn, kept route ready=0 and
    therefore blocked all motion commands into PAUSED.
    - obstacle_route: side_unusable = side_clip || side_mm <= AVOID_MM now
    drives the fixed-mileage fallback in WAIT_PARALLEL / SAMPLE_SHIFT /
    WAIT_BACK, so clamp and genuinely-too-near share one recovery path.
    - sim/tb_fault_turns.sv: scenario 7 (60 mm on RIGHT after the turn)
    asserts near_shif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
2026-10-29 fix(tools,docs): preflight the Gowin target and require absolute bitstream paths
    - board_obstacle_test.ps1: run programmer_cli --scan before -Program and
    fail with a clear message when the FPGA is unpowered (FT2CH enumerates
    while the battery is flat); resolve --fsFile to an absolute path.
    - docs: explain that SRAM is lost on power cycle (re-flash every boot), that
    a flat battery shows up as 'No Gowin devices found', and update the manual
    programmer commands to use an absolute bitstream path.
    - keep the 18:47 scan log as evidence of the unpowered board.
2026-10-29 docs: record the user-confirmed post-acceptance removal of the USB event logger
    Keep system_event_logger (and the V8/U8 debug UART) through the pending 3-5
    board avoidance runs because the serial D/E lines are the acceptance evidence.
    After acceptance passes the user confirmed removal, so document the planned
    change set: drop the logger instance and debug_state wiring, remove uart_tx/
    uart_rx top-level ports and the .cst V8/U8 constraints (releasing both FPGA
    balls), lower check_system_reports pin expectation 44->42, rebuild (Logic
    about 56%, CLS about 69%) and sync PROJECT_PLAN.md section 16.4, PIN_ASSIGNMENT.md
    and records/resource_20261029/MINIMAL_PLAN.md.
2026-10-29 docs(resource): measure the post-acceptance logger removal on a throwaway variant
    The audit estimate of ~0.42k LUT was too high. Building the same sources with
    the system_event_logger instance dropped and the uart_tx/uart_rx ports and
    V8/U8 constraints removed gives: Logic 13364/23040 (58%), CLS 8197/11520
    (72%), Register 5497, BSRAM 9->5, Fmax 61.113 MHz, 0 violations and two fewer
    constrained IOBs (104->102). The main delivery bitstream is untouched; the
    temporary project lives in .tmp_nolog/ (git-ignored). Update PIN_ASSIGNMENT.md,
    TECHNICAL_REPORT.md, MINIMAL_PLAN.md, FINAL_ACCEPTANCE.md and the outer
    PROJECT_PLAN.md section 16.4 with the measured numbers instead of the estimate.
2026-10-29 feat(robot): add SPIN 360 action, IMU attitude page, and PASS clip fallback
    Contest requirements plus the 20:36 board failure: 3 of 5 runs stopped at PASS
    with route BLOCKED reason 0x04 because the obstacle-side ToF clipped to 20 mm
    after PASS had already started, so edge detection never fired.
    Features
    - src/asr/system_motion.v: manual action 0x14 spins right 360 deg
    (goal 360000 mdeg, 30 s payload timeout, reuses the rotate/reverse path).
    - src/ui/system_menu.v, src/ui/system_pages.v, src/robot_system_top.v:
    main menu gains an IMU ATTITUDE page (ROLL/PITCH/YAW from imu_attitude_fixed,
    with a CALIBRATING fallback line) and a SPIN 360 DEG entry under MOTION
    CONTROL; SYSTEM MOTION pa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
2026-10-29 feat(test): gigabit ethernet test kit + tolerant wireless debug decoder
    New isolated test project tests/eth_udp_link/ (main project untouched):
    - README: topology (Pi eth0 <-> FPGA RJ45, 1 Gbps), IP plan (Pi 192.168.0.1/24,
    FPGA 192.168.0.2:5000, MAC 00:0a:35:01:fe:c0), wiring, run steps, and the
    follow-up plan for moving the link protocol onto UDP (PROTOCOL §7)
    - vendor RGMII UDP loopback demo sources copied for reference/rebuild (the vendor
    prebuilt bitstream is recorded by SHA256: EDF44634...); note that Gowin EDA 1.9.12
    rejects the demo's PLL params (PFD 125 MHz > 87.5), so the prebuilt .fs is used
    - tools/udp_echo_test.py: Pi-side echo test with loss/RTT/jitter stats + JSON out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
2026-10-29 feat(link_integration): serial<->UDP relay (offline-verified)
    link_relay.py forwards frames between a serial link and UDP datagrams (one frame per
    datagram, matching the PROTOCOL v2 convention), keeps per-side counters, and supports a
    file transport for hardware-free testing. Verified offline: 20 synthetic telemetry
    frames replayed from a hex capture -> 20 UDP datagrams -> all decoded on the receive side.
    This is the bridge for FPGA --(serial)--> Pi --(1GbE UDP)--> PC once the ethernet path is
    up; also cleans up the dead-end one-way wireless variant files (the wireless module only
    wires FPGA TX, so the bidirectional link cannot run over it - the p6_uart_debug logger
    is its real use).
2026-10-29 feat(eth_udp_link): gigabit RGMII UDP path verified - vendor bitstream was ES-only
    Root cause of "FPGA sends nothing": the vendor prebuilt `eth_udp_loopback_rgmii.fs` was
    built with V1.9.9 Beta-2 for GW5A-LV25UG324**ES** (ES silicon). Its PLL parameters are
    illegal on our GW5A-25A C2/I1 part (PFD = FCLKIN/IDIV = 125 MHz, allowed 19..87.5 MHz), so
    the PLL never locks -> the whole design has no clock -> zero frames (Pi rx_packets stayed 0
    while tx grew normally).
    Fix: rebuild the untouched vendor RTL for our exact device with recomputed PLL parameters
    (IDIV_SEL=2, FBDIV_SEL=2, MDIV_SEL=7, ODIV0_SEL=7 => PFD 62.5 MHz, VCO 875 MHz, CLKOUT0
    125 MHz, PE 5/2 kept). The rebuilt bitstream works imme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
2026-10-29 feat(eth_link_protocol): link protocol v2 over gigabit UDP - code ready for board test
    New isolated test project tests/eth_link_protocol/ (main project untouched): the verified
    link protocol (framing/CRC/commands/safety/telemetry) now runs over the 1GbE RGMII path,
    one UDP datagram = one protocol frame (PROTOCOL v1 §7).
    RTL:
    - src/eth_link_bridge.v: UDP payload stream <-> protocol frames. RX: payload bytes ->
    1-byte-per-2-cycle pacing (satisfies host_frame_rx's inter-byte bubble) -> full frame
    parse -> uart_bridge_core. TX: core's frame bytes -> 128 B frame buffer -> tx_start/
    tx_len handshake with the vendor UDP TX engine (byte pull + done).
    - src/eth_link_top.v: vendor RGMII/UDP PH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
2026-10-29 chore(uart_bridge): refresh regression logs and rebuild evidence after the core change (tx_done_out, 32-bit ms_div)
2026-10-29 fix(eth_link_protocol): let the acceptance tool locate the protocol lib on the Pi
    _uart_tools resolution now tries: UART_BRIDGE_TOOLS env var, the repo layout, a uart_tools
    directory next to the script, ~/uart_tools and ./uart_tools. Deployed to the Pi
    (~/eth_link_test.py + ~/uart_tools/*.py) and verified there: 'tool import OK' with the
    camera venv and with system python3 (no pyserial needed for the UDP path), and a no-peer
    run fails cleanly with the 6 checks. README updated with the pi_setup_eth.sh step.
2026-10-29 fix(obstacle): debounce the detour front-lane close reading on the board evidence
    The 22:52-22:59 board capture (P6-21 diagnostic bitstream + WCH-Link COM24, 7 runs,
    2080 D snapshots, 0 E lines) showed 5 of 7 runs stopping in PASS with BLOCKED
    reason 0x04 (front ToF <= AVOID_MM). One run completed the full route, so the
    geometry is fine: the front lane sees the box corner for a few samples while the
    car passes it and the old single-sample decision treated that as a real obstacle.
    Per the user's direction the 300/300 mm reference-geometry shift distances are
    NOT increased; the bad data is filtered instead.
    - src/obstacle/obstacle_route.v: add FRONT_LEG_MS=400. Detour legs (SHIFT,
    SHIFT_EXT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
2026-10-29 test(diag): add a P6-21 distance-log variant for bad-data triage
    If the detour still stops on the board, the delivered P6 diagnostic firmware
    only shows route_state/tof_reused, which cannot distinguish a real close
    obstacle from a one-sample glitch. This variant swaps system_motion's D-line
    payload for the three accepted ToF distances while keeping the same top-level
    logic, cst and pin (uart_tx on P6-21/L12):
    - tests/p6_uart_debug/src/system_motion_dist.v: D = front[15:0], left[31:16],
    right[47:32], tof_reused[50:48], route_state[55:51], fault/auto/avoid above.
    - tests/p6_uart_debug/build_distance.tcl: same file list as build.tcl with the
    distance system_motion and output base Embodied_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
2026-10-29 docs(board): record the distance-log run that validates the front-graze filter
2026-10-29 test(board): archive the 2026-10-30 distance-log acceptance capture
2026-10-29 feat(build): drop the USB event logger and debug UART after board acceptance
    The user confirmed the 2026-10-30 board session ("基本没有问题了", then powered
    off): five complete avoidance cycles across three sessions, no fault latch and no
    PASS mis-stop; the only stop was a real 82 mm wall during SHIFT (safety stop).
    This executes the cleanup the user pre-approved on 2026-10-29.
    - robot_system_top.v: remove uart_rx/uart_tx and the system_event_logger
    instance plus the debug_state/debug_valid/event_errors wiring.
    - system_motion.v: remove the unused debug/event ports and assembly.
    - robot_system_top.cst: release V8/U8; check_system_reports.ps1 expects 42 pins.
    - build.tcl / gprj: sto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
2026-10-29 feat(test): ethernet link v2 tooling, wireless-serial debug path, motor-control bitstream
    Night work (car not moved; only no-motion tests were run or prepared).
    1. Ethernet link v2 validated on hardware (tests/eth_link_protocol):
    - tools/eth_link_test.py acceptance: 12/12 PASS (150 frames in 3 s = 50.00 Hz,
    0 parse errors, hb_age 50 ms, CLEAR/SET_VEL/STOP ACKs and seq echo correct).
    - tools/eth_soak.py: 60 s PASS (3001 frames, 50.01 Hz, 0 loss, 96.6% healthy);
    20 min soak launched.
    - tools/cam_eth_soak.py: camera + link concurrency 300 s PASS (depth camera
    2399 frames @ 8.0 fps, zero errors; link 15051 frames @ 50.17 Hz, 0 loss;
    CPU mean 4.9%), i.e. the camera d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
2026-10-29 docs(test): night report skeleton + ethernet integration guide
    - tests/eth_link_protocol/records/2026-10-30_夜间测试报告.md: what was tested overnight
    (car never moved), hardware state, per-test results, evidence index, and the summary of
    tomorrow's on-car tests.
    - tests/eth_link_protocol/docs/ETH_INTEGRATION_GUIDE.md: how to move the ethernet link and
    the motor bridge into the main project (modules, pins, clock-domain crossing, resource
    budget estimate: main 13518 logic + eth 1511 => ~67-70% logic, CLS ~84-87%), step list,
    the pitfalls we already hit (ES-only vendor bitstream, no ARP, latched LINK_LOST,
    16-bit ms_div at 125 MHz, single-frame TX buffer) and the post-port ve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
2026-10-29 test(night): complete no-motion test matrix on the ethernet link v2
    20-minute soak: 60006 frames, 50.004 Hz, 0.0% loss, max gap 55 ms, 0 parse errors,
    99.59% healthy frames, SET_VEL ACKs 192/192 OK, CPU mean 0.9%.
    Safety/fault semantics over UDP (eth_fault_test.py) 16/16: heartbeat loss latches
    LINK_LOST and SET_VEL returns REJECT_LINK_LOST; recovery needs CLEAR_FAULT; command
    timeout bit; STOP latches and returns REJECT_STOP_LATCHED until cleared; SET_LIMIT makes
    an over-limit SET_VEL return REJECT_OVER_LIMIT; CRC-corrupt frame and unknown type are
    ignored without disturbing telemetry; rate stays 50 Hz through all of it.
    Link bounce (eth_bounce_test.sh): a deliberate 3 s eth0 outage shows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
2026-10-29 test(night): network degradation, long wireless capture and debug-logger fix
    Network degradation (tc netem on the Pi's eth0):
    - constant 20 ms delay: 49.99 Hz, 0.02% loss, hb_age max 110 ms -> link stays up;
    - 20 ms delay + 2% loss: 50.01 Hz, hb_age max 230 ms -> still up;
    - constant 300 ms delay: hb_age stays ~110 ms because only the spacing matters, so no
    link loss (the earlier expectation was wrong and is now documented);
    - jitter 100 ms +/- 200 ms: hb_age reaches 397 ms -> LINK_LOST appears as designed
    (63 frames with bit 0x02, 431 with 0x22), i.e. the 300 ms heartbeat timeout really does
    catch jitter but tolerates pure latency.
    Wireless serial (P6-21/L12) long captures: 120 s ->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
2026-10-29 feat(eth_motion_test): safe drive helper for tomorrow's on-car test
    tools/eth_drive.py sends SET_VEL at 20 Hz (CMD_TIMEOUT is 500 ms), ramps up/down over a
    configurable time, and aborts with an immediate STOP if any SET_VEL is rejected, gets no
    ACK, or the telemetry reports a non-CMD_TIMEOUT fault bit. Ctrl-C also triggers STOP, speeds
    above 300 mm/s are refused, and the script always finishes with STOP + CLEAR_FAULT so the
    board is not left latched.
    Smoke-tested tonight on the motor-less protocol bitstream: link-up, 11-step ramp to
    100 mm/s, 2 s cruise, decel, STOP OK, CLEAR OK. Documented in TEST_PLAN_明日动车.md (section
    F) with the exact commands for the wheels-up and on-floor runs.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
2026-10-29 chore(test): rebuild the motion bitstream on the final sources, add reboot-recovery evidence
    - tests/eth_motion_test: rebuilt eth_motion_top.fs after the bridge gained its diagnostic
    ports (functionally identical for the motor path); new SHA256 AAC99B3B...CCBE3, docs
    updated, simulation still 15/15 PASS.
    - Pi reboot recovery verified: after systemctl reboot the eth0 address, 1 Gbps carrier,
    the static ARP (via the NetworkManager dispatcher hook) and the link itself all came back
    on their own within a minute; eth_link_test.py then reported 12/12 PASS. Tomorrow's power
    up needs no manual network setup.
    - Night report now documents that section; a 3-hour soak is running on the board.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
2026-10-29 docs(test): morning handover sheet - current hardware state, what passed overnight, tomorrow's exact commands and cautions
2026-10-29 test(night): 3-hour overnight soak on the ethernet link - 540050 frames, 0% loss
    02:26-05:26 (10800 s): 540050 telemetry frames = 50.004 Hz, 0.0% loss, frame gap max
    110 ms (p99 40.4), zero CRC/tail/len errors (one cold-start sync), hb_age max 170 ms,
    99.73% healthy frames (the rest are the deliberate 60 s STOP windows and short command
    timeouts), SET_VEL ACKs 192/192 OK, CLEAR 8/8 OK, CPU 0.8% mean. The window also covers a
    Pi reboot at 02:24, so link re-establishment after a host restart is included.
    Artifacts: records/2026-10-30_soak_overnight_3h.json and .csv (every 5 s sample).
    Night report and the morning handover sheet updated with these numbers.
2026-10-30 chore(diag): archive the P6-21 diagnostic projects with a full test report
    The delivered main firmware no longer has a debug UART (event logger and V8/U8
    were removed after the 2026-10-30 board acceptance), so the P6-21 diagnostic
    variants have no remaining use. Per the user's instruction they are kept as a
    repository archive instead of being deleted, with the missing test report
    written.
    - tests/p6_uart_debug/archive/: both delivered diagnostic bitstreams
    (normal log 08DFDED3..., distance log EE00D375...) plus SHA256SUMS.txt.
    - tests/p6_uart_debug/frozen_src/: pre-cleanup robot_system_top.v and
    system_motion.v snapshots taken from 8b04f7d, so the archived projects stay
    rebuildable ag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
2026-10-30 test(motion): complete motor-control simulation suite (66 checks, all passing)
    Added two new testbenches next to the original 15-check bridge test, so the whole
    "command -> PWM -> H-bridge" path is now covered without hardware:
    - sim/tb_motion_unit2.sv (24 checks): duty-vs-speed sweep over -300..+300 mm/s (tolerance
    +-2 ticks), PWM period exactly 6250 ticks, direction pins per sign, zero-command leaves
    duty 0 / direction pins low / STBY still on, direction-reversal dead time masks PWM and
    never asserts both in1 and in2 (continuous shoot-through monitor), over-speed clamp,
    differential drive, a full 16-combination truth table for motors_enabled, and every
    safety input (link lost /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
2026-10-30 test(bench): wheels-up motor bench suite on hardware - all green, report generated
    Ran with the car jacked up and the motor bitstream (eth_motion_top.fs) flashed:
    - link acceptance: 12/12 (50.00 Hz telemetry, ACK/seq echo, STOP fault bit)
    - safety/fault semantics: 16/16 on the motor firmware
    - bench motion matrix (bench_motion_test.py): 16/16 steps - forward 50/100/150/200/250/
    300 mm/s, backward 50/150, rotate both directions, differential, six rapid reversals
    (97 ACKs OK), STOP while driving (SET_VEL afterwards correctly REJECT_STOP_LATCHED),
    resume after CLEAR, heartbeat loss while driving (REJECT_LINK_LOST + LINK_LOST seen),
    and a 20 s sustained 200 mm/s run. Every step ramped i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
2026-10-30 feat(task4): hard wheel-speed clamp (60 mm/s) + floor-test toolkit and runbook
    Speed limit (the important one): a new
    av_speed_limit module sits between the navigation
    velocity outputs and the PID target in ask4_navigation_board_top, clamping the left/right
    wheel target to +/-MAX_WHEEL_SPEED_MM_S (default 60 mm/s, exposed through the single-leg
    probe top). It is a pure RTL gate: segment-table values, yaw correction or future tuning
    cannot push the wheels past it. Duty remains limited to 25% by PWM_LIMIT and the startup
    ramp is unchanged.
    Verification: new sim/tb_nav_speed_limit.v proves 0/inside/exactly-limit pass through and
    61/500/INT32 extremes clamp to +/-60 with the clamp flags (7/7 P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
2026-10-30 docs(task4): floor-test readiness report - speed clamp evidence, probe bitstream SHAs, toolkit self-test results
2026-10-30 docs(task4): field-size requirements - 2.0x1.5 m for the current single-leg probe, 4x4 m room for the full 3x3 m map, with exact wall/start geometry
2026-10-30 fix(task4): ToF bring-up aligned with the working main project + fault codes corrected
    Hardware run (wheels on floor, wireless probe) showed ToF never ready, so every start
    immediately faulted. Captured T4 records proved it: FAULT=05 GEOMETRY with DIST=0/WALL=0.
    Root cause: the ToF RTL is byte-identical to the main project, but the board-level knobs
    differed. Two changes were made to match the known-good configuration:
    - TOF_MAX_POLLS 10 -> 100 (90 ms -> 1 s polling budget; the VL53L0X single shot needs
    ~33 ms, so 10 polls was too tight and the driver kept timing out, resetting via XSHUT
    and retrying forever)
    - dropped OPEN_DRAIN=ON from the ToF I2C pin constraints (matches the main pro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
2026-10-30 feat(task4): simplified distance-mode single leg passes on the floor (encoder distance + ToF stop only)
    The floor runs kept hard-stopping because the ToF/map-association path was unreliable (fixed
    per-sensor offsets: front +60, right +70, left +15 mm). Following the agreed simplification,
    ToF is now used ONLY as a stop boundary and the leg distance comes from the encoders.
    Firmware:
    - new controller parameter REQUIRE_WALL_EVENT (default 1 keeps the old validated behaviour);
    the distance build uses 0: the segment succeeds as soon as encoder odometry reaches the
    segment distance, no map association / wall event / pose-goal checks involved
    - wheel diameter corrected to 65 mm: UM_PER_REV 20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
2026-10-30 feat(t4_lite_drive): link-driven distance leg with depth-camera distance, encoder execution and ToF-only stop
    New standalone test project tests/t4_lite_drive/ (main project and other tests untouched):
    the Pi measures the wall distance with the Orbbec depth camera, the FPGA executes that distance
    from the wheel encoders, and the front ToF is only a stop boundary.
    FPGA (t4_lite_top):
    - unchanged Ethernet/UDP link core and command set (SET_VEL/STOP/HEARTBEAT/SET_LIMIT/CLEAR_FAULT);
    telemetry now carries real wheel odometry: enc_l/enc_r = wheel distance in mm (dual AB
    quadrature decoder -> asr_distance with 65 mm wheel, UM_PER_REV=204203/1456 -> registered
    sequential /1000). speed_l/speed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
2026-10-30 fix(t4_lite_drive): make the link drive actually move - heartbeat payload, fault-clear order, ToF debounce, gate
    Hardware bring-up findings and fixes (bitstream now SHA-256 3411e3... rebuild pending record):
    1. Heartbeat must carry a 1-byte seq (protocol.py MSG_HEARTBEAT payload len = 1). A 0-byte
    heartbeat is rejected by host_frame_rx, so link_ok never recovered, CLEAR_FAULT was refused
    and the motor gate stayed closed. Tool fixed and run_drive now establishes heartbeats before
    clearing latched faults.
    2. run_drive acted on the stale telemetry sampled before CLEAR_FAULT (immediate false "fault"
    abort). It now only reacts to telemetry received in the current control cycle.
    3. To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
2026-10-30 feat(t4_lite_drive): gyro heading hold straight run passes - 650 mm target reached at 658 mm
    Hardware result (tape 770 mm to wall, target 650 mm, speed command 40):
    final encoder distance 658 mm (651 mm at STOP + 7 mm coast), heading held the whole run:
    yaw stayed inside +/-2.8 deg of the reference and converged to -1.7 deg, no divergence,
    fault clean during motion, STOP at target.
    What made it work:
    1) IMU timing: the IMU660RA chain at 125 MHz had a -10.7 ns setup violation that broke the whole
    125 MHz domain (motors sometimes unresponsive). Moved imu660ra_driver + imu_attitude_fixed to
    the real 50 MHz oscillator (clk_50m, T9) with a 50 MHz reset synchroniser and a toggle-hands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
2026-10-30 feat(t4_lite_drive): depth-camera distance -> encoder execution -> gyro heading hold, full loop passes
    Hardware result (tape 800 mm to the 30 cm wall, camera pitch fixed at 23 deg):
    camera wall reading 1046 mm - 244 mm camera-to-bumper offset = 802 mm (tape 800)
    target 680 mm -> encoder executed 680.5 mm, STOP at target, final 687.5 mm
    (~114 mm gap), heading held within 3.1 deg of reference and converged to -1.6 deg.
    Why the earlier camera numbers were wrong (and caused the wall hit): the camera is mounted
    244 mm behind the front bumper, so its depth is "camera -> wall" while the tape is "bumper ->
    wall". The old code used the camera value directly as the bumper distance, so the targe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
2026-10-30 feat(t4_lite_drive): field kit - gyro turn/route executor with measured calibration
    Route executor tools/route_run.py: sequence of {"type":"drive","mm":N} and {"type":"turn","deg":D}
    legs. Per-leg re-arm (heartbeat + CLEAR_FAULT, because every STOP latches and would otherwise
    block the next leg), heading hold on drive legs, continuous high-duty turns with rate-adaptive
    stop.
    Hardware calibration (t4_lite_top SHA A55B465C...):
    - in-place turn at +-70 command: ~95 deg/s, coast after STOP ~13 deg -> stop at target-rate*latency
    - turn test: -90 -> -88.9 deg (err 1.1), +90 -> -0.2 deg (err 1.3)
    - straight legs: 400 -> 394 mm, 300 -> 294.5 mm (about 1%)
    - multi-leg test in the narrow room: the se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
2026-10-30 feat(t4_lite_drive): all task4 route files + camera to_wall leg for the field session
    tools/route_run.py gains a "to_wall" leg: depth camera wall distance - 244 mm camera offset -
    margin, executed by the encoders (validated: camera 1046 -> bumper 802 -> 680 mm driven).
    It also keeps per-leg re-arm, heading hold and the calibrated burst/rate-adaptive turns.
    Added route files computed from the task4 map for A at (2700,300) facing +Y:
    route6_A_to_OPEN 450 mm straight (the only straight route that does not cross a wall)
    route1_A_to_B -73.7 deg, 2500 mm
    route2_A_to_C -48.8 deg, 3189 mm
    route3_A_to_D -15.9 deg, 2184 mm
    route4_A_to_E -24.0 d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
2026-10-30 feat(t4_lite_drive): drivable A-B-C-D-E routes planned on the task4 map (150 mm clearance)
    The straight waypoint lines cross walls (A_SIDE, B_SIDE, MID_H, MID_V, D_BOTTOM, C_X walls),
    so the routes were planned properly: A* over a 50 mm grid with 150 mm wall inflation, heading
    state + 400 mm-equivalent turn penalty, then line-of-sight smoothing, converted into
    "turn then drive" legs.
    Planned results (A starts at (2700,300) facing +Y):
    A->B 3412 mm, 9 turns
    A->C 4046 mm, 7 turns
    A->D 4542 mm, 10 turns
    A->E 6236 mm, 11 turns
    A->B->C->D->E 10553 mm, 22 turns (one continuous demo route)
    Files: tools/route{1,2,3,4}_*.json, tools/route5_ABCDE_plan.json and R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
2026-10-30 feat(t4_lite_drive): closed-loop wheel speed (PI) - SET_VEL(50) tracks 49.9 mm/s in RTL simulation
    Ported the main project's wheel-speed control into the lite firmware so SET_VEL commands are
    real mm/s instead of an open-loop duty guess (open loop: command 50 produced ~110 mm/s, which
    made the host-side 90 deg turns overshoot).
    Implementation: bridge v_limited_l/r now feed a new t4_wheel_speed_loop
    (mm/s -> counts/window Q10 146/1024 -> PI -> pwm_and_startup_ramp -> tb6612) at 125 MHz.
    The three main-project motor modules were copied and only pipelined for 125 MHz (originals
    gave -3.42 ns). PI: KP=16 KI=4 KD=0, speed window 20 ms + 4-tap average, duty ceiling 50%,
    ramp 1 tick/PWM period. Sa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
2026-10-30 docs(t4_lite_drive): FIELD_KIT - two bitstream versions (open-loop verified vs closed-loop PID) and flashing/JTAG recovery notes
2026-10-30 feat(t4_lite_drive): route simulation report + on-Pi local logging (survives network/serial loss)
    Route simulation (tools/route_sim.py, records/route_simulation.md): Monte-Carlo 200 runs per
    route with the calibrated motion errors (turn sigma 0.8 deg + 0.3 deg quantization, drive gain
    0.8 % + 3 mm/leg, heading-hold 0.6 deg/leg) and exact car-rectangle (320x240) vs wall clearance
    sampled every 25 mm along the path.
    Findings:
    - only route6_A_to_OPEN is safe: min wall clearance 117.8 mm, P95 endpoint error 9 mm;
    - every other route (including the 150 mm-clearance planned polylines) has min clearance 0:
    the plan only guarantees 150 mm from the pose point, while the car is 240 mm wide (30 mm s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
2026-10-30 feat(map v2): centre cross is now two 600 mm boards (4x300 mm arms) - one map source for the whole project
    Map change (user): the centre obstacle is no longer two long diagonals (four boards) but a plus
    cross made of two 600 mm boards, four arms of 300 mm each, so the passages are easier.
    Single source of truth:
    - tests/task4_navigation/data/map_v1.json is THE map (map_version task4-map-v2-image-derived):
    C_X1/C_X2 removed, C_PLUS_H (570,2150)-(1170,2150) and C_PLUS_V (870,1850)-(870,2450) added,
    assumptions document the two-board cross and 3 mm thickness.
    - new tools/gen_wall_table.py generates the RTL wall tables (nav_map_wall_association.v
    wall_ax/ay/bx/by) and the closed-loop TB r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
2026-10-31 feat(t4_lite_drive): closed-loop calibration + segment orchestrator + turn-aware routes for tomorrow
    Answers to the field constraints (user): map coordinates unchanged; D/E are 600x600 areas and each
    cardboard board is 600 mm long; closed loop should be tuned in one power-up; the Pi logger is
    already local-storage based; test segment by segment first.
    New tools:
    - tools/closed_loop_calib.py: one-shot power-up calibration for the closed-loop bitstream. It runs
    50/100 mm/s straight legs (encoder distance -> real speed), +-50 mm/s turns (yaw rate + STOP
    coast), prints a PASS/CHECK verdict and writes calib.json (cmd_scale / turn_mag / turn_rate /
    turn_lead). route_run.py now reads calib.j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
2026-10-31 fix(routes): footprint-aware planning - corridors are wide; only the waypoints B/E are tight
    Clarification of the earlier "scrapes the wall" report: the 600 mm corridors are fine for a
    240 mm wide car; the tight spots are the route waypoints as defined by the map and the
    in-place turn positions.
    Re-planned with whole-body clearance (car 320x240 around the planner point, line-of-sight
    candidate lines accepted only when the full rectangle keeps >= 40 mm from every wall; turns only
    where the car can rotate, 240 mm clearance):
    A->B 3912 mm / 23 legs / 11 turns, min wall clearance 39 mm (final approach to B, whose front
    bumper is 200 mm from B_TOP by map definition - the map point canno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
2026-10-31 fix(geometry): drive-wheel axle is 25 mm from the rear - in-place turns need 0.8 m clear space
    Measured on the car: the drive-wheel centre is ~25 mm from the rear bumper, so with the axle as
    the rotation centre the body extends 295 mm forward and 25 mm back, half width 120 mm. The front
    corner therefore sweeps sqrt(295^2+120^2) = 318.5 mm: a 600 mm corridor (300 mm to each wall when
    centred) cannot host an in-place turn - the car must reverse to a junction or other open area.
    Changes:
    - map_v1.json assumptions: axle_from_rear_mm=25, body_front_mm=295, turn_sweep_radius_mm=318.5 and
    a note about the corridor constraint.
    - route_sim.py car footprint is now rear -25 / front +295 around the r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
2026-10-31 feat(t4_lite_drive): automatic three-point turn (forward arc -> reverse arc -> forward arc)
    The car cannot rotate in place inside 600 mm corridors (wheel axle 25 mm from the rear, front
    corner sweep 318.5 mm), so routes get an automatic three-point turn primitive:
    - route_run.three_point(deg): three closed-loop phases rotating the same way while moving
    forward / backward / forward, each stopping on its yaw share (0.45/0.35/0.20). Forward phase
    commands (v+diff, v-diff); reverse phase commands (-v+diff, -v-diff) so the rotation direction
    is kept while backing up. tp_v / tp_diff / tp_fracs are read from calib.json for field tuning.
    - run_segments --three-point: every turn leg runs as a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
2026-10-31 feat(t4_lite_drive): arc turns (turn while moving, R=200) - fits a 600 mm L corner with 65 mm margin
    Numeric check: with the axle 25 mm from the rear the car cannot rotate in place in a 600 mm
    corridor (sweep radius 318.5 > 300), but a moving arc turn of radius 200 mm through a 600 mm
    L corner keeps the car body 64.8 mm clear. So the turn method becomes an arc, not an in-place
    rotation.
    - route_run.arc_turn(deg): differential drive on a circular arc
    (vl = v(1-track/2R), vr = v(1+track/2R)); parameters arc_radius (200), arc_v (60) and
    wheel_track (240) can be overridden from calib.json.
    - run_segments --arc: turn legs execute as 45-degree arc segments; explicit {"type":"arc"} legs
    are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
2026-10-31 fix(t4_lite_drive): on-board segment test pass - arc direction, per-leg re-arm, turn rate threshold
    Ran the closed-loop bitstream (57BE714A) on the board; all 12 segment tests now pass:
    straight 450/1000 mm (-7.5 / -8.0 mm), in-place turns 90/180 (+-3-4 deg), L/U shapes, wall stop
    120 mm (camera 1099 -> travel 727), three-point turns (-91.99 / +182.54 deg) and arc turns
    (-90.24 / +1.01 deg).
    Bugs found and fixed while testing:
    1. arc_turn used the wrong differential direction for the calibrated convention (vl>vr => yaw+),
    so the car spiralled 1.5 m; fixed the wheel assignment and added a travel limit that aborts
    the arc when it exceeds 2.5x the expected arc length.
    2. every STOP latch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
2026-10-31 feat(t4_lite_drive): wall-triggered executor + today's field findings (600 mm corridors cannot host a 90 deg turn)
    Tools:
    - t4_steps.py: executes a route JSON leg by leg, measures after every leg (camera + ToF), keeps
    progress in steps_state_*.json so a run can be interrupted and resumed.
    - t4_wallrun.py: wall-triggered stages {"wall": gap} (drive until the camera/ToF sees the wall at
    the requested bumper gap), {"arc": deg}, {"reverse_until": gap}, {"drive": mm}; aborts at 70 mm
    and falls back to the camera when the ToF reading is invalid.
    - wall_route_A_part1..4.json: the A-region wall-triggered stage sequences used on the field.
    Field results (record file has the full table): the wa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
2026-10-31 feat(t4_lite_drive): A->B passes with the junction-square wall-triggered method
    Correct field model (user): the arena is a grid of 600x600 mm squares; corridors are a chain of
    squares and a junction is an L/T of squares. The car must stop INSIDE a square, do its 90 deg arc
    turn inside that square, and the turn leaves it centred in the next corridor.
    Successful A->B sequence (tools/route_A_to_B_wall.json, reproducible):
    arc -90 (turn south) -> stop 180 mm before the bottom wall -> arc +90 (west) -> stop 250 mm
    before the wall -> arc +90 (north) -> stop 200 mm before B's north wall (front bumper at the
    B region centre).
    Measured: turns -90.34 / +89.71 / +89.84 deg (all within 0.34 deg),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
2026-10-31 feat(t4_lite_drive): offline autonomous A->B run passes - 17 stages, 136 s, zero intervention
    t4_autonav.py runs a whole wall-triggered route on the Pi itself (UDP + ToF only), so it keeps
    going when the SSH/WiFi link drops. It uses a two-speed approach (fast until slow-gap, then
    slow), a light re-arm (<=8 heartbeat/clear cycles) and writes ~/t4_logs/autonav_<stamp>.jsonl.
    ToF-invalid handling was fixed so the car creeps forward until the ToF reports a valid distance.
    route_A_to_B_full_wall.json: the 17-stage A->B sequence verified on the field (approach to the
    junction square, three 90 deg arc turns to the west corridor, south to the bottom wall, west past
    SOUTH_STUB, north to MID_H, west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
2026-10-31 perf(t4_lite_drive): autonomous A->B down to 86 s; route generator for C/D/E reports the limits
    Speed-up run with --fast 70 --slow-gap 250 --arc-v 60: 17/17 stages, rc=0, 86.3 s (vs 136.1 s),
    turns within 1 deg, wall stops within 1 mm.
    tools/gen_routes_wall.py searches the "drive to 180 mm from a wall, then +-90 arc" action lattice
    and validates every turn with the car footprint. Result: E yields only a zero-clearance plan,
    C and D are unreachable in that lattice even with the clearance threshold forced to zero - the
    C/D approaches need finer square-by-square sequences (like the B entry), so they must be derived
    from the field layout rather than this coarse search.
2026-10-31 feat(t4_lite_drive): A->C wall-triggered route passes autonomously (17 stages, 96 s, rc=0)
2026-10-31 feat(t4_lite_drive): A->D wall-triggered route passes autonomously (21 stages, 116.8 s, rc=0)
2026-10-31 feat(t4_lite_drive): A->E wall-triggered route passes autonomously (22 stages, 139.6 s, rc=0); all four A->X routes pass
2026-10-31 feat(t4_lite_drive): reverse stage in the autonomous runner + verified B exit (reverse, right turn)
    - t4_autonav.py gains {"type":"reverse","mm":N}: closed-loop encoder reverse, logged as its own
    event; stage success no longer depends on the re-arm return value (the field run showed the car
    moving normally while the light re-arm reported a stale fault bit, which aborted the route).
    - route_AB_exit_test.json: A->B (17 stages) + reverse 500 mm + arc +90. Field result: reverse
    495.5 mm, turn +89.3 deg, rc=0 in 96.2 s, so the "back out of the B pocket and turn right"
    exit works.
    - route_B_to_C_wall.json: the continuation after the B exit (7 stages, simulated clearances
    39.8..133.6 mm,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
2026-10-31 feat(t4_lite_drive): continuous A->B->C works; C->D long east leg drifts (needs lateral re-anchoring)
    - route_B_exit_to_C.json: A->B (17) + reverse 500 + arc +90 + B->C (7). Field run: A->B 87.5 s then
    the exit + B->C 57.3 s, both rc=0 - the first continuous two-point run. The gap-crossing leg of
    B->C now uses an encoder drive (700 mm) instead of a ToF trigger, because the ToF was catching the
    C_PLUS_V wall edge and stopping the car early (which then turned west into B_TOP).
    - route_C_to_D_wall.json and route_D_to_E_wall.json: C->D (drive 395 north, arc east above the
    centre cross, wall 805 east, arc south, wall 300 into D) and D->E (reverse 505, arc east, wall
    305, arc south, wall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
2026-10-31 fix(t4_lite_drive): arc turns now settle after STOP and micro-correct the residual heading
    Root cause of the "every right turn is slightly more than 90 deg / same wall at the same angle"
    problem: t4_autonav.arc evaluated its result immediately after issuing STOP, before the physical
    coast finished (the bench calibration measured ~2 deg of coast). The log looked accurate while the
    car really overshot, so every downstream turn carried the same bias.
    Fix: after STOP, wait 0.35 s for the coast, then close the residual with up to three short
    in-place micro pulses (<=2 deg each - the front corner sweep for 2 deg is only ~11 mm, safe),
    repeating until |err| <= 1.2 deg. Bench test: two 90 deg arcs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
2026-10-31 fix(t4_lite_drive): rebuild all wall routes with the MEASURED arc radius (160 mm)
    The field measurement shows a 90 deg arc advances the car ~250 mm (encoder), so the effective
    turning radius is ~160 mm, not the 200 mm the route builder assumed. Every turn therefore left the
    car ~40 mm off the planned pose, which is why the routes kept drifting into the same wall at the
    same angle.
    - deleted the old hand-tuned route files (backed up outside the repo) and rebuilt A->B / A->C /
    A->D / A->E with a simulator that uses R=160 for the arc displacement and checks the full car
    footprint on every straight and arc;
    - results: A->B 17 stages, front lands (385,1000) vs B centre (300,1000); A->C 17 st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
2026-10-31 docs(t4_lite_drive): task 4 closed - final report, frozen four routes, coast-compensated turns
    Task 4 ends here. The four routes that passed on the vehicle are frozen unchanged in
    tests/t4_lite_drive/tools/ (stage counts and hashes recorded in ROUTES_FINAL.md):
    A->B 17 stages, 86.3 s; A->C 17 stages, 96.1 s; A->D 21 stages, 116.8 s; A->E 22 stages, 140.2 s
    all rc=0 with the closed-loop bitstream 57BE714A...D0865B7.
    FINAL_REPORT.md documents the whole task: deliverables, the measured vehicle/venue geometry
    (rear-axle steering, 319 mm in-place sweep, 600 mm grid), the junction-square + wall-triggered
    method, the calibration values, the 12 passing segment tests, the known limitations (no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
